schreibfaul1/ESP32-MiniWebRadio/docs/MiniWebRadio V3.4 Layout.pdf

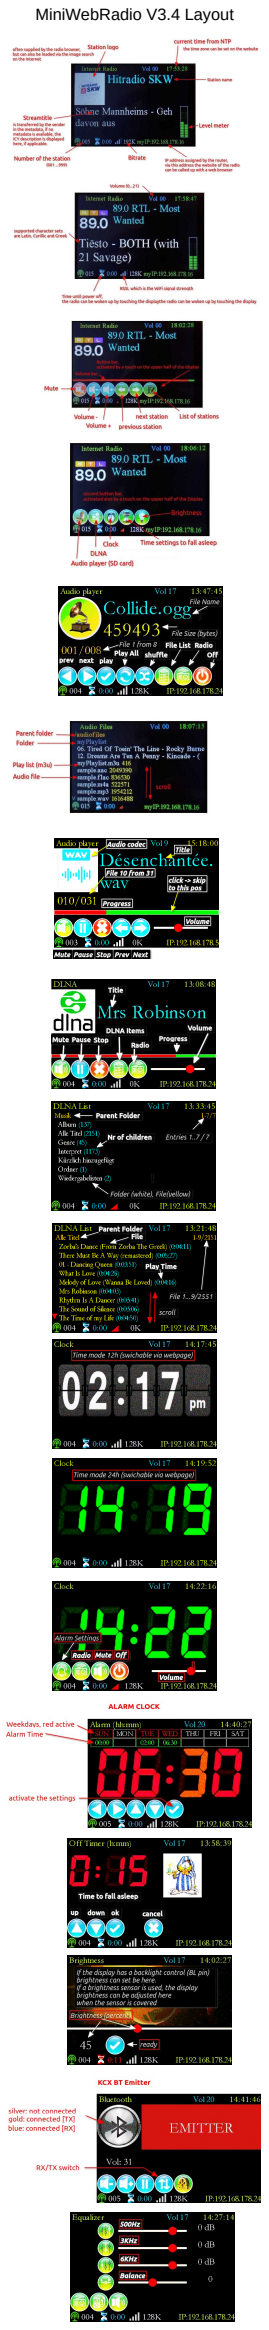
[picture p19: page 1]

MiniWebRadio V3.4 Layout
