schreibfaul1/ESP32-MiniWebRadio/docs/Using the RadioBrowser.pdf

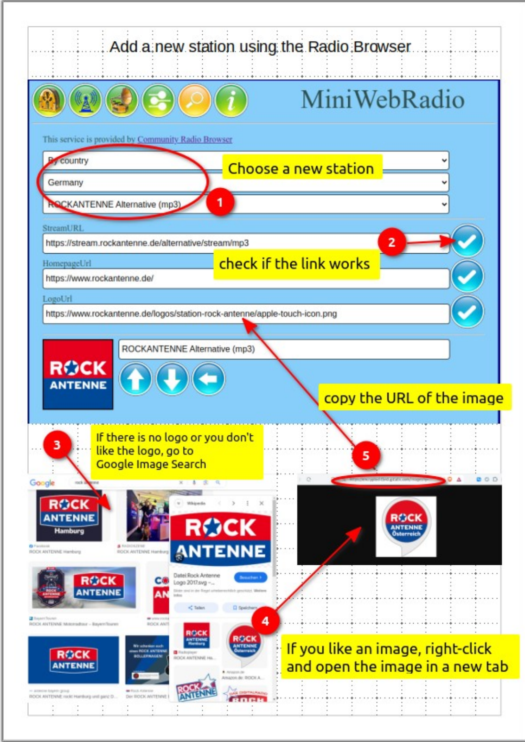
[picture p20: page 1]
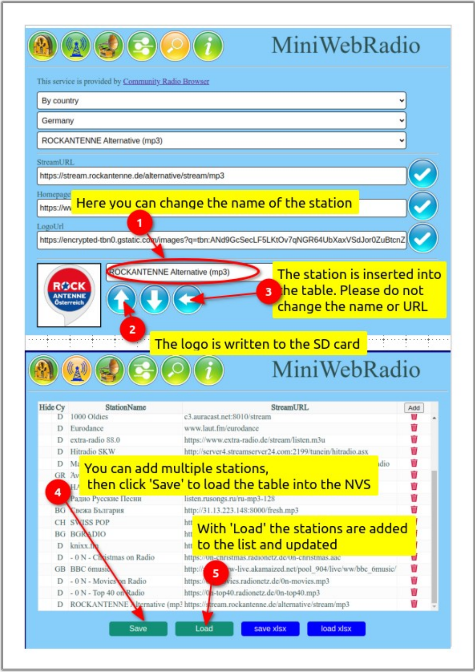
[picture p21: page 2]
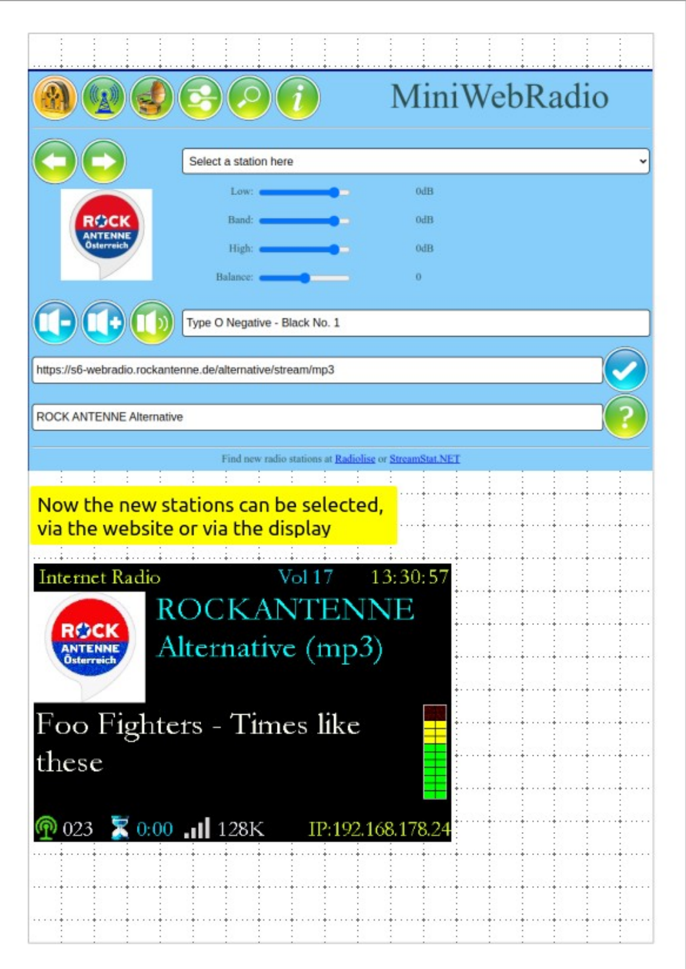
[picture p22: page 3]
