schreibfaul1/ESP32-MiniWebRadio/docs/Filezilla.pdf

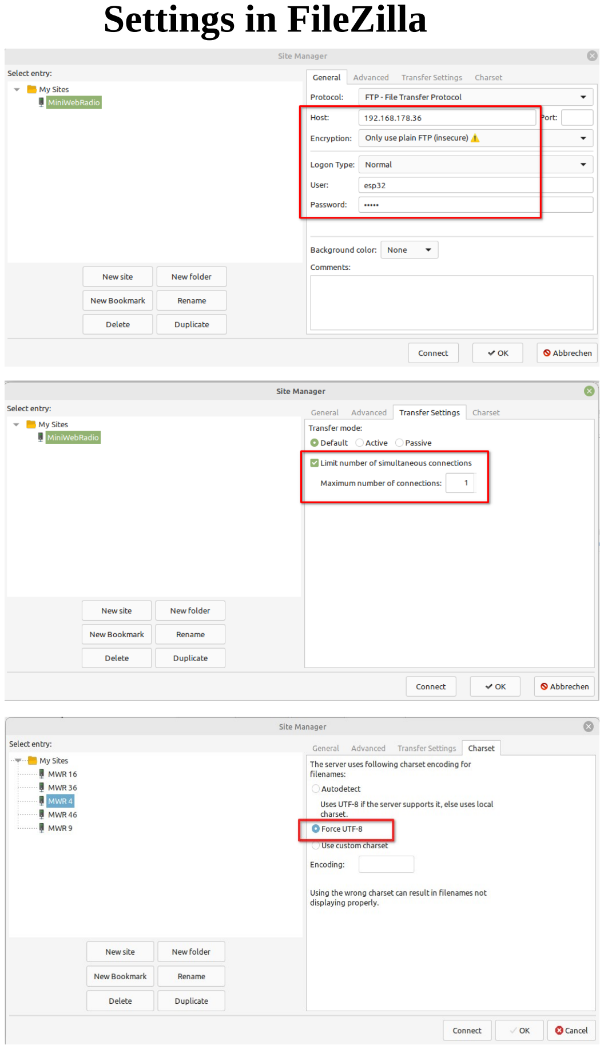
[picture p23: page 1]

Settings in FileZilla
