schreibfaul1/ESP32-MiniWebRadio/docs/rgb displays/Waveshare 7' Display/ESP32-S3-Touch-LCD-7.pdf

HMI 7'' Waveshare
ESP32-S3-Touch-LCD-7 | ESP32-S3 N16R8
GPI00 | G1 | | hsync_polarity | 0
GPI01 | R0 | | hsync_front_porch | 1
GPI02 | R1 | | hsync_pulse_width | 1
GPI03 | VSYNC | | hsync_back_porch | 1
GPI04
GPI05 | DE | | vsync_polarity | 0
GPI06 | | | vsync_front_porch | 4
GPI07 | PCLK | | vsync_pulse_width | 4
GPI08 | TP_SDA | | vsync_back_porch | 4
GPI09 | TP_SCL
GPI10 | B4 | | pixel_clock_hz | 12000000
GPI11 | SD_MOSI | SD_MMC_CMD | G911_I2C_ADDRESS | 0x14
GPI12 | SD_CLK | SD_MMC_CLK
GPI13 | SD_MISO | SD_MMC_D0
GPI14 | B0
GPI15
GPI16
GPI17 | B3
GPI18 | B2
GPI19
GPI20
GPI21 | G5
GPI22
GPI23
GPI24
GPI25
GPI26
GPI27
GPI28
GPI29
GPI30
GPI31
GPI32
GPI33
GPI34
GPI35
GPI36
GPI37
GPI38 | B1
GPI39 | G0
GPI40 | R4
GPI41 | R3
GPI42 | R2
GPI43 | | TX0
GPI44 | | RX0
GPI45 | G2
GPI46 | HSYNC
GPI47 | G4
GPI48 | G3

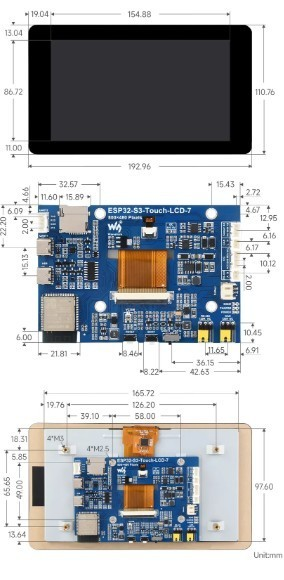
[picture p24: figure]
