schreibfaul1/ESP32-MiniWebRadio/docs/CS4344_schematic.png

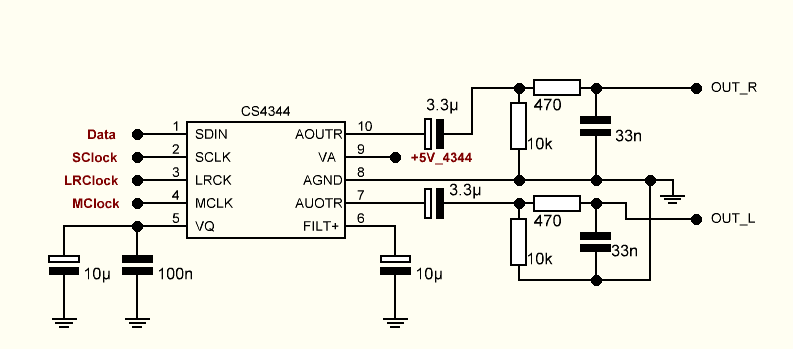
docs/CS4344_schematic.png
