schreibfaul1/ESP32-MiniWebRadio/docs/ir_buttons.json(Android X96).png

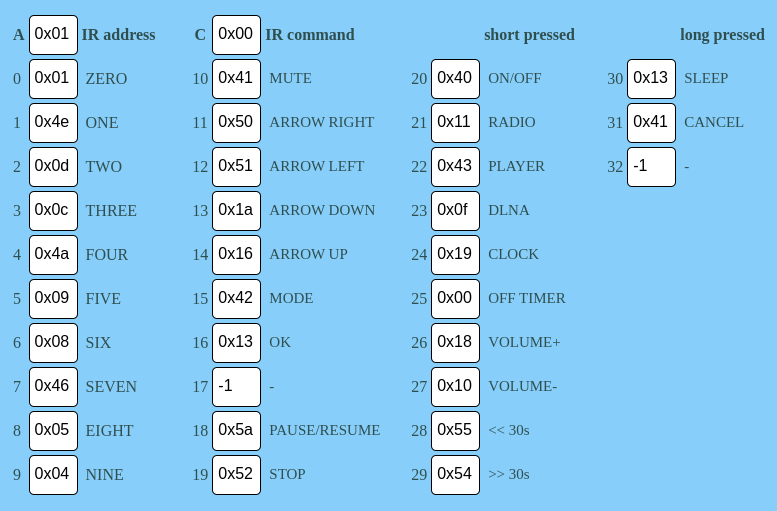
docs/ir_buttons.json(Android X96).png
