schreibfaul1/ESP32-MiniWebRadio/docs/MiniWebRadio.jpg

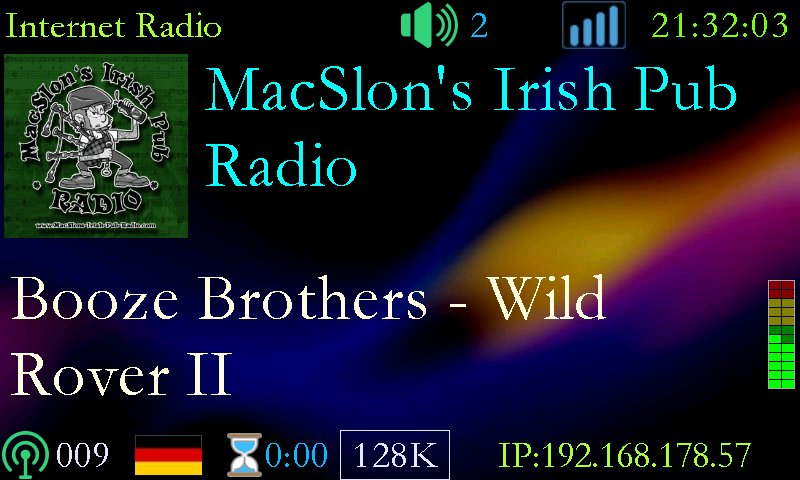
docs/MiniWebRadio.jpg
