schreibfaul1/ESP32-MiniWebRadio/docs/MWR_BT.jpg

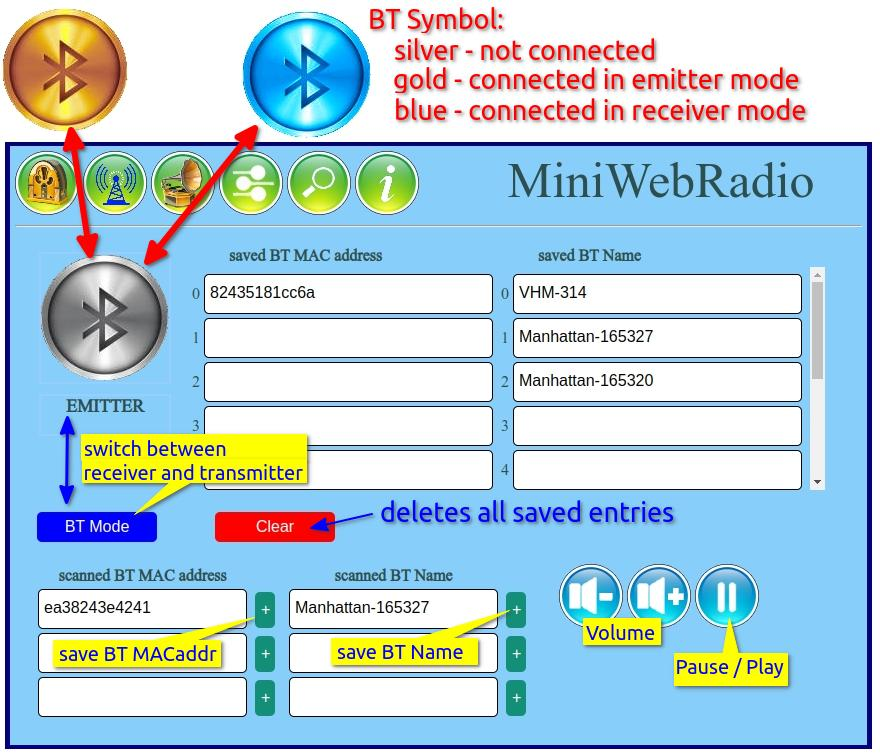
docs/MWR_BT.jpg
