schreibfaul1/ESP32-MiniWebRadio/docs/rgb displays/Sunton 7' Display/IMG_20250217_164130_144.jpg

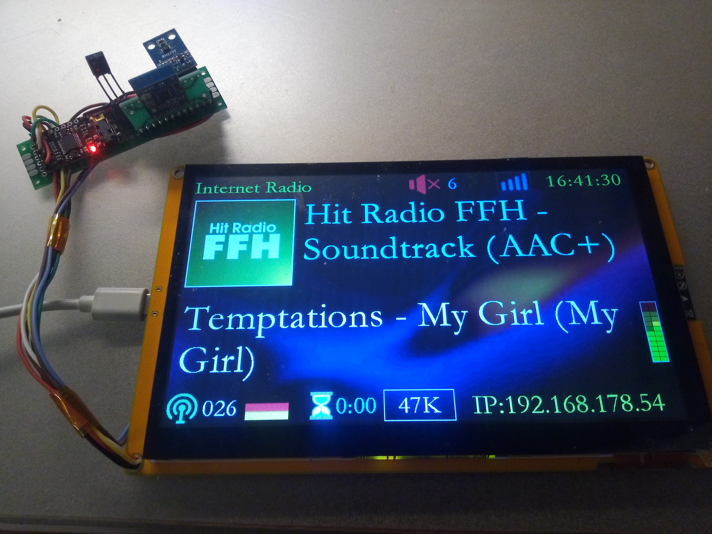
docs/rgb displays/Sunton 7' Display/IMG_20250217_164130_144.jpg
