schreibfaul1/ESP32-MiniWebRadio/docs/SD_Card_Adapter_for_SD_MMC_.jpg

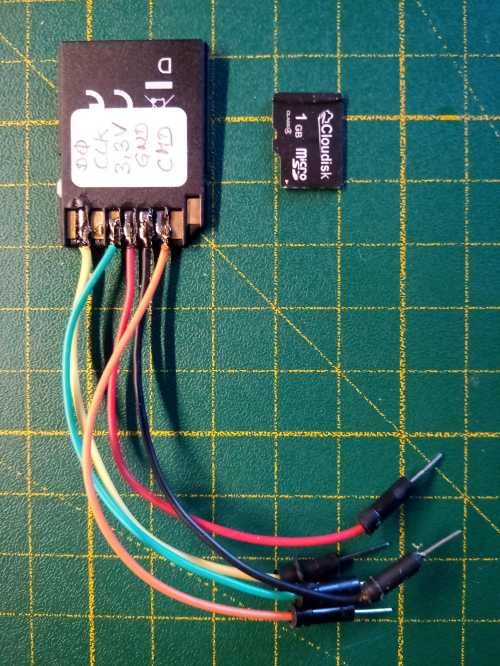
docs/SD_Card_Adapter_for_SD_MMC_.jpg
