schreibfaul1/ESP32-MiniWebRadio/docs/TFT_ILI9488_pins.jpg

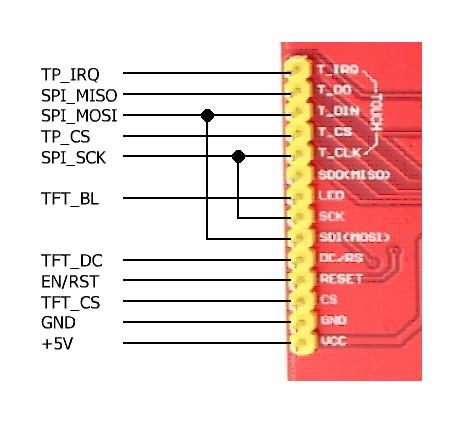
docs/TFT_ILI9488_pins.jpg
