schreibfaul1/ESP32-MiniWebRadio/docs/WiFi Manager.png

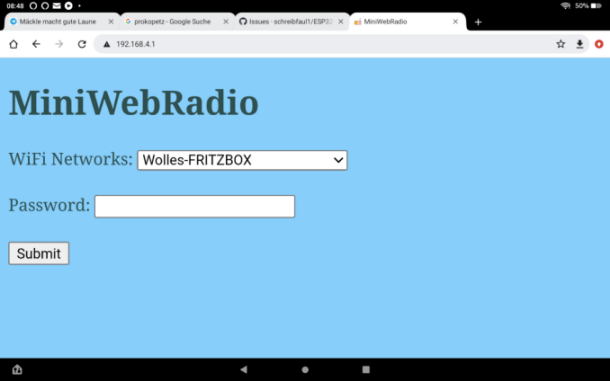
docs/WiFi Manager.png
