schreibfaul1/ESP32-MiniWebRadio/docs/How to install.pdf

# How to install ESP32-MiniWebRadio-V4

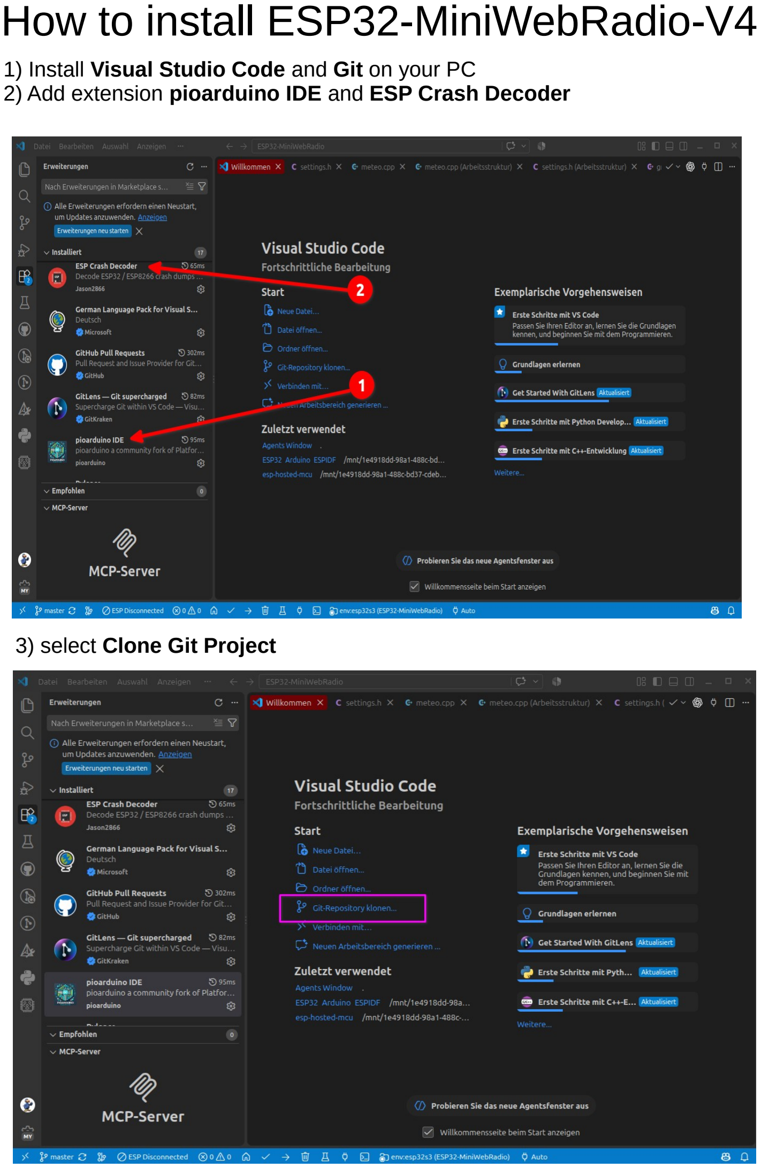
[picture p34: page 1]

1) Install Visual Studio Code and Git on your PC
2) Add extension pioarduino IDE and ESP Crash Decoder
3) select Clone Git Project

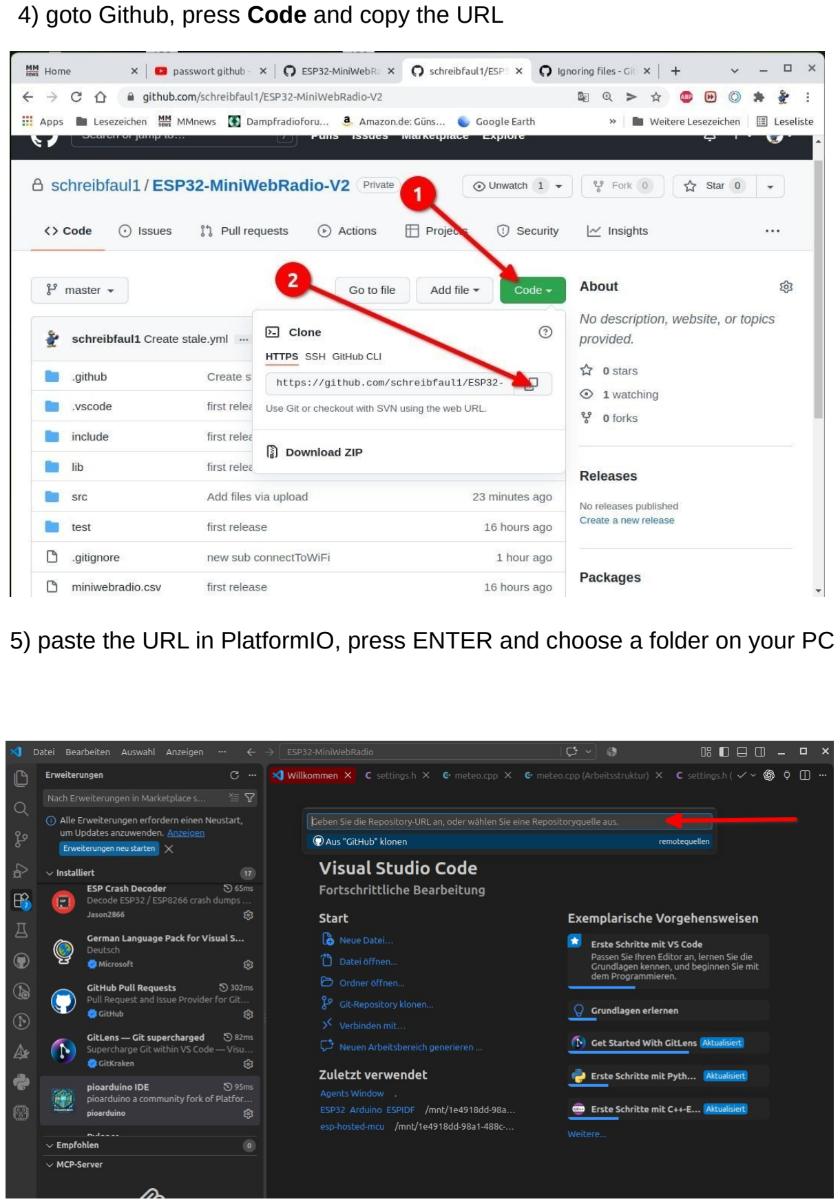
[picture p35: page 2]

4) goto Github, press Code and copy the URL
5) paste the URL in PlatformIO, press ENTER and choose a folder on your PC

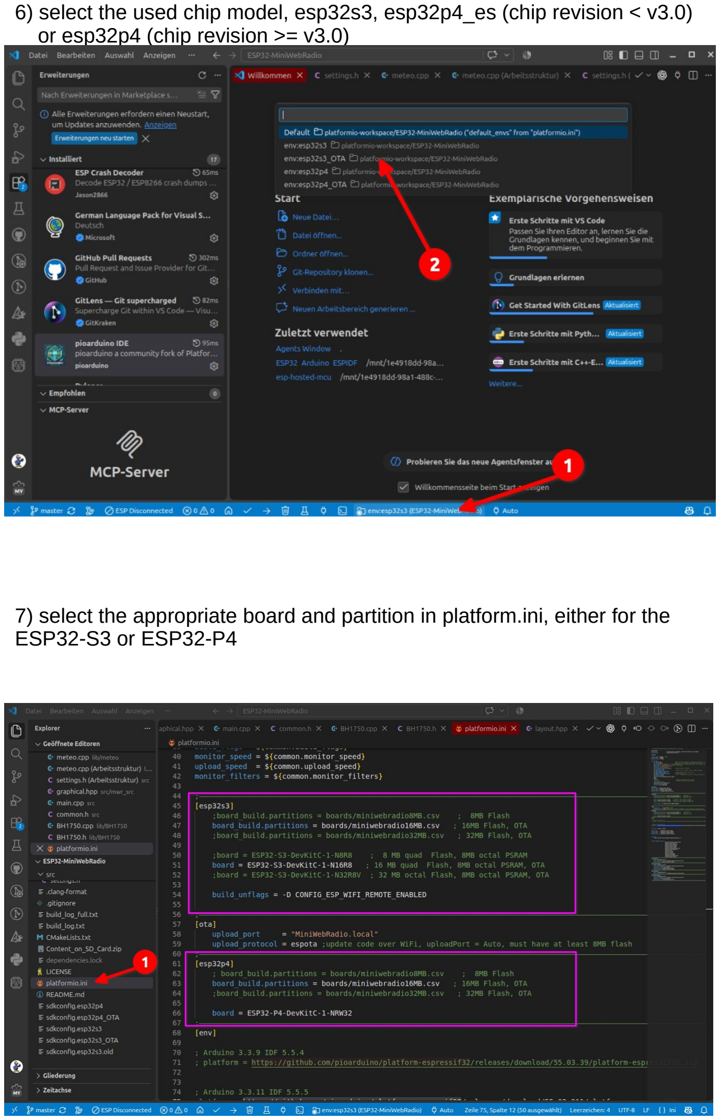
[picture p36: page 3]

6) select the used chip model, esp32s3, esp32p4_es (chip revision < v3.0) or esp32p4 (chip revision >= v3.0)
7) select the appropriate board and partition in platform.ini, either for the ESP32-S3 or ESP32-P4

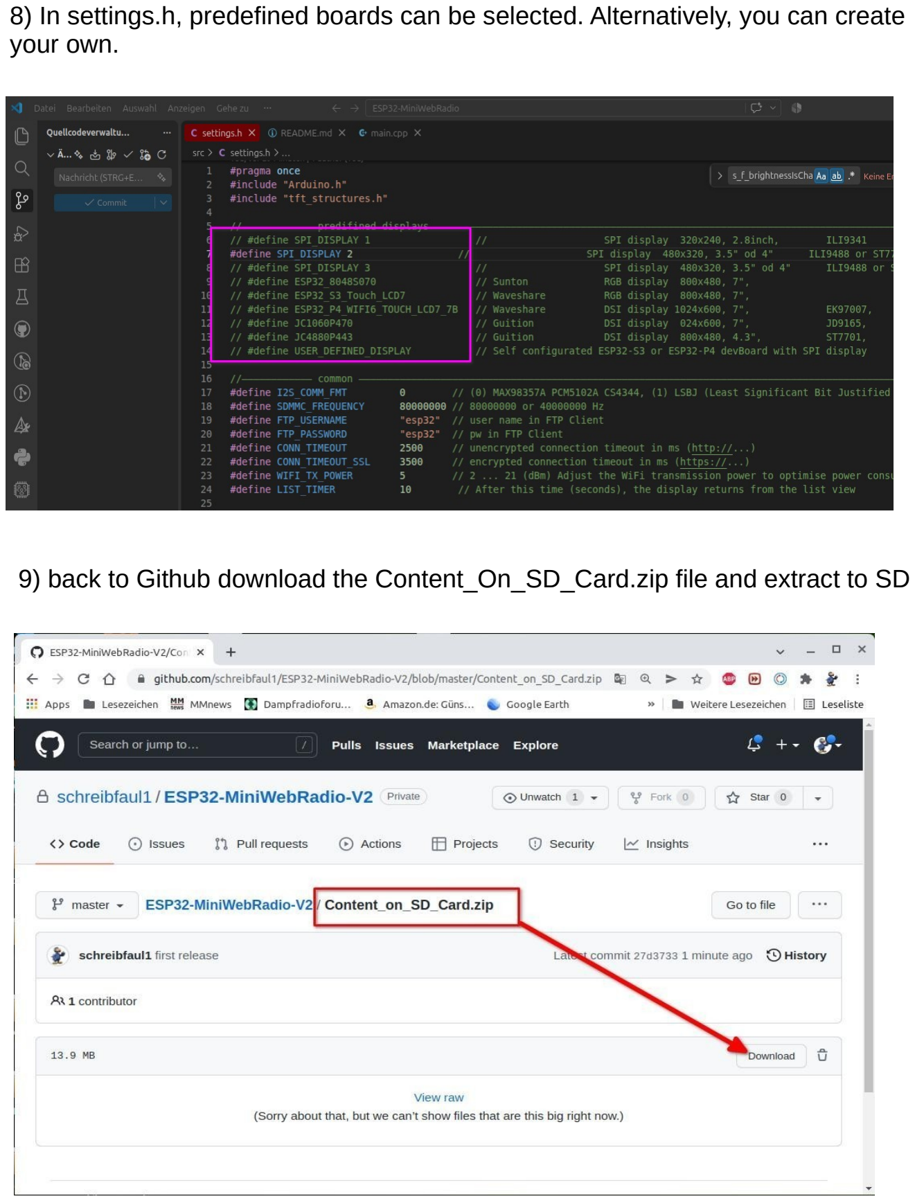
[picture p37: page 4]

8) In settings.h, predefined boards can be selected. Alternatively, you can create your own.
9) back to Github download the Content_On_SD_Card.zip file and extract to SD

10) Connect the ESP32 to USB, press build and then upload, Thats all.

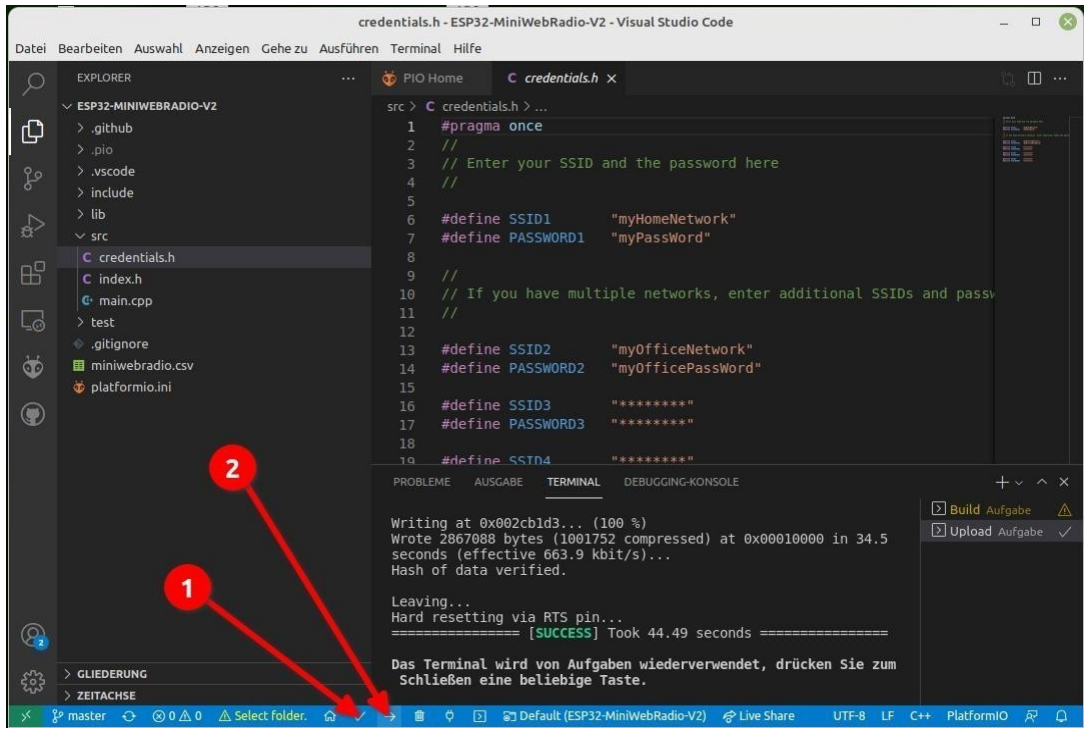
[picture p38: figure]
