schreibfaul1/ESP32-MiniWebRadio/(threads)

Thread 5 (2018-05-13):

Touch calibration

gonza88, 2018-05-13:
Hello
I made this radio and I have problem with cheap LCD based on ILI9341. When I touch the screen, point of touch doesn't match to icons of menu etc. It's possible to calibrate this?

PS. It's looks like ESP don't read presets.csv file from SD card. Radio plays only stations preprogrammed in ino file.

schreibfaul1, 2018-05-14:
Hello,
You use my tft library? If so scroll tft.cpp to the end and seek for
x = TP_Send(0xD0);
y=  TP_Send(0x90);
read x,y with (0,0) and (320,240) then You have th Voltage (in milliVolts) from TP controller.
Replace the constants Xmin, Xmax, Ymin, Ymax in tft.h with Your values.

In Your browser, tab config try the button "load default" to reread presets.csv.

schreibfaul1, 2018-05-19:
maybe You have this display: TJCTM24028-SPI, ILI9341, red board?
tochpad is y-inverted. If so replace the code at the end tft.cpp
  if(_rotation==0){y=TFT_HEIGHT-y;}
  if(_rotation==1){tmpxy=x; x=y; y=tmpxy; y=TFT_WIDTH-y; x=TFT_HEIGHT-x;}
  if(_rotation==2){x=TFT_WIDTH-x;}
  if(_rotation==3){;}  // do nothing

and set in tft.h:
      const uint16_t Xmax=1850;
      const uint16_t Xmin=170;
      const uint16_t Ymax=1880;
      const uint16_t Ymin=140;

koka7777745, 2018-07-15:
Dear author, tell me please how to add a red board for ILI9341, support for Russian-language fonts. And then I have at Russian stations some kryakozyabry.

koka7777745, 2018-07-15:
Thanks for the tips, 11 commented, and 8 commented. The rest does not come. Compilation does not go through the same mistakes. Drop the corrected files to the mail.
koka5675766@rambler.ru

koka7777745, 2018-07-15:
And how are the logos attached to the stations?

schreibfaul1, 2018-08-12:
To translate all the titles or words in russian You can try this:

  tft.setFont(Garamond_cyrillic_32x33);
  tft.print(UTF8toCp1251("Калинка, калинка, калинка моя! В саду ягода малинка, малинка моя!"));
  tft.print(UTF8toCp1251("Ах, под сосною, под зелёною, Спать положите вы меня!"));

for example:

in setup()
``
// showHeadlineItem("** Internet radio **");
showHeadlineItem("ИНТЕРНЕТ-РАДИО");
``

and in showHeadlineItem(const char* hl)
``
// tft.setTextSize(2);
tft.setFont(Garamond_cyrillic_18x18);
display_info(UTF8toCp1251(hl), _yHeader, _hHeader, TFT_WHITE, 0);
...
``

pilnikov, 2018-08-13:
' void showTitle(String str) {'
'  static String title = "";'
'  str.trim();  // remove all leading or trailing whitespaces'
'  if ((_state == RADIO) && (title == str)) return; // nothing to do'
'  if (str.length() > 4) f_has_ST = true; else f_has_ST = false;'
'  /* tft.setTextSize(4);'
'     if(str.length()> 45) tft.setTextSize(3);'
'     if(str.length()> 80) tft.setTextSize(2);'
'     if(str.length()>100) tft.setTextSize(1);'
'  */'
''
'  tft.setFont(Garamond41x42cyrillic);'
'  if (str.length() > 45) tft.setFont(Garamond32x33cyrillic);'
'  if (str.length() > 80) tft.setFont(Garamond23x24cyrillic);'
'  if (str.length() > 100) tft.setFont(Garamond21x21cyrillic);'
''
'  displayinfo(str.c_str(), _yTitle, _hTitle, TFT_CYAN, 0);'
'  title = str;'
'}'
' void showStation() {'
 ' tft.setFont(Garamond41x42cyrillic);'
 ' if (_stationname.length() > 45) tft.setFont(Garamond32x33cyrillic);'
 ' if (_stationname.length() > 80) tft.setFont(Garamond23x24cyrillic);'
 ' if (_stationname.length() > 100) tft.setFont(Garamond21x21cyrillic);'
''
 ' String str1 = "", str2 = "";'
 ' if (_stationname == "") {'
 '   //    tft.setTextSize(3);'
 '   //    if (_station.length() > 75) tft.setTextSize(1);'
 '   displayinfo(_station.c_str(), _yName, _hName, TFT_YELLOW, _wLogo + 14); // Show station name'
 '   showTitle("");   // and delete showstreamtitle'
 '   showFooter();'
 '   str1 = _station;'
 ' } else {'
 '   //   tft.setTextSize(4);'
 '   //   if (_stationname.length() > 30) tft.setTextSize(3);'
 '   displayinfo(_stationname.c_str(), _yName, _hName, TFT_YELLOW, _wLogo + 14);'
 '   showTitle("");'
 '   showFooter();'
 '   str1 = _stationname;'
 ' }'
 ' //log_i("%s", _stationname.c_str());'
 ' str1.toLowerCase();'
 ' str1.replace(",", ".");'
 ' str2 = "/logo/" + String(UTF8toASCII(str1.c_str())) + ".bmp";'
 ' //log_i("%s", _sbuf);'
 ' if (f_SD_okay) if (tft.drawBmpFile(SD, str2.c_str(), 0, _yLogo) == false) tft.drawBmpFile(SD, ' ' "/logo/unknown.bmp", 1, 22);'
'}`
Right name of cyrillic font is Garamond32x33cyrillic

schreibfaul1, 2018-08-20:
Yes, use fontname Garamond32x33cyrillic

Closed 2018-08-20.

Thread 31 (2020-05-08):

SD Karte arbeitet nicht

frbr13, 2020-05-08:
Hallo Wolle,

ich habe ein Problem mit der SC Karte da kommt immer ein Fehler beim Start und da bleibt es dann hängen.
Ich habe ein etwas anderes ESP32 als in deinen Bildern.
Espressif ESP32 WLAN Dev Kit Board Development Bluetooth Wifi v1 WROOM32 NodeMCU
ich habe hier die pinkonfiguration gewählt und meine verdrahtung 3 mal geprüft (und auch das Waveshare 2.8 Tft Shield auf einen Arduino uno getestet)

Hast du noch eine Idee ?
VG Frank

ets Jun  8 2016 00:22:57

rst:0x1 (POWERON_RESET),boot:0x13 (SPI_FAST_FLASH_BOOT)
configsip: 0, SPIWP:0xee
clk_drv:0x00,q_drv:0x00,d_drv:0x00,cs0_drv:0x00,hd_drv:0x00,wp_drv:0x00
mode:DIO, clock div:1
load:0x3fff0018,len:4
load:0x3fff001c,len:1216
ho 0 tail 12 room 4
load:0x40078000,len:9720
ho 0 tail 12 room 4
load:0x40080400,len:6352
entry 0x400806b8
setup      : Init SD card
tft_info   : TFT_CS:22 TFT_DC:21 TFT_BL:33 TFT_MOSI:23 TFT_MISO:19 TFT_SCK:18
tft_info   : init HX8347D
setup       : SD card not found

schreibfaul1, 2020-05-10:
Hallo Frank,
Display, Tochpad, VS1053 und SD Karte liegen auf dem gleichen Bus. CS->low bestimmt, welche Komponente aktiv ist. Ich gehe von einem Verdrahtungs/Kontaktproblem aus. Jede Komponente kann einzeln auf Funktion getestet werden, dazu gibt es in den Libraries Beispiele zum testen. Wenn einzeln alles funktioniert klappt auch das Zusammenspiel. Ich wünsch dazu viel Erfolg...
P.S. beim Waveshare-Display gibt es einen gelben Klotz, davor können 3 Brücken eingelegt werden damit die Leitungen zur Stiftleiste durchverbunden sind https://github.com/schreibfaul1/ESP32-TFT-Library-ILI9341-HX8347D/blob/master/additional%20info/Waveshare%202.8%20Display.jpg

frbr13, 2020-05-10:
Hallo Wolle,

super Danke für deine Hilfe, der Tip mit den 3 Lötbrücken hat geholfen 😊 . Es kam sofort ein Bild auf dem TFT und ich konnte den Sound testen mit den Test Files auf der SD Karte . Jetzt habe ich nur noch das Problem einen Sender zu finden der auch Streamt, ich hatte 5 deiner angelegten  getestet und vor ein paar Tagen Radio Wuppertal (mein Lokaler Sender 😊) hinzugefügt , aber hier kommt immer die Meldung das der Sender die Sender nicht streamen .

Danke noch mal für deine schnelle Hilfe

Schönes Rest Wochenende noch und bleib Gesund

Viele Grüße

Frank

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

schreibfaul1, 2020-05-10:
das hört sich gut an, die Verkabelung sollte nun in Ordnung sein. Wird die Zeit auf dem Display korrekt angezeigt? Vielleicht besteht keine Verbibdung ins Internet (nur lokal, nach außen wird von Router gesperrt)? Oder mit dem Browser auf die Radio-IP zugreifen und die Stream-URL manuell eingeben.
das Log sollte ähnlich sein zu:
```
WiFI_info  : WiFi connected
WiFI_info  : IP address 192.168.178.9
WiFI_info  : connected to Wolles-FRITZBOX
rtime_info : Initializing SNTP
rtime_info : Waiting for system time to be set... (1/10)
rtime_info : Sun May 10 20:36:57 2020
vs1053_info: Song stopped correctly after 0 msec
vs1053_info: Connect to new host: 0n-80s.radionetz.de:8000/0n-70s.mp3
[V][ssl_client.cpp:248] stop_ssl_socket(): Cleaning SSL connection.
vs1053_info: Connect to 0n-80s.radionetz.de on port 8000, extension /0n-70s.mp3
vs1053_info: Connected to server
vs1053_info: Server: Icecast acc-0.9.10.25 2.4.3-backportCVE-2018-18820
vs1053_info: audio/mpeg seen.
vs1053_info: Cache-Control: no-cache
vs1053_info: Expires: Mon, 26 Jul 1997 05:00:00 GMT
vs1053_info: Pragma: no-cache
vs1053_info: Access-Control-Allow-Origin: *
vs1053_info: ice-audio-info: ice-samplerate=44100;ice-bitrate=128;ice-channels=2
vs1053_info: icy-description:Von Disco ber Reggae und Schlager bis hin zum Rock. Das sind die Hits der 70er.
vs1053_info: icy-genre:70s, 70er, Oldies, Pop
vs1053_info: icy-name=- 0 N - 70s on Radio
vs1053_info: icy-private:0
vs1053_info: icy-pub:1
Homepage   : http://www.0nradio.com
vs1053_info: Switch to DATA, bitrate is 128, metaint is 16000
lastURL    : 0n-80s.radionetz.de:8000/0n-70s.mp3
vs1053_info: Metadata block 64 bytes
vs1053_info: StreamTitle=Wings - Listen To What The Man Said
````

frbr13, 2020-05-11:
Heute klappt alles es lag am Internett (wir hatten hier Gestern diverse Probleme)

Danke Gruß

Frank

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

schreibfaul1, 2020-05-12:
sehr gut!

Closed 2020-05-12.

Thread 83 (2022-04-09):

Suggestions for improvement

valera39, 2022-04-09:
Hello everyone, hello Wolle!
Let me repeat myself a little. Is it possible to implement such algorithms:
- when you press the "OK" button, the initial screen switches to the clock, pressing again switches back to the initial screen.
If you switch the station using the buttons on the remote control in the clock mode, display the initial screen for a while, then switch again
on the screen with hours.
- loop the switching of stations using the "next" and "next" buttons on the screen and on the remote control, that is, the last station in the list, then the first
- to prevent clicks in the speakers when the radio is turned on and to reduce the noise of the amplifier in the absence of a signal
add the "mute" mode to the free GPIO, the signal from which appeared at the time of the DAC operation.
I think the radio will become more functional from these functions.
And a couple more questions: what is the AUDIOTASK_CORE parameter in common.h responsible for, for sound processing on a separate core?
Is it worth changing it?
In platformio.ini when installing on ESP32 Wrower to enable PSRAM, do I need to uncomment the parameters
DBOARD_HAS_PSRAM and mfix-esp32-psram-cache-issue
If it were possible to use ESP-12K with 8Mb PSRAM, it would be great, because there is never too much memory :)

schreibfaul1, 2022-04-09:
Hello @valera39,
the first two points are done. Now the remote control can be used properly.
Point three: With 'mute', the volume is faded in or out in stages. In addition, if AMP_ENABLED is set in common.h, the assigned GPIO is controlled. AMP_ENABLED was already present to control the amplifiers on the audio boards (e.g. AI Thinker A1S board or OLIMEX ADF) and to save energy.
The ESP32 has two cores and one can be selected with AUDIOTASK_CORE. By default, Arduino setup() and loop() runs on core 1 and therefore the display also runs on core1. I think for the Aufiotask core 0 is better.
PSRAM is not strictly required. There is one exception: FLAC with an external DAC requires PSRAM, the SRAM does not have enough capacity. Older ESP32 (these have a design flaw) require the mfix-esp32-psram-cache-issue.
ESP-12K is certainly an ESP32-S2 and would then not work because of only one core.
regards
Wolle

valera39, 2022-04-09:
Hello Wolle!
Thank you very much for the implementation of my wishes and detailed answers to my questions!
I'm using an ESP32 worower with PSRAM enabled, but I'm experiencing a brief, literally split-second, audio stutter at the moment
change the name of the song on the screen. There are also slight stutters when using the buttons on the screen. Files like .flac do not play correctly.
Maybe you can separate the sound processing and display control into different processor cores to evenly distribute the load?
Or slightly increase the size of the signal's audio buffer.
Can I make sequential playback of the files located there in the audiofiles folder? Ideally, I'd like more
the functionality of the audio player, but I still think the main thing is the radio, since the processor will not pull much.
Thanks for your work!

Closed 2022-05-08.

Thread 97 (2022-05-23):

Sound varies

riks5, 2022-05-23:
Hi,

I intent to build your latest version on a PCB.
At the moment testing a breadboard setup.
Hardware: ESP32Wrover with psRam + SD-card + software DAC with amplifier MAX98357, no display attached.
IDE: Platformio on Eclipse.

So far so good: up and running.

A build with or without psram: soundlevel sometimes varies.
Switching between radio-player and files-player brings normal soundlevel back.
On the webpage nor serial, I ever saw a change of values during sounlevel alterations.
Volume indicates constant level 5, but you hear soundlevel go up or go down.

What am I doing wrong?
A known issue?
Have you any ideas or tips to approche this  problem?

Thanks for your time, advise and great project!

Best regards.
Rik.

schreibfaul1, 2022-05-24:
The MAX98357 is a DAC with an amplifier and you need 2 for stereo?
Perhaps the pin that distinguishes between the right and left channels is not connected?

riks5, 2022-05-25:
Hi,

Thanks for the quick reponse and your assistance.

The dac+amp is a adafruit module 3006.
I connected it out of the box and the default config is then what they call "mono-mode"( L1/2 + R1/2).
Today I changed one module to leftchannel-mode and another module to rightchannel-mode.
In all 3 modes the variations in soundlevel are present.

I will change my pcb-design and go for another module.
Any i2s-model you would advise?

Best regards.
Rik.

Van: Wolle ***@***.***>
Verzonden: dinsdag 24 mei 2022 18:00
Aan: schreibfaul1/ESP32-MiniWebRadio ***@***.***>
CC: riks5 ***@***.***>; Author ***@***.***>
Onderwerp: Re: [schreibfaul1/ESP32-MiniWebRadio] Sound varies (Issue #97)

The MAX98357 is a DAC with an amplifier and you need 2 for stereo?
Perhaps the pin that distinguishes between the right and left channels is not connected?

—
Reply to this email directly, view it on GitHub<https://github.com/schreibfaul1/ESP32-MiniWebRadio/issues/97#issuecomment-1136111535>, or unsubscribe<https://github.com/notifications/unsubscribe-auth/ADLLRMTQSOHOUVRKTQ35MTTVLT4IVANCNFSM5WXAJ6JA>.
You are receiving this because you authored the thread.Message ID: ***@***.******@***.***>>

EFWob, 2022-06-14:
I had similar problems with a breadboard setup. So may be its just a case of bad electric connection with dupont wires. In my case, the problem was gone after I soldered the connections between ESP and DAC...

Closed 2023-04-14.

Thread 104 (2022-07-03):

AI Thinker ES8388 Audiokit with TFT

gerthalberg, 2022-07-03:
I've managed to get the radio and the display to work with the following settings (ILI9488)
Also, the TFT frequency has to be set to 27000000 otherwise the display blanks after a few seconds. The board switches has to  be set to: OFF OFF ON ON OFF

#ifdef CONFIG_IDF_TARGET_ESP32
    // Digital I/O used
        #define TFT_CS        22
        #define TFT_DC        21
        #define TFT_BL        -1  // at -1 the brightness menu is not displayed
        #define TP_IRQ         3
        #define TP_CS          5
        #define SD_MMC_D0      2  // cannot be changed
        #define SD_MMC_CLK    14  // cannot be changed
        #define SD_MMC_CMD    15  // cannot be changed
        #define IR_PIN        35
        #define TFT_MOSI      13  // TFT and TP (VSPI)
        #define TFT_MISO      19  // TFT and TP (VSPI)
        #define TFT_SCK       12  // TFT and TP (VSPI)
    #if DECODER == 0
        #define VS1053_CS     33
        #define VS1053_DCS     4
        #define VS1053_DREQ   36
        #define VS1053_MOSI   13  // VS1053     (HSPI)
        #define VS1053_MISO   34  // VS1053     (HSPI)
        #define VS1053_SCK    12  // VS1053     (HSPI) (sometimes we need a 1k resistor against ground)
    #else
        #define I2S_DOUT      26
        #define I2S_DIN       -1  // pin not used
        #define I2S_BCLK       5
        #define I2S_LRC       25
        #define I2S_MCLK       0  // mostly not used
    #endif
        #define I2C_DATA      18  // some DACs are controlled via I2C
        #define I2C_CLK       23
        #define SD_DETECT     -1  // some pins on special boards: Lyra, Olimex, A1S ...
        #define HP_DETECT     -1
        #define AMP_ENABLED   -1
#endif

Unfortunately it seems, that my use of GPIO03 (RDX0) for the TP_IRQ does not work - at least, the display does not react to touch (could it be a calibration issue?). I'm wondering if it could be possible to attach a wire to GPIO36.

schreibfaul1, 2022-07-03:
Sure it's possible. An "input only pin" can be selected for TP_IRQ. With a touch event, IRQ is set, then the coordinates are queried via SPI.
I assume you have the same ILI9488 display as me. Then TFT-MISO must remain unconnected. TFT-MISO is also not required. It's a bug in the display itself.

Closed 2023-04-14.

Thread 115 (2022-09-02):

SDMMC Errors

gerthalberg, 2022-09-02:
Getting up and running on a bare A1S chip I get the following:

rst:0x1 (POWERON_RESET),boot:0x1b (SPI_FAST_FLASH_BOOT)
configsip: 0, SPIWP:0xee
clk_drv:0x00,q_drv:0x00,d_drv:0x00,cs0_drv:0x00,hd_drv:0x00,wp_drv:0x00
mode:DIO, clock div:2
load:0x3fff0030,len:1344
load:0x40078000,len:13836
load:0x40080400,len:3608
entry 0x400805f0
ESP32 Chip: ESP32-D0WDQ5
Arduino Version: 2.0.4
ESP-IDF Version: 4.4.1
ARDUINO_LOOP_STACK_SIZE 8192 words (32 bit)

00:00:00
00:00:00        ***************************
00:00:00        *     MiniWebRadio V2     *
00:00:00        ***************************
00:00:00
00:00:00 setup: ....  Arduino is pinned to core 1
00:00:00 tft_info: .  init ILI9488
00:00:00 setup: ....  Init SD card
00:00:00 setup: ....  SD card found
00:00:01 setup: ....  seek for stations.csv
00:00:01 setup: ....  stations.csv found
00:00:01 setup: ....  seek for WiFi networks
00:00:04 WiFI_info:   Connecting WiFi...
00:00:04 setup: ....  connected to WiFimodem-ABBE, IP address is 192.168.0.51
00:00:04 ftpServer:   Buffers allocated: 4622 bytes
00:00:04 rtime_info:  Initializing SNTP
00:00:04 rtime_info:  Waiting for system time to be set... (1/10)
22:12:53 rtime_info:  22:12:53
22:12:53 setup: ....  Number of saved stations: 13
22:12:53 setup: ....  current station number: 1
22:12:53 setup: ....  current volume: 12
22:12:53 setup: ....  volume is muted: (from 12)
22:12:53 action: ...  switch to station 1
22:12:54 lastURL: ..  http://jazzblues.ice.infomaniak.ch/jazzblues-high.mp3
22:12:54 StreamTitle: BOBBY RUSH  -  Nighttime gardener
E (7756) sdmmc_cmd: sdmmc_read_sectors_dma: sdmmc_send_cmd returned 0x109
E (7757) diskio_sdmmc: sdmmc_read_blocks failed (265)
E (7757) sdmmc_cmd: sdmmc_read_sectors_dma: sdmmc_send_cmd returned 0x109
E (7763) diskio_sdmmc: sdmmc_read_blocks failed (265)
E (7771) sdmmc_cmd: sdmmc_read_sectors_dma: sdmmc_send_cmd returned 0x109
E (7775) diskio_sdmmc: sdmmc_read_blocks failed (265)
E (7780) sdmmc_cmd: sdmmc_read_sectors_dma: sdmmc_send_cmd returned 0x109
E (7786) diskio_sdmmc: sdmmc_read_blocks failed (265)
E (7966) sdmmc_cmd: sdmmc_read_sectors_dma: sdmmc_send_cmd returned 0x109
E (7966) diskio_sdmmc: sdmmc_read_blocks failed (265)
E (7967) sdmmc_cmd: sdmmc_read_sectors_dma: sdmmc_send_cmd returned 0x109
E (7979) diskio_sdmmc: sdmmc_read_blocks failed (265)
22:12:55 ftpServer:   Ftp server waiting for connection on port 21
E (21386) sdmmc_cmd: sdmmc_read_sectors_dma: sdmmc_send_cmd returned 0x109
E (21386) diskio_sdmmc: sdmmc_read_blocks failed (265)
E (21387) sdmmc_cmd: sdmmc_read_sectors_dma: sdmmc_send_cmd returned 0x109

As I see it, The startup runs normally. The stations and the network csv file have been opened, read and closed - so what is causing those errors?

schreibfaul1, 2022-09-03:
0x109 is a (crc) read error. This is most likely a hardware issue.
It may help to reformat the SD card or use a different one. Are there any contact problems?
You can try lowering the frequency in Setup() ``SD_MMC.begin("/sdcard", true, false, 4000)``

clear-sky, 2023-02-19:
hi
as far as i see in file common.h sd_mmc pins cant be changed in esp32 section but dont see this  comment in esp32-s3 section-can it be changed?

schreibfaul1, 2023-02-19:
With the ESP32, the pins for the SD_MMC are fixed and cannot be changed.
d0 - pin2, clk - pin 14 and cmd - pin 15.
Unlike the ESP32-S3. The pins can be freely selected here, SD_MMC.setPins(clk, cmd, d0);

Closed 2024-02-29.

Thread 119 (2022-09-24):

Is it internal RTC issue?

eksanmark, 2022-09-24:
Hi..
Saw in the demo, its great project. Try to build last night with hardware as follow: micro sd card adapter, VS1053 (tried also with I2S/MAX chip) and ILI9341 with no success. Code is uploaded successfully, common.h had adjusted as required. Black screen, no sound. Check wiring (still in breadboard) for 3 times, all correct as schematic.
Debug on Serial monitor as "rst:0x10 (RTCWDT_RTC_RESET), boot:0x3b (SPI_FAST_FLASH_BOOT)
flash read err, 1000, ets_main.c 371 ".
Any clue what possible I'm doing wrong?
Thanks.

schreibfaul1, 2022-09-25:
This looks like a problem with the used ESP32 board,, https://www.esp32.com/viewtopic.php?t=25729

eksanmark, 2022-09-25:
Appreciate for your respond, also the link. Finally got it work. The problem is in the VS1053, had used a different type, the red one with straight pin. Not knowing yet what does the root cause, since this part is okay when used with basic code.
This is the best web radio software I've ever built, thanks for the amazing code.

schreibfaul1, 2022-09-25:
I think pin12 will be the problem, maybe a pull-up resistor on the VS1053 board. If you swap two GPIOs with each other, the error could be eliminated

eksanmark, 2022-09-26:
Yes you're right, I change GPIO 12 to GPIO 08, rearrange the code, upload, and it's working fine, maybe GPIO 12 is RTC pin.
I add some stations via FileZilla including its logo as per example format (writing format, .jpg pixel size and correct name), but the system doesn't yet to read the SD card update, or even when I remove (*) mark for 3 stations in original code, still the same, 13th is the last. Is there something improperly?

ichebyki, 2023-03-19:
You can fuse needed flash voltage and gpio12 will be ignored while boot.

eksanmark, 2023-03-20:
At that time, I follow suggested option that I didn't pay attention before, to add 1k Ohm resistor between SCK and GND, and its work. VS1053 has better sound quality.

Closed 2024-02-28.

Thread 122 (2022-11-20):

Connectors 3.5 TFT

Beppi4U, 2022-11-20:
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

Hi! Found a suitable TFT 3.5 for the project! Seems that the sd card connectors have different names!
On your schematic D0 , CMD,CLK in required. On my tft board only miso mosi and cs is shown. Are they comparable? On Display side instead  of TFT_DC  i have T_DO left! Is that right or is'nt the display working with the project? Thanks for helping! Andi

Beppi4U, 2022-11-20:
Thanks for super quick response!  Just to get clear 'shorten out' means soldered out and bridged!?

schreibfaul1, 2022-11-20:
The series resistors are ok for SD(SPI). But in my experience there are problems with SD_MMC. A simple possibility is to bridge the resistors with a wire. In this way, the original state can be restored later

Beppi4U, 2022-11-21:
Hmmm.... Build it yesterday!
Settings:
Decoder to VS1053
TFT and Touch Controller to iLi9488
Changed the Wifi Credentials to mine .... Compiled fine .....
But....

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

Seems theres something wrong with SDCard.
Tried out some other cards ...no success.
Fat or ExtFat on SD should do the job?
Now i have to check my cables again.

Beppi4U, 2022-11-21:
Why tft_nfo tells me that iLi9341 is initiated when i set it to iLi9488 ?  ;-)

schreibfaul1, 2022-11-21:
Looks like the connection to the SD card is bad, did you use a breadboard?

Beppi4U, 2022-11-22:
No breadboard builds...i prefer DuPont Stecker ! So....i checked the Miso Mosi Sck cable paths from esp pins through SD card adapter twice! Ok! Then measured 3.3 v for SD card...should be good. Maybe Esp32 pinout is not the same as google showed me. 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
I have used the node mcu ESP3S V1.1   On that Board tft_irq -> pin 39 should be pin svn (grey cable) . Dreq -> pin 36 should be pin svp(white cable) . Can you confirm so far?
Again thanx for help! Andi

Beppi4U, 2022-11-22:
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

Beppi4U, 2022-11-22:
Quick hook up the Card reader...but i guess thats not how it works because now you need chip select!?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

schreibfaul1, 2022-11-22:
The wiring looks good. Better to use the display's card adapter, the Catalex adapter has level converters and may not work with SD_MMC.
The CS pin remains free with 'one wire', this is D3 with 'four wire'

Try if the card works at all
````
// ESP32-S3
#include "Arduino.h"
#include "SD_MMC.h"
#include "FS.h"

#define SD_MMC_CMD 14
#define SD_MMC_CLK 13
#define SD_MMC_D0  11

void listDir(fs::FS &fs, const char * dirname, uint8_t levels){
    Serial.printf("Listing directory: %s\n", dirname);

    File root = fs.open(dirname);
    if(!root){
        Serial.println("Failed to open directory");
        return;
    }
    if(!root.isDirectory()){
        Serial.println("Not a directory");
        return;
    }

    File file = root.openNextFile();
    while(file){
        if(file.isDirectory()){
            Serial.print("  DIR : ");
            Serial.println(file.name());
            if(levels){
                listDir(fs, file.path(), levels -1);
            }
        } else {
            Serial.print("  FILE: ");
            Serial.print(file.name());
            Serial.print("  SIZE: ");
            Serial.println(file.size());
        }
        file = root.openNextFile();
    }
}

void setup() {
    Serial.begin(115200);

    pinMode(SD_MMC_D0, INPUT_PULLUP);
    SD_MMC.setPins(SD_MMC_CLK,SD_MMC_CMD, SD_MMC_D0);
    if(!SD_MMC.begin( "/sdmmc", true)){
        Serial.println("Card Mount Failed");
        return;
    }
    listDir(SD_MMC, "/", 0);
}

void loop(){
}
````
and if that's too fast:
    if(!SD_MMC.begin( "/sdmmc", true, false, 20000)){  //20KHz

Beppi4U, 2022-11-23:
OK! I changed in this little sketch the pin for  CMD CLK and D0 and output is as followed....  ;-)

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

Beppi4U, 2022-12-01:
HEUREKA !!! Es läuft!
Schuld am ganzen Dilemma war zu viele offene Projekte auf einmal in VS Code!
Schätze da wusste die IDE nicht ganz welche Dateien sie nehmen sollte.
Alle Projekte entfernt und das richtige geladen .... compilieren und fertig!
Jetzt werde ich mich mal drann machen ein schönes Gehäuse zu basteln!
Danke für jede Hilfe !
Gruß
Andi

schreibfaul1, 2022-12-01:
Sehr gut!
vG
Wolle

Beppi4U, 2022-12-03:
HEUREKA....es lebt!

[Uploading p4{5440991} (23c0b8ed-ff6c-4310-a7d2-5d7a9a3360d5 id=0x7f0a0400 tag=BaseCommentFragment) …]()

Beppi4U, 2022-12-03:
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

Closed 2022-12-01.

Thread 123 (2022-11-27):

SD Card Mount Failed

rodo2021, 2022-11-27:
Hi,
I get the following:

00:00:00        ***************************
00:00:00        *     MiniWebRadio V2     *
00:00:00        ***************************
00:00:00
00:00:00 setup: ....  Arduino is pinned to core 1
00:00:00 tft_info: .  init ILI9486
00:00:00 setup: ....  Init SD card
E (398) sdmmc_sd: sdmmc_init_sd_scr: send_scr (1) returned 0x109
E (398) vfs_fat_sdmmc: sdmmc_card_init failed (0x109).
[   403][E][SD_MMC.cpp:138] begin(): Failed to initialize the card (0x109). Make sure SD card lines have pull-up resistors in place.
00:00:00 SD Card Mount Failed

SD_MMC.begin("/sdcard", true, false, 4000) the change did not help.
The wiring looks good.

Any idea?

schreibfaul1, 2022-11-27:
Reliable contacts and short wires are important. Reducing the clock frequency from 40MHz to 20 or 10MHz often helps.

Philippe-33, 2023-01-26:
Hi rodo2021,
I had the same problem. After searching  about the pinout of sd cards, i have seen that there is 2 gnd pads. I have shorted the two gnd pads and this has solved my problem.
I hope this will help you.

ichebyki, 2023-03-19:
You need pullup all used sd card's pins with 10k resistors. This espressif requirement from datasheet.

clear-sky, 2023-04-02:
hi all
as far as i noticed most of users have problem on mounting sd card
some problems are related to long wires and some on sd card brand and some on sd capacity
if possible please add support native usb port in esp32-s3 modules
in my opinion this is a definite solution

berth59, 2023-05-29:
soldering pin 3 on the sd-card to ground solved my problem with cards.  not recognized

steve6375, 2023-06-08:
I tested with a Mini TF card in the card holder mounted behind my ILI9342 TFT - it just needed 3 wires (MISO, SCLK, MOSI).
No pullups or anything else required.

I also tested using an Mini-to-Micro SD card adapter + a MicroSD card. I directly soldered onto the minicard adapter contacts. Again no pullups needed. **VCC was 3.3V taken from esp board.** TF\SD cards are 3.3V devices.

However, I did connect both GND contacts and a 1K pullup between 3.3V and CS but I dont think this was needed as it worked fine without the pullup.
Not sure why someone else said to connect CS to GND because that wont work!

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

RobinMosedale, 2024-02-03:
Several standalone cards have been attempted, both at 3.3v, 5V, after discovering this failure on the ILI7934.
Changed speed from 40,000,000 HZ, to 20,000,000 Hz, the 10,000,000 Hz.
Finally strapped the CS to 3.3v with 1k.

Solid failure.

Do tell us the secret, or let's just modify it to use SPI on the non critical SPI bus. My passes the usual SPI tests.

Shame, as has much potential

schreibfaul1, 2024-02-03:
Then Espressif's example won't work either. https://github.com/espressif/arduino-esp32/tree/master/libraries/SD_MMC

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

RobinMosedale, 2024-02-04:
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
Thank you Schreibfaul for both responding so quickly and taking the time to advise.

Context: I'm investigating the BBC's introduction of HLS and MPEG Dash following the removal of the more popular Shout Out. Your suite seemed pretty clear to employ as a test harness.

However, I've done all you have advised, you can see that the ILI79431 SD card and the standalone MMC adapter have been abandoned with their unwanted resistors. Direct wiring, first without CS pulled up, and secondly with the CS pulled up via 1k ohms to 3.3volts.
The result is the same. I've tried the espressif SDMCC tests both time and basic test.
The espressif tests respond without any message other than logging on to the time site.

I'll move on, and try elsewhere.

Finally, thank you again for your efforts

Robin

Arne65, 2024-02-04:
Hello Robin

Keep D0 with 10k on 3.3 V actually always worked with the ESP 32

RobinMosedale, 2024-02-04:
Thank you Arne,

Just attempted. No success.
Shame as the card was successfully tested in SPI

Arne65, 2024-02-04:
Set the SD frequency to 1 MHz, the card should then be read and work your way up with the frequency

steve6375, 2024-02-13:
10k not 1k.

kerat71, 2024-02-13:
actually the example from the espressif SDMMC library says 1k, but I think it's not that important, the important thing is that it worked!

Arne65, 2024-02-13:
I think there are different statements regarding the PullUp.
The bottom line is that this is actually due to the level conditions. If in doubt, you have to experiment a bit with the PullUp as not all card adapters are really the same. Some work with 10 K others with 2.2 or 1 K.

Arne65, 2024-02-13:
Hello kerat71

If the card is running you should increase the frequency and see when it can no longer be read safely.

kerat71, 2024-02-13:
Yes, I manage to increase the frequency to 40 MHz and it boots. Then add all the rest hardware (VS1053, TFT) and then it went into bootloop because lack of PSRAM :-( On this ESP32 MiniWebRadio plays almost 5 years.

Arne65, 2024-02-13:
env:esp32]
        board_build.partitions = miniwebradio4MB.csv    ; 4MB Flash
        ;board_build.partitions = miniwebradio8MB.csv    ; 8MB Flash
        ;board_build.partitions = miniwebradio16MB.csv   ; 16MB Flash
        board = ESP32-Dev-4MB                   ; 4MB Flash  *2)
        ;board = ESP32-Dev-8MB                   ; 8MB Flash  *2)
        ;board = ESP32-Dev-16MB                  ;16MB Flash  *2)
build_flags =
        -DCORE_DEBUG_LEVEL=3                    ; 0 None, 1 Error, 2 Warn, 3 Info, 4 Debug, 5 Verbose
        -DCONFIG_ARDUHAL_LOG_COLORS
       // -DBOARD_HAS_PSRAM         Delete this in platformio.ini

There was a time when it had to be deleted if you didn't have PSRAM

Closed 2024-03-30.

Thread 124 (2022-12-07):

ILI9488 display with a capacitive touchpad....

oxygeniust, 2022-12-07:
Hello dear schreibfaul1!!I put together your project, tested it and was very satisfied.Today I received the ILI9488 display with a capacitive touchpad.I tried to connect it-there is an image, but the capacitive touch does not work....tell me how you can make it work?
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

oxygeniust, 2022-12-07:
the display is red,but the pin designations are different

oxygeniust, 2022-12-08:
hello......???????

schreibfaul1, 2022-12-08:
I have no idea how this display works. The display should have a touchpad controller HX8347D. Is it possible that in your case an analog voltage value is returned?

valera39, 2022-12-08:
Perhaps this display has another touchscreen controller

oxygeniust, 2022-12-08:
display ILI9488,touchpad GOODIX GT911...

valera39, 2022-12-08:
Perhaps I'm mistaken, but the radio does not support the display with capacitive touchscreen on GT911.
Common.h prescribes the support of resistive displays with other controllers. Try to set different values #define tp_version, I had a similar problem of incompatibility of the touchscreen and display controller.
Or contact a respected author of the project, for supporting your display.

AVRsteffen, 2023-01-22:
Hello schreibfaul1
Any news on support for the GT911 capacitive touch controller? I have now also ordered such a display and would like to use it with your web radio.

AVRsteffen, 2023-02-20:
I did add stripped down driver only for capacitive touch controller GT911 for 480x320px TFT to tft.h and tft.cpp files. I can't upload here but can show you that additional code segments.

**tft.h**
`#include "Wire.h"

// TFT code here

// Touch code here
//-----------------------------------------------------------------------------------------------------------------------

struct __attribute__((packed)) GTInfo {
  char productId[4]; // 0x8140 - 0x8143
  uint16_t fwId; // 0x8144 - 0x8145
  uint16_t xResolution; // 0x8146 - 0x8147
  uint16_t yResolution; // 0x8148 - 0x8149
  uint8_t vendorId; // 0x814A
};

struct __attribute__((packed)) GTPoint {
  // 0x814F-0x8156, ... 0x8176 (5 points)
  uint8_t trackId;
  uint16_t x;
  uint16_t y;
  uint16_t area;
  uint8_t reserved;
};

// 0xBA/0xBB (0x5D 7bit)
#define GT911_I2C_ADDR_BA     0x5D
#define GT911_REG_DATA        0x8140
//#define GT911_REG_ID 0x8140
#define GT911_REG_COORD_ADDR  0x814E

class GT911 {
  public:
    enum class Rotate {
      _0,     // normal
      _1,     // normal invers
      _2,     // 180 deg
      _3,     // 180 deg invers
    };
  private:
    TwoWire *_wire;
    uint8_t _addr;
    uint16_t x=0, y=0;

    //bool _configLoaded = false;
    boolean f_loop = true;
    GTInfo _info;
    GTPoint _points[0];
    uint8_t _rotation;

    //void reset();
    void i2cStart(uint16_t reg);
    bool write(uint16_t reg, uint8_t data);
    uint8_t read(uint16_t reg);
    bool writeBytes(uint16_t reg, uint8_t *data, uint16_t size);
    bool readBytes(uint16_t reg, uint8_t *data, uint16_t size);
    bool readTouches();
    bool readTouchPoints();
  public:
    GT911(TwoWire *twi = &Wire);
    bool begin(uint8_t addr = GT911_I2C_ADDR_BA, uint32_t clk = 400000);
    GTInfo* readInfo();
    GTPoint *getPoints();

    void setRotation(uint8_t rotation);
    void loop();
};
`

Changes in **tft.ccp**
`#include <Wire.h>

/***********************************************************************************************************************
                                            T O U C H P A D
***********************************************************************************************************************/

// Code für capacitive Touchpad mit GT911
GT911::GT911(TwoWire *twi) : _wire(twi ? twi : &Wire) {

}

void GT911::i2cStart(uint16_t reg) {
  _wire->beginTransmission(_addr);
  _wire->write(reg >> 8);
  _wire->write(reg & 0xFF);
}

bool GT911::write(uint16_t reg, uint8_t data) {
  i2cStart(reg);
  _wire->write(data);
  return _wire->endTransmission() == 0;
}

uint8_t GT911::read(uint16_t reg) {
  i2cStart(reg);
  _wire->endTransmission();
  _wire->requestFrom(_addr, (uint8_t)1);
  while (_wire->available()) {
    return _wire->read();
  }
  return 0;
}

bool GT911::writeBytes(uint16_t reg, uint8_t *data, uint16_t size) {
  i2cStart(reg);
  for (uint16_t i = 0; i < size; i++) {
    _wire->write(data[i]);
  }
  return _wire->endTransmission() == 0;
}

bool GT911::readBytes(uint16_t reg, uint8_t *data, uint16_t size) {
  i2cStart(reg);
  _wire->endTransmission();

  uint16_t index = 0;
  while (index < size) {
    uint8_t req = _min(size - index, I2C_BUFFER_LENGTH);
    _wire->requestFrom(_addr, req);
    while (_wire->available()) {
      data[index++] = _wire->read();
    }
    index++;
  }

  return size == index - 1;
}

bool GT911::readTouches() {
  uint32_t timeout = millis() + 20;
  do {
    uint8_t flag = read(GT911_REG_COORD_ADDR);
    if (flag & 0x80) {
      write(GT911_REG_COORD_ADDR, 0);
    return true;
    }
    delay(1);
  } while (millis() < timeout);

  return false;
}

bool GT911::readTouchPoints() {
  bool result = readBytes(GT911_REG_COORD_ADDR + 1, (uint8_t*)_points, sizeof(GTPoint));

  if (result) {
    //for (uint8_t i = 0; i < GT911_MAX_CONTACTS; i++) {
      if (_rotation == 0) { _points[0].y = _info.yResolution - _points[0].y; }
    //  if (_rotation == 1) { _points[0].y = _info.yResolution - _points[0].y; }
      if (_rotation == 2) { _points[0].x = _info.xResolution - _points[0].x; }
      if (_rotation == 3) { _points[0].x = _info.xResolution - _points[0].x;
                            _points[0].y = _info.yResolution - _points[0].y; }
    }
  //}
  return result;
}

bool GT911::begin(uint8_t addr, uint32_t clk) {
  _addr = addr;

  delay(500);

  _wire->begin();
  _wire->setClock(clk);
  _wire->beginTransmission(_addr);
  if (_wire->endTransmission() == 0) {
    readInfo(); // Need to get resolution to use rotation
    return true;
  }
  return false;
}

GTInfo* GT911::readInfo() {
  readBytes(GT911_REG_DATA, (uint8_t*)&_info, sizeof(_info));
  return &_info;
}

GTPoint *GT911::getPoints() {
  return _points;
}

void GT911::setRotation(uint8_t rotation) {
  _rotation = rotation;
}

void GT911::loop() {

    if (readTouches()) {
      if (f_loop==true) {
            f_loop = false;
            readTouchPoints();
            GTPoint* ts = getPoints();
            y = ts[0].x;
            x = ts[0].y;
            if (tp_pressed) tp_pressed(x, y);
                Serial.printf(" pressed: x=%d , y=%d s:%d\n", x, y, ts[0].area);
      }
    } else {
      if (f_loop == false) {
            if (tp_released) tp_released();
				Serial.printf("released: x=%d , y=%d \n", x, y);
      }
      f_loop = true;
    }
}
//----------------------------------------------------------------------------------------------------------------------
`
Only the two I2C lines are required. TP_INT must be connected in series to GND via a resistor so that TP_INT is pulled low. TP_RES is connected to /EN (RESET) of the ESP32.

AVRsteffen, 2023-02-20:
Changes in **main.cpp**

Line 113:  change to `GT911 tp = GT911();`

In `void setup();
.......
`
Line 1084:  remove `tp.setVersion(TP_VERSION);`  and replace with ` tp.begin() `

Closed 2024-02-26.

Thread 131 (2023-02-01):

Slower graphics build in version 2

AVRsteffen, 2023-02-01:
Since the new V2, the graphic structure of the buttons and other images from the SD card is very slow.  I compared it with V1.  Certainly there was no support from the 480x320 pixel displays.  But even the 320x240s have a very slow graphic structure in V2.  What could be the reason?

schreibfaul1, 2023-02-02:
The difference to version 1 is that the SD card no longer shares the SPI bus with the display. The speed should be at least equal to the V1. The SD_MMC doesn't like long wires or contact problems (or series resistors that are built into some displays). Not every SD card is equally suitable. Good SD cards tolerate 40 or 80MHz, you can change that in common.h.

AVRsteffen, 2023-02-04:
Hey Wolle, I also have the data running via MMC in V1. I was the one who converted this to 2 cards. One SD card for audio mp3 and one MMC for data. I can run both TFT and MMC with 80Mhz in V2 (see video).  Nevertheless, the V2 is much slower in graphics construction than the V1. It also looks like there are always pauses of a few milliseconds between the individual images. Do you have any idea where that could come from?

AVRsteffen, 2023-02-04:
Can't upload video or don't know how to do..

AVRsteffen, 2023-02-04:
Uploading YouCut_20230204_124248087.mp4…

AVRsteffen, 2023-02-04:
Both, V1 and V2 uses 320x240 pixel displays with ILI9341 controller.

https://user-images.githubusercontent.com/2552410/216766812-2636734a-792d-4db0-8116-8f6c8637faad.mp4

schreibfaul1, 2023-02-04:
One cannot expect miracles from displays with SPI. This is my radio with a display from the Raspberry Pi with 480x320px. You can try setting the audio task to core 0.

https://user-images.githubusercontent.com/26044260/216769412-097a9f76-9e54-4dd8-9f91-70dd09acc656.mp4

AVRsteffen, 2023-02-04:
I use external DAC PCM5102A instead of a VS1053 module. Maybe it's because. I had already tried the original 480x320 px RaspberryPi display. It was just as slow. As I said, there seem to be breaks between the individual pictures. I'll try the audio task with the Core 0.

AVRsteffen, 2023-07-29:
The problem is not solved for me yet. How fast is your display in V2 and with which hardware configuration? What I do wrong?

My configuratuon:
• ESP32 WROVER / 4MB Flash / 8MB PSRAM
• DAC PCM5102A
• DISPLAY ILI9488 480x320 pixel @ 40MHz
• SD Card 32GB at 80MHz

Uploading YouCut_20230729_151225011.mp4…

steve6375, 2023-07-29:
Button load speed can be affected by the SD card frequency
Try increasing speed in common.h
We cannot see your settings so we do not know what settings you are using.

AVRsteffen, 2023-07-29:
I can't increase anymore. I use already 80MHz for SD/MMC card. I did try with 40MHz, 20MHz and differend cards to. It's nothing speed up graphics. If speedup TFT frequency to 80MHz I get some wrong graphics. Mainly the buttons are wrong drawed.

What configuration you have?

valera39, 2023-07-29:
try changing AUDIOTASK_CORE to 0 and AUDIOTASK_PRIO to 2

steve6375, 2023-07-29:
See #262

AVRsteffen, 2023-07-29:
Here I will show you:

https://github.com/schreibfaul1/ESP32-MiniWebRadio/assets/2552410/4d44b6f3-932a-4a6e-9a5f-41a9c2d6c092

valera39, 2023-07-29:
What if you also try another card of a higher grade?

AVRsteffen, 2023-07-29:
My common.h

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

ESP32 Chip: ESP32-D0WD-V3
Arduino Version: 2.0.11
ESP-IDF Version: 4.4.4
MiniWebRadio Version 2.8.3b Jul 22/2023
CPU speed 240 MHz
ARDUINO_LOOP_STACK_SIZE 8192 words (32 bit)
FLASH size 8388608 bytes, speed 40 MHz
PSRAM total size: 8388608 bytes

00:00:00
00:00:00 ***************************
00:00:00 * MiniWebRadio V2 *
00:00:00 ***************************
00:00:00
00:00:00 setup: .... Arduino is pinned to core 1
00:00:00 tft_info: . init ILI9488
00:00:00 setup: .... Init SD card
00:00:00 setup: .... SD card found, 3762.6 MB by 3781.5 MB free
00:00:01 setup: .... seek for stations.csv
00:00:01 setup: .... stations.csv found
00:00:01 setup: .... seek for WiFi networks
[ 1638][I][WiFiMulti.cpp:84] addAP(): [WIFI][APlistAdd] add SSID: mySSID

I am just pinned core in common.h to core --> 0
And I guess TFT runs faster..

AVRsteffen, 2023-07-29:
I am just tested - TFT runs faster with core -> 0 in common.h

What I don't understand is terminals output "Arduino is pinned to core 1" in both configurations of core!

steve6375, 2023-07-29:
I pushed my ILI9341 to use
```
#define TFT_FREQUENCY       70000000                // 27000000, 40000000, 80000000
#define SDMMC_FREQUENCY     70000000          // 40000000, 2000000, 10000000, not every SD Card will run at 40MHz
```

valera39, 2023-07-29:
What if you also try another higher end card?

steve6375, 2023-07-29:
https://randomnerdtutorials.com/esp32-dual-core-arduino-ide/
Arduino uses 1
Audio uses 0
I tested changing to priority 12

```
00:00:00 setup: ....  Arduino is pinned to core 1
00:00:00 tft_info: .  init ILI9341
00:00:00 setup: ....  Init SD card
00:00:00 setup: ....  SD card found, 3381.6 MB by 3886.5 MB free
00:00:01 setup: ....  seek for stations.csv
00:00:01 setup: ....  stations.csv found
00:00:01 setup: ....  seek for WiFi networks
..
17:06:08 rtime_info:  17:06:08
17:06:08 audiotask:   is pinned to core 0
17:06:08 audiotask:   priority is 12

```

Jefke1, 2023-07-31:
> Here I will show you:
>
>  YouCut_20230729_151225011.mp4

What strikes me is not the speed. But your VU meter the color is white with me when in action it is colored and the top part is darker.

AVRsteffen, 2023-07-31:
This is only a effect of camera.

Closed 2023-05-15.

Thread 144 (2023-03-25):

DLNA buttons are not displayed

valera39, 2023-03-25:
Hello Wolle!
There are buttons on the SD card, but they are not displayed on the screen
And there are still no tags
And are there any restrictions on the number of files and folders on the DLNA server?
When reading the catalog, the radio is rebooted

���ESP-ROM:esp32s3-20210327
Build:Mar 27 2021
rst:0xc (RTC_SW_CPU_RST),boot:0x8 (SPI_FAST_FLASH_BOOT)
Saved PC:0x420c4dfe
SPIWP:0xee
mode:DIO, clock div:1
load:0x3fce3808,len:0x44c
load:0x403c9700,len:0xbec
load:0x403cc700,len:0x2920
entry 0x403c98d8
E (507) psram: PSRAM ID read error: 0x00ffffff
[0;33m[   508][W][esp32-hal-psram.c:71] psramInit(): PSRAM init failed![0m
E (508) esp_core_dump_flash: No core dump partition found!
E (512) esp_core_dump_flash: No core dump partition found!
ESP32 Chip: ESP32-S3
Arduino Version: 2.0.6
ESP-IDF Version: 4.4.3
ARDUINO_LOOP_STACK_SIZE 8192 words (32 bit)

18:28:55    [0m
18:28:55 [33m       ***************************    [0m
18:28:55 [33m       *     MiniWebRadio V2     *    [0m
18:28:55 [33m       ***************************    [0m
18:28:55    [0m
18:28:55 setup: ....  Arduino is pinned to core [36m1[0m
18:28:55 tft_info: .  init [36mILI9488[0m
18:28:55 setup: ....  Init SD card[0m
18:28:55 [37msetup: ....  SD card found[0m
E (333) ledc: ledc_get_duty(739): LEDC is not initialized
18:28:56 setup: ....  seek for stations.csv[0m
18:28:56 setup: ....  stations.csv found[0m
18:28:56 setup: ....  seek for WiFi networks[0m
[0;32m[  1751][I][WiFiMulti.cpp:84] addAP(): [WIFI][APlistAdd] add SSID: ASUS_AC66U[0m
[0;32m[  1766][I][WiFiMulti.cpp:84] addAP(): [WIFI][APlistAdd] add SSID: Honor[0m
[0;32m[  1768][I][WiFiMulti.cpp:84] addAP(): [WIFI][APlistAdd] add SSID: network_01[0m
[0;32m[  1771][I][WiFiMulti.cpp:84] addAP(): [WIFI][APlistAdd] add SSID: network_02[0m
[0;32m[  1779][I][WiFiMulti.cpp:84] addAP(): [WIFI][APlistAdd] add SSID: network_03[0m
[0;32m[  1787][I][WiFiMulti.cpp:84] addAP(): [WIFI][APlistAdd] add SSID: network_04[0m
[0;32m[  1795][I][WiFiMulti.cpp:84] addAP(): [WIFI][APlistAdd] add SSID: network_04[0m
[0;32m[  8475][I][WiFiMulti.cpp:114] run(): [WIFI] scan done[0m
[0;32m[  8475][I][WiFiMulti.cpp:119] run(): [WIFI] 8 networks found[0m
[0;32m[  8476][I][WiFiMulti.cpp:160] run(): [WIFI] Connecting BSSID: 2C:FD:A1:C2:44:F0 SSID: ASUS_A
C66U Channel: 1 (-58)[0m
[0;32m[  8565][I][WiFiMulti.cpp:174] run(): [WIFI] Connecting done.[0m
18:29:03 WiFI_info:   Connecting WiFi...[0m
18:29:03 setup: ....  connected to [36mASUS_AC66U[37m, IP address is [36m192.168.1.55[0m
18:29:03 ftpServer:   Buffers allocated: 4622 bytes[0m
18:29:03 rtime_info:  Initializing SNTP[0m
20:29:03 rtime_info:  20:29:03[0m
20:29:03 audiotask:   is pinned to core [36m1[0m
20:29:03 audiotask:   priority is [36m2[0m
20:29:03 setup: ....  Number of saved stations: [36m88[0m
20:29:03 setup: ....  current station number: [36m2[0m
20:29:03 setup: ....  current volume: [36m3[0m
20:29:03 VS1053 chipID = [36m-1350368918[37m, version = [36m3[0m
20:29:03 action: ...  current volume is [36m3[0m
20:29:04 action: ...  switch to station [36m2[0m
20:29:04 AUDIO_info:  [32mConnect to new host: "https://stream.cassiopeia-station.ru:4565/stream"[
0m
20:29:04 AUDIO_info:  [32mSong stopped correctly after 0 msec[0m
20:29:04 AUDIO_info:  [32mPSRAM not found, inputBufferSize: 11903 bytes[0m
20:29:05 AUDIO_info:  [32mSSL has been established in 1206 ms, free Heap: 143236 bytes[0m
20:29:05 icy-descr:   Радиопередачи СССР[0m
20:29:05 AUDIO_info:  [32micy-name: Всесоюзное радио онлайн[0m
20:29:05 StationName: [35mВсесоюзное радио онлайн[0m
20:29:05 icy-url: ..  https://cassiopeia-station.ru/ussr/[0m
20:29:05 lastURL: ..  https://stream.cassiopeia-station.ru:4565/stream[0m
20:29:05 AUDIO_info:  [32mstream ready[0m
20:29:05 AUDIO_info:  [32mStreamTitle='"Соловьиная роща"'[0m
20:29:05 StreamTitle: [33m"Соловьиная роща"[0m
20:29:06 WiFI_info:   RSSI is [36m-59[37m dB[0m
20:29:06 DLNA_info:   [37mSSDP search for media servers started[0m
20:29:10 DLNA_info:   [37mSSDP query discovered 2 media servers[0m
20:29:10 DLNA_server: [37mconnected successfully to [34m192.168.1.1:8200[0m
20:29:10 DLNA_server: [37mconnected successfully to [34m192.168.1.4:6000[0m
[0;31m[ 16205][E][SoapESP32.cpp:309] soapReadHttpHeader(): header line: HTTP/1.1 404 File Not Found
[0m
20:29:10 DLNA_info:   [37mthis Server does not deliver media content[0m
20:29:11 ftpServer:   Ftp server waiting for connection on port [36m21[0m
20:29:52 DLNA:        [32mServer[0]: IP address: 192.168.1.1 port: 8200 name: RT-AC66U_B1-44F0 -> c
ontrolURL: ctl/ContentDir[0m
20:29:54 DLNA_info:   [37mnew search on server: "RT-AC66U_B1-44F0", objectId: "0"[0m
20:29:54 DLNA_folder: [38;5;214m"Browse Folders" (id: "64", childCount: 2) added to list[0m
20:29:54 DLNA_folder: [38;5;214m"Music" (id: "1", childCount: 7) added to list[0m
20:29:55 DLNA_folder: [38;5;214m"Pictures" (id: "3", childCount: 5) added to list[0m
20:29:55 DLNA_folder: [38;5;214m"Video" (id: "2", childCount: 3) added to list[0m
20:29:55 DLNA_info:   [37mfound 4 folders and 0 files[0m
20:30:00 DLNA_info:   [37mnew search on server: "RT-AC66U_B1-44F0", objectId: "1"[0m
20:30:01 DLNA_folder: [38;5;214m"Album" (id: "1$7", childCount: 3650) added to list[0m
20:30:01 DLNA_folder: [38;5;214m"All Music" (id: "1$4", childCount: 31886) added to list[0m
20:30:01 DLNA_folder: [38;5;214m"Artist" (id: "1$6", childCount: 7658) added to list[0m
20:30:01 DLNA_folder: [38;5;214m"Folders" (id: "1$14", childCount: 2) added to list[0m
20:30:01 DLNA_folder: [38;5;214m"Genre" (id: "1$5", childCount: 214) added to list[0m
20:30:01 DLNA_folder: [38;5;214m"Playlists" (id: "1$F", childCount: 117) added to list[0m
20:30:01 DLNA_folder: [38;5;214m"Recently Added" (id: "1$FF0", childCount: 50) added to list[0m
20:30:01 DLNA_info:   [37mfound 7 folders and 0 files[0m
20:30:11 DLNA_info:   [37mnew search on server: "RT-AC66U_B1-44F0", objectId: "1$4"[0m
[0;31m[ 80253][E][SoapESP32.cpp:1285] soapPost(): POST: no reply from server within 3000 ms[0m
[0;32m[ 80254][I][main.cpp:1767] DLNA_browseServer(): no content![0m
20:30:20 DLNA_info:   [37mnew search on server: "RT-AC66U_B1-44F0", objectId: "1$14"[0m
20:30:21 DLNA_folder: [38;5;214m"Советское радио (Гостелерадиофонд)" (id: "1$14$0", childCount: 612
2) added to list[0m
20:30:21 DLNA_folder: [38;5;214m"музыка" (id: "1$14$1", childCount: 265) added to list[0m
20:30:21 DLNA_info:   [37mfound 2 folders and 0 files[0m
20:30:25 DLNA_info:   [37mnew search on server: "RT-AC66U_B1-44F0", objectId: "1$14$0"[0m
20:30:25 DLNA_file:   [38;5;214m"А люди уходят в море. Поет Эдуард Хиль (1968)" (id: "1$14$0$0", si
ze: 5798781, sizeMissing: false, type: audio) added to list[0m
20:30:25 DLNA_file:   [38;5;214m"А. Островский, К. Ваншенкин. Как провожают пароходы. Поют Лев Поло
син, Борис Кузнецов (1973)" (id: "1$14$0$1", size: 5162570, sizeMissing: false, type: audio) added to list[0m
20:30:25 DLNA_file:   [38;5;214m"А.Вейцлер, А.Мишарин. Песня о ветре. Радиокомпозиция спектакля Гос
ударственного Малого театра СССР" (id: "1$14$0$2", size: 132545565, sizeMissing: false, type: audio) added to list[0m
20:30:26 DLNA_file:   [38;5;214m"А.Петров. Песня о друге из кинофильма 'Путь к причалу'. Поёт Олег
Анофриев" (id: "1$14$0$3", size: 5749773, sizeMissing: false, type: audio) added to list[0m
20:30:26 DLNA_file:   [38;5;214m"А.Цфасман. 'В морозный вечер'. Поет Олег Анофриев" (id: "1$14$0$4"
, size: 4122093, sizeMissing: false, type: audio) added to list[0m
20:30:26 DLNA_file:   [38;5;214m"А.Черешнев. Музыкальная история. Рассказ-быль. Читает Георгий Абри
косов (1969)" (id: "1$14$0$5", size: 33208251, sizeMissing: false, type: audio) added to list[0m
20:30:26 DLNA_file:   [38;5;214m"Абдулла Каххар. Птичка-невеличка. Радиоспектакль по одноименной по
вести (1960)" (id: "1$14$0$6", size: 86263257, sizeMissing: false, type: audio) added to list[0m
20:30:26 DLNA_file:   [38;5;214m"Агата Кристи, Буало-Нарсежак, Дональд Эдвин Уэстлейк. Детектив с у
лыбкой. Радиоспектакль" (id: "1$14$0$7", size: 47315619, sizeMissing: false, type: audio) added to list[0m
20:30:26 DLNA_file:   [38;5;214m"Агата Кристи. 13 загадок. Радиоспектакль. Часть 1" (id: "1$14$0$8"
, size: 76825677, sizeMissing: false, type: audio) added to list[0m
20:30:26 DLNA_file:   [38;5;214m"Агата Кристи. 13 загадок. Радиоспектакль. Часть 2" (id: "1$14$0$9"
, size: 48860077, sizeMissing: false, type: audio) added to list[0m
20:30:26 DLNA_file:   [38;5;214m"Агата Кристи. Вилла 'Белый конь'. Радиоспектакль. Часть 1. 'Записк
а в башмаке'" (id: "1$14$0$A", size: 103831485, sizeMissing: false, type: audio) added to list[0m
20:30:26 DLNA_file:   [38;5;214m"Агата Кристи. Вилла 'Белый конь'. Радиоспектакль. Часть 2. 'Магия
белая и черная'" (id: "1$14$0$B", size: 90616653, sizeMissing: false, type: audio) added to list[0m

20:30:26 DLNA_file:   [38;5;214m"Агата Кристи. Восточный экспресс. Радиопостановка. Часть 1" (id: "
1$14$0$C", size: 275205165, sizeMissing: false, type: audio) added to list[0m
20:30:26 DLNA_file:   [38;5;214m"Агата Кристи. Восточный экспресс. Радиопостановка. Часть 2" (id: "
1$14$0$D", size: 249436701, sizeMissing: false, type: audio) added to list[0m
20:30:26 DLNA_file:   [38;5;214m"Агата Кристи. Дом в Ширазе. Радиоспектакль по одноименному рассказ
у" (id: "1$14$0$E", size: 36407822, sizeMissing: false, type: audio) added to list[0m
20:30:26 DLNA_file:   [38;5;214m"Агата Кристи. Если вы – молодая леди... Радиопостановка по рассказ
у 'Джейн ищет работу'" (id: "1$14$0$F", size: 57619149, sizeMissing: false, type: audio) added to list[0m
20:30:26 DLNA_file:   [38;5;214m"Агата Кристи. Медовый месяц Аликс Мартин. Радиоспектакль" (id: "1$
14$0$10", size: 47396645, sizeMissing: false, type: audio) added to list[0m
20:30:26 DLNA_file:   [38;5;214m"Агата Кристи. Мышеловка. Радиоспектакль. Часть 1" (id: "1$14$0$11"
, size: 88846509, sizeMissing: false, type: audio) added to list[0m
20:30:26 DLNA_file:   [38;5;214m"Агата Кристи. Мышеловка. Радиоспектакль. Часть 2" (id: "1$14$0$12"
, size: 74906847, sizeMissing: false, type: audio) added to list[0m
20:30:26 DLNA_file:   [38;5;214m"Агата Кристи. Свидетель обвинения. Радиоспектакль. Детективная ист
ория об убийстве и любви" (id: "1$14$0$13", size: 47461377, sizeMissing: false, type: audio) added to list[0m
20:30:26 DLNA_file:   [38;5;214m"Агата Кристи. Таинственный посетитель. Радиоспектакль по рассказу
'Когда боги смеются'" (id: "1$14$0$14", size: 48869358, sizeMissing: false, type: audio) added to list[0m
20:30:26 DLNA_file:   [38;5;214m"Агата Кристи. Тайна испанской шали. Инсценированный рассказ" (id:
"1$14$0$15", size: 39953664, sizeMissing: false, type: audio) added to list[0m
20:30:26 DLNA_file:   [38;5;214m"Агата Кристи. Тайна китайской вазы. Радиоспектакль" (id: "1$14$0$1
6", size: 78766605, sizeMissing: false, type: audio) added to list[0m
20:30:26 DLNA_file:   [38;5;214m"Агата Кристи. Убийство в каретном ряду. Радиоспектакль. Часть 1" (
id: "1$14$0$17", size: 53911341, sizeMissing: false, type: audio) added to list[0m
20:30:26 DLNA_file:   [38;5;214m"Агата Кристи. Убийство в каретном ряду. Радиоспектакль. Часть 2" (
id: "1$14$0$18", size: 54261933, sizeMissing: false, type: audio) added to list[0m
20:30:26 DLNA_file:   [38;5;214m"Агата Кристи. Убийство за чашкой кофе. Радиопостановка по мотивам
рассказа" (id: "1$14$0$19", size: 48093230, sizeMissing: false, type: audio) added to list[0m
20:30:26 DLNA_file:   [38;5;214m"Агата Кристи. Убийство миссис Спенлоу. Радиоспектакль" (id: "1$14$
0$1A", size: 88115757, sizeMissing: false, type: audio) added to list[0m
20:30:26 DLNA_file:   [38;5;214m"Агния Барто. Вечером в классе. Читает Рина Зеленая (1951)" (id: "1
$14$0$1B", size: 4176856, sizeMissing: false, type: audio) added to list[0m
20:30:26 DLNA_file:   [38;5;214m"Агния Кузнецова. Изба раздумий. Радиоспектакль по мотивам повести
'Земной поклон'. Часть 1" (id: "1$14$0$1C", size: 85997661, sizeMissing: false, type: audio) added to list[0m
20:30:26 DLNA_file:   [38;5;214m"Агния Кузнецова. Изба раздумий. Радиоспектакль по мотивам повести
'Земной поклон'. Часть 2" (id: "1$14$0$1D", size: 93864741, sizeMissing: false, type: audio) added to list[0m
20:30:26 DLNA_file:   [38;5;214m"Агния Кузнецова. Свет-трава. Страницы повести. Читает Александр Ми
хайлов (1981)" (id: "1$14$0$1E", size: 49121564, sizeMissing: false, type: audio) added to list[0m
20:30:26 DLNA_file:   [38;5;214m"Адель Кутуй. Неотосланные письма. Радиопостановка" (id: "1$14$0$1F
", size: 96007869, sizeMissing: false, type: audio) added to list[0m
20:30:26 DLNA_file:   [38;5;214m"Азиз Несин. Рассказы. Читают Александр Леньков, Борис Иванов" (id:
 "1$14$0$20", size: 52897577, sizeMissing: false, type: audio) added to list[0m
20:30:26 DLNA_file:   [38;5;214m"Азиз Несин. Юмористические рассказы. Читают Евгений Весник, Сергей
 Харченко" (id: "1$14$0$21", size: 46972413, sizeMissing: false, type: audio) added to list[0m
20:30:26 DLNA_file:   [38;5;214m"Айме Марипуу. Голоса чаек. Радиоспектакль" (id: "1$14$0$22", size:
 60213816, sizeMissing: false, type: audio) added to list[0m
20:30:27 DLNA_file:   [38;5;214m"Айрин Хант. Недобрый ветер. Радиоспектакль" (id: "1$14$0$23", size
: 65018777, sizeMissing: false, type: audio) added to list[0m
20:30:27 DLNA_file:   [38;5;214m"Акоп Паронян. Дядя Багдасар. Комедия в исполнении артистов Театра
им. Евг.Вахтангова" (id: "1$14$0$24", size: 80031643, sizeMissing: false, type: audio) added to list[0m
20:30:27 DLNA_file:   [38;5;214m"Актер Андрей Миронов - о себе, ролях в кино и творческих планах" (
id: "1$14$0$25", size: 78903450, sizeMissing: false, type: audio) added to list[0m
20:30:27 DLNA_file:   [38;5;214m"Алан Маршалл. Колченогая динго. Рассказ. Читает Виктор Хохряков (1
968)" (id: "1$14$0$26", size: 55548813, sizeMissing: false, type: audio) added to list[0m
20:30:27 DLNA_file:   [38;5;214m"Алан Уиннингтон. Остановка' Берлин. Радиопостановка по одноименном
у роману. Часть 1" (id: "1$14$0$27", size: 75481417, sizeMissing: false, type: audio) added to list
[0m
20:30:27 DLNA_file:   [38;5;214m"Алан Уиннингтон. Остановка' Берлин. Радиопостановка по одноименном
у роману. Часть 2" (id: "1$14$0$28", size: 70478911, sizeMissing: false, type: audio) added to list
[0m
20:30:27 DLNA_file:   [38;5;214m"Александр Абрамов. Когда скорый опаздывает. Радиопостановка" (id:
"1$14$0$29", size: 91351341, sizeMissing: false, type: audio) added to list[0m
20:30:27 DLNA_file:   [38;5;214m"Александр Абрамов. Уходит поезд. Поет Геннадий Белов" (id: "1$14$0
$2A", size: 6239877, sizeMissing: false, type: audio) added to list[0m
20:30:27 DLNA_file:   [38;5;214m"Александр Авдеенко. В поте лица своего. Страницы романа. Передача
1. Читает Леонид Марков" (id: "1$14$0$2B", size: 49343853, sizeMissing: false, type: audio) added to list[0m
20:30:27 DLNA_file:   [38;5;214m"Александр Авдеенко. В поте лица своего. Страницы романа. Передача
2. Читает Леонид Марков" (id: "1$14$0$2C", size: 39567172, sizeMissing: false, type: audio) added to list[0m
20:30:27 DLNA_file:   [38;5;214m"Александр Авдеенко. В поте лица своего. Страницы романа. Передача
3. Читает Леонид Марков" (id: "1$14$0$2D", size: 41802940, sizeMissing: false, type: audio) added to list[0m
20:30:27 DLNA_file:   [38;5;214m"Александр Авдеенко. В поте лица своего. Страницы романа. Передача
4. Читает Леонид Марков" (id: "1$14$0$2E", size: 44838477, sizeMissing: false, type: audio) added to list[0m
20:30:27 DLNA_file:   [38;5;214m"Александр Авдеенко. В поте лица своего. Страницы романа. Передача
5. Читает Леонид Марков" (id: "1$14$0$2F", size: 46990965, sizeMissing: false, type: audio) added to list[0m
20:30:27 DLNA_file:   [38;5;214m"Александр Авдеенко. Граница. Страницы повести. Передача 1. Читает
Вячеслав Расцветаев" (id: "1$14$0$30", size: 44965461, sizeMissing: false, type: audio) added to list[0m
20:30:27 DLNA_file:   [38;5;214m"Александр Авдеенко. Граница. Страницы повести. Передача 2. Читает
Вячеслав Расцветаев" (id: "1$14$0$31", size: 35345918, sizeMissing: false, type: audio) added to list[0m
20:30:27 DLNA_file:   [38;5;214m"Александр Авдеенко. Граница. Страницы повести. Передача 3. Читает
Вячеслав Расцветаев" (id: "1$14$0$32", size: 36226469, sizeMissing: false, type: audio) added to list[0m
20:30:27 DLNA_file:   [38;5;214m"Александр Авдеенко. Граница. Страницы повести. Передача 4. Читает
Вячеслав Расцветаев" (id: "1$14$0$33", size: 37944051, sizeMissing: false, type: audio) added to list[0m
20:30:27 DLNA_file:   [38;5;214m"Александр Авдеенко. Граница. Страницы повести. Передача 5. Читает
Вячеслав Расцветаев" (id: "1$14$0$34", size: 35046419, sizeMissing: false, type: audio) added to list[0m
20:30:27 DLNA_file:   [38;5;214m"Александр Авдеенко. Я люблю. Радиопостановка. По одноименному рома
ну (1959)" (id: "1$14$0$35", size: 92254199, sizeMissing: false, type: audio) added to list[0m
20:30:27 DLNA_file:   [38;5;214m"Александр Азарх. Бывает и так. Радиоспектакль" (id: "1$14$0$36", s
ize: 120395181, sizeMissing: false, type: audio) added to list[0m
20:30:27 DLNA_file:   [38;5;214m"Александр Андреев. Путь многих. Радиопостановка по одноименному ро
ману (1955)" (id: "1$14$0$37", size: 107086017, sizeMissing: false, type: audio) added to list[0m
20:30:27 DLNA_file:   [38;5;214m"Александр Антокольский. Ночная прогулка. Радиоспектакль. Часть 1.
'Поиск'" (id: "1$14$0$38", size: 63537100, sizeMissing: false, type: audio) added to list[0m
20:30:27 DLNA_file:   [38;5;214m"Александр Антокольский. Ночная прогулка. Радиоспектакль. Часть 2.
'Взрыв'" (id: "1$14$0$39", size: 75819299, sizeMissing: false, type: audio) added to list[0m
20:30:27 DLNA_file:   [38;5;214m"Александр Афанасьев. Срока давности не имеет. Радиоспектакль" (id:
 "1$14$0$3A", size: 139202973, sizeMissing: false, type: audio) added to list[0m
20:30:27 DLNA_file:   [38;5;214m"Александр Афиногенов. Далекое. Радиоспектакль по одноименной пьесе
 (1965)" (id: "1$14$0$3B", size: 86155437, sizeMissing: false, type: audio) added to list[0m
20:30:27 DLNA_file:   [38;5;214m"Александр Афиногенов. Мать своих детей. Радиокомпозиция спектакля
Центрального театра Транспорта" (id: "1$14$0$3C", size: 143487189, sizeMissing: false, type: audio)
added to list[0m
20:30:27 DLNA_file:   [38;5;214m"Александр Афиногенов. Машенька. Спектакль Московского Театра-студи
и Киноактера" (id: "1$14$0$3D", size: 178947499, sizeMissing: false, type: audio) added to list[0m
20:30:27 DLNA_file:   [38;5;214m"Александр Барков. Краса земли родной. Рассказ. Читает Виктор Коршу
нов" (id: "1$14$0$3E", size: 36964620, sizeMissing: false, type: audio) added to list[0m
20:30:27 DLNA_file:   [38;5;214m"Александр Барков. Рассказы о птицах. Читает Н.Литвинов" (id: "1$14
$0$3F", size: 36019917, sizeMissing: false, type: audio) added to list[0m
20:30:28 DLNA_file:   [38;5;214m"Александр Бармак. Тебе певцу, тебе герою... Денис Давыдов. Радиосп
ектакль" (id: "1$14$0$40", size: 76849845, sizeMissing: false, type: audio) added to list[0m
20:30:28 DLNA_file:   [38;5;214m"Александр Баужа. На заводе. Радиопостановка" (id: "1$14$0$41", siz
e: 55862205, sizeMissing: false, type: audio) added to list[0m
20:30:28 DLNA_file:   [38;5;214m"Александр Бек. Волоколамское шоссе. Радиокомпозиция спектакля" (id
: "1$14$0$42", size: 110915445, sizeMissing: false, type: audio) added to list[0m
20:30:28 DLNA_file:   [38;5;214m"Александр Блок. Всё та же озерная гладь... Стихотворение. Читает К
озаков Михаил (1980)" (id: "1$14$0$43", size: 1133527, sizeMissing: false, type: audio) added to list[0m
20:30:28 DLNA_file:   [38;5;214m"Александр Блок. Когда-то гордый и надменный... Стихотворение. Чита
ет В.Аксенов" (id: "1$14$0$44", size: 2016909, sizeMissing: false, type: audio) added to list[0m
20:30:28 DLNA_file:   [38;5;214m"Александр Бородин. Мальчик со скрипкой. Радиоспектакль" (id: "1$14
$0$45", size: 87272493, sizeMissing: false, type: audio) added to list[0m
20:30:28 DLNA_file:   [38;5;214m"Александр Бородин. Юность Гайдна. Радиопостановка" (id: "1$14$0$46
", size: 87639645, sizeMissing: false, type: audio) added to list[0m
20:30:28 DLNA_file:   [38;5;214m"Александр Борщаговский. Медвежья шкура. Радиокомпозиция спектакля
Московского драматического театра" (id: "1$14$0$47", size: 87780822, sizeMissing: false, type: audio) added to list[0m
20:30:28 DLNA_file:   [38;5;214m"Александр Борщаговский. Стеклянные бусы. Радиопостановка" (id: "1$
14$0$48", size: 93333789, sizeMissing: false, type: audio) added to list[0m
20:30:28 DLNA_file:   [38;5;214m"Александр Брежнев. Ветер Марии. Рассказ. Читает Маргарита Рассказо
ва" (id: "1$14$0$49", size: 30944459, sizeMissing: false, type: audio) added to list[0m
20:30:28 DLNA_file:   [38;5;214m"Александр Брежнев. Дальняя сторонка. Рассказ. Читает Александр Бор
дуков" (id: "1$14$0$4A", size: 58863038, sizeMissing: false, type: audio) added to list[0m
20:30:28 DLNA_file:   [38;5;214m"Александр Брежнев. Монах Никита. Рассказ. Читает Василий Бочкарев"
 (id: "1$14$0$4B", size: 58557275, sizeMissing: false, type: audio) added to list[0m
20:30:28 DLNA_file:   [38;5;214m"Александр Брежнев. Один. Рассказ. Читает Олег Форостенко" (id: "1$
14$0$4C", size: 67795394, sizeMissing: false, type: audio) added to list[0m
20:30:28 DLNA_file:   [38;5;214m"Александр Брежнев. Пирогов. Инсценированные страницы повести. Част
ь 1" (id: "1$14$0$4D", size: 69981357, sizeMissing: false, type: audio) added to list[0m
20:30:28 DLNA_file:   [38;5;214m"Александр Брежнев. Пирогов. Инсценированные страницы повести. Част
ь 2" (id: "1$14$0$4E", size: 62242197, sizeMissing: false, type: audio) added to list[0m
20:30:28 DLNA_file:   [38;5;214m"Александр Брежнев. Прощание. Рассказ. Читает Виктор Зозулин" (id:
"1$14$0$4F", size: 58955947, sizeMissing: false, type: audio) added to list[0m
20:30:28 DLNA_file:   [38;5;214m"Александр Брежнев. Псих Филипп и другие. Рассказ. Читает Олег Форо
стенко" (id: "1$14$0$50", size: 50168226, sizeMissing: false, type: audio) added to list[0m
20:30:28 DLNA_file:   [38;5;214m"Александр Брежнев. Русская лошадка. Рассказ. Читает Рогволд Сухове
рко" (id: "1$14$0$51", size: 53242723, sizeMissing: false, type: audio) added to list[0m
20:30:28 DLNA_file:   [38;5;214m"Александр Брежнев. Свет России. Рассказ. Читает Василий Бочкарев"
(id: "1$14$0$52", size: 61542829, sizeMissing: false, type: audio) added to list[0m
20:30:28 DLNA_file:   [38;5;214m"Александр Брежнев. Снег на Рождество. Страницы повести. Читает Ник
олай Пеньков" (id: "1$14$0$53", size: 57723826, sizeMissing: false, type: audio) added to list[0m
20:30:28 DLNA_file:   [38;5;214m"Александр Брежнев. Тихие радости. Рассказ. Читает Алексей Покровск
ий" (id: "1$14$0$54", size: 70859529, sizeMissing: false, type: audio) added to list[0m
20:30:28 DLNA_file:   [38;5;214m"Александр Брежнев. Я люблю Россию, люблю честь Родины. Радиокомпоз
иция по книге 'Пирогов'. Часть 1" (id: "1$14$0$55", size: 68991780, sizeMissing: false, type: audio) added to list[0m
20:30:28 DLNA_file:   [38;5;214m"Александр Брежнев. Я люблю Россию, люблю честь Родины. Радиокомпоз
иция по книге 'Пирогов'. Часть 2" (id: "1$14$0$56", size: 55983826, sizeMissing: false, type: audio) added to list[0m
20:30:28 DLNA_file:   [38;5;214m"Александр Брежнев. Ярославна. Рассказ. Читает Вячеслав Шалевич" (i
d: "1$14$0$57", size: 51822861, sizeMissing: false, type: audio) added to list[0m
20:30:28 DLNA_file:   [38;5;214m"Александр Вампилов. Двадцать минут с ангелом. Радиоспектакль" (id:
 "1$14$0$58", size: 78302338, sizeMissing: false, type: audio) added to list[0m
20:30:28 DLNA_file:   [38;5;214m"Александр Вампилов. Дом окнами в поле. Радиоспектакль" (id: "1$14$
0$59", size: 71824413, sizeMissing: false, type: audio) added to list[0m
20:30:28 DLNA_file:   [38;5;214m"Александр Вампилов. Прошлым летом в Чулимске. Радиокомпозиция спек
такля Театра им. М.Н.Ермоловой" (id: "1$14$0$5A", size: 214093773, sizeMissing: false, type: audio)
added to list[0m
20:30:28 DLNA_file:   [38;5;214m"Александр Вампилов. Успех. Радиоспектакль" (id: "1$14$0$5B", size:
 41914935, sizeMissing: false, type: audio) added to list[0m
20:30:28 DLNA_file:   [38;5;214m"Александр Вельтман. Не дом, а игрушечка! Страницы повести. Читает
Вера Васильева. Передача 1" (id: "1$14$0$5C", size: 71459718, sizeMissing: false, type: audio) added to list[0m
20:30:28 DLNA_file:   [38;5;214m"Александр Вельтман. Не дом, а игрушечка! Страницы повести. Читает
Вера Васильева. Передача 2" (id: "1$14$0$5D", size: 60618422, sizeMissing: false, type: audio) added to list[0m
20:30:28 DLNA_file:   [38;5;214m"Александр Вилькин. Пока стучит сердце. Документальный радиоспектак
ль" (id: "1$14$0$5E", size: 95675931, sizeMissing: false, type: audio) added to list[0m
20:30:29 DLNA_file:   [38;5;214m"Александр Волков. Волшебник Изумрудного города. Передача 1. Читает
 Н.Литвинов" (id: "1$14$0$5F", size: 14650557, sizeMissing: false, type: audio) added to list[0m
20:30:29 DLNA_file:   [38;5;214m"Александр Волков. Волшебник Изумрудного города. Передача 10. Читае
т Н.Литвинов" (id: "1$14$0$60", size: 13808013, sizeMissing: false, type: audio) added to list[0m
20:30:29 DLNA_file:   [38;5;214m"Александр Волков. Волшебник Изумрудного города. Передача 11. Читае
т Н.Литвинов" (id: "1$14$0$61", size: 14310381, sizeMissing: false, type: audio) added to list[0m
20:30:29 DLNA_file:   [38;5;214m"Александр Волков. Волшебник Изумрудного города. Передача 12. Читае
т Н.Литвинов" (id: "1$14$0$62", size: 14332365, sizeMissing: false, type: audio) added to list[0m
20:30:29 DLNA_file:   [38;5;214m"Александр Волков. Волшебник Изумрудного города. Передача 13. Читае
т Н.Литвинов" (id: "1$14$0$63", size: 13631565, sizeMissing: false, type: audio) added to list[0m
20:30:29 DLNA_info:   [37mfound 0 folders and 100 files[0m
Guru Meditation Error: Core  1 panic'ed (LoadProhibited). Exception was unhandled.

Core  1 register dump:
PC      : 0x400556d5  PS      : 0x00060830  A0      : 0x820239bc  A1      : 0x3fced7e0
A2      : 0x00000000  A3      : 0xfffffffc  A4      : 0x000000ff  A5      : 0x0000ff00
A6      : 0x00ff0000  A7      : 0xff000000  A8      : 0x00000000  A9      : 0x3fced7b0
A10     : 0x3fced898  A11     : 0x00000000  A12     : 0x00000000  A13     : 0x0000000b
A14     : 0x00000000  A15     : 0x76757473  SAR     : 0x00000013  EXCCAUSE: 0x0000001c
EXCVADDR: 0x00000000  LBEG    : 0x400556d5  LEND    : 0x400556e5  LCOUNT  : 0xffffffff

Backtrace: 0x400556d2:0x3fced7e0 |<-CORRUPTED

ELF file SHA256: d652e3749b102a6e

E (5008) esp_core_dump_flash: Core dump flash config is corrupted! CRC=0x7bd5c66f instead of 0x0
Rebooting...

schreibfaul1, 2023-03-25:
Hello @valera39,
you are ahead of the curve DLNA will soon have its own section, for which I need new buttons.

The error looks like lack of memory. The soap library should be able to process 200 entries per directory. I will test that.

valera39, 2023-03-25:
Thanks for the quick response! I just really like your project, so I'm in such a hurry :)
Is it better to use ESP32S3 C PSRAM?

schreibfaul1, 2023-03-27:
A DLNA directory is no longer transmitted to the web as a complete block, but sequentially each entry one after the other. This takes longer, but no PSRAM is necessary for this and the DLNA directory can be very long.

Closed 2023-03-27.

Thread 146 (2023-04-02):

SD Card Mount Failed

prairietech, 2023-04-02:
I'm getting this error message. Pull-up resistors are in place and I have tried without pull-ups. Using the SD adapter as shown in the additional info folder.  All I have are SanDisk 4gig cards to use. SDMMC freq is at default 20000000.

Noob question, I am assuming the contents of the content_on_SD_Card.zip is simply extracted and copied to the card without the folder name?

Any ideas or do I really need to find other manufactures cards to try?

00:00:00 tft_info: .  init ILI9341
00:00:00 setup: ....  Init SD card
E (198) sdmmc_common: sdmmc_init_ocr: send_op_cond (1) returned 0x107
E (199) vfs_fat_sdmmc: sdmmc_card_init failed (0x107).
[   213][E][SD_MMC.cpp:138] begin(): Failed to initialize the card (0x107). Make sure SD card lines have pull-up resistors
in place.
E (265) ledc: ledc_get_duty(739): LEDC is not initialized
00:00:00 SD Card Mount Failed

clear-sky, 2023-04-02:
hi
https://github.com/schreibfaul1/ESP32-MiniWebRadio/issues/123

prairietech, 2023-04-02:
Yes I read that post.  My connecting wires are quite short and I have jumpered both of the ground contacts on the adapter.

Now for something different. Power cycled the ESP32 and now this is continuously scrolling in the terminal window:

rst:0x10 (RTCWDT_RTC_RESET),boot:0x37 (SPI_FAST_FLASH_BOOT)
invalid header: 0xffffffff
invalid header: 0xffffffff
invalid header: 0xffffffff
invalid header: 0xffffffff
invalid header: 0xffffffff

But removing the pull-ups, I'm back to the SD Card Mount Failed issue and the scrolling error above goes away.

schreibfaul1, 2023-04-02:
If the SD card adapter is on a TFT display, series resistors (~100Ohm) could be the problem. These are okay with SPI operation, but cannot be used for SD_MMC.

prairietech, 2023-04-02:
OK, pull-ups removed since I'm running a ILI9341.
Dropped the SDMMC down to 10000000 and still have SD mount failure.
Do you actually recommend trying another brand of card other than Sandisk? I'm using 4gig. Has size been an issue?

clear-sky, 2023-04-05:
i think your problem is socket that you are using
i use a plastic sd sd card adapter and solderd wires directly to the pads
https://github.com/schreibfaul1/ESP32-MiniWebRadio/blob/master/additional_info/SD_Card_Adapter_for_SD_MMC_.jpg
but errors didnot appeared
pulled up all three data lines with 10k resistor and soldered two ground pads of adapter
that solved problem

prairietech, 2023-04-05:
I'm not sure what you mean regarding sd socket?  I did build the same adapter you referenced in the .jpg above and connected both ground pads together.  When I use pull-up resistors, the ESP32 will not boot properly.
I also tried reducing the SDMMC sample frequency to 10 MHz without success.

clear-sky, 2023-04-06:
sorry for my bad english - yes i mean that plastic adapter
i use esp32-s3 that let me change D0 clk and cmd pins on module
if you are using esp32 cant change that pins
another problem is length of wires mine is opprox 20cm
my sd card is a chip no name (chinese) 4G  and formatted fat32
copied zip file to sd card and extracted it there
i have heard that someone had success mounting sd card on esp32 with pullup only D0

prairietech, 2023-04-07:
Thanks for the advice!  Maybe I'll try a esp32-s3 instead.
Your information regarding unzipping the file on the SD card is interesting.
I'll try it this weekend when I have more time.

ve2cfb, 2023-04-11:
Hello,
Let me tell you my esperience with the SD card.
I have tried about every solutions available on this site but nothing worked.

I had a small card reader that has all the data pin with a 10K resistor connected to the +3vcc.
on top of that i change the PINMODE D0 from inputpullup to input only.
Everything works perfect.
Here are a couple picture from : https://oshwlab.com/adrirobot/micro-sd-card-module

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

Hope this help.

prairietech, 2023-04-11:
More great information, thanks!!  Now with warmer wx, it will take me longer to find time in the shack to build this solution.
73's wb0vhb

Closed 2024-02-26.

Thread 151 (2023-04-14):

editing miniwebradio.csv

clear-sky, 2023-04-14:
Hi all
i have made this radio and trying to explore it
first of all my wifi module is esp-s3-12k this module has 8M flash
i checked partition table and found that it is for 4M modules here is output after compiling the code:

Advanced Memory Usage is available via "PlatformIO Home > Project Inspect"
RAM:   [==        ]  19.4% (used 63524 bytes from 327680 bytes)
Flash: [========  ]  83.0% (used 3153277 bytes from 3801088 bytes)

as you see there is not enough space for additional develop, thus tried to edit it like below:

# Name,     Type,   SubType,   Offset,   Size,     Flags
  phy_init, data,   phy,       0x9000,   0x7000,
  factory,  app,    factory,   0x10000,  0x790000,
  nvs,      data,   nvs,       0x7A0000, 0x40000,

now lets see compiling output:

Advanced Memory Usage is available via "PlatformIO Home > Project Inspect"
RAM:   [==        ]  19.4% (used 63524 bytes from 327680 bytes)
Flash: [====      ]  39.8% (used 3153277 bytes from 7929856 bytes)
Building .pio/build/esp32dev/firmware.bin
esptool.py v4.5
Creating esp32s3 image...
Merged 2 ELF sections
Successfully created esp32s3 image.

but uploading the code fails!!!
please see terminal output:

Serial port /dev/ttyUSB0
Connecting..........

A serial exception error occurred: device reports readiness to read but returned no data (device disconnected or multiple access on port?)
Note: This error originates from pySerial. It is likely not a problem with esptool, but with the hardware connection or drivers.
For troubleshooting steps visit: https://docs.espressif.com/projects/esptool/en/latest/troubleshooting.html
*** [upload] Error 1
============================================================================================= [FAILED] Took 31.36 seconds =============================================================================================

 *  The terminal process "platformio 'run', '--target', 'upload'" terminated with exit code: 1.
 *  Terminal will be reused by tasks, press any key to close it.

this is my platformio.ini

; PlatformIO Project Configuration File
;
;   Build options: build flags, source filter
;   Upload options: custom upload port, speed and extra flags
;   Library options: dependencies, extra library storages
;   Advanced options: extra scripting
;
; Please visit documentation for the other options and examples
; https://docs.platformio.org/en/latest/platforms/espressif32.html

[env:esp32dev]
;platform = https://github.com/platformio/platform-espressif32.git#v5.1.0   ; Arduino V2.0.4
;platform = https://github.com/platformio/platform-espressif32.git#v5.2.0   ; Arduino V2.0.5
platform = https://github.com/platformio/platform-espressif32.git#v6.1.0   ; Arduino V2.0.6
;platform = https://github.com/platformio/platform-espressif32.git

;board = esp32dev ;chipmodel ESP32, 4M FLASH, USBtoTTL
;board = um_tinys3 ;chipmodel ESP32S3, 8M FLASH, HAS_PSRAM, SerialUSB
board = esp32-12k ;chipmodel ESP32S3, 8M FLASH, HAS_PSRAM, USBtoTTL

board_build.f_cpu = 240000000L
board_build.flash_size=8MB
board_build.flash_freq=80M
board_build.spiram_mode=2
framework = arduino
monitor_speed = 115200
monitor_filters = esp32_exception_decoder
board_build.partitions = miniwebradio.csv
upload_speed = 115200  ; 921600, 512000, 460800, 256000, 115200

lib_deps =
    https://github.com/schreibfaul1/ESP32-IR-Remote-Control.git
    https://github.com/schreibfaul1/ESP32-vs1053_ext.git
    https://github.com/schreibfaul1/ESP32-audioI2S.git
    https://github.com/arduino-libraries/Arduino_JSON.git

platform_packages =
;    framework-arduinoespressif32 @ https://github.com/espressif/arduino-esp32.git#2.0.4
    framework-arduinoespressif32 @ https://github.com/espressif/arduino-esp32.git#2.0.6
;    framework-arduinoespressif32 @ https://github.com/espressif/arduino-esp32.git#master ; newest release

board_upload.maximum_size = 8388608
board_upload.flash_size = 8MB
board_build.flash_mode = qio
board_build.bootloader = dio

;build_flags = -DCORE_DEBUG_LEVEL=0    ; None
;build_flags = -DCORE_DEBUG_LEVEL=1    ; Error
;build_flags = -DCORE_DEBUG_LEVEL=2    ; Warn
;build_flags = -DCORE_DEBUG_LEVEL=3    ; Info
;build_flags = -DCORE_DEBUG_LEVEL=4    ; Debug
;build_flags = -DCORE_DEBUG_LEVEL=5    ; Verbose

build_flags =
        -Wall
        -Wextra
        -std=c++17
        -std=gnu++17
        -Wdouble-promotion             ; double to float warnings
        -Wimplicit-fallthrough         ; switch case without break
        -DCORE_DEBUG_LEVEL=3
        -DCONFIG_ARDUHAL_LOG_COLORS
        -DBOARD_HAS_PSRAM
        -DARDUINO_RUNNING_CORE=1       ; Arduino Runs On Core (setup, loop)
        -DARDUINO_EVENT_RUNNING_CORE=1 ; Events Run On Core
;        -DAUDIO_LOG

build_unflags =
;       -DARDUINO_USB_CDC_ON_BOOT=0    ; traditional log
;       -DBOARD_HAS_PSRAM

after this Disgraceful failure tried this trick in arduino:
copied .scv file to this path:

/home/conrad/.arduino15/packages/esp32/hardware/esp32/2.0.7/tools/partitions/

and edited boards.txt in this path:

/home/conrad/.arduino15/packages/esp32/hardware/esp32/2.0.7/

add this lines to partitions names section:

esp32s3.menu.PartitionScheme.miniwebradio=MiniWebRadio (Ultra Huge App 7.5625MB + 250KB NVS)
esp32s3.menu.PartitionScheme.miniwebradio.build.partitions=miniwebradio
esp32s3.menu.PartitionScheme.miniwebradio.upload.maximum_size=7929856

wooow!!! it works in arduino 1.8.19
uploading without problem

but in platformio what is wrong?

schreibfaul1, 2023-04-14:
It's not a memory problem. There are different upload variants, I think you need native USB and not a UART simulation.
Look at https://github.com/platformio/platform-espressif32/tree/develop/boards
Try another board in platform.io, probably esp32-s3-devkitc-1

clear-sky, 2023-04-15:
Hi Dear Wolle
thanks for the answer
my problem solved
just installed platformio udev rules
https://docs.platformio.org/en/stable/core/installation/udev-rules.html

clear-sky, 2023-04-20:
for linux users only

for people that want what is the problem exactly
my os is linux and i did not have any axperience on platformio
in first step installed code ( free version of vscode)and tried to install platformio but did not worked
in second try installed code marketplace to enable finding platformio
platformio found and installed but it forced me to install microsoft standard c++ library
that was very odd and made me toooooo angry! because linux has the best c++ compiler
on the other hand i tried to continue testing vscode
on first step compiled and uploaded the mini web radio and worked perfectly
then tried to play with it
colsed the program and edited miniwebradio.csv file then reopend code (vscode)and tried to uploaded program
i get this error when uploading!!!
this is a bug in vscode - let me tell what happend exactly
at first upload test after uploading opened serial terminal monitor and closed code (vscode)
when you close vscode the program does not release /dev/ttyUSB0 without any message
when i try to reopen vscode when uploading program gave that error message
in fact installing udev-rules did not solve the problem because after installing i rebooted system and /dev/ttyUSB0 released
if anyone wants to solve this problem must to close serial monitor before closing vscode

Closed 2023-04-15.

Thread 162 (2023-05-10):

The touchscreen stopped working

valera39, 2023-05-10:
Hello Wolle!
I apologize for the Google translation.
I always look forward to your updates.
I moved to version 2.7.1, and my touch screen stopped working. If you carefully look at the backlight, then the moment of pressing the screen, the backlight barely blinks, but the buttons are not displayed on the screen.
I did not change the compounds. He returned to version 2.6.1 - works.
In version 2.6.2 and 2.6.3 When assembling Error:
Compiling .pio\build\esp32dev\src\main.cpp.o
src/main.cpp: In function 'void DLNA_showServer()':
src/main.cpp:1743:10: error: 'class SoapESP32' has no member named 'listServer'; did you mean 'addServer'?
     soap.listServer();
          ^~~~~~~~~~
          addServer
src/main.cpp: In function 'void DLNA_browseServer(String, uint8_t)':
src/main.cpp:1751:55: error: no matching function for call to 'SoapESP32::browseServer(int&, const char*)'
     soap.browseServer(_currentServer, objectId.c_str());
                                                       ^
In file included from src/common.h:43,
                 from src/main.cpp:24:
.pio/libdeps/esp32dev/SoapESP32/src/SoapESP32.h:182:17: note: candidate: 'bool SoapESP32::browseServer(uint8_t, const char*, soapObjectVect_t*, uint32_t, uint16_t)'
     bool        browseServer(const uint8_t srv, const char *objectId, soapObjectVect_t *browseResult,
                 ^~~~~~~~~~~~
.pio/libdeps/esp32dev/SoapESP32/src/SoapESP32.h:182:17: note:   candidate expects 5 arguments, 2 provided
src/main.cpp: In function 'void DLNA_getFileItems(String)':
src/main.cpp:1755:41: error: 'class SoapESP32' has no member named 'getMediaDownloadIP'
     String   _media_downloadIP   = soap.getMediaDownloadIP();
                                         ^~~~~~~~~~~~~~~~~~
src/main.cpp:1756:41: error: 'class SoapESP32' has no member named 'getMediaDownloadPort'
     uint16_t _media_downloadPort = soap.getMediaDownloadPort();
                                         ^~~~~~~~~~~~~~~~~~~~
src/main.cpp: In function 'void loop()':
src/main.cpp:1788:10: error: 'class SoapESP32' has no member named 'loop'
     soap.loop();
          ^~~~
*** [.pio\build\esp32dev\src\main.cpp.o] Error 1

Configuration: ESP32 S3, VS1053, ILI9488.
Thank you for updating the project, I hope my wishes [in](https://github.com/schreibfaul1/ESP32-MiniWebRadio/issues/150) will be implemented in the future.

schreibfaul1, 2023-05-10:
Hello Valera,
with the switch from the precompiled Arduino to the IDF, there are now different environments for ESP32 and ESP32-S3.
Did you choose the right environment?
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

valera39, 2023-05-10:
Yes, I did so

valera39, 2023-05-10:
At the beginning of the assembly there is a phrase: Warning! Arduino framework as an ESP-IDF component doesn't handle the `variant` field! The default `esp32` variant will be used.
Could it be a problem?

schreibfaul1, 2023-05-10:
I have tested the ESP32-S3, vs1053, ILI9488 configuration. I can not reproduce the error.

`Warning! Arduino framework as an ESP-IDF component doesn't handle the `variant` field! The default `esp32` variant will be used. You can ignore it.

I suspect a faulty build. Maybe a clean will help?
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

valera39, 2023-05-10:
I think that the connection is reliable because version 2.6.1 works excellently
I reinstalled VS Code and Platformio and sewed it again. And finally, the touchscreen earned, but strange.
I shot a small video with sound, maybe you will understand [more.](https://files.fm/f/fscjz9the)
When pressing the Mute button, a squeak appears in the dynamics and with a repeated pressing noise
Instead of sound. Also pay attention to displaying stations switching buttons. Power of the radio from the pauerbank.
And once again, in version 2.6.1 there are no such problems, everything is excellent switches and there is absolutely no noise.
Tomorrow I'll try to replace ESP32 S3 with ESP32-12K.
Thank you!

valera39, 2023-05-10:
I think that the connection is reliable because version 2.6.1 works excellently
I reinstalled VS Code and Platformio and sewed it again. And finally, the touchscreen earned, but strange.
I shot a small video with sound, maybe you will understand [more.](https://files.fm/f/fscjz9the)
When pressing the Mute button, a squeak appears in the dynamics and with a repeated pressing noise
Instead of sound. Also pay attention to displaying stations switching buttons. Power of the radio from the pauerbank.
And once again, in version 2.6.1 there are no such problems, everything is excellent switches and there is absolutely no noise.
Tomorrow I'll try to replace ESP32 S3 with ESP32S3-12K.
Thank you!

schreibfaul1, 2023-05-11:
I think I know what you mean now. That's how it should be.

https://github.com/schreibfaul1/ESP32-MiniWebRadio/assets/26044260/209c57af-6321-46ed-9225-499b9456b1ef

SD_MMC has a bug that reduces the speed, this should be fixed with the next big Arduino version (V3.0.0) change. Then the graphics are smoother.

I'm in the process of replacing the AAC decoder in the audioI2S so that aacp and aac+ can be played back in stereo. This is the case with almost all M3U8 streams. The VS1053 can already do this.

schreibfaul1, 2023-05-11:
It looks like your ESP32-S3 doesn't have PSRAM. I had increased the audio buffer, but this may cause memory problems. I reset the audio buffer to its original size.

valera39, 2023-05-11:
I replaced ESP32S3 from Espressif with ESP32S3-12K from AI-thinker. I think this is the right choice. In firmware 2.7, it is impossible to avoid extraneous noise at zero volume. Maybe this can be done by changing the code?
And can I make a "stop" button instead of "mute" to turn off the stream?
Thanks!

Closed 2023-05-18.

Thread 164 (2023-05-15):

no Audio in V2.7

Arne65, 2023-05-15:
Hallo Wolle
A great project, thank you very much

in V2.7 I have neither with VS1053 nor with PCM5102A audio.
In V2.6 both boards run without problems. Can you maybe give me a tip?
Best regards

schreibfaul1, 2023-05-15:
Hello Arne65,
another user has already reported a similar problem. It looks as if the switching of the environments (ESP32, ESP32-S3) no longer works as safely as before.
I have therefore adapted the platformio.ini, which now switches both targets separately. Hope that's the cause, I'm not sure, but I'd be happy if you test this again.

Arne65, 2023-05-16:
Hello Wolle

Thanks for your quick reaction. I tested it, but unfortunately it doesn't work. When compiling, I noticed that the following warnings appeared.

Compiling .pio\build\esp32\Preferences.o
C:/Users/jop/.platformio/packages/framework-arduinoespressif32-src-52b8cdec3e60619426e51a1d18d1c3fa/libraries/I2S/src/I2S.cpp: In member function 'int I2SClass::_installDriver()':
C:/Users/jop/.platformio/packages/framework-arduinoespressif32-src-52b8cdec3e60619426e51a1d18d1c3fa/libraries/I2S/src/I2S.cpp:148:3: warning: missing initializer for member 'esp_i2s::i2s_driver_config_t::tx_desc_auto_clear' [-Wmissing-field-initializers]
   };
   ^
C:/Users/jop/.platformio/packages/framework-arduinoespressif32-src-52b8cdec3e60619426e51a1d18d1c3fa/libraries/I2S/src/I2S.cpp:148:3: warning: missing initializer for member 'esp_i2s::i2s_driver_config_t::fixed_mclk' [-Wmissing-field-initializers]
C:/Users/jop/.platformio/packages/framework-arduinoespressif32-src-52b8cdec3e60619426e51a1d18d1c3fa/libraries/I2S/src/I2S.cpp:148:3: warning: missing initializer for member 'esp_i2s::i2s_driver_config_t::mclk_multiple' [-Wmissing-field-initializers]
C:/Users/jop/.platformio/packages/framework-arduinoespressif32-src-52b8cdec3e60619426e51a1d18d1c3fa/libraries/I2S/src/I2S.cpp:148:3: warning: missing initializer for member 'esp_i2s::i2s_driver_config_t::bits_per_chan' [-Wmissing-field-initializers]
C:/Users/jop/.platformio/packages/framework-arduinoespressif32-src-52b8cdec3e60619426e51a1d18d1c3fa/libraries/I2S/src/I2S.cpp: In member function 'int I2SClass::_applyPinSetting()':
C:/Users/jop/.platformio/packages/framework-arduinoespressif32-src-52b8cdec3e60619426e51a1d18d1c3fa/libraries/I2S/src/I2S.cpp:324:5: warning: missing initializer for member 'esp_i2s::i2s_pin_config_t::mck_io_num' [-Wmissing-field-initializers]
     };
     ^
In file included from C:/Users/jop/.platformio/packages/framework-arduinoespressif32-src-52b8cdec3e60619426e51a1d18d1c3fa/cores/esp32/esp32-hal.h:80,
                 from C:/Users/jop/.platformio/packages/framework-arduinoespressif32-src-52b8cdec3e60619426e51a1d18d1c3fa/cores/esp32/Arduino.h:36,
                 from C:/Users/jop/.platformio/packages/framework-arduinoespressif32-src-52b8cdec3e60619426e51a1d18d1c3fa/libraries/I2S/src/I2S.cpp:19:
C:/Users/jop/.platformio/packages/framework-arduinoespressif32-src-52b8cdec3e60619426e51a1d18d1c3fa/libraries/I2S/src/I2S.cpp: In member function 'int I2SClass::_gpioToAdcUnit(gpio_num_t, esp_i2s::adc_unit_t*)':
C:/Users/jop/.platformio/packages/framework-arduinoespressif32-src-52b8cdec3e60619426e51a1d18d1c3fa/cores/esp32/esp32-hal-log.h:143:38: warning: this statement may fall through [-Wimplicit-fallthrough=] #define log_w(format, ...) log_printf(ARDUHAL_LOG_FORMAT(W, format), ##__VA_ARGS__)
                            ~~~~~~~~~~^~~~~~~~~~~~~~~~~~~~~~~~~~~~~~~~~~~~~~~~~~~~~~
C:/Users/jop/.platformio/packages/framework-arduinoespressif32-src-52b8cdec3e60619426e51a1d18d1c3fa/libraries/I2S/src/I2S.cpp:1068:7: note: in expansion of macro 'log_w'
       log_w("GPIO 0 for ADC should not be used for dev boards due to external auto program circuits.");
       ^~~~~
C:/Users/jop/.platformio/packages/framework-arduinoespressif32-src-52b8cdec3e60619426e51a1d18d1c3fa/libraries/I2S/src/I2S.cpp:1069:5: note: here
     case GPIO_NUM_4:

Compiling .pio\build\esp32s3\Preferences.o
C:/Users/jop/.platformio/packages/framework-arduinoespressif32-src-52b8cdec3e60619426e51a1d18d1c3fa/libraries/I2S/src/I2S.cpp: In member function 'int I2SClass::_installDriver()':
C:/Users/jop/.platformio/packages/framework-arduinoespressif32-src-52b8cdec3e60619426e51a1d18d1c3fa/libraries/I2S/src/I2S.cpp:148:3: warning: missing initializer for member 'esp_i2s::i2s_driver_config_t::tx_desc_auto_clear' [-Wmissing-field-initializers]
   };
   ^
C:/Users/jop/.platformio/packages/framework-arduinoespressif32-src-52b8cdec3e60619426e51a1d18d1c3fa/libraries/I2S/src/I2S.cpp:148:3: warning: missing initializer for member 'esp_i2s::i2s_driver_config_t::fixed_mclk' [-Wmissing-field-initializers]
C:/Users/jop/.platformio/packages/framework-arduinoespressif32-src-52b8cdec3e60619426e51a1d18d1c3fa/libraries/I2S/src/I2S.cpp:148:3: warning: missing initializer for member 'esp_i2s::i2s_driver_config_t::mclk_multiple' [-Wmissing-field-initializers]
C:/Users/jop/.platformio/packages/framework-arduinoespressif32-src-52b8cdec3e60619426e51a1d18d1c3fa/libraries/I2S/src/I2S.cpp:148:3: warning: missing initializer for member 'esp_i2s::i2s_driver_config_t::bits_per_chan' [-Wmissing-field-initializers]
C:/Users/jop/.platformio/packages/framework-arduinoespressif32-src-52b8cdec3e60619426e51a1d18d1c3fa/libraries/I2S/src/I2S.cpp:148:3: warning: missing initializer for member 'esp_i2s::i2s_driver_config_t::chan_mask' [-Wmissing-field-initializers]
C:/Users/jop/.platformio/packages/framework-arduinoespressif32-src-52b8cdec3e60619426e51a1d18d1c3fa/libraries/I2S/src/I2S.cpp:148:3: warning: missing initializer for member 'esp_i2s::i2s_driver_config_t::total_chan' [-Wmissing-field-initializers]
C:/Users/jop/.platformio/packages/framework-arduinoespressif32-src-52b8cdec3e60619426e51a1d18d1c3fa/libraries/I2S/src/I2S.cpp:148:3: warning: missing initializer for member 'esp_i2s::i2s_driver_config_t::left_align' [-Wmissing-field-initializers]
C:/Users/jop/.platformio/packages/framework-arduinoespressif32-src-52b8cdec3e60619426e51a1d18d1c3fa/libraries/I2S/src/I2S.cpp:148:3: warning: missing initializer for member 'esp_i2s::i2s_driver_config_t::big_edin' [-Wmissing-field-initializers]
C:/Users/jop/.platformio/packages/framework-arduinoespressif32-src-52b8cdec3e60619426e51a1d18d1c3fa/libraries/I2S/src/I2S.cpp:148:3: warning: missing initializer for member 'esp_i2s::i2s_driver_config_t::bit_order_msb' [-Wmissing-field-initializers]
C:/Users/jop/.platformio/packages/framework-arduinoespressif32-src-52b8cdec3e60619426e51a1d18d1c3fa/libraries/I2S/src/I2S.cpp:148:3: warning: missing initializer for member 'esp_i2s::i2s_driver_config_t::skip_msk' [-Wmissing-field-initializers]
C:/Users/jop/.platformio/packages/framework-arduinoespressif32-src-52b8cdec3e60619426e51a1d18d1c3fa/libraries/I2S/src/I2S.cpp: In member function 'int I2SClass::_applyPinSetting()':
C:/Users/jop/.platformio/packages/framework-arduinoespressif32-src-52b8cdec3e60619426e51a1d18d1c3fa/libraries/I2S/src/I2S.cpp:324:5: warning: missing initializer for member 'esp_i2s::i2s_pin_config_t::mck_io_num' [-Wmissing-field-initializers]

schreibfaul1, 2023-05-17:
The warnings `[-Wmissing-field-initializers]` and `[-Wimplicit-fallthrough=]` are harmless. These come from the Arduino area, we can't do anything about them. Maybe your compiler considers warnings as errors. You can suppress the messages, set the compiler flags `-Wall` and `-Wextra` from `build flags` to `build unflags` in platformio.ini..
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

PS You don't need to compile both environments, esp32 or esp32-s3 is enough. To do this, set the field 'Default (ESP32-MiniWebRadio)' to your environment in the taskbar below.
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

Arne65, 2023-05-17:
Thanks for the feedback. I'll test it again with an ESP32-S3, maybe the sound will work. And then I give feedback

ivp1967, 2023-05-17:
Good afternoon. I also have no sound when I install version 2.7 ESP32 and VS1053.

schreibfaul1, 2023-05-17:
If there is no PSRAM, this must now be announced. This is no longer recognized automatically, no idea why? With the precompiled Arduino, this always worked reliably. If so, please delete `-DBOARD_HAS_PSRAM` in platformio.ini.

Arne65, 2023-05-17:
Hello Wolle

now works with ESP 32 thanks for the quick help
ESP32-S3-DevKitC-1-N8R2 is also running
THANKS

schreibfaul1, 2023-05-17:
Thank you for your feedback. I had the expectation that the switch from the precompiled Arduino would be easier. Unfortunately, I couldn't adopt the sdkconfig 1:1, and the current state won't be the best. If you still have ideas, you can click the ant in VSCode and then call Platform/Run Menuconfig to change settings yourself.

best regards from Berlin
Wolle

Closed 2023-06-26.

Thread 165 (2023-05-17):

Wiring Question

BruceKenley, 2023-05-17:
hello, I need some advice on the VS1053 wiring. Being connected to HSPI l thought, the wiring should be 13,mosi,12,miso,14,clk.15cs. The circuit shows 13,mosi,12,clk34,miso,33cs.
Is pin 34 really MISO and pin 12 really clk. I hope you can help.

valera39, 2023-05-17:
Hello [BruceKenley](https://github.com/BruceKenley)
I have a radio on an ESP32 wrower and VS1053.
MOSI 13 pin, MISO 34 pin and SCK 12 pin works fine, firmware 2.4c

schreibfaul1, 2023-05-17:
If you are using an ESP32 then GPIO 2, 14 and 15 are the pins for SD_MMC and cannot be changed. This fixed assignment does not exist with the ESP32-S3. The GPIOs for SPI can be freely selected with the exception of pins >=34, these are read only and cannot be used for MOSI or CLK. The pin assignment in 'common.h' is just an example, you can change it if necessary.

BruceKenley, 2023-05-22:
Thanks for your replies. I am using a ESP32-vroom-32u. I am still having a problem with VS1053. I am going to try 1k from ground to pin12. I also found if l connected 2nd GND pin of sd card it recognised all types of sd cards. Hope to get working tomorrow.

steve6375, 2023-06-02:
If you are using an SD card holder with no extra circuitry, then it should be connected to **VCC=3.3V** as all SD cards are 3.3V max. and NOT 5V.
If you have an SD arduino shield with a 5V->3.3V regulator then you should not use it because it may also contain 74LVS245 level shifters which means that 5V TTL logic levels will be output to the 3.3V esp32 which is not good!
It is best to use an SD card holder which has no extra circuitry and use 3.3V as VCC to the SD card. Also, I had problems using a Mini-to-Micro card adapter - it was not detected. I had to use a full size SD card (1GB and 4GB both worked as FAT32).
My screen KMRTM32032-SPI comes with a built in mini TF card holder and the connections come straight out to a set of 4 through holes which you can connect the SD signals to (these are not level shifted). So this is ideal - I have not tried this yet on the esp32  however...

Closed 2024-02-25.

Thread 167 (2023-05-17):

No sound

valera39, 2023-05-17:
Hello Wolle!
No sound, ESP32S3, VS1053, firmware 2.7.3a. Stations switch but there is no sound and logos are not loaded. Files from the SD card are playable. The touchscreen is very slow if
SDMMC_FREQUENCY 2000000.
Log: ESP-ROM:esp32s3-20210327
Build:Mar 27 2021
rst:0x1 (POWERON),boot:0x18 (SPI_FAST_FLASH_BOOT)
SPIWP:0xee
mode:DIO, clock div:1
load:0x3fce3808,len:0x44c
load:0x403c9700,len:0xbe4
load:0x403cc700,len:0x2a38
entry 0x403c98d4
E (503) psram: PSRAM ID read error: 0x00ffffff
[   503][W][esp32-hal-psram.c:71] psramInit(): PSRAM init failed!
E (504) esp_core_dump_flash: No core dump partition found!
E (508) esp_core_dump_flash: No core dump partition found!
ESP32 Chip: ESP32-S3
Arduino Version: 2.0.8
ESP-IDF Version: 4.4.4
ARDUINO_LOOP_STACK_SIZE 8192 words (32 bit)

00:00:00
00:00:00        ***************************
00:00:00        *     MiniWebRadio V2     *
00:00:00        ***************************
00:00:00
00:00:00 setup: ....  Arduino is pinned to core 1
00:00:00 tft_info: .  init ILI9488
00:00:00 setup: ....  Init SD card
00:00:00 setup: ....  SD card found
E (315) ledc: ledc_get_duty(739): LEDC is not initialized
00:00:01 setup: ....  seek for stations.csv
00:00:01 setup: ....  stations.csv found
00:00:01 setup: ....  seek for WiFi networks
[  1713][I][WiFiMulti.cpp:84] addAP(): [WIFI][APlistAdd] add SSID: ASUS_AC66U
[  1723][I][WiFiMulti.cpp:84] addAP(): [WIFI][APlistAdd] add SSID: Honor
[  1725][I][WiFiMulti.cpp:84] addAP(): [WIFI][APlistAdd] add SSID: network_01
[  1730][I][WiFiMulti.cpp:84] addAP(): [WIFI][APlistAdd] add SSID: network_02
[  1737][I][WiFiMulti.cpp:84] addAP(): [WIFI][APlistAdd] add SSID: network_03
[  1745][I][WiFiMulti.cpp:84] addAP(): [WIFI][APlistAdd] add SSID: network_04
[  1753][I][WiFiMulti.cpp:84] addAP(): [WIFI][APlistAdd] add SSID: network_04
[  8431][I][WiFiMulti.cpp:114] run(): [WIFI] scan done
[  8431][I][WiFiMulti.cpp:119] run(): [WIFI] 7 networks found
[  8432][I][WiFiMulti.cpp:160] run(): [WIFI] Connecting BSSID: 2C:FD:A1:C2:44:F0 SSID: ASUS_AC66U Channel: 12 (-60)
[  8582][I][WiFiMulti.cpp:174] run(): [WIFI] Connecting done.
00:00:08 WiFI_info:   Connecting WiFi...
00:00:08 setup: ....  connected to ASUS_AC66U, IP address is 192.168.1.55
00:00:08 ftpServer:   Buffers allocated: 4622 bytes
00:00:08 rtime_info:  Initializing SNTP
00:00:08 rtime_info:  Waiting for system time to be set... (1/10)
00:00:10 rtime_info:  Waiting for system time to be set... (2/10)
18:52:14 rtime_info:  18:52:14
18:52:14 audiotask:   is pinned to core 1
18:52:14 audiotask:   priority is 2
18:52:14 setup: ....  Number of saved stations: 92
18:52:14 setup: ....  current station number: 9
18:52:14 setup: ....  current volume: 5
18:52:14 setup: ....  last connected host: https://icecast-vgtrk.cdnvideo.ru/vestifm_mp3_192kbps
18:52:14 VS1053 chipID = -1350368918, version = 3
18:52:14 action: ...  current volume is 5
[ 13500][E][Preferences.cpp:483] getString(): nvs_get_str len fail: station_009 NOT_FOUND
18:52:15 action: ...  switch to station 9
18:52:15 AUDIO_info:  Connect to new host: "http://"
18:52:15 AUDIO_info:  Song stopped correctly after 0 msec
18:52:15 AUDIO_info:  PSRAM not found, inputBufferSize: 11903 bytes
[ 14026][E][WiFiGeneric.cpp:1578] hostByName(): DNS Failed for
18:52:15 AUDIO_info:  Request http:// failed!
18:52:15 StreamTitle:
18:52:16 WiFI_info:   RSSI is -66 dB
18:52:16 DLNA_info:   SSDP search for media servers started
18:52:20 DLNA_info:   SSDP query discovered 1 media servers
18:52:20 DLNA_info:   connected successfully to 192.168.1.1:8200
18:52:20 WiFI_info:   RSSI is -62 dB
18:52:20 ftpServer:   Ftp server waiting for connection on port 21
18:52:27 WiFI_info:   RSSI is -66 dB
[ 27764][E][Preferences.cpp:483] getString(): nvs_get_str len fail: station_010 NOT_FOUND
18:52:29 action: ...  switch to station 10
18:52:29 AUDIO_info:  Connect to new host: "http://"
18:52:29 AUDIO_info:  Song stopped correctly after 0 msec
[ 27804][E][WiFiGeneric.cpp:1578] hostByName(): DNS Failed for
18:52:29 AUDIO_info:  Request http:// failed!
18:52:29 StreamTitle:
[ 29561][E][Preferences.cpp:483] getString(): nvs_get_str len fail: station_011 NOT_FOUND
18:52:30 action: ...  switch to station 11
18:52:30 AUDIO_info:  Connect to new host: "http://"
18:52:31 AUDIO_info:  Song stopped correctly after 0 msec
[ 29600][E][WiFiGeneric.cpp:1578] hostByName(): DNS Failed for
18:52:31 AUDIO_info:  Request http:// failed!
18:52:31 StreamTitle:
[ 31296][E][Preferences.cpp:483] getString(): nvs_get_str len fail: station_010 NOT_FOUND
18:52:32 action: ...  switch to station 10
18:52:32 AUDIO_info:  Connect to new host: "http://"
18:52:32 AUDIO_info:  Song stopped correctly after 0 msec
[ 31335][E][WiFiGeneric.cpp:1578] hostByName(): DNS Failed for
18:52:32 AUDIO_info:  Request http:// failed!
18:52:32 StreamTitle:
18:52:38 Touchpoint not valid x=108, y=187
18:52:38 Touchpoint not valid x=119, y=183
18:52:41 AUDIO_info:  Song stopped correctly after 0 msec
18:53:06 AUDIO_info:  Song stopped correctly after 0 msec
18:53:06 AUDIO_info:  Reading file: "/audiofiles/sample.mp3"
18:53:06 AUDIO_info:  Content-Length: 1954212
18:53:06 AUDIO_info:  ID3 framesSize: 45
18:53:06 AUDIO_info:  ID3 version: 2.4
18:53:06 AUDIO_info:  ID3 normal frames
18:53:06 id3data: ..  SettingsForEncoding: Lavf57.83.100
18:53:06 AUDIO_info:  Audio-Length: 1954167
18:53:06 AUDIO_info:  stream ready
18:53:11 Touchpoint not valid x=286, y=49
[ 72389][E][Preferences.cpp:483] getString(): nvs_get_str len fail: station_010 NOT_FOUND
18:53:14 action: ...  switch to station 10
18:53:14 AUDIO_info:  Connect to new host: "http://"
18:53:14 AUDIO_info:  Song stopped correctly after 20 msec
[ 73064][E][WiFiGeneric.cpp:1578] hostByName(): DNS Failed for
18:53:14 AUDIO_info:  Request http:// failed!
18:53:14 StreamTitle:
[ 77405][E][Preferences.cpp:483] getString(): nvs_get_str len fail: station_011 NOT_FOUND
18:53:18 action: ...  switch to station 11
18:53:18 AUDIO_info:  Connect to new host: "http://"
18:53:18 AUDIO_info:  Song stopped correctly after 0 msec
[ 77445][E][WiFiGeneric.cpp:1578] hostByName(): DNS Failed for
18:53:18 AUDIO_info:  Request http:// failed!
18:53:18 StreamTitle:
[ 78947][E][Preferences.cpp:483] getString(): nvs_get_str len fail: station_010 NOT_FOUND
18:53:20 action: ...  switch to station 10
18:53:20 AUDIO_info:  Connect to new host: "http://"
18:53:20 AUDIO_info:  Song stopped correctly after 0 msec
[ 78987][E][WiFiGeneric.cpp:1578] hostByName(): DNS Failed for
18:53:20 AUDIO_info:  Request http:// failed!
18:53:20 StreamTitle:
Also tried flashing to a blank memory, but all the same
vs1053_ext.h or 17.05.2023, -DBOARD_HAS_PSRAM in platformio.ini delite
A short video about the problem https://files.fm/u/svrx3mh6f
I've settled on version 2.7.2 for now, I hope for a solution to the problems soon.
Best regards

schreibfaul1, 2023-05-17:
Sorry for the troubles you are having with your board, but ESP32-S3 without PSRAM is rare. Unfortunately, I only found out today that the WiFi client does not want to work with the announced PSRAM. Unfortunately, an entry in the boards/esp32-12k.json prevented the deletion of DBOARD_HAS_PSRAM' from taking effect.

valera39, 2023-05-17:
I am surprised myself, because on the board is clearly visible inscription WROOM-1 N16R8, but on the official Espressif website there is no such a designation, there is WROOM-2 N16R8. And the appearance of the board is different. Most likely it is some kind of copy or fake.
I will try to flash again with the latest changes.

valera39, 2023-05-17:
Genius, you beat it! It worked!
Thank you! I will continue testing

Closed 2023-05-19.

Thread 175 (2023-05-26):

Could you please add support 4 inch ST7796S display?

Hhaltt, 2023-05-26:
[Link to display](https://a.aliexpress.com/_Evt0o81)
Could you please add support for this display? Touch controller is XPT2046.

schreibfaul1, 2023-05-26:
It looks like ST7796S and ILI9486 use the same instruction set. It might work if you select ILI9486b as TFT_CONTROLLER.

Hhaltt, 2023-05-26:
Yes, it works but not correctly.  The best result is if ILI9341 is selected as the controller, but the part of the display is just white.  If I choose ILI9486 - the picture is strongly shifted to the side and about half of the display is also white.  My knowledge does not allow me to fix this

schreibfaul1, 2023-05-26:
If I come across such a display, I will add the ST7796 controller.
It looks like the displays will only ship from China, delivery time 3-4 weeks.
I can't help right now.
If ILI9341 works similarly, you can try changing its height and width, from 320x240 to 480x320. In tft.h line 41 and 42

Hhaltt, 2023-05-26:
OK, you were right.  The display is fully functional: TFT_CONTROLLER : 4 (ILI9488), TP_VERSION : 4 (ILI9488).  It's just that after turning on the power or resetting it does not always work correctly, sometimes it remains just white.  The touchscreen also works.  And if you want to use the SD card slot on the display, you need to solder a pull-up resistor to the sd-miso pin (3.3v), also on my version of the PCM5102A DAC you need to pull-up to 3.3v on the XMT pin

Hhaltt, 2023-05-26:
Thanks, this is a cool project.  And one more little wish - if the stream / track playback time were displayed - it would be very good

schreibfaul1, 2023-06-09:
I added the ST7796 TFT controller to the 'small buttons' branch. This branch will soon become the master. It looks like the display is running stable now.

Hhaltt, 2023-06-23:
I don't know what's wrong with my display. I think the main reason is that he is Chinese. I tried everything possible with ST7796 and it's just white. I went back to ILI9488, it works. Thank you for your work. By the way VU-meter looks great.

schreibfaul1, 2023-06-23:
I tested these two displays, both with ST7796. The darker one is the Raspberry PI version. Despite the same controller, the displays behave completely differently.
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

The initialization of the TFT controllers are mostly very similar to ILI9488 (or ILI9486) and differ only in details. And the gamma (color value) correction can be different. But the main thing is that it works!

Closed 2023-06-23.

Thread 179 (2023-06-06):

Exception caused by settings.json file

steve6375, 2023-06-06:
Somehow the settings.json file on the SD card got set to all 0's for each parameter (except number of stations)
The result was that my project suddenly started crashing and resetting during startup.
Here is the terminal output:

```
[  6676][I][WiFiMulti.cpp:119] run(): [WIFI] 1 networks found
[  6677][I][WiFiMulti.cpp:160] run(): [WIFI] Connecting BSSID: XX:XX:XX:XX:XX:XX SSID: XXXXXXXXXX Channel: 4 (-26)
[  7928][I][WiFiMulti.cpp:174] run(): [WIFI] Connecting done.
00:00:07 WiFI_info:   Connecting WiFi...
00:00:07 setup: ....  connected to xxxxxx, IP address is 192.168.1.113
00:00:07 ftpServer:   Buffers allocated: 4622 bytes
00:00:07 rtime_info:  Initializing SNTP
00:00:07 rtime_info:  Waiting for system time to be set... (1/10)
09:27:58 rtime_info:  09:27:58
09:27:58 audiotask:   is pinned to core 1
09:27:58 audiotask:   priority is 2
09:27:58 setup: ....  Number of saved stations: 17
09:27:58 setup: ....  current station number: 0
09:27:58 setup: ....  current volume: 0
09:27:58 Guru Meditation Error: Core  1 panic'ed (LoadProhibited). Exception was unhandled.

Core  1 register dump:
PC      : 0x4008c82d  PS      : 0x00060630  A0      : 0x80184198  A1      : 0x3ffc6900
A2      : 0x00000000  A3      : 0xfffffffc  A4      : 0x000000ff  A5      : 0x0000ff00
A6      : 0x00ff0000  A7      : 0xff000000  A8      : 0x00000000  A9      : 0x3ffc6c40
A10     : 0x00000003  A11     : 0x00060623  A12     : 0x00060620  A13     : 0x00000000
A14     : 0x007c16c0  A15     : 0x003fffff  SAR     : 0x00000004  EXCCAUSE: 0x0000001c
EXCVADDR: 0x00000000  LBEG    : 0x4008c82d  LEND    : 0x4008c83d  LCOUNT  : 0xffffffff

Backtrace: 0x4008c82a:0x3ffc6900 0x40184195:0x3ffc6910 0x4018ba55:0x3ffc6c20 0x4018ba9b:0x3ffc6cb0 0x400f5c52:0x3ffc6cf0 0x400da005:0x3ffc6d90 0x400f5b96:0x3ffc6e20

  #0  0x4008c82a:0x3ffc6900 in strlen at /builds/idf/crosstool-NG/.build/HOST-x86_64-w64-mingw32/xtensa-esp32-elf/src/newlib/newlib/libc/machine/xtensa/strlen.S:82
  #1  0x40184195:0x3ffc6910 in _svfprintf_r at /builds/idf/crosstool-NG/.build/HOST-x86_64-w64-mingw32/xtensa-esp32-elf/src/newlib/newlib/libc/stdio/vfprintf.c:1528
  #2  0x4018ba55:0x3ffc6c20 in _vsnprintf_r at /builds/idf/crosstool-NG/.build/HOST-x86_64-w64-mingw32/xtensa-esp32-elf/src/newlib/newlib/libc/stdio/vsnprintf.c:70 (discriminator 4)
  #3  0x4018ba9b:0x3ffc6cb0 in vsnprintf at /builds/idf/crosstool-NG/.build/HOST-x86_64-w64-mingw32/xtensa-esp32-elf/src/newlib/newlib/libc/stdio/vsnprintf.c:40
  #4  0x400f5c52:0x3ffc6cf0 in Print::printf(char const*, ...) at C:/Users/Steve/.platformio/packages/framework-arduinoespressif32-src-52b8cdec3e60619426e51a1d18d1c3fa/cores/esp32/Print.cpp:55
  #5  0x400da005:0x3ffc6d90 in setup() at src/main.cpp:1263
  #6  0x400f5b96:0x3ffc6e20 in loopTask(void*) at C:/Users/Steve/.platformio/packages/framework-arduinoespressif32-src-52b8cdec3e60619426e51a1d18d1c3fa/cores/esp32/main.cpp:42

ELF file SHA256: 2b4b6a1663ed86e6

E (10066) esp_core_dump_flash: Core dump flash config is corrupted! CRC=0x7bd5c66f instead of 0x0
Rebooting...
ets Jul 29 2019 12:21:46

rst:0xc (SW_CPU_RESET),boot:0x13 (SPI_FAST_FLASH_BOOT)
configsip: 0, SPIWP:0xee
clk_drv:0x00,q_drv:0x00,d_drv:0x00,cs0_drv:0x00,hd_drv:0x00,wp_drv:0x00
mode:DIO, clock div:2
load:0x3fff0030,len:1344
load:0x40078000,len:13924
ho 0 tail 12 room 4
load:0x40080400,len:3600
entry 0x400805f0
E (984) psram: PSRAM ID read error: 0xffffffff
E (984) spiram: SPI RAM enabled but initialization failed. Bailing out.
E (998) esp_core_dump_flash: No core dump partition found!
E (998) esp_core_dump_flash: No core dump partition found!
ESP32 Chip: ESP32-D0WD-V3
Arduino Version: 2.0.8
ESP-IDF Version: 4.4.4
ARDUINO_LOOP_STACK_SIZE 8192 words (32 bit)

```

The clue was in the lines
**09:27:58 setup: ....  current station number: 0
09:27:58 setup: ....  current volume: 0**
which led me to look at the settings.json file and I saw it was all 0's

I am not sure which of the parameters caused the exception but it looks like the lastconnectedhost line 1263 caused the issue???

main.cpp
    SerialPrintfln("setup: ....  Number of saved stations: " ANSI_ESC_CYAN "%d", _sum_stations);
    SerialPrintfln("setup: ....  current station number: " ANSI_ESC_CYAN "%d", _cur_station);
    SerialPrintfln("setup: ....  current volume: " ANSI_ESC_CYAN "%d", _cur_volume);
   SerialPrintfln("setup: ....  last connected host: " ANSI_ESC_CYAN "%s", _lastconnectedhost.c_str());

    // _alarmdays = pref.getUShort("alarm_weekday");
    // _alarmtime = pref.getUInt("alarm_time");
    // _f_timeAnnouncement = pref.getBool("timeAnnouncing");
    _state = RADIO;

My C coding is not good enough to fix the problem however!

schreibfaul1, 2023-06-06:
Thanks for the error description, I can't say why settings.json doesn't contain any non-zero values   yet, but `printf('%s', NULL);` causes a crash. I won't be able to take a closer look until next week.

steve6375, 2023-06-24:
[settings_BAD.zip](https://github.com/schreibfaul1/ESP32-MiniWebRadio/files/11856380/settings_BAD.zip)
Here is file which causes crash (havent tried latest version yet though).

steve6375, 2023-06-24:
```
    SerialPrintfln("setup: ....  Number of saved stations: " ANSI_ESC_CYAN "%d", _sum_stations);
    SerialPrintfln("setup: ....  current station number: " ANSI_ESC_CYAN "%d", _cur_station);
    SerialPrintfln("setup: ....  current volume: " ANSI_ESC_CYAN "%d", _cur_volume);
    if (_lastconnectedhost == "") _lastconnectedhost = "NONE";   // ZZZZZ added to prevent crash
```

schreibfaul1, 2023-06-24:
Exactly, well analyzed, _lastconnectedhost must never be NULL, but an empty string is allowed.
I couldn't find out why _lastconnectedhost became NULL, but I installed guards to avoid a crash.

Closed 2023-07-04.

Thread 184 (2023-06-09):

And again about PSRAM

valera39, 2023-06-09:
Dear Wolle, correct me if I am wrong.
The ESP32S3 from Al Thinker uses PSRAM Quad SPI memory and the ESP32S3 from Espressif (which I have) uses PSRAM Octal SPI memory.
Is it enough to change CONFIG_SPIRAM_MODE_QUAD=y to CONFIG_SPIRAM_MODE_OCT=y in sdkconfig.esp32s3 file, in the "SPI RAM config" section,
and also change CONFIG_SPIRAM_CLK_IO=30 and CONFIG_SPIRAM_CS_IO=26 to the appropriate gpio according to https://docs.espressif.com/projects/esp-idf/en/latest/esp32s3/hw-reference/esp32s3/user-guide-devkitc-1.html documentation.
Quote from the documentation:
"For boards with Octal SPI flash/PSRAM memory embedded ESP32-S3-WROOM-1/1U modules, and boards with ESP32-S3-WROOM-2 modules, the pins GPIO35, GPIO36 and GPIO37 are used for the internal communication between ESP32-S3 and SPI flash/PSRAM memory, thus not available for external use."
Looking forward to hearing from you!

schreibfaul1, 2023-06-10:
Congratulations if you own an OCTAL PSRAM and it works now. If I set OCT in menuconfig, the ESP32 crashes, probably because no OCTAL-PSRAM is found.
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
Build flags have no effect, the only way is to edit menuconfig or sdkconfig directly.

valera39, 2023-06-10:
Thanks for the quick response!
I got to point 4 in your image, but I could not understand how to navigate in this menu to get to the memory type configuration
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

Maybe I didn't translate your message correctly, but I understood the following: you can't change the sdkconfig.esp32s3 file in a text editor, and you have to edit it in menuconfig?
And maybe in the coming radio updates add configuration for ESP32S3 with PSRAM Octal SPI memory?
Thanks!

schreibfaul1, 2023-06-10:
The idea is to only use the menuconfig. Make sure that esp32s3 is selected as the environment.
In nenuconfig these are the points:

Component config --->
ESP32S3-Specific --->
[*]Support for external, SPI-connected RAM
        SPI RAM config --->
Mode (QUAD/OCT) of SPI RAM chip in use (Quad Mode RSRAM) --->

If you then go back with ESC and save with 'Y', a new sdkconfig.esp32s3 will be created and the previous one marked as '.old'

Dudinu, 2023-06-10:
Hi, valera39
Concerning "I could not understand how to navigate in this menu "  I find here
https://github.com/platformio/platform-espressif32/issues/423
an explanation :   https://community.platformio.org/t/menuconfig-navigation-does-not-work-under-windows-10/20881
and a solution :

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

valera39, 2023-06-10:
Dear Wolle  and [Dudinu](https://github.com/Dudinu)!
Thank you very much, thanks to your tips I was able to change the type of memory and enable PSRAM But another problem arose, no connection to the network.
Here is the log:
--- Terminal on COM5 | 115200 8-N-1
--- Available filters and text transformations: colorize, debug, default, direct, esp32_exception_decoder, hexlify, log2file, nocontrol, printable, send_on_enter, time
--- More details at https://bit.ly/pio-monitor-filters
--- Quit: Ctrl+C | Menu: Ctrl+T | Help: Ctrl+T followed by Ctrl+H
[   874][I][esp32-hal-psram.c:96] psramInit(): PSRAM enabled
E (875) esp_core_dump_flash: No core dump partition found!
E (875) esp_core_dump_flash: No coESP32 Chip: ESP32-S3
Arduino Version: 2.0.8
ESP-IDF Version: 4.4.4
ARDUINO_LOOP_STACK_SIZE 8192 words (32 bit)

00:00:00
00:00:00        ***************************
00:00:00        *     MiniWebRadio V2     *
00:00:00        ***************************
00:00:00
00:00:00 setup: ....  Arduino is pinned to core 1
[   920][E][Preferences.cpp:50] begin(): nvs_open failed: NOT_INITIALIZED
00:00:00 tft_info: .  init ILI9488
00:00:00 setup: ....  Init SD card
00:00:00 setup: ....  SD card found
E (254) ledc: ledc_get_duty(739): LEDC is not initialized
00:00:01 setup: ....  seek for stations.csv
00:00:01 setup: ....  stations.csv found
00:00:01 setup: ....  seek for WiFi networks
[  2000][I][WiFiMulti.cpp:84] addAP(): [WIFI][APlistAdd] add SSID: ASUS_AC66U
[  2012][I][WiFiMulti.cpp:84] addAP(): [WIFI][APlistAdd] add SSID: network_01
[  2013][I][WiFiMulti.cpp:84] addAP(): [WIFI][APlistAdd] add SSID: network_02
[  2021][I][WiFiMulti.cpp:84] addAP(): [WIFI][APlistAdd] add SSID: network_03
[  2029][I][WiFiMulti.cpp:84] addAP(): [WIFI][APlistAdd] add SSID: network_04
[  2037][I][WiFiMulti.cpp:84] addAP(): [WIFI][APlistAdd] add SSID: network_04
[  2051][E][WiFiGeneric.cpp:680] wifiLowLevelInit(): esp_wifi_init 4353
[  2052][E][WiFiGeneric.cpp:680] wifiLowLevelInit(): esp_wifi_init 4353
00:00:01 WiFi credentials are not correct
00:00:02 WiFi credentials are not correct

Is it possible that the changed sdkconfig.esp32s3 is the cause?

schreibfaul1, 2023-06-10:
I don't know where this comes from, but this is really bad:
`[ 920][E][Preferences.cpp:50] begin(): nvs_open failed: NOT_INITIALIZED`

nvs is used to store the SSID and WiFi password. In addition, nvs is required for the channel list.

Try to load the original sdkconfig.esp32s3 and then only set OCTAL-PSRAM in menuconfig.

valera39, 2023-06-10:
It worked!
20:37:09 AUDIO_info:  PSRAM found, inputBufferSize: 295903 bytes
If the Support for external, SPI-connected RAM and OCTAL Mode PSRAM parameters are enabled, PSRAM is detected.
Thank you so much for your friendly communication and tips!
Always looking forward to new additions and improvements to the best internet radio.
P.S. Maybe in the future add this to the manual for those who use ESP32S3 from Espressif with OCTAL PSRAM

schreibfaul1, 2023-06-10:
Very good! The settings in the menuconfig are then the 'workaround' for your 8MB PSRAM board. The selectable boards don't seem to work, maybe I can create a new *.json file myself, which is then selectable in platformio.ini.

Closed 2023-06-17.

Thread 186 (2023-06-13):

Brightness on ILI9341 increases greatly past 95%

steve6375, 2023-06-13:
The new code sets led max as 255 (I think ledc was 254 before due to floating point maths -  SetBrightness now adds 0.5)
Also on my TFT, the change between about 97% and 100% is very big.
Going from 95 to 100 is a big change in brightness.
The following code is my very clumsy attempt to have a fine adjustment between 95 and 100.
I am sure you could write better code but at least it seems to work!
ZZZ line are for my debug

```
/***********************************************************************************************************************
*                                        T F T   B R I G H T N E S S                                                   *
***********************************************************************************************************************/
void setTFTbrightness(uint8_t duty){ //duty 0...100 (min...max)
    if(TFT_BL == -1) return;
    uint32_t d;
    ledcAttachPin(TFT_BL, 1);        //Configure variable led, TFT_BL pin to channel 1
    ledcSetup(1, 12000, 8);          // 12 kHz PWM and 8 bit resolution
    d = duty * 2.55 + 0.5;
    ledcWrite(1, d);
    SerialPrintfln("ledcwrite=%i",d);   // ZZZZZZZZ
}
inline uint32_t getTFTbrightness(){
    return ledcRead(1);
}
inline uint8_t downBrightness(){
    if(_brightness > 5) {
       if (_brightness > 5 && _brightness < 96)
        {
         _brightness -= _brightness % 5;
         _brightness -= 5;
        }
        else
        {
        _brightness -= 1;
        if (_brightness >= 100) _brightness = 99;
        }
        setTFTbrightness(_brightness);
        showBrightnessBar();
    SerialPrintfln("Bright=%d",_brightness);    // ZZZZZZZZZZ
    } return _brightness;
}
inline uint8_t upBrightness(){
    if(_brightness < 100){
       if (_brightness >= 95) _brightness += 1;
        else if (_brightness < 95)
        {
         _brightness -= _brightness % 5;
         _brightness += 5;
        }
        setTFTbrightness(_brightness);
        showBrightnessBar();
    SerialPrintfln("Bright=%d",_brightness);   // ZZZZZZZZZZZZZ
    }
    return _brightness;
}
inline uint8_t getBrightness(){
    return _brightness;
}

```

Debug o/p
```
20:31:02 Bright=95
20:31:03 ledcwrite=245
20:31:03 Bright=96
20:31:04 ledcwrite=247
20:31:04 Bright=97
20:31:05 ledcwrite=250
20:31:05 Bright=98
20:31:06 ledcwrite=252
20:31:06 Bright=99
20:31:06 ledcwrite=255
20:31:06 Bright=100
20:31:10 ledcwrite=252
20:31:10 Bright=99
20:31:10 ledcwrite=250
20:31:10 Bright=98
20:31:11 ledcwrite=247
20:31:11 Bright=97
20:31:11 ledcwrite=245
20:31:11 Bright=96
20:31:12 ledcwrite=242
20:31:12 Bright=95
20:31:12 ledcwrite=229
20:31:12 Bright=90
20:31:13 ledcwrite=217
20:31:13 Bright=85
20:31:14 ledcwrite=229
20:31:14 Bright=90
20:31:15 ledcwrite=242
20:31:15 Bright=95
20:31:15 ledcwrite=245
20:31:15 Bright=96
20:31:15 ledcwrite=247
20:31:15 Bright=97
20:31:16 ledcwrite=250
20:31:16 Bright=98
20:31:16 ledcwrite=252
20:31:16 Bright=99
20:31:17 ledcwrite=255
20:31:17 Bright=100
20:31:19 ledcwrite=252
20:31:19 Bright=99
20:31:20 ledcwrite=250
20:31:20 Bright=98
20:31:20 ledcwrite=247
20:31:20 Bright=97

```

schreibfaul1, 2023-06-14:
Das werde ich demnächst anpassen. Dabei sit mir aufgefallen, dass 12KHz zu groß ist. Bei manchen Displays (nicht bei allen) gibt es Ungenauigkeiten mit dem TP Controller wenn die Helligkeit nicht 100% ist. Ich kenne die Ursache nicht, aber mit 1.2KHz gibt es die Probleme nicht.

schreibfaul1, 2023-06-15:
(uint)100 * 2.55 is not 255, I corrected that

steve6375, 2023-06-23:
I noticed that for Raspberry Pi a 56 Ohm resistor was wired in series with the LED pin. I am not sure why it was done.
https://youtu.be/3vuK5w8o8dg?t=19
I tried this with a 47 Ohm resistor as I did not have a 56R - it does seem to be better, what do you think?

schreibfaul1, 2023-06-23:
It certainly depends on the display. My displays (the red ones) use a transistor Q1 to switch the backlight. The circuit: http://www.lcdwiki.com/res/MSP4021/4.0inch_SPI_Schematic.pdf is always similar. If I increase the base resistance from 1000 ohms to 1056 it won't change much.

steve6375, 2023-06-23:
My TFT display also has 1k in series too so it shouldn't make much difference.

schreibfaul1, 2023-06-23:
The brightness will not be linear to the duty cycles of the PWM. Maybe a correction would make sense?

Closed 2023-07-05.

Thread 194 (2023-06-17):

v 2.8 doesn't work

valera39, 2023-06-17:
Hello Wolle!
Configuration ESP32S3 N16R8, VS1053. In platformio.ini I have recommended the line board = ESP32-S3-DevKitC-1-N16R8 ;chipmodel ESP32S3, USBtoTTL (S3-DevKitC-1)
But PSRAM is not initialized. Do I need to edit sdkconfig.esp32s3 again ?
When switching stations or starting playback, turning on or rebooting, there is a loud clicking sound in the speakers
P.S. After flashing with modified sdkconfig.esp32s3 I get this:
ESP-ROM:esp32s3-20210327
Build:Mar 27 2021
rst:0x1 (POWERON),boot:0x3b (SPI_FAST_FLASH_BOOT)
SPIWP:0xee
mode:DIO, clock div:1
load:0x3fce3808,len:0x44c
load:0x403c9700,len:0xbe4
load:0x403cc700,len:0x2a38
entry 0x403c98d4
[   877][I][esp32-hal-psram.c:96] psramInit(): PSRAM enabled
E (877) esp_core_dump_flash: No core dump partition found!
E (877) esp_core_dump_flash: No ��ESP32 Chip: ESP32-S3
Arduino Version: 2.0.8
ESP-IDF Version: 4.4.4
ARDUINO_LOOP_STACK_SIZE 8192 words (32 bit)

00:00:00
00:00:00        ***************************
00:00:00        *     MiniWebRadio V2     *
00:00:00        ***************************
00:00:00
00:00:00 setup: ....  Arduino is pinned to core 1
[   923][E][Preferences.cpp:50] begin(): nvs_open failed: NOT_INITIALIZED
[   923][E][Preferences.cpp:50] begin(): nvs_open failed: NOT_INITIALIZED
00:00:00 tft_info: .  init ILI9488
00:00:00 setup: ....  Init SD card
00:00:00 setup: ....  SD card found
E (259) ledc: ledc_get_duty(739): LEDC is not initialized
00:00:01 setup: ....  seek for stations.csv
00:00:01 setup: ....  stations.csv found
00:00:01 setup: ....  seek for WiFi networks
[  2008][I][WiFiMulti.cpp:84] addAP(): [WIFI][APlistAdd] add SSID: ASUS_AC66U
[  2019][I][WiFiMulti.cpp:84] addAP(): [WIFI][APlistAdd] add SSID: network_01
[  2021][I][WiFiMulti.cpp:84] addAP(): [WIFI][APlistAdd] add SSID: network_02
[  2029][I][WiFiMulti.cpp:84] addAP(): [WIFI][APlistAdd] add SSID: network_03
[  2037][I][WiFiMulti.cpp:84] addAP(): [WIFI][APlistAdd] add SSID: network_04
[  2044][I][WiFiMulti.cpp:84] addAP(): [WIFI][APlistAdd] add SSID: network_04
[  2058][E][WiFiGeneric.cpp:680] wifiLowLevelInit(): esp_wifi_init 4353
[  2059][E][WiFiGeneric.cpp:680] wifiLowLevelInit(): esp_wifi_init 4353
00:00:01 WiFI_info:   WiFi credentials are not correct
[  2663][E][WiFiGeneric.cpp:680] wifiLowLevelInit(): esp_wifi_init 4353
[  2664][E][WiFiGeneric.cpp:680] wifiLowLevelInit(): esp_wifi_init 4353
[  2667][E][WiFiAP.cpp:154] softAP(): enable AP first!
00:00:02 Accesspoint: IP: 0.0.0.0
[  2768][E][WiFiGeneric.cpp:680] wifiLowLevelInit(): esp_wifi_init 4353
00:00:02 setup: ....  -2 WiFi networks found
00:00:02 ftpServer:   Ftp server waiting for connection on port 21

schreibfaul1, 2023-06-18:
hello valera39,
i added the additional boards in the platform.ini without knowing if they work at all. On June 22nd I will probably get an N16R8 board and can then test the settings and adjust them if necessary.

schreibfaul1, 2023-06-18:
I will also have to adjust the miniwebradio.csv, with the one I'm using now the nvs area is in the wrong place.

valera39, 2023-06-18:
Okay, I'll look forward to receiving your boards.

Closed 2023-07-04.

Thread 200 (2023-06-22):

Questions about version 2.8

valera39, 2023-06-22:
Hello Wolle!
If I may, I have decided to post in a separate thread the questions that are relevant to me.
My configuration: ESP32S3 N16R8, VS1053, ILI9488.
1. When you switch the stations in the speakers for 1/2 second, first you hear a small squeak and then a click.
On an oscilloscope connected to the VS1053 output you can see a DC voltage spike at the moment of switching. It started around firmware 2.7.3f. Before that the switching was completely silent. I tried the changes suggested by steve6375, but they didn't help.
2. The touch does not work after loading the radio, it can be turned on by briefly disconnecting the TP_IRQ of the display from gpio 39, or by briefly shorting it to ground. Changing the gpio did not help.
Again, on firmware 2.7 these problems were not at all.
3. is it possible to adjust the speed of the VU meter segments and can it be placed horizontally? How can I make all the segments work, not just the yellow ones?
4. With PlatformIO Serial Monitor enabled the log became less informative, like this:
ESP-ROM:esp32s3-20210327
Build:Mar 27 2021
rst:0x1 (POWERON),boot:0x39 (SPI_FAST_FLASH_BOOT)
SPIWP:0xee
mode:DIO, clock div:1
load:0x3fce3808,len:0x44c
load:0x403c9700,len:0xbe4
load:0x403cc700,len:0x2a38
entry 0x403c98d4
[   934][I][esp32-hal-psram.c:96] psramInit(): PSRAM enabled
E (934) esp_core_dump_flash: No core dump partition found!
E (934) esp_core_dump_flash: No core dump partition found!
E (248) ledc: ledc_get_duty(739): LEDC is not initialized
[  2063][I][WiFiMulti.cpp:84] addAP(): [WIFI][APlistAdd] add SSID: ASUS_AC66U
[  2070][I][WiFiMulti.cpp:84] addAP(): [WIFI][APlistAdd] add SSID: ASUS_AC66U
[  2071][I][WiFiMulti.cpp:84] addAP(): [WIFI][APlistAdd] add SSID: network_01
[  2075][I][WiFiMulti.cpp:84] addAP(): [WIFI][APlistAdd] add SSID: network_02
[  2083][I][WiFiMulti.cpp:84] addAP(): [WIFI][APlistAdd] add SSID: network_03
[  2091][I][WiFiMulti.cpp:84] addAP(): [WIFI][APlistAdd] add SSID: network_04
[  2099][I][WiFiMulti.cpp:84] addAP(): [WIFI][APlistAdd] add SSID: network_04
[  8562][I][WiFiMulti.cpp:114] run(): [WIFI] scan done
[  8563][I][WiFiMulti.cpp:119] run(): [WIFI] 6 networks found
[  8564][I][WiFiMulti.cpp:160] run(): [WIFI] Connecting BSSID: 2C:FD:A1:C2:44:F0 SSID: ASUS_AC66U Channel: 1 (-59)
[  8638][I][WiFiMulti.cpp:174] run(): [WIFI] Connecting done
is there any bugs in it and how to enable a more detailed output like before?
5. In common.h the line #define TFT_FREQUENCY is repeated. Is this correct?
6.  I already wrote about the great convenience of having a drop-down list of stations on the display. If you think this is a necessary option, do you have a solution to this problem?
Unfortunately, I'm not a programmer, but I'm always willing to help you make your radio even better.
Thank you!

Arne65, 2023-06-23:
Hello vallera

To your 3rd point with the ESP 32 with VS 1053, I also only have the yellow bars. On the ESP 32-S3 1N8 with an external DAC, I set AUDIOTASK_CORE to 0 because the VU display works perfectly and all other displays are considerably faster. With the ESP 32, however, this did not work for me

valera39, 2023-06-24:
What about me with my questions, is there a solution?

schreibfaul1, 2023-06-24:
1) this is probably a bug in VS1053? presumably these are disturbances before the codec and the sample rate are known. I suppressed the first 200ms, it's now okay with my board.
2) I know, it's my turn
3) the values   are read from the VS1053 from a register and displayed. With the I2S Dac I calculate this myself.
4) these are entries from the stations.csv. This is just to show what SSID it might be able to connect to. If you only have one WiFi network, you can delete the entries 'network01'... or hide them with #
5) is done
6) that's something for the future

clear-sky, 2023-06-25:
Hi dear wolle! after upgrading to 2.8 some stations stopped working
please test this streams:
http://us3.internet-radio.com:8342/stream
http://199.189.111.28:8012/
http://radio.stereoanime.net:8000/128

Closed 2023-06-26.

Thread 202 (2023-06-24):

Insufficient Memory and SD card write errors when set DECODER to 1 (for PCM5102A DAC)

steve6375, 2023-06-24:
I have both a VS1053B and PCM5102A DAC connected to an esp32. The only problem the VS1053 has is that m4a files don't seem to play and sometimes flac files dont fully play. SD card works OK and esp32 doesn't crash.

I used 'Release' build (not debug) and -DCORE_DEBUG_LEVEL=5

So I tried the DAC and just changed DECODER to 1 and recompiled. With DAC it does play m4a (not FLAC files as no PSRAM) and some radio stations but on other stations it will give memory errors and also reads and writes to SD card often fail and leaves blank stations.csv or settings.csv.
Also crashes on occasion even from fresh boot. I tried several clean rebuilds but still a problem.
I am using the small buttons previous build still (not latest main) release.

Is it using too much memory and is there anything I can do to make DAC work reliably?

**This is DECODER = 0 which is basically stable and OK:**
```
 *  Executing task: C:\Users\Steve\.platformio\penv\Scripts\platformio.exe run --target upload --target monitor --environment esp32

Processing esp32 (board: esp32dev; platform: https://github.com/platformio/platform-espressif32.git#v6.2.0; framework: arduino, espidf)
----------------------------------------------------------------------------------------------------------------------------------------------------------------------------------------------------Verbose mode can be enabled via `-v, --verbose` option
CONFIGURATION: https://docs.platformio.org/page/boards/espressif32/esp32dev.html
PLATFORM: Espressif 32 (6.2.0+sha.1d6e199) > Espressif ESP32 Dev Module
HARDWARE: ESP32 240MHz, 320KB RAM, 3MB Flash
DEBUG: Current (cmsis-dap) External (cmsis-dap, esp-bridge, esp-prog, iot-bus-jtag, jlink, minimodule, olimex-arm-usb-ocd, olimex-arm-usb-ocd-h, olimex-arm-usb-tiny-h, olimex-jtag-tiny, tumpa)
PACKAGES:
 - framework-arduinoespressif32 @ 2.0.8+sha.d3254f7
 - framework-espidf @ 3.40404.0 (4.4.4)
 - tool-cmake @ 3.16.4
 - tool-esptoolpy @ 1.40501.0 (4.5.1)
 - tool-idf @ 1.0.1
 - tool-mconf @ 1.4060000.20190628 (406.0.0)
 - tool-mkfatfs @ 2.0.1
 - tool-mklittlefs @ 1.203.210628 (2.3)
 - tool-mkspiffs @ 2.230.0 (2.30)
 - tool-ninja @ 1.9.0
 - toolchain-esp32ulp @ 1.23500.220830 (2.35.0)
 - toolchain-xtensa-esp32 @ 8.4.0+2021r2-patch5
Warning! Arduino framework as an ESP-IDF component doesn't handle the `variant` field! The default `esp32` variant will be used.
Reading CMake configuration...
LDF: Library Dependency Finder -> https://bit.ly/configure-pio-ldf
LDF Modes: Finder ~ chain, Compatibility ~ soft
Found 12 compatible libraries
Scanning dependencies...
Dependency Graph
|-- ESP32-IR-Remote-Control @ 1.0.10+sha.869e149
|-- ESP32-vs1053_ext @ 1.0.10+sha.297b304
|-- ESP32-audioI2S-master @ 2.0.0+sha.669e61d
|-- Arduino_JSON @ 0.2.0+sha.89b92d9
|-- ac101
|-- es8388
|-- ftpsrv
|-- rtime
|-- SoapESP32 @ 1.1.5
|-- tftLib
|-- websrv
|-- wm8978
Building in release mode
Compiling .pio\build\esp32\src\audiotask.o
Compiling .pio\build\esp32\src\main.o
Linking .pio\build\esp32\firmware.elf
Retrieving maximum program size .pio\build\esp32\firmware.elf
Checking size .pio\build\esp32\firmware.elf
Advanced Memory Usage is available via "PlatformIO Home > Project Inspect"
RAM:   [==        ]  17.3% (used 56744 bytes from 327680 bytes)
Flash: [========  ]  79.1% (used 3006009 bytes from 3801088 bytes)
Building .pio\build\esp32\firmware.bin
esptool.py v4.5.1
Creating esp32 image...
Merged 25 ELF sections
Successfully created esp32 image.
Configuring upload protocol...
AVAILABLE: cmsis-dap, esp-bridge, esp-prog, espota, esptool, iot-bus-jtag, jlink, minimodule, olimex-arm-usb-ocd, olimex-arm-usb-ocd-h, olimex-arm-usb-tiny-h, olimex-jtag-tiny, tumpa
CURRENT: upload_protocol = esptool
Looking for upload port...

```

**This is DECODER = 1**

various runs...

```
 *  Executing task: C:\Users\Steve\.platformio\penv\Scripts\platformio.exe run --target upload --target monitor --environment esp32

Processing esp32 (board: esp32dev; platform: https://github.com/platformio/platform-espressif32.git#v6.2.0; framework: arduino, espidf)
----------------------------------------------------------------------------------------------------------------------------------------------------------------------------------------------------Verbose mode can be enabled via `-v, --verbose` option
CONFIGURATION: https://docs.platformio.org/page/boards/espressif32/esp32dev.html
PLATFORM: Espressif 32 (6.2.0+sha.1d6e199) > Espressif ESP32 Dev Module
HARDWARE: ESP32 240MHz, 320KB RAM, 3MB Flash
DEBUG: Current (cmsis-dap) External (cmsis-dap, esp-bridge, esp-prog, iot-bus-jtag, jlink, minimodule, olimex-arm-usb-ocd, olimex-arm-usb-ocd-h, olimex-arm-usb-tiny-h, olimex-jtag-tiny, tumpa)
PACKAGES:
 - framework-arduinoespressif32 @ 2.0.8+sha.d3254f7
 - framework-espidf @ 3.40404.0 (4.4.4)
 - tool-cmake @ 3.16.4
 - tool-esptoolpy @ 1.40501.0 (4.5.1)
 - tool-idf @ 1.0.1
 - tool-mconf @ 1.4060000.20190628 (406.0.0)
 - tool-mkfatfs @ 2.0.1
 - tool-mklittlefs @ 1.203.210628 (2.3)
 - tool-mkspiffs @ 2.230.0 (2.30)
 - tool-ninja @ 1.9.0
 - toolchain-esp32ulp @ 1.23500.220830 (2.35.0)
 - toolchain-xtensa-esp32 @ 8.4.0+2021r2-patch5
Warning! Arduino framework as an ESP-IDF component doesn't handle the `variant` field! The default `esp32` variant will be used.
Reading CMake configuration...
LDF: Library Dependency Finder -> https://bit.ly/configure-pio-ldf
LDF Modes: Finder ~ chain, Compatibility ~ soft
Found 12 compatible libraries
Scanning dependencies...
Dependency Graph
|-- ESP32-IR-Remote-Control @ 1.0.10+sha.869e149
|-- ESP32-vs1053_ext @ 1.0.10+sha.297b304
|-- ESP32-audioI2S-master @ 2.0.0+sha.669e61d
|-- Arduino_JSON @ 0.2.0+sha.89b92d9
|-- ac101
|-- es8388
|-- ftpsrv
|-- rtime
|-- SoapESP32 @ 1.1.5
|-- tftLib
|-- websrv
|-- wm8978
Building in release mode
Compiling .pio\build\esp32\src\audiotask.o
Compiling .pio\build\esp32\src\main.o
Linking .pio\build\esp32\firmware.elf
Retrieving maximum program size .pio\build\esp32\firmware.elf
Checking size .pio\build\esp32\firmware.elf
Advanced Memory Usage is available via "PlatformIO Home > Project Inspect"
RAM:   [==        ]  17.9% (used 58568 bytes from 327680 bytes)
Flash: [========= ]  85.4% (used 3244281 bytes from 3801088 bytes)
Building .pio\build\esp32\firmware.bin
esptool.py v4.5.1
Creating esp32 image...
Merged 25 ELF sections
Successfully created esp32 image.
Configuring upload protocol...
AVAILABLE: cmsis-dap, esp-bridge, esp-prog, espota, esptool, iot-bus-jtag, jlink, minimodule, olimex-arm-usb-ocd, olimex-arm-usb-ocd-h, olimex-arm-usb-tiny-h, olimex-jtag-tiny, tumpa
CURRENT: upload_protocol = esptool
Looking for upload port...
Auto-detected: COM4
Uploading .pio\build\esp32\firmware.bin
esptool.py v4.5.1
Serial port COM4
Connecting.........
Chip is ESP32-D0WD-V3 (revision v3.1)
Features: WiFi, BT, Dual Core, 240MHz, VRef calibration in efuse, Coding Scheme None
Crystal is 40MHz
MAC: 40:22:d8:3e:8e:3c
Uploading stub...
Running stub...
Stub running...
Changing baud rate to 921600
Changed.
Configuring flash size...
Flash will be erased from 0x00001000 to 0x00005fff...
Flash will be erased from 0x00008000 to 0x00008fff...
Flash will be erased from 0x00010000 to 0x00329fff...
Compressed 18960 bytes to 13072...
Writing at 0x00001000... (100 %)
Wrote 18960 bytes (13072 compressed) at 0x00001000 in 0.5 seconds (effective 290.6 kbit/s)...
Hash of data verified.
Compressed 3072 bytes to 105...
Writing at 0x00008000... (100 %)
Wrote 3072 bytes (105 compressed) at 0x00008000 in 0.1 seconds (effective 288.3 kbit/s)...
Hash of data verified.
Compressed 3250032 bytes to 1214357...
Writing at 0x00010000... (1 %)
Writing at 0x000208e5... (2 %)
...etc.
Writing at 0x003238db... (98 %)
Writing at 0x00328bc5... (100 %)
Wrote 3250032 bytes (1214357 compressed) at 0x00010000 in 30.4 seconds (effective 856.1 kbit/s)...
Hash of data verified.

Leaving...
Hard resetting via RTS pin...

Please build project in debug configuration to get more details about an exception.
See https://docs.platformio.org/page/projectconf/build_configurations.html

--- Terminal on COM4 | 115200 8-N-1
--- Available filters and text transformations: colorize, debug, default, direct, esp32_exception_decoder, hexlify, log2file, nocontrol, printable, send_on_enter, time
--- More details at https://bit.ly/pio-monitor-filters
--- Quit: Ctrl+C | Menu: Ctrl+T | Help: Ctrl+T followed by Ctrl+H
[     1][V][WiFiServer.h:42] WiFiServer(): WiFiServer::WiFiServer(port=21, ...)
[     2][V][WiFiServer.h:42] WiFiServer(): WiFiServer::WiFiServer(port=50009, ...)
[     7][V][WiFiServer.h:42] WiFiServer(): WiFiServer::WiFiServer(port=80, ...)
[    15][V][WiFiServer.h:42] WiFiServer(): WiFiServer::WiFiServer(port=80, ...)
E (1110) esp_core_dump_flash: No core dump partition found!
E (1112) esp_core_dump_flash: No core dump partition found!
ESP32 Chip: ESP32-D0WD-V3
Arduino Version: 2.0.8
ESP-IDF Version: 4.4.4
ARDUINO_LOOP_STACK_SIZE 8192 words (32 bit)

00:00:00
00:00:00        ***************************
00:00:00        *     MiniWebRadio V2     *
00:00:00        ***************************

```

[164433][V][ssl_client.cpp:321] stop_ssl_socket(): Cleaning SSL connection.
17:18:44 AUDIO_info:  buffers freed, free Heap: 67152 bytes
17:18:44 AUDIO_info:  Connection has been established in 14 ms, free Heap: 66244 bytes
[164494][E][Audio.cpp:2399] readPlayListData(): m3u8 playlists requires PSRAM enabled!
17:18:44 AUDIO_info:  new request: "http://as-hls-uk-live.akamaized.net/pool_904/live/uk/bbc_radio_fourfm/bbc_radio_fourfm.isml/bbc_radio_fourfm-audio=96000-263691176.ts"
17:18:44 AUDIO_info:  AACDecoder has been initialized, free Heap: 20272 bytes , free stack 2600 DWORDs
17:18:44 AUDIO_info:  syncword found at pos 0
17:18:44 AUDIO_info:  Channels: 2
17:18:44 AUDIO_info:  SampleRate: 24000
17:18:44 AUDIO_info:  BitsPerSample: 16
17:18:44 AUDIO_info:  BitRate: 90374
17:18:44 AUDIO_info:  AAC HeaderFormat: ADTS
17:18:44 AUDIO_info:  AAC Codec: MPEG-4 LowComplexity
17:18:44 AUDIO_info:  VBR recognized, audioFileDuration is estimated
17:18:45 file "/logo/s/BBC Radio 4 hls LOW rate.jpg" not found
17:18:45 HTML_info:   SD/logo/BBC Radio 4 hls LOW rate .jpg
17:18:45 WS_onCmd:    cmd="SD/logo/BBC Radio 4 hls LOW rate .jpg", params="t=1687623525741", arg=""
17:18:45 HTML_info:   Length of file /common/s/unknown.jpg is 3187
**[165367][E][WiFiClient.cpp:422] write(): fail on fd 54, errno: 11, "No more processes"**
17:18:45 Audiocodec:  AAC
17:18:46 HTML_info:   SD/common/M3U8.jpg
17:18:46 WS_onCmd:    cmd="SD/common/M3U8.jpg", params="t=1687623526281", arg=""
17:18:46 HTML_info:   Length of file /common/s/M3U8.jpg is 8861
**[165816][E][WiFiClient.cpp:422] write(): fail on fd 54, errno: 11, "No more processes"
[166106][E][WiFiClient.cpp:422] write(): fail on fd 54, errno: 11, "No more processes"**
17:18:50 AUDIO_info:  new request: "http://as-hls-uk-live.akamaized.net/pool_904/live/uk/bbc_radio_fourfm/bbc_radio_fourfm.isml/bbc_radio_fourfm-audio=96000-263691177.ts"

17:22:53 HTML_info:   next_station
17:22:53 WS_onCmd:    cmd="next_station", params="", arg=""
17:22:53 in setStation 2
17:22:53 action: ...  switch to station 2
17:22:54 IN connecttohost https://a.files.bbci.co.uk/media/live/manifesto/audio/simulcast/hls/uk/sbr_high/ak/bbc_radio_fourfm.m3u8
17:22:54 AUDIO_info:  Connect to new host: "https://a.files.bbci.co.uk/media/live/manifesto/audio/simulcast/hls/uk/sbr_high/ak/bbc_radio_fourfm.m3u8"
[413908][V][ssl_client.cpp:321] stop_ssl_socket(): Cleaning SSL connection.
17:22:54 AUDIO_info:  buffers freed, free Heap: 69348 bytes
[413936][V][ssl_client.cpp:62] start_ssl_client(): Free internal heap before TLS 69348
[413937][V][ssl_client.cpp:68] start_ssl_client(): Starting socket
[413952][V][ssl_client.cpp:146] start_ssl_client(): Seeding the random number generator
[413953][V][ssl_client.cpp:155] start_ssl_client(): Setting up the SSL/TLS structure...
[413959][D][ssl_client.cpp:176] start_ssl_client(): WARNING: Skipping SSL Verification. INSECURE!
[413968][V][ssl_client.cpp:254] start_ssl_client(): Setting hostname for TLS session...
**[413977][E][ssl_client.cpp:37] _handle_error(): [start_ssl_client():264]: (-32512) SSL - Memory allocation failed**
[413988][E][WiFiClientSecure.cpp:144] connect(): start_ssl_client: -32512
[413997][V][ssl_client.cpp:321] stop_ssl_socket(): Cleaning SSL connection.
**17:22:54 AUDIO_info:  Request https://a.files.bbci.co.uk/media/live/manifesto/audio/simulcast/hls/uk/sbr_high/ak/bbc_radio_fourfm.m3u8 failed!**
17:22:54 StreamTitle:
17:22:54 HTML_info:   SD/logo/BBC Radio 4.jpg
17:22:54 WS_onCmd:    cmd="SD/logo/BBC Radio 4.jpg", params="t=1687623774793", arg=""
17:22:54 HTML_info:   Length of file /logo/s/BBC Radio 4.jpg is 2980
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

------- RESET EXAMPLE ....

17:58:00 bitRate:     56Kbit/s
17:58:00 bitRate:     56Kbit/s
17:58:00 AUDIO_info:  icy-name: BBC Radio
17:58:00 StationName: BBC Radio
17:58:00 icy-descr:   BBC Radio
**[ 11618][E][mp3_decoder.cpp:1555] MP3Decoder_AllocateBuffers(): not enough memory to allocate mp3decoder buffers**
17:58:00 AUDIO_info:  The MP3Decoder could not be initialized
[ 11628][D][SoapESP32.cpp:253] soapSSDPquery(): received SSDP packet within 34 ms: packet size: 364
[ 11644][V][SoapESP32.cpp:259] soapSSDPquery(): SSDP packet content:
HTTP/1.1 200 OK
CACHE-CONTROL: max-age=1800
DATE: Sat, 24 Jun 2023 16:57:59 GMT
ST: urn:schemas-upnp-org:device:MediaServer:1
USN: uuid:4d696e69-444c-164e-9d41-caabf0f3bf33::urn:schemas-upnp-org:device:MediaServer:1
EXT:
SERVER: 2.6.35.6-45.fc14.i686 DLNADOC/1.50 UPnP/1.0 MiniDLNA/1.1.0
LOCATION: http://192.168.1.1:8200/rootDesc.xml
Content-Length: 0

[ 11683][D][SoapESP32.cpp:276] soapSSDPquery(): scanned ip=192.168.1.1, port=8200, location="rootDesc.xml"
[ 11718][D][SoapESP32.cpp:253] soapSSDPquery(): received SSDP packet within 124 ms: packet size: 364
[ 11718][V][SoapESP32.cpp:259] soapSSDPquery(): SSDP packet content:
HTTP/1.1 200 OK
CACHE-CONTROL: max-age=1800
DATE: Sat, 24 Jun 2023 16:57:59 GMT
ST: urn:schemas-upnp-org:device:MediaServer:1
USN: uuid:4d696e69-444c-164e-9d41-caabf0f3bf33::urn:schemas-upnp-org:device:MediaServer:1
EXT:
SERVER: 2.6.35.6-45.fc14.i686 DLNADOC/1.50 UPnP/1.0 MiniDLNA/1.1.0
LOCATION: http://192.168.1.1:8200/rootDesc.xml
Content-Length: 0

[ 11756][D][SoapESP32.cpp:276] soapSSDPquery(): scanned ip=192.168.1.1, port=8200, location="rootDesc.xml"
17:58:04 DLNA_info:   SSDP query discovered 1 media servers
[ 15624][D][SoapESP32.cpp:1182] soapGet(): 192.168.1.1:8200 GET /rootDesc.xml HTTP/1.1
17:58:04 DLNA_info:   connected successfully to 192.168.1.1:8200
**[ 15638][E][WiFiClient.cpp:67] fillBuffer(): Not enough memory to allocate buffer**
[ 15638][E][WiFiClient.cpp:467] read(): fail on fd 53, errno: 119, "Connection already in progress"
[ 16638][E][SoapESP32.cpp:317] soapReadHttpHeader(): header line:
17:58:05 DLNA_info:   this Server does not deliver media content
[ 16649][I][WiFiClient.cpp:549] connected(): Unexpected: RES: 0, ERR: 119
**[ 16649][E][WiFiClient.cpp:67] fillBuffer(): Not enough memory to allocate buffer**
[ 16655][E][WiFiClient.cpp:467] read(): fail on fd 53, errno: 119, "Connection already in progress"
[ 17649][E][websrv.cpp:361] handlehttp(): Command client schould be available but is not!
17:58:06 Audiocodec:  MP3
**17:58:06 ftpServer:   Ftp server waiting for connection on port 21
[ 17994][E][WiFiClient.cpp:67] fillBuffer(): Not enough memory to allocate buffer
[ 17994][E][WiFiClient.cpp:467] read(): fail on fd 53, errno: 11, "No more processes"
[ 18994][E][websrv.cpp:361] handlehttp(): Command client schould be available but is not!**

**abort() was called at PC 0x4019682b on core 1**

Backtrace: 0x400836f1:0x3ffd1c10 0x4008e5a9:0x3ffd1c30 0x4009861d:0x3ffd1c50 0x4019682b:0x3ffd1cd0 0x40196872:0x3ffd1cf0 0x40196b5d:0x3ffd1d10 0x40196c1c:0x3ffd1d30 0x40120752:0x3ffd1d50 0x401208f9:0x3ffd1d80 0x40117341:0x3ffd1e10 0x400d9535:0x3ffd1e40 0x400dc7af:0x3ffd1ea0 0x400dc8aa:0x3ffd1f00 0x40116075:0x3ffd1f20

  #0  0x400836f1:0x3ffd1c10 in panic_abort at C:\Users\Steve\.platformio\packages\framework-espidf\components\esp_system/panic.c:408
  #1  0x4008e5a9:0x3ffd1c30 in esp_system_abort at C:\Users\Steve\.platformio\packages\framework-espidf\components\esp_system/esp_system.c:137
  #2  0x4009861d:0x3ffd1c50 in abort at C:\Users\Steve\.platformio\packages\framework-espidf\components\newlib/abort.c:46
  #3  0x4019682b:0x3ffd1cd0 in __cxxabiv1::__terminate(void (*)()) at /builds/idf/crosstool-NG/.build/HOST-x86_64-w64-mingw32/xtensa-esp32-elf/src/gcc/libstdc++-v3/libsupc++/eh_terminate.cc:47
  #4  0x40196872:0x3ffd1cf0 in std::terminate() at /builds/idf/crosstool-NG/.build/HOST-x86_64-w64-mingw32/xtensa-esp32-elf/src/gcc/libstdc++-v3/libsupc++/eh_terminate.cc:57
  #5  0x40196b5d:0x3ffd1d10 in __cxa_allocate_exception at /builds/idf/crosstool-NG/.build/HOST-x86_64-w64-mingw32/xtensa-esp32-elf/src/gcc/libstdc++-v3/libsupc++/eh_alloc.cc:300
  #6  0x40196c1c:0x3ffd1d30 in operator new(unsigned int) at /builds/idf/crosstool-NG/.build/HOST-x86_64-w64-mingw32/xtensa-esp32-elf/src/gcc/libstdc++-v3/libsupc++/new_op.cc:54
  #7  0x40120752:0x3ffd1d50 in __gnu_cxx::new_allocator<std::_Sp_counted_ptr_inplace<VFSFileImpl, std::allocator<VFSFileImpl>, (__gnu_cxx::_Lock_policy)2> >::allocate(unsigned int, void const*) at c:\users\steve\.platformio\packages\toolchain-xtensa-esp32\xtensa-esp32-elf\include\c++\8.4.0\ext/new_allocator.h:111
      (inlined by) std::allocator_traits<std::allocator<std::_Sp_counted_ptr_inplace<VFSFileImpl, std::allocator<VFSFileImpl>, (__gnu_cxx::_Lock_policy)2> > >::allocate(std::allocator<std::_Sp_counted_ptr_inplace<VFSFileImpl, std::allocator<VFSFileImpl>, (__gnu_cxx::_Lock_policy)2> >&, unsigned int) at c:\users\steve\.platformio\packages\toolchain-xtensa-esp32\xtensa-esp32-elf\include\c++\8.4.0\bits/alloc_traits.h:436
      (inlined by) std::__allocated_ptr<std::allocator<std::_Sp_counted_ptr_inplace<VFSFileImpl, std::allocator<VFSFileImpl>, (__gnu_cxx::_Lock_policy)2> > > std::__allocate_guarded<std::allocator<std::_Sp_counted_ptr_inplace<VFSFileImpl, std::allocator<VFSFileImpl>, (__gnu_cxx::_Lock_policy)2> > >(std::allocator<std::_Sp_counted_ptr_inplace<VFSFileImpl, std::allocator<VFSFileImpl>, (__gnu_cxx::_Lock_policy)2> >&) at c:\users\steve\.platformio\packages\toolchain-xtensa-esp32\xtensa-esp32-elf\include\c++\8.4.0\bits/allocated_ptr.h:97
      (inlined by) std::__shared_count<(__gnu_cxx::_Lock_policy)2>::__shared_count<VFSFileImpl, std::allocator<VFSFileImpl>, VFSImpl*, char const*&, char const*&>(VFSFileImpl*&, std::_Sp_alloc_shared_tag<std::allocator<VFSFileImpl> >, VFSImpl*&&, char const*&, char const*&) at c:\users\steve\.platformio\packages\toolchain-xtensa-esp32\xtensa-esp32-elf\include\c++\8.4.0\bits/shared_ptr_base.h:675
      (inlined by) std::__shared_ptr<VFSFileImpl, (__gnu_cxx::_Lock_policy)2>::__shared_ptr<std::allocator<VFSFileImpl>, VFSImpl*, char const*&, char const*&>(std::_Sp_alloc_shared_tag<std::allocator<VFSFileImpl> >, VFSImpl*&&, char const*&, char const*&) at c:\users\steve\.platformio\packages\toolchain-xtensa-esp32\xtensa-esp32-elf\include\c++\8.4.0\bits/shared_ptr_base.h:1342
      (inlined by) std::shared_ptr<VFSFileImpl>::shared_ptr<std::allocator<VFSFileImpl>, VFSImpl*, char const*&, char const*&>(std::_Sp_alloc_shared_tag<std::allocator<VFSFileImpl> >, VFSImpl*&&,
char const*&, char const*&) at c:\users\steve\.platformio\packages\toolchain-xtensa-esp32\xtensa-esp32-elf\include\c++\8.4.0\bits/shared_ptr.h:359
      (inlined by) std::shared_ptr<VFSFileImpl> std::allocate_shared<VFSFileImpl, std::allocator<VFSFileImpl>, VFSImpl*, char const*&, char const*&>(std::allocator<VFSFileImpl> const&, VFSImpl*&&, char const*&, char const*&) at c:\users\steve\.platformio\packages\toolchain-xtensa-esp32\xtensa-esp32-elf\include\c++\8.4.0\bits/shared_ptr.h:706
      (inlined by) std::shared_ptr<VFSFileImpl> std::make_shared<VFSFileImpl, VFSImpl*, char const*&, char const*&>(VFSImpl*&&, char const*&, char const*&) at c:\users\steve\.platformio\packages\toolchain-xtensa-esp32\xtensa-esp32-elf\include\c++\8.4.0\bits/shared_ptr.h:722
  #8  0x401208f9:0x3ffd1d80 in VFSImpl::open(char const*, char const*, bool) at C:/Users/Steve/.platformio/packages/framework-arduinoespressif32-src-52b8cdec3e60619426e51a1d18d1c3fa/libraries/FS/src/vfs_api.cpp:47
  #9  0x40117341:0x3ffd1e10 in fs::FS::open(char const*, char const*, bool) at C:/Users/Steve/.platformio/packages/framework-arduinoespressif32-src-52b8cdec3e60619426e51a1d18d1c3fa/libraries/FS/src/FS.cpp:234
  #10 0x400d9535:0x3ffd1e40 in updateSettings() at src/main.cpp:417
  #11 0x400dc7af:0x3ffd1ea0 in check_1sec() at src/main.cpp:2243
  #12 0x400dc8aa:0x3ffd1f00 in loop() at src/main.cpp:2269 (discriminator 1)
  #13 0x40116075:0x3ffd1f20 in loopTask(void*) at C:/Users/Steve/.platformio/packages/framework-arduinoespressif32-src-52b8cdec3e60619426e51a1d18d1c3fa/cores/esp32/main.cpp:50

ELF file SHA256: b3d397abfc4fb8c7

E (12025) esp_core_dump_flash: Core dump flash config is corrupted! CRC=0x7bd5c66f instead of 0x0
Rebooting...
ets Jul 29 2019 12:21:46

rst:0xc (SW_CPU_RESET),boot:0x13 (SPI_FAST_FLASH_BOOT)

schreibfaul1, 2023-06-25:
Finding a trade-off between storage usage and features is difficult. Without PSRAM with I2S DAC only mp3 and aac will work properly.
1) The InBuffer, which temporarily stores the raw audio data, is about 16000 bytes large without PSRAM and about 640000 bytes with PSRAM. So FLAC with a block size of 8KB, only 2 frames fit into the buffer, which is very little.
2) Some WLAN functions are swapped out to the PSRAM, if available
3) mbetTLS (https://...) needs more than 20KB and should therefore be written to PSRAM.
4) VS1053 is a HW decoder, the SW decoders need additional memory, PSRAM is used where possible
5) I reduced the stack in the audio task by 2000 DWORDs (8000bytes), that might help. If you click on the question mark, the 'highest water level' is displayed in the log. There should still be some space at the top, if you reach zero there is a risk of a crash.
If you want to use all functions, PSRAM is advisable. Especially OPUS, VORBIS and FLAC are very memory hungry.

steve6375, 2023-06-26:
Thanks for reply. Changing CONFIG_MBEDTLS_INTERNAL_MEM_ALLOC didn't help.
The memory stats when using the test ? button in the web ui station screen dont show much difference (but playing some radio stations cause buffer errors as soon as they are played on the DAC still).
I guess an esp32 with PSRAM is needed.
Do you have a recommendation for a suitable esp32, audio board and TFT that will work the best?
Is any model of esp32+PSRAM OK?

schreibfaul1, 2023-06-26:
An ESP32 with 4MB PSRAM is sufficient. PSRAM is faster with ESP32-S3, even faster with octal PSRAM. AAC with SBR is then also activated for the S3 (only ext. DAC). An external DAC would also be good, like PCM5102 instead of the old VS1053B

steve6375, 2023-07-01:
FreeNove WROVER + PSRAM + camera board with PCM5102 solves the problem.

I get warnings

08:21:06 AUDIO_info:  slow stream, dropouts are possible
08:21:07 AUDIO_info:  slow stream, dropouts are possible
08:21:08 AUDIO_info:  slow stream, dropouts are possible

but seems OK.

Closed 2023-07-01.

Thread 208 (2023-06-29):

Radio Stations not playing and 'nvs_get_str len fail' error (esp32 + PSRAM)

steve6375, 2023-06-29:
I had MiniWebRadio working on an esp32 without PSRAM.
I programmed a brand new esp32 WROVER which has PSRAM (actually a FREENOVE esp32 WROVER-E with 4MB PSRAM - but with no camera attached).
The SD card loads OK.
The Web GUI can be displayed and accessed.
Media files play OK.
Stations are listed in the web GUI OK.
TFT display is OK.
BUT - no station name is displayed on the TFT and no radio station plays.
Also the web GUI URL fields do not update.

The code is the same (I only changed to NVRAM enabled in PlatformIO.ini build flags.)
I am using the previous small_buttons branch and same code works on WROOM esp32 with no PSRAM.

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

Here is the serial monitor log

```
0:26:30 rtime_info:  20:26:30
20:26:30 audiotask:   is pinned to core 1
20:26:30 audiotask:   priority is 2
20:26:31 VS1053 chipID = -1372388535, version = 3
20:26:31 setup: ....  Number of saved stations: 28
20:26:31 setup: ....  current station number: 1
20:26:31 setup: ....  current volume: 18
20:26:31 setup: ....  last connected host: https://stream.live.vc.bbcmedia.co.uk/bbc_world_service
20:26:31 setup: ....  connection timeout: 500 ms
20:26:31 setup: ....  connection timeout SSL: 2000 ms
[ 12410][E][Preferences.cpp:483] getString(): nvs_get_str len fail: station_001 NOT_FOUND
20:26:31 action: ...  switch to station 1
20:26:31 AUDIO_info:  Connect to new host: "http://"
20:26:31 AUDIO_info:  Song stopped correctly after 0 msec
20:26:31 AUDIO_info:  PSRAM found, inputBufferSize: 295903 bytes
[ 12468][E][WiFiGeneric.cpp:1578] hostByName(): DNS Failed for
20:26:31 AUDIO_info:  Request http:// failed!
20:26:31 StreamTitle:
20:26:31 file "/logo/s/.jpg" not found
20:26:31 DLNA_info:   SSDP search for media servers started
20:26:35 DLNA_info:   SSDP query discovered 1 media servers
20:26:35 DLNA_info:   connected successfully to 192.168.1.1:8200
20:26:35 ftpServer:   Ftp server waiting for connection on port 21
[ 23117][E][Preferences.cpp:483] getString(): nvs_get_str len fail: station_002 NOT_FOUND
20:26:41 action: ...  switch to station 2
20:26:41 AUDIO_info:  Connect to new host: "http://"
20:26:41 AUDIO_info:  Song stopped correctly after 0 msec
[ 23155][E][WiFiGeneric.cpp:1578] hostByName(): DNS Failed for
20:26:41 AUDIO_info:  Request http:// failed!
20:26:41 StreamTitle:
20:26:42 file "/logo/s/.jpg" not found
```

It seems the issue may be around
getString(): nvs_get_str len fail: station_001 NOT_FOUND

The URL does not seem to be obtained. It just has the http:// start but not the rest.

any clues where I might look for the error?
The board is set as esp32dev - should I set esp-wrover-kit?

steve6375, 2023-06-29:
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
Stations.csv is OK
If I load a URL into web GUI filed then it plays OK
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

It seems the storage to nvs is failing?

schreibfaul1, 2023-06-29:
I added partition tables for 8 and 16MB flash. In doing so, I put the nvs partition from the end of the table in an area that is in the same place for everyone. By doing so you probably overwrote the old nvs area. Please delete the settings.json so that nvs is rewritten.

steve6375, 2023-06-29:
That fixed it! Thanks :-)

steve6375, 2023-06-30:
P.S. I cloned the latest version and got the same issue. Could you add a way to auto-detect this problem and automatically delete and remake the settings.csv? It is not obvious that the settings.csv file needs to be deleted.

schreibfaul1, 2023-06-30:
That's strange. The nvs partition is not deleted during the update, which is also not intended because it will destroy your own channel lists.
I don't have a solution for this at the moment.
The only thing I can think of to destroy the nvs partition would be 'Erase Flash'

Closed 2023-06-29.

Thread 209 (2023-06-29):

Touchscreen initialization and other details

valera39, 2023-06-29:
Hello Wolle!
I replaced VS1053 with PCM5102 and the noise and clicking problem is completely solved. The VU meter also started working normally. So the problem was in the VS1053 settings?
But it still does not work with the touchscreen, only if you jerk the gpio, I wrote earlier about this.
Thanks, looking forward to the corrections!
P.S.
Time announcement on the hour cannot be disabled.
 And please see #203. Can you help?

valera39, 2023-06-30:
Turning the time announcement on and off works. But the touchscreen does not start after rebooting or powering on until T_IRQ is shorted to ground or disconnected from ESP.
ESP32S3 N8R8, ILI9488, PCM5102. No errors in the log

Arne65, 2023-06-30:
Hallo Valera

I had a similar problem and swapped the GPIO TP IRQ and TP_CS in the code that helped me

valera39, 2023-06-30:
Hello [Arne65](https://github.com/Arne65)
change in common.h?

Arne65, 2023-06-30:
Yes

valera39, 2023-06-30:
Ok

schreibfaul1, 2023-07-01:
Great that you were able to solve the problem by changing the GPIOs. I rarely had a TP blockade, but then no SW or HW reset helped. Only interrupting the operating voltage.
The TP controller has no reset pin nor any registers that could be reset.
I have now added a fake measurement for x and y to the setup, maybe that will help.

Closed 2023-07-06.

Thread 223 (2023-07-04):

help wanted

valera39, 2023-07-04:
Hello Wolle!
Knowing that you always answer thoroughly and in detail, I want to ask you a few questions that are of interest to me. I may have asked them before and some of them have not been answered, so
Please forgive me in advance, including the inaccurate translation in some places.
You can replace the "mute" button with a "stop" button on the main screen to stop the radio stream, and after about 30 seconds, display the clock on the screen. In this way, if there is no playback, the clock is displayed in full screen.
Is it possible to apply this image
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
 instead of the # in front of the station numb
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
er. I think that would be nice.
Do you have any successes and developments for the implementation of the list of stations on the display, or you have not dealt with this option?
I think it is extremely difficult or impossible to make DLNA or player mode control playback, rewind, random playback and so on from the display. Or am I wrong?
I would like to control the functions with the touch screen and remote control as much as possible.
Please explain how to prescribe another remote control. I tried to convert the remote control code in the IR.cpp file with a HEX calculator, but it did not work. What is the right way to do this,
to get the correct values, for example case 39015: ir_resp=0; break; //ZERO 0xFF0019. I would like to do a full on and off with a separate miniweb remote button, like I do with any household device.
Is it possible for the user himself, not having much programming skills, to move and change the VU metr on the display?
I very much hope that you will have no difficulty in answering my questions.
I tried to email you questions, but your box doesn't exist.
Please continue to support your wonderful project. You can always count on my help to make your radio even better!
Thank you!

Arne65, 2023-07-04:
Hello Valera

I think the following protocols are supported by arduino  ir

Currently included protocols: Denon / Sharp, JVC, LG / LG2, NEC / Onkyo / Apple, Panasonic / Kaseikyo, RC5, RC6, Samsung, Sony, (Pronto), BangOlufsen, BoseWave, Lego, Whynter, FAST, MagiQuest.<br/><br/><b>New: </b>Added FAST Protocol. Changed some function signatures. Improved handling of PULSE_DISTANCE + PULSE_WIDTH protocols.<br/><a href="https://github.com/Arduino-IRremote/Arduino-IRremote/blob/master/changelog.md">Release notes</a><br/>

look here

https://github.com/Arduino-IRremote/Arduino-IRremote

if your remote has one of these protocols it should work

Arne65, 2023-07-04:
is your calculation correct?

                   case 39015: ir_resp=0;  break; //ZERO   0x9867

valera39, 2023-07-04:
[Arne65](https://github.com/Arne6,5), Yes, this is an example of the original IR.cpp

valera39, 2023-07-04:
You can also add to the log output in PlatformIO the number of the current version?

schreibfaul1, 2023-07-04:
Hi @valera39 , I've made symbols for station number and sleep in time, but I'm not good at it. Your symbols seem better. The height can be max 30px and the width for both 68px. There is a constraint on bmp that the width must be a multiple of 4.

valera39, 2023-07-04:
Thank you so much! I would appreciate it if you could answer my questions and suggestions.

valera39, 2023-07-06:
It would be nice if you could shift the VU metr, like this
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

steve6375, 2023-07-06:
Why do you want the VU moved? Is it being partially hidden by the TFT screen bezel on your case?

I don't think an alarm clock symbol is correct. The timer is an 'off' timer not an alarm timer. It switches off the device after a preset time. Maybe something like:
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
and
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

valera39, 2023-07-06:
This picture is just the bottom of the screen.
When all the elements are on the same line at the bottom, it looks more organic.
You can put your own picture of the clock or an original one from the archive.

valera39, 2023-07-06:
Hello dear Wolle!
I still hope that you will answer my questions

Closed 2024-02-08.

Thread 269 (2023-08-01):

Bad sound when decode AAC SBR streams

kpbicka, 2023-08-01:
Good afternoon colleagues :)

I have assembled and tested 4 different Wi-Fi radios and this project has proved to be the most stable in my opinion.
However, there are several questions. Please answer me who can

1. Poor decoding of "hard" AAC SBR (Spectral Band Replication) streams. As an example, you can play the link https://stream01.pcradio.ru/Sandra-hi on your computer and through your radio (this project) and hear the difference - the upper frequencies are cut off. I using VS1053B decoder, but the same board decoded this stream well if connected to the original Ka-Radio32 firmware.
In general, other AAC streams also sound bad - not enough high frequencies, although as I said - on the original karadio32 project through the VS1053B or external I2C DAC they sound high quality

2. For some reason, my console output ends here:

[ 446][I][esp32-hal-psram.c:96] psramInit(): PSRAM enabled
ESP32 Chip: ESP32-D0WD-V3
               Arduino Version: 2.0.11
                                ESP-IDF Version: 4.4.4
                                            MiniWebRadio Version 2.8.3b Jul 22/2023
                                                         CPU speed 240 MHz
                                                                           ARDUINO_LOOP_STACK_SIZE 8192 words (32 bit)

FLASH size 4194304 bytes, speed 40 MHz
PSRAM total size: 8388608 bytes
                                                                           00:00:00
00:00:00 ***************************
00:00:00 * MiniWebRadio V2 *
00:00:00 ***************************
00:00:00
00:00:00 setup: .... Arduino is p

although when compiling i tried changing DCORE_DEBUG_LEVEL different values but the result is the same the last output is "Arduino is p"
I even tried AUDIOTASK_CORE 0 or 1 - but no luck

3. Request for a decorative character - the VU-meter substrate is too bright, almost the same brightness as the level indicators - I did not succeed in making it darker by editing the file /SD card/common/s/level_bar.bmp
4. The same problem when displaying the clock - empty segments are too bright on my ILI9341 display

schreibfaul1, 2023-08-01:
1) SBR is turned off by default for the ESP32. On the one hand, this is due to the memory consumption and, on the other hand, to the access speed of the memory. Due to the own Arduino compilation, the situation is a bit more relaxed here. Here you can switch on SBR in the aac_decoder.h.
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
I don't know karadio32.
2) I suspect a setting problem in the terminal. Try an external terminal, is the behavior different then?

3+4) These are prepared graphics on the SD that are used for many displays. You can use a graphics program to adjust the color, saturation and contrast to your liking.

kpbicka, 2023-08-01:
Thanks for fast and useful answer.

kpbicka, 2023-08-01:
Unfortually I can't find aac_decoder.h in this project  :(

schreibfaul1, 2023-08-01:
that's a bit hidden
.pio / libdeps / esp32 / ESP32-audioI2S-master / src / aac_decoder / aac_decoder.h
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

kpbicka, 2023-08-01:
Моя благодарность Вам!

steve6375, 2023-08-01:
The clock empty segments seem too bright on my 9341 too, but if viewed at 90 degrees the contrast is much better.
I would prefer it if the shadow unlit segments were a lot darker too.

schreibfaul1, 2023-08-01:
Yes, that's why SBR is disabled for ESP32. This is too big for SRAM in this project and PSRAM is too slow with 40MHz SPI

kpbicka, 2023-08-01:
> Yes, that's why SBR is disabled for ESP32. This is too big for SRAM in this project and PSRAM is too slow with 40MHz SPI

Do you think only ESP32-S3 with PSRAM is the best fit for your project?

schreibfaul1, 2023-08-01:
The ESP32-S3 has advantages and disadvantages. The biggest advantage is a faster PSRAM and thus more can be outsourced (SSL, mbedtls)
A serious disadvantage is currently the speed of the SD card. This should improve with Arduino V3 and IDF 5

Closed 2023-08-01.

Thread 270 (2023-08-04):

platformio esp32-a1s upload

newbee90, 2023-08-04:
leider bekomme ich die Software mit PlatfornIO nicht auf das Board, sagt beides mal es ist der falsche Chip

Arne65, 2023-08-04:
Hast du die Widerstände alle entfernt laut der Anleitung ? Das sollte zwar unerheblich sein für die Programmierung abermals weiß ja nie . Du bist auch auf dem UART ?

newbee90, 2023-08-04:
ich Depp, ich muß vor dem einstecken die boot Taste drücken, sonst läßt sich das Teil nicht programmieren

schreibfaul1, 2023-08-04:
Guck mal, ob unten in der Statuszeile `Default (ESP32-MiniWebRadio)` steht. Falls ja, ändere das bitte in `env:esp32(ESP32-MiniWebRadio)`

newbee90, 2023-08-05:
ich habe alle Variationen durch, default, esp32, esp32s2, kein upload, boot gedrückt beim Einstecken, boot gedrückt gehalten und reset gedrückt
Serial port COM4
Connecting....
Chip is ESP32-D0WD-V3 (revision v3.0)
Features: WiFi, BT, Dual Core, 240MHz, VRef calibration in efuse, Coding Scheme None
Crystal is 40MHz
MAC: b8:d6:1a:58:24:d0
Uploading stub...
Running stub...
Stub running...
Changing baud rate to 460800
Changed.
WARNING: Failed to communicate with the flash chip, read/write operations will fail. Try checking the chip connections or removing any other hardware connected to IOs.
Configuring flash size...
Flash will be erased from 0x00001000 to 0x00005fff...
Flash will be erased from 0x00008000 to 0x00008fff...
Flash will be erased from 0x00050000 to 0x00372fff...
Compressed 18960 bytes to 13072...

A fatal error occurred: Packet content transfer stopped (received 8 bytes)
*** [upload] Error 2
============ [FAILED] Took 50.69 seconds ====================
Environment    Status    Duration
-------------  --------  ------------
esp32          FAILED    00:00:50.693
================ 1 failed, 0 succeeded in 00:00:50.693

Arne65, 2023-08-05:
Da findest Suhler alles was brauchst

https://github.com/schreibfaul1/ESP32-MiniWebRadio/blob/master/additional_info/AI%20Thinker%20A1S%20Board.pdf

newbee90, 2023-08-05:
da finde ich wie das Display angeschlossen wird aber nicht welche Werte ich für dieses Raspberry XPT2046 brauche für die common.h

Arne65, 2023-08-05:
Common.h Definition steht doch auf Seite 2

unten auf der Seite.  Next

newbee90, 2023-08-05:
das meine ich, die Werte brauche ich

#define DECODER             4                     // (0)VS1053 , (1)MAX98357A PCM5102A... (2)AC101 (3)ES8388 (4)WM8978
#define TFT_CONTROLLER      4             // (0)ILI9341, (1)HX8347D, (2)ILI9486a, (3)ILI9486b, (4)ILI9488, (5)ST779 (6)ST7796RPI
#define DISPLAY_INVERSION   0             // (0) off (1) on
#define TFT_ROTATION        1                // 1 or 3 (landscape)
#define TFT_FREQUENCY       40000000                        // 27000000, 40000000, 80000000
#define TP_VERSION          4                // (0)ILI9341, (1)ILI9341RPI, (2)HX8347D, (3)ILI9486, (4)ILI9488, (5)ST7796, (3)ST7796RPI
#define TP_ROTATION         1                               // 1 or 3 (landscape)
#define AUDIOTASK_CORE      1                               // 0 or 1
#define AUDIOTASK_PRIO      2                               // 0 ... 24  Priority of the Task (0...configMAX_PRIORITIES -1)
#define SDMMC_FREQUENCY     20000000              // 40000000, 2000000, 10000000, not every SD Card will run at 40MHz

Arne65, 2023-08-05:
#define DECODER 4 hängt davon ab ab welcher Chip drauf  ist   bei mir ES8383

#define TFT_CONTROLLER                                                                           ILI9486a

#define  TP_VERSION                                                                                    ILI 9486

Alle anderen Werte kannst du erstmal so lassen

das Display hat mir nerven gekostet um es zum laufen zu bringen

newbee90, 2023-08-05:
Decoder habe ich alle Werte von 0 bis 4 durch, kein Ton auf der Kopfhörerbuches, Weboberfläche ist da und Musiktitel wird auch angezeigt auch im Terminal

Arne65, 2023-08-05:
Hast du in Common.h alles eingetragen alles auch -1 und pin 25,26 getauscht je nach verwendetem DAC ?

newbee90, 2023-08-05:
Danke schon mal für deine Hilfe
Ton ist jetzt da nachdem ich ALLE Zahlen, so wie sie auf der Liste stehen, geändert habe,
nur wenn ich das Display anstecke geht nichts mehr und im Terminal kommt, 11562][E][Wire.cpp:526] write(): NULL TX buffer pointer

newbee90, 2023-08-05:
Angeschlossen habe ich es so
ESP   Display
22      24
5        18
12      11
13      26
23      19
19      21
18      23

schreibfaul1, 2023-08-05:
Was hast du genau für ein Display, für Rasperrys gibt es verschiedene.
Eigenartig ist die Meldung `11562][E][Wire.cpp:526] write():` die auf I2C hindeutet. I2C wird nur intern zwischen dem ESP und den Audiochip benötigt und ist nicht nach außen geführt.
Verlinke bitte hier ein Bild des Displays.

newbee90, 2023-08-05:
hier ist das Bild
https://ibb.co/K2TbXMM

schreibfaul1, 2023-08-05:
Damit gibt es keine Probleme, hab selber dieses Diaplay won Waveshare.
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

newbee90, 2023-08-05:
oben habe ich ja geschrieben wie ich es angeschlossen habe, es sind ja nur 7 Kabel plus Betriebsspannung, das habe ich schon 5x überprüft und Kurzschlüsse habe ich auch keine drauf, das Bild hast du mir schon geschicht weil ich danach gefragt hatte.

newbee90, 2023-08-05:
jetzt habe ich im Terminal
         Connected!
invalid header: 0xffffffff
invalid header: 0xffffffff
invalid header: 0xffffffff
invalid header: 0xffffffff
invalid header: 0xffffffff
invalid header: 0xffffffff
invalid header: 0xffffffff
ets Jul 29 2019 12:21:46

rst:0x10 (RTCWDT_RTC_RESET),boot:0x37 (SPI_FAST_FLASH_BOOT)
invalid header: 0xffffffff
invalid header: 0xffffffff
invalid header: 0xffffffff
invalid header: 0xffffffff
invalid header: 0xffffffff
invalid header: 0xffffffff
invalid header: 0xffffffff
invalid header: 0xffffffff
ets Jul 29 2019 12:21:46

Arne65, 2023-08-05:
Ich habe denke ich das gleiche Display wie  Du

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

Das Einzige was ich geändert habe ist in

Ich hatte immer einen weißes Display

Common.h   TP_IRQ =13    und TP_CS =12 und dann am Display getauscht dann hat es funktioniert ich nutze es aber derzeit nicht da mir Befestigungspunkte für das Display fehlen

Arne65, 2023-08-05:
Ich benutze ein Display mit dem ILI 9488 diese haben immer auf Anhieb funktioniert

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

mit der obigen beschriebenen Änderung auch am a1s

newbee90, 2023-08-05:
bringt bei mir keinen Unterschied, das andere Display ist halt größer, das rote habe ich nur als 2,8"

Arne65, 2023-08-05:
ungültiger Header: 0xffffffff sieht für mich so aus, als ob der Flash gelöscht ist oder leer

newbee90, 2023-08-05:
die Meldung kommt aber nur wenn die Verbindung von 12 und 13 zum Display gesteckt ist

steve6375, 2023-08-05:
Did you see the comment in common.h about a 1k resistor for pin 12?

newbee90, 2023-08-05:
#define VS1053_SCK    -1  // VS1053     (HSPI) (sometimes we need a 1k resistor against ground)
I have no VS1053, its a ES8388

Arne65, 2023-08-05:
Ohne 12 und 13 funktioniert es dann soweit ?

Arne65, 2023-08-05:
S4 und S5 sind ON ?

newbee90, 2023-08-05:
1,2,3 off
4.5 on
macht keinen Unterschied,

Arne65, 2023-08-05:
Und die Widerstände sind raus aus dem a1s ?

newbee90, 2023-08-05:
die Widesstände sind raus
![Uploading IMG_7766.jpg…]()

schreibfaul1, 2023-08-05:
Es sieht aus, als wenn GPIO0 beschaltet ist, aber Reset nicht,
RST wird mit dem Display verbunden und GPIO0 ist intern MCLK und bleibt frei

newbee90, 2023-08-05:
RST ist jetzt angeschlossen und es geht auch das Display, GIO0 ist nicht belegt,
wenn 12 angeschlossen ist geht gar nichts,

Arne65, 2023-08-05:
kannst mal folgendes versuchen 12 trennen Rest  drücken dann 12 wieder anschließen

sollte es dann funktionieren 12 /13 tauschen und in Common.h

newbee90, 2023-08-05:
12 und 13 tauschen hat Arne65 schon geschrieben, hat nichts gebracht, sobald die 12 angeschlossen ist geht nichts mehr
egal ob 12 und 13 vertauscht sind oder nicht
wie müsser den S1 bis 3 stehen?

schreibfaul1, 2023-08-06:
GPIO2 und GPIO12 sind "strapping pins" die über einen internen Pulldown Widerstand des ESP beim Booten aul Low gezogen werden. Wenn beim Start GPIO12 (oder GPIO2) als High erkannt wird läuft der Bootvorgang nicht korrekt. Was ist, wenn du GPIO12 beim Start unbeschaltet lässt und danach erst verbindest (zeitlich kein Problem, ist nur der Eingang für TP_IRQ)? Falls es dann funktioniert, sind die vermutlich vorhandenen PullUps des Displays zu stark.

newbee90, 2023-08-06:
sobald das Startbild erscheint kann ich GPIO12 anschließem
ich habe 10k als Pullup am Display gemessen,
ich warte auf die neuen Displays

schreibfaul1, 2023-08-06:
Wahrscheinlich kannst du den Pullup mit einem gleichgroßen Widerstand gegen Masse kompensieren.

steve6375, 2023-08-06:
IO12 has R37 pullup and is connected to SD card.
So maybe R37  is causing issues?

newbee90, 2023-08-06:
The problem is only when a display is connected, so I wait for different displays

steve6375, 2023-08-06:
The SD card has a pull up and the display has a pull up, so maybe that is much.
R37 could be removed to see what affect it has?

newbee90, 2023-08-06:
I see R37 in the datasheed but can´t find it on the board, I find R23, between 3,3V pin and GPIO12 its over 2,3M, so maybee R37 is missing

steevemadison, 2023-08-11:
here what i did to make it work , without problem , i put a wire at gpio4 ,at gpio36 and gpio12 is use for ir , then my common.h config is.

        #define TFT_CS        22
        #define TFT_DC         5
        #define TFT_BL         4
        #define TP_IRQ        36
        #define TP_CS         13

        #define SD_MMC_D0      2
        #define SD_MMC_CLK    14
        #define SD_MMC_CMD    15

        #define IR_PIN        12

        #define TFT_MOSI      23
        #define TFT_MISO      19
        #define TFT_SCK       18
    #if DECODER == 0
        #define VS1053_CS     -1
        #define VS1053_DCS    -1
        #define VS1053_DREQ   -1
        #define VS1053_MOSI   -1
        #define VS1053_MISO   -1
        #define VS1053_SCK    -1
    #else
        #define I2S_DOUT      26
        #define I2S_DIN       35
        #define I2S_BCLK      27
        #define I2S_LRC       25
        #define I2S_MCLK       0
    #endif
        #define I2C_DATA      33
        #define I2C_CLK       32
        #define SD_DETECT     34
        #define HP_DETECT     39
        #define AMP_ENABLED   21

newbee90, 2023-08-11:
Perfect, thats all I need

Closed 2024-01-21.

Thread 274 (2023-08-10):

Esp32 S3 not available

GrazAnt, 2023-08-10:
I am unable to find a Esp32 S3 AI thinker.
Could an ESP32-S3-DevKitC-1-N16R8V be used as a replacement?
As a reference:
https://docs.espressif.com/projects/esp-idf/en/latest/esp32s3/hw-reference/esp32s3/user-guide-devkitc-1.html
And if it can be done, then, would it be possible to have the pin configuration or the schematic in order to build it correctly?

Thank you very much.

valera39, 2023-08-10:
Of course you can, I have one radio built on an ESP32 S3 N16R8. The connection is similar to Al Thinker. In the file common.h there is a pinout and in the archive with the project there is a picture with connection.

TubaFonse, 2023-08-11:
@GrazAnt
I'm also using ESP32-S3-DevKitC-1-N16R8 (Chip: ESP32-S3-WROOM-1-N16R8). I use the I2S-DAC PCM5102A, but I had to change some GPIO's against the actual common.h (CONFIG_IDF_TARGET_ESP32S3)!
You have to change some GPIO's when using WROOM-1-N16R8 Core:
1.) Due to the internal connected Octal SPI PSRAM and Octal SPI Flash there are some GPIO's not usable (33-37), see datasheet.
2.) Don't use GPIO 3 for DAC, since it is the "Strapping-Pin" to select USB/JTAG-Port (UART/USB); e.g. use GPIO 5 as I2S_BCLK.
3.) Don't forget to configure platformio.ini correctly [env:esp32s3]: choose
board_build.partitions = miniwebradio16MB.csv   ; 16MB Flash
board = ESP32-S3-DevKitC-1-N16R8       ; 16MB Flash, 8MB octo PSRAM  *1)
 *1)   in menuconfig the type of PSRAM must be changed from QUAD to OCTAL!
;       component config ---> ESP32S3-Specific ---> SPI RAM config ---> MODE (QUAD/OCT)... ---> (x) Octal Mode PSRAM
good luck!
@valera39
you wrote: ... in the archive with the project there is a picture with connection
1.) are there the connection shown special for ESP32 S3 N16R8 (SOC system on chip)?
2.) WHERE can I find that archive / picture? Pls show me the link ... sorry I did'nt find that project archive.
3.) do you also have a pinout for configuration VS1053 and ESP32 S3 N16R8, which is working?
You know, there are the restricted GPIO's 19, 20, (USB) 38 or 48 (RGB-LED) ...

GrazAnt, 2023-08-11:
@valera39 @TubaFonse
Thank you both very much, I will try out TubaFonse's advise in the next days and then let you know the results.
When I'm done I'll share my 3d design for the radio case with you all as thanks.

valera39, 2023-08-11:
@GrazAnt, here's my config for PCM 5102:
#ifdef CONFIG_IDF_TARGET_ESP32S3
    // Digital I/O used
        #define TFT_CS         8
        #define TFT_DC        12
        #define TFT_BL        10 // at -1 the brightness menu is not displayed
        #define TP_IRQ        39
        #define TP_CS         15
        #define SD_MMC_D0     11
        #define SD_MMC_CLK    13
        #define SD_MMC_CMD    14
        #define IR_PIN         4
        #define TFT_MOSI      18  // TFT and TP (FSPI)
        #define TFT_MISO       2  // TFT and TP (FSPI)
        #define TFT_SCK       17  // TFT and TP (FSPI)
    #if DECODER == 0
        #define VS1053_CS     48
        #define VS1053_DCS    16
        #define VS1053_DREQ   38
        #define VS1053_MOSI   20  // VS1053     (HSPI)
        #define VS1053_MISO   19  // VS1053     (HSPI)
        #define VS1053_SCK    21  // VS1053     (HSPI) (sometimes we need a 1k resistor against ground)
    #else
        #define I2S_DOUT       9
        #define I2S_DIN       -1
        #define I2S_BCLK       3
        #define I2S_LRC       46
        #define I2S_MCLK      -1
    #endif
        #define I2C_DATA      -1  // some DACs are controlled via I2C
        #define I2C_CLK       -1
        #define SD_DETECT     -1  // some pins on special boards: Lyra, Olimex, A1S ...
        #define HP_DETECT     -1
        #define AMP_ENABLED   -1
Everything works fine. The picture I used was for ESP32 Al Thinker, I didn't notice any difference https://github.com/schreibfaul1/ESP32-MiniWebRadio/blob/master/additional_info/ESP32-S3%20pins.jpg

GrazAnt, 2023-08-12:
@TubaFonse

I'm sorry but I just can't find :
*1) in menuconfig the type of PSRAM must be changed from QUAD to OCTAL!
(where do i find this option ?)

and I get this error:
surely due to the fact that I have not configured the spiram

Rebooting...
ESP-ROM:esp32s3-20210327
Build:Mar 27 2021
rst:0xc (RTC_SW_CPU_RST),boot:0x8 (SPI_FAST_FLASH_BOOT)
Saved PC:0x420e4ba6
SPIWP:0xee
mode:DIO, clock div:1
load:0x3fce3808,len:0x44c
load:0x403c9700,len:0xbe4
load:0x403cc700,len:0x2a38
entry 0x403c98d4
E (554) psram: PSRAM ID read error: 0x00ffffff    <<<<<<< error
E (554) spiram: SPI RAM enabled but initialization failed. Bailing out.  <<<<<<<<<<< error
[   570][I][esp32-hal-psram.c:96] psramInit(): PSRAM enabled    OK
E (64) spiram: SPI RAM not initialized  <<<<<<<<<<<< error!!

abort() was called at PC 0x420617a4 on core 1

thank you very much and sorry for the inconvenience

GrazAnt, 2023-08-12:
@valera39
many thanks to you too
now the problem is the configuration of the spiram
which I just don't know, I just started with platformio!!!

valera39, 2023-08-12:
[GrazAnt](https://github.com/GrazAnt)
Read it here #184, #180, Wolle explained in detail

GrazAnt, 2023-08-16:
Thank you all very much but I couldn't manage to compile the code, anyway I have published my project on the case on thingyverse at this address:
https://www.thingiverse.com/thing:6172929
I also wanted to ask to @schreibfaul1 if I can post the github as a construction reference.
thanks

GrazAnt, 2023-10-05:
I'm still struggling, thank you anyway: I want to solve it myself.

GrazAnt, 2023-10-12:
I'm back just to say this:
what is written above about psram, the wires and all the advices are correct and they helped me resolve my problems and learn something new.
Now I have an "almost" perfect internet radio!!!
THANK YOU EVERYONE

Closed 2023-10-12.

Thread 287 (2023-08-24):

Issue only with ESP32-S3-DevKitC-1-N8R2: no Radio Stations found

TubaFonse, 2023-08-24:
Dear Wolle,
maybe you have an idea, why I only get this "Radio"-problem with ESP32-S3-DevKitC-1-N8R2 (WROOM-1)
Flash 8 MB (Quad SPI) and PSRAM 2 MB (Quad SPI).:

23:31:31 WiFI_info:   RSSI is -52 dB
ESP-ROM:esp32s3-20210327
Build:Mar 27 2021
rst:0x1 (POWERON),boot:0x2a (SPI_FAST_FLASH_BOOT)
SPIWP:0xee
mode:DIO, clock div:1
load:0x3fce3808,len:0x44c
load:0x403c9700,len:0xbe4
load:0x403cc700,len:0x2a38
entry 0x403c98d4
[   788][I][esp32-hal-psram.c:96] psramInit(): PSRAM enabled

ESP32 Chip: ESP32-S3
Arduino Version: 2.0.11
ESP-IDF Version: 4.4.4
MiniWebRadio     Version 2.10b Aug 23/2023
ARDUINO_LOOP_STACK_SIZE 8192 words (32 bit)
FLASH size 8388608 bytes, speed 80 MHz
CPU speed 240 MHz
SDMMC speed 20 MHz
TFT speed 40 MHz
PSRAM total size: 2097152 bytes

00:00:00
00:00:00        ***************************
00:00:00        *     MiniWebRadio V2     *
00:00:00        ***************************
00:00:00
00:00:00 setup: ....  Arduino is pinned to core 1
00:00:00 tft_info: .  init ILI9341
00:00:00 setup: ....  Init SD card
00:00:00 setup: ....  SD card found, 15173.0 MB by 15193.5 MB free
00:00:00 setup: ....  seek for stations.csv
00:00:00 setup: ....  stations.csv found
00:00:00 setup: ....  seek for WiFi networks
[  1445][I][WiFiMulti.cpp:84] addAP(): [WIFI][APlistAdd] add SSID: FRITZ!Box7490LF
[  7514][I][WiFiMulti.cpp:114] run(): [WIFI] scan done
[  7515][I][WiFiMulti.cpp:119] run(): [WIFI] 8 networks found
[  7516][I][WiFiMulti.cpp:160] run(): [WIFI] Connecting BSSID: C8:0E:14:0C:93:11 SSID: FRITZ!Box7490LF Channel: 11 (-48)
[  7557][W][WiFiGeneric.cpp:1057] _eventCallback(): Reason: 202 - AUTH_FAIL
[  7635][I][WiFiMulti.cpp:174] run(): [WIFI] Connecting done.
00:00:06 WiFI_info:   Connecting WiFi...
00:00:06 setup: ....  connected to FRITZ!Box7490LF, IP address is 192.168.178.37
00:00:06 ftpServer:   Buffers allocated: 4622 bytes
00:00:06 rtime_info:  Initializing SNTP
00:00:06 rtime_info:  Waiting for system time to be set... (1/10)
23:31:46 rtime_info:  23:31:46
23:31:46 audiotask:   is pinned to core 1
23:31:46 audiotask:   priority is 2
23:31:46 setup: ....  Number of saved stations: 14
23:31:46 setup: ....  current station number: 7
23:31:46 setup: ....  current volume: 21
23:31:46 setup: ....  last connected host: http://192.168.178.24:50002/m/NDLNA/6221.mp3
23:31:46 setup: ....  connection timeout: 500 ms
23:31:46 setup: ....  connection timeout SSL: 2000 ms
23:31:46 action: ...  current volume is 21
[  9770][E][Preferences.cpp:483] getString(): nvs_get_str len fail: station_007 NOT_FOUND
23:31:46 action: ...  switch to station 7
23:31:46 AUDIO_info:  Connect to new host: "http://not_found"
23:31:46 AUDIO_info:  PSRAM found, inputBufferSize: 638965 bytes
23:31:46 AUDIO_info:  buffers freed, free Heap: 171067 bytes
[  9845][E][WiFiGeneric.cpp:1578] hostByName(): DNS Failed for not_found
23:31:46 AUDIO_info:  Request http://not_found failed!
23:31:46 StreamTitle:
23:31:47 WiFI_info:   RSSI is -46 dB
23:31:47 DLNA_info:   SSDP search for media servers started
23:31:51 DLNA_info:   SSDP query discovered 2 media servers
23:31:51 DLNA_info:   connected successfully to 192.168.178.24:50001
23:31:51 DLNA_info:   connected successfully to 192.168.178.29:2869
23:31:51 ftpServer:   Ftp server waiting for connection on port 21
23:32:36 WiFI_info:   RSSI is -51 dB
23:32:37 WiFI_info:   RSSI is -47 dB
23:44:23 WiFI_info:   RSSI is -51 dB
[963208][E][Preferences.cpp:483] getString(): nvs_get_str len fail: station_008 NOT_FOUND
23:47:40 action: ...  switch to station 8
23:47:40 AUDIO_info:  Connect to new host: "http://not_found"
23:47:40 AUDIO_info:  buffers freed, free Heap: 168107 bytes
[963237][E][WiFiGeneric.cpp:1578] hostByName(): DNS Failed for not_found
23:47:40 AUDIO_info:  Request http://not_found failed!
23:47:40 StreamTitle:
[971774][E][Preferences.cpp:483] getString(): nvs_get_str len fail: station_009 NOT_FOUND
23:47:48 action: ...  switch to station 9
23:47:48 AUDIO_info:  Connect to new host: "http://not_found"
23:47:48 AUDIO_info:  buffers freed, free Heap: 168107 bytes
[971799][E][WiFiGeneric.cpp:1578] hostByName(): DNS Failed for not_found
23:47:48 AUDIO_info:  Request http://not_found failed!
23:47:48 StreamTitle:
[978883][E][Preferences.cpp:483] getString(): nvs_get_str len fail: station_010 NOT_FOUND
23:47:55 action: ...  switch to station 10
23:47:55 AUDIO_info:  Connect to new host: "http://not_found"
23:47:55 AUDIO_info:  buffers freed, free Heap: 168107 bytes
[978908][E][WiFiGeneric.cpp:1578] hostByName(): DNS Failed for not_found
23:47:55 AUDIO_info:  Request http://not_found failed!
23:47:55 StreamTitle:

schreibfaul1, 2023-08-25:
Hello TubaFonse,
the problem will be in the NVS. The stations are saved in the NVS. Even if the programm is reloaded, the content of the NVS remains untouched. In Platfornio, please go to the ant on the left and then to Platform/Erase Flash. This will only work if the serial monitor is closed, if necessary, put the monitor in the dustbin first. This will delete all partitions. If you then upload the programme and start it, the empty NVS will be recognised and refilled with the content of stations.csv. I found another error, because this did not work in every case. Please use the current software version.

TubaFonse, 2023-08-26:
Hello Wolle,
many thanks for your quick response and your great work - I used the current software version - and the problem is solved!

Closed 2023-08-26.

Thread 292 (2023-09-01):

Psram error with V2.11

ve2cfb, 2023-09-01:
Hello Wolle,
i was running V2.10C and everything was fine untill i installed the latest V2.11 .
did a comparision with v2.10C but i must have missed something.
Thank very much for your time and by the way, i love the station list, its super easy to use.

Here is the message error:

=================================================================================
---- Opened the serial port COM3 ----
E (1039) psram: PSRAM ID read error: 0xffffffff
[     3][W][esp32-hal-psram.c:71] psramInit(): PSRAM init failed!

ESP32 Chip: ESP32-D0WD-V3
Arduino Version: 2.0.11
ESP-IDF Version: 4.4.4
MiniWebRadio     Version 2.11 Aug 31/2023
ARDUINO_LOOP_STACK_SIZE 8192 words (32 bit)
FLASH size 4194304 bytes, speed 40 MHz
CPU speed 240 MHz
SDMMC speed 80 MHz
TFT speed 80 MHz
PSRAM not found! MiniWebRadio will not work properly!
assert failed: xQueueSemaphoreTake IDF\components\freertos\queue.c:1545 (( pxQueue ))

Backtrace: 0x40084e29:0x3ffc7ad0 0x4008f735:0x3ffc7af0 0x40099afd:0x3ffc7b10 0x40090871:0x3ffc7c40 0x400d7837:0x3ffc7c80 0x400f1336:0x3ffc7ca0 0x400dc424:0x3ffc7cf0 0x4010b575:0x3ffc7d50

ELF file SHA256: e701809e218b501b

---- Opened the serial port COM3 ----
E (1039) psram: PSRAM ID read error: 0xffffffff
[     3][W][esp32-hal-psram.c:71] psramInit(): PSRAM init failed!

ESP32 Chip: ESP32-D0WD-V3
Arduino Version: 2.0.11
ESP-IDF Version: 4.4.4
MiniWebRadio     Version 2.11 Aug 31/2023
ARDUINO_LOOP_STACK_SIZE 8192 words (32 bit)
FLASH size 4194304 bytes, speed 40 MHz
CPU speed 240 MHz
SDMMC speed 80 MHz
TFT speed 80 MHz
PSRAM not found! MiniWebRadio will not work properly!
assert failed: xQueueSemaphoreTake IDF\components\freertos\queue.c:1545 (( pxQueue ))

Backtrace: 0x40084e29:0x3ffc7ad0 0x4008f735:0x3ffc7af0 0x40099afd:0x3ffc7b10 0x40090871:0x3ffc7c40 0x400d7837:0x3ffc7c80 0x400f1336:0x3ffc7ca0 0x400dc424:0x3ffc7cf0 0x4010b575:0x3ffc7d50

Rebooting
==============================================================================
[Compiling V2.11.txt](https://github.com/schreibfaul1/ESP32-MiniWebRadio/files/12498055/Compiling.V2.11.txt)

schreibfaul1, 2023-09-02:
This is a strange error. The PSRAM is recognised before the Setup() is called. So a connection with the new version is unlikely. Is the board really running with an older version? On some boards, the connections between PSRAM and ESP chip are led out and cannot really be used as GPIOs. Maybe one of these pins is contacted after all?

What must not be is the resulting continuous loop and restart. I have now prevented this.

ve2cfb, 2023-09-02:
Hello Wolle,
Just to clarify things...
My three esp32 modules that i have tried are:  ESP-WROOM-32  (ESP32 DEVKIT V1)  4M ram and they are 30 pins modules.
I never had problem before. From your comment, it looks like i have external PSram but its not the case.

Many thanks for your time.... Pierre

ve2cfb, 2023-09-03:
it seem that my ESP32 EROOM does not  have a PSRAM. I tried a WROVER-E (8M PSRAM) and it worked ok.
I still dont know why my previous version did worked.  go figure...

schreibfaul1, 2023-09-04:
Hi @ve2cfb,
in earlier versions many things worked without PSRAM, but now the project is so big that a PSRAM is required. The GPIO2 of the ESP32 is a "strapping pin" I think it has to be grounded at boot time, but the SD card expects a pullup. The pullup is turned on by SW in Setup(). Sometimes the HW pullup is sufficient and the SD_MMC is no longer recognised. ILI9488 is indeed a problem case and does not manage 80MHz in my case. ILI9431, ILI9486 and ST7796 have no problems with 80mHz.

Rich1975, 2023-09-05:
Hi Wolle,
So, as per your last comment does it mean "upgrade your "hard ware" or find a different program",
Would be nice to have the earlier versions for those of us who didnt want those extra bells and whistles and if so how do we get the earlier versions?
Even so, thanks for your efforts, I do appriciate it, it has given me something to think about and looking forward to continuing to be involved in electronics says this old man

valera39, 2023-09-05:
[Rich1975](https://github.com/Rich1975)
Here's version 1.30a
[ESP32-MiniWebRadio-master.zip](https://github.com/schreibfaul1/ESP32-MiniWebRadio/files/12526875/ESP32-MiniWebRadio-master.zip)

Rich1975, 2023-09-05:
Thank you valera39, I will give it a try, about 2 months ago everything seemed to be OK and was getting ready to build an enclosure for it and then it crashed, Thank you again.

valera39, 2023-09-05:
[Rich1975](https://github.com/Rich1975) Please, I still have saved older versions and libraries for the radio

Rich1975, 2023-09-06:
valera39,
Thank you for the link to earlier code, could I trouble you to explain how to use it with PlatfomIO, Here's what I did....1) down load the zip file, 2) extract all, 3) start PlatformIO, 4) Close Folder (because it may be something else,) 6) Click "Open Folder and choose the folder where I had extracted the zipped file. NEXT if I try to Build I get an error [.pio\build\esp32dev\src\main.cpp.o] Error 1.  This is at the top of the screen  MiniWebRadio -- Webradio receiver for ESP32, 2.8 color display (320x240px) and VS1053 MP3 module.  *
//*********************************************************************************************************
//
// first release on 03/2017
// Version 30a, Aug 18/2021
Have I provided enough info and could you help me?

valera39, 2023-09-06:
[Rich1975](https://github.com/Rich1975)
I compiled this version following Wolle's instructions in the additional_info folder.  I compiled it in Arduino IDE and it worked right away. And since the second version I used PlatformIO. Try to use Arduino IDE for the first version, you should definitely succeed, there is nothing complicated, just carefully read the instructions. The version I sent you is the last one that compiles also in Arduino IDE.  The next versions are only in PlatformIO.

MikeF59, 2023-09-23:
hi ,
I tried to compile v. 1.30a from above for esp32 with platformio and I get this error:

src/main.cpp:169:49: error: no matching function for call to 'VS1053::VS1053(int, int, int)'
 VS1053 vs1053(VS1053_CS, VS1053_DCS, VS1053_DREQ);
                                                 ^
In file included from src/main.cpp:77:
.pio/libdeps/esp32dev/ESP32-vs1053_ext/src/vs1053_ext.h:279:5: note: candidate: 'VS1053::VS1053(uint8_t, uint8_t, uint8_t, uint8_t, uint8_t, uint8_t, uint8_t)'
     VS1053(uint8_t _cs_pin, uint8_t _dcs_pin, uint8_t _dreq_pin, uint8_t spi, uint8_t mosi, uint8_t miso, uint8_t sclk);
     ^~~~~~
.pio/libdeps/esp32dev/ESP32-vs1053_ext/src/vs1053_ext.h:279:5: note:   candidate expects 7 arguments, 3 provided
.pio/libdeps/esp32dev/ESP32-vs1053_ext/src/vs1053_ext.h:105:7: note: candidate: 'VS1053::VS1053(const VS1053&)'
 class VS1053 : private AudioBuffer{
       ^~~~~~
.pio/libdeps/esp32dev/ESP32-vs1053_ext/src/vs1053_ext.h:105:7: note:   candidate expects 1 argument, 3 provided

What is a problem, please ? Can You help me ?

Closed 2024-12-08.

Thread 294 (2023-09-03):

Error: Detected a whitespace character in project paths.

peppdiy, 2023-09-03:
When I open the project I got this error:

Processing esp32 (board: ESP32-Dev-4MB; platform: https://github.com/platformio/platform-espressif32.git#v6.3.2; framework: arduino, espidf)
-----------------------------------------------------------------------------------------------------------------------------------------------------------Verbose mode can be enabled via `-v, --verbose` option
CONFIGURATION: https://docs.platformio.org/page/boards/espressif32/ESP32-Dev-4MB.html
PLATFORM: Espressif 32 (6.3.2+sha.eb7eba4) > Espressif ESP32 Dev Module
HARDWARE: ESP32 240MHz, 320KB RAM, 4MB Flash
DEBUG: Current (cmsis-dap) External (cmsis-dap, esp-bridge, esp-prog, iot-bus-jtag, jlink, minimodule, olimex-arm-usb-ocd, olimex-arm-usb-ocd-h, olimex-arm-usb-tiny-h, olimex-jtag-tiny, tumpa)
PACKAGES:
 - framework-arduinoespressif32 @ 2.0.11+sha.ae9dae4
 - framework-espidf @ 3.40404.0 (4.4.4)
 - tool-cmake @ 3.16.4
 - tool-esptoolpy @ 1.40501.0 (4.5.1)
 - tool-idf @ 1.0.1
 - tool-mconf @ 1.4060000.20190628 (406.0.0)
 - tool-ninja @ 1.9.0
 - toolchain-esp32ulp @ 1.23500.220830 (2.35.0)
 - toolchain-xtensa-esp32 @ 8.4.0+2021r2-patch5
Error: Detected a whitespace character in project paths.

peppdiy, 2023-09-03:
Sorry resolved

Closed 2023-09-03.

Thread 300 (2023-09-25):

PSRAM size not printed in Serial Monitor.

ve2cfb, 2023-09-25:
Hello Wolle,

While doing some test, i wanted to check the PSRAM size and to my surprise, nothing is printing for psraminit().
i have a esap32-s3  N16R8
https://www.aliexpress.com/item/1005004617322170.html?spm=a2g0o.order_list.order_list_main.35.2c631802Im0tmz

Here is the output of the Serial Monitor:

---- Opened the serial port COM13 ----
[   993][I][esp32-hal-psram.c:96] psramInit(): PSRAM enab

ESP32 Chip: ESP32-S3
Arduino Version: 2.0.13
ESP-IDF Version: 4.4.5
MiniWebRadio     Version 2.13a Sep 23/2023
ARDUINO_LOOP_STACK_SIZE 8192 words (32 bit)
FLASH size 16777216 bytes, speed 80 MHz
CPU speed 240 MHz
SDMMC speed 40 MHz
TFT speed 40 MHz
**** nothing printed for the psraminit()

in main.cpp at line 1748
   if(psramInit()) { Serial.printf("PSRAM total size: %d bytes\n", esp_spiram_get_size()); }

This might be of interest...

https://docs.espressif.com/projects/esp-idf/en/latest/esp32/migration-guides/release-5.x/5.0/system.html

PSRAM[]
(https://docs.espressif.com/projects/esp-idf/en/latest/esp32/migration-guides/release-5.x/5.0/system.html#psram)

The target-specific header file spiram.h and the header file esp_spiram.h have been removed. A new component esp_psram is created instead. For PSRAM/SPIRAM-related functions, users now include esp_psram.h and set the esp_psram component as a component requirement in their CMakeLists.txt project files.

esp_spiram_get_chip_size and esp_spiram_get_size have been deleted. You should use esp_psram_get_size instead.

Pierre

ve2cfb, 2023-09-25:
Hi Wolle,

Yes the Octal-SPi is already set. No problem with that. By the way, my ESP32-S3 N16R8 work perfectly except for not printing line 1748.
if(psramInit()) { Serial.printf("PSRAM total size: %d bytes\n", esp_spiram_get_size()); }
    else { Serial.printf(ANSI_ESC_RED "PSRAM not found! MiniWebRadio does not work without PSRAM!" ANSI_ESC_WHITE); return;}

I did try my other  "ESP32-DevKitC-VE ESP32-WROVER-E 8MB FLASH" and it print the PSRAM info. Go figure...

Pierre

schreibfaul1, 2023-09-26:
How did you do that? The compiler grumbles with me. Are you already using IDF V5...?
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

ve2cfb, 2023-09-27:
Hello Wolle,

to recap... i am still at idf V4xxx (check my compile output below)
In Config Menu,  Octal-SPi is set.
my code for the paraminit() at line 1748, is the same as  this code:
if(psramInit()) { Serial.printf("PSRAM total size: %d bytes\n", esp_spiram_get_size()); }
i never used ESP_PSRAM_GET_SIZE() because it gives me an error like you.

Right now i am questioning  my project configuration in PIO HOME like "Platform", "Board" etc, etc.
As i3have mentioned before, my other esp32-Wrover 8M psram does print the psram size.

Here is the compile ouput.

------------------------------------------------------------------------------------------------------------------------------------------------Verbose mode can be enabled via `-v, --verbose` option
CONFIGURATION: https://docs.platformio.org/page/boards/espressif32/ESP32-S3-DevKitC-1-N16R8.html
PLATFORM: Espressif 32 (6.4.0+sha.516520f) > Espressif ESP32-S3-DevKitC-1-N16R8V (16 MB QD, 8MB PSRAM)
HARDWARE: ESP32S3 240MHz, 320KB RAM, 16MB Flash
DEBUG: Current (esp-builtin) On-board (esp-builtin) External (cmsis-dap, esp-bridge, esp-prog, iot-bus-jtag, jlink, minimodule, olimex-arm-usb-ocd, olimex-arm-usb-ocd-h, olimex-arm-usb-tiny-h, olimex-jtag-tiny, tumpa)
PACKAGES:
 - framework-arduinoespressif32 @ 2.0.13+sha.16668c7
 - framework-espidf @ 3.40405.230623 (4.4.5) <<<<<<<<<<<<<<<<<<<<<<<<<<<<<<<<<<<<<<<<<<
 - tool-cmake @ 3.16.4
 - tool-esptoolpy @ 1.40501.0 (4.5.1)
 - tool-idf @ 1.0.1
 - tool-mconf @ 1.4060000.20190628 (406.0.0)
 - tool-ninja @ 1.9.0
 - toolchain-esp32ulp @ 1.23500.220830 (2.35.0)
 - toolchain-riscv32-esp @ 8.4.0+2021r2-patch5
 - toolchain-xtensa-esp32s3 @ 8.4.0+2021r2-patch5

??????????????????????????????????????????????????????????????????
Warning! Arduino framework as an ESP-IDF component doesn't handle the `variant` field! The default `esp32` variant will be used.
?????????????????????????????????????????????????????????????????

Reading CMake configuration...
LDF: Library Dependency Finder -> https://bit.ly/configure-pio-ldf
LDF Modes: Finder ~ chain, Compatibility ~ soft
Found 45 compatible libraries
Scanning dependencies...
Dependency Graph
|-- ESP32-vs1053_ext @ 1.0.10+sha.b61dab0
|-- ESP32-audioI2S-master @ 2.0.0+sha.3f64031
|-- Arduino_JSON @ 0.2.0+sha.c282cb6
|-- FFat @ 2.0.0
|-- SPIFFS @ 2.0.0
|-- WiFiClientSecure @ 2.0.0
|-- ac101
|-- es8388
|-- ftpsrv
|-- IR-Remote-Control
|-- rtime
|-- SoapESP32 @ 1.1.5
|-- tftLib
|-- websrv
|-- wm8978
|-- ESPmDNS @ 2.0.0
|-- FS @ 2.0.0
|-- Preferences @ 2.0.0
|-- SD_MMC @ 2.0.0
|-- SPI @ 2.0.0
|-- Ticker @ 2.0.0
|-- WiFi @ 2.0.0
|-- Wire @ 2.0.0
Building in release mode
Running menuconfig...
[0/1] cmd.exe /C "cd /D C:\Users\Pierre\Documents\PlatformIO\ESP32-Min...erre/Documents/PlatformIO/ESP32-MiniWebRadio-V2.13A/sdkconfig.esp32s3"
C:/Users/Pierre/.platformio/packages/framework-espidf/Kconfig:14: warning: IDF_ENV_FPGA has 'option env="IDF_ENV_FPGA"', but the environment variable IDF_ENV_FPGA is not set
Loaded configuration 'C:/Users/Pierre/Documents/PlatformIO/ESP32-MiniWebRadio-V2.13A/sdkconfig.esp32s3'
No changes to save (for 'C:/Users/Pierre/Documents/PlatformIO/ESP32-MiniWebRadio-V2.13A/sdkconfig.esp32s3')
======================================================== [SUCCESS] Took 168.89 seconds

Environment    Status    Duration
-------------  --------  ------------
esp32s3        SUCCESS   00:02:48.887
========================================================= 1 succeeded in 00:02:48.887

Many thanks for your time.
Pierre

ve2cfb, 2023-09-28:
Hello Wolle,

i found a work around and now it does print the psram info on the Serial monitor.
i did a serial.printf just before the psramint() .
I dont know why it is working.

I got the infor from Espressif:
https://espressif-docs.readthedocs-hosted.com/projects/esp-faq/en/latest/software-framework/storage/psram.html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,for%20memory%20allocation%20and%20management.

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

This is my esp32-s3 Wroom-1  N16R8

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

Pierre

schreibfaul1, 2023-09-29:
Hello Pierre,
changed the order now, it doesn't matter for my boards, hope it works for you.
Soon will  Arduino V3... with IDF V5...  appear, then your suggestion from the first post takes effect.

many greetings Wolle

ve2cfb, 2023-09-30:
Hello Wolle,
everything is ok now with 2.13B
here is a Serial Monitor ouput...

ESP32 Chip: ESP32-S3
Arduino Version: 2.0.13
ESP-IDF Version: 4.4.5
MiniWebRadio     Version 2.13b Sep 29/2023
ARDUINO_LOOP_STACK_SIZE 8192 words (32 bit)
FLASH size 16777216 bytes, speed 80 MHz   <<<<<<<<<<<<<<<<<<<<<<<<<<<<<<<<<<<<<<<<
CPU speed 240 MHz
SDMMC speed 40 MHz
TFT speed 40 MHz
PSRAM total size: 8388608 bytes   <<<<<<<<<<<<<<<<<<<<<<<<<<<<<<<<<<<<<<<<<<<<<<<

00:00:00
00:00:00        ***************************
00:00:00        *     MiniWebRadio V2     *
00:00:00        ***************************
00:00:00
00:00:00 setup: ....  Arduino is pinned to core 1
00:00:00 tft_info: .  init ILI9488
00:00:00 setup: ....  Init SD card
00:00:00 setup: ....  SD card found, 9522.6 MB by 15240.0 MB free
00:00:01 setup: ....  seek for stations.csv
00:00:01 setup: ....  stations.csv found
00:00:01 setup: ....  seek for WiFi networks

========================================================================

Again, many many thanks.
Pierre

ve2cfb, 2023-10-03:
Closing

Closed 2023-10-03.

Thread 308 (2023-10-20):

feature request > BLUETOOTH SPEAKER

clear-sky, 2023-10-20:
Hi dear wolle!
all esp32 cores have bluetooth i am wondering why anyone does not have any plan to use it!
in this project adding bluetooth speaker does not need additional hardware only needed software
what is your opinion?

trench29, 2023-10-22:
Hi! I would also be happy about the bluetooth extension. Currently I use two different music devices for playback. An internetradio and a bluetooth speaker. If both functions can be combined into the ESP32-MiniWebRadio, then I would only need one device. That would be great! :)

kerat71, 2023-10-25:
+1

steve6375, 2023-10-25:
I think esp32 has a limitation in that you can have WiFi or Bluetooth but not both.
If this is the case then only playing of media files from flash drive via Bluetooth would be possible?

clear-sky, 2023-10-26:
Hi dear steve6375!
no problem if that limitation exist!
in bluetooth speaker mode no need to wifi and in wifi radio mode no need to bluetooth
but this is not possible to play wifi radio (or mp3 file) and send it to another bluetooth speaker
if you know edzelf he has solved this problem with an external bluetooth sender!
https://github.com/Edzelf/ESP32Radio-V2

schreibfaul1, 2023-10-28:
It's not that easy, and there are some limitations
- the ESP32-S3 can't do BT classic
- it doesn't work with a VS1053 board
- I would have to lock the IRAM functionality for WiFi and LWIP, because much IRAM has to be reserved for BT
- the project already needs so much flash memory that BT doesn't fit in 4MB anymore

clear-sky, 2023-10-29:
Hi dear wolle !
 the facts that you said means that is impossible!
**thanks with respect**

schreibfaul1, 2023-10-29:
This is not impossible. The flash is now filled to 80%, with BT classic 105% is needed. That functions then only with 8MB. Wait and see what is needed with IDF5.1.

clear-sky, 2023-10-29:
Hi dear wolle!
this is only a suggest
you can add additional patch for some users that can use it - for example BT classic for esp32 with 8 or 16 Mb flash

valera39, 2023-10-29:
Dear Wolle!
I think bluetooth is a completely unnecessary feature. It would be better to further develop and improve the media player and full DLNA support
Thank you for your hard work.

schreibfaul1, 2023-11-03:
For the ESP32 I have implemented BT as A2DP Sink (BT Speaker). To get the necessary flash memory I deactivated the Ethernet function (in menuconfig). I don't think anyone will use an Ethernet adapter. The ESP32-S3 does not offer BT Classic, only BLE. BLE from V5.2 can support audio but is currently not supported by Espressif. The extension is in the Arduino V3.0 branch. Several symbols must be copied to the SD card, it is best to replace the entire contents of the btn and common folders.

The BT connection must always be established from the audio source. The first BT connection requires a PIN, the default PIN is 1234.

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
If the connection is successful, the logo changes from silver to gold. 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
If metadata is transmitted, ARTIST and TITLE are extracted from it and shown on the display.
The functions of the buttons on the left and right depend on the application of the audio source and can therefore vary. The orange bars in the footer indicate the BT signal strength. BT is currently not supported via the website.

clear-sky, 2023-11-04:
Hi dear wolle!
thanks for your great work-this project is going to be famous for all over the world!
unfortunately i am on esp32-s3 and can not test and most wait for 5.2!
on the other hand is any good news form usb host for esp32-s3?
_thanks with respect_

Arne65, 2023-11-10:
Hallo Wolle

ich habe das auf einem  ESP32-DevKitC-VIE  (Arduino 3.0) probiert den BT SD Container auf die SD Karte soweit so gut.

Ich bekomme aber keine BT Verbindung zu Stande an meinem Endgerät (IPhone) müsste doch eigentlich der esp zu sehen sein .Oder ? Da die Kopplung ja vom Endgerät aus geht.

Was mache ich falsch ? Oder habe ich das was grundlegend falsch verstanden .

schreibfaul1, 2023-11-10:
Eigentlich nichts. Wenn du den BT Modus geöffnet hast und das Logo silbern ist wird ein "Advertising" gestartet. Dein Smartphone wird dann das neue Gerät als "MiniWebRadio" erkennen. Bei der Kopplung wird eine Pin (1234) verlangt. Wenn das Gerät gekoppelt ist, wechselt das Logo auf Gold.
Ich habe das mit verschiedenen Smartphones, einem Tablet und einem Linux-PC getestet. Das hat immer funktioniert.

Arne65, 2023-11-10:
Ich glaube mein Problem liegt an dem BT Modus .Ich habe auf dem Display nirgendwo einen Button um um den zu starten .Wie komme ich denn da hin .

Danke für deine schnelle Antwort und Mega Respekt für deine  großartigen arbeitet die du hier leistest.

schreibfaul1, 2023-11-10:
Ich denke, der wird da sein, du siehst ihn nur noch nicht. Ich habe für BT einen neuen Button gebraucht. Lade bitte von der Conten_on_SD_Card.zip die Symbole auf die SD Karte. Da das mehrere sind, ist es besser den ganzen btn und common Ordner zu kopieren.
Dann kannst du auch vom Touchscreen die Quelle steuern. Z.B.mit dem VLC Player funktioniert das, Einzel oder Doppelklick (ausprobieren)

Arne65, 2023-11-10:
Die beiden Ordner inclusive der BT Button sind alle auf der SD Karte hatte die zip unter dem Arduino Zweig geladen und auf die Karte gepackt

Arne65, 2023-11-10:
Allerdings sind in dem ZIP Ortner nur grüne Blau und rot
Silber und Gold Abt Button sind da nicht

Arne65, 2023-11-10:
Sorry unter Common sind die da

schreibfaul1, 2023-11-10:
Hab eben nochmal geguckt. Die sind da. z.B. BTnc.jpg und BT.jpg sind die Logos.
Das ist nicht die zip aus dem Master, du benötigst die aus dem Branch ArduinoB3.0

Arne65, 2023-11-10:
Ja die aus dem Branch Arduino-V3.0 habe ich da sind ja auch alle Button und auch BT RSSI

komisch ist eigentlich sollte ja auch unten der BT RSSI Indikator sein der auch nicht da ist .

Den Code habe ich aus dem Arduino 3.0 Branch das ist doch sicher richtig

schreibfaul1, 2023-11-10:
Absolut, das ist merkwürdig. Der entscheidende Button ist BT_Green.jpg
Der sollte kommen wenn du das Display 2x berührst, rechts neben der Lampe für die Helligkeit

Arne65, 2023-11-10:
Hmm also rechts neben Helligkeit passiert nichts

rechts neben Station List bekomme ich invalid Button 6 /7/8 aber ich denke das wird normal sein eventuell als Platzhalter für weitere Button

Arne65, 2023-11-10:
Wenn ich ganz rechts neben Helligkeit 2 X tippe

stürzt der ESP ab

Guru Meditation Error: Core  1 panic'ed (LoadProhibited). Exception was unhandled.

Core  1 register dump:
PC      : 0x4008cf59  PS      : 0x00060f30  A0      : 0x800d5161  A1      : 0x3ffd0150
A2      : 0x0ef65020  A3      : 0x0ef6501c  A4      : 0x000000ff  A5      : 0x0000ff00
A6      : 0x00ff0000  A7      : 0xff000000  A8      : 0x00000000  A9      : 0x3ffd0110
A10     : 0x3ffba414  A11     : 0x3ffba414  A12     : 0x00000004  A13     : 0x00060d23
A14     : 0x00060d23  A15     : 0x00000001  SAR     : 0x00000007  EXCCAUSE: 0x0000001c
EXCVADDR: 0x0ef65020  LBEG    : 0x4008cf59  LEND    : 0x4008cf69  LCOUNT  : 0xffffffff

Backtrace: 0x4008cf56:0x3ffd0150 0x400d515e:0x3ffd0160 0x400d59a0:0x3ffd0180 0x400d5a01:0x3ffd01a0 0x400d6fde:0x3ffd01e0 0x400dc13a:0x3ffd0200 0x4011b4fe:0x3ffd0220 0x400dce7f:0x3ffd0240 0x4012ec69:0x3ffd02a0

  #0  0x4008cf56:0x3ffd0150 in ?? ??:0
  #1  0x400d515e:0x3ffd0160 in ?? ??:0
  #2  0x400d59a0:0x3ffd0180 in ?? ??:0
  #3  0x400d5a01:0x3ffd01a0 in ?? ??:0
  #4  0x400d6fde:0x3ffd01e0 in ?? ??:0
  #5  0x400dc13a:0x3ffd0200 in ?? ??:0
  #6  0x4011b4fe:0x3ffd0220 in ?? ??:0
  #7  0x400dce7f:0x3ffd0240 in ?? ??:0
  #8  0x4012ec69:0x3ffd02a0 in ?? ??:0

ELF file SHA256: 6b5c93e3fbf846fd

Rebooting...
ets Jul 29 2019 12:21:46

schreibfaul1, 2023-11-10:
Okay, dann setzt das Board nicht CONFIG_IDF_TARGET_ESP32
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
wird bei dir die untere Zeile aktiv sein. Du hast bestimmt das 8MB board in platformio ausgewählt. Wenn das so ist, nimm mal bitte das 4MB Board

Arne65, 2023-11-10:
Hab das dann mal mit 4MB Board probiert abstützen tut er jetzt nicht aber wie schon schrieb passiert da rechts neben Helligkeit  leider nichts

schreibfaul1, 2023-11-10:
Ich habe keine weitere Idee. Es wird nur zwischen ESP32 und ESP32-S3 unterschieden. Ist es ein ESP32 wird der BT Button angezeigt. Bevor du weiter suchst, würde ich den Ordner löschen, das Repository mit VS Code neu klonen , den Arduino Branch links unten auswählen und die Einstellungen in common.h neu setzen.

Arne65, 2023-11-11:
Habe dann nochmal neu  gemacht und siehe da es läuft perfekt.

Vielen Dank
 Eine  kleine Frage die betrifft aber nicht BT.

Könntest Du die vorstellen MQTT zu integrieren ?

Closed 2023-10-29.

Thread 310 (2023-10-23):

Feature request for Play all files and Random.

ve2cfb, 2023-10-23:
Hello Walle,

Your files listing is  working  very good and the play all files is also great.
I did a basic test to see if i was able to have the RANDOM feature when playing all files but  i am still looking in the Button section and
 i'm not an expert yet..

Here is the code... starting at line 2287 in main.cpp
==================================================================
    if(!_f_playAllFiles) {
        if(audioFile) audioFile.close(); // maybe audioFile contains old data

        _cur_AudioFileNr = random(0 , _SD_content.size()); //====================  Added
        _curAudioFolder = folderPath;
        _cur_AudioFileNr = random(0 , _SD_content.size()); //====================  Added

        _f_playAllFiles = true;
        changeState(PLAYERico);
        showVolumeBar();
===================================================================

In the "Audio player" menu, it would be nice to add an extra "random button" and possibly make the "random button " and the "play all file button" like a latch button  (Red or Green).

Thanks for your time and have a nice day.... Pierre

steve6375, 2023-10-23:
Actually we do not want a random feature - we want a random shuffle (sort) feature.

If random is used then it could play the same song twice consecutively (A H **J J** G D) or more frequently - e.g.  **A** H J **A** S K **A**

I believe the same thing happened with early MP3 players. The users asked for a random feature but then they complained because it would often play the same tune twice or too often - what they really wanted was a random shuffle feature.

ve2cfb, 2023-10-23:
Very interesting. I did notice that especially on small number of files, the song came more often.
Is it possible to integrate this feature in MiniWebRadio... ?

Many thanks for the info.

hengist60, 2023-10-24:
I think the issue here is that generating a sequence of random numbers where there is no restriction on the likelihood of the same number reappearing more than once (“sampling with replacement”) is relatively easy (technique first developed by Bletchley Park codebreakers post WWII).  But for “sampling without replacement”, the algorithm needs to somehow keep a record of what has already been sampled and prevent it appearing in the ‘random sequence’ again.

Such “shuffling” is  commonly required  in statistical packages and  - as I understand it - this is usually done by having a second vector of “weights”: initially a vector of 1s. Once sampled an “observation” (in this case a musictrack) is given a weight of 0 which is then used to prevent it appearing in the ‘shuffled vector” again (eg. https://www.rdocumentation.org/packages/base/versions/3.6.2/topics/sample). With an Arduino Mega I already use https://github.com/pmjdebruijn/Arduino-Entropy-Library/blob/master/Entropy.h  which works much better than the Arduino random()  as a MP3 player “random track generator” but I don’t care about the same track appearing more than once.

ve2cfb, 2023-10-24:
Hello Jon,
Thanks for the info. i will do some research and basic test with entropy.
I like what you said  **_"but I don’t care about the same track appearing more than once"_**
In my case, all my MP3 directory on the SD Card contain at least 50 mp3 files each, so it is not a big deal if one song is played again. To be followed...

Random was only a initial test but my other concern was the following... i beleive it can reduce the number of operations.
One drawback, is when you either power on the unit or switch from Radio Mode to Audio Mode, you are pointing to the same music directory. That is OK but if i want to chage my directory, i have to flip back and forth .

Hope my text will explain a bit better....

- 1- from the **_Internet Radio_** Menu, go to **_Audio Player_** menu.
- 2- Add an extra **_random/shuffle button_**
- 3- make **_play_all button_** and **_random button_**  only latchable with blue/red color. Simple switch.
- 4- Then, when going to **_file list button_** , we can change to a new mp3 directory, pick a mp3 song, and automaticlly it goes  back to playing the song in **_random/shuffle mode_** or **_all files mode_**.

**Many thanks to Wolle and all the others who help in building and participating in this wonderful project.**

Pierre

steve6375, 2023-10-25:
https://cpp.hotexamples.com/examples/-/-/playlist_shuffle/cpp-playlist_shuffle-function-examples.html

schreibfaul1, 2023-10-26:
Hi,
I have implemented the function, but currently not in the master, but in the branch Arduino-V3. For testing, it is not enough to select the branch in VS Code, new symbols must also be copied to the SD card, player.gif and Button_Shuffle_Blue[Yellow]. jpg

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

ve2cfb, 2023-10-26:
Hello Wolle,
Super...
 Thank you very much.

Closed 2023-10-26.

Thread 313 (2023-11-11):

Issue with ESP32-S3-WROOM-1 N16R8

JozefKc, 2023-11-11:
Hi,
I am a newbee in Platformio a I would like to ask you about this problem:
I tried to programm actual version of the radio on **ESP32-S3-WROOM-1 with N16R8** and received this:

**Display:**
WiFi credentials are not correct
Accesspoint IP:
192.168.4.1

**Terminal:**
ESP-ROM:esp32s3-20210327
Build:Mar 27 2021
rst:0x1 (POWERON),boot:0x8 (SPI_FAST_FLASH_BOOT)
SPIWP:0xee
mode:DIO, clock div:1
load:0x3fce3808,len:0x44c
load:0x403c9700,len:0xbe4
load:0x403cc700,len:0x2a68
entry 0x403c98d4
E (518) psram: PSRAM ID read error: 0x00ffffff, PSRAM chip not found or not supported, or wrong PSRAM line mode
E (518) spiram: SPI RAM enabled but initialization failed. Bailing out.
 [0;32m[   539][I][esp32-hal-psram.c:96] psramInit(): PSRAM enabled [0m
 [0;32m[  1190][I][WiFiMulti.cpp:84] addAP(): [WIFI][APlistAdd] add SSID: -3- [0m
 [0;32m[  1203][I][WiFiMulti.cpp:84] addAP(): [WIFI][APlistAdd] add SSID: -1- [0m
 [0;32m[  1204][I][WiFiMulti.cpp:84] addAP(): [WIFI][APlistAdd] add SSID: -3- [0m
 [0;32m[  8291][I][WiFiMulti.cpp:114] run(): [WIFI] scan done [0m
 [0;32m[  8292][I][WiFiMulti.cpp:119] run(): [WIFI] 14 networks found [0m
 [0;32m[  8293][I][WiFiMulti.cpp:160] run(): [WIFI] Connecting BSSID: F0:79:59:D1:25:4C SSID: -3- Channel: 13 (-45) [0m
 [0;33m[ 11438][W][WiFiGeneric.cpp:1061] _eventCallback(): Reason: 15 - 4WAY_HANDSHAKE_TIMEOUT [0m
 [0;31m[ 13336][E][WiFiMulti.cpp:187] run(): [WIFI] Connecting Failed (6). [0m
 [0;33m[ 13387][W][WiFiGeneric.cpp:1061] _eventCallback(): Reason: 8 - ASSOC_LEAVE [0m
Guru Meditation Error: Core  1 panic'ed (StoreProhibited). Exception was unhandled.

I tried to connect to the -3- or -1- network with the correct password - result is: not connected.
I use ILI9341 display with SPI v1.2 and touch HSD028309 E4. Display works fine, but the touch does not - reacts on some touches,
but only in some places and the system after some touches makes a reset...

Now I do not know how to solve this. I will be grateful for any advice.

Jozef

P.S.: I tried to make a simple programm to get time from NTP trough my Wifi - everything worked fine....

Arne65, 2023-11-11:
Hallo

Did you change the PSRAM to octo under menuconfig?

JozefKc, 2023-11-11:
Sorry. Which file file it is? I did not change it.

Arne65, 2023-11-11:
The esp32s3 16R8 has a different PSRAM, which you have to adjust under menuecofig. Check here

issues PSRAM size not printed in Serial Monitor. #300

In platformio.ini it says at the bottom under *1 how you get to the relevant point.

Since your PSRAM is not recognized, this could possibly be your problem. You have to switch it to octal.

JozefKc, 2023-11-11:
In ESP32-S3-DevKitC-1-N16R8.json is **opi**:

 "build": {
    "arduino":{
      "ldscript": "esp32s3_out.ld",
      "partitions": "default_16MB.csv",
      "memory_type": "qio_opi"
    },
    "core": "esp32",
    "extra_flags": [
      "-DARDUINO_ESP32S3_DEV",
      "-DBOARD_HAS_PSRAM",
      "-DARDUINO_USB_MODE=1",
      "-DARDUINO_USB_CDC_ON_BOOT=1"
    ],
    "f_cpu": "240000000L",
    "f_flash": "80000000L",
    "flash_mode": "qio",
    "psram_type": "**opi**",
    "hwids": [
      [
        "0x303A",
        "0x1001"
      ]
    ],
    "mcu": "esp32s3",
    "variant": "esp32s3"
  },
  "connectivity": [
    "wifi",
    "bluetooth"
  ],
  "debug": {
    "default_tool": "esp-builtin",
    "onboard_tools": [
      "esp-builtin"
    ],
    "openocd_target": "esp32s3.cfg"
  },
  "frameworks": [
    "arduino",
    "espidf"
  ],
  "name": "Espressif ESP32-S3-DevKitC-1-N16R8V (16 MB QD, 8MB PSRAM)",
  "upload": {
    "flash_size": "16MB",
    "maximum_ram_size": 327680,
    "maximum_size": 16777216,
    "require_upload_port": true,
    "speed": 921600
  },
  "url": "https://docs.espressif.com/projects/esp-idf/en/latest/esp32s3/hw-reference/esp32s3/user-guide-devkitc-1.html",
  "vendor": "Espressif"
}

**and in platformio.ini:**

        env:esp32]
        board_build.partitions = miniwebradio4MB.csv    ; 4MB Flash
        ;board_build.partitions = miniwebradio8MB.csv    ; 8MB Flash
        ;board_build.partitions = miniwebradio16MB.csv   ; 16MB Flash
        board = ESP32-Dev-4MB                   ; 4MB Flash  *2)
        ;board = ESP32-Dev-8MB                   ; 8MB Flash  *2)
        ;board = ESP32-Dev-16MB                  ;16MB Flash  *2)
build_flags =
        -DCORE_DEBUG_LEVEL=3                    ; 0 None, 1 Error, 2 Warn, 3 Info, 4 Debug, 5 Verbose
        -DCONFIG_ARDUHAL_LOG_COLORS
        -DBOARD_HAS_PSRAM
        -DCONFIG_IDF_TARGET_ESP32
        -DARDUINO_RUNNING_CORE=1                ; Arduino Runs On Core (setup, loop)
        -DARDUINO_EVENT_RUNNING_CORE=1          ; Events Run On Core
build_unflags =
        -DCONFIG_IDF_TARGET_ESP32S3
        -Wall
        -Wextra
        -DARDUINO_RUNNING_CORE                  ; Arduino Runs On Core (setup, loop)
        -DARDUINO_EVENT_RUNNING_CORE

[env:esp32s3]
        ;board_build.partitions = miniwebradio4MB.csv    ;  4MB Flash
        ;board_build.partitions = miniwebradio8MB.csv    ;  8MB Flash
        board_build.partitions = miniwebradio16MB.csv   ; 16MB Flash

        ;board = esp32-12k                      ;  4MB Flash, 8MB quad PSRAM
        ;board = ESP32-S3-DevKitC-1-N8R2        ;  8MB Flash, 2MB quad PSRAM
        ;board = ESP32-S3-DevKitC-1-N8R8        ;  8MB Flash, 8MB octo PSRAM  *1)
        **board = ESP32-S3-DevKitC-1-N16R8       ; 16MB Flash, 8MB octo PSRAM  *1)**

Arne65, 2023-11-11:
you have to change the PSRAM to octal under run menueconfig

JozefKc, 2023-11-12:
Many thanks for your help. I finally found what it was. I had a bit of a problem with how to switch between quad and oct, but in the end I don't even know how to switch. After saving, translating and uploading, the radio is running, but I have to solve the problems with the touch surface and the distortion of the icons in the lower part of the screen. But all problems will be solved gradually.
If anyone needs it, I am sending the json configuration for ESP32-S3-WROOM1-N16R8 in the following comment.
Many thanks again.

JozefKc, 2023-11-12:
File for **ESP32-S3-WROOM1-N16R8** named as ESP32-S3-DevKitC-1-N16R8.json:

{
  "build": {
    "arduino":{
      "ldscript": "esp32s3_out.ld",
      "partitions": "default_16MB.csv",
      "memory_type": "qio_opi"
    },
    "core": "esp32",
    "extra_flags": [
      "-DARDUINO_ESP32S3_DEV",
      "-DBOARD_HAS_PSRAM",
      "-DARDUINO_USB_MODE=1",
      "-DARDUINO_USB_CDC_ON_BOOT=1"
    ],
    "f_cpu": "240000000L",
    "f_flash": "80000000L",
    "flash_mode": "qio",
    "psram_type": "opi",
    "hwids": [
      [
        "0x303A",
        "0x1001"
      ]
    ],
    "mcu": "esp32s3",
    "variant": "esp32s3"
  },
  "connectivity": [
    "wifi",
    "bluetooth"
  ],
  "debug": {
    "default_tool": "esp-builtin",
    "onboard_tools": [
      "esp-builtin"
    ],
    "openocd_target": "esp32s3.cfg"
  },
  "frameworks": [
    "arduino",
    "espidf"
  ],
  "name": "Espressif ESP32-S3-DevKitC-1-N16R8V (16 MB QD, 8MB PSRAM)",
  "upload": {
    "flash_size": "16MB",
    "maximum_ram_size": 327680,
    "maximum_size": 16777216,
    "require_upload_port": true,
    "speed": 921600
  },
  "url": "https://docs.espressif.com/projects/esp-idf/en/latest/esp32s3/hw-reference/esp32s3/user-guide-devkitc-1.html",
  "vendor": "Espressif"
}

Arne65, 2023-11-12:
This is my configuration in common.h for the ILI9341 display.

#define DECODER                      1                          
#define TFT_CONTROLLER         0                    
#define DISPLAY_INVERSION    0                       
#define TFT_ROTATION              3                       
#define TFT_FREQUENCY          40000000               
#define TP_VERSION                1                      
#define TP_ROTATION              1                       
#define AUDIOTASK_CORE       0                       
#define AUDIOTASK_PRIO        2   

You can also use TFT FREQUENCY 27000000

For me, the ILI9341 with the above configuration works very quickly and without any problems

JozefKc, 2023-11-14:
Radio works. The main problem now is that the touch is inverted - it means that buttons showed at the bottom do react by touching the on the upper side of the screen. And rotation does not help, because I need mirroring of touch by x - axe or y-axe. Any one of this would help. I can not find where to change it /looking for the lib for TP-sensing or somewhere else/. Any sugestion?
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

steve6375, 2023-11-14:
https://github.com/schreibfaul1/ESP32-MiniWebRadio/issues/313#issuecomment-1807207290

So these TP settings don't work with same TFT_ROTATION setting?

valera39, 2023-11-14:
[JozefKc](https://github.com/JozefKc) Try various combinations of tft_rotation and tp_rotation, I had the same problem

JozefKc, 2023-12-02:
Rotation does not help. Problem solved:
in tft.cpp you have to modify row nr.4920 in that way:

//-------------------------------------------------------------
    if (TP_vers == 2) {  // 320px x 240px
        if (_rotation == 0) {
            ;  // do nothing
        }
        if (_rotation == 1) {
            **tmpxy = x;
            x = y;
            y = tmpxy;**
            if (x > HX8347D_HEIGHT - 1) x = 0;
            if (y > HX8347D_WIDTH - 1) y = 0;
        }
        if (_rotation == 2) {
            x = HX8347D_WIDTH - x;
            y = HX8347D_HEIGHT - y;
            if (x > HX8347D_WIDTH - 1) x = 0;
            if (y > HX8347D_HEIGHT - 1) y = 0;
        }
        if (_rotation == 3) {
            tmpxy = y;
            y = x;
            x = HX8347D_HEIGHT - tmpxy;
            if (x > HX8347D_HEIGHT - 1) x = 0;
            if (y > HX8347D_WIDTH - 1) y = 0;
        }
    }

JozefKc, 2024-01-03:
If you use **ILI9341 with touch** /https://www.aliexpress.com/item/1005005378490219.html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 , this display is compatible with **HX8347D** touch driver. It's orientation is a bit strange. For the correct use I had to define it in **common.h** :
#define TFT_CONTROLLER      0                               // (0)ILI9341, (1)HX8347D, (2)ILI9486a, (3)ILI9486b, (4)ILI9488, (5)ST7796, (6)ST7796RPI
#define DISPLAY_INVERSION   0                               // (0) off (1) on
#define TFT_ROTATION        3                               // 1 or 3 (landscape)
#define TFT_FREQUENCY       40000000                        // 80000000, 40000000, 27000000, 20000000, 10000000
#define TP_VERSION          2                               // (0)ILI9341, (1)ILI9341RPI, (2)HX8347D, (3)ILI9486, (4)ILI9488, (5)ST7796, (3)ST7796RPI
#define TP_ROTATION         3                               // 1 or 3 (landscape)

and in **tft.cpp** starting row 4920:

    //-------------------------------------------------------------
    if (TP_vers == 2) {  // 320px x 240px
        if (_rotation == 0) {
            ;  // do nothing
        }
        if (_rotation == 1) {
            tmpxy = x;
            x = y;
            y = tmpxy;
            if (x > HX8347D_HEIGHT - 1) x = 0;
            if (y > HX8347D_WIDTH - 1) y = 0;
        }
        if (_rotation == 2) {
            x = HX8347D_WIDTH - x;
            y = HX8347D_HEIGHT - y;
            if (x > HX8347D_WIDTH - 1) x = 0;
            if (y > HX8347D_HEIGHT - 1) y = 0;
        }
        if (_rotation == 3) {
          tmpxy = x;
          x = HX8347D_HEIGHT - y;
          y = HX8347D_WIDTH - tmpxy;
          if(x > HX8347D_HEIGHT - 1) x = 0;
          if(y > HX8347D_WIDTH - 1) y = 0;
        }
    }

Closed 2025-03-01.

Thread 315 (2023-11-21):

Problems with ESP32 DevKit Board

ovidiu169, 2023-11-21:
Hello Wolle !

I am trying hardly to reproduce your magnificent MiniWebRadio. It is a masterpiece of programming !
I used for the first time Platformio IDE. I've been documented a lot about this complex platform, but I am still a newbee...
So... I tried to use one of already bought ESP boards - PLUSIVO E 32 - made in China, of course. This is a ESP32 DEVKIT 1 mainly, with a flash of 4 M.
After many attempts I succeed to initiate the program(with no "SD Card Mount failed" message). As I saw already this not possible without pulling resistor on D0(10K). Why ? I don't know !... You said "no pull-up resistors on SD Card". This doesn't work for me.
I reduced the frequency on the card to 40000000, but still not working without pull-up resistor.
In the next stage of my "experiments" I tried to control the radio using touch screen(ILI9341). No way , because the virtual buttons doesn't appear on the screen !
Taking into consideration that it would be possible to not have enough PSRAM (or isn't detected) I mounted a push button in series with the pull-up resistor on the SD card. The operation became like that:
- First I press the button and connect power supply;
- after the program initialize and the image on the screen is dowloaded, I release the button
- Touch the superior part of the screen, the base line appear;
- touch with a pen "invisible" buttons and select the stations, volume, etc...
It's like "hide and seek" , but it's all I got. I tried different boards - ESP32 DevKit C, ESP32 WROOM 32 D... The result is the same.
I ordered a ESP32-DEVKIT C-1-N8R8 which has to come today. It is my final try.
Also, I did not succeed to find and open the MiniWebRadio app in internet. I searched everywhere in the Community Radio Browser, and also I searched through/using the IP Address displayed on the bottom of the screen(in Chrome) but no result.
I would be very grateful If You will be more explicit in using these metods of controlling the Radio...
Thank You in advance !!!

schreibfaul1, 2023-11-21:
Hello @ovidiu169, it looks like there are two basic problems:
1) SD card
The SD card is operated as SD_MMC, connected as in the circuit diagram, i.e. all pins of the SD are connected directly to the ESP32. If you use a card adapter, e.g. of the display, there are certainly series or parallel resistors. These must be removed. I assume you have the "red" display, in which case the resistors R1, R2 and R3 are short-circuited or replaced by bridges.
2)PSRAM
A value greater than or equal to 2MB should be displayed in the log after booting.
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
If you are using the ESP32-S3 N8R8, the connection must be set to "octal" in menuconfig. Otherwise you will have a "reboot loop"

ovidiu169, 2023-11-21:
Thank you for your quick response!
Yes, I have the “red” display, indeed. But I did not used the socket on it, I conected the SD card adapter separately to GPIO 2, 15,14,3v3 and ground.
Maybe I should try to use the socket on the red display?!?
Second. Oh, yes I am fully aware that I have to change the settings of the ESP32-S3 from Quad to Octal. But I have no ideea how to do it…🫣

schreibfaul1, 2023-11-21:
Using the SD card adapter of the display is a good idea, as long as you bridge the series resistors. Especially with the ESP32, D0 (GPIO2) is a "strapping pin" which set a pull-up resistor via SW in Setup() after the boot process.

ovidiu169, 2023-11-21:
Yes, I got it ! I will try this, of course.
I just received the DAC which is a WCMCU -5102 module, based on PCM 5102a. Watching your diagram of connections I noticed that only DIN, BCK, LRC(LCK on my module) SCK(to Gnd) are connected. What about FLT, DMP, FMT, XMT ?… Are they going to ground, as I saw în a tutorial on the net ?!?…
Second. I have an IR RX but not TSOP 4838. It’s a VS 1838. With it’s own remote controller. Can I use it, or it’s mandatory to be an 4838 ?!?…
Thank you for your patience !😇😀

ovidiu169, 2023-11-21:
Hello Arne !
Thank you for your kind advice. I never could imagine that I could burn the DAC on 5 volts…
I will do as you mentioned and I will keep you posted !😀

Arne65, 2023-11-21:
Set SDMMC to 20000000 if you need a pullup then use it. I also had a similar problem. Not every card adapter always seems to work correctly, even if you use the card adapter on the display on a display it only works without a pullup on an identically constructed one with pullup. The card must be read correctly without additional buttons or anything similar.

ovidiu169, 2023-11-21:
Hello there !
The DAC PCM5102 is not working in any configuration…🫣
I am trying a VS1053 BoB v4 from Sparkfun. But what is “XS” on the diagram ? It is maybe CS on my board ?Also I don’t have GPIO 36 on Esp32 DevKit 1.,, Which the equivalent pin ?

schreibfaul1, 2023-11-21:
What kind of DAC do you have, this board? 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 Then check whether the bridges are inserted on the back.

GPIO36 is VN and GPIO39 is VP.
Are you sure that your ESP32 has a PSRAM?

ovidiu169, 2023-11-21:
Hi, Wolle !
No, I am not shure about this. In the beggining the serial monitor said “no PSRAM detected”. But now I’m not receiving this message again. Weird, huh ?!?…
Unfortunately I have another version of DAC. Is the same chip, but another configuration of PCB and pins. But is not working anyway. Maybe is defective from the very beggining. I ordered another one.
 Meanwhile I am trying to acomodate a VS 1053 BoB version from Sparkfun🫣
I never had a problem with periferals în my life. I am 63…😇

valera39, 2023-11-21:
Taking advantage of the fact that the author is present in the topic, I would like to ask: Mr. Wolle? Do you plan to please us with something new?

schreibfaul1, 2023-11-21:
Hi @valera39,
it's not quite clear yet what will come. I'm still waiting for the stable ArduinoV3.0/IDF5.1. from Espressif, which is expected to be released this year. New fonts (generated with LVGL Font Converter) are planned and already tested, which require far less flash and are written to the display faster. This means that larger characters are also possible, which are a prerequisite for 480x800px displays. The VS1053 HW decoder is no longer included. Only SW decoders that offer more options, such as progress bar, jumping forwards and backwards in files.... Possibly support for the KCX BT emitter. This is controlled via UART, can send and receive Bluetooth and is available at a reasonable price.

clear-sky, 2023-11-22:
hi dear wolle!
please let me better understand- your new plan is switch to such  displays?
https://www.buydisplay.com/7-inch-lcd-screen-tft-display-module-wvga-800x480-at070tn90-at070tn92

schreibfaul1, 2023-11-22:
Hi @clear-sky,
das ist zu viel Bastelei, das ist nur was für Experten, ich dachte an das:
https://www.elecrow.com/esp32-display-5-inch-hmi-display-rgb-tft-lcd-touch-screen-support-lvgl.html

ovidiu169, 2023-11-22:
Good morning everyone !!!
After two days of attempts to make working both modules(VS1053b and PCM 5102a) I have to surrender myself.
I tried everything possible but the result is zero, niente, nada !!!
It seems that I need to have the same modules as you used. Anything else is not working!!!
This is a paradox. Against of all the odds i succeeded to control the radio with a remote, but now I can’t hear anything…
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

ovidiu169, 2023-11-22:
Hello, Wolle !
Sorry for bothering you with my foolish questions… but do you think it is possible to have a Broken ESP board, meanwhile I had no result with any DACs i used ?!?
At least one I am sure is working(VS1053b).
The other one is a weird version of PCM5102a(no, is not the version You showed before in your project). This one has a single row of pins. After I googled a lot it seems that all the pins(FLT, DMP, SCL, FMT,) are going to GND and XMT is going to 3.3V. But is not working anyway. I noticed a lot of people on the net had problems with this chip… Can I use an UDA ?!?

ovidiu169, 2023-11-22:
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

ovidiu169, 2023-11-22:
Finally, I made it !!!
I would like to thank you, everyone who helped me.
All the best !!!😀

ovidiu169, 2023-11-23:
Hello there !
Is anyone who succeeded to add stations on csv. Stations file(Excell). I tried but nothing is happened. The radio plays the same stations!
I added two more(no.21 and 22) and i replaced the file on the sd card. No succes!
I do not know which is the cause. Also I do not imagine how else i could ediția this csv. File…
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

Dudinu, 2023-11-23:
Salut Ovidiu !
Am vazut ca se mai obisnuieste aici sa se raspunda si altfel decit in engleza :)
Am avut si eu o experienta asemenatoare cu editarea fisierelor .csv din acest proiect; initial am folosit Excel, se pare ca rezultatul nu este tolerat de proiect, asa ca acum folosesc SublimeText, cu care nu am avut probleme si care a venit instalat cu Visual Studio Code.
Sper sa fie de folos, toate bune !

ovidiu169, 2023-11-23:
Salut, Dinu !!!
Ce bine ca întâlnesc in sfârșit unul de-ai noștri pe aici !!!👍
Eu am probleme mari cu proiectul ăsta. Mulțumesc pentru pista, dar te rog frumos să fii mai explicit, nu sunt un as în programare🫣..,
Poți să-mi explici cum să fac, așa ca pentru un elev de clasa a cincea ?…
Please !!!

Jefke1, 2023-11-23:
Enter your IP address in the web browser. Then click on the search icon. Make your selection using the dropdown menus, use the arrows at the bottom to add the station and possibly station label. Fill in the edit popup and press OK. Press the second icon station list, click save.

schreibfaul1, 2023-11-23:
Exactly, you search for your station with the "Community Radio Browser".
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

With (1) you can check whether the URL works. If no logo is supplied, you can enter the URL of the image in (2) via Google Image Search. The scaling is done automatically. If everything is OK, save the logo to the SD card with (3) and transfer the station data with (4) 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
You will then find the new entry in the list (1). With (2) the list is transferred to the nvs of the ESP32

clear-sky, 2023-11-23:
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
hi! this is my dac-works fine

Dudinu, 2023-11-23:
Buna, Ovidiu !
Presupun ( din poza cu lista de canale ) ca lucrezi sub Windows; verifica in lista de programe ( Start -> Al Programs .....) daca ai instalat editorul "Sublime Text"; daca da, atunci conectezi cardul ( microSD, am vazut ca folosesti un adaptor) la PC, te duci pe fisierul Stations.csv , click dreapta pe mouse si in meniul care se deschide alegi Open With...   click normal. In lista care ar trebui sa se deschida cauti si alegi Sublime Text.
Solutia sugerata de Wolle mai sus ar trebui sa mearga DACA postul pe care vrei sa-l memorezi se gaseste in lista "Community Radio Browser".

clear-sky, 2023-11-23:
Hi dear wolle!
If you want your radio to be tested and used by many people around the world, it is better to make it so that it is modular so that parts can be obtained in different ways. It is definitely not everywhere like in Germany and many deprived countries do not have access to international stores.
Maybe it's better to use adapters like ft811 and fr810 to access a higher resolution, which also gives you a good hmi and only requires one spi port.
As you have seen, the parts can be found separately in the market. This module that you are considering cannot be found anywhere, in addition to other problems, for example, its sound is mono, also all the ESP32 pins are occupied, which makes possible development impossible.

ovidiu169, 2023-11-23:
Bună , Dinu !
Mulțumesc pentru răspuns, tu ești foarte amabil, vrei să mă ajuți, dar eu sunt prost grămadă . Am instalat SublimeText cu care am deschis fișierul Stations am adăugat posturi , am salvat, am înlocuit fișierul pe card, dar tot nu s-a întâmplat nimic.
Mai mult nu știu să fac.
Nici nu știu de unde scot băieții ăștia aplicația aia cu care poți să adaugi , să editezi, etc.., Tu știi cum ajungi la ea ?…
Din câte am văzut pe net, nu sunt singurul care nu înțelege . Și alții au tastat IP-ul în chrome și nu s-a întâmplat nimic… Nu apare nimic, nu ajungi nicăieri. Ori nu înțeleg eu, ori nu știu ei sa explice….

ovidiu169, 2023-11-23:
Hello, Clear-Sky !!!
PCM5102 wasn’t working even at 3.3v.
The only DAC which was working for me was VS1053b , both versions(including Adafruit BoB)…

ovidiu169, 2023-11-23:
Dear friends !
First of all I want to say a Big Thank you for your patience with me.
Second, I am really puzzled.
I introduced my IP Adddress (that on the bottom side of the ILI display) on the Google Chrome but nothing is happening.
How do you reach the app named MiniWebRadio ?!?… I searched in the Community Radio Browser but I didn’t find it…
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

clear-sky, 2023-11-23:
clear all you see in address bar and type 192.168.0.213 and hit enter

ovidiu169, 2023-11-23:
Good evening You All,
Following the instructions You gave me I finally reach the MiniWebRadio App.
What I solved until now:
- acces the streams and settings;
- Select the stations;
- Checked if they are working properly;
- Checked the logos.
What I did NOT solved:
- saving the stations data on the card;
- Saving the logos also;
- The radio is not finding nothing on the list
- The app is losing connection every time I am trying to save data.
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

schreibfaul1, 2023-11-23:
I can't see the graphic for the buttons. The files are on the SD card in the png folder, is this missing?

ovidiu169, 2023-11-23:
The png files are on the content of the SD card... As a preview of this issue , I told you before I have no "buttons" also, on the display. So, the files are there, but...
[Content_on_SD_Card.zip](https://github.com/schreibfaul1/ESP32-MiniWebRadio/files/13453121/Content_on_SD_Card.zip)

ovidiu169, 2023-11-24:
Hello Wolle !
I just comment here to say the project is 90% ready.
I can control and play any station from my laptop, meanwhile I did not decoded the misteries regarding the addition of new stations on the SD card.
But taking into the consideration the precarious ESP32 board I had, for me is good enough.
I attached two pictures with my last web radios I’ve done. One is your concept and the other one is inspired by Mr. Volos(TTGO board).

Wish you all the best !!!
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

Arne65, 2023-11-26:
Connect to WiFi “MiniWebradio” under the specified IP. Then enter your SSID and password again. If that doesn't work, move closer to your router, your WiFi signal may be too weak.

ovidiu169, 2023-11-26:
Hallo Arne !
Simply, I can’t get it. I have the same router, with the same credentials(SSID and Password).
Nothing was changed from previous version. My initial AP IP was another one which is working with my first version of radio. I introduced again(ssid/password) in common file and I saved it. I uploaded again on the board. Nothing !🙁
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
working on previous radio. How this
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
was changed to 192.168.4.1(which is not opening) ?!?
The router is going, I can see the networks, but is not connecting to my MiniWebadio…
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

Arne65, 2023-11-26:
Is your PC connected to MiniWebradio accsespoint? Take a mobile device.
Otherwise I can't think of anything else. Can you ping 192.168.4.1 on your PC if you are connected to the Accsesspoint?

ovidiu169, 2023-11-26:
I tried. Nothing is happened. It's almost paranormal. That AP is not
responding at all.
I don't know what to believe. ... I don't know what to do...

În dum., 26 nov. 2023 la 20:43, Arne65 ***@***.***> a scris:

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

ovidiu169, 2023-11-26:
I tried. Nothing is happened. It's almost paranormal. That AP is not
responding at all.
I don't know what to believe. ... I don't know what to do...

În dum., 26 nov. 2023 la 21:08, Ovi Bratu ***@***.***> a scris:

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

schreibfaul1, 2023-11-26:
Two things to narrow down the error:
1) Does a simple WiFi example from Espressif work on the board?
2) The access data is written to the nvs. You can delete them with "erase flash", but first close the terminal, otherwise it won't work.

Arne65, 2023-11-26:
That's very surprising. You have to find the access point miniweb radio under the WiFi of your mobile device. If that's not the case, your ESP wouldn't send anything but receive nothing, which would then only indicate a defect in the WiFi area. Program a very simple one to test Wifi program on the esp and see if it works.

ovidiu169, 2023-11-26:
I tested the board, it seems to be defective !!!... It seems that it has
"unsupported crystal in use"(26Mhz)...
Chip is ESP32-DOWDQ6(revision 0).
Could you tell me which board You use to build this radio ?
I will try to find a similar one in order to check if and what I was doing
wrong....

În dum., 26 nov. 2023 la 21:21, Arne65 ***@***.***> a scris:

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

ovidiu169, 2023-11-30:
Hello Wolle !I reached no result with my boards. Three of them(ESP32 DevKit 1). I closed the terminal and I erased flash of the devices. The result is the same. It is not connecting. Eventually the IP address is changed, but nothing more. It is clear for me it’s a connectivity problem. But how to solve it?!?…I documented myself on the net and I saw a lot of people having the same problem and nothing helped to solve it…Trimis de pe iPhone‑ul meuPe 26 nov. 2023, la 21:47, Ovi Bratu ***@***.***> a scris: I tested the board, it seems to be defective !!!... It seems that it has "unsupported crystal in use"(26Mhz)...Chip is ESP32-DOWDQ6(revision 0).Could you tell me which board You use to build this radio ?I will try to find a similar one in order to check if and what I was doing wrong....În dum., 26 nov. 2023 la 21:21, Arne65 ***@***.***> a scris:
That's very surprising. You have to find the access point miniweb radio under the WiFi of your mobile device. If that's not the case, your ESP wouldn't send anything but receive nothing, which would then only indicate a defect in the WiFi area. Program a very simple one to test Wifi program on the esp and see if it works.

—Reply to this email directly, view it on GitHub, or unsubscribe.You are receiving this because you modified the open/close state.Message ID: ***@***.***>

zoli-iot, 2024-02-07:
> Hi @clear-sky, that's too much tinkering, it's only for experts, that's what I had in mind: https://www.elecrow.com/esp32-display-5-inch-hmi-display-rgb-tft-lcd-touch-screen-support-lvgl.html

Hi dear wolle!

Do you plan to support more convenient capacitive touch displays in the future alongside the traditional ILI9488?
For example:

https://www.aliexpress.com/item/1005006444056879.html

thanks for answer!

Closed 2025-03-31.

Thread 317 (2023-11-28):

lcd supply voltage is not valid

clear-sky, 2023-11-28:
Hi dear wolle!
please correct lcd supply voltage here
https://github.com/schreibfaul1/ESP32-MiniWebRadio/blob/Arduino-V3.0/docs/ILI9488_pins.jpg
vcc must be 3.3v

schreibfaul1, 2023-11-28:
The displays have integrated voltage converters, I think operation with 5V is fine. My display with ILI9488 is one that refuses 80MHz, 40MHz is ok. Is that only the case with mine?

valera39, 2023-11-28:
I have two ILI9488 displays. One works at both 80 and 40Mhz, the other only at 40Mhz

Jefke1, 2023-11-28:
> The displays have integrated voltage converters, I think operation with 5V is fine. My display with ILI9488 is one that refuses 80MHz, 40MHz is ok. Is that only the case with mine?

In my case ili9488 at 40Mhz.

clear-sky, 2023-11-29:
Hi all
in some displays  vcc pin  directly is connected to lcd like this
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
https://de.aliexpress.com/item/4001247154539.html
5v will damage this lcd
but mine is red board that produced by lcdwiki
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

in this module you will see a regulator between vcc and lcd
http://www.lcdwiki.com/res/MSP3520/3.5%E5%AF%B8SPI%E6%A8%A1%E5%9D%97%E5%8E%9F%E7%90%86%E5%9B%BE.pdf
i have connected vcc pin to 3.3v and works well in 40mhz

clear-sky, 2023-11-29:
Hi dear steve6375
you are right but touch config of such displays is available
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
https://www.tinytronics.nl/shop/en/displays/tft/3.5-inch-tft-display-320*480-pixels-with-touchscreen-spi-ili9486

Closed 2023-11-28.

Thread 319 (2023-12-02):

Nothing happens after Logo appears on the LCD

JozefKc, 2023-12-02:
After reset of CPU logo appears on the LCD /ILI9341/, on the monitor there is:

ESP-ROM:esp32s3-20210327
Build:Mar 27 2021
rst:0x1 (POWERON),boot:0x8 (SPI_FAST_FLASH_BOOT)
SPIWP:0xee
mode:DIO, clock div:1
load:0x3fce3808,len:0x44c
load:0x403c9700,len:0xbe4
load:0x403cc700,len:0x2a68
entry 0x403c98d4
[   956][I][esp32-hal-psram.c:96] psramInit(): PSRAM enabled
[  1599][I][WiFiMulti.cpp:84] addAP(): [WIFI][APlistAdd] add SSID: -3-
[  1611][I][WiFiMulti.cpp:84] addAP(): [WIFI][APlistAdd] add SSID: -1-
[  1611][I][WiFiMulti.cpp:84] addAP(): [WIFI][APlistAdd] add SSID: -3-
[  8302][I][WiFiMulti.cpp:114] run(): [WIFI] scan done
[  8302][I][WiFiMulti.cpp:119] run(): [WIFI] 15 networks found
[  8304][I][WiFiMulti.cpp:160] run(): [WIFI] Connecting BSSID: F0:79:59:D1:25:4C SSID: -3- Channel: 1 (-34)
[ 11609][I][WiFiMulti.cpp:174] run(): [WIFI] Connecting done.

White WLED on the CPU PCB goes on and ..... nothing - see the video.

Only in 1 of 100 attempts radio starts.  Then Touch works, connection per FileZilla and everything is OK. I can not find the reason..... CPU is ESP32S3-WROOM1-N16R8, PSRAM changed to octal......
Have you any advice plaease?

https://github.com/schreibfaul1/ESP32-MiniWebRadio/assets/120331511/17bf97c8-dcc8-4ac6-9536-05603c4f3762

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

TubaFonse, 2023-12-02:
I use the same configuration (ESP32-S3-DevKitC-1-N16R8 CPU with ILI9341 Display, PCM5102A Decoder).
You know, there are many pin-restrictions with that CPU (16MB Flash, 8MB octo PSRAM)?
I'm using
I/O 6 (instead of I/O 39) for TP_IRQ
I/O 5 (instead of I/O 3) for I2S_BCLK
I set I2S_MCLK to -1 (instead of I/O 0, because PCM5102A don't use I2S_MCLK)

in that configuration my radio plays, but now only with actual firmware version my touchpanel didn't work.

minicico, 2023-12-10:
I have the same problem. Only the introductory logo starts and according to the output after serial communication it stops at the initialization of the VS1053 module. Once in x times it starts up fine.

JozefKc, 2023-12-11:
Finaly, after the investigation of the reason of freezing the system I found that there was a shorcut between MISO and nearby pin on the processor. This is the frequently error..... Try to meassure the resist between nearby pins. Of course, processor must be out of the PCB.
For improving of the start I do not use 3,3V from the processor board for supply of the display. I installed a separate AMS1117 for 3,3V for display Vcc.

RobinMosedale, 2024-02-17:
Having now followed the advice, I'm past the boot stage of reading the SD, 1k pullup.

However, I'm now encountering exactly similar symptoms, stuck on the welcome page. I suspect that it's the VS1053 initialisation, checked the wiring, and may substitute a spare VS1053. However, I'm guessing.
I'm not getting any serial terminal output, and somewhat puzzled how I switch that on. I've tried setting in platformio.ini
-DCORE_DEBUG_LEVEL=3     to either 4 or 5, but nothing.
Could anyone please advise how I switch on serial monitoring of any programme messages, indeed if there are?
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

RobinMosedale, 2024-02-17:
My apologies, just done a clean load and getting serial output and that's confirming Vs1053 failure
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

Closed 2025-03-01.

Thread 330 (2024-01-09):

RGB LED on ESP32-S3 N16R8  and Bluetooth KCX-BT

ve2cfb, 2024-01-09:
Hello Wolle,
On my ESP32-S3 N16R8 WROOM (red pcb board) , my RGB Led pin 48 is alway on and looking at your BT pin config, the #define BT_EMITTER_RX is  pin 48. I tried a different gpio45 and i got rid of the RGB light (it is very bright).
Since you are the big BOSS, can you suggest different GPIO for  BT_EMITTER_RX and BT_EMITTER_TX.

On a side note, it looks like you will be using more AT command with the RX/TX pins and  on my previous version of the KCX_BT i had the CON pin of that BT module going to a push button. Maybe i dont need that switch anymore with your V3.

This project is getting better and better.
Thanks very much for your help.
Pierre

JozefKc, 2024-01-13:
I have the same problem. The LED is very annoying.

schreibfaul1, 2024-01-13:
I have changed this, the new RX pin is 45. Pin 48 seems to be the RGB LED on many boards. So the RGB LED can still be used for other purposes.

AVRsteffen, 2024-01-13:
The esp32 is slowly running out of pins... couldn't you make an extension like spi and 74lvc595?  Didn't even the SPI of the VS1053 become free again?  Slow outputs such as CS, C/D or AMP on/off, mute etc.  could then be taken over by the 595. The two pins for CS TFT and touch could be operated via a single pin + inverter.

schreibfaul1, 2024-01-14:
You will no longer find the VS1053 in future versions. Only external DACs will be supported. If you replace the VS1053 with a PC5102, you will get free pins. This is certainly better than a port expander or shift register. An ESP32-S3 provides further free pins.

JozefKc, 2024-01-18:
By exchanging VS1053 to PCM5102 RGB problem disapeared. Also disapeared freezing of the radio at the start. I do propose to leave VS1053. With PCM5102 also the VU meter started to work! With VS1053 there was also the problem to play .ogg format. Now it works.

Closed 2024-03-04.

Thread 334 (2024-01-14):

No Issue, just need help migrating from ESP32 + VS1053B to ESP-S3 N16R8

chess-levin, 2024-01-14:
Hi,
I'm trying to migrate your simple example [ESP32-vs1053_ext project](https://github.com/schreibfaul1/ESP32-vs1053_ext) from a ESP32 WROOM DecvKitC4 to a ESP32-S3 DevKitC1 N16R8. I want to use a board with PSRAM, hoping for a bigger buffer and less `DEBUG:  slow stream, dropouts are possible` messages. Unfortunately you closed the old project and so I hope I can place my questions here.

I got the old project running on an ESP32 DecvKitC4, but got stuck when trying to port it to a ESP32-S3. There is this line in your example code `VS1053 mp3(VS1053_XCS, VS1053_XDCS, VS1053_DREQ, VSPI, VS1053_MOSI, VS1053_MISO, VS1053_SCK);` that doesn't compile. It seems that the `const VSPI` isn't defined when I'm using the dev environment for the ESP32-S3. How should I initialize the VS1053 object? I' also have troubles to identify VSPI and HSPI on the [ESP32-S3](https://docs.espressif.com/projects/esp-idf/en/latest/esp32s3/hw-reference/esp32s3/user-guide-devkitc-1.html). There are labels like FSPIHD, SUBSPIHD, SPICLK_N etc. Which could I take for VS1053B, [ILI9488 OLED Display and SD_Card](https://www.amazon.de/dp/B08GBYQQV5)?

I want to build a similar project as your MiniWebRadio, but trying to build and understand it step by step:
1. setting up output of sound
2. integrating display
3. integration touch function
4. preferences
5. ota

I've some more questions regarding the VS1053B module I' using:

On my VS1053 breakout board is a chip that is label "VS1003B" and not "VS1053B". Afaik is the VS1003 the predesseor of the VS1053B. But your `vs1053_ext.h` library works well. I'm getting sound connecting to e.g. `mp3.connecttohost("http://icecast.radiobremen.de/rb/bremenzwei/live/mp3/128/stream.mp3");`

I'm trying to check the chip's version by calling `mp3.printChipID()` after `mp3.begin()`, but I can't understand the return values. Could you help?

```
  Serial.printf("VS1053 ChipId %lu;%d;%u\n", mp3.printChipID(), mp3.printChipID(),  mp3.printChipID());
  VS1053 ChipId 2422247520;-1872719776;2422247520
```

However I ordered a second breakout board with a chip labeled VS1053B, but unfortunately this board isn't working at all. I connected it the same way as the "VS1003B" board and no sound is played. Any ideas for testing the board?

Thank you for all your work published on github. I appreciate any help.

schreibfaul1, 2024-01-14:
With the ESP32-S3 you can use HSPI as a second SPI bus
 ````VS1053 vs1053(VS1053_CS, VS1053_DCS, VS1053_DREQ, HSPI, VS1053_MOSI, VS1053_MISO, VS1053_SCK);````
The "slow stream" problem with some stations cannot be solved with a memory extension. The real bottleneck is the Arduino WiFi.
https://github.com/schreibfaul1/ESP32-audioI2S/tree/master/examples/Better_WiFi_throughput shows how to fix this.

schreibfaul1, 2024-01-14:
Addendum: VSPI cannot be used with the ESP32-S3 (is used internally) but there is FSPI instead

chess-levin, 2024-01-15:
Thank you for your quick feedback. I've already seen your code for [Better_WiFi_throughput](https://github.com/schreibfaul1/ESP32-audioI2S/tree/master/examples/Better_WiFi_throughput). But I don't understand how to execute it.
I'm using Arduino IDE and mainly PlatformIO, but having no experience with the [Espressif IoT Development Framework](https://docs.espressif.com/projects/esp-idf/en/latest/esp32/get-started/). Do I have to install idf parallel to PlatformIO in order to get this Configuration Tool? Is there a idf-plugin for PlatformIO I can use? Or do I just have to checkout your project code and build it with PlatformIO?
I'd really appreciate some more details on how to do this tcp-reconfiguration. Thanks again.

schreibfaul1, 2024-01-15:
You cannot use a precompiled Arduino version in this case.
If you use PlatformIO, you can include Arduino as a component. Here is an example: https://github.com/schreibfaul1/ESP32_Arduino_ESPIDF

chess-levin, 2024-01-15:
Thanks again.

I've cloned your ESP32_Arduino_ESPIDF project.
Opened the menuconfig and made the new TCP configuration (BTW: As windows user  you have to use the keys 'j','k' to navigate between the menuitems ;-) Finally saved the changes to sdkconfig.esp32dev. Successfully built your project code.

Everything looked fine until here.

Then I  copied my code into main.cpp

```
#include <sdkconfig.h>
#include "Arduino.h"
#include <SPI.h>
#include <WiFi.h>
#include "vs1053_ext.h"

// https://github.com/schreibfaul1/ESP32-vs1053_ext

// Digital I/O used
#define VS1053_XRST   1
#define VS1053_XDCS   4
#define VS1053_XCS    5
#define VS1053_DREQ   36

#define VS1053_MOSI   23
#define VS1053_MISO   19
#define VS1053_SCK    18

String ssid     = "***";
String password = "***";
String hostname = "WEBRADIO_ESP32_WROOM";

int volume=15;

VS1053 mp3(VS1053_XCS, VS1053_XDCS, VS1053_DREQ, VSPI, VS1053_MOSI, VS1053_MISO, VS1053_SCK);

void printEspChipInfo() {
  Serial.println("================ ESP ChipInfo =====================");
  Serial.printf("Chip model %s (rev %d), #cores %d, CPU Freq %d MHz", ESP.getChipModel(), ESP.getChipRevision(), ESP.getChipCores(), ESP.getCpuFreqMHz());
  Serial.printf(", FlashChipSize %d KB, FlashChipSpeed %d\n ", ESP.getFlashChipSize()/1024, ESP.getFlashChipSpeed());
  Serial.println("================ ESP ChipInfo =====================");

  Serial.println("================ SPI GPIO =====================");
  Serial.print("SPI MOSI: ");  Serial.println(MOSI);
  Serial.print("SPI MISO: ");  Serial.println(MISO);
  Serial.print("SPI SCK : ");  Serial.println(SCK);
  Serial.print("SPI SS  : ");  Serial.println(SS);
  Serial.println("================ SPI GPIO =====================");

}

void setup() {

  Serial.begin(115200);

  printEspChipInfo();

  SPI.begin();
  //SPI.begin(VS1053_SCK, VS1053_MISO, VS1053_MOSI);

  Serial.print("Connecting to wifi ");
  WiFi.disconnect();
  WiFi.mode(WIFI_STA);

  WiFi.setHostname(hostname.c_str()); //define hostname

  WiFi.begin(ssid.c_str(), password.c_str());
  while (WiFi.status() != WL_CONNECTED) {
    Serial.print('.');
    delay(1000);
  }
  Serial.print(" success: ");  Serial.println(WiFi.localIP());
  Serial.print("RRSI: ");  Serial.println(WiFi.RSSI());

  Serial.println("mp3.begin");

  mp3.begin();

  Serial.print("VS1053 ChipId "); Serial.println(mp3.printChipID());

  //  mp3.loadUserCode(); // FLAC plugin
  mp3.setVolume(volume);
  mp3.connecttohost("http://icecast.radiobremen.de/rb/bremenzwei/live/mp3/128/stream.mp3");
}

// The loop function is called in an endless loop
void loop()
{
    mp3.loop();
}
```

and got a lot of linker errors regarding undefined functions in WiFiClientSecure

```
Dependency Graph
|-- ESP32-vs1053_ext @ 1.0.10+sha.d8a7551
Building in debug mode
Compiling .pio\build\esp32dev\src\main.o
Linking .pio\build\esp32dev\firmware.elf
c:/users/xxx/.platformio/packages/toolchain-xtensa-esp32/bin/../lib/gcc/xtensa-esp32-elf/8.4.0/../../../../xtensa-esp32-elf/bin/ld.exe: .pio\build\esp32dev\esp-idf\framework-arduinoespressif32-src-52b8cdec3e60619426e51a1d18d1c3fa\libframework-arduinoespressif32-src-52b8cdec3e60619426e51a1d18d1c3fa.a(WiFiClientSecure.o):(.literal._ZN16WiFiClientSecure4stopEv+0x4): undefined reference to `stop_ssl_socket(sslclient_context*, char const*, char const*, char const*)'
c:/users/xxx/.platformio/packages/toolchain-xtensa-esp32/bin/../lib/gcc/xtensa-esp32-elf/8.4.0/../../../../xtensa-esp32-elf/bin/ld.exe: .pio\build\esp32dev\esp-idf\framework-arduinoespressif32-src-52b8cdec3e60619426e51a1d18d1c3fa\libframework-arduinoespressif32-src-52b8cdec3e60619426e51a1d18d1c3fa.a(WiFiClientSecure.o):(.literal._ZN16WiFiClientSecure5writeEPKhj+0x0): undefined reference to `send_ssl_data(sslclient_context*, unsigned char const*, unsigned int)'
```

What did I miss out?

chess-levin, 2024-01-20:
Hello,

now I've cloned your project https://github.com/schreibfaul1/ESP32-audioI2S/tree/master/examples/Better_WiFi_throughput and changed platformio.ini to match my [ESP32 devkitc v4](https://docs.espressif.com/projects/esp-idf/en/latest/esp32/hw-reference/esp32/get-started-devkitc.html).

* Compiling is ok
* Linker gives some warnings

But your partition scheme does not match my ESP32 devkitc v4 with 4MB flash memory. I tried to change the values of your `partitions.csv` with some kind of default, but that doesn't work either.

```
# ESP-IDF Partition Table
# Name,   Type, SubType, Offset,  Size, Flags
nvs,      data, nvs,     0x9000,  0x6000,
phy_init, data, phy,     0xf000,  0x1000,
factory,  app,  factory, 0x10000, 1M
```

So, the final mem check stops the code from being uploaded :-(

```
esptool.py v4.5.1
Creating esp32 image...
Merged 1 ELF section
Successfully created esp32 image.
Archiving .pio\build\esp32dev\lib9d7\libESP32-audioI2S.a
Linking .pio\build\esp32dev\firmware.elf
Retrieving maximum program size .pio\build\esp32dev\firmware.elf
Checking size .pio\build\esp32dev\firmware.elf
Advanced Memory Usage is available via "PlatformIO Home > Project Inspect"
Error: The program size (1225713 bytes) is greater than maximum allowed (1048576 bytes)
RAM:   [=         ]  10.7% (used 35128 bytes from 327680 bytes)
*** [checkprogsize] Explicit exit, status 1
Flash: [==========]  116.9% (used 1225713 bytes from 1048576 bytes)
================================================================= [FAILED] Took 111.22 seconds =
```

* Do you have a default `partitions.csv` for my ESP32 DevkitC v4 4MB?
* Do I have to change anything else than the `partitions.csv`?

Thanks again.

schreibfaul1, 2024-01-20:
1M for the factory app is too small. Have a look here to see what PlatfornIO has for predefined boards. https://github.com/platformio/platform-espressif32
Some compiler warnings are normal, depending on the Arduino version

schreibfaul1, 2024-01-20:
Your board will not have PSRAM, please remove -DBOARD_HAS_PSRAM

chess-levin, 2024-01-20:
The param `-DBOARD_HAS_PSRAM` was prefixed with a comment `;`, but nevertheless, I removed it.  The ESP32 still crashes.

```
[env:esp32dev]
platform = https://github.com/platformio/platform-espressif32.git#v6.2.0  ; ESP-IDF v4.4.4
platform_packages = framework-arduinoespressif32 @ https://github.com/espressif/arduino-esp32.git#2.0.8

framework = arduino, espidf

board = esp32dev ;chipmodel ESP32, 4M FLASH, USBtoTTL

;board_build.f_cpu = 240000000L
;board_build.flash_size=4MB
;board_build.flash_freq=80M
;board_build.spiram_mode=2
board_build.partitions = partitions.csv

monitor_speed = 115200
monitor_filters = esp32_exception_decoder

upload_speed = 460800  ; 921600, 512000, 460800, 256000, 115200

build_flags =
        -Wall
        -Wextra
        -DCORE_DEBUG_LEVEL=3
        -DCONFIG_ARDUHAL_LOG_COLORS
;        -DAUDIO_LOG
        -DARDUINO_RUNNING_CORE=1       ; Arduino Runs On Core (setup, loop)
        -DARDUINO_EVENT_RUNNING_CORE=1 ; Events Run On Core

lib_deps =
    https://github.com/schreibfaul1/ESP32-audioI2S.git
```

I think it's a wrong setting in the `sdkconfig.esp32dev`

Any hint how to change it?

chess-levin, 2024-01-20:
I tried `[ESP32-MiniWebRadio](https://github.com/schreibfaul1/ESP32-MiniWebRadio/tree/master)
/sdkconfig.esp32] instead and now it's working!!!!

chess-levin, 2024-01-21:
Hello Wolle,
is there a way to avoid the recompilation of the complete arduino files each time I'm building my project? That takes a lot of time. cmake should know that the sources aren't touched. Any hint on this topic?
Thanks again

Closed 2024-03-07.

Thread 335 (2024-01-15):

No issue,just a question about KCX_BT_Emitter using

clear-sky, 2024-01-15:
Hi dear wolle!
just want to know what is the main reason of using KCX_BT_Emitter module instead of using a nice audio amplifire?
each cell phone has very very better hardware for using it as a web radio with bluetooth sender
i think new design in its best condition is a loser in competition with a mobile cell phone (edzelf tried this design and did not take a good feedback)
https://github.com/Edzelf/ESP32Radio-V2

schreibfaul1, 2024-01-15:
Hello clear-sky,
a BT functionality is desirable. Audio BT is not possible with the ESP32-S3, with the ESP32 only to a limited extent (either WiFi or BT with high resource consumption) and future chips from Espressif will probably not have audio BT either. The KCX_BT emitter is not that bad, but difficult to wire for beginners with little soldering experience (1.25mm contact spacing). I am in the process of writing the routines required for integration, but this will take some time. In addition, the BT_Emitter should be purely optional, so it is not absolutely necessary.

Here are my thoughts on audio amplifiers:
If you buy an amplifier and simply plug it in, it will often be a disappointment. Rattling and cracking noises are unavoidable.
1) Interference from the power supply: Audio and digital parts should be supplied separately, not both via the USB 5V. If there is no other way put RC 27Ohm/100µF everywhere. Always use AGND for audio lines, not GND of the power supply.
2) HF interference is caused by the WiFi or (and) BT antenna. Therefore, place the audio amplifier as far away as possible from the antennas. However, every piece of wire also acts as a receiving antenna. Shielding measures with sheet metal are not always applicable. Good results can be achieved with antistatic packaging. These are slightly conductive films in which the industry packs electronic components. The film is usually transparent grey.
If  so there are no problems with audio amplifiers and great sound.

schreibfaul1, 2024-01-15:
Then you've done everything right :-)) But there are also some people reading here who don't know the basics of analogue electronics.

clear-sky, 2024-01-15:
and you are professional in radio!
i have seen your great works making an analog fm radio with tubes in youtube !!!!!!
Very few people understand the level of your work!!!
I envy your level of knowledge
_thanks with respect_

clear-sky, 2024-01-17:
hi all
this is a nice video for those users that suffer from white noise
https://www.youtube.com/watch?v=n_b_0BWP0mI

Closed 2024-01-15.

Thread 336 (2024-01-15):

pin belegung cjmcu 5102

maba64, 2024-01-15:
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

Hallo
ich habe eine Frage betr dem 5102 dac modul
welche pins benötige ich da ?
verwende den esp32 s3  n16r8
besten Dank für deine Antwort
Markus

JozefKc, 2024-01-18:
Hi Markus!
wegen diesen Sachen habe ich in Issue 71 /  https://github.com/schreibfaul1/ESP32-MiniWebRadio/issues/338  / Scheme zugelegt. Danach musst man nur die AnalogausgängeL, R und G /ground/ yum Vestärker anschliessen.
Viel Glueck!

maba64, 2024-01-18:
besten Dank

maba64, 2024-02-02:
hallo
leider bekomme ich keinen Sound 😥
hast du betr Din und dout bei den pin def etwas angepasst ?
Gruss Markus

JozefKc, 2024-02-02:
Hallo Markus,
ich habe das wieder gecheck:
PCM5102 <---> Processor
-------------------------------------------------
Vin            auf    +3,3V
GND         auf    GND /heisst 0V/
SCK         auf     GND anschliessen
Din           auf     GPIO9
BCK         auf     GPIO3
L_RCK     auf     GPIO1

Check noch die richtige Definition der PCM5102 durch die Bruecken H1L bis
H4L - sehe Foto 20240202_192318 in der Beilage.
Meine Karte habe ich beim Aliexpress gekauft und funktioniert
problemloss.....
Wird Du irgendwelche Probleme damit haben - schreib mir.
Viele Erfolge!
Jozef

pi 2. 2. 2024 o 7:40 maba64 ***@***.***> napísal(a):

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

maba64, 2024-02-02:
hallo
Besten Dank
kannst Du bitte noch das Foto senden?
Dankeschön
Markus

maba64, 2024-02-03:
besten Dank
es lag an den fehlenden Lötbrücken
nun funktionierts
Gruss Markus

JozefKc, 2024-02-03:
Hallo Markus,
ich bin jetzt ganz froh dass alles funktioniert. Viel Spass.
Jozef

so 3. 2. 2024 o 10:22 maba64 ***@***.***> napísal(a):

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

Closed 2024-02-10.

Thread 340 (2024-01-22):

KCX-BT-EMITTER V1.4  MiniWebRadio V3.0 Intial Test

ve2cfb, 2024-01-22:
Hello Wolle,

Did an initial test and here are my Hardware info. Had a couple BT that where DOA.
1- Since V2 of MiniWebRadio i was using a KCX-BT V1.2(PCB). The Led pin was used for a front button with a led.
2- With V3 of MiniWebRadio  KCX-BT is V1.4 and V1.7(PCB). The Led pin has become a LINK  control pin.
3- I intend to use the LED on the KCX-Bt . A small change will do the trick.
3- Had to change my main PCB board to reflect those changes.

Once i got every working, i ran a utility to get the MAC/Name and added 2 BT Speaker to the Web Page.
One Earphone (Avantree AS50) worked perfectly, it paired within less 10 sec.
My other Speaker is a Sony KD-75X85K. This one is problematic. Sometime it paired and some other time, nothing.
For now, i have to get the MAC / NAME from a utility.  I guess Wolle with make an update to the web Page.

So Wolle, it look promising. Many Thanks.
Pierre

ve2cfb, 2024-01-25:
Hi Wolle,
The biggest problem i am having, is  using some  utilities to read the KCX-BT.
I want to make sure that i have good module before using MiniWebRadio.
So far, i have 4 modules and they all have the same result (not consistant).
I must be doing something really wrong for sure.
I am using a breadboard and i was afraid that the wires where too long.

I am using Arduino V2 for testing with a UNO NANO.
Today, i will test with a ESP32.

**Simple utility:**
[KCX_BT_Simple_Utility_V1.0.zip](https://github.com/schreibfaul1/ESP32-MiniWebRadio/files/14051627/KCX_BT_Simple_Utility_V1.0.zip)

**Advance utility:**
[KCX_BT_EMITTER_Advance_TEST_V1_02.zip](https://github.com/schreibfaul1/ESP32-MiniWebRadio/files/14051628/KCX_BT_EMITTER_Advance_TEST_V1_02.zip)

The advance utility, can do all AT command but the result is inconsistant. Doing a SCAN command will sometime show my headphone and some other time will not.

The Simple utility, start scanning every sedond or so by itself.
And i cannot do a AT+ command.

Maybe i need a reset type command before starting.
Maybe you do have some utility that make sense.

Thanks for your time.

schreibfaul1, 2024-01-25:
Hello Pierre,
the version I have published today is the first one that works with the BT emitter at all. If no names or addresses of the BT devices are stored, the BT emitter always connects to the first device scanned. If names or addresses are saved, it will only connect to these.  If the BT emitter is not connected, it is in SCAN mode. All BT devices that have been found are displayed on the website in the lower area.
 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
You can save the value with the "+" buttons. The "BT Mode" button switches between TX<->RX. Volume, pause does not yet work. This is what the log looks like when a device is connected.
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

ve2cfb, 2024-01-25:
Hi Wolle,
Thank you for the update.
I will try it this afternoon and give you some feedback.
Pierre

schreibfaul1, 2024-01-25:
The website with all its functions is now ready.
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

ve2cfb, 2024-01-25:
wow... quite a surprise...
This is great.

2 BT device detected, did connect to my AVANTREE AS50 without any problem.
The Sony one did not but its a bit fussy. i would not spend too much time on this one.
Will do more test later.
Pierre

ve2cfb, 2024-01-31:
Hello Wolle,
I got 3 Speakers working perfectly with your program and i tried the receive part of KCX-BT module and with my Android phone, was able to connect and play some music.  Good work.

Here is my new Breakout board. Presently i am not using the Blue Led.

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

I have a problem when shutting power off the BT module.
Still working ont it.

Many thanks for the good work.

ve2cfb, 2024-02-02:
Hello Wolle,
Here is a small Video of my setup.
The KCX-BT module has 2 power Switch.
The top SW is the radio power SW.
 and the Bottom Switch, is for the BT and it has a bi-polar led(Red/Blue).
On the video, the BlueTooth is in Emitter Mode.
https://github.com/schreibfaul1/ESP32-MiniWebRadio/assets/13633451/6cf0195a-faef-4f44-9335-4f2420d7aa27

Everything works ok but with a BT Switch, it is different in some situation.

1- After power on (Radio), with BT switch off,  its impossible to activate
    the BT by pressing the BT SW to ON. No RED light and no pairing.
2- Next Scenario, before Starting the Radio (Green Button) , initialy the BT SW has to be in ON mode.
     In this mode everything works but if i open the BT SW, the light still blinking but i loose the pairing
     even pressing the BT SW back to ON, it does not work. Must be a control line .
3-  Redo a Power reset and eveything is back to normal.

Side Note:

By the way, i found a good function from your radio...
You probably know this function.

Here is the sequence... (i will try to make it simple).
1- start radio with a BT speaker
2- In the MiniWebRadio, Go to your Bluetooth menu.
    In that menu, BT goes in receive mode
    but the light is still RED and should be BLUE.
    (side note... In the web page, going from emitter to receive
    the led does flip from RED to BLUE).
3- In BT Receive mode, start your Android Telephone,
    In Android bluetooth menu,  select MiniWebRadio.
    In youtube.com, play some music.
4- Now you have your Android sending music to ESP32,
    and ESP32 sending android music to your Bluetooth speaker.

Pretty good.

ve2cfb, 2024-02-12:
Hello Wolle,
For now, i will disable the BT switch and only show the Bipolar LEd.
If i need to reset the BT, i will power off the Radio and that will do the trick.
Thanks again...  Pierre

Closed 2024-02-17.

Thread 351 (2024-02-18):

Wroom and or vs1053 No longer suitable for latest builds. What is a suitable HW Baseline. Issues 319, 222

RobinMosedale, 2024-02-18:
Dear Wolle!,

I'm delighted to have discovered your work. Like many, I'd become frustrated with the BBC moving away from ICY to HLS playlists.
I'd experimented with other ESP32 web radios, all worked well, but unable to handle the dynamic playlists used by the BBC. My commercial Web Radios also required subscription or indeed hadn't caught up with te BBC switchover.

So I was delighted that you'd integrated this in your suite.

However, I seem to have chosen the most problematic HW baseline: ESP32 WROOM/VS1053.
The ILI9341 seems solid with its SD (no resistors)

Like many I'd struggled with the SD Reader, but eventually I found that a 10k resistor on D0 pulled up to 3.3 solved it on my un-resistored variant of the ILI9341.

Having overcome that, a further issue 319 was encountered where the VS1053 fails to initialise, and the display sits at the welcome screen. Various resistors on SCK to pull down were experimented, and found that a 10k SCK to ground allowed the VS1053 to initialise. Once, thereafter repeated failures. However, if it succeeded, then I encountered Issue 222, Miniwebradio doesn't work properly without PSRAM. The suggested removal of the quoted patch (from both ESp32 and ESP32S3 configurations have no effect.

So it seems that only older VS1053 V1.2 are available , and not suitable for build. Moreover, WROOM variants without SPRAm are similarly unsuitable.

Perhaps the config files should be amended, by either removing those options, or warning that only upto Build xxx will work with them
I wonder if you could please recommend the simplest, cleanest configuration.
I'm happy with my ILI9341(no-resistor SD).

I think that I can get my hands on a Dollatech T8 v1.7 esp32 WROVER which is an S3 with 4mb psram.
Ditto PCM5102 I2s fairly easily.
Would these with the ILI9341 form a simple clean build?

Eventually I'll need to decouple whatever output for Line Input to my HIFI Amp, or build a suitable Class D on the back end.

I'd be most welcome for your advice, but moreover, thank you for your efforts

Robin

schreibfaul1, 2024-02-19:
Hello Robin,
thank you for your report. You have overcome quite a few difficulties. I'm amazed that you and other users need pull-up resistors to operate the SD_MMC. I have often connected the SD card directly, just a wire connection without any other components. The VS1053 often causes problems, depending on which revision of the chip is installed on the board. I therefore recommend using an external DAC. This is easier to use and offers more possibilities. ESP32 with PSRAM, ILI9341 and PCM5102 will work properly.

steve6375, 2024-02-19:
#define DECODER             0

Why is this set to 0 when VS1053 is not supported !

Closed 2024-04-04.

Thread 353 (2024-02-19):

Problem with ESP32 WROOM 32D and IR remote

tzvetan65, 2024-02-19:
Hello everyone,
I have a problem with IR remote control, works uncertain or even randomly. I changed a few transmitters and receivers, but the problem remains. Perhaps the reason is that I use ESP32 Wroom 32D and VS1053 and as the author writes memory is insufficient. Is it possible to sacrifice beauty because of a functionalist by removing VU Meter and how it can be done. Would this help with more free memory? And maybe there is another option. I will be grateful for ideas for having a full remote.

tzvetan65, 2024-02-19:
Hello again,
  Maybe I'm wrong for insufficient memory. I have now found that as I divert the transmitter away from the receiver, the quality of the connection is significantly improved - it works almost 100%. Before that, I tried to direct the transmitter as much as possible to the receiver, which misled me. Obviously, when directly targeted, the signal is very powerful and must be restricted or filtered. I soldered a pull-up resistor 10k between +5 and GPIO35, but there is no improvement.
   Has anyone had a similar problem? Any ideas???

schreibfaul1, 2024-02-19:
Yes, that depends very much on the design. The IR receivers usually have a metal encapsulation, but not all of them. It is important that the distance to the WiFi antenna is as large as possible. If this is not possible, you can try to shield the IR receiver from the WiFi antenna. Antistatic foil (the grey semi-transparent bag), as used for packaging electronic components, is best suited.

tzvetan65, 2024-02-19:
Hello, thanks for the quick answer and especially for the perfect development. Everything is easy and comfortable to work with and most importantly, you are constantly improving it.
   My receiver is SHARP GP1U721Q metally encapsulated, I also tried with VS1838B and TSOP1333, but SHARP it works best. I will look for connection schemes for different receivers and experiment.
   Greetings from Bulgaria.

Closed 2024-04-04.

Thread 357 (2024-03-03):

What I burned - please for advice

tzvetan65, 2024-03-03:
Hello,
Due to the noise at the amplifier output, I tried to separate the power supply into the ESP32 Wroom 32D and VS1053B. Apparently the two power supplies were not galvanically untied because the sound was lost and the ESP32 was restarted. The screen loads the graph, connects to the Internet, but not VU meter has no movement. After the restart, the consumption of ESP32 was about 600ms, the display charges, but when it is used to manage it sometimes restarts again. I turned off the VS1053B, the consumption is about 400mm, it is restarted again, but rarely.
Can I check somehow what burned? If you need new modules what you would recommend, I see that it is recommended for ESP32 to be with PSRAM and the VS1053B is not recommended for use.

schreibfaul1, 2024-03-03:
That doesn't sound good, 400mA for the VS1053B is too much. Although, if your second voltage source does not exceed 5V and you rule out polarity reversal, little can actually go wrong. In principle, everything digital can be supplied from one voltage source without any problems, i.e. VS1053B + display + ESP32. The situation is different with a connected amplifier. AGND and GND are not the same thing. Then, in the simplest case, an additional power supply for the amplifier is advisable.
If the VS1053B is defective, it is better to use an external DAC such as the PCM5102A. Or 2x MAX98357A for loudspeaker operation.
Have a look at the V3.0 branch below the master in this repository. You can connect a KCX BT emitter there and connect to a BT headphones, BT speakers or assistants such as ALEXA.

tzvetan65, 2024-03-04:
Hello,
   Thanks for the answer, but I didn't write well the question I might have misled. In fact, one power supply is on ESP32, VS1053 and the display and the other is for the PAM8403 amplifier. Consumption 600m is common to ESP32, VS1053 and display, and 400mm is common to ESP32 and display. The output of the VS1053B and the input of the amplifier are separated by a capacitor of 47 microfarads, but still something has drilled. I asked for another version of ESP32 because sometimes it "forgets" to send to the display the graphics of the sound control buttons and the choice of a station. You have to click in the empty place where the button should be and then it appears, but only the one you click on, and so each next. I think this is because of the little memory of ESP32 and if so I would even change it to be healthy.
   I will be grateful for your recommendations.

clear-sky, 2024-03-06:
Hi -in vs1053 modules if audio ground connect to system ground it will resume hi current and main chip goes very very hot
after several minutes high temperature will damage the module!

Closed 2024-04-20.

Thread 363 (2024-03-09):

how to connect ILI 9488 with SD CARD

Tymonek87, 2024-03-09:
Hi,

How should I connect ILI 9488 with SD CARD?
I have an error with my SD card all the time.
Which  pin should I use

Arne65, 2024-03-11:
Hello,

I think you've already figured it out yourself, but here are the pins again.

Display                                PIN ESP32-S2    ESP32-S3

SD_CLK   = SD_MMC_CLK        14                  13
SD_MISO  = SD_MMC_D0         2                   11
SD_MOSI  = SD_MMC_CMD    15                  14

The three resistors on the display should actually be removed. For me it only works with the resistors on one display and on another they have to be removed.
You have to find that out yourself. You may need a 10K pullup on D0.

You should first minimize SDMMC_FREQUENCY to 20 MHz or possibly even smaller since not all SD cards work with 40 or 80 MHz.

Have fun testing :)

Tymonek87, 2024-03-11:
Hello,

Yes, i have figured out ;)
But there are some other changes... For example, I have VS1053 and you have
not supported it anymore :(
I have to buy DAC.
I am trying to run V2.15 but I have an issue with the connection to Wifi. I
have problems with the credentials ( even if they are good) and the
stability of AP 192.168.4.1 connection.

Regards,
Tom

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

Arne65, 2024-03-11:
I think you will use a dev kit with a PCB antenna. Since I've had similar problems before, I only use ESP with ext. Antenna. But that could also be due to my location.
Maybe your WiFi signal from your router is too weak. Try moving your setup closer to your router.
I can't say with certainty to what extent version 2.15 still works with the VS1053 because I only use DAC.

Tymonek87, 2024-03-11:
Hi,

Which DAC will the Best for this project ?

Regards
Tom

pon., 11 mar 2024, 09:21 użytkownik Arne65 ***@***.***>
napisał:

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

schreibfaul1, 2024-03-11:
Hi Tom, it depends on the availability in your country. A good choice is PCM5102. If you want to connect an amplifier (for speakers) behind it, it is important to use a sufficiently powerful power supply that provides separate voltages for analogue and digital.

Tymonek87, 2024-03-13:
Do I need BT emiter in case od using PCM5102
??

schreibfaul1, 2024-03-14:
The BT transmitter is optional, it also works without it.

Closed 2024-04-29.

Thread 375 (2024-03-22):

Audio distortion with PCM5102A

FranZatGIT, 2024-03-22:
Dear Schreibfaul1,
First of all - thank you very much for the great project. You've definitely invested a lot of time here. After a few teething problems (especially with a bad SD card), I got the web radio to work. I use the PCM5102A as a DA. What really bothers me is slight distortion - a kind of crackling sound. No matter whether radio, MP3 or FLAC. You can also hear it quite well in the example audio files. Is this due to the DA converter? Can YOU recommend another? Or is that jitter coming from the ESP?

many Thanks in advance

Franz

FranZatGIT, 2024-03-23:
To clarify my statement. The crackling noise is not a separate noise that is brought in by a digital bus. It is part of the music/language and modulates with it - only in the high tones. With a small speaker it's not noticeable, but with good headphones it is. It's not a big problem that you couldn't live with. Like a bad MP3, it just doesn't sound clear. Maybe my HIFI demands are just too high ;)

Arne65, 2024-03-23:
There shouldn't really be any background noise. Check your power supply. You shouldn't use USB power adapters for mobile devices or a step down converter because sometimes you don't really get a clean DC voltage. This can be easily checked with an oscil

FranZatGIT, 2024-03-29:
solved the issue - Audio has no distortion / Jitter when PCM is using 3.3V instead of 5V.

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

Closed 2024-03-29.

Thread 377 (2024-03-22):

Display dunkel

ha0248, 2024-03-22:
Hallo Schreibfaul1(Wolle),
ich versuche seit einer Woche verzeifelt das Mini Web Radio nach zu bauen, bin zwar in VScode und Platformio ein Anfänger, habe auch schon das ESP32-vs1053_ext mit Nextion Touch Senderverstellung gebaut, aber dies hier will einfach nicht laufen. Ich benutze ESP32S3 1N16MB/8Psram, TFT IL9488, microSD-Cardreader mit hama 16 MB SD und PCM 5102.
Ich kann uploaden, das läuft einwandfrei durch, das Display wir hell, zeigt aber nichts an.
Könnte es daran liegen, das ich das PSRAM nicht in "oktal" umgenannt habe? Das konnte ich nicht, weil der Run menuconfig in meiner Platformio nicht vorhanden ist. Wenn es draran liegen sollte, wie kriege ich dann diesen run menuconfig in Platformio rein? Ich konnte im Internet nichts darüber finden.
Gruß Dieter

schreibfaul1, 2024-03-22:
Hallo Dieter,
der Punkt menuconfig ist nicht aktiv. Es gibt noch zu viele Fehler weil einige Links zu notwendigen Bibliotheken fehlen. Daher benutzen wir zur Zeit die vorkompilierten Arduino Versionen. Das PSRAM wird in jedem Fall richtig erkannt.
Ich denke eher, das ist ein Standardfehler in Zusammenhang mit dem Display. Hier gibt es eine Erklärung dazu https://github.com/Bodmer/TFT_eSPI/discussions/898
Du kannst einfach MISO unbeschaltet lassen
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

Ich habe selber das Display im Einsatz und finde es ganz brauchbar.

ha0248, 2024-03-25:
Hallo Schreibfaul1(Wolle),
am NODEMCU Esp32s geht das TFT IL9488, ich hatte es auch schon so verdrahtet wie im Foto. Allerdings krieg ich auch mit dem NodeMCU das Radio nicht hin, es kommt immer der Hinweis: "SD CARD MOUNT FAILING", was wohl auch die Ursache mit dem TFT am ESP32S3 war.  Das Löten einer MMC gestaltet sich als schwierig. Gibt es denn kein SD Card Leser der am Mini Web Radio fuktioniert?
Gruß Dieter

HWH53, 2024-04-05:
Hallo ha248,
ich verwende das "Adafruit Micro SD SPI or SDIO Card Breakout Board - 3V ONLY!" von der Fa. Eckstein.
[https://eckstein-shop.de/AdafruitMicroSDSPIorSDIOCardBreakoutBoard-3VONLY](url)
Funktioniert einwandfrei!
Gruß
Helmut

ha0248, 2024-04-08:
Hallo Schreibfaul1(Wolle),
so, das Mini Web Radio läuft jetzt!!!!!! Prima!!!! Ich habe mir einen Espressif Esp32s1N8 gekauft, den SD Card-Leser habe ich fertig gelötet bei Ama..... gefunden. Die Wroom ESP32s3 sind China Clone, funktionieren nicht mit dem Mini Web Radio, muss man erstmal wissen. Nach drei Tagen Betrieb kann ich sagen, läuft toll, keine Wlan Aussetzer wie mit ESP32 Dev kit gebaute Radios. Ich habe noch eine Frage: wo finde ich den Programm-Teil des VU Meters? Ich möchte mir auch so was in andere Radios bauen, vielleicht finde ich dort ein paar Hinweise und Denkanstöße.
Vielen Dank im voraus und allerbeste Grüße
Dieter

schreibfaul1, 2024-04-10:
Super! das freut mich, manchmal ist schon die richtige HW entscheidend.
Die Werte für die Aussteuerungsanzeige kommen aus der audioI2S Bibliothek.
Dir Abfrage könnte so aussehen:
````c++
uint16_t vu = audio.getVUlevel();
uint8_t left = (vu & 0xF0) >> 8;
uint8_t right = vu & 0x0F;
````
Die Werte für einen Kanal liegen zwischen 0 ...127

vG
Wolle

schreibfaul1, 2024-04-25:
I don't know exactly what happens on the other side of the serial interface. But a loop with Serial.write() should take a lot of time. Wouldn't it be enough to just pass the values, `Serial2.printf("barR.val=%\nbarL.val=%i\n", left, right);` ?

Closed 2024-06-09.

Thread 379 (2024-03-23):

Access Point not initiating on failure to connect

RobinMosedale, 2024-03-23:
The Webradio is consistently failing to connect, see elsewhere.

However, if that occurs it is supposed to initiate an access point to enable editing of the configuration.

It fails to raise that access point.
It is  inaccessible via 192.168.4.1

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

Arne65, 2024-03-23:
If you have problems with the WiFi, I would recommend that you load a simple WiFi program onto the esp. If you have problems with that too, get a new ESP.
I hope you have also connected to the EsP's WiFi via your PC. If not, you will never get a connection from your PC to 192.168.4.1

RobinMosedale, 2024-03-23:
Thank you Arne65,

However, the failure to connect has already been raised. This is report confines itself to failing to raise an Access point on failure.

The Esp32 has been checked with a simple wifi connect programme. It connect straight away. However when running WifiMulti as in main.cpp it fails repeated with Auth expire. Tests run in conjunction with schreibfaul1.

See
https://github.com/schreibfaul1/ESP32-MiniWebRadio/issues/374
Page down to the bottom
That is of little consequence here. This is reporting a further error.
This is a completely different problem.

FranZatGIT, 2024-03-24:
Hello Schreibfaul, I was opening another thread before but I will continue to respond in this one. I spent quite a lot of time to find the issue but was not abel to get that working. I have general issue with the WIFI of the Webradio like i mentioned in #376  and the same as RobinMosedale.
some different flavors:
1. The board connects fine and everything works as it should for long time ( but that happens just occasional)
2. The board connects but get slow stream notifications and finally stops
3. The board is not connecting at all with this "Reason: 2 - AUTH_Expire"

The Webradio Radio AP starts according Monitor output but the WIFI somtimes could not be found or very late and the List of available Networks takes also a while to be shown.

I tried:

- 2 different esp32-s3-devkitc-1 N18R8 boards (but bought at the same time)
- 3 different SD cards
- 2 different TFT
- 4 different WIFI networks

1. Network - my Asus WIFI with Mesh of 3 devices => here somtimes it works as mentioned above
2. Huawei 4G Hotspot => Never connect
3. Samsung 20FE Hotspot => Never connects
4. Samsung S5 (very old) = >never connects

Below you find the 4 screenshots of the monitor output  with errors for the 4 different networks:

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

FranZatGIT, 2024-03-24:
Just want to add - 4 Networks were just  20cm to 3m far from the Webradio. Just one network was online at a time. With the uncountable attemts I found no pattern when it works and when not. Just the chance that it works was a bit higher right after rooter reboot...

Thanks so much for this project - I really want to use that Radio but in this status this is not possible. I belive the nature of the issue is not related to your code itself. It looks like a general WIFI / library bug

regards Franz

kerat71, 2024-03-25:
I have exactly the same problems.
I have been following the project for a long time, by the way MiniWebRadio Version 24 , Apr.10 2019
still working at this very moment :-)
Thank you, Schreibfaul1!

RobinMosedale, 2024-03-25:
Indeed my original fault report conducted some simple tests on the chip to show that it connected as you say.

Unfortunately I deleted my git clone and now the build references an external board git repository which has replaced the ES32Devkit n8r16 with another, and I've no idea how to correct the reference. See

https://github.com/schreibfaul1/ESP32-MiniWebRadio/issues/381

schreibfaul1, 2024-03-26:
Now I need to find out what the cause is. I have not changed the routines for WiFiMulti, but the Arduino version is now V3.0.0-alpha3 and was previously V2.0.14. I use a Fritzbox as an internet router and do not have the problems.   The encryption is set to `WPA2(CCMP)`, `WPA2 + WPA3` does not work at all. Going back to the old Arduino V2 is time-consuming.

RobinMosedale, 2024-03-26:
We're all more than grateful, Wolle.
It's a shame that you're good work is being hit by external changes.
I'm embarrassed that I seem to be encountering and raising them

RobinMosedale, 2024-03-28:
Replaced the ESP32 with a genuine Espressif Devkit. The issue is due to poor clone with poor antenna
See
https://github.com/schreibfaul1/ESP32-MiniWebRadio/issues/373

FranZatGIT, 2024-03-28:
Dear all,

i can confirm - I ordered another ESP32 s3  and it works fine!

Closed 2024-03-28.

Thread 381 (2024-03-25):

esp32s3 (board: ESP32-S3-DevKitC-1-N16R8: Could not find one of 'package.json' manifest files in the package: Jason2866/platform-board file has changed

RobinMosedale, 2024-03-25:
This is a clean load today:

Executing task: C:\Users\robin\.platformio\penv\Scripts\platformio.exe run --environment esp32s3

Processing esp32s3 (board: ESP32-S3-DevKitC-1-N16R8; platform: https://github.com/Jason2866/platform-espressif32.git#Arduino/IDF5; framework: arduino)
----------------------------------------------------------------------------------------------------------------------------------------------------------------------------------------------------------------MissingPackageManifestError: Could not find one of 'package.json' manifest files in the package

 *  The terminal process "C:\Users\robin\.platformio\penv\Scripts\platformio.exe 'run', '--environment', 'esp32s3'" terminated with exit code: 1.
 *  Terminal will be reused by tasks, press any key to close it.

RobinMosedale, 2024-03-25:
The referenced board repository was changed 2 days ago, and no longer references ESP32-S3-DevKitC-1-N16R8 but replaced with
[4d_systems_esp32s3_gen4_r8n16.json] in the referenced board git file.
(https://github.com/Jason2866/platform-espressif32/blob/Arduino/IDF5/boards/4d_systems_esp32s3_gen4_r8n16.json)
Perhaps freeze certain dependencies otherwise build are at the mercy of changes outside the author's control

schreibfaul1, 2024-03-26:
I have pinned it, possible changes now have no effect. Unfortunately the repository https://github.com/platformio/platform-espressif32 does not work with IDF 5.1 or higher.

RobinMosedale, 2024-03-26:
Fabulous. Very many thanks

schreibfaul1, 2024-03-27:
What is missing is the file **..../.../platformio/packages/framework-arduinoespressif32/package.json**. Strange. Try deleting the .platformio/packages folder. The folder is automatically recreated. Is the json file then available?

dave6024t, 2025-02-18:
I am using PlatformIO under VSC and the Arduino framework for ESP32-S3 development.

I have adapted [esp32-s3-devkitc-1-n16r8v.json](https://github.com/handledexception/platform-espressif32/blob/esp32-s3-devkitc-1-n16r8v/boards/esp32-s3-devkitc-1-n16r8v.json) for my genuine Espressif ESP32-S3-DEVKITC-1-N32R8V dev kit (which I understand can currently use only 16MB of its 32MB of flash).  After building my test app, I constantly got boot messages caused by the Watchdog timer RTC resetting every 10 seconds.  This was resolved after correcting the specification in the JSON file of the flash interface from Quad SPI to Octal SPI, as listed in [this Espressif DevKit User Guide](https://docs.espressif.com/projects/esp-dev-kits/en/latest/esp32s3/esp32-s3-devkitc-1/user_guide_v1.0.html), changing "memory_type" from "qio_opi" to "opi_opi".  I also changed  "flash_mode": "qio" to "flash_mode": "opi".  I left "partitions": "default_16MB.csv" unchanged.  According to the user guide, most of this series of DevKits DO use Quad SPI for the Flash, but those with larger 16MB or 32MB flash use Octal SPI.

I also found that Serial.print messages where not seen on the terminal, until I changed "-DARDUINO_USB_CDC_ON_BOOT=1" to "-DARDUINO_USB_CDC_ON_BOOT=0" in the the extra_flags section.

Closed 2024-03-27.

Thread 386 (2024-03-29):

Wifi connection

Jefke1, 2024-03-29:
Hello Wolle,

My own WiFi signal is hard to find, when it does connect I get the error connection to NTP failed, trying again and then keeps rebooting..... V2 plays here in the same place and has no connection problems.
ESP32 Chip: ESP32-S3
Arduino Version: 3.0.0
ESP-IDF Version: 5.1.3
MiniWebRadio     Version 3.00o Mar 02/2024
ARDUINO_LOOP_STACK_SIZE 8192 words (32 bit)
FLASH size 16777216 bytes, speed 80 MHz
CPU speed 240 MHz
SDMMC speed 40 MHz
TFT speed 40 MHz
PSRAM total size: 8388608 bytes
RESET_REASON: Software reset via esp_restart

00:01:29
00:01:29        ***************************
00:01:29        *     MiniWebRadio V3     *
00:01:29        ***************************
00:01:29
00:01:29 setup: ....  Arduino is pinned to core 1
00:01:29 tft_info: .  init ILI9341
00:01:29 setup: ....  Init SD card
00:01:29 setup: ....  SD card found, 14811.3 MB by 14832.0 MB free
[   787][I][esp32-hal-ledc.c:131] ledcAttachChannel(): LEDC attached to pin 10 (channel 0, resolution 8)
00:01:29 setup: ....  seek for stations.csv
00:01:29 setup: ....  stations.csv found
00:01:29 setup: ....  seek for WiFi networks
[  1173][I][WiFiMulti.cpp:90] addAP(): [WIFI][APlistAdd] add SSID: Orange-486AE
[  6856][I][WiFiMulti.cpp:134] run(): [WIFI] scan done
[  6862][I][WiFiMulti.cpp:139] run(): [WIFI] 12 networks found
[  6869][I][WiFiMulti.cpp:263] run(): [WIFI] Connecting BSSID: 54:67:51:A4:86:B3 SSID: Orange-486AE Channel: 6 (-82)
[  6880][W][STA.cpp:544] disconnect(): STA already disconnected.
[  6999][I][WiFiMulti.cpp:283] run(): [WIFI] Connecting done.
00:01:35 WiFI_info:   Connecting WiFi...
00:01:35 WiFI_info:   mDNS name: MiniWebRadio
00:01:35 setup: ....  connected to , IP address is 192.168.0.131
00:01:35 ftpServer:   Buffers allocated: 4622 bytes
00:01:35 connection to NTP failed, trying again
[  7053][W][STA.cpp:157] _onStaArduinoEvent(): Reason: 8 - ASSOC_LEAVE
ESP-ROM:esp32s3-20210327
Build:Mar 27 2021
rst:0xc (RTC_SW_CPU_RST),boot:0x8 (SPI_FAST_FLASH_BOOT)
Saved PC:0x4037b7de
=> 0x4037b7de: esp_cpu_wait_for_intr at /home/runner/work/esp32-arduino-lib-builder/esp32-arduino-lib-builder/esp-idf/components/esp_hw_support/cpu.c:121
SPIWP:0xee
mode:DIO, clock div:1
load:0x3fce3818,len:0x508
load:0x403c9700,len:0x4
=> 0x403c9700: ?? ??:0
load:0x403c9704,len:0xad0
=> 0x403c9704: ?? ??:0
load:0x403cc700,len:0x29d8
=> 0x403cc700: ?? ??:0
entry 0x403c9880
=> 0x403c9880: ?? ??:0
[   419][I][esp32-hal-psram.c:92] psramInit(): PSRAM enabled

schreibfaul1, 2024-03-30:
-82dB is far too weak, good values are higher than -50dB
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

Jefke1, 2024-03-30:
Okay, I understand that.
Now I have upload it to an esp32 wrover ie with an external antenna.... the result is very strange.

rst:0x1 (POWERON_RESET),boot:0x1b (SPI_FAST_FLASH_BOOT)
configsip: 0, SPIWP:0xee
clk_drv:0x00,q_drv:0x00,d_drv:0x00,cs0_drv:0x00,hd_drv:0x00,wp_drv:0x00
mode:DIO, clock div:2
load:0x3fff0030,len:1448
load:0x40078000,len:14820
=> 0x40078000: ?? ??:0
load:0x40080400,len:4
=> 0x40080400: _init at ??:?
load:0x40080404,len:3356
=> 0x40080404: ?? ??:0
entry 0x4008059c
=> 0x4008059c: ?? ??:0
[   454][I][esp32-hal-psram.c:92] psramInit(): PSRAM enabled

ESP32 Chip: ESP32-D0WD
Arduino Version: 3.0.0
ESP-IDF Version: 5.1.3
MiniWebRadio     Version 3.00o Mar 02/2024
ARDUINO_LOOP_STACK_SIZE 8192 words (32 bit)
FLASH size 8388608 bytes, speed 40 MHz
CPU speed 240 MHz
SDMMC speed 40 MHz
TFT speed 40 MHz
PSRAM total size: 4194304 bytes
RESET_REASON: Reset due to power-on event

00:00:00
00:00:00        ***************************
00:00:00        *     MiniWebRadio V3     *
00:00:00        ***************************
00:00:00
00:00:00 setup: ....  Arduino is pinned to core 1
00:00:00 tft_info: .  init ILI9341
00:00:00 setup: ....  Init SD card
00:00:00 setup: ....  SD card found, 14811.3 MB by 14832.0 MB free
[   874][I][esp32-hal-ledc.c:131] ledcAttachChannel(): LEDC attached to pin 32 (channel 0, resolution 8)
00:00:01 setup: ....  seek for stations.csv
00:00:01 setup: ....  stations.csv found
00:00:01 setup: ....  seek for WiFi networks
[  1291][I][WiFiMulti.cpp:90] addAP(): [WIFI][APlistAdd] add SSID: Orange-486AE
[  8241][I][WiFiMulti.cpp:134] run(): [WIFI] scan done
[  8247][E][WiFiMulti.cpp:137] run(): [WIFI] no networks found
[  8253][E][WiFiMulti.cpp:317] run(): [WIFI] no matching wifi found!
[ 13270][E][main.cpp:1608] connectToWiFi(): WiFi timeout
[ 16286][E][main.cpp:1614] connectToWiFi(): WiFi timeout
00:00:16 WiFI_info:   WiFi credentials are not correct
[ 16345][W][STA.cpp:544] disconnect(): STA already disconnected.
00:00:16 Accesspoint: IP: 192.168.4.1
00:00:22 setup: ....  no WiFi networks found

schreibfaul1, 2024-03-30:
It looks as if no signal is being received. ESP32s with the option of connecting an external antenna usually have a solder bridge. Perhaps this is missing.
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

Jefke1, 2024-04-01:
Hello Wolle,
I tested several boards, Esp32 Devkit, Esp32_IE, ESP32_S3
I used the simple code "Wifi" from Espressif. All boards connected immediately, I have a different location and the RSSID is better but still no connection, I adjusted the time(Wifi) in the code but unfortunately it didn't work.
Is there a way to disable WifiMulti??
I have had the opportunity to test Bluetooth, it works well, but the volume is a bit too low for me. The Bluetooth button does not appear on the display even though it is on the SD card.

rst:0x1 (POWERON_RESET),boot:0x1b (SPI_FAST_FLASH_BOOT)
configsip: 0, SPIWP:0xee
clk_drv:0x00,q_drv:0x00,d_drv:0x00,cs0_drv:0x00,hd_drv:0x00,wp_drv:0x00
mode:DIO, clock div:2
load:0x3fff0030,len:1448
load:0x40078000,len:14820
=> 0x40078000: ?? ??:0
load:0x40080400,len:4
=> 0x40080400: _init at ??:?
load:0x40080404,len:3356
=> 0x40080404: ?? ??:0
entry 0x4008059c
=> 0x4008059c: ?? ??:0
[   454][I][esp32-hal-psram.c:92] psramInit(): PSRAM enabled

ESP32 Chip: ESP32-D0WD
Arduino Version: 3.0.0
ESP-IDF Version: 5.1.3
MiniWebRadio     Version 3.00o Mar 02/2024
ARDUINO_LOOP_STACK_SIZE 8192 words (32 bit)
FLASH size 8388608 bytes, speed 40 MHz
CPU speed 240 MHz
SDMMC speed 40 MHz
TFT speed 40 MHz
PSRAM total size: 4194304 bytes
RESET_REASON: Reset due to power-on event

00:00:00
00:00:00        ***************************
00:00:00        *     MiniWebRadio V3     *
00:00:00        ***************************
00:00:00
00:00:00 setup: ....  Arduino is pinned to core 1
00:00:00 tft_info: .  init ILI9341
00:00:00 setup: ....  Init SD card
00:00:00 setup: ....  SD card found, 14811.3 MB by 14832.0 MB free
[   873][I][esp32-hal-ledc.c:131] ledcAttachChannel(): LEDC attached to pin 32 (channel 0, resolution 8)
00:00:01 setup: ....  seek for stations.csv
00:00:01 setup: ....  stations.csv found
00:00:01 setup: ....  seek for WiFi networks
[  1271][I][WiFiMulti.cpp:90] addAP(): [WIFI][APlistAdd] add SSID: Orange-486AE
[  1290][I][WiFiMulti.cpp:90] addAP(): [WIFI][APlistAdd] add SSID: Orange-486AE
[  8821][I][WiFiMulti.cpp:134] run(): [WIFI] scan done
[  8827][I][WiFiMulti.cpp:139] run(): [WIFI] 3 networks found
[  8834][E][WiFiMulti.cpp:317] run(): [WIFI] no matching wifi found!
[ 13851][E][main.cpp:1608] connectToWiFi(): WiFi timeout
[ 16867][E][main.cpp:1614] connectToWiFi(): WiFi timeout
00:00:16 WiFI_info:   WiFi credentials are not correct
[ 16926][W][STA.cpp:544] disconnect(): STA already disconnected.
00:00:16 Accesspoint: IP: 192.168.4.1
00:00:23 setup: ....  1 WiFi networks found
00:00:23 setup: ....  Orange-486AE (-44)
00:00:23 ftpServer:   Ftp server waiting for connection on port 21

schreibfaul1, 2024-04-02:
Sure you can replace "WifFimulti" with WiFi.begin(SSID, PW). What surprises me is that Orange-486AE is not connected. Are there special characters in the password? Maybe there are also data leftovers in the nvs, try "Erase Flash and Upload" instead of upload

Jefke1, 2024-04-03:
I tried everything, nothing helped, No special characters  password, erase flash and upload, too bad.
I also tested V2, no connection problems on the same esp.
It seems that the signal drops out when connecting to WiFi. weird.
ESP32 Chip: ESP32-D0WD
Arduino Version: 3.0.0
ESP-IDF Version: 5.1.3
MiniWebRadio     Version 3.00p Mar 31/2024
ARDUINO_LOOP_STACK_SIZE 8192 words (32 bit)
FLASH size 8388608 bytes, speed 40 MHz
CPU speed 240 MHz
SDMMC speed 80 MHz
TFT speed 40 MHz
PSRAM total size: 4194304 bytes
RESET_REASON: Reset due to power-on event

00:00:00
00:00:00        ***************************
00:00:00        *     MiniWebRadio V3     *
00:00:00        ***************************
00:00:00
00:00:00 setup: ....  Arduino is pinned to core 1
00:00:00 tft_info: .  init ILI9341
00:00:00 setup: ....  Init SD card
00:00:00 setup: ....  SD card found, 14811.3 MB by 14832.0 MB free
[   873][I][esp32-hal-ledc.c:131] ledcAttachChannel(): LEDC attached to pin 32 (channel 0, resolution 8)
00:00:01 setup: ....  seek for stations.csv
00:00:01 setup: ....  stations.csv found
00:00:01 setup: ....  seek for WiFi networks
[  1270][I][WiFiMulti.cpp:90] addAP(): [WIFI][APlistAdd] add SSID: Orange-486AE
[  9404][I][WiFiMulti.cpp:134] run(): [WIFI] scan done
[  9410][E][WiFiMulti.cpp:137] run(): [WIFI] no networks found
[  9417][E][WiFiMulti.cpp:317] run(): [WIFI] no matching wifi found!
[ 14434][E][main.cpp:1608] connectToWiFi(): WiFi timeout
[ 17450][E][main.cpp:1614] connectToWiFi(): WiFi timeout
00:00:17 WiFI_info:   WiFi credentials are not correct
[ 17509][W][STA.cpp:544] disconnect(): STA already disconnected.
00:00:17 Accesspoint: IP: 192.168.4.1
00:00:24 setup: ....  16 WiFi networks found
00:00:24 setup: ....  Orange-486AE (-44)
00:00:24 setup: ....  Orange-1d6e6 (-56)
00:00:24 setup: ....  Orange-5cd0a (-66)
00:00:24 setup: ....  Guest-Orange-5cd0a (-66)
00:00:24 setup: ....  Proximus-Home-212702 (-68)
00:00:24 setup: ....  Proximus-Home-212702 (-73)
00:00:24 setup: ....  Guest-Orange-7a6c7 (-74)
00:00:24 setup: ....  Orange-7a6c7 (-75)
00:00:24 setup: ....  Proximus-Home-212702 (-79)
00:00:24 setup: ....  telenet-05670 (-80)
00:00:24 setup: ....  WiFi-2.4-BB4B (-86)
00:00:24 setup: ....  telenet-4E281C7 (-88)
00:00:24 setup: ....  WiFi-2.4-4F80 (-91)
00:00:24 setup: ....  Proximus Public Wi-Fi (-91)
00:00:24 setup: ....  Proximus Public Wi-Fi (-92)
00:00:24 setup: ....  Proximus-Home-6B61 (-93)
00:00:24 ftpServer:   Ftp server waiting for connection on port 21
ets Jul 29 2019 12:21:46

rst:0x1 (POWERON_RESET),boot:0x1b (SPI_FAST_FLASH_BOOT)
configsip: 0, SPIWP:0xee
clk_drv:0x00,q_drv:0x00,d_drv:0x00,cs0_drv:0x00,hd_drv:0x00,wp_drv:0x00
mode:DIO, clock div:2
load:0x3fff0030,len:1448
load:0x40078000,len:14820
=> 0x40078000: ?? ??:0
load:0x40080400,len:4
=> 0x40080400: _init at ??:?
load:0x40080404,len:3356
=> 0x40080404: ?? ??:0
entry 0x4008059c
=> 0x4008059c: ?? ??:0
[   454][I][esp32-hal-psram.c:92] psramInit(): PSRAM enabled

ESP32 Chip: ESP32-D0WD
Arduino Version: 3.0.0
ESP-IDF Version: 5.1.3
MiniWebRadio     Version 3.00p Mar 31/2024
ARDUINO_LOOP_STACK_SIZE 8192 words (32 bit)
FLASH size 8388608 bytes, speed 40 MHz
CPU speed 240 MHz
SDMMC speed 80 MHz
TFT speed 40 MHz
PSRAM total size: 4194304 bytes
RESET_REASON: Reset due to power-on event

00:00:00
00:00:00        ***************************
00:00:00        *     MiniWebRadio V3     *
00:00:00        ***************************
00:00:00
00:00:00 setup: ....  Arduino is pinned to core 1
00:00:00 tft_info: .  init ILI9341
00:00:00 setup: ....  Init SD card
00:00:00 setup: ....  SD card found, 14811.3 MB by 14832.0 MB free
[   873][I][esp32-hal-ledc.c:131] ledcAttachChannel(): LEDC attached to pin 32 (channel 0, resolution 8)
00:00:01 setup: ....  seek for stations.csv
00:00:01 setup: ....  stations.csv found
00:00:01 setup: ....  seek for WiFi networks
[  1270][I][WiFiMulti.cpp:90] addAP(): [WIFI][APlistAdd] add SSID: Orange-486AE
[  8204][I][WiFiMulti.cpp:134] run(): [WIFI] scan done
[  8210][E][WiFiMulti.cpp:137] run(): [WIFI] no networks found
[  8217][E][WiFiMulti.cpp:317] run(): [WIFI] no matching wifi found!
[ 13234][E][main.cpp:1608] connectToWiFi(): WiFi timeout
[ 16250][E][main.cpp:1614] connectToWiFi(): WiFi timeout
00:00:16 WiFI_info:   WiFi credentials are not correct
[ 16309][W][STA.cpp:544] disconnect(): STA already disconnected.
00:00:16 Accesspoint: IP: 192.168.4.1
00:00:22 setup: ....  17 WiFi networks found
00:00:22 setup: ....  Orange-486AE (-45)
00:00:22 setup: ....  Orange-1d6e6 (-52)
00:00:22 setup: ....  Guest-Orange-5cd0a (-66)
00:00:22 setup: ....  Proximus-Home-212702 (-69)
00:00:22 setup: ....  Orange-5cd0a (-74)
00:00:22 setup: ....  Orange-7a6c7 (-75)
00:00:22 setup: ....  Guest-Orange-7a6c7 (-75)
00:00:23 setup: ....  Proximus-Home-212702 (-75)
00:00:23 setup: ....  Proximus-Home-212702 (-78)
00:00:23 setup: ....  telenet-05670 (-79)
00:00:23 setup: ....  WiFi-2.4-BB4B (-85)
00:00:23 setup: ....  Proximus-Home-6B61 (-87)
00:00:23 setup: ....  telenet-4E281C7 (-90)
00:00:23 setup: ....  Proximus Public Wi-Fi (-92)
00:00:23 setup: ....  WiFi-2.4-4F80 (-93)
00:00:23 setup: ....  Proximus Public Wi-Fi (-94)
00:00:23 setup: ....  telenet-8493442 (-95)
00:00:23 ftpServer:   Ftp server waiting for connection on port 21

schreibfaul1, 2024-04-03:
That is strange. There are no changes in the WiFi code between V2 and V3. The Orange-486AE network is perfectly fine with -45dB. However, the connection problem could be due to the fact that the new IDF V5.1 is now being used. I think your router is rejecting the connection. Can you change the settings in the router (WPA2/WPS3. CCMP...)?

Jefke1, 2024-04-03:
I was thinking in the same direction, I think the modem I have is an outdated type. time for replacement.
I can adjust some settings if necessary.

Jefke1, 2024-04-10:
Hi Wolle,
Installed a new modem today, everything works perfectly.
Sorry for the inconvenience.

Closed 2024-04-10.

Thread 388 (2024-04-01):

Hilfe zu "OTA" (Host MiniWebRadio.local Not Found) bzw. "connection to NTP" failed

TubaFonse, 2024-04-01:
Hallo Wolle,
ich wollte heute (ich weiß, es ist der 1. April) meinem MiniWebRadio die aktuelle Firmware verpassen,
aber jetzt klappt leider gar nichts mehr:

1.) die aktuelle Version vom 31.03. lässt sich nicht flashen (OTA-Version, aber die bringe ich nicht zum laufen):

18:42:52 [DEBUG]: Options: Namespace(esp_ip='MiniWebRadio.local', host_ip='0.0.0.0', esp_port=3232, host_port=20273, auth='', image='.pio\\build\\esp32s3\\firmware.bin', spiffs=False, debug=True, progress=True, timeout=10)
18:42:52 [INFO]: Starting on 0.0.0.0:20273
18:42:52 [INFO]: Upload size: 2304208
Sending invitation to MiniWebRadio.local failed
18:42:55 [ERROR]: Host MiniWebRadio.local Not Found
*** [upload] Error 1

Hier bitte ich um "Nachhilfeunterricht" - was muss ich einrichten, damit der Upload-Port funktioniert?

2.) die Version vom 26.03. hat bisher bei mir funktioniert env:esp32s3 (jedoch nur die Option "ohne OTA").
Diese habe ich heute versuchsweise nochmal compiliert und geflasht - leider mit einer Bootloop bei "connecting to ntp":
00:00:10 WiFI_info:   Connecting WiFi...
00:00:10 WiFI_info:   mDNS name: MiniWebRadio
00:00:10 setup: ....  connected to FRITZ!Box7490LF, IP address is 192.168.178.31
00:00:10 ftpServer:   Buffers allocated: 4622 bytes
00:00:10 connection to NTP failed, trying again
[ 10673][D][WiFiGeneric.cpp:1055] _eventCallback(): Arduino Event: 5 - STA_DISCONNECTED
[ 10690][W][WiFiGeneric.cpp:1081] _eventCallback(): Reason: 8 - ASSOC_LEAVE

Details zu 1.)
Processing esp32s3 (board: ESP32-S3-DevKitC-1-N16R8; platform: https://github.com/Jason2866/platform-espressif32.git#348a508; framework: arduino)
-------------------------------------------------------------------------------------------------------------------------------------------------------
Verbose mode can be enabled via `-v, --verbose` option
CONFIGURATION: https://docs.platformio.org/page/boards/espressif32/ESP32-S3-DevKitC-1-N16R8.html
PLATFORM: Espressif 32 (2024.3.10+sha.348a508) > Espressif ESP32-S3-DevKitC-1-N16R8V (16 MB QD, 8MB PSRAM)
HARDWARE: ESP32S3 240MHz, 320KB RAM, 16MB Flash
DEBUG: Current (esp-builtin) On-board (esp-builtin) External (cmsis-dap, esp-bridge, esp-prog, iot-bus-jtag, jlink, minimodule, olimex-arm-usb-ocd, olimex-arm-usb-ocd-h, olimex-arm-usb-tiny-h, olimex-jtag-tiny, tumpa)
PACKAGES:
 - framework-arduinoespressif32 @ 3.0.0+sha.4123e20
 - framework-arduinoespressif32-libs @ 5.1.3+sha.e7771c75bd.sha.270b5dc
 - tool-esptoolpy @ 4.7.2
 - tool-mkfatfs @ 2.0.1
 - tool-mklittlefs @ 3.2.0
 - tool-openocd-esp32 @ 2.1100.20220706 (11.0)
 - tool-riscv32-esp-elf-gdb @ 11.2.0+20220823
 - tool-xtensa-esp-elf-gdb @ 11.2.0+20230208
 - toolchain-riscv32-esp @ 12.2.0+20230208
 - toolchain-xtensa-esp32s3 @ 12.2.0+20230208
LDF: Library Dependency Finder -> https://bit.ly/configure-pio-ldf
LDF Modes: Finder ~ chain, Compatibility ~ soft
Found 47 compatible libraries
Scanning dependencies...
Dependency Graph
|-- ESP32-audioI2S @ 2.0.0+sha.e9a294e
|-- ESP32-KCX-BT-EMITTER @ 0.0.0+20240128094011.sha.338bc78
|-- ESP32-DLNA-Client @ 0.0.0+20231205185914.sha.cdde817
|-- ESP32-IR-Remote-Control @ 1.0.10+sha.6cb54a9
|-- FFat @ 2.0.0
|-- SPIFFS @ 2.0.0
|-- WiFiClientSecure @ 2.0.0
|-- ac101
|-- es8388
|-- ftpsrv
|-- rtime
|-- tftLib
|-- websrv
|-- wm8978
|-- ArduinoOTA @ 2.0.0
|-- ESPmDNS @ 2.0.0
|-- FS @ 2.0.0
|-- Preferences @ 2.0.0
|-- SD_MMC @ 2.0.0
|-- SPI @ 2.0.0
|-- Ticker @ 2.0.0
|-- WiFi @ 2.0.0
|-- Wire @ 2.0.0
Building in release mode
Retrieving maximum program size .pio\build\esp32s3\firmware.elf
Checking size .pio\build\esp32s3\firmware.elf
Advanced Memory Usage is available via "PlatformIO Home > Project Inspect"
RAM:   [==        ]  20.8% (used 68052 bytes from 327680 bytes)
Flash: [======    ]  59.6% (used 2303849 bytes from 3866624 bytes)
Configuring upload protocol...
AVAILABLE: cmsis-dap, esp-bridge, esp-builtin, esp-prog, espota, esptool, iot-bus-jtag, jlink, minimodule, olimex-arm-usb-ocd, olimex-arm-usb-ocd-h, olimex-arm-usb-tiny-h, olimex-jtag-tiny, tumpa
CURRENT: upload_protocol = espota
Uploading .pio\build\esp32s3\firmware.bin
18:42:52 [DEBUG]: Options: Namespace(esp_ip='MiniWebRadio.local', host_ip='0.0.0.0', esp_port=3232, host_port=20273, auth='', image='.pio\\build\\esp32s3\\firmware.bin', spiffs=False, debug=True, progress=True, timeout=10)
18:42:52 [INFO]: Starting on 0.0.0.0:20273
18:42:52 [INFO]: Upload size: 2304208
Sending invitation to MiniWebRadio.local failed
18:42:55 [ERROR]: Host MiniWebRadio.local Not Found
*** [upload] Error 1
============================================================= [FAILED] Took 14.12 seconds =============================================================

Environment    Status    Duration
-------------  --------  ------------
esp32s3        FAILED    00:00:14.120
======================================================== 1 failed, 0 succeeded in 00:00:14.120 ========================================================

Details zu 2.)
ESP-ROM:esp32s3-20210327
Build:Mar 27 2021
rst:0x1 (POWERON),boot:0x8 (SPI_FAST_FLASH_BOOT)
SPIWP:0xee
mode:DIO, clock div:1
load:0x3fce3818,len:0x508
load:0x403c9700,len:0x4
=> 0x403c9700: ?? ??:0
load:0x403c9704,len:0xad0
=> 0x403c9704: ?? ??:0
load:0x403cc700,len:0x29d8
=> 0x403cc700: ?? ??:0
entry 0x403c9880
=> 0x403c9880: ?? ??:0
[   412][I][esp32-hal-psram.c:92] psramInit(): PSRAM enabled
=========== Before Setup Start ===========
Chip Info:
------------------------------------------
  Model             : ESP32-S3
  Package           : 0
  Revision          : 1
  Cores             : 2
  Frequency         : 240 MHz
  Embedded Flash    : No
  Embedded PSRAM    : No
  2.4GHz WiFi       : Yes
  Classic BT        : No
  BT Low Energy     : Yes
  IEEE 802.15.4     : No
------------------------------------------
INTERNAL Memory Info:
------------------------------------------
  Total Size        :   336924 B ( 329.0 KB)
  Free Bytes        :   264068 B ( 257.9 KB)
  Allocated Bytes   :    67040 B (  65.5 KB)
  Minimum Free Bytes:   258900 B ( 252.8 KB)
  Largest Free Block:   237556 B ( 232.0 KB)
------------------------------------------
SPIRAM Memory Info:
------------------------------------------
  Total Size        :  8388608 B (8192.0 KB)
  Free Bytes        :  8358688 B (8162.8 KB)
  Allocated Bytes   :    27352 B (  26.7 KB)
  Minimum Free Bytes:  8358688 B (8162.8 KB)
  Largest Free Block:  8257524 B (8064.0 KB)
  Bus Mode          : OPI
------------------------------------------
Flash Info:
------------------------------------------
  Chip Size         : 16777216 B (16 MB)
  Block Size        :    65536 B (  64.0 KB)
  Sector Size       :     4096 B (   4.0 KB)
  Page Size         :      256 B (   0.2 KB)
  Bus Speed         : 80 MHz
  Bus Mode          : QIO
------------------------------------------
Partitions Info:
------------------------------------------
           coredump : addr: 0x00009000, size:    20.0 KB, type: DATA, subtype: COREDUMP
            otadata : addr: 0x0000E000, size:     8.0 KB, type: DATA, subtype: OTA
                nvs : addr: 0x00010000, size:   256.0 KB, type: DATA, subtype: NVS
               app0 : addr: 0x00050000, size:  3776.0 KB, type:  APP, subtype: OTA_0
               app1 : addr: 0x00400000, size:  3776.0 KB, type:  APP, subtype: OTA_1
               ffat : addr: 0x007B0000, size:  8512.0 KB, type: DATA, subtype: FAT
------------------------------------------
Software Info:
------------------------------------------
  Compile Date/Time : Apr  1 2024 15:16:29
  ESP-IDF Version   : v5.1.3-dirty
  Arduino Version   : 3.0.0
------------------------------------------
Board Info:
------------------------------------------
  Arduino Board     : Espressif ESP32-S3-DevKitC-1-N16R8V (16 MB QD, 8MB PSRAM)
  Arduino Variant   : esp32s3
  Core Debug Level  : 4
  Arduino Runs Core : 1
  Arduino Events on : 0
  CDC On Boot       : 0
============ Before Setup End ============
ESP32 Chip: ESP32-S3
Arduino Version: 3.0.0
ESP-IDF Version: 5.1.3
MiniWebRadio     Version 3.00o Mar 02/2024
ARDUINO_LOOP_STACK_SIZE 8192 words (32 bit)
FLASH size 16777216 bytes, speed 80 MHz
CPU speed 240 MHz
SDMMC speed 80 MHz
TFT speed 40 MHz
PSRAM total size: 8388608 bytes
RESET_REASON: Reset due to power-on event
00:00:00
00:00:00        ***************************
00:00:00        *     MiniWebRadio V3     *
00:00:00        ***************************
00:00:00
00:00:00 setup: ....  Arduino is pinned to core 1
00:00:00 tft_info: .  init ILI9341
00:00:00 setup: ....  Init SD card
00:00:00 setup: ....  SD card found, 1897.5 MB by 1938.5 MB free
[  1272][I][esp32-hal-ledc.c:131] ledcAttachChannel(): LEDC attached to pin 10 (channel 0, resolution 8)
00:00:01 setup: ....  seek for stations.csv
00:00:01 setup: ....  stations.csv found
00:00:01 setup: ....  seek for WiFi networks
[  1646][I][WiFiMulti.cpp:89] addAP(): [WIFI][APlistAdd] add SSID: FRITZ!Box7490LF
[  1688][D][WiFiGeneric.cpp:1055] _eventCallback(): Arduino Event: 0 - WIFI_READY
[  1732][D][WiFiGeneric.cpp:1055] _eventCallback(): Arduino Event: 2 - STA_START
[  4135][D][WiFiGeneric.cpp:1055] _eventCallback(): Arduino Event: 1 - SCAN_DONE
[ 10352][D][WiFiGeneric.cpp:1055] _eventCallback(): Arduino Event: 1 - SCAN_DONE
[ 10361][I][WiFiMulti.cpp:133] run(): [WIFI] scan done
[ 10367][I][WiFiMulti.cpp:138] run(): [WIFI] 6 networks found
[ 10373][D][WiFiMulti.cpp:242] run():         0: [11][CA:0E:14:0C:93:11] Nw5Box7490GastLF (-39) (*) (visible)
[ 10384][D][WiFiMulti.cpp:233] run():  --->   1: [11][C8:0E:14:0C:93:11] FRITZ!Box7490LF (-40) (*) (visible)
[ 10395][D][WiFiMulti.cpp:242] run():         2: [6][1C:ED:6F:E5:7B:F5] FRITZ!Box 7530 XK (-74) (*) (visible)
[ 10405][D][WiFiMulti.cpp:242] run():         3: [1][F0:B0:14:3F:FE:17] Fritz-Box7430Mar3 (-82) (*) (visible)
[ 10416][D][WiFiMulti.cpp:233] run():  --->   4: [11][CC:CE:1E:10:B3:1A] FRITZ!Box7490LF (-83) (*) (visible)
[ 10427][D][WiFiMulti.cpp:242] run():         5: [11][CE:CE:1E:10:B3:1A] Nw5Box7490GastLF (-83) (*) (visible)
[ 10437][I][WiFiMulti.cpp:262] run(): [WIFI] Connecting BSSID: C8:0E:14:0C:93:11 SSID: FRITZ!Box7490LF Channel: 11 (-40)
[ 10534][D][WiFiGeneric.cpp:1055] _eventCallback(): Arduino Event: 4 - STA_CONNECTED
[ 10558][D][WiFiGeneric.cpp:1055] _eventCallback(): Arduino Event: 7 - STA_GOT_IP
[ 10567][D][WiFiGeneric.cpp:1119] _eventCallback(): STA IP: 192.168.178.31, MASK: 255.255.255.0, GW: 192.168.178.1
[ 10585][I][WiFiMulti.cpp:282] run(): [WIFI] Connecting done.
[ 10592][D][WiFiMulti.cpp:283] run(): [WIFI] SSID: FRITZ!Box7490LF
[ 10599][D][WiFiMulti.cpp:284] run(): [WIFI] IP: 192.168.178.31
[ 10606][D][WiFiMulti.cpp:285] run(): [WIFI] MAC: C8:0E:14:0C:93:11
[ 10613][D][WiFiMulti.cpp:286] run(): [WIFI] Channel: 11
[ 10619][D][WiFiMulti.cpp:344] resetFails(): [WIFI] Resetting failure flags
00:00:10 WiFI_info:   Connecting WiFi...
00:00:10 WiFI_info:   mDNS name: MiniWebRadio
00:00:10 setup: ....  connected to FRITZ!Box7490LF, IP address is 192.168.178.31
00:00:10 ftpServer:   Buffers allocated: 4622 bytes
00:00:10 connection to NTP failed, trying again
[ 10673][D][WiFiGeneric.cpp:1055] _eventCallback(): Arduino Event: 5 - STA_DISCONNECTED
[ 10690][W][WiFiGeneric.cpp:1081] _eventCallback(): Reason: 8 - ASSOC_LEAVE
[ 10699][D][WiFiGeneric.cpp:1055] _eventCallback(): Ard�x��x�x�x�xx�xxx�x�x�������xx���xxxxx��xxx�xx����x�x�x��xESP-ROM:esp32s3-20210327
Build:Mar 27 2021
rst:0xc (RTC_SW_CPU_RST),boot:0x8 (SPI_FAST_FLASH_BOOT)
Saved PC:0x420639b8
=> 0x420639b8: panic_handler at /home/runner/work/esp32-arduino-lib-builder/esp32-arduino-lib-builder/esp-idf/components/esp_system/port/panic_handler.c:121
SPIWP:0xee
mode:DIO, clock div:1
load:0x3fce3818,len:0x508
load:0x403c9700,len:0x4
=> 0x403c9700: ?? ??:0
load:0x403c9704,len:0xad0
=> 0x403c9704: ?? ??:0
load:0x403cc700,len:0x29d8
=> 0x403cc700: ?? ??:0
entry 0x403c9880
=> 0x403c9880: ?? ??:0
[   418][I][esp32-hal-psram.c:92] psramInit(): PSRAM enabled

TubaFonse, 2024-04-01:
weitere Details zu 1.)
Processing esp32s3 (board: ESP32-S3-DevKitC-1-N16R8; platform: https://github.com/Jason2866/platform-espressif32.git#348a508; framework: arduino)
-------------------------------------------------------------------------------------------------------------------------------------------------------
Verbose mode can be enabled via `-v, --verbose` option
CONFIGURATION: https://docs.platformio.org/page/boards/espressif32/ESP32-S3-DevKitC-1-N16R8.html
PLATFORM: Espressif 32 (2024.3.10+sha.348a508) > Espressif ESP32-S3-DevKitC-1-N16R8V (16 MB QD, 8MB PSRAM)
HARDWARE: ESP32S3 240MHz, 320KB RAM, 16MB Flash
DEBUG: Current (esp-builtin) On-board (esp-builtin) External (cmsis-dap, esp-bridge, esp-prog, iot-bus-jtag, jlink, minimodule, olimex-arm-usb-ocd, olimex-arm-usb-ocd-h, olimex-arm-usb-tiny-h, olimex-jtag-tiny, tumpa)
PACKAGES:
 - framework-arduinoespressif32 @ 3.0.0+sha.4123e20
 - framework-arduinoespressif32-libs @ 5.1.3+sha.e7771c75bd.sha.270b5dc
 - tool-esptoolpy @ 4.7.2
 - tool-mkfatfs @ 2.0.1
 - tool-mklittlefs @ 3.2.0
 - tool-openocd-esp32 @ 2.1100.20220706 (11.0)
 - tool-riscv32-esp-elf-gdb @ 11.2.0+20220823
 - tool-xtensa-esp-elf-gdb @ 11.2.0+20230208
 - toolchain-riscv32-esp @ 12.2.0+20230208
 - toolchain-xtensa-esp32s3 @ 12.2.0+20230208
LDF: Library Dependency Finder -> https://bit.ly/configure-pio-ldf
LDF Modes: Finder ~ chain, Compatibility ~ soft
Found 47 compatible libraries
Scanning dependencies...
Dependency Graph
|-- ESP32-audioI2S @ 2.0.0+sha.e9a294e
|-- ESP32-KCX-BT-EMITTER @ 0.0.0+20240128094011.sha.338bc78
|-- ESP32-DLNA-Client @ 0.0.0+20231205185914.sha.cdde817
|-- ESP32-IR-Remote-Control @ 1.0.10+sha.6cb54a9
|-- FFat @ 2.0.0
|-- SPIFFS @ 2.0.0
|-- WiFiClientSecure @ 2.0.0
|-- ac101
|-- es8388
|-- ftpsrv
|-- rtime
|-- tftLib
|-- websrv
|-- wm8978
|-- ArduinoOTA @ 2.0.0
|-- ESPmDNS @ 2.0.0
|-- FS @ 2.0.0
|-- Preferences @ 2.0.0
|-- SD_MMC @ 2.0.0
|-- SPI @ 2.0.0
|-- Ticker @ 2.0.0
|-- WiFi @ 2.0.0
|-- Wire @ 2.0.0
Building in release mode
Retrieving maximum program size .pio\build\esp32s3\firmware.elf
Checking size .pio\build\esp32s3\firmware.elf
Advanced Memory Usage is available via "PlatformIO Home > Project Inspect"
RAM:   [==        ]  20.8% (used 68060 bytes from 327680 bytes)
Flash: [======    ]  59.8% (used 2310377 bytes from 3866624 bytes)
Configuring upload protocol...
AVAILABLE: cmsis-dap, esp-bridge, esp-builtin, esp-prog, espota, esptool, iot-bus-jtag, jlink, minimodule, olimex-arm-usb-ocd, olimex-arm-usb-ocd-h, olimex-arm-usb-tiny-h, olimex-jtag-tiny, tumpa
CURRENT: upload_protocol = espota
Uploading .pio\build\esp32s3\firmware.bin
23:25:04 [DEBUG]: Options: Namespace(esp_ip='MiniWebRadio.local', host_ip='0.0.0.0', esp_port=3232, host_port=50254, auth='', image='.pio\\build\\esp32s3\\firmware.bin', spiffs=False, debug=True, progress=True, timeout=10)
23:25:04 [INFO]: Starting on 0.0.0.0:50254
23:25:04 [INFO]: Upload size: 2310736
Sending invitation to MiniWebRadio.local ..........
23:26:45 [ERROR]: No response from the ESP
*** [upload] Error 1

Arne65, 2024-04-02:
Moin Moin ,

PIO Set upload/monitor/test port von Auto auf Deinen Kommunikationsanschluss (COM) umstellen dann sollte das funktionieren

TubaFonse, 2024-04-02:
@schreibfaul1
über USB kann ich ja flashen, das ist nicht das Problem, MWR verbindet sich auch mit dem WLAN, aber gleich danach läuft er in die Boot-Schleife, weil offensichtlich der Zugriff auf NTP nicht mehr funktioniert:
00:00:10 setup: .... connected to FRITZ!Box7490LF, IP address is 192.168.178.31
00:00:10 ftpServer: Buffers allocated: 4622 bytes
00:00:10 connection to NTP failed, trying again

schreibfaul1, 2024-04-02:
das gab es eine Änderung
https://github.com/schreibfaul1/ESP32-MiniWebRadio/issues/354
das war vor zwei Monaten.

schreibfaul1, 2024-04-04:
prima, dann ist das Problem erledigt :-)

Closed 2024-04-03.

Thread 392 (2024-04-07):

Feature request: Multiple alarms

MyAir, 2024-04-07:
Hi Wolle
Do you ever plan to implement more than one alarm in your ESP32-MiniWebRadio?

I had a Sangean radio alarm clock that died on me after 15 years of service. This alarm clock had two alarms where I could set each alarm per weekday. I need one alarm for Monday and Friday at a later time and another one for Tuesday, Wedensday and Thursday at an earlier time, but no commercial vendor offers that feature anymore. So I had to resort to building my own. This is where I came across your ESP32-MiniWebRadio and decided to order the parts (ESP32-S3, ILI9341 and MAX98357A) to build my own. While the parts were in transit I found another project called "Internet Radiowecker mit Touchscreen" from az-delivery. This sketch looked a bit more managable to me as a novice and already has two alarms that can be set. Pretty much what I need. So I managed to build myself a protoype based on that code which almost does what I need. But that project has other shortcomings like audio interruptions when updating the screen, alarms can only be set in the web interface and a quite outdated layout of both the TFT and the web interface. Plus it's not maintained anymore like your project is. So I would very much like to come back to your ESP32-MiniWebRadio eventually as it looks quite a bit better designed than the one I'm currently using. But only having one alarm is quite the show-stopper for me at the moment.

My ideal WebRadio alarm clock would have the following additional features besides what you already built:
- 2 (or more) Alarms that can be set/repeated per individual weekday. Pretty much what you already implemented but more than one alarm.
- Tickbox to completely enable/disable each alarm.
- Maybe an additional single alarm that is active once and is not repeated.
- A snooze hard-button to stop the sound for 10min or so.
- Each alarm automatically stops after 1 hour with no user input.
- A on/off hard-button. If music is playing from an alarm, it stops the alarm and turns off. Otherwise it plays/stops the station/music-source last played.
- Hard-buttons for alarm 1 and 2. Pressing each brings me to the respective alarm settings panel. Long-Pressing enables/disables each alarm.

Before I invest hundreds of hours, trying to fully understand your code and figuring out how to add one or two more alarms, I was wondering if you might already have similar plans for your project. I might be able to implement some of the hard-buttons myself eventually, but figuring out how to add additional alarms in your design might be a bit too much for me to implement myself. But first I'd have to add SD card support to my hardware design anyway to even try out your code. So I'll stick to my prototype code for the moment and keep an eye on your wonderful project to see what else is coming.

I would apreciate some feedback if there is anything I would like to see is already planned for a future release.

Kind regards

Thomas

schreibfaul1, 2024-04-10:
Hi Thomas,
thanks for your suggestions. At the moment there are no plans to change anything about the alarm function, that is something for the future. In the loop() _alarmdays and _alarmtime are queried and compared with the current time. Perhaps this is a starting point for your own developments.
The use of buttons for different functions would be unproblematic with the ESP32-S3, but fails due to the lack of GPIOs with the ESP32.
Initially planned are a progress indicator for files being played from the SD card, as well as skipping forwards and backwards. And the reactivation of menuconfig for better settings in the WiFi area and for memory allocation. And the integration of the BT emitter into the display.

MyAir, 2024-04-12:
Thanks for the update
In that case I'll update my hardware and see if I can get your software up and running as well.
I'll have a look at _alarmday and _alarmtime to see if I can manage upgrading to a second alarm myself.

Closed 2024-04-12.

Thread 394 (2024-04-14):

A1S Audiokit with V3.01b

steevemadison75, 2024-04-14:
Hi , the last working version that work on my A1S Audiokit is v2.17 , i tried yesterday to compile your new version with visual code
and i get " no space left on device " , if i remember the audiokit has 4MB flash and 4MB psram , i did setup my platform.ini as usual ,
(same config on v2.17)
board_build.partitions = boards/miniwebradio4MB.csv    ; 4MB Flash
board = ESP32-Dev-4MB            ; 4MB Flash

i tried to comment AC101.h and WM8978.h in common.h to not use those library ,
i also put -1 on all bluetooth BT_EMITTER_ as i dont have this module , i even tried to comment
the KCX_BT_Emitter.h , by doing this i get compilation error so i uncomment it

did find one version of the V3 that i could compile , it look like it worked , but i get garbage sound , (similar to a FM radio not on station)

got any clue ??

PS im not new at your webradio , i was one of the first to use a rasberry tft , and you help me to calibrate the screen and i request
some function in the web search by tag search

thank for your work

schreibfaul1, 2024-04-15:
Hi @steevemadison75,
probably in Arduino V3 there is no default for the I2C frequency. I have now manually entered the 400KHz that used to be set automatically. My AI Thinker board with AC101 is now working. These are the values in common.h:

````c++
#ifdef CONFIG_IDF_TARGET_ESP32
    // Digital I/O used
        #define TFT_CS 22
        #define TFT_DC 5
        #define TFT_BL -1
        #define TP_IRQ 12
        #define TP_CS 13
        #define SD_MMC_D0 2 // cannot be changed
        #define SD_MMC_CLK 14 // cannot be changed
        #define SD_MMC_CMD 15 // cannot be changed
        #define IR_PIN -1
        #define TFT_MOSI 23 // TFT and TP (VSPI)
        #define TFT_MISO 19 // TFT and TP (VSPI)
        #define TFT_SCK 18 // TFT and TP (VSPI)

        #define I2S_DOUT 25 // pin 25 AC101, pin 26 ES8388
        #define I2S_DIN 35 // pin not used
        #define I2S_BCLK 27
        #define I2S_LRC 26  // pin 26 AC101, pin 25 ES8388
        #define I2S_MCLK 0

        #define I2C_DATA 33
        #define I2C_CLK 32
        #define SD_DETECT 34 // some pins on special boards: Lyra, Olimex, A1S ...
        #define HP_DETECT 39
        #define AMP_ENABLED 21

        #define BT_EMITTER_RX    -1  // TX pin - KCX Bluetooth Transmitter (-1 if not available)
        #define BT_EMITTER_TX    -1  // RX pin - KCX Bluetooth Transmitter (-1 if not available)
        #define BT_EMITTER_LINK  -1  // high if connected                  (-1 if not available)
        #define BT_EMITTER_MODE  -1  // high transmit - low receive        (-1 if not available)
#endif
````
If you have the new board with ES8388 you have to change it a bit. And yes, the board has 4MB FLASH and PSRAM, please perform a "Full Clean" beforehand so that the libraries are fetched again. The BT_Emitter triggered a click every second, this has now also been eliminated.

schreibfaul1, 2024-04-17:
Yes, unfortunately that is the case at the moment. We are still using a pre-compiled Arduino version. Once the bugs have been fixed and settings can be made via menuconfig again, the WiFi data throughput will be the same as with version 2.

steevemadison75, 2024-04-18:
oh , ok , thank's for your time , i'll wait for a fix at later time , keep up the good work.

P.S i'm using your radio everyday and i really enjoy it

Closed 2024-06-01.

Thread 396 (2024-04-15):

Radio reset due to discharge of static electricity

clear-sky, 2024-04-15:
If at a distance of less than one meter, the static  electricity of the body is discharged due to contact with metal objects, the radio will be reset. Have you had such an experience?
my radio does not have any case

schreibfaul1, 2024-04-15:
An electrostatic discharge must not lead to a reset. Please take a look at the log at the very beginning:
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

 There you can see the field strength with the connected network. It should never be lower than -50dB. Some users complain about poor reception with Chinese S3 boards.

clear-sky, 2024-04-15:
Hi Dear wolle!
thanks for the answer
you are right -- my mcu is ESP-S3-12K 8m --my radio is on my desk and distance between radio and wifi router is 1m but rssi is something between -49 to -54
sometimes when i sit on the chair or touch metal objects radio resets!
what is your opinion using an antenna? something like this one:
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

schreibfaul1, 2024-04-15:
Have a look at the issue
"Display und SD Probleme #395"
The user has the same problems and has scratched the aerial free and soldered on a short piece of wire. No idea if it helps, but it might work.

clear-sky, 2024-04-16:
Hi dear Wolle!
thanks for the answer-I plan to use a metal box for the radio, so the WiFi reception will be worse, I will also use a WiFi antenna, if the result is good, I will announce here.

clear-sky, 2024-04-22:
Hi dear Wolle!
finally my radio is finished!
i made MWR in a metal case and used wifi antenna
reception is good (there is no reset)-i can not say excellent because i have problem in in serial monitor and can not see real resault
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

schreibfaul1, 2024-04-22:
This has turned out very nicely.

The monitor speed is 512000. I have increased it so that not too much time is used for the output. The serial terminal in VSCode gets the `monitor_speed` from platfornio.ini

clear-sky, 2024-04-22:
Hi dear valera39!
that box below of radio is for switch off and on my pc1 pc2  project radio and etc via 5 SSR and high and low voltage sensor with lm324
as you see FM radio is pre installed!!!
RTC is DS3234 with spi bus

valera39, 2024-04-22:
Is FM information displayed on the display?

clear-sky, 2024-04-22:
FM info is several parts: freq and vol info can be obtained from data bus(I2C)
other is called RDS that contains some info like station name-program info-program start and ending time etc
i live in iran and rds only gives me station name
bad news is fm audio path is directly from rda5807fp to pcm5102 though there is no possibility to have level meter
fm radio and rtc work but not combined to wolles code!
This design is not final and may have changes. I made this to make my desk a little quieter!!!
Mr. Wolle may consider a place as a gallery for users to post their final designs so that others can better get ideas.

schreibfaul1, 2024-04-22:
If you would like to publish the photos, I would be happy to do so with a link on the homepage

clear-sky, 2024-04-22:
I will definitely send you more complete pictures

clear-sky, 2024-04-22:
hi dear Wolle!
I tried to make the radio with simplest tools that every electronic user have it
sent some pictures! please check your mail!

clear-sky, 2024-04-22:
now i can say that wifi antenna is working well!!!
this is my rssi
`[  9423][I][WiFiMulti.cpp:263] run(): [WIFI] Connecting BSSID: 02:10:18:01:00:02 SSID: darmstadt Channel: 1 (-31)`

Closed 2024-04-16.

Thread 398 (2024-04-20):

IR Remote Control issue, only with ESP32 TTGO-T8 V1.7

TubaFonse, 2024-04-20:
Hallo Wolle @schreibfaul1 - "Großer Meister" bitte um Hilfe , diesmal in Deutsch; ist für mich leichter, mein Problem etwas klarer zu schildern - es wäre super, wenn dies jemand mit dem ESP32 TTGO-T8 ausprobieren könnte, da ich alleine nicht mehr weiter komme ...

Hardware: ESP32 TTGO-T8 V1.7 Modul (D0WDQ6-V3 ext 4M-Flash ext 4M-PSRAM) + ILI9341 + PCM5102A + IR VS1838B.

Mit der IR-Fernbedienung funktioniert das MiniWebRadio-V3 (das Umschalten der Sender und sonstiger Funktionen) nur sporadisch, d.h. mehrmaliges Drücken der gleichen Taste auf der FB ist nötig, bis der ESP32 irgendwann einmal den Code/das Signal vom VS1838B erkennt. Schon bei den IR-Settings über das WEB-Interface (Programmieren der Tastenfunktionen) habe ich das gleiche sporadische Fehlverhalten. Auf dem Serial Monitior sehe ich den Code entsprechend auch nur sporadisch (habe mit CORE_DEBUG_LEVEL=4 d.h. DEBUG compiliert). Bei diesen Aussetzern wird kein Fehler angezeigt - d.h. von 10x Drücken der Taste auf der FB wir das Signal wenn ich Glück habe nur 3x vom ESP32 erkannt und am Serial Monitor korrekt ausgegeben.
Für den IR-Pin habe ich statt GPIO 35 am ESP32 versuchsweise mal einen anderen freien GPIO (z.B. IO 4) probiert - jedoch ohne Erfolg - um Konflikte mit etwaigen Restriktionen auf dem Board auszuschließen, da dort der IO 35 beim ESP32 TTGO-T8 mit jeweils 100kOhm zwischen VBAT und GND beschaltet ist. Die Versorgungsspannungen, auch am IR-Empfänger sind stabil und sauber, die Batterien der FB sind in Ordnung, identisches Fehlverhalten habe ich auch mit anderen Fernbedienungen (NEC-Code). Was nun?

Mittlerweile befürchte ich, dass evtl. das ESP32 TTGO-T8 V1.7 Modul trotz 4M-Flash und 4M-PSRAM im aktuellen MWR-V3 Funktionsumfang an der Leistungsgrenze ist, wenn diese Aussetzer mit der IR-Fernbedienung auftreten - was meinst Du?
Anregung/Vorschlag:
Es wäre gut, wenn man Funktionen wie das VU-Meter, die ggf. viel Prozessorleistung schlucken, bei der Konfiguration z.B. common.h vor dem Compilieren deaktivieren zu können, um die Fehlersuche bei etwaigen Performance-Problemen zu erleichtern. Auch könnten mit dieser Option aktuelle Funktionen des MWR-V3 auf älterer ESP32-Hardware evtl. wieder zum Laufen gebracht werden.
Das "VU-Meter" finde ich ja ganz "nett", würde aber lieber darauf verzichten, bevor Grundfunktionen des tollen MWR-V3 nicht mehr stabil funktionieren.
Frage: Wäre aus Deiner Sicht des "Fachmanns" eine solche individuelle "Konfigurierbarkeit" mit vertretbarem Aufwand realisierbar?
Ich bin mir sicher, dass dies auch bei anderen Nutzern in diesem Forum großes Interesse wecken könnte.

Vergleich: Mit einem ESP32-_S3_ WROOM-1-_N16R8_ funktioniert mit gleicher Fernbedienung und gleichem IR-Empfänger alles sofort beim ersten Tastendruck - Performance-Engpass oder Konflikte mit Restricted GPIO's wären beim schwächeren _ESP32_ mit 4M-Flash und 4M-PSRAM demnach denkbar - aber wie ist dies mit den Möglichkeiten in PlatformIO messbar und darstellbar? Als Anfänger kenne ich mich da zu wenig aus und hoffe auf Deine geduldige Hilfe ...

Danke & Grüße - Alfons.

TubaFonse, 2024-04-20:
Jetzt habe ich mal eine kurze, ungewöhnliche Ausgabe auf dem Serial Monitor, während das Radio ein paar Stunden lief
 - OHNE dass ich die Fernbedienung betätigt habe!!! -
vielleicht hilft das zur Fehlersuche weiter (compiliert mit CORE_DEBUG_LEVEL=4):

21:15:20 StreamTitle: Chairmen Of The Board - Give Me Just A Little More Time
[10722646][D][IR.cpp:152] loop(): something went wrong, intval_l 1552459160, intval_h 0, pulsecounter 24
[10725741][D][IR.cpp:152] loop(): something went wrong, intval_l 3, intval_h 0, pulsecounter 24

Gruß, Alfons.

TubaFonse, 2024-04-20:
beim Sender-Umschalten (über Touch-Display) hängt sich das aktuelle MWR-V3 auch manchmal auf:

00:09:03 StreamTitle: Peter, Paul & Mary - Lemmon Tree
00:09:05 action: ...  switch to station 8
00:09:05 AUDIO_info:  Connect to new host: "http://frontend.streams.arabella.at/arabella-goldenoldies/stream/mp3"
[1582149][V][ssl_client.cpp:342] stop_ssl_socket(): Cleaning SSL connection.
00:09:05 AUDIO_info:  buffers freed, free Heap: 94292 bytes
[1582164][D][NetworkManager.cpp:131] hostByName(): DNS found IPv4 88.209.21.46
00:09:05 AUDIO_info:  Connection has been established in 44 ms, free Heap: 94080 bytes
00:09:05 AUDIO_info:  redirect to new host "http://edge13.streams.arabella.at/arabella-goldenoldies/stream/mp3"
00:09:05 AUDIO_info:  Connect to new host: "http://edge13.streams.arabella.at/arabella-goldenoldies/stream/mp3"
[1582233][V][ssl_client.cpp:342] stop_ssl_socket(): Cleaning SSL connection.
00:09:05 AUDIO_info:  buffers freed, free Heap: 91052 bytes
[1582326][D][NetworkManager.cpp:131] hostByName(): DNS found IPv4 57.128.47.6
00:09:05 AUDIO_info:  Connection has been established in 114 ms, free Heap: 94020 bytes
[1584859][E][Audio.cpp:3659] parseHttpResponseHeader(): timeout
00:09:10 HTML_info:   "change_state=0"
00:09:10 HTML_info:   "getmute"

TubaFonse, 2024-04-20:
Die häufigen "txt overflow" (Abschneiden des StreamTitle) auf dem Display,
kann das noch bereinigt werden? Abhängig vom Decoder (AAC) oder von der Größe des Displays?
Oder sind das Fehler, die vom jeweiligen Sender verursacht, d.h. nicht ordnungsgemäß generiert / übertragen werden?

00:17:14 action: ...  switch to station 7
00:17:14 AUDIO_info:  Connect to new host: "http://edge05.streams.arabella.at/arabella-austropop"
[2070992][V][ssl_client.cpp:342] stop_ssl_socket(): Cleaning SSL connection.
00:17:14 AUDIO_info:  buffers freed, free Heap: 94728 bytes
[2071067][D][NetworkManager.cpp:131] hostByName(): DNS found IPv4 51.210.216.57
00:17:14 AUDIO_info:  Connection has been established in 95 ms, free Heap: 94136 bytes
00:17:14 icy-descr:   Arabella Austropop
00:17:14 StationName: Arabella Austropop
00:17:14 icy-url: ..  https://www.arabella.at
00:17:14 AUDIO_info:  AACDecoder has been initialized, free Heap: 65984 bytes , free stack 4588 DWORDs
00:17:14 lastURL: ..  http://edge05.streams.arabella.at/arabella-austropop
00:17:14 AUDIO_info:  stream ready
00:17:14 AUDIO_info:  syncword found at pos 0
00:17:14 AUDIO_info:  Channels: 2
00:17:14 AUDIO_info:  SampleRate: 22050
00:17:14 AUDIO_info:  BitsPerSample: 16
00:17:14 AUDIO_info:  BitRate: 71662
00:17:14 AUDIO_info:  AAC HeaderFormat: ADTS
00:17:14 AUDIO_info:  AAC Codec: MPEG-4 LowComplexity
00:17:14 StreamTitle: DEPECHE AMBROS - I BIN A WEH
00:17:14 Audiocodec:  AAC
00:17:18 txt overflow, winHeight=100, strlen=28, written=23, str=DEPECHE AMBROS - I BIN A WEH
00:17:18 HTML_info:   "change_state=0"
00:17:18 HTML_info:   "getmute"
00:17:29 StreamTitle: ANDREAS GAUDMANN - PANIK
00:17:29 txt overflow, winHeight=100, strlen=24, written=19, str=ANDREAS GAUDMANN - PANIK

TubaFonse, 2024-04-20:
Bei MP3-Sendern erscheinen auch viele Fehlermeldungen (siehe MP3 decode error) im Serial Monitor, bevor gespielt wird - ist das "normal" oder sollte da auch noch was optimiert werden, um die Stabilität / Performance zu verbessern? z.B.:

23:49:16 set_IR_cmd:  IR command 0x52, IR Button Number 0x08
23:49:25 ir_code: ..  IR address 0x00, IR command 0x4a
23:49:27 ir_result:   Stationnumber 9
23:49:27 action: ...  switch to station 9
23:49:27 AUDIO_info:  Connect to new host: "http://c3.auracast.net:8010/stream"
[404319][V][ssl_client.cpp:342] stop_ssl_socket(): Cleaning SSL connection.
23:49:27 AUDIO_info:  buffers freed, free Heap: 94656 bytes
[404350][D][NetworkManager.cpp:131] hostByName(): DNS found IPv4 213.32.121.34
23:49:27 AUDIO_info:  Connection has been established in 56 ms, free Heap: 94048 bytes
23:49:27 StationName: Best Oldies
23:49:27 bitRate:     128Kbit/s
23:49:27 icy-url: ..  http://www.shoutcast.com
23:49:27 AUDIO_info:  MP3Decoder has been initialized, free Heap: 57328 bytes , free stack 4588 DWORDs
23:49:27 lastURL: ..  http://c3.auracast.net:8010/stream
23:49:27 AUDIO_info:  stream ready
23:49:27 AUDIO_info:  syncword found at pos 0
23:49:27 AUDIO_info:  MP3 decode error -2 : MAINDATA_UNDERFLOW
23:49:27 AUDIO_info:  syncword found at pos 35
23:49:27 AUDIO_info:  syncword found at pos 0
23:49:27 AUDIO_info:  MP3 decode error -6 : INVALID_FRAMEHEADER
23:49:27 AUDIO_info:  syncword found at pos 59
23:49:27 AUDIO_info:  syncword found at pos 0
23:49:27 AUDIO_info:  MP3 decode error -8 : INVALID_SCALEFACT
23:49:27 AUDIO_info:  syncword found at pos 169
23:49:27 AUDIO_info:  syncword found at pos 0
23:49:27 AUDIO_info:  MP3 decode error -6 : INVALID_FRAMEHEADER
23:49:27 AUDIO_info:  syncword found at pos 131
23:49:27 AUDIO_info:  syncword found at pos 0
23:49:27 AUDIO_info:  MP3 decode error -6 : INVALID_FRAMEHEADER
23:49:27 AUDIO_info:  syncword found at pos 19
23:49:27 AUDIO_info:  syncword found at pos 0
23:49:27 AUDIO_info:  MP3 decode error -2 : MAINDATA_UNDERFLOW
23:49:27 AUDIO_info:  syncword found at pos 72
23:49:27 AUDIO_info:  syncword found at pos 0
23:49:27 AUDIO_info:  MP3 decode error -6 : INVALID_FRAMEHEADER
23:49:27 AUDIO_info:  syncword found at pos 173
23:49:27 AUDIO_info:  syncword found at pos 0
23:49:27 AUDIO_info:  MP3 decode error -9 : INVALID_HUFFCODES
23:49:27 AUDIO_info:  syncword found at pos 170
23:49:27 AUDIO_info:  syncword found at pos 0
23:49:27 AUDIO_info:  MP3 decode error -9 : INVALID_HUFFCODES
23:49:27 AUDIO_info:  syncword found at pos 417
23:49:27 AUDIO_info:  syncword found at pos 0
23:49:27 AUDIO_info:  MP3 decode error -9 : INVALID_HUFFCODES
23:49:27 AUDIO_info:  syncword found at pos 128
23:49:27 AUDIO_info:  syncword found at pos 0
23:49:27 AUDIO_info:  MP3 decode error -6 : INVALID_FRAMEHEADER
23:49:27 AUDIO_info:  syncword found at pos 6
23:49:27 AUDIO_info:  syncword found at pos 0
23:49:27 AUDIO_info:  Channels: 2
23:49:27 AUDIO_info:  SampleRate: 44100
23:49:27 AUDIO_info:  BitsPerSample: 16
23:49:27 AUDIO_info:  BitRate: N/A
23:49:27 Audiocodec:  MP3
23:49:28 AUDIO_info:  MP3 decode error -6 : INVALID_FRAMEHEADER
23:49:28 AUDIO_info:  syncword found at pos 95
23:49:28 AUDIO_info:  syncword found at pos 0
23:49:28 AUDIO_info:  MP3 decode error -9 : INVALID_HUFFCODES
23:49:28 AUDIO_info:  syncword found at pos 73
23:49:28 AUDIO_info:  syncword found at pos 0
23:49:28 AUDIO_info:  MP3 decode error -6 : INVALID_FRAMEHEADER
23:49:28 AUDIO_info:  syncword found at pos 28
23:49:28 AUDIO_info:  syncword found at pos 0
23:49:28 AUDIO_info:  MP3 decode error -8 : INVALID_SCALEFACT
23:49:28 AUDIO_info:  syncword found at pos 142
23:49:28 AUDIO_info:  syncword found at pos 0
23:49:28 StreamTitle: John Fred & His Playboy Band - Judy In Disguise
23:49:28 AUDIO_info:  MP3 decode error -9 : INVALID_HUFFCODES
23:49:28 AUDIO_info:  syncword found at pos 2
23:49:28 AUDIO_info:  syncword found at pos 0
[404662][I][mp3_decoder.cpp:1642] DecodeHuffmanPairs(): (tabType != invalidTab)
23:49:28 AUDIO_info:  MP3 decode error -9 : INVALID_HUFFCODES
23:49:28 AUDIO_info:  syncword found at pos 53
23:49:28 AUDIO_info:  syncword found at pos 0
23:49:28 AUDIO_info:  MP3 decode error -6 : INVALID_FRAMEHEADER
23:49:28 AUDIO_info:  syncword found at pos 114
23:49:28 AUDIO_info:  syncword found at pos 0
23:49:28 AUDIO_info:  Channels: 2
23:49:28 AUDIO_info:  SampleRate: 44100
23:49:28 AUDIO_info:  BitsPerSample: 16
23:49:28 AUDIO_info:  BitRate: 128000

TubaFonse, 2024-04-21:
@schreibfaul1 Achtung: Mein ESP32 TTGO-T8 V1.7 Modul, Chip: D0WDQ6-V3 hat ein 4M-Flash (ext)
und ein ext **_8M_**-PSRAM (nicht 4M-PSRAM wie oben erwähnt).

In der platformio.ini unter [ESP32] sind nur die unterschiedlichen Flash-Größen definiert, nicht jedoch die Größe und Art des PSRAM. Braucht man beim ESP32 keine zusätzlichen Optionen für die TTGO-Module mit unterschiedlichen Quad PSRAM Größen (4M, 8M) unter [ESP32]?
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
Kann das evtl. die Ursache für mein o.g. IR-Problem sein, oder ist die Größe des PSRAM beim ESP32 für das MiniWebRadio V3 nicht relevant, sondern nur beim ESP32-S3?

Gruß, Alfons.

schreibfaul1, 2024-04-21:
Hallo Alfons,
ziemlich viel text, ich fange mal bei Punkt 1  (IR Empfänger) an:
Wenn die Fernbedienung nur sporadisch funktioniert kann das mehrere Ursachen haben.
Es könnte z.B. ein konstruktives Problem sein. Die IR Empfänger sind für HF Störungen sehr empfindlich. Daher sind sie häufig in ein Metallgehäuse verkapselt. Vielleicht ist der Empfänger zu nahe an der WiFi Antenne? Oder der Signalanschluss führt an dieser vorbei? Ein Abstand von ~3cm wäre ausreichend.
Es gibt die unterschiedlichsten IR Empfänger. Manche haben einen "open collector" Ausgang um mehrere parallel schalten zu können. Dann wird gegenüber einem TTL Ausgang ein PullUp Widerstand (1...10KOhm) benötigt. Gerade wichtig bei ESP32 "input only" Pin da dieser intern kein PullUp bereitstellt. Wie auch immer, es gibt manche, die funktionieren nicht richtig oder deren Frequenz ist nicht 38KHz.
Ich nehme gerne die:
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

gibts bei Am..on. Hatte noch nie Probleme damit. Du kannst die Fernbedienung auch gegen die Decke richten oder gegen die Wand, funktioniert immer.

Punkt2: ESP32 TTGO-T8 V1.7 habe ich auch im Einsatz in meiner Testumgebung. Nach meiner Erfahrung gibt es nur "hat PSRAM" oder "hat kein PSRAM". Es gibt eine Unterscheidung nach quad/octal wie beim S3. Die Größe wird automatisch erkannt, wenn dein Board 8MB hat, dann wird das auch iḿ Log stehen:
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
meins ist älter, hat nur 4MB

Punkt3: muss noch offen bleiben. Bisher wird anhand der Textlänge abgeschätzt welche Schriftgröße benutzt wird damit der Test in das Feld passt. Manchmal reicht es halt nicht, dann wird der Rest abgeschnitten und "txt overflow" erscheint.

Punkt4: die Fehlermeldungen der Dekoder. Im Prinzip wird ein Stream mit dem Beginn eines Rahmens eröffnet. Am Anfang eines Rahmens stehen Informationen für den Dekoder wir Samplerate oder Anzahl der Kanäle...
Wenn das nicht so ist, wird ein Synchronwort gesucht, der den Anfang eines Rahmens kennzeichnet. Manchmal ist das Synchronwort zufällig in der Audiosequenz enthalten. dann komme es zu diesen Fehlermeldungen. Das werde ich künftig reduzieren. Dafür gibt es Routinen wie `MP3FindFreeSync()` die hab ich bisher nicht in Benutzung.

beste Grüße
Wolle

TubaFonse, 2024-04-21:
Hallo Wolle, danke für Deine Infos zu Punkt 2 bis 4,
Ergänzung zu meinem Punkt-1 (IR-Problem) und Deinen Tipps dazu:
a) Meine IR-Fernbedienung und die beiden identischen IR-Empfänger funktionieren problemlos: Die FB sendet einwandfrei und beide IR-Empfänger geben die empfangenen Signale gleichzeitig an den jeweils konfigurierten IR-Eingang des ESP32 bzw. ESP32-S3 weiter! Es sieht so aus, wie wenn die decodierten IR-Signale immer am ESP32 GPIO 35 anliegen, jedoch vom ESP32 meist ignoriert werden, weil er zu "beschäftigt" mit anderen Tasks ist und dieser IR-"Interrupt" nur sporadisch "durchkommt", wenn gerade mal eine Lücke zwischen den Tasks ist.
b) Um die Vermutung zu bestätigen, habe ich 2 Versuchsaufbauten im Abstand von 15cm hintereinander, die ich nur mit einer IR-Fernbedienung gleichzeitig steuere. Der eine Aufbau ist mit ESP32 TTGO-T8 V1.7, der andere mit ESP32-S3 WROOM-1-N16R8.
Deshalb schließe ich mal Probleme auf der IR-Sender und IR-Empfänger-Seite aus, da ich untereinander die Bauteile beliebig tauschen kann - am ESP32-S3 funktionierts immer, am ESP32 nur ca. 1 mal von 10 Versuchen hintereinander. Ein Pull-Up von 10k am IR-Eingang des ESP32 ändert daran nichts.
c) welche GPIOs verwendest Du in Deiner ESP32 TTGO-T8 V1.7 Testumgebung? Wenn bei Dir mit der aktuellen Konfiguration und FW die IR-Steuerung problemlos funktioniert, würde ich das mal auf dem Breadboard genauso nachbauen, um meinen Fehler einzugrenzen. Kann ja sein, dass genau mein Controller spinnt ... mein Board hat auch 4MB PSRAM laut Serial Monitor:
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

Hier mein Versuchsaufbau:
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
Grüße - Alfons.

TubaFonse, 2024-04-21:
Hallo Wolle, IR-Remote läuft jetzt mit meinem ESP32 TTGO-T8 V1.7 sauber !!!
Dank Deines Tipps "HF-Einstrahlung" habe ich nochmal meinen Aufbau kontrolliert. Ich hätte es wirklich nicht für möglich gehalten - mein IR-Empfänger am ESP32 war tatsächlich zu nah an der WiFi-Antenne. IR-Empfänger ein paar Zentimeter weiter weg platziert und schon funktioniert alles. Auch hat womöglich noch zusätzlich das Licht meiner LED-Deckenbeleuchtung Störungen im 38kHz-Bereich verursacht. Endlich wieder ein Erfolgserlebnis und ein Stück schlauer geworden!!!

zu Punkt3 Problem "txt overflow" könnte man ja als durchlaufenden Text auf den Displays realisieren, wenn der Platz bei kleinster Schriftgröße nicht mehr ausreicht - wie bei anderen Internetradios auf dem Markt (wäre doch wieder eine Fleißaufgabe für Wolle ;-)
zu Punkt4 "Fehlermeldungen der Decoder" hast Du ja auch schon Ideen zur Optimierung, freut mich ...

Dann werde ich dieses "IR Remote Issue" schließen, da ja Punkt3 und Punkt4 mit meinem ursprünglichen Problem nichts zu tun hat.

Danke nochmals und Gruß - Alfons

schreibfaul1, 2024-04-21:
super, falls du die Möglichkeit hast, kannst du den IR Empfänger gegen den oben erwähnten TSOP4838 tauschen. Der ist um Größenordnungen empfindlicher und mach weniger HF Probleme.

TubaFonse, 2024-04-21:
danke, werde gleich welche bestellen - Gute Nacht!

schreibfaul1, 2024-04-22:
Ergänzung zu Punkt 4:
-ERR_MP3_MAINDATA_UNDERFLOW im MP3 Dekoder und Folgefehler

das habe ich jetzt abgefangen. Jetzt werden mehrere MP3 Frames "aufgefangen" bis eine Dekodierung sinnvoll ist. Die ganze Palette von Fehlermeldungen werden jetzt nicht mehr kommen.
Damit das wirksam wird ist  wie immer "Full Clean" erforderlich.

Closed 2024-04-21.

Thread 400 (2024-04-22):

IR remote range is very low!!!

clear-sky, 2024-04-22:
The range of the remote control is very low, it doesn't even work from a distance of 2 meters. I use the same remote control for another project, which works easily from a distance of 10 meters!

steve6375, 2024-04-22:
If nothing is blocking the infra-red light transmission (e.g. glass), maybe the signal is bad. Noisy power supply? Long wires? add pullup resistor?

clear-sky, 2024-04-22:
none of them--- i think the problem is the protocol of my remote that is NEC-extented and wait for Wolle's opinion

schreibfaul1, 2024-04-22:
There are a wide variety of IR receivers on the market.
Some do not have a TTL output but are "open collector". A pull-up resistor is then required.
Although some receivers are encapsulated in a metal housing, there is still an influence from the WiFi field. The greatest possible distance from the WiFi antenna is required.  If it has to be very sensitive (because greater distances have to be bridged), a TSOP4838 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
is the first choice. This is absolutely insensitive to interference radiation.

clear-sky, 2024-04-22:
Hi Dear Wolle!
thanks for the answer- my receiver is vs838
i have made your dotmatris esp8266 clock and have added ir remote to it with the same receiver
in both project environment wifi exist and i use an ir remote for both
ir remote range in clock in 10m is nice but  in MWR is not more than 1 m
have you tested your remote range?

clear-sky, 2024-04-22:
this is my interface and pullup resistor value is 22K
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

clear-sky, 2024-04-26:
Hi dear Wolle!
I could not find tsop4838 in iran market but have a question
according to this datasheet tsop4838 is 3.3v compatible
https://www.vishay.com/docs/82459/tsop48.pdf
---what is the reason you have used 5v for  powering it?
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

schreibfaul1, 2024-04-26:
I operate the TSOP4838 with 5V. According to the data sheet, the maximum voltage is 5.5V. The advantage is the suppression of interference pulses. Your IR receiver will be more sensitive if you move it as far away as possible from sources of interference.

clear-sky, 2024-04-26:
in my opinion using ir recievers with pullup resistor will damage the mcu
technically this way is not correct

clear-sky, 2024-05-07:
This method reminds me  of high voltage heart shock

clear-sky, 2024-12-21:
for users that can not find tsop4838 in market:
i could not find tsop4838 in market and vs838 or vs1838 did not work properly in this project
i found another IR sensor that work great with this project : HS0038
this sensor does NOT need pullup resistor on data line
note that this sensor has various versions in market : HS0038 - HS0038A2 - HS0038A2D
HS0038 and HS0038A2 works only with 5V but HS0038A2D works with 2.5V up to 5.5V
i used HS0038A2 with 3.3V supply and now the working range increased up to 10 meters!
_many many thanks dear wolle!_

schreibfaul1, 2024-12-21:
Thanks for the tip, the HS0038 seems to be readily available on the major online platforms.

clear-sky, 2024-12-22:
for users that want to see this sensor
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

Closed 2024-06-22.

Thread 402 (2024-04-22):

reset radio when using device monitor

clear-sky, 2024-04-22:
Hi Dear Wolle!
when i want to use device monitor radio drops in a loop of resets
this is my config in platformio.ini
```
[common]

monitor_speed = 115200  ; 921600, 512000, 460800, 256000, 115200
```
please look at my terminal output:
>> pio device monitor
```

Please build project in debug configuration to get more details about an exception.
See https://docs.platformio.org/page/projectconf/build_configurations.html

--- Terminal on /dev/ttyUSB0 | 115200 8-N-1
--- Available filters and text transformations: colorize, debug, default, direct, esp32_exception_decoder, hexlify, log2file, nocontrol, printable, send_on_enter, time
--- More details at https://bit.ly/pio-monitor-filters
--- Quit: Ctrl+C | Menu: Ctrl+T | Help: Ctrl+T followed by Ctrl+H
RON),boot:0x8 (SPI_FAST_FLASH_BOOT)
SPIWP:0xee
mode:DIO, clock div:1
load:0x3fce3818,len:0x508
load:0x403c9700,len:0x4
=> 0x403c9700: ?? ??:0
load:0x403c9704,len:0xad0
=> 0x403c9704: ?? ??:0
load:0x403cc700,len:0x29d8
=> 0x403cc700: ?? ??:0
entry 0x403c9880
=> 0x403c9880: ?? ??:0
[  1288][I][esp32-hal-psram.c:92] psramInit(): PSRAM enabled

ESP32 Chip: ESP32-S3
Arduino Version: 3.0.0
ESP-IDF Version: 5.1.3
MiniWebRadio     Version 3.01f  Apr 18/2024
ARDUINO_LOOP_STACK_SIZE 8192 words (32 bit)
FLASH size 8388608 bytes, speed 80 MHz
CPU speed 240 MHz
SDMMC speed 20 MHz
TFT speed 40 MHz
PSRAM total size: 8388608 bytes
RESET_REASON: Reset due to power-on event

00:00:00
00:00:00        ***************************
00:00:00        *     MiniWebRadio V3     *
00:00:00        ***************************
00:00:00
00:00:00 setup: ....  Arduino is pinned to core 1
00:00:00 tft_info: .  init ST7796
00:00:01 setup: ....  Init SD card
00:00:01 setup: ....  SD card found, 3827.0 MB by 3861.0 MB free
[  1889][I][esp32-hal-ledc.c:131] ledcAttachChannel(): LEDC attached to pin 10 (channel 0, resolution 8)
00:00:02 setup: ....  seek for stations.csv
00:00:02 setup: ....  stations.csv found
00:00:02 setup: ....  seek for WiFi networks
[  2926][I][WiFiMulti.cpp:90] addAP(): [WIFI][APlistAdd] add SSID: darmstadt
[  9410][I][WiFiMulti.cpp:134] run(): [WIFI] scan done
[  9416][I][WiFiMulti.cpp:139] run(): [WIFI] 5 networks found
[  9423][I][WiFiMulti.cpp:263] run(): [WIFI] Connecting BSSID: 02:10:18:01:00:02 SSID: darmstadt Channel: 1 (-31)
[  9434][W][STA.cpp:548] disconnect(): STA already disconnected.
[  9538][I][WiFiMulti.cpp:283] run(): [WIFI] Connecting done.
00:00:09 WiFI_info:   Connecting WiFi...
00:00:09 WiFI_info:   mDNS name: MiniWebRadio
00:00:09 setup: ....  connected to darmstadt, IP address is 192.168.1.3
00:00:09 ftpServer:   Buffers allocated: 4622 bytes
00:00:09 rtime_info:  Initializing SNTP
03:30:09 rtime_info:  Waiting for system time to be set... (1/10)
03:30:11 rtime_info:  Waiting for system time to be set... (2/10)
00:37:02 rtime_info:  00:37:02
00:37:02 audiotask:   is pinned to core 0
00:37:02 audiotask:   priority is 2
00:37:02 setup: ....  Number of saved stations: 69
00:37:02 setup: ....  current station number: 4
00:37:02 setup: ....  current volume: 1
00:37:02 setup: ....  last connected host: http://uk3.internet-radio.com:8405/live
00:37:02 setup: ....  connection timeout: 500 ms
00:37:02 setup: ....  connection timeout SS�ESP-ROM:esp32s3-20210327
Build:Mar 27 2021
rst:0x1 (POWERON),boot:0x8 (SPI_FAST_FLASH_BOOT)
SPIWP:0xee
mode:DIO, clock div:1
load:0x3fce3818,len:0x508
load:0x403c9700,len:0x4
=> 0x403c9700: ?? ??:0
load:0x403c9704,len:0xad0
=> 0x403c9704: ?? ??:0
load:0x403cc700,len:0x29d8
=> 0x403cc700: ?? ??:0
entry 0x403c9880
=> 0x403c9880: ?? ??:0
[  1288][I][esp32-hal-psram.c:92] psramInit(): PSRAM enabled

ESP32 Chip: ESP32-S3
Arduino Version: 3.0.0
ESP-IDF Version: 5.1.3
MiniWebRadio     Version 3.01f  Apr 18/2024
ARDUINO_LOOP_STACK_SIZE 8192 words (32 bit)
FLASH size 8388608 bytes, speed 80 MHz
CPU speed 240 MHz
SDMMC speed 20 MHz
TFT speed 40 MHz
PSRAM total size: 8388608 bytes
RESET_REASON: Reset due to power-on event

00:00:00
00:00:00        ***************************
00:00:00        *     MiniWebRadio V3     *
00:00:00        ***************************
00:00:00
00:00:00 setup: ....  Arduino is pinned to core 1
00:00:00 tft_info: .  init ST7796
00:00:01 setup: ....  Init SD card
00:00:01 setup: ....  SD card found, 3827.0 MB by 3861.0 MB free
[  1889][I][esp32-hal-ledc.c:131] ledcAttachChannel(): LEDC attached to pin 10 (channel 0, resolution 8)
00:00:02 setup: ....  seek for stations.csv
00:00:02 setup: ....  stations.csv found
00:00:02 setup: ....  seek for WiFi networks
[  2926][I][WiFiMulti.cpp:90] addAP(): [WIFI][APlistAdd] add SSID: darmstadt
```

clear-sky, 2024-04-25:
Hi dear wolle!
as you know I use a bare esp-s3-12k module
i solved the problem but part of it!
soldered a 2.2uf + 100nf between EN pin and ground
now reset has been solved but i give unclear characters in serial monitor please see:
>> pio device monitor

```
Please build project in debug configuration to get more details about an exception.
See https://docs.platformio.org/page/projectconf/build_configurations.html

--- Terminal on /dev/ttyUSB0 | 115200 8-N-1
--- Available filters and text transformations: colorize, debug, default, direct, esp32_exception_decoder, hexlify, log2file, nocontrol, printable, send_on_enter, time
--- More details at https://bit.ly/pio-monitor-filters
--- Quit: Ctrl+C | Menu: Ctrl+T | Help: Ctrl+T followed by Ctrl+H
ESP-ROM:esp32s3-20210327
Build:Mar 27 2021
rst:0x1 (POWERON),boot:0x8 (SPI_FAST_FLASH_BOOT)
SPIWP:0xee
mode:DIO, clock div:1
load:0x3fce3818,len:0x508
load:0x403c9700,len:0x4
=> 0x403c9700: ?? ??:0
load:0x403c9704,len:0xad0
=> 0x403c9704: ?? ??:0
load:0x403cc700,len:0x29d8
=> 0x403cc700: ?? ??:0
entry 0x403c9880
=> 0x403c9880: ?? ??:0
[  1281][I][esp32-hal-psram.c:92] psramInit(): PSRAM enabled

ESP32 Chip: ESP32-S3
Arduino Version: 3.0.0
ESP-IDF Version: 5.1.3
MiniWebRadio     Version 3.01f  Apr 18/2024
ARDUINO_LOOP_STACK_SIZE 8192 words (32 bit)
FLASH size 8388608 bytes, speed 80 MHz
CPU speed 240 MHz
SDMMC speed 20 MHz
TFT speed 40 MHz
PSRAM total size: 8388608 bytes
RESET_REASON: Reset due to power-on event

00:00:00
00:00:00        ***************************
00:00:00        *     MiniWebRadio V3     *
00:00:00        ***************************
00:00:00
00:00:00 setup: ....  Arduino is pinned to core 1
00:00:00 tft_info: .  init ST7796
00:00:01 setup: ....  Init SD card
00:00:01 setup: ....  SD card found, 3827.0 MB by 3861.0 MB free
[  1882][I][esp32-hal-ledc.c:131] ledcAttachChannel(): LEDC attached to pin 10 (channel 0, resolution 8)
00:00:02 setup: ....  seek for stations.csv
00:00:02 setup: ....  stations.csv found
00:00:02 setup: ....  seek for WiFi networks
[  2919][I][WiFiMulti.cpp:90] addAP(): [WIFI][APlistAdd] add SSID: darmstadt
[ 10002][I][WiFiMulti.cpp:134] run(): [WIFI] scan done
[ 10008][I][WiFiMulti.cpp:139] run(): [WIFI] 8 networks found
[ 10015][I][WiFiMulti.cpp:263] run(): [WIFI] Connecting BSSID: 02:10:18:01:00:02 SSID: darmstadt Channel: 1 (-31)
[ 10026][W][STA.cpp:548] disconnect(): STA already disconnected.
[ 10120][I][WiFiMulti.cpp:283] run(): [WIFI] Connecting done.
00:00:09 WiFI_info:   Connecting WiFi...
00:00:09 WiFI_info:   mDNS name: MiniWebRadio
00:00:09 setup: ....  connected to darmstadt, IP address is 192.168.1.3
00:00:09 ftpServer:   Buffers allocated: 4622 bytes
00:00:09 rtime_info:  Initializing SNTP
03:30:09 rtime_info:  Waiting for system time to be set... (1/10)
03:30:11 rtime_info:  Waiting for system time to be set... (2/10)
03:30:13 rtime_info:  Waiting for system time to be set... (3/10)
23:17:47��W�}�nf� 0�3��7�MM���5)���17��_�^v�хϭ�����)��ngf toجrg �[��+���$��׿��)�����Ͻ铁�������is6�
��&��Ң݁͵�]\f��������ɕ�Ձstcv}on �ber� ��6�4��5-2��Γ�ׁ�]�?�vr�������W�t"vol����u������
  ��������^��ѥ���ݗ"��76�700�[�S�ms�[�mc!������Ձ����遹�������˿ctkn"timuowt Ӻ��[36m�^L�����
         �kmۘ�C��n���א�,���:�.>.  cu���t�v��][{�z?ڴ������5)��f���4]ȧ%�n��ɑ�R�����.Ҵ7���30���7���+Ӛ�j;�6Qӂ�[���l����.>�����Hֿ���������͖�W��
�:ڗ�i�e��atio.lשּׁk������5�2�����فX�w��["rvs��ݥ�c�"vo*sv,�o~ �[��[���[JJ����فժR굹��>�����jC�nngst"��nuw h��� �h�����빥��ɹ]]I�����com:840ӵ��o"
J��ʻҢ݉�U�S���f�������K*�[�ە됻�&&Ӵj_▒23:1���Size�ț��Ձ�y�]jKH�����ћ���%=����遁�ff�_��ꕹvo������S�}��Xv���K��t:"UDvw&�����
2�:3�:v7(AWTIO_y�녁m[���PR(�Ջ���=��-4"nowõp~gzit��+����r.����݃M��YX[�ձY��m�͉����ɥsnskr�s$�����(W�k+��*6vKj���ݭI]��m}��������ҫ͔����5�rvgr?�&�gdi�!�K�er�f�u~���}Y��ջ��^�׫����.���74��+��Hțښ���> S�X�o���ٯ����[*K�kӧ߃JuoY��I�e�#JkGH��݊*���=W9�j��L際ZZ��url>�r������hvvrs�//�ן�+je>�kj����
                                     �a�ڻ�����ӵ5)���1w:>6 A��Y__info�" �o�P(�k��롡�n�֫�
      )�+�����镓,0fzee �^p:*1���]&���Y�$        �K�����X֛���́��Z�om�m]
:3:5�����ast�ŵKs��m��w����\�멭ݹ��ѕۻ�ѽɅ����coo:8��Ӊ+����[C�.����م����Kٕ�鐙��������ח�w�_��fﹰ���mc�Z�+�˓ѽ�сm}ٽ��m��m/
���\ҫ��U5-=_鷳K����ɽ����X�$�V6V-*6&������
�T���nf[��[ۓ�{罍�ۓ���ջ���щ��́132;[1��%��ʺڢ��A�D٧�i��o�}m��[W����ɑ��չ���t��͑�=
2�:����
_��ꕹ��끑m�S�����׋����ɽr0/3 :$��VSLID_AVTS�H�A�ݵ�k5��/�ӻ�ݡ�]��ݹ��邁�[32osy��K�*�o��YXz]خk����ѻJj������݁]YZk�۫�:r";[33�SS������Ң݁A]LR�չ��鐑���j����ݽɑ��չсa���k��C��������!P�S�ꥹ���*�Czcnn��./$��+S��������݁�U�R����ˉ�mm�ɵU�
                                                      ��K�_�����0��+��l$�����7�Q�SRꥹ��遑��ɽ    ���C��]��������
```

clear-sky, 2024-04-25:
As soon as the system succeeds to get the time, the terminal crashes!!!

schreibfaul1, 2024-04-25:
I can't say exactly what this could be. It probably has nothing to do with the speed of the terminal. It could be a corrupted "settings.json". You can delete this file from the SD card and it will be recreated.

clear-sky, 2024-04-25:
thanks for the answer- your hint did not work ! problem is another thing

clear-sky, 2024-04-26:
Hi dear wolle!
thanks for the answer
yes it always happens in the same place!!! even i open device monitor after boot will give a crashed terminal
i changed time zone to berlin and newyork and toronto via web interface but problem remains

Closed 2024-06-10.

Thread 405 (2024-04-26):

Sleep Mode

valera39, 2024-04-26:
Hi Dear Wolle!
When you put the radio into sleep mode using the button on the remote control and then exiting it by pressing the same button, the radio reboots with this image
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
port monitor:

`Esp32ExceptionDecoder:` disabling, firmware at C:\Arduino\ESP32-MiniWebRadio\.pio\build\esp32s3\firmware.elf does not exist, rebuild the project?
--- Terminal on COM5 | 512000 8-N-1
--- Available filters and text transformations: colorize, debug, default, direct, esp32_exception_decoder, hexlify, log2file, nocontrol, printable, send_on_enter, time
--- More details at https://bit.ly/pio-monitor-filters
--- Quit: Ctrl+C | Menu: Ctrl+T | Help: Ctrl+T followed by Ctrl+H
����x���x�x�x�xx��xxx�x��xxxxxx�x�x�xxxxx��xx�x�xxxxxxx��xx�x��xxx�x�xxx�xx�xx�xxx���xx�x�

ESP32 Chip: ESP32-S3
Arduino Version: 3.0.0
ESP-IDF Version: 5.1.3
MiniWebRadio     Version 3.01f  Apr 18/2024
ARDUINO_LOOP_STACK_SIZE 8192 words (32 bit)
FLASH size 8388608 bytes, speed 80 MHz
CPU speed 240 MHz
SDMMC speed 80 MHz
TFT speed 40 MHz
PSRAM total size: 8388608 bytes
RESET_REASON: Reset due to power-on event

00:00:00
00:00:00        ***************************
00:00:00        *     MiniWebRadio V3     *
00:00:00        ***************************
00:00:00
00:00:00 setup: ....  Arduino is pinned to core 1
00:00:00 tft_info: .  init ILI9488
00:00:00 setup: ....  Init SD card
00:00:00 setup: ....  SD card found, 3761.6 MB by 3781.5 MB free
[   856][I][esp32-hal-ledc.c:131] ledcAttachChannel(): LEDC attached to pin 10 (channel 0, resolution 8)
00:00:01 setup: ....  seek for stations.csv
00:00:01 setup: ....  stations.csv found
00:00:01 setup: ....  seek for WiFi networks
[  2002][I][WiFiMulti.cpp:90] addAP(): [WIFI][APlistAdd] add SSID: ASUS_AC66U
[  7878][I][WiFiMulti.cpp:134] run(): [WIFI] scan done
[  7880][I][WiFiMulti.cpp:139] run(): [WIFI] 6 networks found
[  7881][I][WiFiMulti.cpp:263] run(): [WIFI] Connecting BSSID: 2C:FD:A1:C2:44:F0 SSID: ASUS_AC66U Channel: 1 (-54)
[  7884][W][STA.cpp:548] disconnect(): STA already disconnected.
[  7975][I][WiFiMulti.cpp:283] run(): [WIFI] Connecting done.
00:00:07 WiFI_info:   Connecting WiFi...
00:00:07 WiFI_info:   mDNS name: MiniWebRadio
00:00:07 setup: ....  connected to ASUS_AC66U, IP address is 192.168.1.130
00:00:07 ftpServer:   Buffers allocated: 4622 bytes
00:00:07 rtime_info:  Initializing SNTP
02:00:07 rtime_info:  Waiting for system time to be set... (1/10)
23:51:51 rtime_info:  23:51:51
23:51:51 audiotask:   is pinned to core 0
23:51:51 audiotask:   priority is 2
23:51:51 setup: ....  Number of saved stations: 92
23:51:51 setup: ....  current station number: 41
23:51:51 setup: ....  current volume: 3
23:51:51 setup: ....  last connected host: https://radio.sweetmelodies.tk:8000/stream1
23:51:51 setup: ....  connection timeout: 500 ms
23:51:51 setup: ....  connection timeout SSL: 2000 ms
23:51:51 action: ...  current volume is 3
23:51:51 WiFI_info:   RSSI is -55 dB
[ 10919][I][ArduinoOTA.cpp:141] begin(): OTA server at: MiniWebRadio.local:3232
23:51:52 action: ...  switch to station 41
23:51:52 AUDIO_info:  Connect to new host: "https://radio.sweetmelodies.tk:8000/stream1"
23:51:52 AUDIO_info:  PSRAM found, inputBufferSize: 638965 bytes
23:51:52 AUDIO_info:  buffers freed, free Heap: 178160 bytes
23:51:52 AUDIO_info:  SSL has been established in 384 ms, free Heap: 140040 bytes
23:51:52 StationName: Sweet Melodies
23:51:52 bitRate:     128Kbit/s
23:51:52 icy-url: ..  https://sweetmelodies.tk/
23:51:52 AUDIO_info:  AACDecoder has been initialized, free Heap: 140100 bytes , free stack 3228 DWORDs
23:51:52 lastURL: ..  https://radio.sweetmelodies.tk:8000/stream1
23:51:52 AUDIO_info:  stream ready
23:51:52 AUDIO_info:  syncword found at pos 0
23:51:52 AUDIO_info:  Channels: 2
23:51:52 AUDIO_info:  SampleRate: 44100
23:51:52 AUDIO_info:  BitsPerSample: 16
23:51:52 AUDIO_info:  BitRate: 160207
23:51:52 AUDIO_info:  AAC HeaderFormat: ADTS
23:51:52 AUDIO_info:  AAC Codec: MPEG-4 LowComplexity
23:51:53 StreamTitle: Mantovani - I Write The Songs
23:51:53 Audiocodec:  AAC
23:51:53 ftpServer:   Ftp server waiting for connection on port 21
23:51:54 BT-Emitter:  KCX_BT_Emitter not found
23:51:59 DLNA_server: [0] 192.168.1.1:8200  RT-AC66U_B1-44F0
23:52:00 DLNA_server: 1 media server found
23:52:02 ir_code: ..  IR address 0x00, IR command 0x16
[ 23274][I][main.cpp:3224] ir_long_key(): long pressed key nr: 10
[ 23421][W][STA.cpp:157] _onStaArduinoEvent(): Reason: 8 - ASSOC_LEAVE
23:52:05 falling asleep
23:52:37 ir_code: ..  IR address 0x00, IR command 0x16
23:52:37 awake
[ 56172][W][STA.cpp:548] disconnect(): STA already disconnected.
[ 57921][I][WiFiMulti.cpp:134] run(): [WIFI] scan done
[ 57922][I][WiFiMulti.cpp:139] run(): [WIFI] 4 networks found
[ 57924][I][WiFiMulti.cpp:263] run(): [WIFI] Connecting BSSID: 2C:FD:A1:C2:44:F0 SSID: ASUS_AC66U Channel: 1 (-56)
[ 57927][W][STA.cpp:548] disconnect(): STA already disconnected.
[ 58008][I][WiFiMulti.cpp:283] run(): [WIFI] Connecting done.
START WIFI
23:52:39 WiFi connected
23:52:39 AUDIO_info:  Connect to new host: "https://radio.sweetmelodies.tk:8000/stream1"
Guru Meditation Error: Core  0 panic'ed (InstructionFetchError). Exception was unhandled.

Core  0 register dump:
PC      : 0x3c247d74  PS      : 0x00060830  A0      : 0x820a711c  A1      : 0x3fcbe320
A2      : 0x3fcba6a8  A3      : 0x3c2fcaa0  A4      : 0x00000000  A5      : 0x00060a23
A6      : 0xb33fffff  A7      : 0xb33fffff  A8      : 0x8210c62c  A9      : 0x3fcbe2e0
A10     : 0x00000010  A11     : 0x3c2fcaa0  A12     : 0x3fceecc0  A13     : 0x00000000
A14     : 0x00000000  A15     : 0x00000000  SAR     : 0x0000001a  EXCCAUSE: 0x00000002
EXCVADDR: 0x3c247d74  LBEG    : 0x40056f5c  LEND    : 0x40056f72  LCOUNT  : 0xffffffff

Backtrace: 0x3c247d71:0x3fcbe320 |<-CORRUPTED

ELF file SHA256: 11d0c1f7068867e1

Rebooting...
xxxxxxx�x�x�xxx�xxx���xxxx��x�xxx��xx�x�xxxxxxx�x�xxx�xxxxxx�xxxxxx�x��x�xx�xxxxxxxxxxxxxxxxxxxxxx�xx�xxx�x�������x�xxxxxx�xxxxx�x�x�xxx�xxx��x�xxxx�x�x�x�x�xx�xxxxxx�xxx�x�xxx�x�xx����x��x�xxx�x��x�x�xx����x���x�xxx�x�xx�x�xx����xx�x�xxx�x�xxxxx��xx���xx����x���x�x�x�x�xx��xxx�x��xxxxxx�x�x�xxxxx��xx�x�xxxxxxx��xx�x��xxx�x�xxx�xx�xx�xxx���xx�x�

ESP32 Chip: ESP32-S3
Arduino Version: 3.0.0
ESP-IDF Version: 5.1.3
MiniWebRadio     Version 3.01f  Apr 18/2024
ARDUINO_LOOP_STACK_SIZE 8192 words (32 bit)
FLASH size 8388608 bytes, speed 80 MHz
CPU speed 240 MHz
SDMMC speed 80 MHz
TFT speed 40 MHz
PSRAM total size: 8388608 bytes
RESET_REASON: Software reset due to exception/panic

21:52:39
21:52:39        ***************************
21:52:39        *     MiniWebRadio V3     *
21:52:39        ***************************
21:52:39
21:52:39 setup: ....  Arduino is pinned to core 1
21:52:39 tft_info: .  init ILI9488
21:52:40 setup: ....  Init SD card
21:52:40 setup: ....  SD card found, 3761.6 MB by 3781.5 MB free
[   863][I][esp32-hal-ledc.c:131] ledcAttachChannel(): LEDC attached to pin 10 (channel 0, resolution 8)
21:52:41 setup: ....  seek for stations.csv
21:52:41 setup: ....  stations.csv found
21:52:41 setup: ....  seek for WiFi networks
[  2009][I][WiFiMulti.cpp:90] addAP(): [WIFI][APlistAdd] add SSID: ASUS_AC66U
[  7486][I][WiFiMulti.cpp:134] run(): [WIFI] scan done
[  7488][I][WiFiMulti.cpp:139] run(): [WIFI] 6 networks found
[  7490][I][WiFiMulti.cpp:263] run(): [WIFI] Connecting BSSID: 2C:FD:A1:C2:44:F0 SSID: ASUS_AC66U Channel: 1 (-52)
[  7492][W][STA.cpp:548] disconnect(): STA already disconnected.
[  7573][I][WiFiMulti.cpp:283] run(): [WIFI] Connecting done.
21:52:46 WiFI_info:   Connecting WiFi...
21:52:46 WiFI_info:   mDNS name: MiniWebRadio
21:52:46 setup: ....  connected to ASUS_AC66U, IP address is 192.168.1.130
21:52:46 ftpServer:   Buffers allocated: 4622 bytes
21:52:46 rtime_info:  Initializing SNTP
23:52:46 rtime_info:  23:52:46
23:52:46 audiotask:   is pinned to core 0
23:52:46 audiotask:   priority is 2
23:52:46 setup: ....  Number of saved stations: 92
23:52:46 setup: ....  current station number: 41
23:52:46 setup: ....  current volume: 3
23:52:46 setup: ....  last connected host: https://radio.sweetmelodies.tk:8000/stream1
23:52:46 setup: ....  connection timeout: 500 ms
23:52:46 setup: ....  connection timeout SSL: 2000 ms
23:52:47 setup: ....  volume is muted: (from 3)
23:52:47 WiFI_info:   RSSI is -54 dB
[  8519][I][ArduinoOTA.cpp:141] begin(): OTA server at: MiniWebRadio.local:3232
23:52:47 RESET_REASON:Software reset due to exception/panic
23:52:48 ftpServer:   Ftp server waiting for connection on port 21
23:52:49 BT-Emitter:  KCX_BT_Emitter not found
23:52:55 DLNA_server: [0] 192.168.1.1:8200  RT-AC66U_B1-44F0
23:52:55 DLNA_server: 1 media server found
23:53:05 WiFI_info:   RSSI is -50 `dB`

Re-flashed with a full cleanup and re-downloaded the project again.
Thanks for your hard work and hope you will add FM radio soon. I think [clear-sky](https://github.com/clear-sky) will be happy too :)

clear-sky, 2024-04-27:
Hi Dear valera39!
long press is for hardware buttons and using it with remote is rediculus !
due to ir remote #402 problem when you long press buttons in most cases it drops in mute mode before !
i had asked from wolle to add ir buttons to avoid this problems #245 #309 #359
hope he pay attention to your ask!

valera39, 2024-04-27:
Hi Dear [clear-sky](https://github.com/clear-sky)!
I still have the radio on the second version and there with a button on the remote it goes to sleep and wakes up with no problem. But in the third version it doesn't do that

valera39, 2024-04-27:
[clear-sky](https://github.com/clear-sky), I think a remote like this would be perfect for the radio.
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
[https://aliexpress.ru/item/4000876148513.html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](url)
Let's ask the esteemed Wolle to do so

clear-sky, 2024-04-28:
Hi Dear [valera39](https://github.com/valera39) !
Choosing the type of remote completely depends on everyone's taste!
These types of remotes have several problems that are unbearable for me. First, they have hard buttons
  Second, due to the use of a coin battery that has little power and therefore its range is very low. Third, if it is used a lot, the battery will be empty very quickly.
Larger remotes that work with AA or AAA batteries do not have the problems of the previous remotes. I use a special type of them that is raw and does not have a special code in them. You can save the codes of several remotes in this remote and use one remote instead of all. these remotes is called  "universal" or "learning"
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

clear-sky, 2024-04-28:
The next news is that the initial esp32-p4 boards were introduced and are being tested by early developers. The processor is dual-core and works at a speed of 400 MHz and can easily display full HD videos at a speed of 30 frames per second. Maybe Mr. Wolle, seeing this board, will leave the development of radio and start a new project called MWTV---who knows!!!
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

valera39, 2024-05-06:
Hi Dear Wolle!
I never heard your answer to my question. Can this problem be solved with a reboot?

schreibfaul1, 2024-05-06:
There will be a new version in which this and other errors are eliminated. If I change something in the master now, I have problems transferring the dev branch via PR. Please be patient.
The lowering of the CPU frequency and the disconnection of the WiFi has not proved successful and will no longer exist in "SLEEP mode".

valera39, 2024-05-06:
Thanks, I just thought you hadn't noticed the error.

valera39, 2024-05-24:
Hi Dear Wolle!
Is it possible to disable KCX_BT_Emitter activity in sleep mode?

ESP32 Chip: ESP32-S3
Arduino Version: 2.0.16
ESP-IDF Version: 4.4.7
MiniWebRadio     Version 3.1   May 21/2024
ARDUINO_LOOP_STACK_SIZE 8192 words (32 bit)
FLASH size 8388608 bytes, speed 80 MHz
CPU speed 240 MHz
SDMMC speed 80 MHz
TFT speed 40 MHz
PSRAM total size: 8381431 bytes
RESET_REASON: Reset due to power-on event

00:00:00
00:00:00        ***************************
00:00:00        *     MiniWebRadio V3     *
00:00:00        ***************************
00:00:00
00:00:00 setup: ....  Arduino is pinned to core 1
00:00:00 tft_info: .  init ILI9488
00:00:00 setup: ....  Init SD card
00:00:00 setup: ....  SD card found, 3761.4 MB by 3781.5 MB free
00:00:01 setup: ....  seek for stations.csv
00:00:01 setup: ....  stations.csv found
00:00:01 setup: ....  seek for WiFi networks
[  2345][I][WiFiMulti.cpp:84] addAP(): [WIFI][APlistAdd] add SSID: ASUS_AC66U
[  2367][I][WiFiMulti.cpp:84] addAP(): [WIFI][APlistAdd] add SSID: Honor
00:00:03 setup: ....  5 WiFi networks found
00:00:03 setup: ....  ASUS_AC66U (-57)
00:00:03 setup: ....  TP-LINK_E345E0_RPT (-74)
00:00:03 setup: ....  TP-LINK_E345E0 (-75)
00:00:03 setup: ....  ASUS_AC66U_RPT (-76)
00:00:03 setup: ....  GG (-82)
[ 10080][I][WiFiMulti.cpp:114] run(): [WIFI] scan done
[ 10086][E][WiFiMulti.cpp:117] run(): [WIFI] no networks found
[ 10093][E][WiFiMulti.cpp:191] run(): [WIFI] no matching wifi found!
00:00:09 WiFI_info:   WiFi credentials are not correct
00:00:09 RECONNECTION try 1
[ 10100][I][WiFiMulti.cpp:84] addAP(): [WIFI][APlistAdd] add SSID: ASUS_AC66U
[ 10123][I][WiFiMulti.cpp:84] addAP(): [WIFI][APlistAdd] add SSID: Honor
00:00:11 setup: ....  5 WiFi networks found
00:00:11 setup: ....  ASUS_AC66U (-59)
00:00:11 setup: ....  TP-LINK_E345E0_RPT (-71)
00:00:11 setup: ....  TP-LINK_E345E0 (-75)
00:00:11 setup: ....  ASUS_AC66U_RPT (-76)
00:00:11 setup: ....  GG (-81)
[ 18380][I][WiFiMulti.cpp:114] run(): [WIFI] scan done
[ 18386][I][WiFiMulti.cpp:119] run(): [WIFI] 4 networks found
[ 18392][I][WiFiMulti.cpp:160] run(): [WIFI] Connecting BSSID: 2C:FD:A1:C2:44:F0 SSID: ASUS_AC66U Channel: 9 (-59)
[ 18473][I][WiFiMulti.cpp:174] run(): [WIFI] Connecting done.
00:00:17 WiFI_info:   Connecting WiFi...
00:00:17 WiFI_info:   mDNS name: MiniWebRadio
00:00:17 setup: ....  connected to ASUS_AC66U, IP address is 192.168.1.130
[ 18514][I][ArduinoOTA.cpp:141] begin(): OTA server at: MiniWebRadio.local:3232
00:00:17 ftpServer:   Buffers allocated: 4622 bytes
00:00:17 rtime_info:  Initializing SNTP
02:00:17 rtime_info:  Waiting for system time to be set... (1/10)
13:46:51 rtime_info:  13:46:51
13:46:51 audiotask:   is pinned to core 0
13:46:51 audiotask:   priority is 2
13:46:51 AUDIO_info:  commFMT = 1
13:46:51 setup: ....  Number of saved stations: 92
13:46:51 setup: ....  current station number: 42
13:46:51 setup: ....  current volume: 2
13:46:51 setup: ....  last connected host: http://163.172.77.142:8006/;stream/1
13:46:51 setup: ....  connection timeout: 500 ms
13:46:51 setup: ....  connection timeout SSL: 2000 ms
13:46:52 action: ...  switch to station 42
13:46:52 AUDIO_info:  Connect to new host: "http://163.172.77.142:8006/;stream/1"
13:46:52 AUDIO_info:  PSRAM found, inputBufferSize: 638965 bytes
13:46:52 AUDIO_info:  buffers freed, free Heap: 166804 bytes
13:46:52 AUDIO_info:  Connection has been established in 42 ms, free Heap: 165824 bytes
13:46:53 StationName: Ā«majorasĀ»
13:46:53 bitRate:     96Kbit/s
13:46:53 icy-url: ..  https://xocotakamu.jimdo.com/
13:46:53 AUDIO_info:  MP3Decoder has been initialized, free Heap: 165128 bytes , free stack 4996 DWORDs
13:46:53 lastURL: ..  http://163.172.77.142:8006/;stream/1
13:46:53 WiFI_info:   RSSI is -59 dB
13:46:53 Audiocodec:  MP3
13:46:53 ftpServer:   Ftp server waiting for connection on port 21
13:46:53 BT-Emitter:  KCX_BT_Emitter found
13:46:53 AUDIO_info:  stream ready
13:46:53 AUDIO_info:  syncword found at pos 0
13:46:53 StreamTitle: Cicci Guitar Condor - Theme-from-shane
13:46:53 AUDIO_info:  Channels: 2
13:46:53 AUDIO_info:  SampleRate: 44100
13:46:53 AUDIO_info:  BitsPerSample: 16
13:46:53 AUDIO_info:  BitRate: 96000
13:46:53 BT-Emitter:  Version KCX_BT_RTX_V1.4
13:46:53 BT-Emitter:  scanned: MacAdd:5f673c5cfaec,Name:MIBOX4
13:46:53 BT-Emitter:  CON MATCH ADD
13:46:53 BT-Emitter:  CONNECT=>MacAdd:5f673c5cfaec,Name:MIBOX4
13:46:53 BT-Emitter:  Volume -> 31
13:46:54 AUDIO_info:  slow stream, dropouts are possible
13:46:55 AUDIO_info:  slow stream, dropouts are possible
13:46:59 DLNA_server: [0] 192.168.1.1:8200  RT-AC66U_B1-44F0
[ 28547][E][DLNAClient.cpp:226] readHttpHeader(): content type not found
13:46:59 DLNA_server: [1] 192.168.1.4:6000  dlink-E247EB
13:46:59 DLNA_server: 2 media server found
13:47:07 BT-Emitter:  Status -> Scan...
13:47:08 ir_code: ..  IR address 0x00, IR command 0x16
13:47:08 BT-Emitter:  CON MATCH ADD
13:47:08 BT-Emitter:  CONNECT=>MacAdd:5f673c5cfaec,Name:MIBOX4
[ 39472][I][main.cpp:2847] ir_long_key(): long pressed key nr: 10
13:47:10 falling asleep
13:47:23 BT-Emitter:  CON MATCH ADD
13:47:23 BT-Emitter:  CONNECT=>MacAdd:5f673c5cfaec,Name:MIBOX4
13:47:39 BT-Emitter:  CON MATCH ADD
13:47:39 BT-Emitter:  CONNECT=>MacAdd:5f673c5cfaec,Name:MIBOX4
13:47:54 BT-Emitter:  CON MATCH ADD
13:47:54 BT-Emitter:  CONNECT=>MacAdd:5f673c5cfaec,Name:MIBOX4
13:48:10 BT-Emitter:  CON MATCH ADD
13:48:10 BT-Emitter:  CONNECT=>MacAdd:5f673c5cfaec,Name:MIBOX4

schreibfaul1, 2024-05-25:
This is a good idea. There is an AT command which switches off the BT emitter "AT-POWER_OFF". But there is none to switch it on. This can be done with the button on the board or with a short "H" pulse at the Connect input.
You need another GPIO for this. I have realised this for the ESP32-S3 and adapted the schematic. The ESP32 lacks free pins.

ve2cfb, 2024-05-26:
Hello Wolle,
I did some test using the AT-POWER_OFF and CONNECT with the basic  KCX_BT_Emitter code that is on your site and ir was promissing... Keep reading.
i Really need this option because been in a condo, the rooms are quite close and every device wants to connect to everybody. So i need to POWER OFF the BT only.  Like you said, the esp32 is missing an extra pin. I had to remove the IR option for the test.
On my Web Radio there is only 2 buttons, the Power On/Off and the BT On/Off. Both are latched buttons with Led. At one point, i had to let go since i had problems with the code. (who ever invented hold age, should be sent to Jupiter...)

Anyway.¸..
Is the AT-POWER_OFF and CONNECT code usable with the ESP32-S3 ...?

Thanks again.

schreibfaul1, 2024-05-26:
With the ESP32, GPIO12 would be free, this is a "strapping pin" and must be pulled to GND at startup. GPIO12 is therefore hardly applicable (possibly for the display backlight?) The pin for IR is "input only".
A short low pulse at CONNECT is required to wake up the BT emitter (~100ms)

ve2cfb, 2024-05-26:
Yes , now i remember why during my test, i stopped working with pin 35.
Did a quick look in the code and found the CONNECT section. Will see if it can do what i want.
Thanks again.

schreibfaul1, 2024-05-26:
Perhaps GPIO12 can be used for TFT_BL. I haven't tried it, but then GPIO32 would be free for BT-CONNECT.

ve2cfb, 2024-05-26:
Hello Wolle,
Since almost all the BT fnctions are already done, i would do the test with a ESP32S3 and later try to implement it on a ESP32.
You can tell me if it is possible.

Use a SPST Latched Switch.

**Here is my idea of sequence of operation using 2 GPIO.**
1. (Switch is in OFF position)  do a AT-POWER_OFF . At startup time or during normal operation.
2. (Switch is in ON position)  do a BT connect. At startup time or during normal operation.
3. (Switch is in OFF position)  do AT-POWER_OFF again. During normal operation.

Many thanks...

valera39, 2024-05-26:
Hi Dear Wolle!
I would like to propose you an idea, to show the clock in sleep mode, with the ability to disable this option in the settings. What do you think about it?

schreibfaul1, 2024-05-26:
The idea is good

valera39, 2024-06-12:
Hi Dear Wolle!
In order not to open a new topic, I'll ask here.
How to make the clock brightness in sleep mode less?

schreibfaul1, 2024-06-13:
This requires another setting option. Another idea would be to use a photodiode to control the brightness depending on the ambient light. But unfortunately there is no free pin on the ESP32.

valera39, 2024-06-13:
Great idea with the photodiode, it can be used for esp32s3 which has free pins. Shall we try it?

schreibfaul1, 2024-06-15:
A photodiode is probably not the right solution after all. There are too many with different properties or characteristics. I think a brightness sensor would be better, preferably with I2C. I will first see what is available on the big online platforms, the sensor must be available everywhere at an affordable price.

valera39, 2024-06-15:
For example, you can use the available GY-302 BH1750 Light Sensor

clear-sky, 2024-06-15:
Hi Dear valera39!
simple LDR works fine for me in wolle's matrix clock!

valera39, 2024-06-15:
[clear-sky](https://github.com/clear-sky)Hey!
Exactly, I would like the brightness to be dimmed in sleep mode.

Closed 2024-08-01.

Thread 408 (2024-05-06):

How to connect ESP32-S3-Wroom-1 with N16R8

tzvetan65, 2024-05-06:
Hello everyone,
   I decided to replace the ESP32 D32 with the ESP32-S3-Wroom-1 with N16R8, but the resulting devboard has a different pineout.
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
 How should it be connected?

clear-sky, 2024-05-06:
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

tzvetan65, 2024-05-10:
Hello, can no one help? I cannot understand how to connect this ESP with DAC and the display. Which conclusion to who is in line with. Please help, I want this radio!

tzvetan65, 2024-05-10:
Hello, can no one help? I cannot understand how to connect this ESP with DAC and the display. Which conclusion to who is in line with. Please help, I want this radio!

Arne65, 2024-05-10:
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

tzvetan65, 2024-05-10:
Hello,
Something weird, I don't see the answers under my question. When I write a new comment, I see an answer from before, I delete the comment as an out of date and the answer disappears. I apologize to the answers, I just don't see your answers, I don't know if the problem is on the site, it happens to me for the first time.

Jimbobnz, 2024-05-15:
I'm I needing to update the code to reflect the image above?
//ESP32-S3
#define I2S_DOUT      9     /*  DIN connection */
#define I2S_BCLK      3     /*  BCLK Bit clock */
#define I2S_LRC       1     /*  WSEL Left Right Clock */

tzvetan65, 2024-05-15:
I'm sorry, but I can't help. I'm not doing well with the software when I have a problem and I ask here. I hope someone will answer, greetings and success.

schreibfaul1, 2024-05-15:
The pins in the **CONFIG_IDF_TARGET_ESP32S3** section in "config.h" are only suggestions. You have much more freedom in the choice of pins than with the ESP32. What exactly is causing you difficulties?

tzvetan65, 2024-05-15:
Have I correctly understood the ARNE65 scheme, should the T_CS connection be removed with SCK and connect T_DO to SDO (MISO)? Do I have to connect the ESP32S3 display?
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

Arne65, 2024-05-15:
Hello
make the bridges as in the original schema.Bridge
SPI_SCK with SCK and of course SPI_MOSI with SOI(MOSI) as shown in the original schematic.

You can assign the pins like in common.h

This definitely works.

With the ESP 32-S3 you are more independent when it comes to pin assignment than with the ESP 32 S2 .

tzvetan65, 2024-05-15:
Thanks for the quick answers. Have I correctly realized that there should be three bridges
SDO(MISO) to T_DO
SDI(MOSI) to T_DIN
SCK to T_CLK

Arne65, 2024-05-15:
You  only need

DI(MOSI) to T_DIN
SCK to T_CLK

What kind of display do you use?

tzvetan65, 2024-05-16:
My display is 3.2 TFT SPI 240x320 V1.0. Maybe I'm misleading this scheme. Thanks.
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

Arne65, 2024-05-16:
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

tzvetan65, 2024-05-16:
Thank you, it's so much more understandable.

tzvetan65, 2024-05-17:
What can be the reason for this restart?

Arne65, 2024-05-17:
Send the output to the serial monitor, maybe you can see more.
All pins connected properly and voltage is correct?

tzvetan65, 2024-05-17:
I'm sorry, I don't know how to do it. For the first time I work with Arduino and everything is new and unknown to me.

tzvetan65, 2024-05-19:
Work !!! The Arne65 was right, the problem is in the supply voltage. Strange, the power source and the multimeter show me 4.95 volts, and I have 4.45 volts on the board.
   I have a question about ESP32, the RGB led shines very bright, the PWR red led shines normally, and the TX green led
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
barely visible. Is it normal. Or there is a problem with the module.
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

Arne65, 2024-05-19:
The RGB LED is very bright on the boards, so that's normal, but in my opinion it's nonsense - no one needs a "headlight" on the boards.

Normally you should measure around 3.3 V after regulation.

Input voltage 5V after the voltage regulator 3.3V.

tzvetan65, 2024-05-19:
Yes, at a voltage of 4.45 volts after the regulator I had 3.2 volts. I raised the supply voltage to 5.2 volts and now after the regulator I have 3.3 volts. There is now another problem - with an increase over 8 radio restarts, although the supply voltage does not fall and consumption is about 250 miliampers.

Arne65, 2024-05-19:
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

Start the serial monitor, maybe you can find out where your problem is

tzvetan65, 2024-05-19:
I turned on the serial monitor, in the command of the amplification or reduction of the sound, everything turns red. I do not understand what it means, but with a serial monitor, I strengthen it to 21 and do not restart. After the serial monitor is switched off, it restarts again with a reinforcement exceeding 8.
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

schreibfaul1, 2024-05-19:
I wonder if you are using an external DAC with I2C control, like ES8388. If you have a DAC without I2C, e.g. PCM5102, the pins I2C_DATA and I2C_CLK in common.h must be set to -1. If you do have an I2C DAC, then the wiring (SDA/SDC) is wrong.

Arne65, 2024-05-19:
Are you using an SD card adapter?
I think you have write protection turned on

tzvetan65, 2024-05-19:
My DAC is PCM5102, do I have to change values here? I tried a locked and unlocked card, the effect is the same. But I have a problem with the card, I upload new stations, but they can't play.

schreibfaul1, 2024-05-19:
If you do not have an audio board (AI Thinker , Lyra, Olimex), set 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 to 1 to deactivate I2C.

tzvetan65, 2024-05-19:
I changed the Decoder setting = 1 but my restart remained. Did I correctly set the type of ESP in Platformio.ini. Why is this getting this?
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

schreibfaul1, 2024-05-19:
You probably have an ESP32-S3, so please set this in the taskbar
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

 and then send a log of the restart

tzvetan65, 2024-05-19:
I changed the appearance of the board, but the restart remains. How to upload Log of the Restart? When the serial monitor is turned on, there is no restart, can it really be a power problem?
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

Arne65, 2024-05-21:
You have to press the reset button :)

tzvetan65, 2024-05-21:
I'm sorry for the panic, the reason for the restart was the power source. It clearly causes any interference to the ESP32. With another power supply works well. The next problem is communication with SD card, I add new stations, they are recorded on the card, but some of them radio does not choose them. It just doesn't change the station. I tried an unlocked and locked card, with and without a pullup resistor but no result. Any idea for this problem?

tzvetan65, 2024-05-24:
Give at least some joker. What is the difference in recording and reading from the SD card? Why does he record and not read the records? Or are the records incorrect and does not recognize them?
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

tzvetan65, 2024-06-04:
Come on, has no one had such a problem? Why are the stations recorded on the card and not read? Help please!

steve6375, 2024-06-04:
So if you press Save and then Load and then Save xlsx, are the stations are all in the saved xlsx filee?
if you load the xlsx file is the list is correct?
If you reset esp32, are the stations selectable now?
Can stations be selected and played on web GUI?
Can stations be selected and played on TFT screen GUI?
Give more details of the problem
If others have the problem it would have been reported

tzvetan65, 2024-06-05:
Hello,
The new stations are recorded in the xlsx files and in the SD card, but they are not selected and reproduced. In my opinion, the recordings are correct, but I do not understand enough. I also restarted the restart button and the power, but nothing changes. The stations cannot be selected and played through the TFT or GUI interface. Only some new stations can be selected and reproduced, but I don't understand what the reason is. I have surrounded the newcomers to the attached screenshots.
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

steve6375, 2024-06-05:
Maybe you can upload here your xlsx file and someone can try it?

tzvetan65, 2024-06-05:
Thanks Steve6375, your last comment has helped me understand what is happening. I tried to upload Stations.xlsx and did not find a file with this extension. It turns out OpenOffice saves the file with an extension (.ods) because, you see, it was a newer format. I recorded the file in the correct format and everything worked. Thanks!

Closed 2024-07-20.

Thread 418 (2024-05-15):

ESP32-S3 WROOM-1 | corrupted text on the serial monitor

Jimbobnz, 2024-05-15:
Trying this code for the first time and I'm getting this issue on ESP32-S3 WROOM-1 (SP32-S3-DevKitC-1-N16R8) with corrupted text.

Serial Monitor:
```
ESP-ROM:esp32s3-20210327
Build:Mar 27 2021
rst:0x1 (POWERON),boot:0x8 (SPI_FAST_FLASH_BOOT)
SPIWP:0xee
mode:DIO, clock div:1
load:0x3fce3818,len:0x508
load:0x403c9700,len:0x4
load:0x403c9704,len:0xad0
load:0x403cc700,len:0x29d8
entry 0x403c9880
[   414][I][esp32-hal-psram.c:92] psramInit(): PSRAM enabled
�&R2�"6�!y0y6��4
                �9%�4�%�gd'd�QC�'d
                                  $&$� c�4'�4�t$!$a1$A�46�$dP0$!U4$da1d 6$74fE$$6Ș4�$�It��4��t�8�� h{�rf�tg�f$�rfV%1�$8
                                                                                                                       nF�y61�g�84v�"$t�&cUd�� 7�
```

clear-sky, 2024-05-23:
Hi!
please see #402

schreibfaul1, 2024-05-23:
The TTL2USB chip (the CP2102 is often used) does not actually cause any problems. You can change the monitor speed in platfornio.ini at the top. The USB cable may be too long or of poor quality. You can reduce the speed for tests, e.g. 57600 Baud

clear-sky, 2024-05-23:
Hi dear Wolle!
I have this problem also!
my problem exactly happens when radio gets time from web due to #402
you suspected to `Timezone_String` but i suspected to another thing : `espota`
because espota is added to project from version 3
With great difficulty, I managed to go back to version 2, where this problem does not exist at all!!!

clear-sky, 2024-05-23:
Hi dear wolle!
i dont use vscode !
if possible please install platformio cli and test `pio device monitor`
you will see the problem

schreibfaul1, 2024-05-25:
That may be the case. OTA means that I do not have a direct connection via USB. You can achieve this by setting the port of e.g. Com or USB to "Auto". OTA is deactivated if you delete the upload port in platfornio.ini
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

clear-sky, 2024-05-25:
Hi Dear Wolle!
thanks for the answer-it is impossible to flash the mcu unless I disable upload port
did you test platformio cli?

Closed 2024-07-09.

Thread 424 (2024-05-22):

Change log 3.1

FranZatGIT, 2024-05-22:
Hi Wolle, what are the differences of 3.1 compared to 3.0. Is there something like a changelog?

Thank you

schreibfaul1, 2024-05-22:
The equaliser functions can now be set from the display. If you are using a BT transmitter, you can now also control it from the display. You can now set a separate alarm time for each day of the week. Internally, many elements are programmed in an object-oriented way, which increases reliability. Arduino is run as a component again, allowing for advanced settings. This increases the WiFi throughput, so that stations with up to 320KBit/s work smoothly again. Sometimes WiFi problems occur, such as unavailable DNS, which is now neutralised. The credentials are sent to the router up to 3 times, which is useful as some routers will deny access if the connection is briefly interrupted.

valera39, 2024-05-22:
And the mode of switching off when long pressing the * button has been fixed

schreibfaul1, 2024-05-23:
and I have added an "OFF" button, the red one,  to switch to sleep mode (sound off and display dark)
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

valera39, 2024-05-23:
Thanks, can I use the remote to put it in sleep mode?

FranZatGIT, 2024-05-23:
Hi Wolle, many thanks - all of that new things- really great. I uploaded the new version. A few things I noticed but I need to verify:

- I can add stations in the web tool , see it in the drop down list but i cannot select the new sender and its not in the list on the display
- The VU Meter are sometimese missing bars ( looks like an update issue)
- from time to time 192k sender (especially when changing to the sender ) have short interruptions/distortion
- I cannot see the new Off button ( 240*320 ILI9341) (equalizer and BT are there)

Just to mention it - I added some code lines for my implementation (Speaker relais, RGB LED, Power Control of Amplifier/Radio, Batterie Voltage check,...)  BUT for the above mentioned points that lines /Lib has been commented out

has anyone else recognized that point?

Thanks Franz

schreibfaul1, 2024-05-23:
Hi Valera,
that will work, the button you have assigned to "Mute" can switch sleep mode on and off.
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

schreibfaul1, 2024-05-23:
Hello Franz,

- if you have added a new station, the "new" station list is transferred to the NVS with the save button. You will find the station in the log. The NVS content is updated with the load button. This is the same routine as at startup. This is from the time when there was still a stations.cvs file. I will improve this
- The VU meter is not always drawn correctly, will be corrected soon
- I only recently added the Off button. The icon, 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, is probably missing and needs to be copied from the zip file.

FranZatGIT, 2024-05-25:
Hi Wolle,

- regarding Off Button:

well I again copied the whole content of the ZIP to the SD card   and the icon is there:
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
However  still no Icon on the display:
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

But please don't focus on that - that Button is'n really important to me ( I have the radio anyway running on battery and switch off the Power.

- Regarding new stations

What is really a pain is that I 'm not able to add new stations. No matter if I press load or save.

- Feature request / help request

I have some kind of feature request - I would like to display the Battery Voltage or the percentage of Battery in the headline (somewhere between the Fuction Name e.g. "Internet" and "Vol"). The Volatage is already read and calculated in the code - just need to add another object in the headline. I will try to do it myself but your code is quite complex  here - would you give me a help if needed?

FranZatGIT, 2024-05-25:
Hi again, regarding the Icon - you said you recently added the icon - does that just mean the JPG or also in the code?
The last time I pulled the code was a couple of days ago...

Thanks Franz

schreibfaul1, 2024-05-25:
All graphics are duplicated. Scaling an image with the ESP32 simply takes too long.
Therefore, there is always a (s)mall and (m)edium folder. If an image is not found, it can be seen in the log.

I have just added a station and created hardcopies.
[CommunityWebBrowser](https://github.com/schreibfaul1/ESP32-MiniWebRadio/blob/master/docs/Using%20the%20RadioBrowser.pdf) This is better than an explanation in text form.

How big is your battery? The project is an energy guzzler. Of course I can display the operating voltage.

FranZatGIT, 2024-05-26:
Hi Wolle,
Yes I saw the 2 folders for different screen resolutions when I tested different displays at the  beginning. The off button icons were there in both folders. So I pulled a complete fresh clone of the code files ( not SD)  from github an reapplied my changes. The icon is there and also adding a new station is possible again. No Idea what exactly happened but I assume i used a main.ccp version  before you added the new button...
So all good so far :) maybe adding a build number counter to the " Version 3.1   May 21/2024  " in the file comment would be great to recognize that some changes were done.

regarding the battery (see picture) - I use a 6s 18650 Battery for my project total of 66Wh. The ESP including Amp at moderate volume consumes about 2.5-4W  - so 15-20h play time - enough for me ;)  The device is not 100% ready but you can see also on the picture  (with Alu Heat sink) the charging board 140W PD3.1 - all USB C devices can be used to charge - from old Handy charger to a powerful Notebook power supply . And its bidirectional you can also use it as supply for the Handy or a notebook.
The Amp contains it's own BT receiver - The Radio can also be used a BT Box - in this case the ESP goes in sleep mode.

But back to the voltage - I would like to show the Battery Voltage / percentage in the headline. In my code amendment I already implemented a power down function when the battery voltage is to low. Meaning I already have the voltage in the code and calculation the percentage is also no rocket science - just adding a new object to the headline is a bit a challenge to me. (i'm just a DIY C++ "modifier" and don't have much knowledge/experience) I only partially understand your code. Any help much appreciated :)

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

FranZatGIT, 2024-05-27:
Hi Wolle,

i was able to find the relevant code lines :) The Battery percentage is now there.
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

schreibfaul1, 2024-05-27:
Very good!

schreibfaul1, 2024-05-27:
and very clean construction, may I use your photos for the gallery of user devices?

FranZatGIT, 2024-05-27:
Hi Wolle, sure - here are some more recent pics with LWL from charger board.  However the box itself is not finished yet - but you can imagine how i will look like...
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
![WhatsApp Bild 2024-05-27 um 23 38 18_fbd8ece2](https://github.com/schreibfaul1/ESP32
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
-MiniWebRadio/assets/162827986/ed84d3ea-7769-48bc-bfab-bb0aabcacd96)
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

schreibfaul1, 2024-05-28:
thank you, I have taken the photos
https://github.com/schreibfaul1/ESP32-MiniWebRadio/wiki/User-devices

FranZatGIT, 2024-05-28:
Thank you - I will send you updated pics when building of box is progressing

I studied the way you change the RSSI Symbol and did the same for the battery :)
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

Closed 2024-07-12.

Thread 438 (2024-05-28):

00:03:06 connection to NTP failed, trying again

RobinMosedale, 2024-05-28:
Dear Wolle,

I've checked
#390

It's cycling reset on NTP fail.

Perhaps I should default to the original German NTP and try again?

my platformio.ini looks ok:
```
[common]
build_flags =
    -D TFT_FONT=1 ; (0) GARAMOND, (1) TFT_TIMES_NEW_ROMAN, (2) TFT_FREE_SERIF_ITALIC, (3) TFT_ARIAL, (4) Z300
    -D NTP_Pool_1='"europe.pool.ntp.org"' ;note the double quotes
    -D NTP_Pool_2='"pool.ntp.org"'
    -D NTP_Pool_3='"time-a-g.nist.gov"'
    -D CORE_DEBUG_LEVEL=3                    ; 0 None, 1 Error, 2 Warn, 3 Info, 4 Debug, 5 Verbose
    -D CONFIG_ARDUHAL_LOG_COLORS=1
    -D ARDUINO_RUNNING_CORE=1                ; Arduino Runs On Core (setup, loop)
    -D ARDUINO_EVENT_RUNNING_CORE=0          ; Events Run On Core
    -D BOARD_HAS_PSRAM=1
    -Wall
    -Wextra
```
This is my settings.json which has been working until about 1900 hours GMT
`{"volume":6,"ringvolume":21,"alarmtime":1380,"alarm_weekdays":0,"timeAnnouncing":"false","mute":"false","brightness":100,"sleeptime":0,"lastconnectedhost":"http://as-hls-ww-live.akamaized.net/pool_904/live/ww/bbc_radio_fourfm/bbc_radio_fourfm.isml/bbc_radio_fourfm-audio%3d96000.norewind.m3u8","station":8,"sumstations":14,"Timezone_Name":"Europe/London","Timezone_String":"GMT0BST,M3.5.0/1,M10.5.0","toneLP":3,"toneBP":-4,"toneHP":0,"timeFormat":24}`

This is the platformio output, and the ESP32-S3-DevKitC-1-N32R8V Development which has been fine for weeks.
This now occors on both identical systems, prototype and hardwired

00:03:00
00:03:00        ***************************
00:03:00        *     MiniWebRadio V3     *
00:03:00        ***************************
00:03:00
00:03:00 setup: ....  Arduino is pinned to core 1
00:03:00 tft_info: .  init ILI9341
00:03:00 setup: ....  Init SD card
00:03:00 setup: ....  SD card found, 3818.3 MB by 3839.0 MB free
[   993][I][esp32-hal-ledc.c:131] ledcAttachChannel(): LEDC attached to pin 10 (channel 0, resolution 8)
00:03:00 setup: ....  seek for stations.csv
00:03:00 setup: ....  stations.csv found
00:03:00 setup: ....  seek for WiFi networks
[  1382][I][WiFiMulti.cpp:90] addAP(): [WIFI][APlistAdd] add SSID: TP-LINK_EB850C
[  1413][I][WiFiMulti.cpp:90] addAP(): [WIFI][APlistAdd] add SSID: TP-LINK_EB850C
[  1421][I][WiFiMulti.cpp:90] addAP(): [WIFI][APlistAdd] add SSID: Roise_4
[  1429][I][WiFiMulti.cpp:90] addAP(): [WIFI][APlistAdd] add SSID: Rose
[  1437][I][WiFiMulti.cpp:90] addAP(): [WIFI][APlistAdd] add SSID: Rosie_3
[  1445][I][WiFiMulti.cpp:90] addAP(): [WIFI][APlistAdd] add SSID: Rosiem
[  6705][I][WiFiMulti.cpp:134] run(): [WIFI] scan done
[  6711][I][WiFiMulti.cpp:139] run(): [WIFI] 5 networks found
[  6718][I][WiFiMulti.cpp:263] run(): [WIFI] Connecting BSSID: 60:E3:27:EB:85:0C SSID: TP-LINK_EB850C Channel: 1 (-36)
[  6729][W][STA.cpp:544] disconnect(): STA already disconnected.
[  6817][I][WiFiMulti.cpp:283] run(): [WIFI] Connecting done.
00:03:06 WiFI_info:   Connecting WiFi...
00:03:06 WiFI_info:   mDNS name: MiniWebRadio
00:03:06 setup: ....  connected to , IP address is 192.168.1.130
00:03:06 ftpServer:   Buffers allocated: 4622 bytes
00:03:06 connection to NTP failed, trying again
[  6869][W][STA.cpp:157] _onStaArduinoEvent(): Reason: 8 - ASSOC_LEAVE
ESP-ROM:esp32s3-20210327
Build:Mar 27 2021
rst:0xc (RTC_SW_CPU_RST),boot:0x2b (SPI_FAST_FLASH_BOOT)
Saved PC:0x4037b7de
=> 0x4037b7de: esp_cpu_wait_for_intr at /home/runner/work/esp32-arduino-lib-builder/esp32-arduino-lib-builder/esp-idf/components/esp_hw_support/cpu.c:121
SPIWP:0xee
Octal Flash Mode Enabled
For OPI Flash, Use Default Flash Boot Mode
mode:SLOW_RD, clock div:1
load:0x3fce3818,len:0x508
load:0x403c9700,len:0x4
=> 0x403c9700: ?? ??:0
load:0x403c9704,len:0xad0
=> 0x403c9704: ?? ??:0
load:0x403cc700,len:0x29d8
=> 0x403cc700: ?? ??:0
entry 0x403c9880
=> 0x403c9880: ?? ??:0
[   624][I][esp32-hal-psram.c:92] psramInit(): PSRAM enabled

ESP32 Chip: ESP32-S3
Arduino Version: 3.0.0
ESP-IDF Version: 5.1.3
MiniWebRadio     Version 3.00o Mar 02/2024
ARDUINO_LOOP_STACK_SIZE 8192 words (32 bit)
FLASH size 33554432 bytes, speed 80 MHz
CPU speed 240 MHz
SDMMC speed 20 MHz
TFT speed 40 MHz
PSRAM total size: 8388608 bytes
RESET_REASON: Software reset via esp_restart

RobinMosedale, 2024-05-28:
settings.json became corrupt

Closed 2024-05-28.

Thread 441 (2024-05-30):

ESP32 configuration only, Error: 'BT_EMITTER_CONNECT' was not declared in this scope (common.h)

TubaFonse, 2024-05-30:
Hallo Wolle,
nur in der ESP32 Konfiguration common.h erhalte ich Compiler-Error, weil hier die Zeile
#define BT_EMITTER_CONNECT … fehlt.
Ich habe diese versuchsweise aus der ESP32-S3 Konfiguration kopiert und auf -1 gesetzt.
Frage: Kann CONNECT mit ESP32 nicht benutzt werden - oder musst Du das nur noch ergänzen, da laut Deiner Beschreibung / Schematic "CONNECT" nur beim ESP32-S3 angeschlossen ist?
Schematic ESP32:
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

Schematic ESP32-S3:
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

Grüße, Alfons.

Fehlermeldung:
Building in release mode
Compiling .pio\build\esp32\src\audiotask.cpp.o
Compiling .pio\build\esp32\src\main.cpp.o
src/main.cpp: In function 'void setup()':
src/main.cpp:1579:8: error: 'BT_EMITTER_CONNECT' was not declared in this scope
     if(BT_EMITTER_CONNECT != -1){
        ^~~~~~~~~~~~~~~~~~
src/main.cpp:1579:8: note: suggested alternative: 'BT_EMITTER_MODE'
     if(BT_EMITTER_CONNECT != -1){
        ^~~~~~~~~~~~~~~~~~
        BT_EMITTER_MODE
src/main.cpp: In function 'void fall_asleep()':
src/main.cpp:1882:8: error: 'BT_EMITTER_CONNECT' was not declared in this scope
     if(BT_EMITTER_CONNECT != -1){digitalWrite(BT_EMITTER_CONNECT, HIGH); bt_emitter.cmd_PowerOff();}
        ^~~~~~~~~~~~~~~~~~
src/main.cpp:1882:8: note: suggested alternative: 'BT_EMITTER_MODE'
     if(BT_EMITTER_CONNECT != -1){digitalWrite(BT_EMITTER_CONNECT, HIGH); bt_emitter.cmd_PowerOff();}
        ^~~~~~~~~~~~~~~~~~
        BT_EMITTER_MODE
src/main.cpp: In function 'void wake_up()':
src/main.cpp:1905:12: error: 'BT_EMITTER_CONNECT' was not declared in this scope
         if(BT_EMITTER_CONNECT != -1){digitalWrite(BT_EMITTER_CONNECT, LOW); vTaskDelay(100); digitalWrite(BT_EMITTER_CONNECT, HIGH);} // POWER_ON
            ^~~~~~~~~~~~~~~~~~
src/main.cpp:1905:12: note: suggested alternative: 'BT_EMITTER_MODE'
         if(BT_EMITTER_CONNECT != -1){digitalWrite(BT_EMITTER_CONNECT, LOW); vTaskDelay(100); digitalWrite(BT_EMITTER_CONNECT, HIGH);} // POWER_ON
            ^~~~~~~~~~~~~~~~~~
            BT_EMITTER_MODE
*** [.pio\build\esp32\src\main.cpp.o] Error 1
Environment    Status    Duration
-------------  --------  ------------
esp32          FAILED    00:00:19.289

schreibfaul1, 2024-05-31:
Das ist total schwierig. Dem ESP32 gehen die Pins aus. Was noch frei wäre ist GPIO12. Das ist ein "strapping pin" der beim Start auf Masse gezogen werden muss, bzw. auf dem Board befindet sich dafür ein geeignete Komponente die das erledigt, das kann eine LED oder ein Widerstand sein. Versuchsweise kannst du GPIO12 für die Display Hintergrundbeleuchtung verwenden.  Dann wäre Pin32 frei für "Connect". Ich hab es nicht getestet, aber es könnte funktionieren.
Hintergrund: Es gibt ein AT+POWER_OFF Kommando, welches den BT-Emitter deaktiviert. Die Reaktivierung ist nur mit der Taste oder über "Connect" möglich.

Closed 2024-07-16.

Thread 446 (2024-06-04):

MP3Decoder could not be initialized

Namzor1955, 2024-06-04:
Hello,
On Version 3.01f Apr 18/2024, all selected stations work, but when I replace the update with Version 3.1 May 29/2024, the stations do not work.
An error occurs

[ 17247][E][mp3_decoder.cpp:1600] MP3Decoder_AllocateBuffers(): not enough memory to allocate mp3decoder buffers
11:42:25 AUDIO_info: The MP3Decoder could not be initialized

What to do?

ESP32 Chip: ESP32-D0WD
Arduino Version: 3.0.0
ESP-IDF Version: 5.1.3
MiniWebRadio     Version 3.01f  Apr 18/2024
ARDUINO_LOOP_STACK_SIZE 8192 words (32 bit)
FLASH size 4194304 bytes, speed 40 MHz
CPU speed 240 MHz
SDMMC speed 80 MHz
TFT speed 27 MHz
PSRAM not found! MiniWebRadio doesn't work properly without PSRAM!RESET_REASON: Reset due to power-on event

00:00:00
00:00:00        ***************************
00:00:00        *     MiniWebRadio V3     *
00:00:00        ***************************
00:00:00
00:00:00 setup: ....  Arduino is pinned to core 1
00:00:00 tft_info: .  init ILI9341
00:00:00 setup: ....  Init SD card
00:00:00 setup: ....  SD card found, 3751.2 MB by 3789.0 MB free
[   328][I][esp32-hal-ledc.c:131] ledcAttachChannel(): LEDC attached to pin 32 (channel 0, resolution 8)
00:00:00 setup: ....  seek for stations.csv
00:00:00 setup: ....  stations.csv found
00:00:00 setup: ....  seek for WiFi networks
[   708][I][WiFiMulti.cpp:90] addAP(): [WIFI][APlistAdd] add SSID: wirerozman
[   714][I][WiFiMulti.cpp:90] addAP(): [WIFI][APlistAdd] add SSID: wirerozman
[   716][I][WiFiMulti.cpp:90] addAP(): [WIFI][APlistAdd] add SSID: wifirozman
[ 10038][I][WiFiMulti.cpp:134] run(): [WIFI] scan done
[ 10040][I][WiFiMulti.cpp:139] run(): [WIFI] 5 networks found
[ 10041][I][WiFiMulti.cpp:263] run(): [WIFI] Connecting BSSID: 64:6E:EA:2D:3B:0B SSID: wirerozman Channel: 11 (-66)
[ 10044][W][STA.cpp:548] disconnect(): STA already disconnected.
[ 10130][I][WiFiMulti.cpp:283] run(): [WIFI] Connecting done.
00:00:10 WiFI_info:   Connecting WiFi...
00:00:10 WiFI_info:   mDNS name: MiniWebRadio
00:00:10 setup: ....  connected to wirerozman, IP address is 192.168.1.10
00:00:10 ftpServer:   Buffers allocated: 4622 bytes
00:00:10 rtime_info:  Initializing SNTP
01:00:10 rtime_info:  Waiting for system time to be set... (1/10)
11:56:07 rtime_info:  11:56:07
11:56:07 audiotask:   is pinned to core 0
11:56:07 audiotask:   priority is 2
11:56:07 AUDIO_info:  commFMT = Philips
11:56:07 setup: ....  Number of saved stations: 14
11:56:07 setup: ....  current station number: 6
11:56:07 setup: ....  current volume: 7
11:56:07 setup: ....  last connected host: http://macslons-irish-pub-radio.stream.laut.fm/macslons-irish-pub-radio
11:56:07 setup: ....  connection timeout: 500 ms
11:56:07 setup: ....  connection timeout SSL: 2000 ms
11:56:07 setup: ....  volume is muted: (from 7)
11:56:08 WiFI_info:   RSSI is -68 dB
11:56:08 AUDIO_info:  file "/common/s/level_bar.jpg" not found
[ 12380][I][ArduinoOTA.cpp:141] begin(): OTA server at: MiniWebRadio.local:3232
11:56:08 action: ...  switch to station 6
11:56:08 AUDIO_info:  Connect to new host: "http://macslons-irish-pub-radio.stream.laut.fm/macslons-irish-pub-radio"
11:56:08 AUDIO_info:  PSRAM not found, inputBufferSize: 13951 bytes
11:56:08 AUDIO_info:  buffers freed, free Heap: 84120 bytes
11:56:08 AUDIO_info:  Connection has been established in 49 ms, free Heap: 83128 bytes
11:56:08 bitRate:     128Kbit/s
11:56:08 StationName: Macslons Irish Pub-Radio
11:56:08 icy-url: ..  http://laut.fm/macslons-irish-pub-radio
11:56:08 icy-descr:   Celtic Rock, Celtic Punk bis hin zum traditionellen Irish Folk.
11:56:08 AUDIO_info:  MP3Decoder has been initialized, free Heap: 58632 bytes , free stack 5120 DWORDs
11:56:08 lastURL: ..  http://macslons-irish-pub-radio.stream.laut.fm/macslons-irish-pub-radio
11:56:08 ftpServer:   Ftp server waiting for connection on port 21
11:56:09 Audiocodec:  MP3
11:56:09 AUDIO_info:  stream ready
11:56:09 AUDIO_info:  syncword found at pos 0
11:56:09 AUDIO_info:  Channels: 2
11:56:09 AUDIO_info:  SampleRate: 44100
11:56:09 AUDIO_info:  BitsPerSample: 16
11:56:09 AUDIO_info:  BitRate: 128000
11:56:09 StreamTitle: 100 Raisons - Sang Mélé
11:56:14 WiFI_info:   RSSI is -63 dB

ESP32 Chip: ESP32-D0WD-V3
Arduino Version: 2.0.14
ESP-IDF Version: 4.4.5
MiniWebRadio     Version 3.1   May 29/2024
ARDUINO_LOOP_STACK_SIZE 8192 words (32 bit)
FLASH size 4194304 bytes, speed 40 MHz
CPU speed 240 MHz
SDMMC speed 80 MHz
TFT speed 27 MHz
PSRAM not found! MiniWebRadio doesn't work properly without PSRAM!RESET_REASON: Reset due to power-on event

00:00:00
00:00:00        ***************************
00:00:00        *     MiniWebRadio V3     *
00:00:00        ***************************
00:00:00
00:00:00 setup: ....  Arduino is pinned to core 1
00:00:00 tft_info: .  init ILI9341
00:00:00 setup: ....  Init SD card
00:00:00 setup: ....  SD card found, 3751.2 MB by 3789.0 MB free
00:00:00 setup: ....  seek for stations.csv
00:00:00 setup: ....  stations.csv found
00:00:00 setup: ....  seek for WiFi networks
[   757][I][WiFiMulti.cpp:84] addAP(): [WIFI][APlistAdd] add SSID: wirerozman
[   765][I][WiFiMulti.cpp:84] addAP(): [WIFI][APlistAdd] add SSID: wirerozman
[   770][I][WiFiMulti.cpp:84] addAP(): [WIFI][APlistAdd] add SSID: wifirozman
00:00:07 setup: ....  5 WiFi networks found
00:00:07 setup: ....  wirerozman (-62)
00:00:07 setup: ....  mrhappy (-73)
00:00:07 setup: ....  AndroidAP8724 (-76)
00:00:07 setup: ....  VUKASIN (-85)
00:00:07 setup: ....  A1-B0936E (-86)
[  9254][I][WiFiMulti.cpp:114] run(): [WIFI] scan done
[  9255][I][WiFiMulti.cpp:119] run(): [WIFI] 5 networks found
[  9256][I][WiFiMulti.cpp:160] run(): [WIFI] Connecting BSSID: 64:6E:EA:2D:3B:0B SSID: wirerozman Channel: 11 (-65)
[  9979][I][WiFiMulti.cpp:174] run(): [WIFI] Connecting done.
00:00:09 WiFI_info:   Connecting WiFi...
00:00:09 WiFI_info:   mDNS name: MiniWebRadio
00:00:09 setup: ....  connected to wirerozman, IP address is 192.168.1.10
[ 10013][I][ArduinoOTA.cpp:141] begin(): OTA server at: MiniWebRadio.local:3232
00:00:10 ftpServer:   Buffers allocated: 4622 bytes
00:00:10 rtime_info:  Initializing SNTP
01:00:10 rtime_info:  Waiting for system time to be set... (1/10)
01:00:12 rtime_info:  Waiting for system time to be set... (2/10)
01:00:14 rtime_info:  Waiting for system time to be set... (3/10)
11:42:23 rtime_info:  11:42:23
11:42:23 audiotask:   is pinned to core 0
11:42:23 audiotask:   priority is 2
11:42:23 AUDIO_info:  commFMT = Philips
11:42:23 setup: ....  Number of saved stations: 14
11:42:23 setup: ....  current station number: 6
11:42:23 setup: ....  current volume: 7
11:42:23 setup: ....  last connected host: http://macslons-irish-pub-radio.stream.laut.fm/macslons-irish-pub-radio
11:42:23 setup: ....  connection timeout: 1000 ms
11:42:23 setup: ....  connection timeout SSL: 2500 ms
11:42:24 action: ...  switch to station 6
11:42:24 AUDIO_info:  Connect to new host: "http://macslons-irish-pub-radio.stream.laut.fm/macslons-irish-pub-radio"
11:42:24 AUDIO_info:  PSRAM not found, inputBufferSize: 13951 bytes
11:42:24 AUDIO_info:  buffers freed, free Heap: 18276 bytes
11:42:24 AUDIO_info:  Connection has been established in 60 ms, free Heap: 17004 bytes
11:42:24 setup: ....  volume is muted: (from 7)
11:42:25 bitRate:     128Kbit/s
11:42:25 StationName: Macslons Irish Pub-Radio
11:42:25 icy-url: ..  http://laut.fm/macslons-irish-pub-radio
11:42:25 icy-descr:   Celtic Rock, Celtic Punk bis hin zum traditionellen Irish Folk.
[ 17247][E][mp3_decoder.cpp:1600] MP3Decoder_AllocateBuffers(): not enough memory to allocate mp3decoder buffers
11:42:25 AUDIO_info:  The MP3Decoder could not be initialized
11:42:25 WiFI_info:   RSSI is -63 dB
11:42:25 ftpServer:   Ftp server waiting for connection on port 21
11:42:26 WiFI_info:   RSSI is -69 dB
11:42:26 BT-Emitter:  KCX_BT_Emitter not found
11:42:29 WiFI_info:   RSSI is -63 dB
11:42:31 DLNA_server: 0 media server found
11:42:39 WiFI_info:   RSSI is -62 dB

schreibfaul1, 2024-06-04:
The project is getting bigger and bigger. The limit of what is feasible for the ESP32 has already been exceeded. If you have an ESP32 or ESP32-S3 with PSRAM, a lot of dynamic memory is shifted to the PSRAM.

Namzor1955, 2024-06-04:
Od: "Wolle" ***@***.***>
Za: "schreibfaul1/ESP32-MiniWebRadio" ***@***.***>
Cc: "mitja rozman" ***@***.***>, "Author" ***@***.***>
Poslano: Torek, 4. Junij 2024 20:57:19
Zadeva: Re: [schreibfaul1/ESP32-MiniWebRadio] MP3Decoder could not be initialized (Issue #446)

The project is getting bigger and bigger. The limit of what is feasible for the ESP32 has already been exceeded. If you have an ESP32 or ESP32-S3 with PSRAM, a lot of dynamic memory is shifted to the PSRAM.

—
Reply to this email directly, view it on GitHub , or unsubscribe .
You are receiving this because you authored the thread. Message ID: <schreibfaul1/ESP32-MiniWebRadio/issues/446/ 2148201179 @ github . com> Hello,
Thanks for the quick reply. I was expecting something like that.
I also built a version with esp32s3 (N16R8) with the same components, but there is a wifi connection problem. Esp32 was purchased via Aliexspres (https://www.aliexpress.com/item/1005006446406795.html?spm=a2g0o.order_list.order_list_main.16.ddf118027GXO2x).
I also checked the settings in menuconfiguration and they are the same as your settings in the documentation.
I am attaching the process and I am asking you if you can help me.
Thanks for the reply

CONFIGURATION: https://docs.platformio.org/page/boards/espressif32/ESP32-S3-DevKitC-1-N16R8.html
PLATFORM: Espressif 32 (2024.3.10+sha.348a508) > Espressif ESP32-S3-DevKitC-1-N16R8V (16 MB QD, 8MB PSRAM)
HARDWARE: ESP32S3 240MHz, 320KB RAM, 16MB Flash

Connected!
[ 414][I][esp32-hal-psram.c:92] psramInit(): PSRAM enab[ 1980][I][WiFiMulti.cpp:90] addAP(): [WIFI][APlistAdd] add SSID: wirerozman
[ 7241][I][WiFiMulti.cpp:134] run(): [WIFI] scan done
[ 7243][I][WiFiMulti.cpp:139] run(): [WIFI] 5 networks found
[ 7244][I][WiFiMulti.cpp:263] run(): [WIFI] Connecting BSSID: 64:6E:EA:2D:3B:0B SSID: wirerozman Channel: 11 (-49)
[ 7247][W][STA.cpp:548] disconnect(): STA already disconnected.
[ 8305][W][STA.cpp:157] _onStaArduinoEvent(): Reason: 2 - AUTH_EXPIRE
[ 8307][W][STA.cpp:548] disconnect(): STA already disconnected.
[ 9329][W][STA.cpp:157] _onStaArduinoEvent(): Reason: 2 - AUTH_EXPIRE
[ 9330][W][STA.cpp:548] disconnect(): STA already disconnected.

Closed 2024-07-19.

Thread 457 (2024-06-16):

Pin of sleep mode

valera39, 2024-06-16:
Hi Dear Wolle!
Is it possible to allocate a separate pin for ESP32 S3 on which a high level would appear in sleep mode. I would like to use it to cut off the power supply to the audio power amplifier when the radio is asleep. And also it can be used to turn on or off any devices.
Thank you!

valera39, 2024-06-21:
I have the amplifier speakers continue to make a little noise when the radio goes into sleep mode. In this case a separate pin with a high level in sleep mode would really help me a lot.

schreibfaul1, 2024-06-22:
You can assign a pin to AMP_ENABLED for this purpose.

valera39, 2024-06-23:
Hi Dear Wolle!
Thank you very much for realizing the possibility to control the amplifier. But I noticed a small bug, which I hope you will not have difficulties with and can quickly fix.
If only the radio is enabled in the wakeup settings, the high level signal from the AMP_ENABLED pin works fine and turns on the station. But if both the alarm clock and the radio are on, when I wake up, the tune is playing, but I can't hear it because the AMP_ENABLED pin hasn't turned on yet, and it only turns on when the station is turned on.  That is, I would like the high level on the AMP_ENABLED pin to appear, along with the alarm tune
Thanks for your attention and participation!

schreibfaul1, 2024-06-23:
You are right, AMP_ENABLED is set too late. I'll change that soon.

valera39, 2024-06-23:
Thanks, it's working properly now. But I can't set the volume of the alarm melody. I have set different values of "ringvolume" in settings.json file, also deleted this file, but the volume of the alarm clock melody is invariably very quiet, by ear about the second volume level. What am I doing wrong?
And what not to open another topic I want to ask: in the documentation folder of the project there is a file menuconfig.pdf. In the file sdkconfig.esp32s3 according to it parameters are not changed
CONFIG_LWIP_WND_SCALE, CONFIG_LWIP_TCP_RCV_SCALE and another value CONFIG_LWIP_TCPIP_TASK_STACK_SIZE. What is the correct way?

valera39, 2024-06-25:
I also tried changing the alarm volume in the sound editor, but the sound is still quiet.
Maybe there are some other settings?

schreibfaul1, 2024-06-25:
The **_ringvolume** variable has no meaning at the moment (still to come) The ringtone is always played at the maximum volume.

valera39, 2024-06-25:
So if I understand correctly, you are planning to make the ringer louder?
And what do you say about the menuconfig file?

Closed 2024-08-09.

Thread 466 (2024-07-16):

Important issues

valera39, 2024-07-16:
Dear Wolle!
I have some very important questions piling up for me, some of which I have asked before:
1. Please fix the ability to select the volume of the alarm tone when waking up the radio.
2. When idle for a long time in the sleep mode, the radio does not always wake up, it happens that the screen backlight slightly lights up, but there is no image and sound.
Also sometimes when power is applied there is a similar situation, you have to turn the receiver on and off several times I will try to catch this moment in the monitoring log.
3. Can I make it so that when the receiver wakes up the pre-selected station with a predetermined volume?
4. Is the state of the bluetooth module is preserved at power off. I mean the state of the module, transmitter or receiver.
5. The web page used to display the station name here, now it is missing.
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

6. The volume step is 21, is there no possibility to increase it to fine tune the sound?
Thank you for your consideration and responsiveness!

valera39, 2024-07-16:
I forgot to add one more very important thing: on the latest version of ESP32-audioI2S library I don't play some streams, for example http://pub0302.101.ru:8000/stream/pro/aac/64/46.
The log shows that there are no errors, but instead of sound there is noise, the volumeter stands still. I had to use version 3.0.11e? Everything is fine with it.

valera39, 2024-07-17:
I also noticed that if the radio is in sleep mode for a long time, the time displayed on the display runs forward for about 10 hours for 7 minutes. maybe there is a sense to apply a real-time clock module RTC?

steve6375, 2024-07-17:
Or it woke up every 10 minutes, got the time, and then went back to sleep?

valera39, 2024-07-17:
The radio was in sleep mode almost all day, I happened to look at the time and saw that it didn't match the real time. Maybe it's an isolated case, I don't know, but I read somewhere that ESP32 has a built-in mediocre clock module. I don't usually keep the radio on all the time.

valera39, 2024-07-17:
And now the clock in sleep mode has become very laggy. I also caught an interesting moment: if you wake up the receiver with the remote control button, the time in the upper right corner of the display is real. Then if you turn the receiver off again with the remote control, the screen goes out, there is only a weak backlight and instead of hours and minutes on the screen only their separator of two dots, then the last digit appears. I have to reset the receiver's power supply.
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
I was planning to use the radio as an alarm clock, but this is no longer possible. I really hope Wolle will fix this problem

valera39, 2024-07-19:
I don't want to guess, but it looks like the sleep time problem has been solved. I replaced the SD card with a new class 10 16GB card. I also soldered all connections between the card reader and ESP32. I also soldered three pull-up resistors from the card reader board and now during the day the time in sleep mode is displayed correctly, the menu on the display switches quickly.
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
Perhaps my actions will be useful to someone in the future.
I delete my previous comments and leave only questions to the respected Wolle and look forward to their answer.

Translated with DeepL.com (free version)

schreibfaul1, 2024-07-19:
Many points, I'll start with the last one:
- The resistors on the SD card adapter (~10KOhm) do not interfere, there is only one exception: The resistor on D0 must be removed only on the ESP32 (not necessary on ESP32-S3) otherwise there will be problems at startup.
- http://pub0302.101.ru:8000/stream/pro/aac/64/46 (Radio 101) seems to work, but the metadata is weird, maybe json coded, I'll take a closer look soon
- the audioI2S library allows up to 100 volume steps. 21 is still from the old days
- What do you mean by "5. The web page used to display the station name here, now it is missing?"
- The ringtone is currently always at maximum volume, but could be made adjustable.
-The BT status is currently not saved, but I could include it in the "settings.json".

valera39, 2024-07-19:
Here is a screenshot of version 2 of the radio.
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
Here you can see that the line has the name of the station playing at the moment.
On the alarm clock, which is more important to me: how to set the volume of the alarm clock? I have it when waking up plays constantly quiet, I changed the volume value in "settings.json" but the volume does not change.
Could it be because I have both alarm clock and radio on when waking up?
It would be nice if the volume step was 100 logarithmically for smooth adjustment. And also save BT values in "settings.json".
And you didn't say anything about suggestion number 3. It would be very nice if it was possible.

valera39, 2024-07-19:
For the alarm clock, the following solution is logical: when you wake up, the alarm sound is played at a high enough volume to wake you up  :) and then starts playing the previously selected station at the previously set volume.

schreibfaul1, 2024-07-27:
The station name and URL are now displayed correctly again

valera39, 2024-07-27:
What do you say to my other questions?
I look forward to hearing what you have to say

valera39, 2024-07-28:
Dear Wolle!
Perhaps you don't have time or don't see my posts, but I'll allow myself to reiterate my concerns and wishes:
Please fix the ability to select the alarm volume when the radio wakes up.

When staying in sleep mode for a long time, the radio does not always wake up, it happens that the screen backlight lights up slightly, but there is no picture or sound.
Also sometimes when power is applied there is a similar situation, you have to turn the receiver on and off several times I will try to catch this moment in the monitoring log.

Is it possible to make it so that when the receiver wakes up the pre-selected station with a preset volume is turned on?

Make it possible to save the bluetooth module state in a json foil

Volume step 100, what should be changed to increase it?

schreibfaul1, 2024-07-28:
Hello valera39,
an adjustable ringtone is coming.
The issue that the radistation does not run when waking up has something to do with an error `hostbyname() DNS fail for....`, I wrote something about it in the Espressif Arduino forum. I have set a workaround that neutralizes the DNS problem, the wake-up should now work reliably.
Now the last set volume is used when waking up.
Volume levels up to 255 can be preset in the audioI2S lib. But I still have no idea how to implement this.
What is still to come is a control of the display brightness by the ambient light, but only for the ESP32-S3. For this purpose, an I2C bus is used to query the BH170 sensor. The library for this is already available.

valera39, 2024-07-28:
Thanks for the reply, I'll wait for the update and test it out

Closed 2024-09-11.

Thread 470 (2024-07-29):

No sound on some stations

valera39, 2024-07-29:
Dear Wolle!
After updating the audio library 3.0.12c, the sound on some stations disappeared. At the same time, the level indicator shows only on the left side. There are no errors in the port monitor. Please check for yourself
https://stream05.pcradio.ru/SSSR-med
https://live.radiospinner.com/clsscrdsc-96
https://stream05.pcradio.ru/rad_rdussrmscw-med
https://radio.voltagefm.ru:9009/VoltageUSSR_64_aac
http://pub0302.101.ru:8000/stream/pro/aac/64/161
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
There are no problems on version 3.0.11e
P.S. There have been any changes to the alarm volume selection?

schreibfaul1, 2024-07-29:
You have selected stations that transmit aacp or aac+.
My AAC decoder is too old for that, it can't do 'Parametric Stereo'. Thus aacp stations are decoded as mono.
But I was able to find an error that was hidden in the latest audio library. The left and right channels must always be controlled the same way.

P.S. If MISO is connected to your TFT display, you can create a hard copy simply click on the graphic.
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

valera39, 2024-07-29:
Dear Wolle!
I found another station that doesn't want to play with the updated audio library https://icecast-zvezda.mediacdn.ru/radio/zvezda/zvezda_128.
Here's the monitor log:
ESP32 Chip: ESP32-S3
Arduino Version: 3.0.2
ESP-IDF Version: 5.1.4
MiniWebRadio     Version 3.3c Jul 28/2024
ARDUINO_LOOP_STACK_SIZE 8192 words (32 bit)
FLASH size 16777216 bytes, speed 80 MHz
CPU speed 240 MHz
SDMMC speed 80 MHz
TFT speed 40 MHz
PSRAM total size: 8388608 bytes
RESET_REASON: Reset due to power-on event

00:00:00
00:00:00        ***************************
00:00:00        *     MiniWebRadio V3     *
00:00:00        ***************************
00:00:00
00:00:00 setup: ....  Arduino is pinned to core 1
00:00:00 tft_info: .  init ILI9488
00:00:00 setup: ....  Init SD card
00:00:00 setup: ....  SD card found, 15257.1 MB by 15279.0 MB free
[   760][I][esp32-hal-ledc.c:117] ledcAttachChannel(): LEDC attached to pin 10 (channel 0, resolution 8)
00:00:01 setup: ....  seek for stations.csv
00:00:01 setup: ....  stations.csv found
00:00:01 setup: ....  seek for WiFi networks
[  1806][I][WiFiMulti.cpp:86] addAP(): [WIFI][APlistAdd] add SSID: ASUS_AC66U
00:00:07 setup: ....  6 WiFi networks found
00:00:07 setup: ....  TP-LINK_E345E0_RPT (-57)
00:00:07 setup: ....  ASUS_AC66U (-60)
00:00:07 setup: ....  ASUS_AC66U_RPT (-65)
00:00:07 setup: ....  TP-LINK_E345E0 (-81)
00:00:07 setup: ....  GG (-84)
00:00:07 setup: ....  Family (-91)
[ 14330][I][WiFiMulti.cpp:129] run(): [WIFI] scan done
[ 14336][I][WiFiMulti.cpp:134] run(): [WIFI] 7 networks found
[ 14342][I][WiFiMulti.cpp:249] run(): [WIFI] Connecting BSSID: 2C:FD:A1:C2:44:F0 SSID: ASUS_AC66U Channel: 2 (-61)
[ 14353][W][STA.cpp:537] disconnect(): STA already disconnected.
[ 14413][I][WiFiMulti.cpp:272] run(): [WIFI] Connecting done.
00:00:14 WiFI_info:   Connecting WiFi...
00:00:14 WiFI_info:   mDNS name: MiniWebRadio
00:00:14 setup: ....  connected to ASUS_AC66U, IP address is 192.168.1.206
[ 14454][I][ArduinoOTA.cpp:129] begin(): OTA server at: MiniWebRadio.local:3232
00:00:14 ftpServer:   Buffers allocated: 4622 bytes
00:00:14 rtime_info:  Initializing SNTP
02:00:14 rtime_info:  Waiting for system time to be set... (1/10)
02:00:16 rtime_info:  Waiting for system time to be set... (2/10)
20:20:17 rtime_info:  20:20:17
20:20:17 audiotask:   is pinned to core 0
20:20:17 audiotask:   priority is 2
20:20:17 AUDIO_info:  commFMT = Philips
20:20:17 setup: ....  Number of saved stations: 93
20:20:17 setup: ....  current station number: 20
20:20:17 setup: ....  current volume: 3
20:20:17 setup: ....  last connected host: http://bookradio.hostingradio.ru:8069/fm
20:20:17 setup: ....  connection timeout: 2500 ms
20:20:17 setup: ....  connection timeout SSL: 3500 ms
20:20:18 action: ...  switch to station 20
20:20:18 AUDIO_info:  PSRAM found, inputBufferSize: 638965 bytes
20:20:18 AUDIO_info:  buffers freed, free Heap: 189756 bytes
20:20:18 AUDIO_info:  connect to: "icecast-zvezda.mediacdn.ru" on port 443 path "/radio/zvezda/zvezda_128"
[ 19817][E][ssl_client.cpp:36] _handle_error(): [ssl_starttls_handshake():313]: (-30592) SSL - A fatal alert message was received from our peer
[ 19831][E][NetworkClientSecure.cpp:159] connect(): start_ssl_client: connect failed: -30592
20:20:19 AUDIO_info:  Request https://icecast-zvezda.mediacdn.ru/radio/zvezda/zvezda_128 failed!
[ 19844][W][STA.cpp:135] _onStaArduinoEvent(): Reason: 8 - ASSOC_LEAVE
20:20:19 AUDIO_info:  Request https://icecast-zvezda.mediacdn.ru/radio/zvezda/zvezda_128 failed!

valera39, 2024-07-29:
Is it no longer necessary to edit the configuration file in menuconfig?

valera39, 2024-07-29:
And I didn't find a "Run menuconfig" tab.

schreibfaul1, 2024-07-30:
https://icecast-zvezda.mediacdn.ru/radio/zvezda/zvezda_128 shows:
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
I can't do anything about that, maybe a problem with the certificate, I'm not very familiar with SSL.

At the moment PIO is not able to provide the menuconfig for Arduino V3, I hope it will be possible again later. With the new version of the audioI2S lib the LWIP settings are not so important anymore.
I see you are using ESP32-S3, then you can extend the line in platformio.ini (for testing):
`https://github.com/schreibfaul1/ESP32-audioI2S.git#faad2-aac-decoder`
This replaces the aac decoder, then the stations listed above are in stereo.

valera39, 2024-07-30:
Dear Wolle!
I tested the audio library option you suggested. The above stations really started to work in stereo. But at the same time problems appeared on some other stations. I attach a part of the log:
ESP32 Chip: ESP32-S3
Arduino Version: 3.0.2
ESP-IDF Version: 5.1.4
MiniWebRadio     Version 3.3c Jul 28/2024
ARDUINO_LOOP_STACK_SIZE 8192 words (32 bit)
FLASH size 16777216 bytes, speed 80 MHz
CPU speed 240 MHz
SDMMC speed 80 MHz
TFT speed 40 MHz
PSRAM total size: 8388608 bytes
RESET_REASON: Reset due to power-on event

00:00:00
00:00:00        ***************************
00:00:00        *     MiniWebRadio V3     *
00:00:00        ***************************
00:00:00
00:00:00 setup: ....  Arduino is pinned to core 1
00:00:00 tft_info: .  init ILI9488
00:00:00 setup: ....  Init SD card
00:00:00 setup: ....  SD card found, 15257.1 MB by 15279.0 MB free
[   777][I][esp32-hal-ledc.c:117] ledcAttachChannel(): LEDC attached to pin 10 (channel 0, resolution 8)
00:00:01 setup: ....  seek for stations.csv
00:00:01 setup: ....  stations.csv found
00:00:01 setup: ....  seek for WiFi networks
[  1822][I][WiFiMulti.cpp:86] addAP(): [WIFI][APlistAdd] add SSID: ASUS_AC66U
00:00:07 setup: ....  5 WiFi networks found
00:00:07 setup: ....  ASUS_AC66U (-60)
00:00:07 setup: ....  TP-LINK_E345E0_RPT (-63)
00:00:07 setup: ....  ASUS_AC66U_RPT (-67)
00:00:07 setup: ....  TP-LINK_E345E0 (-85)
00:00:07 setup: ....  ASUS_60 (-90)
[ 14347][I][WiFiMulti.cpp:129] run(): [WIFI] scan done
[ 14353][I][WiFiMulti.cpp:134] run(): [WIFI] 8 networks found
[ 14360][I][WiFiMulti.cpp:249] run(): [WIFI] Connecting BSSID: 2C:FD:A1:C2:44:F0 SSID: ASUS_AC66U Channel: 2 (-59)
[ 14371][W][STA.cpp:537] disconnect(): STA already disconnected.
[ 14440][I][WiFiMulti.cpp:272] run(): [WIFI] Connecting done.
00:00:14 WiFI_info:   Connecting WiFi...
00:00:14 WiFI_info:   mDNS name: MiniWebRadio
00:00:14 setup: ....  connected to ASUS_AC66U, IP address is 192.168.1.206
[ 14480][I][ArduinoOTA.cpp:129] begin(): OTA server at: MiniWebRadio.local:3232
00:00:14 ftpServer:   Buffers allocated: 4622 bytes
00:00:14 rtime_info:  Initializing SNTP
02:00:14 rtime_info:  Waiting for system time to be set... (1/10)
02:00:16 rtime_info:  Waiting for system time to be set... (2/10)
23:56:55 rtime_info:  23:56:55
23:56:55 audiotask:   is pinned to core 0
23:56:55 audiotask:   priority is 2
23:56:55 AUDIO_info:  commFMT = Philips
23:56:55 setup: ....  Number of saved stations: 93
23:56:55 setup: ....  current station number: 62
23:56:55 setup: ....  current volume: 1
23:56:55 setup: ....  last connected host: https://cast1.torontocast.com:1335/stream
23:56:55 setup: ....  connection timeout: 2500 ms
23:56:55 setup: ....  connection timeout SSL: 3500 ms
23:56:55 action: ...  switch to station 62
23:56:55 AUDIO_info:  PSRAM found, inputBufferSize: 638965 bytes
ms 18754
23:56:55 AUDIO_info:  buffers freed, free Heap: 189740 bytes
23:56:55 AUDIO_info:  connect to: "cast1.torontocast.com" on port 1335 path "/stream"
23:56:59 AUDIO_info:  SSL has been established in 3085 ms, free Heap: 148940 bytes
23:56:59 bitRate:     256Kbit/s
23:56:59 StationName: RMI Disco
23:56:59 icy-url: ..  http://cast1.torontocast.com:1335/stream
23:56:59 AUDIO_info:  MP3Decoder has been initialized, free Heap: 144424 bytes , free stack 2808 DWORDs
23:56:59 lastURL: ..  https://cast1.torontocast.com:1335/stream
23:56:59 AUDIO_info:  stream ready
23:56:59 AUDIO_info:  syncword found at pos 0
23:56:59 AUDIO_info:  Channels: 2
23:56:59 AUDIO_info:  SampleRate: 44100
23:56:59 AUDIO_info:  BitsPerSample: 16
23:56:59 AUDIO_info:  BitRate: 256000
[ 22697][I][NetworkClient.cpp:565] connected(): Unexpected: RES: 0, ERR: 0
[ 22705][I][NetworkClient.cpp:565] connected(): Unexpected: RES: 0, ERR: 0
23:56:59 Webpage:     index.html
23:56:59 StreamTitle: AlimkhanOV A - Hot Nights In The City
23:57:00 BT-Emitter:  KCX_BT_Emitter not found
23:57:00 WiFI_info:   RSSI is -61 dB
23:57:00 Audiocodec:  MP3
23:57:00 ftpServer:   Ftp server waiting for connection on port 21
23:57:01 webSrv: ...  GetFolder "/"
23:57:06 DLNA_server: [0] 192.168.1.1:8200  RT-AC66U_B1-44F0
23:57:06 DLNA_server: [1] 192.168.1.4:6000  dlink-E247EB
23:57:06 DLNA_server: 2 media server found
23:57:12 action: ...  switch to station 58
ms 34986
23:57:12 AUDIO_info:  buffers freed, free Heap: 184572 bytes
23:57:12 AUDIO_info:  connect to: "harddanceradio.ddns.is74.ru" on port 8000 path "/eurodisco.m3u"
23:57:12 AUDIO_info:  Connection has been established in 379 ms, free Heap: 184320
bytes
ms 35886
23:57:13 AUDIO_info:  buffers freed, free Heap: 184696 bytes
23:57:13 AUDIO_info:  connect to: "harddanceradio.ddns.is74.ru" on port 8000 path "/eurodisco"
23:57:13 AUDIO_info:  Connection has been established in 113 ms, free Heap: 184020
bytes
23:57:13 bitRate:     192Kbit/s
23:57:13 icy-descr:   Eurodisco Syntpop Italodisco SynthWave 80s 90s
23:57:13 StationName: EURODISCO '80 [HDR]
23:57:13 icy-url: ..  https://t.me/harddanceradio
23:57:13 AUDIO_info:  AACDecoder has been initialized, free Heap: 183124 bytes , free stack 2808 DWORDs
23:57:13 lastURL: ..  http://harddanceradio.ddns.is74.ru:8000/eurodisco
23:57:13 Audiocodec:  AAC
23:57:13 AUDIO_info:  stream ready
23:57:13 AUDIO_info:  syncword found at pos 0
23:57:13 AUDIO_info:  AAC decode error -32 : Bitstream value not allowed by specification
23:57:13 AUDIO_info:  syncword found at pos 0
23:57:13 AUDIO_info:  AAC decode error -12 : Invalid number of channels
23:57:13 AUDIO_info:  syncword found at pos 0
23:57:13 AUDIO_info:  AAC decode error -21 : Unexpected channel configuration change
23:57:13 AUDIO_info:  syncword found at pos 0
23:57:13 AUDIO_info:  AAC decode error -12 : Invalid number of channels
23:57:13 AUDIO_info:  syncword found at pos 0
23:57:13 AUDIO_info:  AAC decode error -32 : Bitstream value not allowed by specification
23:57:13 AUDIO_info:  syncword found at pos 0
23:57:13 AUDIO_info:  AAC decode error -21 : Unexpected channel configuration change
23:57:13 AUDIO_info:  syncword found at pos 0
23:57:13 AUDIO_info:  AAC decode error -21 : Unexpected channel configuration change
23:57:13 AUDIO_info:  syncword found at pos 0
23:57:13 AUDIO_info:  AAC decode error -6 : Channel coupling not yet implemented
23:57:13 AUDIO_info:  syncword found at pos 0
23:57:13 AUDIO_info:  AAC decode error -12 : Invalid number of channels
23:57:13 AUDIO_info:  syncword found at pos 0
23:57:13 AUDIO_info:  AAC decode error -21 : Unexpected channel configuration change
23:57:13 AUDIO_info:  syncword found at pos 0
23:57:13 AUDIO_info:  AAC decode error -21 : Unexpected channel configuration change
23:57:13 AUDIO_info:  syncword found at pos 0
23:57:13 AUDIO_info:  AAC decode error -21 : Unexpected channel configuration change
23:57:13 AUDIO_info:  syncword found at pos 0
23:57:13 AUDIO_info:  AAC decode error -21 : Unexpected channel configuration change
23:57:13 AUDIO_info:  syncword found at pos 0
23:57:13 AUDIO_info:  AAC decode error -12 : Invalid number of channels
23:57:13 AUDIO_info:  syncword found at pos 0
23:57:13 AUDIO_info:  AAC decode error -21 : Unexpected channel configuration change
23:57:13 AUDIO_info:  syncword found at pos 0
23:57:13 AUDIO_info:  AAC decode error -32 : Bitstream value not allowed by specification
23:57:13 AUDIO_info:  syncword found at pos 0
23:57:13 AUDIO_info:  AAC decode error -21 : Unexpected channel configuration change
23:57:13 AUDIO_info:  syncword found at pos 0
23:57:13 AUDIO_info:  AAC decode error -21 : Unexpected channel configuration change
23:57:13 AUDIO_info:  syncword found at pos 0
23:57:13 AUDIO_info:  AAC decode error -24 : Unexpected fill element with SBR data
23:57:13 AUDIO_info:  syncword found at pos 0
23:57:13 AUDIO_info:  AAC decode error -21 : Unexpected channel configuration change
23:57:13 AUDIO_info:  syncword found at pos 0
23:57:13 AUDIO_info:  AAC decode error -31 : PCE shall be the first element in a frame
23:57:13 AUDIO_info:  syncword found at pos 0
23:57:13 AUDIO_info:  AAC decode error -32 : Bitstream value not allowed by specification
23:57:13 AUDIO_info:  syncword found at pos 0
23:57:13 AUDIO_info:  AAC decode error -21 : Unexpected channel configuration change
23:57:13 AUDIO_info:  syncword found at pos 0
23:57:13 AUDIO_info:  AAC decode error -6 : Channel coupling not yet implemented
23:57:13 AUDIO_info:  syncword found at pos 0
23:57:13 AUDIO_info:  AAC decode error -21 : Unexpected channel configuration change
23:57:13 AUDIO_info:  syncword found at pos 0
23:57:13 AUDIO_info:  AAC decode error -21 : Unexpected channel configuration change
23:57:13 AUDIO_info:  syncword found at pos 0
23:57:13 AUDIO_info:  AAC decode error -21 : Unexpected channel configuration change
23:57:13 StreamTitle: On-Line: 2 | Sandra - No Taboo
23:57:13 AUDIO_info:  syncword found at pos 0
23:57:13 AUDIO_info:  AAC decode error -32 : Bitstream value not allowed by specification
23:57:13 AUDIO_info:  syncword found at pos 0
23:57:13 AUDIO_info:  AAC decode error -21 : Unexpected channel configuration change
23:57:13 AUDIO_info:  syncword found at pos 0
23:57:13 AUDIO_info:  AAC decode error -21 : Unexpected channel configuration change
23:57:13 AUDIO_info:  syncword found at pos 0
23:57:13 AUDIO_info:  AAC decode error -21 : Unexpected channel configuration change
23:57:13 AUDIO_info:  syncword found at pos 0
23:57:13 AUDIO_info:  AAC decode error -12 : Invalid number of channels
23:57:13 AUDIO_info:  syncword found at pos 0
23:57:13 AUDIO_info:  AAC decode error -24 : Unexpected fill element with SBR data
23:57:13 AUDIO_info:  syncword found at pos 0
23:57:13 AUDIO_info:  AAC decode error -32 : Bitstream value not allowed by specification
23:57:14 AUDIO_info:  syncword found at pos 0
23:57:14 AUDIO_info:  AAC decode error -32 : Bitstream value not allowed by specification
23:57:14 AUDIO_info:  syncword found at pos 0
23:57:14 AUDIO_info:  AAC decode error -12 : Invalid number of channels
23:57:14 AUDIO_info:  syncword found at pos 0
23:57:14 action: ...  switch to station 59
23:57:14 AUDIO_info:  AAC decode error -21 : Unexpected channel configuration change
ms 645
23:57:14 AUDIO_info:  buffers freed, free Heap: 184576 bytes
23:57:14 AUDIO_info:  connect to: "quincy.torontocast.com" on port 2380 path "/stream"
23:57:14 AUDIO_info:  Connection has been established in 485 ms, free Heap: 184320
bytes
23:57:14 StationName: Radio Eurodance Classic
23:57:14 bitRate:     128Kbit/s
23:57:14 icy-url: ..  http://www.radio-eurodance-classic.eu
23:57:14 AUDIO_info:  MP3Decoder has been initialized, free Heap: 183156 bytes , free stack 2808 DWORDs
23:57:14 lastURL: ..  http://quincy.torontocast.com:2380/stream
23:57:14 AUDIO_info:  stream ready
23:57:14 AUDIO_info:  syncword found at pos 0
23:57:14 AUDIO_info:  Channels: 2
23:57:14 AUDIO_info:  SampleRate: 44100
23:57:14 AUDIO_info:  BitsPerSample: 16
23:57:15 AUDIO_info:  BitRate: 128000
23:57:15 Audiocodec:  MP3
23:57:15 AUDIO_info:  slow stream, dropouts are possible
23:57:16 AUDIO_info:  slow stream, dropouts are possible
23:57:17 StreamTitle: Benedikt - Crissman
23:57:18 AUDIO_info:  slow stream, dropouts are possible
23:57:19 AUDIO_info:  slow stream, dropouts are possible
23:57:23 AUDIO_info:  slow stream, dropouts are possible

Also, please watch the stream http://91.189.162.134:8008/;
The playback keeps crashing. With the same signal strength and ESP32-audioI2S v.3.0 and below, playback was perfect.

00:40:17 action: ...  switch to station 29
00:40:17 AUDIO_info:  buffers freed, free Heap: 185524 bytes
00:40:17 AUDIO_info:  connect to: "91.189.162.134" on port 8008 path "/;"
00:40:17 AUDIO_info:  Connection has been established in 173 ms, free Heap: 185048
bytes
00:40:17 StationName: Staroe Dobroe Radio
00:40:17 bitRate:     256Kbit/s
00:40:17 icy-url: ..  http://www.staroedobroe.ru/onair.php?ht=128
00:40:17 AUDIO_info:  MP3Decoder has been initialized, free Heap: 179440 bytes , free stack 3236 DWORDs
00:40:17 lastURL: ..  http://91.189.162.134:8008/;
00:40:17 AUDIO_info:  stream ready
00:40:17 AUDIO_info:  syncword found at pos 0
00:40:17 AUDIO_info:  Channels: 2
00:40:17 AUDIO_info:  SampleRate: 44100
00:40:17 AUDIO_info:  BitsPerSample: 16
00:40:17 AUDIO_info:  BitRate: 256000
00:40:18 Audiocodec:  MP3
00:40:19 AUDIO_info:  slow stream, dropouts are possible
00:40:20 AUDIO_info:  slow stream, dropouts are possible
00:40:21 AUDIO_info:  slow stream, dropouts are possible
00:40:22 AUDIO_info:  slow stream, dropouts are possible
00:40:23 AUDIO_info:  slow stream, dropouts are possible
00:40:25 AUDIO_info:  slow stream, dropouts are possible
What do you have to say about that?
I really hope you are able to resolve all the difficulties. For my part, I am ready to help to the best of my ability.
Thank you!

Closed 2024-09-13.

Thread 482 (2024-08-08):

Problem with playback of some stations on newer versions

valera39, 2024-08-08:
Hi Dear Wolle!
I upgraded to the new version and am having some problems playing stations that played flawlessly on previous versions of the audioI2S library
Please check these stations for yourself:
http://91.189.162.134:8008/;
http://harddanceradio.ddns.is74.ru:8000/eurodisco
https://radiolegenda.ru:8001/64.aac
The entire log at http://harddanceradio.ddns.is74.ru:8000/eurodisco is full of these entries:
13:37:57 AUDIO_info:  syncword found at pos 0
13:37:57 AUDIO_info:  AAC decode error -6 : Channel coupling not yet implemented
13:37:57 AUDIO_info:  syncword found at pos 0
13:37:57 AUDIO_info:  AAC decode error -6 : Channel coupling not yet implemented
13:37:57 AUDIO_info:  syncword found at pos 0
13:37:57 AUDIO_info:  AAC decode error -6 : Channel coupling not yet implemented
13:37:57 AUDIO_info:  syncword found at pos 0
13:37:57 AUDIO_info:  AAC decode error -32 : Bitstream value not allowed by specification
Part of the monitor log from another thread:
13:44:01 lastURL: ..  http://91.189.162.134:8008/;
13:44:01 AUDIO_info:  stream ready
13:44:01 AUDIO_info:  syncword found at pos 0
13:44:01 AUDIO_info:  Channels: 2
13:44:01 AUDIO_info:  SampleRate: 44100
13:44:01 AUDIO_info:  BitsPerSample: 16
13:44:01 AUDIO_info:  BitRate: 256000
13:44:01 Audiocodec:  MP3
13:44:01 webSrv: ...  File not found "/logo/.jpg"
13:44:03 AUDIO_info:  slow stream, dropouts are possible
13:44:20 AUDIO_info:  slow stream, dropouts are possible
13:44:21 AUDIO_info:  slow stream, dropouts are possible
13:44:22 AUDIO_info:  slow stream, dropouts are possible
13:44:26 AUDIO_info:  slow stream, dropouts are possible
13:44:27 AUDIO_info:  slow stream, dropouts are possible
13:44:28 AUDIO_info:  MP3 decode error -9 : INVALID_HUFFCODES
13:44:28 AUDIO_info:  syncword found at pos 551
13:44:28 AUDIO_info:  syncword found at pos 0
13:44:28 AUDIO_info:  MP3 decode error -9 : INVALID_HUFFCODES
13:44:28 AUDIO_info:  syncword found at pos 184
13:44:28 AUDIO_info:  syncword found at pos 0
13:44:28 AUDIO_info:  MP3 decode error -8 : INVALID_SCALEFACT
13:44:28 AUDIO_info:  syncword found at pos 98
13:44:28 AUDIO_info:  syncword found at pos 0
In general, the line "slow stream, dropouts are possible" became present much more often and on some other streams, although the wifi signal level did not change.
I would also like to wish you to deal with threads that use SSL, such as https://icecast-zvezda.mediacdn.ru/radio/zvezda/zvezda_128.
And please explain what the line in the monitor log means during boot time when pressing reset on esp32:
rst:0x1 (POWERON),boot:0x23 (DOWNLOAD(USB/UART0))
waiting for download
I have to click several times to load the radio normally.
Thank you!

schreibfaul1, 2024-08-08:
Hello valera39,
the stream http://91.189.162.134:8008/; comes in badly, I don't think I can do much about it.

The other two stations show an error in the AAC decoder. This should not be the case. The new AAC decoder is the faad2, which has replaced the helix decoder. Faad2 is still used today in some Linux systems. I think I made a mistake when porting it to the ESP32. Troubleshooting will not be easy and will certainly take a lot of time.

We are now using the IDF Framework V5.1. I don't want to go back to V4... Unfortunately, PlatformIO does not currently allow "Arduino as a component" in this version. I hope this will soon be possible again so that the WiFi settings can be made in menuconfig. That would bring more speed.

rst:0x1 (POWERON),boot:0x23 (DOWNLOAD(USB/UART0))
I don't know what the cause is. There is now a monitor filter that saves the log to a file. Maybe this is the reason? Please remove the entry `log2file` from platfornio.ini

valera39, 2024-08-08:
Thank you, I look forward to your corrections

schreibfaul1, 2024-08-08:
http://harddanceradio.ddns.is74.ru:8000/eurodisco
https://radiolegenda.ru:8001/64.aac
After "full clean" these streams work now

schreibfaul1, 2024-08-08:
https://icecast-zvezda.mediacdn.ru/radio/zvezda/zvezda_128
I can't fix the SSL problem, maybe it will be solved with the next Espressif update. Please use the URL without encryption until then
http://icecast-zvezda.mediacdn.ru/radio/zvezda/zvezda_128

Closed 2024-09-22.

Thread 484 (2024-08-10):

Radio is not working without Internet - Not an  issue - just a question.

FranZatGIT, 2024-08-10:
Hi Wolle,

after finishing the HW stuff now concentrate again more to the SW part.

**What is the reason for the ESP reboot command when NTP is not found?  And why not starting with the Player screen without internet  (with AP running to setup internet)?**

just experimental - I comment out the ESP reboot when NTP is not found and I changed the return with a break after the AP function is called :
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

The radio now displays the AP screen for a few seconds and then switches to normal radio mode - playing MP3s from SD without Internet is possible as desired...

of course time is not correct and IP is shown as 0.0.0.0 but the AP works and setting up the correct WIFI  over WEB UI is still possible .

**Is there a reason why the Radio is limited to work with internet access only?**

Background in my case are also some additional functions I implemented ( Power MGMT, Speaker relay, Bluetoothmode,... ) They are not working when the programm is stuck in the setup phase and only AP WEB UI is working.

Thank you Franz

kerat71, 2024-08-14:
It's sounds very reasonable to me

schreibfaul1, 2024-08-14:
I have seen your suggestion, but it has been forgotten again. In many cases, the code is still from the early days. The attempt to connect to the WiFi network three times also seems outdated today. I will change this in the next update.

FranZatGIT, 2024-08-15:
Hi Wolle, I would have some other suggestion and ideas for the Radio. Would you like me to communicate that over the "issues"  here on Github or 1:1 e.g. via email....?

By the way - have you seen my question in Post https://github.com/schreibfaul1/ESP32-MiniWebRadio/issues/476

many Thanks Franz

schreibfaul1, 2024-08-16:
Sorry, I haven't seen #476 yet. Neat work, even with the solar cell! May I add some pictures to the gallery https://github.com/schreibfaul1/ESP32-MiniWebRadio/wiki/User-devices? I'm always interested in more ideas, feel free to post here in Github.

FranZatGIT, 2024-08-16:
sure, It would be honored if you would add the pictures to your gallery.

Closed 2024-09-30.

Thread 493 (2024-08-22):

WiFi errors attempting to use a BT Emitter

rjshiffer, 2024-08-22:
Hi Wolle and others,

I'm unable to get the radio to operate correctly when the BT Emitter is attached. I've tried with both an ESP32 and ESP32-S3.  I get numerous WiFi error messages and continuous re-boots. There seems to be a conflict between WiFi and the BT Emitter. I soldered the KCX_BT_Emitter to a PCB same as the one shown in a previous issue (see my picture). Only very, very, occasionally do I get the BT Emitter to connect to a remote speaker and then only for a few seconds.

Suspecting the Emitter/PCB soldering, etc., I checked with a multimeter to ensure proper connectivity with no solder bridges, etc. No problems are detected.

All my connections are as shown in the ESP32 and ESP32-S3 schematic drawings in the docs folder.

I'm at a loss as to my problem.   Could you please give me a pointer as to where I could look next.

Thanks.
Richard

(I hope I did not overwhelm you with the volume of serial monitor output.)

**** ESP32 Monitor Output with BT Emitter Connected -- Failure *******

```
ets Jul 29 2019 12:21:46

rst:0x1 (POWERON_RESET),boot:0x13 (SPI_FAST_FLASH_BOOT)
configsip: 0, SPIWP:0xee
clk_drv:0x00,q_drv:0x00,d_drv:0x00,cs0_drv:0x00,hd_drv:0x00,wp_drv:0x00
mode:DIO, clock div:2
load:0x3fff0030,len:4832
load:0x40078000,len:16440
load:0x40080400,len:4
ho 8 tail 4 room 4
load:0x40080404,len:3504
entry 0x400805cc

ESP32 Chip: ESP32-D0WDQ6
Arduino Version: 3.0.4
ESP-IDF Version: 5.1.4
MiniWebRadio     Version 3.3h Aug 07/2024
ARDUINO_LOOP_STACK_SIZE 8192 words (32 bit)
FLASH size 4194304 bytes, speed 40 MHz
CPU speed 240 MHz
SDMMC speed 80 MHz
TFT speed 80 MHz
PSRAM total size: 4194304 bytes
RESET_REASON: Reset due to power-on event

00:00:00
00:00:00        ***************************
00:00:00        *     MiniWebRadio V3     *
00:00:00        ***************************
00:00:00
00:00:00 setup: ....  Arduino is pinned to core
0 tft_info: .  init ILI9341
00:00:00 setup: ....  Init SD card
00:00:00 setup: ....  SD card found, 14052.4 MB by 15193.5 MB free
00:00:00 setup: ....  seek for stations.csv
00:00:00 setup: ....  stations.csv found
00:00:00 setup: ....  seek for WiFi networks
[  3706][E][WiFiMulti.cpp:306] run(): [WIFI] no matching wifi found!
00:00:00 WiFI_info:   WiFi credentials are not correct
00:00:00 RECONNECTION try 1
[  6113][W][STA.cpp:537] disconnect(): STA already disconnected.
[  7152][W][STA.cpp:135] _onStaArduinoEvent(): Reason: 39 - TIMEOUT
[  7159][W][STA.cpp:537] disconnect(): STA already disconnected.
[  8240][W][STA.cpp:135] _onStaArduinoEvent(): Reason: 2 - AUTH_EXPIRE
[  8247][W][STA.cpp:537] disconnect(): STA already disconnected.
[ 10445][W][STA.cpp:135] _onStaArduinoEvent(): Reason: 201 - NO_AP_FOUND
[ 10453][W][STA.cpp:537] disconnect(): STA already disconnected.
[ 11139][E][WiFiMulti.cpp:293] run(): [WIFI] Connecting Failed AP not found.
00:00:00 WiFI_info:   WiFi credentials are not correct
00:00:00 RECONNECTION try 2
[ 11156][W][STA.cpp:537] disconnect(): STA already disconnected.
00:00:00 WiFI_info:   WiFi credentials are not correct
00:00:00 RECONNECTION try 3
00:00:00 WiFi credentials are not correct
[ 12651][W][STA.cpp:135] _onStaArduinoEvent(): Reason: 201 - NO_AP_FOUND
[ 12659][W][STA.cpp:537] disconnect(): STA already disconnected.
E (26312) wifi:NAN WiFi stop
ets Jul 29 2019 12:21:46

rst:0xc (SW_CPU_RESET),boot:0x13 (SPI_FAST_FLASH_BOOT)
configsip: 0, SPIWP:0xee
clk_drv:0x00,q_drv:0x00,d_drv:0x00,cs0_drv:0x00,hd_drv:0x00,wp_drv:0x00
mode:DIO, clock div:2
load:0x3fff0030,len:4832
load:0x40078000,len:16440
load:0x40080400,len:4
ho 8 tail 4 room 4
load:0x40080404,len:3504
entry 0x400805cc

ESP32 Chip: ESP32-D0WDQ6
Arduino Version: 3.0.4
ESP-IDF Version: 5.1.4
MiniWebRadio     Version 3.3h Aug 07/2024
ARDUINO_LOOP_STACK_SIZE 8192 words (32 bit)
FLASH size 4194304 bytes, speed 40 MHz
CPU speed 240 MHz
SDMMC speed 80 MHz
TFT speed 80 MHz
PSRAM total size: 4194304 bytes
RESET_REASON: Software reset via esp_restart

00:00:00
00:00:00        ***************************
00:00:00        *     MiniWebRadio V3     *
00:00:00        ***************************
00:00:00
00:00:00 setup: ....  Arduino is pinned to core
00:00:00 tft_info: .  init ILI9341
00:00:00 setup: ....  Init SD card
00:00:00 setup: ....  SD card found, 14052.4 MB by 15193.5 MB free
00:00:00 setup: ....  seek for stations.csv
00:00:00 setup: ....  stations.csv found
00:00:00 setup: ....  seek for WiFi networks
[  3706][E][WiFiMulti.cpp:306] run(): [WIFI] no matching wifi found!
00:00:00 WiFI_info:   WiFi credentials are not correct
00:00:00 RECONNECTION try 1
[  6113][E][WiFiMulti.cpp:306] run(): [WIFI] no matching wifi found!
00:00:00 WiFI_info:   WiFi credentials are not correct
00:00:00 RECONNECTION try 2
[  7442][E][WiFiMulti.cpp:306] run(): [WIFI] no matching wifi found!
00:00:00 WiFI_info:   WiFi credentials are not correct
00:00:00 RECONNECTION try 3
00:00:00 WiFi credentials are not correct
E (18883) wifi:NAN WiFi stop
ets Jul 29 2019 12:21:46

rst:0xc (SW_CPU_RESET),boot:0x13 (SPI_FAST_FLASH_BOOT)
configsip: 0, SPIWP:0xee
clk_drv:0x00,q_drv:0x00,d_drv:0x00,cs0_drv:0x00,hd_drv:0x00,wp_drv:0x00
mode:DIO, clock div:2
load:0x3fff0030,len:4832
load:0x40078000,len:16440
load:0x40080400,len:4
ho 8 tail 4 room 4
load:0x40080404,len:3504
entry 0x400805cc

----- Repeats -------

```

**** ESP32 Monitor Output with NO BT Emitter Connected  --  Success *******

Here is the log of a successful boot.  The only difference is the BT Emitter
is not connected.

```
rst:0x1 (POWERON_RESET),boot:0x13 (SPI_FAST_FLASH_BOOT)
configsip: 0, SPIWP:0xee
clk_drv:0x00,q_drv:0x00,d_drv:0x00,cs0_drv:0x00,hd_drv:0x00,wp_drv:0x00
mode:DIO, clock div:2
load:0x3fff0030,len:4832
load:0x40078000,len:16440
load:0x40080400,len:4
ho 8 tail 4 room 4
load:0x40080404,len:3504
entry 0x400805cc

ESP32 Chip: ESP32-D0WDQ6
Arduino Version: 3.0.4
ESP-IDF Version: 5.1.4
MiniWebRadio     Version 3.3h Aug 07/2024
ARDUINO_LOOP_STACK_SIZE 8192 words (32 bit)
FLASH size 4194304 bytes, speed 40 MHz
CPU speed 240 MHz
SDMMC speed 80 MHz
TFT speed 80 MHz
PSRAM total size: 4194304 bytes
RESET_REASON: Reset due to power-on event

00:00:00
00:00:00        ***************************
00:00:00        *     MiniWebRadio V3     *
00:00:00        ***************************
00:00:00
00:00:00 setup: ....  Arduino is pinned to core 1
00:00:00 tft_info: .  init ILI9341
00:00:00 setup: ....  Init SD card
00:00:00 setup: ....  SD card found, 14052.4 MB by 15193.5 MB free
00:00:00 setup: ....  seek for stations.csv
00:00:00 setup: ....  stations.csv found
00:00:00 setup: ....  seek for WiFi networks
[  3903][W][STA.cpp:537] disconnect(): STA already disconnected.
00:00:00 WiFI_info:   Connecting WiFi...
00:00:00 WiFI_info:   mDNS name: MiniWebRadio
00:00:00 setup: ....  connected to rigel, IP address is 10.0.0.243, Received Signal Strength -64 dB
00:00:00 ftpServer:   Buffers allocated: 4622 bytes
00:00:00 rtime_info:  Initializing SNTP
00:00:00 audiotask:   is pinned to core 0
00:00:00 audiotask:   priority is 2
00:00:00 AUDIO_info:  commFMT = Philips
00:00:00 setup: ....  Number of saved stations: 16
00:00:00 setup: ....  current station number: 1
00:00:00 setup: ....  current volume: 11
00:00:00 setup: ....  volume steps: 21
00:00:00 setup: ....  last connected host: http://edge-bauerall-01-gos2.sharp-stream.com:80/net2lincoln.mp3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
00:00:00 setup: ....  connection timeout: 2500 ms
00:00:00 setup: ....  connection timeout SSL: 3500 ms
00:00:00 action: ...  switch to station 1
00:00:00 AUDIO_info:  PSRAM found, inputBufferSize: 638965 bytes
00:00:00 AUDIO_info:  buffers freed, free Heap: 118732 bytes
00:00:00 AUDIO_info:  connect to: "edge-bauerall-01-gos2.sharp-stream.com" on port 80 path "/net2lincoln.mp3?aw_0_1st.skey=1653967769&aw_0_1st.playerid=BMUK_RPi"
00:00:00 AUDIO_info:  Connection has been established in 163 ms, free Heap: 117568 bytes
00:00:00 bitRate:     112Kbit/s
00:00:00 StationName: Greatest Hits Radio (Lincolnshire)
00:00:00 AUDIO_info:  MP3Decoder has been initialized, free Heap: 86476 bytes , free stack 5364 DWORDs
00:00:00 lastURL: ..  http://edge-bauerall-01-gos2.sharp-stream.com:80/net2lincoln.mp3?aw_0_1st.s ... st.playerid=BMUK_RPi
00:00:00 AUDIO_info:  stream ready
00:00:00 AUDIO_info:  syncword found at pos 0
00:00:00 AUDIO_info:  Channels: 2
00:00:00 AUDIO_info:  SampleRate: 32000
00:00:00 AUDIO_info:  BitsPerSample: 16
00:00:00 AUDIO_info:  BitRate: 112000
00:00:00 StreamTitle: I Want You Back - The Jackson 5
00:00:00 AUDIO_info:  StreamUrl='https://listenapi.planetradio.co.uk/api9.2/eventdata/265851913'
00:00:00 Audiocodec:  MP3
00:00:00 ftpServer:   Ftp server waiting for connection on port 21
14:17:14 BT-Emitter:  KCX_BT_Emitter not found
14:17:19 DLNA_server: [0] 10.0.0.245:2869  ENVYPC: rjshiffer@comcast.net:
14:17:20 DLNA_server: [1] 10.0.0.18:2869  DELL-LAPTOP: Shiffer Music Library:
14:17:20 DLNA_server: 2 media server found
14:17:25 StreamTitle: START ADBREAK 1
14:17:25 AUDIO_info:  StreamUrl='https://listenapi.planetradio.co.uk/api9.2/eventdata/265851913'
14:17:34 StreamTitle: AD 2
14:17:34 AUDIO_info:  StreamUrl='https://listenapi.planetradio.co.uk/api9.2/eventdata/265851913'
14:18:05 StreamTitle: AD 3
14:18:05 AUDIO_info:  StreamUrl='https://listenapi.planetradio.co.uk/api9.2/eventdata/265851913'
14:18:15 StreamTitle: AD 4
14:18:15 AUDIO_info:  StreamUrl='https://listenapi.planetradio.co.uk/api9.2/eventdata/265851913'
14:18:54 StreamTitle: AD 5
14:18:54 AUDIO_info:  StreamUrl='https://listenapi.planetradio.co.uk/api9.2/eventdata/265851913'
14:19:25 StreamTitle: AD 6
14:19:25 AUDIO_info:  StreamUrl='https://listenapi.planetradio.co.uk/api9.2/eventdata/265851913'
14:19:49 action: ...  current volume is 11
14:19:55 StreamTitle: AD 7
14:19:55 AUDIO_info:  StreamUrl='https://listenapi.planetradio.co.uk/api9.2/eventdata/265851913'
14:19:55 action: ...  switch to station 2
14:19:55 AUDIO_info:  buffers freed, free Heap: 116056 bytes
14:19:55 AUDIO_info:  connect to: "144.217.158.59" on port 5140 path "/stream?type=http"
14:19:55 AUDIO_info:  Connection has been established in 238 ms, free Heap: 116036 bytes
14:19:55 StationName: Easy Hits Miami South Florida
14:19:55 bitRate:     128Kbit/s
14:19:55 icy-url: ..  http://www.easyhitsflorida.com
14:19:55 AUDIO_info:  MP3Decoder has been initialized, free Heap: 77068 bytes , free stack 5236 DWORDs
14:19:55 lastURL: ..  http://144.217.158.59:5140/stream?type=http
14:19:55 AUDIO_info:  stream ready
14:19:55 AUDIO_info:  syncword found at pos 0
14:19:55 AUDIO_info:  Channels: 2
14:19:55 AUDIO_info:  SampleRate: 44100
14:19:55 AUDIO_info:  BitsPerSample: 16
14:19:55 AUDIO_info:  BitRate: 128000
14:19:56 Audiocodec:  MP3

```
**** ESP32-S3 Monitor Output with BT Emitter Connected  --  Failure *******

```
ESP32 Chip: ESP32-S3
Arduino Version: 3.0.4
ESP-IDF Version: 5.1.4
MiniWebRadio     Version 3.3h Aug 07/2024
ARDUINO_LOOP_STACK_SIZE 8192 words (32 bit)
FLASH size 8388608 bytes, speed 80 MHz
CPU speed 240 MHz
SDMMC speed 80 MHz
TFT speed 80 MHz
PSRAM total size: 8388608 bytes
RESET_REASON: Reset due to power-on event

00:00:00
00:00:00        ***************************
00:00:00        *     MiniWebRadio V3     *
00:00:00        ***************************
00:00:00
00:00:00 setup: ....  Arduino is pinned to core 1
00:00:00 tft_info: .  init ILI9341
00:00:00 setup: ....  Init SD card
00:00:00 setup: ....  SD card found, 6436.6 MB by 7568.0 MB free
00:00:00 setup: ....  seek for stations.csv
00:00:00 setup: ....  stations.csv found
00:00:00 setup: ....  seek for WiFi networks
[  6996][E][WiFiMulti.cpp:306] run(): [WIFI] no matching wifi found!
00:00:00 WiFI_info:   WiFi credentials are not correct
00:00:00 RECONNECTION try 1
[  8322][E][WiFiMulti.cpp:306] run(): [WIFI] no matching wifi found!
00:00:00 WiFI_info:   WiFi credentials are not correct
00:00:00 RECONNECTION try 2
[  9648][E][WiFiMulti.cpp:306] run(): [WIFI] no matching wifi found!
00:00:00 WiFI_info:   WiFi credentials are not correct
00:00:00 RECONNECTION try 3
00:00:00 WiFi credentials are not correct

```

**** ESP32 Monitor Output with BT Emitter Connected  --  Partial Success *******

```
ESP32 Chip: ESP32-D0WDQ6
Arduino Version: 3.0.4
ESP-IDF Version: 5.1.4
MiniWebRadio     Version 3.3h Aug 07/2024
ARDUINO_LOOP_STACK_SIZE 8192 words (32 bit)
FLASH size 4194304 bytes, speed 40 MHz
CPU speed 240 MHz
SDMMC speed 80 MHz
TFT speed 80 MHz
PSRAM total size: 4194304 bytes
RESET_REASON: Reset due to power-on event

00:00:00
00:00:00        ***************************
00:00:00        *     MiniWebRadio V3     *
00:00:00        ***************************
00:00:00
00:00:00 setup: ....  Arduino is pinned to core 1
00:00:00 tft_info: .  init ILI9341
00:00:00 setup: ....  Init SD card
00:00:00 setup: ....  SD card found, 14052.4 MB by 15193.5 MB free
00:00:00 setup: ....  seek for stations.csv
00:00:00 setup: ....  stations.csv found
00:00:00 setup: ....  seek for WiFi networks
[  4306][W][STA.cpp:537] disconnect(): STA already disconnected.
00:00:00 WiFI_info:   Connecting WiFi...
00:00:00 WiFI_info:   mDNS name: MiniWebRadio
00:00:00 setup: ....  connected to rigel, IP address is 10.0.0.243, Received Signal Strength -56 dB
00:00:00 ftpServer:   Buffers allocated: 4622 bytes
00:00:00 rtime_info:  Initializing SNTP
00:00:00 audiotask:   is pinned to core 0
00:00:00 audiotask:   priority is 2
00:00:00 AUDIO_info:  commFMT = Philips
00:00:00 setup: ....  Number of saved stations: 16
00:00:00 setup: ....  current station number: 2
00:00:00 setup: ....  current volume: 11
00:00:00 setup: ....  volume steps: 21
00:00:00 setup: ....  last connected host: http://144.217.158.59:5140/stream?type=http
00:00:00 setup: ....  connection timeout: 2500 ms
00:00:00 setup: ....  connection timeout SSL: 3500 ms
00:00:00 action: ...  switch to station 2
00:00:00 AUDIO_info:  PSRAM found, inputBufferSize: 638965 bytes
00:00:00 AUDIO_info:  buffers freed, free Heap: 119112 bytes
00:00:00 AUDIO_info:  connect to: "144.217.158.59" on port 5140 path "/stream?type=http"
00:00:00 AUDIO_info:  Connection has been established in 60 ms, free Heap: 118204 bytes
00:00:00 StationName: Easy Hits Miami South Florida
00:00:00 bitRate:     128Kbit/s
00:00:00 icy-url: ..  http://www.easyhitsflorida.com
00:00:00 AUDIO_info: MP3Decoder has been initialized, free Heap: 84184 bytes , free stack 5140 DWORDs
00:00:00 lastURL: ..  http://144.217.158.59:5140/stream?type=http
00:00:00 AUDIO_info:  stream ready
00:00:00 AUDIO_info:  syncword found at pos 0
00:00:00 AUDIO_info:  Channels: 2
00:00:00 AUDIO_info:  SampleRate: 44100
00:00:00 AUDIO_info:  BitsPerSample: 16
00:00:00 AUDIO_info:  BitRate: 128000
00:00:00 ftpServer:   Ftp server waiting for connection on port 21
00:00:00 Audiocodec:  MP3
00:00:00 BT-Emitter:  KCX_BT_Emitter found
00:00:00 BT-Emitter:  Version KCX_BT_RTX_V1.4
00:00:00 BT-Emitter:  Volume -> 0
00:00:00 BT-Emitter:  OK+POWEROFF_MODE
15:53:20 BT-Emitter:  no response: last command was: AT+POWER_OFF
15:53:21 DLNA_server: [0] 10.0.0.18:2869  DELL-LAPTOP: Shiffer Music Library:
15:53:21 DLNA_server: [1] 10.0.0.245:2869  ENVYPC: rjshiffer@comcast.net:
15:53:21 DLNA_server: 2 media server found
[ 14829][W][KCX_BT_Emitter.cpp:184] parseATcmds(): unknown message ...z.
15:53:55 webSrv: ...  GetFolder "/"
15:54:03 webSrv: ...  File not found "/png/Button_BT_Yellow.png"
[ 54754][E][websrv.cpp:513] handleWS(): webSocketClient should be connected but is not!
15:54:15 BT-Emitter:  no response: last command was: AT+VOL=0
[ 68345][W][KCX_BT_Emitter.cpp:184] parseATcmds(): unknown message .~...
15:54:18 BT-Emitter:  Status -> Disconnected
15:54:26 BT-Emitter:  POWER OFF
15:54:39 Webpage:     index.html
15:54:41 webSrv: ...  GetFolder "/"
[101966][E][NetworkClient.cpp:423] write(): fail on fd 56, errno: 104, "Connection reset by peer"
15:54:50 webSrv: ...  File not found "/png/Button_BT_Yellow.png"
[101977][E][websrv.cpp:513] handleWS(): webSocketClient should be connected but is not!
15:55:15 BT-Emitter:  POWER ON
15:55:15 BT-Emitter:  OK+RESET
15:55:15 BT-Emitter:  POWER ON
15:55:15 BT-Emitter:  Mode -> RECEIVER
15:55:38 BT-Emitter:  OK+RESET
15:55:38 BT-Emitter:  POWER ON
15:55:38 BT-Emitter:  Mode -> EMITTER
15:55:39 BT-Emitter:  Status -> Scan...
15:55:40 BT-Emitter:  scanned: MacAdd:4a89a8fd4ef4,Name:SoundCore mini
15:55:40 BT-Emitter:  CON ONE
15:55:40 BT-Emitter:  CONNECT=>MacAdd:4a89a8fd4ef4,Name:SoundCore mini
15:55:42 BT-Emitter:  Status -> Connected
15:55:56 AUDIO_info:  slow stream, dropouts are possible
15:55:59 AUDIO_info:  slow stream, dropouts are possible
15:56:00 AUDIO_info:  slow stream, dropouts are possible
15:56:01 AUDIO_info:  slow stream, dropouts are possible
15:56:02 AUDIO_info:  slow stream, dropouts are possible
15:56:02 AUDIO_info:  Stream lost -> try new connection
15:56:02 AUDIO_info:  buffers freed, free Heap: 110356 bytes
15:56:02 AUDIO_info:  connect to: "144.217.158.59" on port 5140 path "/stream?type=http"
15:56:05 AUDIO_info:  Request http://144.217.158.59:5140/stream?type=http failed!
[176543][W][STA.cpp:135] _onStaArduinoEvent(): Reason: 8 - ASSOC_LEAVE
15:56:05 AUDIO_info:  Request http://144.217.158.59:5140/stream?type=http failed!
15:56:05 StationName:
15:56:05 StreamTitle:
[176610][E][NetworkClient.cpp:423] write(): fail on fd 55, errno: 113, "Software caused connection abort"
[177833][W][STA.cpp:135] _onStaArduinoEvent(): Reason: 39 - TIMEOUT
[177840][W][STA.cpp:537] disconnect(): STA already disconnected.
[180240][W][STA.cpp:135] _onStaArduinoEvent(): Reason: 201 - NO_AP_FOUND
[180247][W][STA.cpp:537] disconnect(): STA already disconnected.
[182446][W][STA.cpp:135] _onStaArduinoEvent(): Reason: 201 - NO_AP_FOUND
[182453][W][STA.cpp:537] disconnect(): STA already disconnected.
[184653][W][STA.cpp:135] _onStaArduinoEvent(): Reason: 201 - NO_AP_FOUND
[184660][W][STA.cpp:537] disconnect(): STA already disconnected.
[186859][W][STA.cpp:135] _onStaArduinoEvent(): Reason: 201 - NO_AP_FOUND
[186867][W][STA.cpp:537] disconnect(): STA already disconnected.
[189265][W][STA.cpp:135] _onStaArduinoEvent(): Reason: 201 - NO_AP_FOUND
[189273][W][STA.cpp:537] disconnect(): STA already disconnected.
15:56:18 WiFi         :  Reconnecting to WiFi...
[190174][W][STA.cpp:537] disconnect(): STA already disconnected.
E (201308) wifi:sta is connecting, return error
[191472][W][STA.cpp:135] _onStaArduinoEvent(): Reason: 201 - NO_AP_FOUND
[191479][W][STA.cpp:537] disconnect(): STA already disconnected.
[193678][W][STA.cpp:135] _onStaArduinoEvent(): Reason: 201 - NO_AP_FOUND
.[0;33m[193686][W][STA.cpp:537] disconnect(): STA already disconnected.
[194832][W][STA.cpp:135] _onStaArduinoEvent(): Reason: 39 - TIMEOUT
15:56:32 WiFi         :  Reconnecting to WiFi...
[204173][W][STA.cpp:537] disconnect(): STA already
```
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

schreibfaul1, 2024-08-24:
BT and WiFi use the same frequency range. Where BT looks for a free channel before it transmits (frequency hopping). Nevertheless, influences can occur. Try to rotate the BT antenna 90° compared to the WiFi antenna, horizontally and vertically. And the distance between the two should be as large as possible. If it is not possible to shield the antennas from each other, try to wrap the BT module in an antistatic foil,
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

You can simply put such a bag over the BT module for testing. The BT range will still be sufficient after that.

rjshiffer, 2024-08-24:
Yes, that is what is happening.  I placed the BT Emitter in a antistatic bag, and re-orientated it as you suggested and was able to get more consistent connections and the streams play but with "slow stream, dropouts are possible."

Realizing that the work room I was in had other BT/WiFi interference possibilities (fluorescent lights, wireless controllers, another MiniWebRadio running in background, etc.) I moved the radio to my normal living space and it works fine with only minimal, barely noticeable dropouts over a period of an hour.

That's for your help.

Closed 2024-08-24.

Thread 500 (2024-08-30):

No error, just a question to modify the setup

pisascha, 2024-08-30:
hello wolle,

thank you for this nice project.

i'm new to this so sorry for the question but may you know it:

i want to built the webradio with built-in speakers. is it possible to do it with a PAM8406 amplifier? i found a sketch in the internet (but for the raspberry pi) where there is a PAM8406 wired to the PCM5102 and speakers to the PAM8406. is it possible do the same with your webradio?

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

if this is possible is it neccesary to modify your code?

sorry for the trouble and for help in advance

schreibfaul1, 2024-08-30:
I have PAM8403 in use and it works.
For the power supply you need at least 3A (2x 5W + 1A for the ESP32), I would dimension it a little larger, perhaps this:
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
Then you should make sure that the analogue part is positioned as far away as possible from the WiFi antenna of the ESP. Every cm of wire acts as an antenna and this can cause interference noise.

pisascha, 2024-08-31:
Thank you for your quick reply and the suggestion.

pisascha, 2024-09-06:
Hey Wolle, my parts arrived yesterday and now i want to start. Do I have to disactivate the hardware I don't use (e.g. ir) in common.h or is it done automatically?

schreibfaul1, 2024-09-07:
If you do not want to connect an IR receiver, it is better to set the pin to -1.
If you set a pin, it should not remain unconnected for an input.

pisascha, 2024-09-07:
Ok, thank you for your reply. That is what I thought.

Thank you for your trouble, i appreciate your work

pisascha, 2024-09-08:
I checked my boxes of raspi -stuff and found a 1838-based ir receiver modul. Hope this will work, have a test in the next few days

pisascha, 2024-09-09:
Good morning wolle,

I want use my ESP32-s3 n16r8 with this microsd-modul

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

Due to your manual i didn't touch the resistor(s) on the modul cause i use the s3 model.

Now i get this error message

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

What mistake am I making? Thank you for help!

pisascha, 2024-09-09:
Thank you very much for your help

schreibfaul1, 2024-09-09:
I can only advise against the Catalex adapter. The modification is difficult and there is no guarantee that it will work well. This board is intended for the old Arduino chips with 5V output. If you have an adapter for your SD card, simply solder 5 wires to it without any other components.
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

Closed 2024-10-25.

Thread 508 (2024-09-13):

OPUS decode error

valera39, 2024-09-13:
Hello Dear Wolle!
After a short playback time, the stream stops
ESP32 Chip: ESP32-S3
Arduino Version: 3.0.4
ESP-IDF Version: 5.1.4
MiniWebRadio     Version 3.4bc - Sep 03/202
ARDUINO_LOOP_STACK_SIZE 8192 words (32 bit)
FLASH size 16777216 bytes, speed 80 MHz
CPU speed 240 MHz
SDMMC speed 40 MHz
TFT speed 40 MHz
PSRAM total size: 8388608 bytes
RESET_REASON: Reset due to power-on event

00:00:00
00:00:00        ***************************
00:00:00        *     MiniWebRadio V3     *
00:00:00        ***************************
00:00:00
00:00:00 setup: ....  Arduino is pinned to core 1
00:00:00 tft_info: .  init ILI9488
00:00:00 setup: ....  Init SD card
00:00:00 setup: ....  SD card found, 29790.5 MB by 29818.0 MB free
00:00:00 setup: ....  seek for WiFi networks
[  4977][W][STA.cpp:537] disconnect(): STA already disconnected.
00:00:00 WiFI_info:   Connecting WiFi...
00:00:00 WiFI_info:   mDNS name: MiniWebRadio
00:00:00 setup: ....  connected to Honor, IP address is 192.168.43.214, Received Signal Strength -28 dB
00:00:00 ftpServer:   Buffers allocated: 4622 bytes
00:00:00 rtime_info:  Initializing SNTP
00:00:00 audiotask:   is pinned to core 0
00:00:00 audiotask:   priority is 2
00:00:00 AUDIO_info:  commFMT = Philips
00:00:00 setup: ....  number of saved stations: 93
00:00:00 setup: ....  number of saved favourites: 93
00:00:00 setup: ....  current station number: 64
00:00:00 setup: ....  current volume: 5
00:00:00 setup: ....  volume steps: 21
00:00:00 setup: ....  volume after alarm: 0
00:00:00 setup: ....  last connected host: http://stream.polskastacja.pl/ps27_mp3
00:00:00 setup: ....  connection timeout: 2500 ms
00:00:00 setup: ....  connection timeout SSL: 3500 ms
00:00:00 action: ...  switch to station 64
00:00:00 AUDIO_info:  PSRAM found, inputBufferSize: 638965 bytes
00:00:00 AUDIO_info:  buffers freed, free Heap: 186348 bytes
00:00:00 AUDIO_info:  connect to: "stream.polskastacja.pl" on port 80 path "/ps27_mp3"
00:00:00 AUDIO_info:  Connection has been established in 157 ms, free Heap: 185932
bytes
11:21:48 bitRate:     128Kbit/s
11:21:48 bitRate:     128Kbit/s
11:21:48 icy-descr:   Grupa Wirtualna Polska
11:21:48 StationName: 27_mp3
11:21:48 icy-url: ..  http://grupawp.pl
11:21:48 AUDIO_info:  MP3Decoder has been initialized, free Heap: 183564 bytes , free stack 4952 DWORDs
11:21:48 lastURL: ..  http://stream.polskastacja.pl/ps27_mp3
11:21:48 AUDIO_info:  stream ready
11:21:48 AUDIO_info:  syncword found at pos 0
11:21:48 AUDIO_info:  Channels: 2
11:21:48 AUDIO_info:  SampleRate: 44100
11:21:48 AUDIO_info:  BitsPerSample: 16
11:21:48 AUDIO_info:  BitRate: 128000
11:21:48 setup: ....  Ambient Light Sensor BH1750 found
11:21:49 Audiocodec:  MP3
11:21:49 ftpServer:   Ftp server waiting for connection on port 21
11:21:49 StreamTitle: Albert One - Secrets w Italo Disco
11:21:49 webSrv: ...  Download  "/stations.json"
11:21:55 DLNA_server: 0 media server found
11:22:01 Webpage:     index.html
11:22:02 webSrv: ...  GetFolder "/"
11:22:03 webSrv: ...  Download  "/stations.json"
11:22:07 Webpage:     index.html
11:22:08 webSrv: ...  GetFolder "/"
11:22:09 webSrv: ...  Download  "/stations.json"
11:22:16 AUDIO_info:  buffers freed, free Heap: 183376 bytes
11:22:16 AUDIO_info:  connect to: "radio.glafir.ru" on port 80 path "/easy-listen/paul-mauriat"
11:22:17 AUDIO_info:  Connection has been established in 380 ms, free Heap: 183116
bytes
11:22:17 StationName: http://radio.glafir.ru/easy-listen/paul-mauriat
11:22:17 AUDIO_info:  chunked data transfer
11:22:17 bitRate:     64Kbit/s
11:22:17 icy-descr:   PAUL MAURIAT music.
11:22:17 StationName: PAUL MAURIAT on radio Glafir
11:22:17 icy-url: ..  http://radio.glafir.ru/easy-listen/paul-mauriat
11:22:17 lastURL: ..  http://radio.glafir.ru/easy-listen/paul-mauriat
11:22:17 webSrv: ...  File not found "/logo/.jpg"
11:22:17 AUDIO_info:  stream ready
11:22:17 AUDIO_info:  OPUSDecoder has been initialized, free Heap: 179916 bytes , free stack 4952 DWORDs
11:22:17 AUDIO_info:  syncword found at pos 0
11:22:17 AUDIO_info:  Paul Mauriat - Mull Of Kintyre
11:22:17 StreamTitle: Paul Mauriat - Mull Of Kintyre
11:22:17 AUDIO_info:  Channels: 2
11:22:17 AUDIO_info:  SampleRate: 48000
11:22:17 AUDIO_info:  BitsPerSample: 16
11:22:17 AUDIO_info:  BitRate: 160456
11:22:18 Audiocodec:  OPUS
11:23:33 AUDIO_info:  OPUS decode error -5 : SILK MODE UNSUPPORTED

schreibfaul1, 2024-09-13:
The OPUS decoder consists of two components, CELT and SILK. CELT is mainly used for music, SILK mainly for speech and low bandwidths. Many radio stations only use the CELT mode, these are played back properly. However, there are also stations that switch to Hybrid or Silk mode during pauses in music or speech. I don't have a good SILK decoder at the moment, in which case a message appears and the stream is cancelled.
It will still take a long time to get the SILK decoder up and running, which will certainly not be until next year.

valera39, 2024-09-14:
Thank you, what I like about your answers is that you always answer any questions, even the simplest and most obvious ones, in detail and without arrogance. It's true that you are not always quick, but I suppose that's because of the lack of time. I would like to remind you about my question  #506 , What do you think?
Thanks again!

schreibfaul1, 2024-09-14:
Yes, OPUS has a wide range.
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
Celt is green and that has been realised.
Orange would be the SILK decoder, which is expected to arrive in a few months.
Yellow would be the hybrid mode, i.e. a mixture of CELT and SILK.

I will look at the problem with the time zones soon. The csv will probably be replaced with the json format. This has already been done for the "settings" and "stations". The json is easier to edit with JavaScript.

valera39, 2024-09-14:
Thank you! Is the station that doesn't work https://stream.zeno.fm/zuh2nqp5qzzuv already working from the audio library updated yesterday or not?

schreibfaul1, 2024-09-14:
The rejection (HTTP401) is triggered by a missing UserAgent. I have never had this before. Now a UserAgent is transmitted with the http request.

valera39, 2024-09-14:
Now the stream is playing normally
Thank you very much!

Closed 2024-10-30.

Thread 530 (2024-10-22):

Bluetooth problems

valera39, 2024-10-22:
Hello Dear Wolle!
I still continue to have problems identifying the bluetooth module. BT-Emitter: KCX_BT_Emitter not found. Accordingly, the buttons on the display and on the page do not work. I replaced the module with another one from radio version 3.4 where everything works fine, but in this version it is also not detected.
And what is interesting, if I turn on the bluetooth headphones, they connect to the radio and there is a broadcast of sound from the radio. But all the buttons are still not active.
What do you think?

schreibfaul1, 2024-10-22:
Hi valera,
this is probably the same problem as #524. I have no idea what is causing this. The KCX_BT_Emitter has its own library. I have now added an internal pull-up
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
_KCX_BT_Emitter.cpp_
It is conceivable that UART will behave differently in the new IDF V5.
Alternatively, could a 10KOhm resistor or greater on the TX and RX pin help?

valera39, 2024-10-22:
According to the schematic, I have 4.7k resistors. But I also tried without them, but still the module is not visible

schreibfaul1, 2024-10-23:
Yes, that was rubbish with the resistors.
But I still have no idea what the cause is. It's like searching in the fog.
I now clear the buffer of the serial interface after the start to remove any existing characters.
Hope it helps.
If not, please enter _btp<enter>_ in the terminal. This will generate a protocol of the serial interface. It should look like this. Maybe it's different for you?
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

It is important that the first command is "AT+" and the response is "OK+".
Thank you for your help.

valera39, 2024-10-23:
I applied your latest updates and the bluetooth module is detected. I don't quite understand how to enter commands in the terminal, please explain the sequence of my actions in detail.

I open a terminal window, write "btp" and the response is that the command does not exist. Or is it necessary to write the command in the serial monitor window?

I'll continue testing

ve2cfb, 2024-10-23:
Hello Wolle and Valera,

For a while, i thought i was going crazy.

Just a quick update...
By the way, My Shematic shows two 47K instead of a 4.7k
Presently my board has those two resistors installed.
i downloaded Version 3.5k - Oct 23/2024
did a FULL CLEAN, ERASE FLASH and UPLOAD
in KCX_BT_Emitter.cpp around line 52 i dont see a INPUT_PULLUP.  (Probably my eyesight)
Once compiled, the BT button is active (so far so good)
Power off / Power on the unit, BT button disabled.
(Similar problem)

Thanks Wolle,  i wish i could help a lot more.

valera39, 2024-10-23:
[ve2cfb](https://github.com/ve2cfb),I made a mistake, just put the comma wrong :), of course 47 kOhm.

schreibfaul1, 2024-10-23:
@valera39
There is no input field in the terminal. You simply click with the mouse on the serial terminal and then type the letters btp for "blue tooth protocol" You cannot see the input, but the terminal responds when you press enter.

ve2cfb, 2024-10-31:
Hello Wolle,
Just wandering...
Is the BT problem fixed...? did i missed something ?

Thanks again.

schreibfaul1, 2024-10-31:
There have been some changes in the KCX_BT_Emitter library to make the UART interface more stable. In addition, the receive buffer is cleared before the first commands are sent.
This entry should appear in the log a few seconds after the start:
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
If this does not happen, you could reset the BT emitter by pressing and holding the button. Perhaps the baud rate has changed and is preventing communication.

valera39, 2024-10-31:
I have version 1.7 written on the module, but in the terminal the module is defined as V 1.4. Is this normal?

schreibfaul1, 2024-10-31:
You must mean this:
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
I have two boards. V1.7 is printed on them and 1.4 is read from the chip.
Is the BT_Emitter running reliably or are you having similar problems to ve2cfb?

valera39, 2024-10-31:
I too have two boards version 1.7 and both are detected as 1.4. Another module should be arriving soon, I'll see how it is detected.
I have one module in radio version 3.4 and one in radio version 3.5. The one in the receiver 3.4 subjectively evaluating works more stable.

ve2cfb, 2024-11-01:
Hello Wolle,
Just installed Version 3.5q - Nov 01/2024 and the BT Button problem seems to be working so far.
i did try a couple of combinations and everything works ok.
Have you change something...?
Will do more test.

But... . i cannot figure out the following...
Using the web application, when trying to add stations from Germany, the stations list is still empty.
I did check other Country and no problem there... Go figure.

Have a nice day.

schreibfaul1, 2024-11-02:
That is strange. The function only runs in the browser using JS. I simply query the database.
You can also do this by typing https://de1.api.radio-browser.info/json/countries#name into your browser.
I have now changed the sorting criterion. First comes the country code, then the country name.

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

Maybe that will solve your problem with "DE"

ve2cfb, 2024-11-02:
Hello Wolle,
It is a lot better. Now i am able to get Germany.  it worked 20 times and failed 2 times.
Many thanks...

Concerning the BT button problem, here is the message from the BTP command when problem exist..

---- Opened the serial port COM15 ----
---- Sent utf8 encoded message: "btp" ----
15:29:56 Terminal  :  btp
[604490][E][main.cpp:2771] loop(): TX: AT+
[604498][E][main.cpp:2771] loop(): TX: AT+ADDLINKADD=263510091300
[604505][E][main.cpp:2771] loop(): TX: AT+VMLINK?
[604510][E][main.cpp:2771] loop(): TX: AT+VMLINK?
[604516][E][main.cpp:2771] loop(): TX: AT+RESET
[604521][E][main.cpp:2771] loop(): TX: AT+RESET
15:30:10 click on ..  backpane
15:30:11 click on ..  backpane

NOTE:  One way to get the BT functional again, is delete de settings.json (using the PC) Power on the unit again and you are in business.

schreibfaul1, 2024-11-02:
Thank you for the protocol. It can be seen that the BT emitter is not responding.
The UART interface has been changed with the new IDF version V5. I will stay on the subject.

valera39, 2024-11-03:
Confirmed, the bluetooth module is not detected

schreibfaul1, 2024-11-03:
I have noticed that the UART interface (Serial2) is not operated as long as a connection to a radio station is being established. It takes even longer for encrypted connections. If the BT emitter responds during this time, the information is lost. I have no idea why this is the case. Now the BT emitter is requested afterwards and that works better.

valera39, 2024-11-07:
It looks like you've defeated the bluetooth module detection issue, but the module's current state settings are not saved after a reboot

schreibfaul1, 2024-11-11:
Right, I don't have the BT mode (RX/TX) in the settings.json yet. I'll catch up on that soon.

Closed 2024-12-27.

Thread 538 (2024-10-30):

No image / no sound

Valentin211, 2024-10-30:
Hello Wolle,

I tested ESP32-MiniWebRadio with the following components: ESP32-S3 N8R8, ILI9341-2.8", Max98357.
The compilation and loading in VS Code was done without errors, but the radio does not work properly:
- Vcc display and Vcc I2S audio powered at +5V ESP32 module - there is sound, the radio station is running but there is no image on the display (Backlight turns on for a few seconds and then remains off);
- Vcc display and Vcc I2S audio powered at +3.3V ESP32 module - there is an image on the display, VU Meter is active, Touchscreen seems OK (I did not insist in details) but there is no sound.

Thank you in advance.

schreibfaul1, 2024-10-30:
It is possible that the 5V pin of the board has no voltage. I think a jumper needs to be soldered in first.

skassel2024, 2024-10-30:
A jumper has to be soldered. Also check the diodes next to the jumper. I had the same problem at first. However, one of the three diodes was defective in my case

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

Valentin211, 2024-10-30:
> A jumper has to be soldered.  Thank you skassel2024 , now it's working.

[url=https://postimages.org/][img]https://i.postimg.cc/3NDvyRXX/IMG-20241030-192957697.jpg[/img][/url]

Thank you Wolle, it's great project!

Closed 2024-10-30.

Thread 543 (2024-11-01):

Error: Code doesn't compile, KCX Error

HWH53, 2024-11-01:
Hallo Wolle,
ich wollte soeben nach dem Urlaub von der Version v3.05a auf den aktuellen Softwarestand updaten und laufe beim Compilieren in einen Fehler!
Dem Protokoll entnehme ich dass das Problem irgendwo im Bereich des 'class KCX_BT_Emitter' zu liegen scheint. Ich verwende aber keinen Bluetooth Emitter.
Das Installationsprotokoll habe ich beigefügt. Habe ich irgendetwas übersehen?

mfg
Helmut

`*  Task wird ausgeführt: C:\Users\HWH\.platformio\penv\Scripts\platformio.exe run --environment esp32s3_OTA

Processing esp32s3_OTA (board: ESP32-S3-DevKitC-1-N16R8; platform: https://github.com/pioarduino/platform-espressif32/releases/download/51.03.05/platform-espressif32.zip; framework: arduino, espidf)
-----------------------------------------------------------------------------------------------------------------------------------------------------------Verbose mode can be enabled via `-v, --verbose` option
CONFIGURATION: https://docs.platformio.org/page/boards/espressif32/ESP32-S3-DevKitC-1-N16R8.html
PLATFORM: Espressif 32 (51.3.5) > Espressif ESP32-S3-DevKitC-1-N16R8V (16 MB QD, 8MB PSRAM)
HARDWARE: ESP32S3 240MHz, 320KB RAM, 16MB Flash
DEBUG: Current (esp-builtin) On-board (esp-builtin) External (cmsis-dap, esp-bridge, esp-prog, iot-bus-jtag, jlink, minimodule, olimex-arm-usb-ocd, olimex-arm-usb-ocd-h, olimex-arm-usb-tiny-h, olimex-jtag-tiny, tumpa)
PACKAGES:
 - framework-arduinoespressif32 @ 3.0.5
 - framework-arduinoespressif32-libs @ 5.1.0+sha.33fbade6b8
 - framework-espidf @ 3.50104.0 (5.1.4)
 - tool-cmake @ 3.21.3
 - tool-esptoolpy @ 4.7.5
 - tool-mklittlefs @ 3.2.0
 - tool-ninja @ 1.9.0
 - tool-openocd-esp32 @ 2.1100.20220706 (11.0)
 - tool-riscv32-esp-elf-gdb @ 11.2.0+20220823
 - tool-xtensa-esp-elf-gdb @ 11.2.0+20230208
 - toolchain-esp32ulp @ 1.23500.220830 (2.35.0)
 - toolchain-riscv32-esp @ 12.2.0+20230208
 - toolchain-xtensa-esp32s3 @ 12.2.0+20230208
Warning! Arduino framework as an ESP-IDF component doesn't handle the `variant` field! The default `esp32` variant will be used.
Reading CMake configuration...
Generating assembly for certificate bundle...
LDF: Library Dependency Finder -> https://bit.ly/configure-pio-ldf
LDF Modes: Finder ~ chain, Compatibility ~ soft
Found 50 compatible libraries
Scanning dependencies...
Dependency Graph
|-- ESP32-audioI2S @ 2.0.0+sha.9cfea80
|-- ESP32-KCX-BT-EMITTER @ 0.0.0+20240128094011.sha.b766d32
|-- ESP32-DLNA-Client @ 0.0.0+20231205185914.sha.c320f5e
|-- ESP32-IR-Remote-Control @ 1.0.10+sha.51aa0ce
|-- ac101
|-- BH1750
|-- es8388
|-- ftpsrv
|-- rtime
|-- SPIFFS @ 3.0.5
|-- tftLib
|-- websrv
|-- ArduinoOTA @ 3.0.5
|-- ESPmDNS @ 3.0.5
|-- FFat @ 3.0.5
|-- FS @ 3.0.5
|-- Preferences @ 3.0.5
|-- SD_MMC @ 3.0.5
|-- SPI @ 3.0.5
|-- Ticker @ 3.0.5
|-- WiFi @ 3.0.5
|-- NetworkClientSecure @ 3.0.5
|-- Wire @ 3.0.5
Building in release mode
Generating assembly for .pio\build\esp32s3_OTA\https_server.crt.S
Generating assembly for .pio\build\esp32s3_OTA\rmaker_mqtt_server.crt.S
Generating assembly for .pio\build\esp32s3_OTA\rmaker_claim_service_server.crt.S
Generating assembly for .pio\build\esp32s3_OTA\rmaker_ota_server.crt.S
Compiling .pio\build\esp32s3_OTA\src\main.cpp.o
Generating LD script .pio\build\esp32s3_OTA\memory.ld
Compiling .pio\build\esp32s3_OTA\app_trace\app_trace.c.o
Compiling .pio\build\esp32s3_OTA\app_trace\app_trace_util.c.o
Compiling .pio\build\esp32s3_OTA\app_trace\host_file_io.c.o
Compiling .pio\build\esp32s3_OTA\app_trace\port\port_uart.c.o
Compiling .pio\build\esp32s3_OTA\app_update\esp_ota_ops.c.o
Archiving .pio\build\esp32s3_OTA\esp-idf\app_trace\libapp_trace.a
Compiling .pio\build\esp32s3_OTA\app_update\esp_ota_app_desc.c.o
Indexing .pio\build\esp32s3_OTA\esp-idf\app_trace\libapp_trace.a
Compiling .pio\build\esp32s3_OTA\bootloader_support\src\bootloader_common.c.o
Archiving .pio\build\esp32s3_OTA\esp-idf\app_update\libapp_update.a
Compiling .pio\build\esp32s3_OTA\bootloader_support\src\bootloader_common_loader.c.o
Indexing .pio\build\esp32s3_OTA\esp-idf\app_update\libapp_update.a
Compiling .pio\build\esp32s3_OTA\bootloader_support\src\bootloader_clock_init.c.o
Compiling .pio\build\esp32s3_OTA\bootloader_support\src\bootloader_mem.c.o
Compiling .pio\build\esp32s3_OTA\bootloader_support\src\bootloader_random.c.o
Compiling .pio\build\esp32s3_OTA\bootloader_support\src\bootloader_random_esp32s3.c.o
Compiling .pio\build\esp32s3_OTA\bootloader_support\src\bootloader_efuse.c.o
Compiling .pio\build\esp32s3_OTA\bootloader_support\src\flash_encrypt.c.o
Compiling .pio\build\esp32s3_OTA\bootloader_support\src\secure_boot.c.o
Compiling .pio\build\esp32s3_OTA\bootloader_support\bootloader_flash\src\bootloader_flash.c.o
Compiling .pio\build\esp32s3_OTA\bootloader_support\bootloader_flash\src\flash_qio_mode.c.o
Compiling .pio\build\esp32s3_OTA\bootloader_support\bootloader_flash\src\bootloader_flash_config_esp32s3.c.o
Compiling .pio\build\esp32s3_OTA\bootloader_support\src\bootloader_utility.c.o
Compiling .pio\build\esp32s3_OTA\bootloader_support\src\flash_partitions.c.o
Compiling .pio\build\esp32s3_OTA\bootloader_support\src\esp_image_format.c.o
Compiling .pio\build\esp32s3_OTA\bootloader_support\src\idf\bootloader_sha.c.o
Compiling .pio\build\esp32s3_OTA\managed_components\chmorgan__esp-libhelix-mp3\libhelix-mp3\mp3dec.c.o
Compiling .pio\build\esp32s3_OTA\managed_components\chmorgan__esp-libhelix-mp3\libhelix-mp3\mp3tabs.c.o
Compiling .pio\build\esp32s3_OTA\managed_components\chmorgan__esp-libhelix-mp3\libhelix-mp3\real\bitstream.c.o
Compiling .pio\build\esp32s3_OTA\managed_components\chmorgan__esp-libhelix-mp3\libhelix-mp3\real\buffers.c.o
Compiling .pio\build\esp32s3_OTA\managed_components\chmorgan__esp-libhelix-mp3\libhelix-mp3\real\dct32.c.o
Compiling .pio\build\esp32s3_OTA\managed_components\chmorgan__esp-libhelix-mp3\libhelix-mp3\real\dequant.c.o
Compiling .pio\build\esp32s3_OTA\managed_components\chmorgan__esp-libhelix-mp3\libhelix-mp3\real\dqchan.c.o
Compiling .pio\build\esp32s3_OTA\managed_components\chmorgan__esp-libhelix-mp3\libhelix-mp3\real\huffman.c.o
Compiling .pio\build\esp32s3_OTA\managed_components\chmorgan__esp-libhelix-mp3\libhelix-mp3\real\hufftabs.c.o
Compiling .pio\build\esp32s3_OTA\managed_components\chmorgan__esp-libhelix-mp3\libhelix-mp3\real\imdct.c.o
Compiling .pio\build\esp32s3_OTA\managed_components\chmorgan__esp-libhelix-mp3\libhelix-mp3\real\polyphase.c.o
Archiving .pio\build\esp32s3_OTA\esp-idf\bootloader_support\libbootloader_support.a
Compiling .pio\build\esp32s3_OTA\managed_components\chmorgan__esp-libhelix-mp3\libhelix-mp3\real\scalfact.c.o
Compiling .pio\build\esp32s3_OTA\managed_components\chmorgan__esp-libhelix-mp3\libhelix-mp3\real\stproc.c.o
Compiling .pio\build\esp32s3_OTA\managed_components\chmorgan__esp-libhelix-mp3\libhelix-mp3\real\subband.c.o
Compiling .pio\build\esp32s3_OTA\managed_components\chmorgan__esp-libhelix-mp3\libhelix-mp3\real\trigtabs.c.o
Indexing .pio\build\esp32s3_OTA\esp-idf\bootloader_support\libbootloader_support.a
Compiling .pio\build\esp32s3_OTA\cmock\CMock\src\cmock.c.o
Compiling .pio\build\esp32s3_OTA\console\commands.c.o
Compiling .pio\build\esp32s3_OTA\console\esp_console_repl.c.o
Archiving .pio\build\esp32s3_OTA\esp-idf\cmock\libcmock.a
Compiling .pio\build\esp32s3_OTA\console\split_argv.c.o
Compiling .pio\build\esp32s3_OTA\console\linenoise\linenoise.c.o
Compiling .pio\build\esp32s3_OTA\console\argtable3\arg_cmd.c.o
Compiling .pio\build\esp32s3_OTA\console\argtable3\arg_date.c.o
Compiling .pio\build\esp32s3_OTA\console\argtable3\arg_dbl.c.o
Compiling .pio\build\esp32s3_OTA\console\argtable3\arg_dstr.c.o
Indexing .pio\build\esp32s3_OTA\esp-idf\cmock\libcmock.a
Compiling .pio\build\esp32s3_OTA\console\argtable3\arg_end.c.o
Compiling .pio\build\esp32s3_OTA\console\argtable3\arg_file.c.o
Compiling .pio\build\esp32s3_OTA\console\argtable3\arg_hashtable.c.o
Compiling .pio\build\esp32s3_OTA\console\argtable3\arg_int.c.o
Compiling .pio\build\esp32s3_OTA\console\argtable3\arg_lit.c.o
Compiling .pio\build\esp32s3_OTA\console\argtable3\arg_rem.c.o
Archiving .pio\build\esp32s3_OTA\esp-idf\chmorgan__esp-libhelix-mp3\libchmorgan__esp-libhelix-mp3.a
Compiling .pio\build\esp32s3_OTA\console\argtable3\arg_rex.c.o
Compiling .pio\build\esp32s3_OTA\console\argtable3\arg_str.c.o
Compiling .pio\build\esp32s3_OTA\console\argtable3\arg_utils.c.o
Compiling .pio\build\esp32s3_OTA\console\argtable3\argtable3.c.o
Indexing .pio\build\esp32s3_OTA\esp-idf\chmorgan__esp-libhelix-mp3\libchmorgan__esp-libhelix-mp3.a
Compiling .pio\build\esp32s3_OTA\cxx\cxx_exception_stubs.cpp.o
Compiling .pio\build\esp32s3_OTA\cxx\cxx_guards.cpp.o
Compiling .pio\build\esp32s3_OTA\driver\gpio\gpio.c.o
Compiling .pio\build\esp32s3_OTA\driver\gpio\gpio_glitch_filter_ops.c.o
Compiling .pio\build\esp32s3_OTA\driver\gpio\rtc_io.c.o
Compiling .pio\build\esp32s3_OTA\driver\spi\spi_bus_lock.c.o
Archiving .pio\build\esp32s3_OTA\esp-idf\console\libconsole.a
Indexing .pio\build\esp32s3_OTA\esp-idf\console\libconsole.a
Compiling .pio\build\esp32s3_OTA\driver\deprecated\adc_legacy.c.o
Archiving .pio\build\esp32s3_OTA\esp-idf\cxx\libcxx.a
Compiling .pio\build\esp32s3_OTA\driver\deprecated\adc_dma_legacy.c.o
Indexing .pio\build\esp32s3_OTA\esp-idf\cxx\libcxx.a
Compiling .pio\build\esp32s3_OTA\driver\gpio\dedic_gpio.c.o
Compiling .pio\build\esp32s3_OTA\driver\gpio\gpio_pin_glitch_filter.c.o
Compiling .pio\build\esp32s3_OTA\driver\gptimer\gptimer.c.o
Compiling .pio\build\esp32s3_OTA\driver\gptimer\gptimer_priv.c.o
Compiling .pio\build\esp32s3_OTA\driver\deprecated\timer_legacy.c.o
Compiling .pio\build\esp32s3_OTA\driver\i2c\i2c.c.o
Compiling .pio\build\esp32s3_OTA\driver\i2s\i2s_common.c.o
Compiling .pio\build\esp32s3_OTA\driver\i2s\i2s_std.c.o
Compiling .pio\build\esp32s3_OTA\driver\deprecated\i2s_legacy.c.o
Compiling .pio\build\esp32s3_OTA\driver\i2s\i2s_pdm.c.o
Compiling .pio\build\esp32s3_OTA\driver\i2s\i2s_tdm.c.o
Compiling .pio\build\esp32s3_OTA\driver\ledc\ledc.c.o
Compiling .pio\build\esp32s3_OTA\driver\mcpwm\mcpwm_cap.c.o
Compiling .pio\build\esp32s3_OTA\driver\mcpwm\mcpwm_cmpr.c.o
Compiling .pio\build\esp32s3_OTA\driver\mcpwm\mcpwm_com.c.o
Compiling .pio\build\esp32s3_OTA\driver\mcpwm\mcpwm_fault.c.o
Compiling .pio\build\esp32s3_OTA\driver\mcpwm\mcpwm_gen.c.o
Compiling .pio\build\esp32s3_OTA\driver\mcpwm\mcpwm_oper.c.o
Compiling .pio\build\esp32s3_OTA\driver\mcpwm\mcpwm_sync.c.o
Compiling .pio\build\esp32s3_OTA\driver\mcpwm\mcpwm_timer.c.o
Compiling .pio\build\esp32s3_OTA\driver\deprecated\mcpwm_legacy.c.o
Compiling .pio\build\esp32s3_OTA\driver\pcnt\pulse_cnt.c.o
Compiling .pio\build\esp32s3_OTA\driver\deprecated\pcnt_legacy.c.o
Compiling .pio\build\esp32s3_OTA\driver\rmt\rmt_common.c.o
Compiling .pio\build\esp32s3_OTA\driver\rmt\rmt_encoder.c.o
Compiling .pio\build\esp32s3_OTA\driver\rmt\rmt_rx.c.o
Compiling .pio\build\esp32s3_OTA\driver\rmt\rmt_tx.c.o
Compiling .pio\build\esp32s3_OTA\driver\deprecated\rmt_legacy.c.o
Compiling .pio\build\esp32s3_OTA\driver\sdmmc\sdmmc_transaction.c.o
Compiling .pio\build\esp32s3_OTA\driver\sdmmc\sdmmc_host.c.o
Compiling .pio\build\esp32s3_OTA\driver\sigma_delta\sdm.c.o
Compiling .pio\build\esp32s3_OTA\driver\deprecated\sigma_delta_legacy.c.o
Compiling .pio\build\esp32s3_OTA\driver\spi\gpspi\spi_common.c.o
Compiling .pio\build\esp32s3_OTA\driver\spi\gpspi\spi_master.c.o
Compiling .pio\build\esp32s3_OTA\driver\spi\gpspi\spi_slave.c.o
Compiling .pio\build\esp32s3_OTA\driver\spi\sdspi\sdspi_crc.c.o
Compiling .pio\build\esp32s3_OTA\driver\spi\sdspi\sdspi_host.c.o
Compiling .pio\build\esp32s3_OTA\driver\spi\sdspi\sdspi_transaction.c.o
Compiling .pio\build\esp32s3_OTA\driver\spi\gpspi\spi_slave_hd.c.o
Compiling .pio\build\esp32s3_OTA\driver\temperature_sensor\temperature_sensor.c.o
Compiling .pio\build\esp32s3_OTA\driver\deprecated\rtc_temperature_legacy.c.o
Compiling .pio\build\esp32s3_OTA\driver\touch_sensor\touch_sensor_common.c.o
Compiling .pio\build\esp32s3_OTA\driver\touch_sensor\esp32s3\touch_sensor.c.o
Compiling .pio\build\esp32s3_OTA\driver\twai\twai.c.o
Compiling .pio\build\esp32s3_OTA\driver\uart\uart.c.o
Compiling .pio\build\esp32s3_OTA\driver\usb_serial_jtag\usb_serial_jtag.c.o
Compiling .pio\build\esp32s3_OTA\driver\usb_serial_jtag\usb_serial_jtag_connection_monitor.c.o
Compiling .pio\build\esp32s3_OTA\efuse\esp32s3\esp_efuse_table.c.o
Compiling .pio\build\esp32s3_OTA\efuse\esp32s3\esp_efuse_fields.c.o
Compiling .pio\build\esp32s3_OTA\efuse\esp32s3\esp_efuse_rtc_calib.c.o
Compiling .pio\build\esp32s3_OTA\efuse\esp32s3\esp_efuse_utility.c.o
Compiling .pio\build\esp32s3_OTA\efuse\src\esp_efuse_api.c.o
Compiling .pio\build\esp32s3_OTA\efuse\src\esp_efuse_fields.c.o
Compiling .pio\build\esp32s3_OTA\efuse\src\esp_efuse_utility.c.o
Compiling .pio\build\esp32s3_OTA\efuse\src\efuse_controller\keys\with_key_purposes\esp_efuse_api_key.c.o
Compiling .pio\build\esp32s3_OTA\esp-tls\esp_tls.c.o
Archiving .pio\build\esp32s3_OTA\esp-idf\efuse\libefuse.a
Compiling .pio\build\esp32s3_OTA\esp-tls\esp-tls-crypto\esp_tls_crypto.c.o
Compiling .pio\build\esp32s3_OTA\esp-tls\esp_tls_error_capture.c.o
Compiling .pio\build\esp32s3_OTA\esp-tls\esp_tls_platform_port.c.o
Indexing .pio\build\esp32s3_OTA\esp-idf\efuse\libefuse.a
Compiling .pio\build\esp32s3_OTA\esp-tls\esp_tls_mbedtls.c.o
Compiling .pio\build\esp32s3_OTA\esp_adc\adc_cali.c.o
Compiling .pio\build\esp32s3_OTA\esp_adc\adc_cali_curve_fitting.c.o
Compiling .pio\build\esp32s3_OTA\esp_adc\adc_oneshot.c.o
Archiving .pio\build\esp32s3_OTA\esp-idf\driver\libdriver.a
Compiling .pio\build\esp32s3_OTA\esp_adc\adc_common.c.o
Compiling .pio\build\esp32s3_OTA\esp_adc\deprecated\esp_adc_cal_common_legacy.c.o
Compiling .pio\build\esp32s3_OTA\esp_adc\adc_continuous.c.o
Indexing .pio\build\esp32s3_OTA\esp-idf\driver\libdriver.a
Compiling .pio\build\esp32s3_OTA\esp_adc\adc_filter.c.o
Compiling .pio\build\esp32s3_OTA\esp_adc\esp32s3\curve_fitting_coefficients.c.o
Compiling .pio\build\esp32s3_OTA\esp_adc\deprecated\esp32s3\esp_adc_cal_legacy.c.o
Compiling .pio\build\esp32s3_OTA\esp_app_format\esp_app_desc.c.o
src/main.cpp: In function 'void loop()':
src/main.cpp:2769:30: error: 'class KCX_BT_Emitter' has no member named 'list_protokol'
 2769 |             while(bt_emitter.list_protokol(i)){
      |                              ^~~~~~~~~~~~~
In file included from C:/Users/HWH/.platformio/packages/framework-arduinoespressif32/cores/esp32/esp32-hal.h:72,
                 from C:/Users/HWH/.platformio/packages/framework-arduinoespressif32/cores/esp32/Arduino.h:36,
                 from src/common.h:27,
                 from src/main.cpp:1:
src/main.cpp:2770:40: error: 'class KCX_BT_Emitter' has no member named 'list_protokol'
 2770 |                 log_e("%s", bt_emitter.list_protokol(i));
      |                                        ^~~~~~~~~~~~~
C:/Users/HWH/.platformio/packages/framework-arduinoespressif32/cores/esp32/esp32-hal-log.h:246:76: note: in definition of macro 'log_e'
  246 | #define log_e(format, ...)     log_printf(ARDUHAL_LOG_FORMAT(E, format), ##__VA_ARGS__)
      |                                                                            ^~~~~~~~~~~
Compiling .pio\build\esp32s3_OTA\esp_coex\esp32s3\esp_coex_adapter.c.o
Archiving .pio\build\esp32s3_OTA\esp-idf\esp_app_format\libesp_app_format.a
Archiving .pio\build\esp32s3_OTA\esp-idf\esp-tls\libesp-tls.a
Indexing .pio\build\esp32s3_OTA\esp-idf\esp_app_format\libesp_app_format.a
Indexing .pio\build\esp32s3_OTA\esp-idf\esp-tls\libesp-tls.a
Compiling .pio\build\esp32s3_OTA\esp_common\src\esp_err_to_name.c.o
*** [.pio\build\esp32s3_OTA\src\main.cpp.o] Error 1
=============================================================== [FAILED] Took 44.00 seconds ===============================================================
Environment    Status    Duration
-------------  --------  ------------
esp32s3_OTA    FAILED    00:00:44.003
========================================================== 1 failed, 0 succeeded in 00:00:44.003 ==========================================================
 *  Der Terminalprozess "C:\Users\HWH\.platformio\penv\Scripts\platformio.exe 'run', '--environment', 'esp32s3_OTA'" wurde mit folgendem Exitcode beendet: 1.
 *  Das Terminal wird von Aufgaben wiederverwendet, drücken Sie zum Schließen eine beliebige Taste.
`

schreibfaul1, 2024-11-01:
Das Protokoll gibts noch nicht lange. Das habe ich eingebaut, um zu sehen was auf der UART Schnittstelle vom KCX BT Emitter passiert.
Gehe auf die Ameise und dann auf "Full Clean" damit die Bibliothek neu geladen wird.

Du kannst im Terminal btp<ENTER> eintippen, einfach blind ins Terminalfenster, dann kommt das Protokoll und sieht etwa so aus:
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

HWH53, 2024-11-02:
Hallo Wolle,
danke für die schnelle Antwort!
Alles arbeitet nun wieder einwandfrei.😅
mfg
Helmut

Closed 2024-11-02.

Thread 552 (2024-11-06):

sd card issue

Vital1984, 2024-11-06:
hi guys

ich have this problem . and can not figure out whats the problem. try different sd cards different sd card adapter everytime same result.

maybe some one can help ?

ESP32 Chip: ESP32-S3
Arduino Version: 3.0.5
ESP-IDF Version: 5.1.4
MiniWebRadio     Version 3.5t - Nov 04/2024
ARDUINO_LOOP_STACK_SIZE 8192 words (32 bit)
FLASH size 16777216 bytes, speed 80 MHz
CPU speed 240 MHz
SDMMC speed 80 MHz
TFT speed 40 MHz
PSRAM total size: 8374816 bytes
RESET_REASON: Reset due to power-on event

00:00:00
00:00:00        ***************************
00:00:00        *     MiniWebRadio V3     *
00:00:00        ***************************
00:00:00
00:00:00 setup: ....  Arduino is pinned to core 1
00:00:00 tft_info: .  init ILI9341
00:00:00 setup: ....  Init SD card
E (211) sdmmc_common: sdmmc_init_ocr: send_op_cond (1) returned 0x107
E (211) vfs_fat_sdmmc: sdmmc_card_init failed (0x107).
[  1158][E][SD_MMC.cpp:190] begin(): Failed to initialize the card (0x107). Make sure SD card lines have pull-up resistors in place.
00:00:00 SD Card Mount Failed

kpbicka, 2024-11-06:
Если есть разные шилды картридеров, попробуй их - на всех стоят разные резисторы подтяжки
Для разных говённых микроСД карт может помочь снижение скорости SPI
Возможно длинные провода до ридера
Посмотри картинки от wolle - там нарисованы SMD-резисторы которые или надо удалить или наоборот установить

schreibfaul1, 2024-11-06:
SD_MMC does not require any external resistors. You can connect the SD card directly to the pins of the ESP32.
Some displays with a built-in SD card adapter have resistors that are connected in series. These should be bridged.

Vital1984, 2024-11-06:
hi danke ja das habe ich auch schon versucht die sd karte direkt an den esp32 ohne adapter und ähnliches leider ohne erfolg. jetzt habe ich irgend einen den ich noch liegen hatte ausprobiert damit geht es nun. habe aber nun andere probleme. weis nicht ob ich einen neuen post dazu aufmachen soll oder lieber hier schreiben .

und zwar bekomme ich kein wifi verbindung ob ich meine zugangsdaten in die common.h schreibe oder auf die sdkarte es verbindet sich nicht zu meinem wlan.

und um mich mit dem Accespoint zu verbinden geht auch nicht .es wird einfach nicht gefunden

schreibfaul1, 2024-11-06:
Dann gehe ich davon aus, dass die SD Karte nicht mehr das Problem ist.

Der ESP32 kommt manchmal mit den Einstellungen des Routers nich klar.
Ich habe hier eine Fritzbox und wenn WPA2+WPA3 eingestellt ist funktioniert es nicht. WPA2(CCMP) hingegen funktioniert. Vielleicht ist es bei deinem Router ähnlich?

Closed 2024-12-23.

Thread 563 (2024-11-21):

IR Signal der FB wird nicht immer erkannt

skassel2024, 2024-11-21:
Hallo Wolle,
das IR Signal der FB wird nicht immer erkannt. Im Abstand von wenigen cm funktioniert es besser, obwohl die LED am Empfänger ein Signal, auch bei 4m Abstand anzeigt (Bild). Habe es im Versuchsaufbau mit IR_PIN, INPUT in main.cpp und mit und ohne externem Pullup-Widerstand (47k) probiert. Aber keine Besserung. Aus unerklärlichen Gründen funktioniert es manchmal. Aber meist dann nur einmal, ein weiterer Tastendruck wird dann nicht erkannt. (Timing?, Impulslänge in Library?)
Gruß Sören
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

clear-sky, 2024-11-21:
Hi Dear [skassel2024](https://github.com/skassel2024)
#400

clear-sky, 2024-11-21:
Hi Dear [valera39](https://github.com/valera39)
i have used arduino ir reciever (vs838) in other projects based on esp32 with wifi enabled which works easily from a distance of 10 meters!
but in MWR does not work well- wolle has solved this problem with shocking mcu with signals that have 5v edges- technically this way is not correct and problem is in software

skassel2024, 2024-11-22:
Thanks clear-sky, valera39, Wolle for the detailed explanation. I must have overlooked it. Now it works really well with the TSOP4838. No problem up to 6m, even in the immediate vicinity of the WIFI antenna also with 3,3V or 5V VSS

Closed 2025-01-06.

Thread 574 (2024-12-13):

A1S Audiokit - I2C connection with ES8388 and another device, e.g. 20x4 LCD

devwmbr, 2024-12-13:
Hello,

I started successfuly ESP32 A1S example ( https://github.com/schreibfaul1/ESP32-audioI2S/tree/master/examples/ESP32_A1S ) on my A1S Audio kit (v2.2, A436), but I have problem with 20x4 alphanumeric LCD via I2C connection on pins IO21, IO22 (pcb top right connector ). The display itself working ok on Audiokit, but with together example, Serial.print() returns DAC connection failed.
My version Audiokit properly works with 32 and 33 I2C pins like in oryginal .ino example (lines 36-37 in .ino file).
I saw that object creating order in Setup() matters.
If I create like this:

```
LCD.begin();
while (not dac.begin(IIC_DATA, IIC_CLK))
    {
        Serial.printf("Failed!\n");
        delay(1000);
    }

```
display working ok, but DAC connection failed.
If I create like this:

```
while (not dac.begin(IIC_DATA, IIC_CLK))
    {
        Serial.printf("Failed!\n");
        delay(1000);
    }
LCD.begin();
```
display is only backlighted, DAC connection is OK

Is there any conflict with 21,22 I2C and internal 32,33 I2C?

Regards
Devwmbr

schreibfaul1, 2024-12-15:
maybe like this:

TwoWire             i2cBusOne = TwoWire(0);
TwoWire             i2cBusTwo = TwoWire(1);
ES8388 dac(&i2cBusOne);
if(!dac.begin(I2C_DAC_SDA, I2C_DAC_SCL, 400000)) { log_e("The DAC was not be initialized"); }
....

devwmbr, 2024-12-16:
Hello,
Yesterday evening I tried another library: LiquidCrystal_PCF8574 where author in comment section gave example similar like yours
and now working great.
Currently my code looks like below:

```
#include "LiquidCrystal_PCF8574.h"
TwoWire Wire_1 = TwoWire(0x27);
LiquidCrystal_PCF8574 lcd(0x27);
```
```
void setup()
{
 // oryginal source without any changes

    /* LCD  */
    Wire_1.begin(21, 22);      // custom i2c port on ESP
    Wire_1.setClock(100000);   // standard 100kHz speed
    lcd.begin(16, 2, Wire_1);
    lcd.setBacklight(255);

 // oryginal source without any changes

}
```

I will try today evening your approach.
Thank you very much.

Regards

Closed 2025-01-31.

Thread 585 (2024-12-28):

sleep timer buttons

valera39, 2024-12-28:
Hello Dear Wolle!
I'm using three different remotes for the radio that I made, and none of them can change the sleep timer off time in the new firmware. The assigned up and down buttons on the remotes do not change the sleep timer off time. In the last version, I used the left-right buttons to change the sleep timer off time.
My remotes. These are the only remotes I have that work without mutual interference with the TV and set-top boxes next to each other
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
Your answer is very important to me.
Success and health in the new year!

schreibfaul1, 2024-12-30:
Hi valera39,
you must mean this layout:
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
Arrow right/left changes the buttons and OK is the click.
Here is my ir_buttons.json for the middle remote control in your photo. It works for me.
[ir_buttons.json](https://github.com/user-attachments/files/18276228/ir_buttons.json)
Simply load via the website and perform a reset.

Best wishes for the new year!
Wolle

valera39, 2024-12-30:
Thank you very much, your settings probably make more sense for the control. I will now try to adapt the other two remotes.
I would also like to ask you to make a "reset" button in the web interface of the radio to make it easier to control it.
All the best!

schreibfaul1, 2024-12-30:
Unlike the Toch display, I need to know where I am with the remote control.
I achieve this with "ok" and a button is coloured magenta in the menu.
I can use the right and left arrow keys to jump to the next button. "ok" then activates this button. The same applies to the lists with the up or down arrow.
This already works everywhere except for setting the time for the alarm clock. I haven't managed that yet.
What is the "Reset button" supposed to do?

valera39, 2024-12-30:
The reset button should reboot the radio. similar to the reset button (pin EN) on the ESP32

valera39, 2025-01-02:
Hello Dear Wolle!
is my offer worthy of your consideration?

schreibfaul1, 2025-01-04:
I don't know exactly how useful this is. If the radio runs in an endless loop, a SW reset will not work. Then only a HW reset or briefly switching off the power will help.

Closed 2025-01-07.

Thread 588 (2025-01-04):

SD, microSD cards and microSD board wiring

Kicadder, 2025-01-04:
Hope this can be of any use...
[SD_microSD_wiring.odt](https://github.com/user-attachments/files/18305060/SD_microSD_wiring.odt)

schreibfaul1, 2025-01-04:
The pins for the SD_MMC are fixed for the ESP32 and freely selectable for the ESP32-S3. With the ESP32, D0 must not have an external PullUP resistor. In the simplest case, the SD card can be connected directly to the pins of the ESP32.

mickeypop, 2025-01-11:
how is it that you leave off the CS on the SD card

CataCluj, 2025-01-26:
> how is it that you leave off the CS on the SD card

It seems it's used in SD_MMC mode that doesn't require CS.
I still couldn't get the SD card to work!

CataCluj, 2025-01-26:
All docs specify 10K Pull-Ups on some pins. These are not the series resistors proposed to be replaced with jumpers.
I'm still confused which pins (apparently even some that are not connected to MCU) need Pull-Ups.
In fact I'm confused because whatever I tried, I couldn't get the SD card to work. The project goes no further than that.
It would be nice to have a mode that uses the built in web browser and IR for all controls and save some stations in flash, without SD card and display (just because it needs SD).

CataCluj, 2025-01-26:
I got mine (MicroSD card) to work. My problem was that I used a MicroSD adapter wired like the SD card.
Problem is, Pin 3 of the Adapter is NOT connected to the MicroSD ground; one has to use Pin 6.
Before I found this I added 10K pullups on all pins, so unsure if all are needed, but it now works for me.

Thread 600 (2025-01-19):

Remote control in version 3.6

samand587, 2025-01-19:
Dear author!  I tried to connect the remote control. Commands are not accepted or configured in the browser. The remote looks like this. The sensor of the remote control is connected correctly. What can I see?

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

Kicadder, 2025-01-20:
Hello samand,
You could check your RC (remote control) with a camera (that of your phone for example). The RC, when emitting (pushing a key) sends a IR ray that is visible by the camera.
If this is OK, you could check the IR receiver IC : +5V, ground and output. If you have a multimeter, the voltage at output must vary of several tenth of volts when you press a key on the RC.
I have already used the same RC you use : no problem with that model

samand587, 2025-01-20:
Thanks for the tips! I've checked it all, and everything is fine. And what address do you specify for the remote control?

schreibfaul1, 2025-01-20:
The address code is fixed for each remote control. The "IR command" field is updated each time a button is pressed. If everything is OK, this will also happen. You can then assign the button to a function. This is necessary so that as many different remote controls as possible can be used

samand587, 2025-01-20:
How can I find out the fixed code for my remote?

samand587, 2025-01-21:
Hello, author!  I changed two remote control sensors- the commands do not go through the browser.  When you press a button on the remote, the sensor reacts, but there are no changes in the browser. I've tried different browsers. The sensor is standard from Arduino, connected to pin 35.

skassel2024, 2025-01-21:
Hello,[samand587](https://github.com/samand587)
Standard sensor from Arduino are very poor. Please read closed Issue #563.

samand587, 2025-01-25:
TSOP34838 It works great!

Closed 2025-01-25.

Thread 634 (2025-02-16):

ESP32 S3 N16R8 CAM -  A better module for the project ?

slot00753, 2025-02-16:
Dear Wolle!
First, Thanks very much for delivering this amazing project to us diy audiophiles.

Playing around it for a while, I have had much pain with micro-SD storage (even at speed of 10MHz).
I thought it would be nice to have it on the module - no wires, no bad contacts, no failed mounts.
Ealier I spent some time with ESP32 CAM which had a micro SD holder onboard.
So why not use its successor - ESP32-S3 N16R8 CAM module?
Say, this one from aliexpress. Search for "esp32 n16r8 cam"

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

I obtained one - and read/write/mount errors have gone! Raised speed to 80 MHz - ok.
Migration from ordinary S3 went seemless, no software updates needed except redefining

#define SD_MMC_D0  40 //Please do not modify it.
#define SD_MMC_CLK 39 //Please do not modify it.
#define SD_MMC_CMD 38 //Please do not modify it.

Sorry for my noise if many of you have already found this device and use it.

schreibfaul1, 2025-02-16:
I don't know this board. I think it will work.
You can also connect the SD card directly (3.3V, GND, CMD, D0, SCK) you don't need any other components.

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

The current SD cards all manage 80MHz.

slot00753, 2025-02-16:
The bottom side of the above module with onboard microSD holder:

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

schreibfaul1, 2025-02-17:
You can unpack the data onto the SD card and compile and run. You can then see what happens in the terminal. If everything is OK, the programme will run without the DAC and display and you will have access via the web browser.

slot00753, 2025-02-17:
Dear Wolle, I am afraid you did not get me right.
Due to your efforts I've  built a fully functional MiniWebRadio project (except OTA :() on esp32s3 but with unreliable and faulty micoSD storage unit. I tried all possible options but was not satisfied until I found esp32s3 n16r8 cam module with onboard microSD holder which I mentioned in the beginning of my post.

I've just wondered if my diy-colleagues know about it  (or I am the only one who don't).  No doubt I recommend it for this project

Closed 2025-04-03.

Thread 638 (2025-02-27):

Display touch doesn't work properly

linoreale, 2025-02-27:
Hi everyone,
I built the miniweb radio based on your project and it works, but there's a problem with display's touch system.
I'm using a ESP32-S3 N16R8 board and an ILI9488 display. On system boot it shows esp web radio logo and then last radio starts playng, but touch screen doesn't respond correctly, if I touch an icon, the led on esp board blinks but no action happens or wrong action or function starts.
Could it be a display problem, a wrong wiring or a known software problem?
Thanks and regards

Michele

skassel2024, 2025-02-27:
richtige TP_VERSION, TP_ROTATION, TP_H_MIRROR, TP_V_MIRROR in common.h ?
Bei ILI9488 TP_VERSION auf 4 setzen. Standard ist 5 (ST7796)

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

linoreale, 2025-02-27:
Hi skassel2024,
yes, I set 4 for ILI9488 and left other as default.
What can I try  in addition?
Thanks and regards

schreibfaul1, 2025-02-27:
Some displays have a design flaw, maybe it's the same with your display?
https://github.com/schreibfaul1/ESP32-MiniWebRadio/tree/V4-pre-release?tab=readme-ov-file#display

valera39, 2025-02-27:
[linoreale](https://github.com/linoreale), Try installing the touchpad version from a different display, such as ILI9486

linoreale, 2025-02-27:
Okay,
so, have I try to disconnect TFT_DC or TFT_CS pin?
Thanks a lot to you all!
Regards

valera39, 2025-02-27:
[linoreale](https://github.com/linoreale), TFT_DC and TFT_CS do not need to be disabled

linoreale, 2025-03-01:
Hi,
on common.h I modified all the availlable variables but it's still not working. Screen shows images correctly but it seems touch pad is rotated on 90 degrees and no option modfies this.
Tried setting different display, rotation mirror and so on but it doesn't woek
what can I try again?
above my commn.h
```
// clang-format off
#define _SSID                   "050153"                        // Your WiFi credentials here
#define _PW                     "amorredimicionne"                // Or in textfile on SD-card
#define DECODER                 1                               // (1)MAX98357A PCM5102A CS4344... (2)AC101, (3)ES8388
#define TFT_CONTROLLER          4                               // (0)ILI9341, (1)HX8347D, (2)ILI9486a, (3)ILI9486b, (4)ILI9488, (5)ST7796, (6)ST7796RPI
#define DISPLAY_INVERSION       0                               // (0) off (1) on
#define TFT_ROTATION            1                               // 1 or 3 (landscape)
#define TFT_FREQUENCY           40000000                        // 80000000, 40000000, 27000000, 20000000, 10000000
#define TP_VERSION              6                               // (0)ILI9341, (1)ILI9341RPI, (2)HX8347D, (3)ILI9486, (4)ILI9488, (5)ST7796, (6)ST7796RPI, (7)GT911
#define TP_ROTATION             1                               // 1 or 3 (landscape)
#define TP_H_MIRROR             0                               // (0) default, (1) mirror up <-> down
#define TP_V_MIRROR             0                               // (0) default, (1) mittor left <-> right
#define I2S_COMM_FMT            0                               // (0) MAX98357A PCM5102A CS4344, (1) LSBJ (Least Significant Bit Justified format) PT8211
#define SDMMC_FREQUENCY         80000000                        // 80000000 or 40000000 Hz
#define FTP_USERNAME            "esp32"                         // user and pw in FTP Client
#define FTP_PASSWORD            "esp32"
#define CONN_TIMEOUT            2500                            // unencrypted connection timeout in ms (http://...)
#define CONN_TIMEOUT_SSL        3500                            // encrypted connection timeout in ms (https://...)
#define WIFI_TX_POWER           5                               // 2 ... 21 (dBm) Adjust the WiFi transmission power to optimise power consumption or increase range, default: 5

```

valera39, 2025-03-01:
[linoreale](https://github.com/linoreale), and have you tried this combination TFT_ROTATION 1 and define TP_ROTATION 3
or TFT_ROTATION 3 and define TP_ROTATION 1 ?

valera39, 2025-03-01:
Do you have the same display?
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

linoreale, 2025-03-01:
Hi valera39,
It seems the same.
Anyway, have I change values in common.h , build , compile and upload each time?
Thanks a lot, I'll try you suggestion.
Regards

valera39, 2025-03-01:
[linoreale](https://github.com/linoreale), Yes, exactly like that, change one parameter, compile, test. If it doesn't fit, change it again and so on until we get what we need.
I also fiddled with such a display for a long time until I set it up correctly :)
I don't buy such displays anymore

valera39, 2025-03-01:
[linoreale](https://github.com/linoreale).  Here I found in my archive common.h from the second version of the radio with such display. Try it, maybe it will help
#define _SSID               "***"                        // Your WiFi credentials here
#define _PW                 "***"
#define DECODER             0                               // (0)VS1053 , (1)MAX98357A PCM5102A... (2)AC101 (3)ES8388 (4)WM8978
#define TFT_CONTROLLER      4                               // (0)ILI9341, (1)HX8347D, (2)ILI9486a, (3)ILI9486b, (4)ILI9488, (5)ST7796, (6)ST7796RPI
#define DISPLAY_INVERSION   0                               // (0) off (1) on
#define TFT_ROTATION        1                               // 1 or 3 (landscape)
#define TFT_FREQUENCY       40000000                        // 27000000, 40000000, 80000000
#define TP_VERSION          3                               // (0)ILI9341, (1)ILI9341RPI, (2)HX8347D, (3)ILI9486, (4)ILI9488, (5)ST7796, (3)ST7796RPI
#define TP_ROTATION         3                               // 1 or 3 (landscape)
#define AUDIOTASK_CORE      0                               // 0 or 1
#define AUDIOTASK_PRIO      2                               // 0 ... 24  Priority of the Task (0...configMAX_PRIORITIES -1)
#define SDMMC_FREQUENCY     20000000                        // 40000000, 2000000, 10000000, not every SD Card will run at 40MHz
#define FTP_USERNAME        "esp32"                         // user and pw in FTP Client
#define FTP_PASSWORD        "esp32"
#define CONN_TIMEOUT        500                             // unencrypted connection timeout in ms (http://...)
#define CONN_TIMEOUT_SSL    2000                            // encrypted connection timeout in ms (https://...)

linoreale, 2025-03-06:
Hi,
I tried all availlable displays in the code list but touch panel doesn't still work properly, it remains 90° rotated, even though I set rotation 1 or 3 on each display version.
What else can I try? Is there something else to change in the code?
What display version works for sure, so I buy it?
Thanks and regards

linoreale, 2025-03-10:
Hi,
I'm wondering if there are any other tp_rotation option to use in addition to provided options or if it's possible to use other display drivers in the code
thamks

linoreale, 2025-03-16:
Hi,
are there any other options for tp_rotation in addition to 1 and 3?

valera39, 2025-03-16:
Hi,
I set it to 2, but I got portrait mode. So there are no other options

valera39, 2025-03-16:
This kind of display has kind of a mirrored touchpad. You could of course ask Wolle to add changes to the code for such displays, but I think he is very busy with the new version or other things

linoreale, 2025-03-16:
Valera39, please suggest me a display that works for sure on this project, so I can buy a new one.
Thanks

valera39, 2025-03-16:
[linoreale](https://github.com/linoreale), I can't show a photo as the displays are already built into the radio, but bought it here, works great https://github.com/schreibfaul1/ESP32-MiniWebRadio/issues/649#issuecomment-2716946401

Closed 2025-05-01.

Thread 647 (2025-03-04):

h_sync Bild instabil

skassel2024, 2025-03-04:
Hi Wolle,
mir ist aufgefallen, dass bei Streams 64K aac teilweise das Bild horizontal "zittert" Bei anderen Streams mit 128K mp3 oder höher taucht das Problem nicht auf.
vG Sören

skassel2024, 2025-03-05:
Hi Wolle,
hab noch weiter getestet. Das Problem tritt anscheinend nur bei AAC Streams (64K) auf.
vG Sören

schreibfaul1, 2025-03-05:
Hi Sören,
das ist mir bisher nicht aufgefallen. Ich benutzte nur das Sunton Display, das ist das, was ich "umgebaut" habe.
Es scheint einen Zusammenhang mit dem PCLK Takt zu geben. Großer 11 MHz scheint die Lastgrenze zu sein. Getestet habe ich mit https://stream.studio21.ru/studio2196.aacp (96KBit). Das Elecrow Display kann ich auf 11MHz stellen und das Flackern ist verschwunden.
Beim Waveshare Display ist < 12MHz das Bild weg. Hab noch keine keine Ahnung warum.

schreibfaul1, 2025-03-06:
Ich habe es etwas optimiert.  Mit https://stream.studio21.ru/studio2196.aacp habe ich auf dem Waveshare Display seit Minuten ein stabiles Bild ohne Flackern.
1) Im AAC Dekoder sind alle Makros jetzt Inline-Funktionen.
2) menuconfig: PSRAM ohne ECC

Und getestet habe ich mit diesen Einstellungen: [docs/rgb displays/Waveshare 7' Display/Waveshare_7inch.txt](https://github.com/schreibfaul1/ESP32-MiniWebRadio/blob/V4-pre-release/docs/rgb%20displays/Waveshare%207'%20Display/Waveshare_7inch.txt)

skassel2024, 2025-03-07:
Hi Wolle,
mit den Änderungen ist zwar das Flackern weg, aber ein Umschalten der Sender dauert teilweise über eine Minute. mit
folgenden Fehlermeldungen:

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

Nach folgender Änderung in der common.h funktioniert die Senderumschaltung wieder, Fehlermeldungen sind weg, aber das Flackern ist auch wieder da:

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

Das Datenblatt des ST7262 System-On-Chip Driver for 800RGBx480
TFT LCD gibt folgende sync Werte an:

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

Das Flackern ist weiterhin nur bei AAC. Bei mp3 ist alles in Ordnung.

In diesem Zusammenhang ist mir aber noch folgendes aufgefallen (erst durch die Fehlermeldungen):
Bei DLNA werden keine Musikfiles gefunden. Da bin ich noch dran. Möglicherweise liegt das aber an den Freigaben. Oder hast Du da einen Tip?
vG Sören
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

schreibfaul1, 2025-03-07:
Hallo @Jason2866,
danke für deinen Beitrag. DMA für I2S und fürs Display bringen den S3 an die Grenze. Scheinbar lässt sich der Takt fürs Waveshare Display nicht unter 12MHz verringen. Bei meinem Sunton und Elecrow Display ist das kein Problem. Die Bildwiederholrate ist bei diesem Projekt nicht so entscheidend zumal in den Framebuffer geschrieben wird.

Das ist mein Waveshare mit 12MHz, leider kein Ton, ich habe kein DAC angeschlossen.
https://github.com/user-attachments/assets/09f2e9cf-0166-4be5-9b98-32949d83d93c

Jason2866, 2025-03-07:
Sieht so aus als dass du den Balance Akt hinbekommen hast! Meiner Erfahrung nach funktioniert 12Mhz mit allen RGB Boards. Ist ja auch noch in der Spezifikation.

skassel2024, 2025-03-07:
Hallo zusammen,
das Flackern hält sich nun in Grenzen. Benutze eben nur Streams mit mp3.
Mir gefällt das Waveshare wegen des Rahmens und der einfachen Einbauweise.
Wolle, wie könnte man die CPU-Auslastung über den Testmodus abfragen zusätzlich zu der Speicherauslastung?
vG Sören

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

https://github.com/user-attachments/assets/d9c9d108-4b5c-462b-ab32-8fc504c220d6

schreibfaul1, 2025-03-07:
Du kannst im Terminal rts<ENTER> eintippen und erhälst die "Run Time Statistics", also die Auslastung der Tasks, das sieht dann so aus:

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

Ich habe fas Display jetzt etwa eine Stunde am laufen mit dem aac "Studio21" Stream ohne Flackern. Bei AAC wird die CPU besondes gefordert. Während andere Codecs in einer Tabelle nachschauen oder nach "Kochbuch" verfahren ist es bei AAC anders. Der AAC Dekoder rechnet mit komplexen Zahlen.

Unser Waveshare Display hat zusätzliche ICs mit für CAN-Bus, RX484 und Portexpander. Ich kann mir vorstellen, dass es Beeinflussungen gibt, z.B kann der Protexpander das Display oder das TP zurücksetzen wenn es schlecht läuft.

skassel2024, 2025-03-07:
Welche Werte hast Du für hsync und vsync?
Bei 12Mhz ist zwar das Flackern weg, aber der Senderwechsel ist wieder extrem langsam. Daher bin ich wieder auf 13Mhz zurück.

skassel2024, 2025-03-11:
Hallo Wolle,
unter folgendem Link habe ich etwas interressantes gefunden: https://github.com/arendst/Tasmota/discussions/22553
Mit folgenden Werten habe ich ein flackerfreies Bild bei "Studio 21" und eine schnelle Senderumschaltung ohne Abstürze:

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
vG Sören

schreibfaul1, 2025-03-11:
Hallo Sören,
das hört sich gut an!
Ich habe ein flackerfreies Bild mit deinen Einstellungen, außer PCLK. Mein Display streikt bei 11,8MHz,
die unterste Grenze ist 12MHz und die Version ist  V1.1.

beste Grüße
Wolle

skassel2024, 2025-03-11:
Hi Wolle,
mein Display ist auch V1.1 mit ESP32-S3 N8R8. Bei Dir ist in platformio aber N4R8 voreingestellt.

meine Einstellung:

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

Habe versucht den .pixel_clock_hz noch weiter zu verringern. Bei 11,4Mhz ist auch bei mir schluss. 11,5Mhz geht noch.

skassel2024, 2025-03-14:
Hallo Wolle,
seit 3 Tagen ohne flackern bei 11,5Mhz :-)))

Aber bei DLNA habe ich noch Probleme. Entweder timeout, oder es werden nicht alle Dateien im Ordner des Medienservers angezeigt. Bei mehrmaligem Aufruf (btn_DL_filelist) weden dann mal alle oder nur teilweise angezeigt.

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
Beim zurückblättern kommt dann meist:
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
vG Sören

schreibfaul1, 2025-03-14:
Ja, habs auch,
das ist mei DLNA Server der Fritzbox:

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

ich habe noch keine Ahnung warum es nicht geht.

Closed 2025-04-28.

Thread 653 (2025-03-17):

Problems with VSCode

valera39, 2025-03-17:
Hello everyone!  Help please. Building a radio ends with an error. It happened suddenly, previously worked fine. I reinstalled extensions and deleted the cache, but to no avail.
Part of the error log:
Verbose mode can be enabled via `-v, --verbose` option
CONFIGURATION: https://docs.platformio.org/page/boards/espressif32/ESP32-S3-DevKitC-1-N8R8.html
PLATFORM: Espressif 32 (53.3.13) > Espressif ESP32-S3-DevKitC-1-N8R8 (8 MB QD, 8 MB OT PSRAM)
HARDWARE: ESP32S3 240MHz, 320KB RAM, 8MB Flash
DEBUG: Current (esp-builtin) On-board (esp-builtin) External (cmsis-dap, esp-bridge, esp-prog, iot-bus-jtag, jlink, minimodule, olimex-arm-usb-ocd, olimex-arm-usb-ocd-h, olimex-arm-usb-tiny-h, olimex-jtag-tiny, tumpa)
PACKAGES:
 - framework-arduinoespressif32 @ 3.1.3
 - framework-arduinoespressif32-libs @ 5.3.0+sha.489d7a2b3a
 - framework-espidf @ 3.50302.0 (5.3.2)
 - tool-cmake @ 3.30.2
 - tool-esptoolpy @ 4.8.6
 - tool-mklittlefs @ 3.2.0
 - tool-ninja @ 1.9.0
 - tool-riscv32-esp-elf-gdb @ 14.2.0+20240403
 - tool-xtensa-esp-elf-gdb @ 14.2.0+20240403
 - toolchain-esp32ulp @ 1.23800.240113 (2.38.0)
 - toolchain-riscv32-esp @ 13.2.0+20240530
 - toolchain-xtensa-esp-elf @ 13.2.0+20240530
*** "custom_component" is used to select managed idf components ***
Warning! Arduino framework as an ESP-IDF component doesn't handle the `variant` field! The default `esp32` variant will be used.
Reading CMake configuration...
-- Found Git: C:/Program Files/Git/cmd/git.exe (found version "2.40.1.windows.1")
-- git rev-parse returned 'fatal: not a git repository (or any of the parent directories): .git'
-- The C compiler identification is GNU 13.2.0
-- The CXX compiler identification is GNU 13.2.0
-- The ASM compiler identification is GNU
-- Found assembler: C:/Users/admin/.platformio/packages/toolchain-xtensa-esp-elf@13.2.0+20240530/bin/xtensa-esp32s3-elf-gcc.exe
-- Detecting C compiler ABI info
-- Detecting C compiler ABI info - done
-- Check for working C compiler: C:/Users/admin/.platformio/packages/toolchain-xtensa-esp-elf@13.2.0+20240530/bin/xtensa-esp32s3-elf-gcc.exe - skipped
-- Detecting C compile features
-- Detecting C compile features - done
-- Detecting CXX compiler ABI info
-- Detecting CXX compiler ABI info - done
-- Check for working CXX compiler: C:/Users/admin/.platformio/packages/toolchain-xtensa-esp-elf@13.2.0+20240530/bin/xtensa-esp32s3-elf-g++.exe - skipped
-- Detecting CXX compile features
-- Detecting CXX compile features - done
-- git rev-parse returned 'fatal: not a git repository (or any of the parent directories): .git'
-- Could not use 'git describe' to determine PROJECT_VER.
-- Building ESP-IDF components for target esp32s3
-- Configuring incomplete, errors occurred!

fatal: not a git repository (or any of the parent directories): .git
CMake Error at C:/Users/admin/.platformio/packages/framework-espidf/tools/cmake/build.cmake:572 (message):
  C:\Users\admin\.platformio\penv\.espidf-5.3.2\Scripts\python.exe: Error
  while finding module specification for
  'idf_component_manager.prepare_components' (ModuleNotFoundError: No module
  named 'idf_component_manager')

Call Stack (most recent call first):
  C:/Users/admin/.platformio/packages/framework-espidf/tools/cmake/project.cmake:717 (idf_build_process)
  CMakeLists.txt:3 (project)

========================= [FAILED] Took 10.58 seconds =========================

Environment    Status    Duration
-------------  --------  ------------
esp32s3        FAILED    00:00:10.582
==================== 1 failed, 0 succeeded in 00:00:10.582 ====================

valera39, 2025-03-18:
Tried again today to clone and build the master version. Failed again.
Dear Wolle, can you help?
Here is the full VSCode log:
Resolving esp32 dependencies...
Tool Manager: Installing https://github.com/espressif/arduino-esp32/releases/download/3.1.3/esp32-3.1.3.zip
Unpacking 0% 10% 20% 30% 40% 50% 60% 70% 80% 90% 100%
Tool Manager: framework-arduinoespressif32@3.1.3 has been installed!
Tool Manager: Installing https://github.com/espressif/esp32-arduino-lib-builder/releases/download/idf-release_v5.3/esp32-arduino-libs-idf-release_v5.3-489d7a2b-v1.zip
Downloading 0% 10% 20% 30% 40% 50% 60% 70% 80% 90% 100%
Unpacking 0% 10% 20% 30% 40% 50% 60% 70% 80% 90% 100%
Tool Manager: framework-arduinoespressif32-libs@5.3.0+sha.489d7a2b3a has been installed!
Tool Manager: Installing https://github.com/pioarduino/esp-idf/releases/download/v5.3.2.250210/esp-idf-v5.3.2.zip
Downloading 0% 10% 20% 30% 40% 50% 60% 70% 80% 90% 100%
Unpacking 0% 10% 20% 30% 40% 50% 60% 70% 80% 90% 100%
Tool Manager: framework-espidf@3.50302.0 has been installed!
Library Manager: Installing git+https://github.com/schreibfaul1/ESP32-audioI2S.git#213e0e6
git version 2.49.0.windows.1
Cloning into 'C:\Users\admin\.platformio\.cache\tmp\pkg-installing-6o4o0gom'...

HEAD is now at 213e0e6 BBC HLS Radio deleted #604
Library Manager: ESP32-audioI2S@3.0.13+sha.213e0e6 has been installed!
Library Manager: Installing git+https://github.com/schreibfaul1/ESP32-KCX-BT-EMITTER.git#6181da6
git version 2.49.0.windows.1
Cloning into 'C:\Users\admin\.platformio\.cache\tmp\pkg-installing-amnn7bom'...

HEAD is now at 6181da6 small changes
Library Manager: ESP32-KCX-BT-EMITTER@0.0.0+20240128094011.sha.6181da6 has been installed!
Library Manager: Installing git+https://github.com/schreibfaul1/ESP32-DLNA-Client.git#48b53f4
git version 2.49.0.windows.1
Cloning into 'C:\Users\admin\.platformio\.cache\tmp\pkg-installing-cswojflv'...

HEAD is now at 48b53f4 break if 3x no response
Library Manager: ESP32-DLNA-Client@0.0.0+20231205185914.sha.48b53f4 has been installed!
Library Manager: Installing git+https://github.com/schreibfaul1/ESP32-IR-Remote-Control.git#c371281
git version 2.49.0.windows.1
Cloning into 'C:\Users\admin\.platformio\.cache\tmp\pkg-installing-8yx2gn8x'...

HEAD is now at c371281 new long pressed key impl.
Library Manager: ESP32-IR-Remote-Control@1.0.10+sha.c371281 has been installed!
Updating metadata for the vscode IDE...
UserSideException: Processing esp32 (board: ESP32-Dev-4MB; platform: https://github.com/pioarduino/platform-espressif32/archive/refs/tags/53.03.13.zip; framework: arduino, espidf)
--------------------------------------------------------------------------------
Verbose mode can be enabled via `-v, --verbose` option
CONFIGURATION: https://docs.platformio.org/page/boards/espressif32/ESP32-Dev-4MB.html
PLATFORM: Espressif 32 (53.3.13) > Espressif ESP32 Dev Module
HARDWARE: ESP32 240MHz, 320KB RAM, 4MB Flash
DEBUG: Current (cmsis-dap) External (cmsis-dap, esp-bridge, esp-prog, iot-bus-jtag, jlink, minimodule, olimex-arm-usb-ocd, olimex-arm-usb-ocd-h, olimex-arm-usb-tiny-h, olimex-jtag-tiny, tumpa)
PACKAGES:
 - framework-arduinoespressif32 @ 3.1.3
 - framework-arduinoespressif32-libs @ 5.3.0+sha.489d7a2b3a
 - framework-espidf @ 3.50302.0 (5.3.2)
 - tool-cmake @ 3.30.2
 - tool-esptoolpy @ 4.8.6
 - tool-mklittlefs @ 3.2.0
 - tool-ninja @ 1.9.0
 - tool-riscv32-esp-elf-gdb @ 14.2.0+20240403
 - tool-xtensa-esp-elf-gdb @ 14.2.0+20240403
 - toolchain-esp32ulp @ 1.23800.240113 (2.38.0)
 - toolchain-xtensa-esp-elf @ 13.2.0+20240530
*** "custom_component" is used to select managed idf components ***
*** Removing component: espressif/esp_hosted
*** Removing component: espressif/esp_wifi_remote
*** Removing component: espressif/esp-dsp
*** Removing component: espressif/libsodium
*** Removing component: espressif/esp-modbus
*** Removing component: espressif/qrcode
*** Removing component: espressif/esp_insights
*** Removing component: espressif/esp_diag_data_store
*** Removing component: espressif/esp_diagnostics
*** Removing component: espressif/esp_rainmaker
*** Removing component: espressif/rmaker_common
Warning! Arduino framework as an ESP-IDF component doesn't handle the `variant` field! The default `esp32` variant will be used.
Reading CMake configuration...
-- Found Git: C:/Program Files/Git/cmd/git.exe (found version "2.49.0.windows.1")
-- git rev-parse returned 'fatal: not a git repository (or any of the parent directories): .git'
-- The C compiler identification is GNU 13.2.0
-- The CXX compiler identification is GNU 13.2.0
-- The ASM compiler identification is GNU
-- Found assembler: C:/Users/admin/.platformio/packages/toolchain-xtensa-esp-elf@13.2.0+20240530/bin/xtensa-esp32-elf-gcc.exe
-- Detecting C compiler ABI info
-- Detecting C compiler ABI info - done
-- Check for working C compiler: C:/Users/admin/.platformio/packages/toolchain-xtensa-esp-elf@13.2.0+20240530/bin/xtensa-esp32-elf-gcc.exe - skipped
-- Detecting C compile features
-- Detecting C compile features - done
-- Detecting CXX compiler ABI info
-- Detecting CXX compiler ABI info - done
-- Check for working CXX compiler: C:/Users/admin/.platformio/packages/toolchain-xtensa-esp-elf@13.2.0+20240530/bin/xtensa-esp32-elf-g++.exe - skipped
-- Detecting CXX compile features
-- Detecting CXX compile features - done
-- Building ESP-IDF components for target esp32
-- Configuring incomplete, errors occurred!

fatal: not a git repository (or any of the parent directories): .git
CMake Error at C:/Users/admin/.platformio/packages/framework-espidf/tools/cmake/build.cmake:572 (message):
  C:\Users\admin\.platformio\penv\.espidf-5.3.2\Scripts\python.exe: Error
  while finding module specification for
  'idf_component_manager.prepare_components' (ModuleNotFoundError: No module
  named 'idf_component_manager')

Call Stack (most recent call first):
  C:/Users/admin/.platformio/packages/framework-espidf/tools/cmake/project.cmake:717 (idf_build_process)
  CMakeLists.txt:3 (project)

========================= [FAILED] Took 12.04 seconds =========================

Environment    Status    Duration
-------------  --------  ------------
esp32          FAILED    00:00:12.045
==================== 1 failed, 0 succeeded in 00:00:12.045 ====================

valera39, 2025-03-18:
Dear Wolle, I did as you advised and everything was fine.
I've never had this problem before.
Thank you very much for your support, if it wasn't for you I wouldn't have succeeded.
Best wishes!

Closed 2025-03-18.

Thread 654 (2025-03-18):

Version 3.7-rc1.l   - Mar 17/2025

skassel2024, 2025-03-18:
Hi Wolle,
mit der aktuellen Version geht unter 13Mhz pixel_clock nix mehr: kein Senderwechsel, keine Reaktion auf Webinterface, kein DLNA.
Bei 13Mhz geht es wieder, aber das Flackern ist bei "Studio21" wieder da.

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

Beim Hochladen bleibt im Terminal connecting.... fast eine Minute, dann beginnt der Schreibprozess und ist nach wenigen Sekunden beendet. Radio funktioniert. DLNA ebenso. Allerdings komme ich ohne Reset nicht mehr in Radiomodus, wenn ich über das Webinterface DLNA aufgerufen habe.

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

vG Sören

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

schreibfaul1, 2025-03-18:
Ich habe mein Waveshare Display angeschlossen und alles sieht gut aus.
Den letzten "Commit" habe ich mit diesem Display angelegt, du kannst das 1:1 übernehmen. mich würde interessieren was bei dir passiert.

Alternative Idee:
Wenn du "Git Lens" als Erweiterung in VSCode installierst kann du zwischen den Versionen wechseln.

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
Das hellblaue ist der Branch, das blaue der Master.
Du kannst dann zurückgehen mit "Rebase current Branch onto Commit..." bis zu den Zeitpunkt wo es noch funktioniert hat. Das macht etwas Arbeit, weil du die common.h anpassen musst und du musst die "Änderungen verwerfen" wenn du zum nächsten Commit springen möchtest.

Das Terminal-Problem habe ich auch, mal sehen ob das beim nächsten Update von VSCode oder PlatformIO? wieder weg ist.

skassel2024, 2025-03-18:
Hi Wolle,
mit12Mhz geht nix
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

bei 13Mhz ok, ausser DLNA
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

in platformio hast Du 4MB Flash und 4MB PSRAM ausgewählt. Das Waveshare hat aber einen ESP32-S3 N8R8
eine Änderung
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

werde noch Erase Flash und Full Clean probieren un gebe Dir Rückmeldung.
vG Sören

skassel2024, 2025-03-18:
nach Erase Flash und Full Clean keine Änderung, bei 12Mhz geht nix, bei 13Mhz ok, aber DLNA geht nicht. Audioplayer ok.
GitLens habe ich zwar installiert, kenne mich damit aber überhaupt nicht aus

schreibfaul1, 2025-03-18:
Das habe ich mir gedacht, FullClean und EraseFlash wird nichts ändern, und ob die Partitionstabelle 4 oder 8MB groß ist spielt nur für OTA eine Rolle.
Mein Display funktioniert immer noch tadellos mit 12MHz, hab somit keine Möglichkeit der Reproduktion.
Eine Vermutung ist, dass die zusätzliche HW des Displays irgend einen Einfluss hat. Schließlich ist jeder GPIO des Displays verwendet worden (vielleicht ein Reset des LCD oder TP oder ein IRQ?) Ich meine dass die zusätzlichen ICs auf dem Board wirklich "tot" sind.
Mit Gitlens kannst du in den Versionen zurückspringen. Du kannst so genau das Commit ermitteln an dem der Fehler auftrat.

skassel2024, 2025-03-19:
Hi Wolle,
habe jetzt das ganze an einem "jungfräulichen" Display mit 12Mhz am laufen. Allerdings noch ohne DAC. Geht soweit ich das überblicke alles bis auf DLNA. Ich glaube Du hast recht mit der HW. IO15 habe ich zwar an U6 Pin 1 abgelötet, aber da stört vermutlich noch was anderes was zu I2C gehört. Werde das in den nächsten Tagen testen und Dir berichten.
Aber was hast Du an Deinem Display alles verändert?
vG Sören

skassel2024, 2025-03-20:
Hi Wolle,
so ähnlich habe ich das auch gemacht, allerdings habe ich nur RX485 TX (IO15) unterbrochen. Da scheint das Problem zu liegen. Ich werde das noch für die anderen Pins nachholen. Vor Allem direkt am ESP32 und nicht irgend wo auf der Platine. Mir ist nur noch nicht klar, warum es mit einem "jungfräulichen" Display ohne Änderungen aber ohne den Anschluss des DAC funktioniert.
Bei DLNA vermute ich ein Timeout Problem. Verbindung zum media server wird unterbrochen?
Wenn ich über die Weboberfläche DLNA aufrufe wird die Verbindung zum MiniWebRadio abgebrochen. Auch nach Neuladen der Seite kann ich nicht zum Radiomodus umschalten. Erst nach einem Reset.
Mit GitLens komme ich nicht klar. Ich kann zwar zwischen den Versionen umschalten, beim Hochladen kommen aber zu viele Fehlermeldungen über falsche Dateiversionen von Elementen. Mich da einzudenken ist mir noch zu kompliziert. Meine altbewährte Methode zip downloaden, entpacken und im Arbeitsbereich von VS Code einfügen hat bisher gut funktioniert.
Aber Danke für die Hinweise.
vG Sören

skassel2024, 2025-03-20:
Hi Wolle,
bin ein ganzes Stück weitergekommen. Bei Stromversorgung über UART1 Anschluss an PC funktioniert es bei 13Mhz, Bei Stromversorgung über USB an PC geht tonmässig nix. Bei Stromversorgung über Powebank (an UART1) kann ich bis 11,8Mhz runter. Dabei ist mir aufgefallen, dass das abhängig davon ist, ob ich das Gehäuse des ESP zusätzlich mit Masse verbinde. Meine Vermutung fehlende oder schlechte Verbindung zum Massepad unter dem ESP zur Platine. Mit der Masseverbindung bekomme ich auch Verbindung über DLNA.
Werde den Bereich Stromversorgung mir mal näher anschauen und weiter berichten.
vG Sören

Jason2866, 2025-03-20:
Es könnte auch sein dass die geringe Änderung der Versorgung Spannung einen nicht unerheblichen Einfluß darauf hat wie weit der Clock "runter gedreht" werden kann.
Wäre einen Versuch wert das mit einem gutem Labornetzteil mal zu prüfen.

Closed 2025-05-04.

Thread 664 (2025-03-31):

Clicks from DAC output in version 4

valera39, 2025-03-31:
Hi Wolle!
You and I have the same set of components, but I have from the output of PCM 5102 along with the useful signal periodically on any station there are clicks, emissions of DC voltage, which is clearly visible on the oscilloscope connected to the DAC output. If you press the "mute" icon on the display, the clicks stop, from which I conclude that the problem is in the DAC output.
What can it be and do you have such a problem?
Translated with DeepL.com (free version)

valera39, 2025-03-31:
I didn't manage to insert the video here, so I will leave a link to the file hosting
https://ru.files.fm/u/3r9v9zy7rw

valera39, 2025-04-05:
Dear Wolle, I am waiting for your answer or advice, my problem is not solved

schreibfaul1, 2025-04-06:
Hi valera,
I have absolutely no explanation for this. The sound is interrupted periodically. Perhaps a wire (BCLK, DOUT, LRCK) is touching a neighbouring pin or there is a problem with the power supply. I think the wiring looked good in your photo.  And we have the same display.

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

 The DAC on the display will continue to work. What about the "speak" connector?

valera39, 2025-04-07:
Hi Dear Wolle!
I apologize for not replying right away, had a lot of urgent things piling up, just checked out your tips today.
When powered by battery (power bank), both with external and internal DAC playback is perfect But when powered from an external source, there is a clicking noise. This is especially pronounced with my configuration: PCM5102 and the display is powered from 5 volts and the power amplifier from 12 volts. I think you are right, it's the power supply. What do you recommend?

schreibfaul1, 2025-04-07:
You have found the cause of the crackling, which is good news. I am sure that you can now solve the problem and I wish you every success.

Closed 2025-05-23.

Thread 670 (2025-04-14):

Wifi problem

Gyula1984, 2025-04-14:
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
Hi i installed the V4 version when it loaded it shows the available WiFis but i cannot connect to them, What am I doing wrong? Thank you

skassel2024, 2025-04-15:
Entering the password via the display doesn't work for me at the moment either. So I enter my SSID and password in common.h. Network.csv is no longer used.
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

Gyula1984, 2025-04-15:
thanks i have tired but pop up this menu when i started the radio, maybe the board is broken, this is my second board

schreibfaul1, 2025-04-15:
I have changed something else and hope that it works better now.

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

The number of green circles is the number of characters in the password. Is there a difference?
There may be remnants of old installations in the NVS. Please delete everything with `Erase Flash`. The terminal must be closed beforehand, otherwise it will not work.

Gyula1984, 2025-04-15:
i will check it later thanks the answer

skassel2024, 2025-04-15:
Hi Wolle, nach Erase Flash und Eingabe des PW über das Display sieht das bei mir so aus. OK?
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

schreibfaul1, 2025-04-15:
Nö, so soll es nicht aussehen. Das ist verwirrend. Die KI meint `char pass[64 * 4] = {0}; ` wäre nicht sicher.
In deinem Bildschirmfoto gibt es noch irgendwas anderes.  🟢 ist wahrscheinlich nicht NULL-terminiert wenn strcat() verwendet wird?
Habs noch mal verändert.
vG Wolle

Gyula1984, 2025-04-15:
Ok my board has gone but only the wifi connection and this is my second board which died, maybe china quality i dont know, thanks all, little bit strange it can found wifi networks but can not connect

schreibfaul1, 2025-04-15:
I don't think your board is faulty. It could be a problem with the antenna.

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

It doesn't have to look like the picture, but a solder bridge may still be necessary.
You can increase the transmission power in common.h.

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

Good luck!

Gyula1984, 2025-04-15:
thanks a lot it works!

steve6375, 2025-04-15:
What worked, changing the antenna link or increasing the power setting? If power, what setting did you use?

Gyula1984, 2025-04-16:
i have changed to 21 the power setting

skassel2024, 2025-04-16:
Hi Wolle,
nach Deinen Änderungen und erneutem Erase Flash sieht es immer noch so aus. Radio verbindet sich mit Router und funktioniert.
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

 das PW in Klartext wird richtig angezeigt  (Zeile 1285 in main.cpp eingefügt)
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

vG Sören

valera39, 2025-04-16:
Hi Wolle,!
How do I properly connect to the right network? The “OK” button is inactive and pressing it after entering the password does not result in anything. After entering the password, I pressed the “RET” button, the radio rebooted and only after the reboot did the connection happen. Then why the “OK” button?

valera39, 2025-04-16:
I haven't connected an external DAC and I2C bus yet

skassel2024, 2025-04-16:
Hi Wolle,
hier mein hexdump:
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

schreibfaul1, 2025-04-16:
Hi Sören,
sehr gut, bester Hexeditor den es kostenlos gibt! Damit kann man gut viele Dateiformate analysieren.

Also ist zwischen den grünen Kreisen befindet sich 0x20, das ist das Leerzeichen.

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

Jetzt ist die Frage, was das da zu suchen hat. Muss noch überlegen....
Aber erst mal vielen Dank!

skassel2024, 2025-04-17:
Hi Wolle,
ich denke das hängt mit der Unicode Version zusammen. Dein greenDot f09f9fa2 ist Version12.
Mit  dem Code 🔵 LARGE BLUE CIRCLE (Version6) funktioniert es. Aber ich habe keinen grünen Punkt in der Vers. 6 gefunden, daher der blaue Punkt.
vG Sören

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

schreibfaul1, 2025-04-18:
Grün macht Probleme und blau funktioniert?
Ich habe in Windows11 VSCode installiert um zu testen, ob es eine Abhängigkeit zum Betriebssystem gibt. Das konnte ich nicht feststellen.

Jetzt gibt es blaue Kreise für das Passwort. Das was ich machen möchte ist die Emojis (nur Kreise und Quadrate) in den Text zu integrieren um sie auf das Display zu zeichnen. An Stelle eines Buchstabens wird dann z.B. ein gelbes Quadat gezeichnet. Aber soweit bin ich noch nicht.

viele Grüße
Wolle

skassel2024, 2025-04-18:
Hi Wolle,
ich benutze noch Win10. Ich vermute doch, dass das damit zusammen hängt. Ich konnte auch nicht herausfinden, ob das mit den Terminaleinstellungen in platformio (V3.3.4)  etwas zu tun hat.
Jedenfalls nicht mit Deinem Code. Der grüne Punkt hat unicode Version 12 und der blaue unicode Version 6. Da auch das PW aus dem Flash richtig angezeigt wird, kann das doch nur mit der Terminaldarstellung von platformio zusammenhängen?
vG Sören

skassel2024, 2025-04-18:
Hi Wolle,
nur die beiden rot und blau (unicode V6) funktionieren. Bei allen anderen (unicode V12) sind wieder die Leerzeichen dazwischen.

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

schreibfaul1, 2025-04-18:
Das wird die Erklärung sein. Es ist nicht ganz so wichtig wie das Log aussieht. Und wenn es mit blauen Kreisen funktioniert ist es gut so.
Ich möchte dass die "Emojis" auf den Display gezeigt werden.
Ein erster Test:

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

skassel2024, 2025-04-18:
Ja, das ist gut so und nicht wichtig, nur ein "Schönheitsfehler". Aber mich würde interressieren, warum es bei meiner Konfiguration (Betriebssystem, Terminal in Platformio) nicht funktioniert, Wenn ich da was gefunden habe, gebe ich Rückmeldung.
vG Sören

skassel2024, 2025-04-21:
Hi Wolle
mit einem externen Terminalprogramm (PuTTY) ist die Darstellung ohne die Leerzeichen. Folglich liegt es am integrierten Terminal oder dessen Einstellungen von Platformio.
Leider habe ich noch keine Einstellmöglichkeit gefunden um Unicode12 korrekt darzustellen. Zu Auswahl stehen nur Unicode 6 oder 11. VS Code und Platformio sind auf dem aktuellen Stand. Ich versuche das noch auf einem Rechner mit win11.
vG Sören
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

schreibfaul1, 2025-04-21:
Kann sein, dass es am integriertem Terminal liegt. Die Leerfelder zwischen den Kreisen sehen eher zufällig aus, ich kann keine Regelmäßigkeit erkennen. Somit könnte es ein zeitliches Problem sein. Was passiert wenn die Geschwindigkeit erhöht oder reduziert wird?

skassel2024, 2025-04-21:
Ein reduzieren der Baudrate des Terminals hat nix gebracht. Aber warum funktioniert es bei Dir? Doch Win10 die Ursache?
Steh momentan total auf dem Schlauch:-((
Ausgabe auch bei 9600baud:

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

Closed 2025-06-05.

Thread 677 (2025-04-24):

Not doing anything after programming

jedi11csa, 2025-04-24:
Hi
I am using VS Code - Platform IO, all up to date.
I have an [ESP32-S3-DevKitC-1 16MB Flash + 8MB PSRAM.](https://lonelybinary.com/collections/esp32/products/s3?variant=43784065712285)
TFT Touch screen is [ILI9488.](https://www.ebay.com.au/itm/315674301885?var=614092694939)
And I2S Stereo DAC Decoder is the [PCM5102.](https://lonelybinary.com/collections/i2s/products/i2s-stereo-dac-decoder-pcm5102-module)

Cloned the project, following the instructions:
- Change the environment to "env:esp32s3 (ESP322-MiniWebRadio)"
- In "platformio.ini" under `[esp32s3]` I have `board_build.partitions = boards/miniwebradio16MB.csv   ;16MB Flash` uncommented. And, `board = ESP32-S3-DevKitC-1-N16R8   ;16 MB quad Flash, 8MB octal PSRAM` uncommented.
- In 'common.h' changed values of "_SSID" and "_PW" to match my WiFi credentials.
- Also in 'common.h' changed values of the fields; TFT Controller, TFT_Rotation, TP_ROTATION, and TP_Version, to match my set-up. `#define TFT_CONTROLLER   4  //(4)ILI9488`, `#define TFT_ROTATION   3 // only SPI displays, 1 or 3 (landscape)`, `#define TP_ROTATION   3 //  only SPI displays, 1 or 3 (landscape)` `#define TP_VERSION  4 // only SPI displays (4)ILI9488`.
- I have extracted the "Content_on_SD_Card.zip" to an SD Card, and put it into the reader on the back of the TFT Screen board.
- Also have removed the series resistors replacing them with solder bridges.
- Lastly, have followed the wiring schematics, wiring the DAC, Screen+SD-Card, and ESP32-S3 together.

I build the project. Upload/program it to the ESP32-S3 on it's 'UART' USB-C port. And nothing... I see power LEDs on the ESP32-S3, and the PCM5102. And I measure +3V3 on the SD Card too. But the ESP32-S3 doesn't show up on my Routers WiFi list, and there's no life on the TFT screen.

In "platformio.ini" under `[esp32s3]`, I've tried changing the options `board = ESP32-S3-DevKitC-1-N16R8   ;16 MB quad Flash, 8MB octal PSRAM` to `board = ESP32-S3-DevKitC-1-N16R8V  ;16 MB octal Flash, 8MB octal PSRAM`, just to see if that would work, but it didn't work either.

Can you help me please?
I'd love to get this project working, as it's very intriguing and cool :)

JakesESP32, 2025-04-24:
Open a serial monitor and check if the SD card is being read the moment you do a reset, that's most probably your problem.

jedi11csa, 2025-04-24:
Hi JakesESP32, thanks for helping.

Here's a copy/paste of the results:

```ESP-ROM:esp32s3-20210327
Build:Mar 27 2021
rst:0x1 (POWERON),boot:0x2b (SPI_FAST_FLASH_BOOT)
SPIWP:0xee
mode:DIO, clock div:1
load:0x3fce2810,len:0x104c
load:0x403c8700,len:0x4
load:0x403c8704,len:0xaec
load:0x403cb700,len:0x2cfc
entry 0x403c889c

ESP32 Chip: ESP32-S3
Arduino Version: 3.2.0
ESP-IDF Version: 5.4.1
MiniWebRadio Version 4.0-rc2   - Apr 18/2025
ARDUINO_LOOP_STACK_SIZE 8192 words (32 bit)
FLASH size 16777216 bytes, speed 80 MHz
CPU speed 240 MHz
SDMMC speed 80 MHz
TFT speed 40 MHz
PSRAM total size: 5555620 bytes
RESET_REASON: Reset due to power-on event

00:00:00
00:00:00        ***************************
00:00:00        *     MiniWebRadio V4     *
00:00:00        ***************************
00:00:00
00:00:00 setup: ....  Arduino is pinned to core 1
00:00:00 tft_info: .  init ILI9488
00:00:00 setup: ....  Init SD card
E (231) sdmmc_common: sdmmc_init_ocr: send_op_cond (1) returned 0x107
E (232) vfs_fat_sdmmc: sdmmc_card_init failed (0x107).
[   238][E][SD_MMC.cpp:295] begin(): Failed to initialize the card (0x107). Make sure SD card lines have pull-up resistors in place.
00:00:00 SD Card Mount Failed
```

So, looks like I need to solder in some pull-up resistors. The back of my ILI9488 TFT-Screen+SD-Card-Reader looks like the picture on the [main page](https://github.com/schreibfaul1/ESP32-MiniWebRadio) "Known Problems" section, the picture of the red coloured pcb with the resistors to remove.

My questions would be:
- Will 10K resistors do for pull-ups?
- Do I put one on the SD_MOSI trace, one on the SD_MISO trace, and one on the SD_SCK trace? Or just one on the SD_MOSI trace, and one on the SD_MISO trace?
- Appart from this issue, was there anything else you think I might need to try? Or was it just the missing pull-ups the Serial Monitor message states?

Again, thanks for chiming in!! :D

JakesESP32, 2025-04-24:
As expected ....

Frankly, I did not bother to get the display onboard SD reader working. All I did is I used an external SD card reader, I did not have to change any resistors on that.

Not very efficient, but it least it got to work. Nothing else was needed, the project works exactly as published apart from this speed bump.

Kind regards

jedi11csa, 2025-04-24:
I see.

Have just tried with the SD Card reader on the back of the TFT Screen. Three 10K resistors. One to each line, as stated in my questions.

No dice, unfortunately. Same error code.

Might have to try with an external SD Card reader like you did.

Thanks again for the help! Much appreciated :D

jedi11csa, 2025-04-27:
I bought an [SD-Card Reader](https://www.jaycar.com.au/arduino-compatible-sd-card-interface-module/p/XC4386) and hooked it up.

After much frustration, with the same origianl error:
```E (231) sdmmc_common: sdmmc_init_ocr: send_op_cond (1) returned 0x107
E (232) vfs_fat_sdmmc: sdmmc_card_init failed (0x107).
[   238][E][SD_MMC.cpp:295] begin(): Failed to initialize the card (0x107). Make sure SD card lines have pull-up resistors in place.
00:00:00 SD Card Mount Failed
```
I tried desoldering the 10K pull-up resistor on this external board, connected to the MISO (D0) trace. But that would sometimes produce some kind of hit-n-miss result, or not. Resoldering it, I got a similar weird "hit and miss" results.

The 'hit and miss' result would see the project load in the serial monitor. It found my WiFi, and I could sort of load the webserver. But images and a lot of functionality wouldn't work. So, more a miss than hit. But this was a start.

Tried various SD cards.
-  SanDisk Extreme 32GB
- SanDisk Ultra 32GB
- Lexar 300x 64GB

All produced the above 'hit or miss' result, or the original error, "Make sure SD card lines have pull-up resistors in place.", which was unfortunate. Especially as I'd now resoldered the 10K pull-up on this external SD-Card reader board.

When the 'hit or miss' happened, within the serial monitor readouts, most times, the `settings.json` file couldn't be found or loaded. As well as a lot of image files too.

So I tried changing the `#define SDMMC_FREQUENCY  80000000` value. First from 80MHz to 40MHz; Without success. In fact this just provoked the original error to happen, and no 'hit or miss' results at all.

But, what has seemed to work, somewhat, is changing the value to 20MHz:
`#define SDMMC_FREQUENCY         20000000                        // 80000000 or 40000000 Hz`

I could see the webserver page in Firefox. Change the country location. See my pre-loaded radio stations, and the music in the `audiofiles` folder on the SD card too.

I could actually hear the radio stations stream music!! And play a track from the SD card as well!! Woo-hoo!

**Further Issues:**

1. The webserver doesn't always display the radio station icons I've pre-loaded into the "l", "m" and "s" folders. They appear when using the arrows to change the selection, but when the music starts, they disappear, replaced by 'the smurf' icon.
2. Clicks heard on the audio. There's an issue topic before my issue topic addressing this. And my replication of that issue is probably because this whole thing is held together by "string, chewing-gum and sticky-tape" on a breadboard at the moment. Which brings me nicely to the next point...
3. Waiting on a fab house to manufacture and deliver a PCB I designed for this, so I can rid myself of the blasted breadboard. Hoping a pcb will do the trick for issue 2.
4. The TFT-Display doesn't work. It flickers a white screen. That's it. Hopefully getting my pcb from the fab house and proper electrical connections will address this issue.

Been fun, thus far. Thanks to all involved for the frustration and the excitement, haha!! :D

JakesESP32, 2025-04-27:
Glad to see you made such good progress. 👍

Regarding the TFT white screen, try tying the display RST pin to 3V3, I was able get it to work on the breadboard by doing that.

At the frequencies present here, a breadboard and prototyping wires does produce sometimes strange results.

Keep on having fun !!! 👍

jedi11csa, 2025-05-02:
SUCCESS!!!! 🎆🎉

Got my PCB's and soldered in some female header strips. Placed the ESP32-S3. The PCM5102. The external SD Card reader (with all original resistors in place). And of course, the Touch screen ILI9488 TFT display.

Programmed the ESP32-S3, and used the SanDisk Extreme 32GB SD-card, with the SSMMC_Frequency value set at 20MHz.

Thing loaded up, and from my previous attempts via the webserver, it knew I was in sunny Australia, showed the flag, the right time (I changed the ntp servers with the platformio.ini file), **then started playing music from Double J!!!!**

Used the touchscreen to change channels. All radio stations I preloaded played through the speakers clearly, crisp, awesome!

Tried out the SanDisk Ultra 32GB SD-card. That had issues. So tried changing the SDMMC_Frequency to 40MHz. That fixed it.

**_Issues:_**

- I changed the Wallpaper.jpg image. Neither SD-card/SSDMMC_Frequency-setting would display it on the TFT Display. Don't know why. Found the code in the main.cpp, and it calls for `drawImage("/common/Wallpaper.jpg", 0, 0); // Wallpaper` So tried moving the file into the common folder, as it's in the common/l, common/m, and common/s folders (all images sized appropriately for their respective folder). Even though the "MiniWebRadioV4.jpg" is similarly found in all "common/l", "common/m", and "common/s" folders. Dunno? My wallpaper don't wallpaper on this?? Love to fix it though ;)
- My radio station logos I copied into the "l"/"m"/"s" folders within the "logo" folder (again, all appropriately sized images) wouldn't show on the display. Bummer... again, would like to fix that up so they show on the display.
- One good point to counter the last, on the webserver, the logos show up, and stay put. So, "win!" :D
- The only red coloured serial-monitor warnings that show up are "AUDIO_info: file "/common/m/unknown.png" not found. But that's because the file is a jpg. Dunno, it did show up on the webserver page one time, briefly, before being replaced by the radio station logo.
- Tunes and tune-playlists I have in the "audiofiles" folder, don't seem to play at all.

Still, wanted to primarily hear radio on this. And I can; So, a win for the good guys!! Love it!! ❤🙏👍😁

JakesESP32, 2025-05-02:
👍😁

Closed 2025-05-26.

Thread 679 (2025-04-26):

task_wdt: Task watchdog got triggered - Endlos-Schleife

TubaFonse, 2025-04-26:
Hallo Wolle,

nach ca. 30 Minuten Spielzeit erhalte ich folgenden Fehler (Endlosschleife - nur durch Hardware-Reset / Power-Off/-On zu beenden).
Ich versuche mal, ob der Fehler auch mit einem anderen Sender auftritt:

00:00:00 Country: ... AT
00:00:00 icy-descr:   Arabella Austropop
00:00:00 StationName: Arabella Austropop
00:00:00 icy-url: ..  https://www.arabella.at
00:00:00 AUDIO_info:  AACDecoder has been initialized, free Heap: 154835 bytes , free stack 5880 DWORDs
00:00:00 lastURL: ..  https://edge05.streams.arabella.at/arabella-austropop
17:04:12 Country: ... AT
17:04:12 Audiocodec:  AAC
17:04:12 ftpServer:   Ftp server waiting for connection on port 21
17:04:13 BT-Emitter:  KCX_BT_Emitter found
17:04:13 AUDIO_info:  stream ready
17:04:13 AUDIO_info:  syncword found at pos 0
17:04:13 AUDIO_info:  Channels: 2
17:04:13 AUDIO_info:  SampleRate: 44100
17:04:13 AUDIO_info:  BitsPerSample: 16
17:04:13 AUDIO_info:  BitRate: 85788
17:04:13 AUDIO_info:  AAC HeaderFormat: ADTS
17:04:13 AUDIO_info:  Spectral band replication: upsampled SBR
17:04:14 BT-Emitter:  Status -> Scan...
17:04:14 BT-Emitter:  Status -> Disconnected
17:04:14 BT-Emitter:  POWER ON
17:04:14 BT-Emitter:  POWER ON
17:04:15 BT-Emitter:  Version KCX_BT_RTX_V1.4
17:04:15 AUDIO_info:  slow stream, dropouts are possible
17:04:15 StreamTitle: GEORG DANZER & WILFRIED - SCHAU SCHATZI
17:04:15 BT-Emitter:  Volume -> 0
17:04:16 BT-Emitter:  wrong command: AT+VOL=0
17:04:17 BT-Emitter:  scanned: MacAdd:449f4910164a,Name:WZ-BT5.0
17:04:17 BT-Emitter:  CON LAST
17:04:20 BT-Emitter:  Status -> Connected
17:04:21 DLNA_server: [0] 192.168.178.1:49000  FRITZ7490
17:04:21 DLNA_server: [1] 192.168.178.24:50001  DS213J_AL
17:04:21 DLNA_server: [2] 192.168.178.29:2869  WIN10ALF: AH:
17:04:21 DLNA_server: 3 media server found
17:05:21 StreamTitle: CARL PEYER & GISI HAFNER - HERZKLOPFEN
17:08:22 StreamTitle: PIZZERA & JAUS - DIALEKT'S MI
17:11:11 StreamTitle: WIENER WAHNSINN - NOCH SOVü JOA
17:16:41 StreamTitle: WIR4 - TRäNEN TROCKNEN SCHNELL LIVE
17:21:30 StreamTitle: JOSH. - RING IN DER HAND
17:23:57 StreamTitle: ERNST MOLDEN & WILLI RESETARITS - RUDSCHDUAM
17:27:09 StreamTitle: WIR4 FEAT. WOLFGANG AMBROS - LAÃx MI AMOI NO D'SUNN AUFGEH'N SEGN LIVE
E (1408154) task_wdt: Task watchdog got triggered. The following tasks/users did not reset the watchdog in time:
E (1408154) task_wdt:  - IDLE1 (CPU 1)
E (1408154) task_wdt: Tasks currently running:
E (1408154) task_wdt: CPU 0: IDLE0
E (1408154) task_wdt: CPU 1: loopTask
E (1408154) task_wdt: Print CPU 1 backtrace

Backtrace: 0x403775F2:0x3FCA21F0 0x4037BEF9:0x3FCA2210 0x4207AD9A:0x3FCD2840 0x42084BC2:0x3FCD2890 0x42006F55:0x3FCD2A40 0x420070C5:0x3FCD2A90 0x4202D105:0x3FCD2AB0 0x420999BC:0x3FCD2B70
  #0  0x403775F2 in esp_crosscore_isr at C:\Users\Hoeckmayr\.platformio\packages\framework-espidf\components\esp_system/crosscore_int.c:73
  #1  0x3FCA21F0 in _xt_exception_table at ??:?
  #2  0x4037BEF9 in _xt_lowint1 at C:\Users\Hoeckmayr\.platformio\packages\framework-espidf\components\xtensa/xtensa_vectors.S:1240
  #3  0x3FCA2210 in _xt_exception_table at C:\Users\Hoeckmayr\.platformio\packages\framework-espidf\components\freertos\FreeRTOS-Kernel\portable\xtensa/port.c:67
  #4  0x4207AD9A in TFT_SPI::analyzeText(char const*, unsigned short*, unsigned short*, unsigned short) at lib/tftLib/tft_spi.cpp:1476
  #5  0x42084BC2 in TFT_SPI::writeText(char const*, unsigned short, unsigned short, short, short, unsigned char, unsigned char, bool, bool, bool) at lib/tftLib/tft_spi.cpp:1795
  #6  0x42006F55 in textbox::writeText(char const*) at src/common.h:1851
  #7  0x420070C5 in showStreamTitle(char const*) at src/main.cpp:844
  #8  0x4202D105 in showStreamTitle(char const*) at src/main.cpp:835
      (inlined by) loop() at src/main.cpp:3072
  #9  0x420999BC in loopTask(void*) at C:/Users/Hoeckmayr/.platformio/packages/framework-arduinoespressif32/cores/esp32/main.cpp:74

E (1413154) task_wdt: Task watchdog got triggered. The following tasks/users did not reset the watchdog in time:
E (1413154) task_wdt:  - IDLE1 (CPU 1)
E (1413154) task_wdt: Tasks currently running:
E (1413154) task_wdt: CPU 0: PeriodicTask
E (1413154) task_wdt: CPU 1: loopTask
E (1413154) task_wdt: Print CPU 1 backtrace

Backtrace: 0x403775F2:0x3FCA21F0 0x4037BEF9:0x3FCA2210 0x4207ADA3:0x3FCD2840 0x42084BC2:0x3FCD2890 0x42006F55:0x3FCD2A40 0x420070C5:0x3FCD2A90 0x4202D105:0x3FCD2AB0 0x420999BC:0x3FCD2B70
  #0  0x403775F2 in esp_crosscore_isr at C:\Users\Hoeckmayr\.platformio\packages\framework-espidf\components\esp_system/crosscore_int.c:73
  #1  0x3FCA21F0 in _xt_exception_table at ??:?
  #2  0x4037BEF9 in _xt_lowint1 at C:\Users\Hoeckmayr\.platformio\packages\framework-espidf\components\xtensa/xtensa_vectors.S:1240
  #3  0x3FCA2210 in _xt_exception_table at C:\Users\Hoeckmayr\.platformio\packages\framework-espidf\components\freertos\FreeRTOS-Kernel\portable\xtensa/port.c:67
  #4  0x4207ADA3 in TFT_SPI::analyzeText(char const*, unsigned short*, unsigned short*, unsigned short) at lib/tftLib/tft_spi.cpp:1476
  #5  0x42084BC2 in TFT_SPI::writeText(char const*, unsigned short, unsigned short, short, short, unsigned char, unsigned char, bool, bool, bool) at lib/tftLib/tft_spi.cpp:1795
  #6  0x42006F55 in textbox::writeText(char const*) at src/common.h:1851
  #7  0x420070C5 in showStreamTitle(char const*) at src/main.cpp:844
  #8  0x4202D105 in showStreamTitle(char const*) at src/main.cpp:835
      (inlined by) loop() at src/main.cpp:3072
  #9  0x420999BC in loopTask(void*) at C:/Users/Hoeckmayr/.platformio/packages/framework-arduinoespressif32/cores/esp32/main.cpp:74

Es hilft nur ein Hardware-Reset oder Power-Off / On, die Schleife zu beenden.
Ich versuche mal, ob der Fehler auch mit einem anderen Sender auftritt.

Viele Grüße,
Alfons

schreibfaul1, 2025-04-26:
Hi Alfons,
hab Arabella-Austropop laufen lassen und hatte nach kurzer Zeit denselben Fehler. Manchmal werden im "Streamtitle" Zeichen übertragen, die es (in der UTF-8 Tabelle) nicht gibt. Das führte in zu einer Endlosschleife und löste den Watchdog aus. Ich hoffe, das passiert jetzt nicht mehr.

beste Grüße
Wolle

TubaFonse, 2025-04-26:
Danke Wolle für die schnelle Hilfe!!!
LG Alfons.

Closed 2025-04-26.

Thread 697 (2025-06-09):

Kompilation Probleme

Robert-c-v, 2025-06-09:
Resolving esp32s3 dependencies...
Library Manager: Installing git+https://github.com/schreibfaul1/ESP32-audioI2S.git
git version 2.49.0.windows.1
Cloning into 'C:\Users\xxx\.platformio\.cache\tmp\pkg-installing-y8jbg8zr'...

Library Manager: ESP32-audioI2S@3.3.0+sha.49ccce0 has been installed!
Library Manager: Installing git+https://github.com/schreibfaul1/ESP32-KCX-BT-EMITTER.git
git version 2.49.0.windows.1
Cloning into 'C:\Users\xxx\.platformio\.cache\tmp\pkg-installing-83d6ykx9'...

Library Manager: ESP32-KCX-BT-EMITTER@0.0.0+20240128094011.sha.4c07f9b has been installed!
Library Manager: Installing git+https://github.com/schreibfaul1/ESP32-DLNA-Client.git#1e296d9
git version 2.49.0.windows.1
Cloning into 'C:\Users\xxx\.platformio\.cache\tmp\pkg-installing-90suzdgb'...

HEAD is now at 1e296d9 make udp more robust
Library Manager: ESP32-DLNA-Client@0.0.0+20231205185914.sha.1e296d9 has been installed!
Library Manager: Installing git+https://github.com/schreibfaul1/ESP32-IR-Remote-Control.git#c371281
git version 2.49.0.windows.1
Cloning into 'C:\Users\xxx\.platformio\.cache\tmp\pkg-installing-9je4dzvi'...

HEAD is now at c371281 new long pressed key impl.
Library Manager: ESP32-IR-Remote-Control@1.0.10+sha.c371281 has been installed!
Updating metadata for the vscode IDE...
UserSideException: Processing esp32s3 (board: ESP32-S3-DevKitC-1-N4R8; platform: https://github.com/pioarduino/platform-espressif32/releases/download/54.03.20/platform-espressif32.zip; framework: arduino, espidf)
--------------------------------------------------------------------------------
Verbose mode can be enabled via `-v, --verbose` option
CONFIGURATION: https://docs.platformio.org/page/boards/espressif32/ESP32-S3-DevKitC-1-N4R8.html
PLATFORM: Espressif 32 (54.3.20) > Espressif ESP32-S3-DevKitC-1-N8R2 (8 MB QD FLASH, 2MB QD PSRAM)
HARDWARE: ESP32S3 240MHz, 320KB RAM, 4MB Flash
DEBUG: Current (esp-builtin) On-board (esp-builtin) External (cmsis-dap, esp-bridge, esp-prog, iot-bus-jtag, jlink, minimodule, olimex-arm-usb-ocd, olimex-arm-usb-ocd-h, olimex-arm-usb-tiny-h, olimex-jtag-tiny, tumpa)
PACKAGES:
 - framework-arduinoespressif32 @ 3.2.0
 - framework-arduinoespressif32-libs @ 5.4.0+sha.2f7dcd862a
 - framework-espidf @ 3.50401.0 (5.4.1)
 - tool-cmake @ 3.30.2
 - tool-esptoolpy @ 4.8.9
 - tool-mklittlefs @ 3.2.0
 - tool-ninja @ 1.9.0
 - tool-riscv32-esp-elf-gdb @ 14.2.0+20240403
 - tool-xtensa-esp-elf-gdb @ 14.2.0+20240403
 - toolchain-esp32ulp @ 1.23800.240113 (2.38.0)
 - toolchain-riscv32-esp @ 14.2.0+20241119
 - toolchain-xtensa-esp-elf @ 14.2.0+20241119
*** "custom_component" is used to select managed idf components ***
Warning! Arduino framework as an ESP-IDF component doesn't handle the `variant` field! The default `esp32` variant will be used.
Reading CMake configuration...
-- Found Git: C:/Program Files/Git/cmd/git.exe (found version "2.49.0.windows.1")
-- git rev-parse returned 'fatal: not a git repository (or any of the parent directories): .git'
-- The C compiler identification is GNU 14.2.0
-- The CXX compiler identification is GNU 14.2.0
-- The ASM compiler identification is GNU
-- Found assembler: C:/Users/xxx/.platformio/packages/toolchain-xtensa-esp-elf/bin/xtensa-esp32s3-elf-gcc.exe
-- Detecting C compiler ABI info
-- Detecting C compiler ABI info - done
-- Check for working C compiler: C:/Users/xxx/.platformio/packages/toolchain-xtensa-esp-elf/bin/xtensa-esp32s3-elf-gcc.exe - skipped
-- Detecting C compile features
-- Detecting C compile features - done
-- Detecting CXX compiler ABI info
-- Detecting CXX compiler ABI info - done
-- Check for working CXX compiler: C:/Users/xxx/.platformio/packages/toolchain-xtensa-esp-elf/bin/xtensa-esp32s3-elf-g++.exe - skipped
-- Detecting CXX compile features
-- Detecting CXX compile features - done
-- git rev-parse returned 'fatal: not a git repository (or any of the parent directories): .git'
-- Could not use 'git describe' to determine PROJECT_VER.
-- Building ESP-IDF components for target esp32s3
Dependencies lock doesn't exist, solving dependencies.

.......................NOTICE: Updating lock file at C:\Users\xxx\Documents\ESP32-MiniWebRadio-ESP32-P4\dependencies.lock

Processing 11 dependencies:

[1/11] chmorgan/esp-libhelix-mp3 (1.0.3)

[2/11] espressif/cbor (0.6.0~1)

[3/11] espressif/esp-dsp (1.4.12)

[4/11] espressif/esp-sr (1.9.5)

[5/11] espressif/esp-zboss-lib (1.6.3)

[6/11] espressif/esp-zigbee-lib (1.6.3)

[7/11] espressif/esp_modem (1.4.0)

[8/11] espressif/mdns (1.8.2)

[9/11] espressif/network_provisioning (1.0.2)

[10/11] joltwallet/littlefs (1.20.0)

[11/11] idf (5.4.1)

-- Project sdkconfig file C:/Users/xxx/Documents/ESP32-MiniWebRadio-ESP32-P4/sdkconfig.esp32s3
-- Configuring incomplete, errors occurred!

fatal: not a git repository (or any of the parent directories): .git
Traceback (most recent call last):

  File "<frozen runpy>", line 198, in _run_module_as_main

  File "<frozen runpy>", line 88, in _run_code

  File "C:\Users\xxx\.platformio\penv\.espidf-5.4.1\Lib\site-packages\kconfgen\__main__.py", line 5, in <module>

    from .core import main

  File "C:\Users\xxx\.platformio\penv\.espidf-5.4.1\Lib\site-packages\kconfgen\core.py", line 29, in <module>

    import esp_idf_kconfig.gen_kconfig_doc as gen_kconfig_doc

  File "C:\Users\xxx\.platformio\penv\.espidf-5.4.1\Lib\site-packages\esp_idf_kconfig\gen_kconfig_doc.py", line 14, in <module>

    import kconfiglib.core as kconfiglib

  File "C:\Users\xxx\.platformio\penv\.espidf-5.4.1\Lib\site-packages\kconfiglib\__init__.py", line 3, in <module>

    from .core import Kconfig  # noqa F401

    ^^^^^^^^^^^^^^^^^^^^^^^^^

  File "C:\Users\xxx\.platformio\penv\.espidf-5.4.1\Lib\site-packages\kconfiglib\core.py", line 27, in <module>

    from kconfiglib.report import PRAGMA_PREFIX

  File "C:\Users\xxx\.platformio\penv\.espidf-5.4.1\Lib\site-packages\kconfiglib\report.py", line 29, in <module>

    from rich import print as rprint

ModuleNotFoundError: No module named 'rich'

CMake Error at C:/Users/Alina/.platformio/packages/framework-espidf/tools/cmake/kconfig.cmake:209 (message):
  Failed to run kconfgen
  (C:/Users/xxx/.platformio/penv/.espidf-5.4.1/Scripts/python.exe;-m;kconfgen;--list-separator=semicolon;--kconfig;C:/Users/xxx/.platformio/packages/framework-espidf/Kconfig;--sdkconfig-rename;C:/Users/Alina/.platformio/packages/framework-espidf/sdkconfig.rename;--config;C:/Users/Alina/Documents/ESP32-MiniWebRadio-ESP32-P4/sdkconfig.esp32s3;--env-file;C:/Users/xxx/Documents/ESP32-MiniWebRadio-ESP32-P4/.pio/build/esp32s3/config.env).
  Error 1
Call Stack (most recent call first):
  C:/Users/xxx/.platformio/packages/framework-espidf/tools/cmake/build.cmake:681 (__kconfig_generate_config)
  C:/Users/xxx/.platformio/packages/framework-espidf/tools/cmake/project.cmake:717 (idf_build_process)
  CMakeLists.txt:3 (project)

========================= [FAILED] Took 35.79 seconds =========================

Environment    Status    Duration
-------------  --------  ------------
esp32s3        FAILED    00:00:35.787

schreibfaul1, 2025-06-10:
Kann sein, dass es existiert, aber in einer falschen virtuellen Umgebung

HWH53, 2025-06-13:
Hallo  Robert,
please check your **Python Default Compiler Path**. In my new installation it was missing and the .venv was not found automatically by vscode. Rich was not found but it was installed in .venv.

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

After adding this Path the compiler errors are gone and rich was found.

Use this Platform 53.03.13, the others throw errors at me.

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

mfg
Helmut

schreibfaul1, 2025-06-13:
Probably "rich" is installed here:
`~/.platformio/penv/lib/python3.12/site-packages
`
and is missing here:
`~/.platformio/penv/.espidf-5.4.1/lib/python3.12/site-packages`

try this
`~/.platformio/penv/.espidf-5.4.1/bin/pip install rich`
or this
`~/.platformio/penv/.espidf-5.4.1/bin/python -m pip install rich`

this is for Linux, in other operating systems the .platformio folder may be somewhere else.

Robert-c-v, 2025-06-14:
Ich habe alles probiert , mögliche weise ich bin zu dumm.. bei   mir funktioniert nicht ...

ve2cfb, 2025-06-14:
Same here.
No luck with the last Wolle suggestio.
I even tried a fresh install windows 11 on my LapTop and i get the same problem.
Couple days ago, i tried to install ESP-IDF on my desktop pc, and i had similer problems.
Is there some old versions that we can try beside Mini WebRadio.?

schreibfaul1, 2025-06-15:
I think the previous pioarduino version does without "rich".

    Arduino 3.1.3 IDF 5.3.2
    platform = https://github.com/pioarduino/platform-espressif32/releases/download/53.03.13-1/platform-espressif32.zip

I had the same problem, but was able to install Python-rich.

noanylag, 2025-06-15:
> Same here. No luck with the last Wolle suggestio. I even tried a fresh install windows 11 on my LapTop and i get the same problem. Couple days ago, i tried to install ESP-IDF on my desktop pc, and i had similer problems. Is there some old versions that we can try beside Mini WebRadio.?

Hello. I have the same problem and I don't know how to solve it. It's a big disappointment. Maybe you can and share the solution.

schreibfaul1, 2025-06-16:
This will probably be the error message:
`
  File "/home/wolle/.platformio/penv/.espidf-5.4.1/lib/python3.12/site-packages/kconfiglib/report.py", line 29, in <module>
    from rich import print as rprint
ModuleNotFoundError: No module named 'rich'
CMake Error at /home/wolle/.platformio/packages/framework-espidf/tools/cmake/kconfig.cmake:209 (message)
`
This means that Python-rich is not found. The path may be different depending on your operating system.

It looks like this for me:

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

In my case, rich was installed here: ` ~/.platformio/penv/lib/python3.12/site-packages`
and was missing here: `~/.platformio/penv/.espidf-5.4.1/lib/python3.12/site-packages`

then install rich in your path:

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

I already have it

If you want to switch to this environment interactively:

`source ~/.platformio/penv/.espidf-5.4.1/bin/activate pip install rich`

Then go out again with `deactivate`.

Why this happens?
PlatformIO uses separate environments for certain frameworks (e.g. ESP-IDF) so that their Python dependencies remain separate. You may therefore have to install packages several times, depending on the context in which the script is running.

noanylag, 2025-06-17:
Wow! It worked! Thanks for the tip. Now everything compiles and I can continue and finish this wonderful project. Thank you!

ve2cfb, 2025-06-19:
Does not work on Windows.

noanylag, 2025-06-21:
> Не работает в Windows.

No, it works for me Win11.

ve2cfb, 2025-06-27:
Hello Wolle
deleted **.platformio**  according to your previous post but same problems.
So far, i re-installed everything, still cannot compile.
I got rid of "rich error" but having xtenza , git and cmake error.
By the way, last week i tried to install esp-idf with Platformio and ad similar problems.

Should i wait for a fix ?

[Log 2025-06-27.txt](https://github.com/user-attachments/files/20951107/Log.2025-06-27.txt)

Thanks for your time.

schreibfaul1, 2025-06-27:
1) Open the bash terminal in VSCode.
2.  ```cd ~``` <Enter>
3.
````
source ~/.platformio/penv/.espidf-5.4.1/bin/activate
pip install rich
````
<Enter>

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

ve2cfb, 2025-06-28:
Hello Wolle,

From in your previous post,  The RED 3 you have a bin directory but i dont have that.
You are probably on Linux and i am on Windows.

The only place where i have "activate" is in he following directory.
Directory : C:\Users\Pierre\.platformio\penv\Scripts

=========================================================
Mode                 LastWriteTime         Length Name
----                 -------------         ------ ----
d-----        2025-06-28     05:47                __pycache__
-a----        2025-06-28     05:46           1768 activate
-a----        2025-06-28     05:46           1001 activate.bat
-a----        2025-06-28     05:46          26199 Activate.ps1
-a----        2025-06-28     05:46         108409 async-json-rpc-server.exe
-a----        2025-06-28     05:47           3856 bin2hex.py
-a----        2025-06-28     05:46         108392 bottle.exe
-a----        2025-06-28     05:46         180099 bottle.py
-a----        2025-06-28     05:46            393 deactivate.bat
-a----        2025-06-28     05:47           4715 hex2bin.py
-a----        2025-06-28     05:47           4580 hex2dump.py
-a----        2025-06-28     05:47           2888 hexdiff.py
-a----        2025-06-28     05:47           3700 hexinfo.py
-a----        2025-06-28     05:47           6245 hexmerge.py
-a----        2025-06-28     05:58         108407 markdown-it.exe
-a----        2025-06-28     05:46         108413 normalizer.exe
-a----        2025-06-28     05:46         108405 pio.exe
-a----        2025-06-28     05:46         108425 piodebuggdb.exe
-a----        2025-06-28     05:46         108410 pip.exe
-a----        2025-06-28     05:46         108410 pip3.11.exe
-a----        2025-06-28     05:46         108410 pip3.exe
-a----        2025-06-28     05:46         108405 platformio.exe
-a----        2025-06-28     05:58         108402 pygmentize.exe
-a----        2025-06-28     05:46         108407 pyserial-miniterm.exe
-a----        2025-06-28     05:46         108409 pyserial-ports.exe
-a----        2025-06-28     05:45         270616 python.exe
-a----        2025-06-28     05:45         259352 pythonw.exe
-a----        2025-06-28     05:46          92486 readelf.py
-a----        2025-06-28     05:58         108400 rich-click.exe
-a----        2025-06-28     05:46         108396 tabulate.exe
-a----        2025-06-28     05:46         108398 uvicorn.exe
-a----        2025-06-28     05:47         108395 wheel.exe
============================================================

My next step is going to Windows 11 and see what happen.

HWH53, 2025-06-28:
Hi VE2CFB,
i.ve looked at my working Win10 Installation and found the following in user/myhome/.platformio/penv/Scripts/.espidf-5.3.2/activate.bat

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

and then

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

i hope this helps a little bit.

mfg
Helmut

ve2cfb, 2025-07-04:
Hello Wolle,

I installed Linux Mint, VS CODE, Platformio on a laptop and everything works fine.
Last time i used  Linux was about 50 + years ago and i only used it for a very short time.
So now, i am in a learning curve.

I just add the rich stuff according to your post.
https://github.com/schreibfaul1/ESP32-MiniWebRadio/issues/697#issuecomment-2975172392

As far as Windows problem, is concerned, i will put it aside for a while.

Many thanks for your support.
Pierre

schreibfaul1, 2025-07-05:
If you don't need to use special software that only runs on Windows, Linux is a good choice.

Closed 2025-08-20.

Thread 705 (2025-07-21):

AAC-64 Station: Software Reset due to exception/panic

TubaFonse, 2025-07-21:
Hallo Wolle,
wenn ich folgenden Sender wähle (Radio Tirol):

https://stream.radiotirol.it/live/aac-64/app/

folgt ein Software reset due to exception/panic,
Ser.-Monitor:

21:49:36 ir_code: ..  IR address 0x04, IR command 0x13
21:49:38 ir_result:   Stationnumber 3
00:00:00        *     MiniWebRadio V4     *
00:00:00        ***************************
00:00:00
00:00:00 setup: ....  Arduino is pinned to core 1
00:00:00 tft_info: .  init ST7796
00:00:00 setup: ....  Init SD card
00:00:00 setup: ....  SD card found, 14746.9 MB by 15193.5 MB free
00:00:00 ARDUINO:     LEDC attached to pin 10 (channel 0, resolution 8)
00:00:00 ARDUINO:     [WIFI][APlistAdd] add SSID: FRITZ!Box7490LF
00:00:00 WiFI_info:   add credentials: FRITZ!Box7490LF - xxxxxxxxxxxxxxxxxxxxxxxxxxxxxxxxx main.cpp:1294]
00:00:00 ARDUINO:     [WIFI][APlistAdd] add SSID: Nw5Box7490GastLF
00:00:00 WiFI_info:   add credentials: Nw5Box7490GastLF -  [main.cpp:1294]
00:00:00 ARDUINO:     [WIFI] scan done
00:00:00 ARDUINO:     [WIFI] 4 networks found
00:00:00 ARDUINO:     [WIFI] Connecting BSSID: C8:0E:14:0C:93:11 SSID: FRITZ!Box7490LF Channel: 11 (-50)
00:00:00 ARDUINO:     STA already disconnected.
00:00:00 ARDUINO:     [WIFI] Connecting done.
00:00:00 WiFI_info:   Connecting WiFi...
00:00:00 WiFI_info:   mDNS name: MiniWebRadio
00:00:00 setup: ....  connected to FRITZ!Box7490LF, IP address is 192.168.178.25, Received Signal Strength -48 dB
00:00:00 ARDUINO:     OTA server at: MiniWebRadio.local:3232
00:00:00 ftpServer:   Buffers allocated: 4622 bytes
00:00:00 rtime_info:  Initializing SNTP
00:00:00 AUDIO_info:  audioI2S Version 3.4.0a
00:00:00 AUDIO_info:  commFMT = Philips
00:00:00 setup: ....  number of saved stations: 195
00:00:00 setup: ....  number of saved favourites: 194
00:00:00 setup: ....  current station number: 3
00:00:00 setup: ....  current volume: 4
00:00:00 setup: ....  volume steps: 21
00:00:00 setup: ....  volume after alarm: 12
00:00:00 setup: ....  last connected host: https://stream.radiotirol.it/live/aac-64/app/
00:00:00 setup: ....  connection timeout: 2500 ms
00:00:00 setup: ....  connection timeout SSL: 3500 ms
00:00:00 RESET_REASON:Software reset due to exception/panic
00:00:00 Country: ... IT
21:49:52 WiFI_info:   RSSI is -47 dB
21:49:53 ftpServer:   Ftp server waiting for connection on port 21
21:49:53 BT-Emitter:  KCX_BT_Emitter found
21:49:54 webSrv: ...  Load from SD  "/ir_buttons.json"
21:49:54 BT-Emitter:  Status -> Scan...
21:49:54 webSrv: ...  Load from SD  "/stations.json"
21:49:55 BT-Emitter:  Status -> Disconnected
21:49:55 BT-Emitter:  POWER ON
21:49:55 BT-Emitter:  POWER ON
21:49:55 BT-Emitter:  scanned: MacAdd:449f4910164a,Name:WZ-BT5.0
21:49:55 BT-Emitter:  CON LAST
21:49:55 BT-Emitter:  Version KCX_BT_RTX_V1.4
21:49:55 BT-Emitter:  Volume -> 31
21:49:56 BT-Emitter:  Status -> Connected
21:50:01 DLNA_server: [0] 192.168.178.1:49000  FRITZ7490
21:50:01 DLNA_server: [1] 192.168.178.24:50001  DS213J_AL
21:50:01 DLNA_server: 2 media server found

Bitte um Hilfe,

Danke&Grüße,
Alfons

schreibfaul1, 2025-07-22:
Die selbst eingebauten Fehler sind am schwierigsten zu finden.
https://stream.radiotirol.it/live/aac-64/app/ leitet weiter zu einer URL die Prozentzeichen beinhaltet.

Was immer geht: printf("Hallo");
was zum Absturz führt: printf("Hallo%");

richtig wäre printf("Hallo%%"); oder printf("%s", "Hallo%");

habs korrigiert.

TubaFonse, 2025-07-22:
Danke Wolle für die anstrengende "Nachtschicht",
Grüße, Alfons

Closed 2025-07-22.
