schreibfaul1/ESP32-MiniWebRadio/docs/rgb displays/Elecrow 5inch Display/CrowPanel ESP32 Display-5.0-inch-V2.0-20231201.pdf

# USB type-c USB->UART

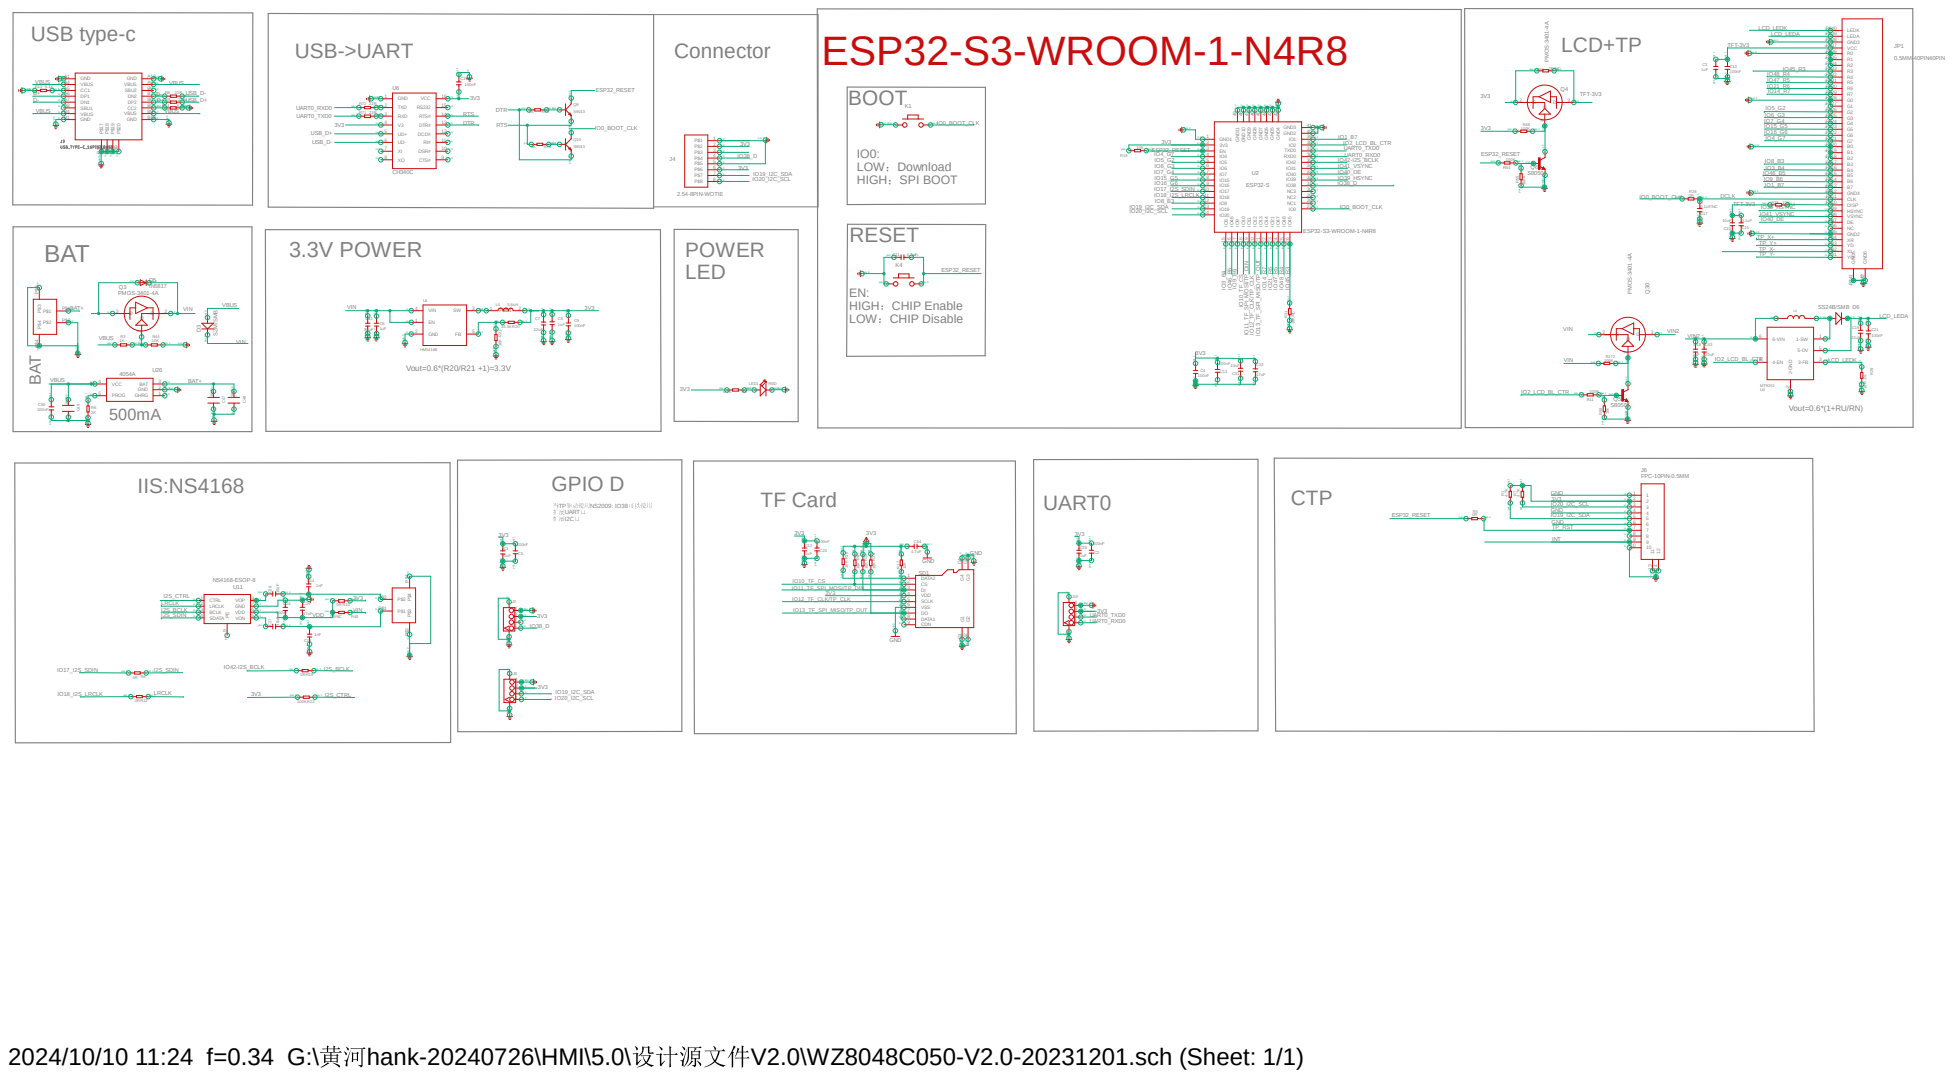
[picture p39: page 1]

sup 0 pas 1 pas 1 sup 0

pas 1 pas 1 pas 1 pas 1 sup 0 sup 0
