schreibfaul1/ESP32-MiniWebRadio/docs/rgb displays/Elecrow 7inch Display/CrowPanel ESP32 Display-7.0-inch-V3.0-20240420.pdf

# USB type-c USB->UART

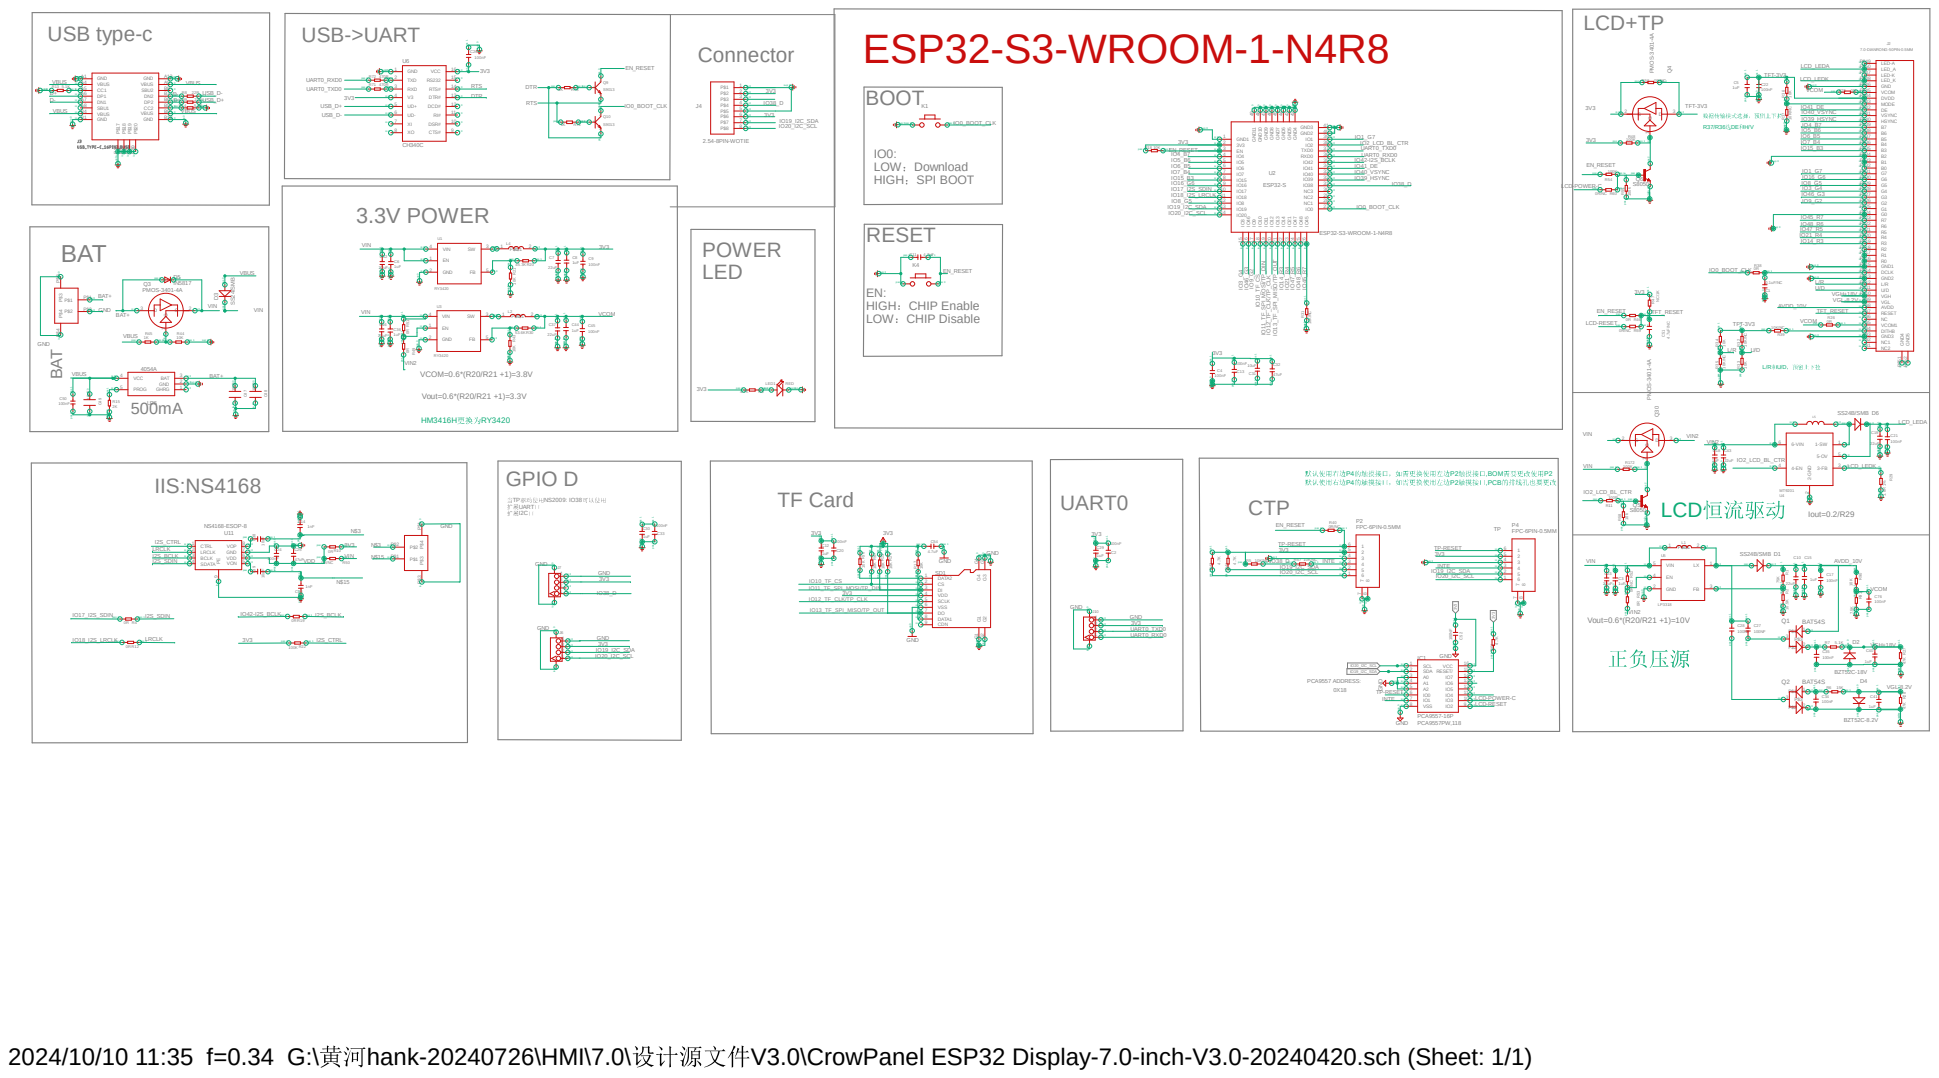
[picture p40: page 1]

pas 1 pas 1

pas 1 pas 1 pas 1 pas 1 sup 0

sup 0 pas 1 pas 1 sup 0

sup 0 pas 1 pas 1pas 1 pas 1
