schreibfaul1/ESP32-MiniWebRadio/src/main.cpp

#include "main.h"
#include "mwr_src/common.h"
#include "mwr_src/index.h"
#include "mwr_src/index.js.h"
#include "mwr_src/layout.hpp"
// clang-format off
/*****************************************************************************************************************************************************
    MiniWebRadio -- Webradio receiver for ESP32-S3

    first release on 03/2017                                                                                                      */char Version[] ="\
    Version 4.2.1e - Nov 12, 2026                                                                                                               ";

/*  display (320x240px) with controller ILI9341 or
    display (480x320px) with controller ILI9486, ILI9488 or ST7796 (SPI) or
    display (800x480px) (RGB-HMI) with TP controller GT911 (I2C)
    display (1024x600px) (DSI) with TP controller GT911 (I2C)

    SD_MMC is mandatory
    IR remote is optional
    BT Transmitter is optional
    BH1750 (lightsensor) is optional

*****************************************************************************************************************************************************/

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
// clang-format on

// —————————————————————————————————————————————————————————————————————————————————————————————————————————————————————————————————————————————————————————————————————————————————————————————————————
// 📌📌📌  S E T U P  📌📌📌
// —————————————————————————————————————————————————————————————————————————————————————————————————————————————————————————————————————————————————————————————————————————————————————————————————————

ETH_IDF ethernet;

void setup() {
    s_version = Version;
    s_version.trim();
    //---- BEGIN ---------
    Serial.begin(MONITOR_SPEED);
    vTaskDelay(1500); // wait for Serial to be ready
    printf("\n\n");
    printfln(s_tag.none, "");
    printfln(s_tag.none, "             " ANSI_ESC_YELLOW " ***************************************************** ");
    printfln(s_tag.none, "             " ANSI_ESC_YELLOW " *     MiniWebRadio {:29}    * " ANSI_ESC_RESET "      ", s_version);
    printfln(s_tag.none, "             " ANSI_ESC_YELLOW " ***************************************************** ");
    printfln(s_tag.none, "");

    mutex_rtc = xSemaphoreCreateMutex();
    mutex_display = xSemaphoreCreateMutex();

    // Callbacks
    Audio::audio_info_callback = my_audio_info; // audio callback
    dlna.dlna_client_callbak(on_dlna_client);   // dlna callback
    bt_emitter.kcx_bt_emitter_callback(on_kcx_bt_emitter);
    webSrv.websrv_callbak(on_websrv);
    meteo.meteo_callback(on_meteo);
    ethernet.ethernet_callback(on_ethernet);

    // if(!ethernet.begin()) Serial.printf("Ethernet error");

    esp_log_level_set("*", ESP_LOG_DEBUG);
    esp_log_set_vprintf(log_redirect_handler);
    if (!get_esp_items(&s_resetReason, &s_f_FFatFound)) return;

    s_f_brightnessIsChangeable = setupBacklight(TFT_BL);
    if (!s_f_brightnessIsChangeable) btn_SE_bright.set_active(false);
    setTFTbrightness(s_brightness);

    if (IR_PIN >= 0) {
        pinMode(IR_PIN, INPUT_PULLUP); // if ir_pin is read only, have a external resistor (~10...40KOhm)
    }

    pref.begin("Pref", false); // instance of preferences from AccessPoint (SSID, PW ...)

    if (!detect_i2_c_devices(&i2cBusOne, I2C_SDA, I2C_SCL, &s_i2c_items)) { printfln(s_tag.setup, "No i2c device found"); }

    if (s_i2c_items.bh1750_found) {
        BH1750.begin(&i2cBusOne, s_i2c_items.bh1750_addr); // init the sensor
        BH1750.setResolutionMode(BH1750.ONE_TIME_H_RESOLUTION_MODE);
        BH1750.setSensitivity(BH1750.SENSITIVITY_ADJ_MAX);
    }

    if (s_i2c_items.es8311_found) {
        bool res = es8311.begin(&i2cBusOne, s_i2c_items.es8311_addr); // init the dac
        if (res) es8311.setVolume(90);
    }

    if (s_i2c_items.tca9554_found) {
        bool res = tca9554.begin(&i2cBusOne, s_i2c_items.tca9554_addr); // init the port expander
        (void)res;
    }

    set_tft_items(); // TFT, Resolotion
    set_tp_items();  // TP, Resolotion
    if (!init_SD_card()) return;

    defaultsettings();

    if (ESP.getFlashChipSize() > 80000000) { FFat.begin(); }

    drawImage("/common/MiniWebRadioV4.jpg", 0, 0); // Welcomescreen
    updateSettings();

    if (!s_f_isEthernetConnected) s_f_isWiFiConnected = connectToWiFi();

    placingGraphicObjects();
    sdr_BR_value.setValue(s_brightness);
    sdr_EQ_lowPass.setValue(s_tone.LP);
    sdr_EQ_bandPass.setValue(s_tone.BP);
    sdr_EQ_highPass.setValue(s_tone.HP);
    sdr_EQ_balance.setValue(s_tone.BAL);
    sdr_DL_volume.setMinMaxVal(0, s_volume.volumeSteps);
    sdr_DL_volume.setValue(s_volume.cur_volume);
    sdr_PL_volume.setMinMaxVal(0, s_volume.volumeSteps);
    sdr_PL_volume.setValue(s_volume.cur_volume);
    sdr_RA_volume.setMinMaxVal(0, s_volume.volumeSteps);
    sdr_RA_volume.setValue(s_volume.cur_volume);
    sdr_CL_volume.setMinMaxVal(0, s_volume.volumeSteps);
    sdr_CL_volume.setValue(s_volume.cur_volume);
    sdr_WR_volume.setMinMaxVal(0, s_volume.volumeSteps);
    sdr_WR_volume.setValue(s_volume.cur_volume);
    btn_RA_mute.setValue(s_f_mute);
    btn_CL_mute.setValue(s_f_mute);
    btn_EQ_mute.setValue(s_f_mute);
    btn_PL_mute.setValue(s_f_mute);
    btn_DL_mute.setValue(s_f_mute);
    btn_WR_mute.setValue(s_f_mute);
    btn_BT_power.setValue(s_bt_emitter.enabled);
    btn_SE_spectrum.setValue(s_f_spectrum_enabled);
    btn_SE_vu_meter.setValue(s_f_vu_meter_enabled);
    lst_DLNA.client_and_history(&dlna, &s_dlnaHistory[0], 10);
    lst_RADIO.currentStationNr(&s_cur_station);
    clk_AC_red.alarm_time_and_days(&s_alarmdays, s_alarmtime);

    audio.settings.VU_LEVEL = true;
    audio.settings.SPECTRUM = true;
    audio.settings.BT_DEV_NANE = s_BTName;
    audio.settings.BT_SOURCE = s_f_bt_power;
    audio.setAudioTaskCore(AUDIOTASK_CORE);
    audio.setConnectionTimeout(CONN_TIMEOUT, CONN_TIMEOUT_SSL);
    audio.setVolumeSteps(s_volume.volumeSteps);
    audio.setVolume(0);
    audio.setPinout(I2S_BCLK, I2S_LRC, I2S_DOUT, I2S_MCLK);
    audio.setI2SCommFMT_LSB(I2S_COMM_FMT);

    printfln(s_tag.setup, "time zone: " ANSI_ESC_YELLOW "{}, {}", s_TZName, s_TZString);
    printfln(s_tag.setup, "number of saved stations: " ANSI_ESC_CYAN "{}", staMgnt.getSumStations());
    printfln(s_tag.setup, "number of saved favourites: " ANSI_ESC_CYAN "{}", staMgnt.getSumFavStations());
    printfln(s_tag.setup, "current station number: " ANSI_ESC_CYAN "{}", s_cur_station);
    printfln(s_tag.setup, "current volume: " ANSI_ESC_CYAN "{}", s_volume.cur_volume);
    printfln(s_tag.setup, "volume steps: " ANSI_ESC_CYAN "{}", s_volume.volumeSteps);
    printfln(s_tag.setup, "volume after alarm: " ANSI_ESC_CYAN "{}", s_volume.volumeAfterAlarm);
    printfln(s_tag.setup, "last connected host: " ANSI_ESC_YELLOW "{}", s_settings.lastconnectedhost);
    printfln(s_tag.setup, "connection timeout: " ANSI_ESC_CYAN "{}" ANSI_ESC_RESET " ms", CONN_TIMEOUT);
    printfln(s_tag.setup, "connection timeout SSL: " ANSI_ESC_CYAN "{}" ANSI_ESC_RESET " ms", CONN_TIMEOUT_SSL);

    if (s_volume.volumeSteps < 21) s_volume.volumeSteps = 21;

    ir.begin();    // Init InfraredDecoder
    meteo.begin(); // Init Open-Meteo
    meteo.set_coordinates(s_latiitude, s_longitude);
    meteo.set_timeZone(s_TZName);
    cls_weather.locale(&s_temperature_unit, &s_pressure_unit, &s_wind_speed_unit);

    if (AMP_ENABLED >= 0) { // enable onboard amplifier
        pinMode(AMP_ENABLED, OUTPUT);
        if (AMP_EN_INVERSION == 0) {
            digitalWrite(AMP_ENABLED, HIGH);
        } else {
            digitalWrite(AMP_ENABLED, LOW);
        }
        printfln(s_tag.setup, "On Board Amplifier pin is: " ANSI_ESC_CYAN "{}", AMP_ENABLED);
    }

    if (s_f_mute) { printfln(s_tag.setup, "volume is muted: (from " ANSI_ESC_CYAN "{}" ANSI_ESC_RESET ")", s_volume.cur_volume); }
    setI2STone();

    ticker100ms.attach(0.1, timer100ms);

    muteChanged(s_f_mute);
    if (s_f_isWiFiConnected) {
        if (s_resetReason == ESP_RST_POWERON ||   // Simply switch on the operating voltage
            s_resetReason == ESP_RST_SW ||        // ESP.restart()
            s_resetReason == ESP_RST_SDIO ||      // The boot button was pressed
            s_resetReason == ESP_RST_DEEPSLEEP) { // Wake up
            s_state = NONE;
        }
        setupOTA();
    }
    if(!s_f_isEthernetConnected && !s_f_isWiFiConnected) {
        s_state = NONE;
        changeState(WIFI_SETTINGS, 0);
        return;
    }

    if (BT_EMITTER_RX >= 0) bt_emitter.begin();

    rec_buffer.alloc_array(REC_BUFFER_SIZE, "rec_buffer");                             // allocate in PSRAM
    writeBuffer.alloc_array(WRITE_CHUNK_SIZE, "writeBuffer");                          // allocate in PSRAM
    xTaskCreatePinnedToCore(wavWriterTask, "wavWriter", 4096, nullptr, 1, nullptr, 0); // start recorder task
    printfln(s_tag.setup, "Recorder task started, free heap: " ANSI_ESC_CYAN "{}", ESP.getFreeHeap());

    drawImage("/common/Wallpaper.jpg", 0, 0);                                                                     // Wallpaper
    getTFT().copyFramebuffer(FB_VISIBLE, FB_BACKGROUND, 0, 0, displayConfig.dispWidth, displayConfig.dispHeight); // copy wallpaper to background

    dispHeader.updateVolume(s_volume.cur_volume);
    dispHeader.speakerOnOff(!s_f_mute);
    dispHeader.updateTime(s_time, true);

    dispFooter.setIpAddr(s_myIP);
    dispFooter.updateStation(s_cur_station);
    dispFooter.updateOffTime(s_sleeptime);

    s_stationURL = s_settings.lastconnectedhost;
    s_start_counter = 1;

    setTFTbrightness(s_brightness);

    if (s_i2c_items.es8311_found) {
        es.begin(&i2cBusOne, 0x18);
        es.setBitsPerSample(32);
        es.setVolume(100);
        audio.forceMono(true);
    }
}

// —————————————————————————————————————————————————————————————————————————————————————————————————————————————————————————————————————————————————————————————————————————————————————————————————————
// 📌📌📌  L O O P  📌📌📌
// —————————————————————————————————————————————————————————————————————————————————————————————————————————————————————————————————————————————————————————————————————————————————————————————————————

void loop() {
    vTaskDelay(1);
    ArduinoOTA.handle();
    if (s_f_otaRunning) return; // give the WiFi/TCP stack exclusive access to the core for the rest of the transfer
    dlna.loop();
    audio.loop();
    webSrv.loop();
    ftpSrv.handleFTP();
    ir.loop();
    meteo.loop();
    getTP().loop();
    bt_emitter.loop();
    getTFT().loop();
    BH1750.loop();

    if (s_start_counter) s_start_counter++;
    if (s_start_counter == 10) { MDNS.begin("MiniWebRadio"); }
    if (s_start_counter == 20) { MDNS.addService("esp32", "tcp", 80); }
    if (s_start_counter == 30) { ArduinoOTA.begin(); }
    if (s_start_counter == 40) { ftpSrv.begin(SD_MMC, FTP_USERNAME, FTP_PASSWORD); }
    if (s_start_counter == 50) { setRTC(s_TZString); }
    if (s_start_counter == 60) { setStation(s_cur_station); }
    if (s_start_counter == 70) { changeState(RADIO, 0); } // s_lastState
    if (s_start_counter == 80) { dlna.seekServer(); }
    if (s_start_counter == 90) { webSrv.begin(80, 81, "MiniWebRadio", s_version); }
    if (s_start_counter == 100) { s_f_update_meteo_data = true; } // meteo send_request
    if (s_start_counter == 110) { s_start_counter = 0; }

    // Cap lines drained per loop() call: sending every buffered line in one go blocks this core (shared with UI/touch/WiFi events)
    // for the whole burst, e.g. during reconnects or verbose logging, causing UI/web sluggishness. Spreading it over several
    // loop() iterations keeps each iteration short while still catching up quickly (loop runs many times per second).
    uint8_t       logLinesThisLoop = 0;
    const uint8_t maxLogLinesPerLoop = 10;
    while (s_logBuffer.size() > 0 && logLinesThisLoop < maxLogLinesPerLoop) {
        size_t i = s_logBuffer.size();
        if (s_logBuffer[i - 1].strlen() > 0 && s_logBuffer[i - 1].strlen() < 2048) {
            webSrv.send("serTerminal=", s_logBuffer[i - 1]);
        } else
            log_w("[%s:%i] log buffer full, strlen %i", __FILE__, __LINE__, s_logBuffer[i - 1].strlen());
        s_logBuffer.pop_back();
        logLinesThisLoop++;
    }

    if (s_f_dlnaBrowseServer) {
        s_f_dlnaBrowseServer = false;
        dlna.browseServer(s_currDLNAsrvNr, s_dlnaHistory[s_dlnaLevel].objId, s_totalNumberReturned);
    }
    if (s_f_clearLogo) {
        s_f_clearLogo = false;
        clearLogo();
    }
    if (s_f_clearStationName) {
        s_f_clearStationName = false;
        clearStationName();
    }

    if (s_f_playlistEnabled) {
        if (!audio.isRunning() && !s_f_pauseResume) { processPlaylist(); }
    }
    //-----------------------------------------------------0.1 SEC------------------------------------------------------------------------------------
    if (s_f_100ms) { // calls every 0.1 second
        s_f_100ms = false;

        while (s_timeCounter.timer) {
            s_timeCounter.timer -= s_timeCounter.factor;
            s_timeCounter.timer = std::round(s_timeCounter.timer * 1000.0f) / 1000.0f;
            if (s_timeCounter.timer < 0.0f) s_timeCounter.timer = 0.0f;
            dispFooter.updateTC(s_timeCounter.timer);
            if (s_timeCounter.timer != 0.0f) break;

            if (volBox.is_enabled()) volBox.hide();
            if (s_f_sleeping) return; // tc is active by pressing a button, but do nothing if "off"
            if (s_state == RADIO) {
                if (!txt_RA_staName.is_enabled()) { txt_RA_staName.show(); } // assume volBox is shown
                if (s_subState_radio == 1) { changeState(RADIO, 0); }        // Mute, Vol+, Vol-, Sta+, Sta-, StaList
                if (s_subState_radio == 2) { changeState(RADIO, 0); }        // Player, DLNA, Clock, SleepTime, Brightness, EQ, BT, Off
            } else if (s_state == STATIONSLIST) {
                changeState(RADIO, 0);
            } else if (s_state == PLAYER) {
                if (!txt_PL_fName.is_enabled()) { txt_PL_fName.show(); } // assume volBox is shown
            } else if (s_state == AUDIOFILESLIST) {
                changeState(PLAYER, 0);
            } else if (s_state == DLNA) {
                if (!txt_DL_fName.is_enabled()) { txt_DL_fName.show(); } // assume volBox is shown
            } else if (s_state == DLNAITEMSLIST) {
                changeState(DLNA, 0);
            } else if (s_state == CLOCK) {
                changeState(CLOCK, 0);
            } else if (s_state == WEATHER) {
                changeState(WEATHER, 0);
            } else {
                ;
            } // all other, do nothing
        }

        if (!s_f_rtc) { s_f_rtc = rtc.hasValidTime(); }
        // ------------------------------------------- volume / mute --------------------------------------------------------------------------------
        if (!s_f_mute) {
            if (audio.getVolume() != s_volume.cur_volume) { audio.setVolume(s_volume.cur_volume); }
        } else {
            if (audio.getVolume() != 0) { audio.setVolume(0); }
        }

        // ------------------------------------------- message box ----------------------------------------------------------------------------------
        if (s_f_msg_box) {                // messagebox is visible?
            if (s_timestamp < millis()) { // time to hide
                s_f_msg_box = false;
                msg_box.hide();
                if (s_f_esp_restart) { // restart after time
                    s_f_esp_restart = false;
                    ESP.restart();
                }
            }
        }
    }
    //----------------------------------------------------- 1 SEC ------------------------------------------------------------------------------------

    if (s_f_1sec) { // calls every second
        s_f_1sec = false;

        s_time = rtc.get_rtime();
        s_totalRuntime++;
        uint16_t minuteOfTheDay = rtc.getMinuteOfTheDay();
        uint8_t  weekDay = rtc.getweekday();
        clk_CL_24.updateTime(minuteOfTheDay, weekDay);
        cls_weather.update_time(s_time);
        clk_RI_24small.updateTime(minuteOfTheDay, weekDay);
        static uint8_t semaphore = 0;
        if (!semaphore) { s_f_alarm = isAlarm(weekDay, s_alarmdays, minuteOfTheDay, s_alarmtime) && s_f_rtc; } // alarm if rtc and CL green
        if (s_f_alarm) { semaphore++; }
        if (semaphore) { semaphore++; }
        if (semaphore >= 65) { semaphore = 0; }

        //------------------------------------------ALARM MANAGEMENT----------------------------------------------------------------------------------
        if (s_f_alarm) {
            s_f_alarm = false;
            if (s_f_sleeping)
                wake_up(RINGING, 0);
            else
                changeState(RINGING, 0);
        }
        if (s_f_eof_alarm) { // AFTER RINGING
            s_f_eof_alarm = false;
            s_volume.cur_volume = s_volume.volumeAfterAlarm;
            changeState(RADIO, 0);
        }

        if (s_f_stationsChanged) {
            s_f_stationsChanged = false;
            staMgnt.updateStationsList();
        }
        //------------------------------------------UPDATE DISPLAY------------------------------------------------------------------------------------
        if (!s_f_sleeping || s_state == RINGING) {
            if (s_time.minute == 59 && s_time.second == 53) s_f_timeSpeech = true;

            dispHeader.updateTime(s_time, false);
            if (s_f_newBitRate) {
                s_f_newBitRate = false;
                dispFooter.updateBitRate(s_icyBitRate);
            }
            if (s_f_newStationName) {
                s_f_newStationName = false;
                showStationName();
            }
        }
        //------------------------------------------ UPDATE METEO ------------------------------------------------------------------------------------
        if (s_f_update_meteo_data && (!s_repeat.next_attempt || (int32_t)(millis() - s_repeat.next_attempt) >= 0)) {
            if (!s_repeat.repeats_yet) printfln(s_tag.meteo_info, ANSI_ESC_GREEN "Start update Open-Meteo data");
            bool res = meteo.send_request();
            if (!res) { // only one repeat after 60 seconds
                printfln(s_tag.meteo_info, ANSI_ESC_YELLOW "Open-Meteo request failed, try again in 60s");
                if (!s_repeat.repeats_yet) {
                    s_repeat.repeats_yet = true;
                    s_repeat.next_attempt = millis() + 60000;
                } else {
                    s_f_update_meteo_data = false;
                    s_repeat.reset();
                    printfln(s_tag.meteo_info, ANSI_ESC_RED "Open-Meteo request failed");
                }
            } else {
                s_f_update_meteo_data = false;
                s_repeat.reset();
            }
        }

        if (s_f_update_meteo_display) {
            cls_weather.update_display();
            printfln(s_tag.meteo_info, ANSI_ESC_GREEN "Update Open-Meteo display");
            s_f_update_meteo_display = false;
        }

        if (s_time.minute == 55 && s_time.second == 0) s_f_update_meteo_data = true;
        if (s_time.minute == 00 && s_time.second == 30) s_f_update_meteo_display = true;
        //---------------------------------------------TIME SPEECH -----------------------------------------------------------------------------------
        static bool f_resume = false;
        if (s_f_timeSpeech) { // speech the time 7 sec before a new hour is arrived
            s_f_timeSpeech = false;
            uint8_t hour = s_time.hour + 1;
            if (hour == 24) hour = 0; //  extract the hour
            if (s_f_timeAnnouncement && !s_f_mute && !s_f_sleeping && s_state == RADIO) {
                f_resume = true;
                s_f_eof = false;
                ps_ptr<char> p;
                p.assignf("/voice_time/{}/{}_00.mp3", s_timeSpeechLang, hour);
                connecttoFS("SD_MMC", p);
            } else {
                printfln(s_tag.action, "Time announcement at " ANSI_ESC_CYAN "{}" ANSI_ESC_RESET " o'clock is silent", hour);
            }
        }
        if (f_resume && s_f_eof) {
            f_resume = false;
            s_f_eof = false;
            setStation(s_cur_station);
            return;
        }
        //------------------------------------------AUDIO_CURRENT_TIME - DURATION---------------------------------------------------------------------
        if (audio.isRunning()) {
            s_audioFileDuration = audio.getAudioFileDuration();
            if (s_audioFileDuration > 0) {
                s_audioCurrentTime = audio.getAudioCurrentTime();
                if (s_state == PLAYER && s_audioFileDuration) {
                    pgb_PL_progress.setNewMinMaxVal(0, s_audioFileDuration);
                    pgb_PL_progress.setValue(s_audioCurrentTime);
                }
                if (s_state == DLNA && s_audioFileDuration) {
                    pgb_DL_progress.setNewMinMaxVal(0, s_audioFileDuration);
                    pgb_DL_progress.setValue(s_audioCurrentTime);
                }
                if (s_audioFileDuration) {
                    ps_ptr<char> act;
                    act.set_name("act");
                    act.assignf(ANSI_ESC_GREEN "AudioCurrentTime {}:{:02}s, ", s_audioCurrentTime / 60, s_audioCurrentTime % 60);
                    act.appendf("AudioFileDuration {}:{:02}s", s_audioFileDuration / 60, s_audioFileDuration % 60);
                    printfcr(s_tag.action, "{}", act);
                }
            }
        }
        //------------------------------------------NEW STREAMTITLE-----------------------------------------------------------------------------------
        if (s_f_newStreamTitle && s_timeCounter.timer == 0) {
            s_f_newStreamTitle = false;
            if (s_state == RADIO) {
                if (s_streamTitle.valid())
                    showStreamTitle(s_streamTitle);
                else if (s_icyDescription.valid()) {
                    showStreamTitle(s_icyDescription);
                    s_f_newIcyDescription = false;
                    webSrv.send("icy_description=", s_icyDescription);
                } else {
                    txt_RA_sTitle.setText("");
                    txt_RA_sTitle.show();
                }
            }
            webSrv.send("streamtitle=", s_streamTitle);
        }
        if (s_f_newLyrics) {
            s_f_newLyrics = false;
            if (s_state == RADIO) showStreamTitle(s_lyrics);
            if (s_state == PLAYER) showPlayerFileName(s_lyrics);
            if (s_state == DLNA) show_DLNA_FileName(s_lyrics);
        }
        //------------------------------------------NEW ICY-DESCRIPTION-------------------------------------------------------------------------------
        if (s_f_newIcyDescription && s_timeCounter.timer == 0) {
            if (s_state == RADIO) {
                if (!s_streamTitle.valid()) showStreamTitle(s_icyDescription);
            }
            webSrv.send("icy_description=", s_icyDescription);
            s_f_newIcyDescription = false;
        }
        //------------------------------------------DETERMINE AUDIOCODEC------------------------------------------------------------------------------
        if (s_cur_Codec == 0) {
            uint8_t c = audio.getCodec();
            if (c != 0 && c < 8) { // unknown or OGG, guard: c {1 ... 7, 9}
                s_cur_Codec = c;
                printfln(s_tag.audio_codec, ANSI_ESC_YELLOW "{}", codecname[c]);
                if (s_state == PLAYER) showFileLogo(PLAYER, s_subState_player);
            }
        }
        //------------------------------------------CONNECT TO LASTHOST-------------------------------------------------------------------------------
        if (s_f_connectToLastStation) { // not used yet
            s_f_connectToLastStation = false;
            setStation(s_cur_station);
        }
        //----------------------------------------------SD RECORDER-----------------------------------------------------------------------------------
        if (s_f_recording) {
            // MWR_LOG_WARN("recording");
            if (audio.isRunning()) {
                if (!recorder.running) {
                    recorder.startRequested = true;
                    recorder.running = true;
                    printfln(s_tag.action, "Start recording");
                }
            }
        } else {
            if (recorder.running) {
                recorder.sampleRate = audio.getSampleRate();
                printfln(s_tag.action, "Stop recording");
                recorder.stopRequested = true;
                recorder.running = false;
            }
        }
        //------------------------------------------RECONNECT AFTER FAIL------------------------------------------------------------------------------
        if (s_f_reconnect && !s_f_isWiFiConnected) { // not used yet
            s_f_reconnect = false;
            connecttohost(s_settings.lastconnectedhost.get());
        }
        //------------------------------------------CREATE DLNA PLAYLIST------------------------------------------------------------------------------
        if (s_f_dlnaMakePlaylistOTF && s_f_dlna_browseReady) {
            s_f_dlnaMakePlaylistOTF = false;
            s_f_dlna_browseReady = false;
            //    if( playlist.create_playlist_from_DLNA_folder()) s_f_playlistEnabled = true;
        }
        //------------------------------------------DLNA ITEMS RECEIVED-------------------------------------------------------------------------------
        if (s_f_dlna_browseReady) { // unused
            s_f_dlna_browseReady = false;
        }
        //-------------------------------------------WIFI DISCONNECTED?-------------------------------------------------------------------------------
        if (WiFi.isConnected() == false) {
            if (s_f_WiFi_lost == false) {
                printfln(s_tag.wifi_info, ANSI_ESC_YELLOW "Reconnecting to WiFi...");
                if (s_state == RADIO) audio.stopSong();
                s_f_WiFi_lost = true;
            }
        } else {
            if (s_f_WiFi_lost) {
                s_f_WiFi_lost = false;
                if (s_state == RADIO) audio.connecttohost(s_settings.lastconnectedhost.get());
            }
        }
        s_f_WiFi_lost == false ? dispHeader.updateRSSI(WiFi.RSSI()) : dispHeader.updateRSSI(-86);
        dispFooter.updateAntenna(s_f_WiFi_lost);
        //------------------------------------------GET AUDIO FILE ITEMS------------------------------------------------------------------------------
        if (s_f_isFSConnected) {
            //    uint32_t t = 0;
            //    uint32_t fs = audioGetFileSize();
            //    uint32_t br = audioGetBitRate();
            //    if(br) t = (fs * 8)/ br;
            //    MWR_LOG_DEBUG("Br {}, Dur {}s", br, t);
        }
        //--------------------------------------------- BT EMITTER ----------------------------------------------------------------------------------
        if (s_bt_emitter.found) {
            btn_RA_bt.set_active(true);
            if (s_bt_emitter.enabled) {
                if (!s_f_sleeping) {
                    if (!bt_emitter.get_power_state()) bt_emitter.power_on(s_bt_emitter.mode);
                } else {
                    if (bt_emitter.get_power_state()) bt_emitter.power_off();
                }
            } else {
                if (bt_emitter.get_power_state()) { bt_emitter.power_off(); }
            }
            if (bt_emitter.getMode().equals("NA")) {
                ; // not ready yet
            } else if (bt_emitter.get_power_state() && !bt_emitter.getMode().equals(s_bt_emitter.mode)) {
                bt_emitter.setMode(s_bt_emitter.mode);
            }
        }
    } //  END s_f_1sec
    //------------------------------------------------------------------------------------------------------------------------------------------------
    if (s_f_10sec == true) { // calls every 10 seconds
        s_f_10sec = false;
        updateSettings();
        wifiMulti.run();
    }

    if (s_f_1min == true) { // calls every minute
        s_f_1min = false;
        if (s_sleeptime) {
            s_sleeptime--;
            if (!s_sleeptime) fall_asleep();
            dispFooter.updateOffTime(s_sleeptime);
        }

        // static uint8_t btEmitterCnt = 0;
        // if (!s_bt_emitter.found && btEmitterCnt < 1) {
        //     btEmitterCnt++;
        //     bt_emitter.begin(); // if the emitter has not yet responded
        // }
    }

    if (s_f_1h == true) { // calls every hour
        s_f_1h = false;
    }

    //-------------------------------------------------DEBUG / WIFI_SETTINGS ----------------------------------------------------------------------------------
    if (Serial.available()) { // input: serial terminal
        ps_ptr<char> r = Serial.readString().c_str();
        r.replace("\r", "");
        r.replace("\n", "");
        user_input(r);
    }
}

/*  ╔═══════════════════════════════════════════════════════════════════════════════════════════════════════════════════════════════════════════╗
    ║                                                     D E F A U L T S E T T I N G S                                                         ║
    ╚═══════════════════════════════════════════════════════════════════════════════════════════════════════════════════════════════════════════╝   */

boolean defaultsettings() {

    if (!SD_MMC.exists("/ir_buttons.json")) { // if not found ir_buttons.json create a default file
        File file = SD_MMC.open("/ir_buttons.json", "w", true);
        file.write((uint8_t*)ir_buttons_json, sizeof(ir_buttons_json));
        file.close();
    }
    irb.loadButtonsFromJSON("/ir_buttons.json");
    for (uint i = 0; i < s_settings.numOfIrButtons; i++) {
        MWR_LOG_DEBUG("0x{:04X},  {}", s_settings.irbuttons[i].val, s_settings.irbuttons[i].label);
        ir.set_irButtons(i, s_settings.irbuttons[i].val);
    }
    ir.set_irAddress(s_settings.irbuttons[42].val);
    MWR_LOG_DEBUG("0x{:04X},  {}", s_settings.irbuttons[42].val, s_settings.irbuttons[42].label);

    if (!SD_MMC.exists("/settings.json")) { // if not found create one
        updateSettings();
    }

    File         file2 = SD_MMC.open("/settings.json", "r", false);
    size_t       file2_size = file2.size();
    ps_ptr<char> jO;
    jO.calloc(file2_size);
    file2.readBytes(jO.get(), file2_size);
    s_settingsHash = simpleHash(jO);
    file2.close();

    auto parseJson = [&](const char* s) { // lambda, inner function
        ps_ptr<char> res = "0";
        int16_t      pos1 = 0, pos2 = 0, pos3 = 0;
        pos1 = jO.index_of(s, 0);
        if (pos1 < 0) {
            MWR_LOG_ERROR("index {} not found", s);
            return res;
        }
        pos2 = jO.index_of(":", pos1) + 1;
        if (jO[pos2] == '\"')
            pos3 = jO.index_of("\"", pos2 + 1) + 1;
        else
            pos3 = jO.index_of(",", pos2);
        if (pos3 < 0) pos3 = jO.index_of("}\n", pos2);
        if (jO[pos2] == '\"') {
            pos2++;
            pos3--;
        } // remove \" embraced strings
        res = jO.substr(pos2, pos3 - pos2);
        res[pos3 - pos2] = '\0';
        return res;
    };

    auto computeMinuteOfTheDay = [&](ps_ptr<char> s) {
        if (s.strlen() != 5) {
            MWR_LOG_ERROR("invalid time string {}", s);
            return 0;
        }
        uint8_t h = s.substr(0, 2).to_uint8();
        uint8_t m = s.substr(3, 2).to_uint8();
        MWR_LOG_DEBUG("s {}, h {}, m {}", s, h, m);
        return h * 60 + m;
    };

    s_settings.lastconnectedhost.reset();
    s_settings.lastconnectedfile.reset();

    s_volume.cur_volume = parseJson("\"volume\":").to_uint8();
    s_volume.volumeSteps = parseJson("\"volumeSteps\":").to_uint8();
    s_volume.ringVolume = parseJson("\"ringVolume\":").to_uint8();
    s_volume.volumeAfterAlarm = parseJson("\"volumeAfterAlarm\":").to_uint8();
    s_bt_emitter.volume = parseJson("\"KCX_BTvolume\":").to_uint8();
    s_bt_emitter.enabled = parseJson("\"KCX_BTpower\":").equals("true") ? true : false;
    s_bt_emitter.mode = parseJson("\"KCX_BTmode\":").equals("TX") ? "TX" : "RX";
    s_BTName = parseJson("\"BT_Sink_Name\":");
    s_f_bt_power = parseJson("\"BT_Power\":").equals("true") ? true : false;
    s_alarmtime[0] = computeMinuteOfTheDay(parseJson("\"alarmtime_sun\":"));
    s_alarmtime[1] = computeMinuteOfTheDay(parseJson("\"alarmtime_mon\":"));
    s_alarmtime[2] = computeMinuteOfTheDay(parseJson("\"alarmtime_tue\":"));
    s_alarmtime[3] = computeMinuteOfTheDay(parseJson("\"alarmtime_wed\":"));
    s_alarmtime[4] = computeMinuteOfTheDay(parseJson("\"alarmtime_thu\":"));
    s_alarmtime[5] = computeMinuteOfTheDay(parseJson("\"alarmtime_fri\":"));
    s_alarmtime[6] = computeMinuteOfTheDay(parseJson("\"alarmtime_sat\":"));
    s_alarmdays = parseJson("\"alarm_weekdays\":").to_uint8();
    s_f_timeAnnouncement = parseJson("\"timeAnnouncing\":").equals("true") ? true : false;
    s_timeSpeechLang = parseJson("\"timeSpeechLang\":");
    s_f_mute = parseJson("\"mute\":").equals("true") ? true : false;
    s_f_vu_meter_enabled = parseJson("\"vu_meter_enabled\":").equals("true") ? true : false;
    s_f_spectrum_enabled = parseJson("\"spectrum_enabled\":").equals("true") ? true : false;
    s_brightness = parseJson("\"brightness\":").to_uint8();
    s_sleeptime = parseJson("\"sleeptime\":").to_uint16();
    s_cur_station = parseJson("\"station\":").to_uint16();
    s_tone.LP = parseJson("\"toneLP\":").to_int16();
    s_tone.BP = parseJson("\"toneBP\":").to_int16();
    s_tone.HP = parseJson("\"toneHP\":").to_int16();
    s_tone.BAL = parseJson("\"balance\":").to_int16();
    s_TZName = parseJson("\"Timezone_Name\":");
    s_settings.lastconnectedhost = parseJson("\"lastconnectedhost\":");
    s_settings.lastconnectedfile = parseJson("\"lastconnectedfile\":");
    s_sleepMode = parseJson("\"sleepMode\":").to_uint8();
    s_lastState = parseJson("\"state\":").to_int8();
    s_location = parseJson("\"location\":");
    s_latiitude = parseJson("\"latiitude\":");
    s_longitude = parseJson("\"longitude\":");
    s_temperature_unit = parseJson("\"temp_unit\":");
    s_pressure_unit = parseJson("\"press_unit\":");
    s_wind_speed_unit = parseJson("\"wind_speed_unit\":");
    s_f_sleeping = parseJson("\"isSleeping\":").equals("true") ? true : false;

    // set some items ---------------------------------------------------------------------------------------------
    if (!s_settings.lastconnectedfile.starts_with("/")) { s_settings.lastconnectedfile.assign("/audiofiles/"); } // guard
    s_SD_content.setLastConnectedFile(s_settings.lastconnectedfile);
    s_cur_AudioFolder = s_SD_content.getLastConnectedFolder();
    s_cur_AudioFileName = s_SD_content.getLastConnectedFileName();
    s_cur_AudioFileNr = s_SD_content.getPosByFileName(s_cur_AudioFileName);
    if (s_cur_AudioFileNr == -1) s_cur_AudioFileNr = 0; // not found
    s_TZString = getTZString(s_TZName);
    // ------------------------------------------------------------------------------------------------------------

    if (!SD_MMC.exists("/stations.json")) { // if not found create one
        File file1 = SD_MMC.open("/stations.json", "w", true);
        file1.write((uint8_t*)stations_json, sizeof(stations_json) - 1); // without termination
        file1.close();
    }
    staMgnt.updateStationsList();
    return true;
}

void updateSettings() {
    if (!s_settings.lastconnectedhost.valid()) s_settings.lastconnectedhost.assign("");
    if (!s_settings.lastconnectedfile.valid()) s_settings.lastconnectedfile.assign("/audiofiles/");
    ps_ptr<char> jO;
    ; // JSON Object
    jO.assign("{\n");
    jO.appendf("  \"volume\":{}", s_volume.cur_volume);
    jO.appendf(",\n  \"volumeSteps\":{}", s_volume.volumeSteps);
    jO.appendf(",\n  \"ringVolume\":{}", s_volume.ringVolume);
    jO.appendf(",\n  \"volumeAfterAlarm\":{}", s_volume.volumeAfterAlarm);
    jO.appendf(",\n  \"KCX_BTvolume\":{}", s_bt_emitter.volume);
    jO.appendf(",\n  \"KCX_BTpower\":\"{}\"", s_bt_emitter.enabled);
    jO.appendf(",\n  \"KCX_BTmode\":\"{}\"", bt_emitter.getMode());
    jO.appendf(",\n  \"BT_Sink_Name\":\"{}\"", s_BTName);
    jO.appendf(",\n  \"BT_Power\":\"{}\"", s_f_bt_power);
    jO.appendf(",\n  \"alarmtime_sun\":\"{:02}:{:02}\"", s_alarmtime[0] / 60, s_alarmtime[0] % 60);
    jO.appendf(",\n  \"alarmtime_mon\":\"{:02}:{:02}\"", s_alarmtime[1] / 60, s_alarmtime[1] % 60);
    jO.appendf(",\n  \"alarmtime_tue\":\"{:02}:{:02}\"", s_alarmtime[2] / 60, s_alarmtime[2] % 60);
    jO.appendf(",\n  \"alarmtime_wed\":\"{:02}:{:02}\"", s_alarmtime[3] / 60, s_alarmtime[3] % 60);
    jO.appendf(",\n  \"alarmtime_thu\":\"{:02}:{:02}\"", s_alarmtime[4] / 60, s_alarmtime[4] % 60);
    jO.appendf(",\n  \"alarmtime_fri\":\"{:02}:{:02}\"", s_alarmtime[5] / 60, s_alarmtime[5] % 60);
    jO.appendf(",\n  \"alarmtime_sat\":\"{:02}:{:02}\"", s_alarmtime[6] / 60, s_alarmtime[6] % 60);
    jO.appendf(",\n  \"alarm_weekdays\":{}", s_alarmdays);
    jO.appendf(",\n  \"timeAnnouncing\":\"{}\"", s_f_timeAnnouncement);
    jO.appendf(",\n  \"timeSpeechLang\":\"{}\"", s_timeSpeechLang);
    jO.appendf(",\n  \"mute\":\"{}\"", s_f_mute);
    jO.appendf(",\n  \"vu_meter_enabled\":\"{}\"", s_f_vu_meter_enabled);
    jO.appendf(",\n  \"spectrum_enabled\":\"{}\"", s_f_spectrum_enabled);
    jO.appendf(",\n  \"brightness\":{}", s_brightness);
    jO.appendf(",\n  \"sleeptime\":{}", s_sleeptime);
    jO.appendf(",\n  \"lastconnectedhost\":\"{}\"", s_settings.lastconnectedhost);
    jO.appendf(",\n  \"lastconnectedfile\":\"{}\"", s_settings.lastconnectedfile);
    jO.appendf(",\n  \"station\":{}", s_cur_station);
    jO.appendf(",\n  \"Timezone_Name\":\"{}\"", s_TZName);
    jO.appendf(",\n  \"toneLP\":{}", s_tone.LP);
    jO.appendf(",\n  \"toneBP\":{}", s_tone.BP);
    jO.appendf(",\n  \"toneHP\":{}", s_tone.HP);
    jO.appendf(",\n  \"balance\":{}", s_tone.BAL);
    jO.appendf(",\n  \"state\":{}", s_state);
    jO.appendf(",\n  \"sleepMode\":{}", s_sleepMode);
    jO.appendf(",\n  \"location\":\"{}\"", s_location);
    jO.appendf(",\n  \"latiitude\":\"{}\"", s_latiitude);
    jO.appendf(",\n  \"longitude\":\"{}\"", s_longitude);
    jO.appendf(",\n  \"temp_unit\":\"{}\"", s_temperature_unit);
    jO.appendf(",\n  \"press_unit\":\"{}\"", s_pressure_unit);
    jO.appendf(",\n  \"wind_speed_unit\":\"{}\"", s_wind_speed_unit);
    jO.appendf(",\n  \"isSleeping\":\"{}\"", s_f_sleeping);
    jO.append("\n}");

    if (s_settingsHash != simpleHash(jO)) {
        File file = SD_MMC.open("/settings.json", "w", false);
        if (!file) {
            MWR_LOG_ERROR("file \"settings.json\" not found");
            return;
        }
        file.print(jO.get());
        s_settingsHash = simpleHash(jO);

        MWR_LOG_DEBUG("{}", jO);
    }
}
/*****************************************************************************************************************************************************
 *                                                               T I M E R                                                                           *
 *****************************************************************************************************************************************************/

void timer100ms() {
    static uint32_t tick = 0;
    s_f_100ms = true;
    tick++;
    if (tick % 10 == 0) s_f_1sec = true;
    if (tick % 100 == 0) s_f_10sec = true;
    if (tick % 600 == 0) s_f_1min = true;
    if (tick == 36000) {
        s_f_1h = true;
        tick = 0;
    }
}

/*****************************************************************************************************************************************************
 *                                                               D I S P L A Y                                                                       *
 *****************************************************************************************************************************************************/

inline void clearLogo() {
    getTFT().copyFramebuffer(FB_BACKGROUND, FB_VISIBLE, layout.winLogo.x, layout.winLogo.y, layout.winLogo.w, layout.winLogo.h);
}
inline void clearStationName() {
    getTFT().copyFramebuffer(FB_BACKGROUND, FB_VISIBLE, layout.winName.x, layout.winName.y, layout.winName.w, layout.winName.h);
}
inline void clearStreamTitle() { // without VUmeter
    getTFT().copyFramebuffer(FB_BACKGROUND, FB_VISIBLE, layout.winSTitle.x, layout.winSTitle.y, layout.winSTitle.w, layout.winSTitle.h);
}
inline void clearArea2() { // without VUmeter
    getTFT().copyFramebuffer(FB_BACKGROUND, FB_VISIBLE, layout.winArea2.x, layout.winArea2.y, layout.winArea2.w, layout.winArea2.h);
}
inline void clearWithOutHeaderFooter(int32_t bgColor) {
    if (bgColor == TFT_BG_IS_WALLPAPER) {
        getTFT().copyFramebuffer(FB_BACKGROUND, FB_VISIBLE, layout.winWoHF.x, layout.winWoHF.y, layout.winWoHF.w, layout.winWoHF.h);
    } else {
        getTFT().fillRect(layout.winWoHF.x, layout.winWoHF.y, layout.winWoHF.w, layout.winWoHF.h, TFT_BLACK);
    }
}
inline void clearAll(int32_t bgColor) {
    if (bgColor == TFT_BG_IS_WALLPAPER) {
        getTFT().copyFramebuffer(FB_BACKGROUND, FB_VISIBLE, 0, 0, displayConfig.dispWidth, displayConfig.dispHeight); // copy wallpaper
    } else {
        getTFT().fillRect(0, 0, displayConfig.dispWidth, displayConfig.dispHeight, TFT_BLACK);
    }
}

void showStationName() {
    if (s_f_sleeping) return;
    if (s_state != RADIO) return;
    txt_RA_staName.setTextColor(TFT_CYAN);
    txt_RA_staName.setText(getStationName());
    txt_RA_staName.show();
}

void showStreamTitle(ps_ptr<char> streamtitle) {
    if (s_f_sleeping) return;

    streamtitle.trim();

    txt_RA_sTitle.setTextColor(TFT_CORNSILK);
    txt_RA_sTitle.setText(streamtitle);
    txt_RA_sTitle.show();
}

void showLogoAndStationName() {
    showStationName();
    pic_RA_logo.setPicturePath(getLogoPath());
    pic_RA_logo.show();
    dispFooter.updateStation(s_cur_station);
    dispFooter.updateFlag(getFlagPath(s_cur_station));
    webSrv_send_station_items();
    return;
}

ps_ptr<char> getStationName() {
    ps_ptr<char> SN_utf8;
    ps_ptr<char> path;
    if (s_cur_station) {
        SN_utf8 = staMgnt.getStationName(s_cur_station);
    } else {
        SN_utf8 = s_stationName_air;
    }
    SN_utf8.trim();
    return SN_utf8;
}

ps_ptr<char> getLogoPath() {
    ps_ptr<char> path;
    ps_ptr<char> staName = getStationName();
    path = "/logo/" + staName + ".jpg";
    if (!SD_MMC.exists(scaleImage(path).c_get())) path = "/common/unknown.png";
    return path;
}

ps_ptr<char> getFlagPath(uint16_t station) {
    ps_ptr<char> flagPath;
    if (station == 0) {
        flagPath = "/flags/unknown.jpg";
        return flagPath;
    }
    flagPath.assign("/flags/");
    flagPath.appendf("{}", staMgnt.getStationCountry(station));
    flagPath.toLowerCase();
    flagPath.append(".jpg");
    return flagPath;
}

void webSrv_send_station_items() {
    ps_ptr<char> staNr;
    staNr.assignf("{}", s_cur_station);
    webSrv.send("stationLogo=", getLogoPath());
    webSrv.send("stationNr=", staNr);
    webSrv.send("stationURL=", s_settings.lastconnectedhost.get());
}

void showFileLogo(int8_t state, int8_t subState) {
    ps_ptr<char> logo;
    if (state == DLNA) {
        logo = "/common/DLNA.jpg";
        if (!SD_MMC.exists(scaleImage(logo).c_get())) logo = "/common/unknown.png";
        pic_DL_logo.setPicturePath(logo);
        pic_DL_logo.show();
        webSrv.send("stationLogo=", logo);
        return;
    }
    if (state == PLAYER) { // s_state PLAYER
        if (s_cur_Codec == 0) {
            logo = "/common/AudioPlayer.png";
        } else if (s_subState_player == 0) {
            logo = "/common/AudioPlayer.png";
        } else {
            logo = "/common/" + codecname[s_cur_Codec] + ".png";
        }
        if (!SD_MMC.exists(scaleImage(logo).c_get())) logo = "/common/unknown.png";
        pic_PL_logo.setPicturePath(logo);
        pic_PL_logo.show();
        return;
    }
    if (state == SETTINGS) {
        logo = "/common/Settings.png";
        pic_SE_logo.setPicturePath(logo);
        pic_SE_logo.show();
        return;
    }
    if (state == RINGING) {
        logo = "/common/Alarm.png";
        if (!SD_MMC.exists(scaleImage(logo).c_get())) logo = "/common/unknown.png";
        pic_RI_logo.setPicturePath(logo);
        pic_RI_logo.show();
        return;
    }
}

void showPlayerFileName(ps_ptr<char> fname) {
    if (!fname.valid()) return;
    txt_PL_fName.setTextColor(TFT_CYAN);
    txt_PL_fName.setText(fname);
    txt_PL_fName.show();
}

void show_DLNA_FileName(ps_ptr<char> fname) {
    if (!fname.valid()) return;
    txt_DL_fName.setTextColor(TFT_CYAN);
    txt_DL_fName.setText(fname);
    txt_DL_fName.show();
}

void showPlsFileNumber() {
    ps_ptr<char> buff;
    buff.assignf("{:03}/{:03}", s_plsCurPos, s_PLS_content.size());
    dispFooter.updateFileNr(buff);
}

void showAudioFileNumber() {
    ps_ptr<char> buff;
    buff.assignf("{:03}/{:03}", s_cur_AudioFileNr + 1, s_SD_content.getSize());
    dispFooter.updateFileNr(buff);
}

void display_sleeptime(int8_t ud) { // set sleeptimer
    if (ud == 1) {                  // up
        switch (s_sleeptime) {
            case 0 ... 14: s_sleeptime = (s_sleeptime / 5) * 5 + 5; break;
            case 15 ... 59: s_sleeptime = (s_sleeptime / 15) * 15 + 15; break;
            case 60 ... 359: s_sleeptime = (s_sleeptime / 60) * 60 + 60; break;
            default: s_sleeptime = 360; break; // max 6 hours
        }
    }
    if (ud == -1) { // down
        switch (s_sleeptime) {
            case 1 ... 15: s_sleeptime = ((s_sleeptime - 1) / 5) * 5; break;
            case 16 ... 60: s_sleeptime = ((s_sleeptime - 1) / 15) * 15; break;
            case 61 ... 360: s_sleeptime = ((s_sleeptime - 1) / 60) * 60; break;
            default: s_sleeptime = 0; break; // min
        }
    }
    otb_SL_stime.show(s_sleeptime);
}

boolean drawImage(ps_ptr<char> path, uint16_t posX, uint16_t posY, uint16_t maxWidth, uint16_t maxHeigth) {
    auto scImg = scaleImage(path);
    if (!SD_MMC.exists(scImg.c_get())) {
        if (scImg.index_of("/.", 0) > 0) return false; // empty filename
        printfln(s_tag.sd_card, ANSI_ESC_RED "file \"{}\" not found", scImg);
        return false;
    }
    if (scImg.ends_with("bmp")) { return getTFT().drawBmpFile(SD_MMC, scImg, posX, posY, maxWidth, maxHeigth, 1.0); }
    if (scImg.ends_with("jpg")) { return getTFT().drawJpgFile(SD_MMC, scImg, posX, posY, maxWidth, maxHeigth); }
    if (scImg.ends_with("gif")) { return getTFT().drawGifFile(SD_MMC, scImg, posX, posY, 0); }
    if (scImg.ends_with("png")) { return getTFT().drawPngFile(SD_MMC, scImg, posX, posY); }

    printfln(s_tag.action, ANSI_ESC_RED "the file \"{}\" contains neither a bmp, a gif, a png nor a jpg graphic", scImg);
    return false; // neither jpg nor bmp
}
/*****************************************************************************************************************************************************
 *                                                   H A N D L E  A U D I O F I L E                                                                  *
 *****************************************************************************************************************************************************/

boolean isAudio(ps_ptr<char> path) {
    if (path.ends_with(".mp3") ||  //
        path.ends_with(".aac") ||  //
        path.ends_with(".m4a") ||  //
        path.ends_with(".wav") ||  //
        path.ends_with(".flac") || //
        path.ends_with(".opus") || //
        path.ends_with(".ogg")) {
        return true;
    }
    return false;
}

/*****************************************************************************************************************************************************
 *                                                                     P L A Y L I S T                                                               *
 *****************************************************************************************************************************************************/

void processPlaylist() {
    if (playlist.get_size() == 0) {
        MWR_LOG_ERROR("playlist is empty");
        s_f_playlistEnabled = false;
        return;
    }

    while (true) {
        int idx = playlist.next_index();

        if (idx == -1) {
            printfln(s_tag.playlist, ANSI_ESC_YELLOW "end of playlist");
            webSrv.send("SD_playFile=", "end of playlist");
            s_f_playlistEnabled = false;
            changeState(PLAYER, 0);
            return;
        }

        if (idx == 0) {
            changeState(PLAYER, 1);
            txt_PL_fName.setText("");
            txt_PL_fName.show();
        }

        printfln(s_tag.playlist, ANSI_ESC_YELLOW "next playlist file");
        s_f_playlistEnabled = true;
        ps_ptr<char> path = playlist.get_file();

        // Web-URL
        if (path.starts_with_icase("http://") || path.starts_with_icase("https://")) {
            connecttohost(path);
            // Datei auf SD
        } else if (path.starts_with("/") && SD_MMC.exists(path.c_get())) {
            connecttoFS("SD_MMC", path);

            // Invalid entry
        } else {
            printfln(s_tag.playlist, ANSI_ESC_YELLOW "invalid playlist entry: {}", path);
            continue;
        }

        // Connection failed -> try the next entry
        if (!s_f_isFSConnected && !s_f_isWebConnected) {
            printfln(s_tag.playlist, ANSI_ESC_YELLOW "can't connect to {}", path);
            continue;
        }

        printfln(s_tag.playlist, ANSI_ESC_YELLOW "{}", path);
        webSrv.send("SD_playFile=", path);
        if (s_state == PLAYER) dispFooter.updateFileNr(playlist.get_coloured_index());
        txt_PL_fName.setText(playlist.get_items());
        txt_PL_fName.show();
        MWR_LOG_DEBUG("path {}, items {}", playlist.get_file(), playlist.get_items());
        return;
    }
}
// —————————————————————————————————————————————————————————————————————————————————————————————————————————————————————————————————————————————————————————————————————————————————————————————————————
// 📌📌📌  C O N N E C T   TO   W I F I   📌📌📌
// —————————————————————————————————————————————————————————————————————————————————————————————————————————————————————————————————————————————————————————————————————————————————————————————————————

bool connectToWiFi() {

    MWR_LOG_DEBUG("Connecting to WiFi...");
    ps_ptr<char> line(512);

    // create nvs entries if they do not exist
    if (!pref.isKey("wifiStr0")) pref.putString("wifiStr0", ""); // SSID + \t + PW
    if (!pref.isKey("wifiStr1")) pref.putString("wifiStr1", "");
    if (!pref.isKey("wifiStr2")) pref.putString("wifiStr2", "");
    if (!pref.isKey("wifiStr3")) pref.putString("wifiStr3", "");
    if (!pref.isKey("wifiStr4")) pref.putString("wifiStr4", "");
    if (!pref.isKey("wifiStr5")) pref.putString("wifiStr5", "");

    const char* SSID = _SSID;
    const char* PW = _PW;
    line = SSID;
    line += "\t";
    line += PW;
    pref.putString("wifiStr0", line.c_get());
    WiFi.mode(WIFI_STA);

    for (int i = 0; i < 6; i++) {
        line.clear(); // Move this line outside the switch statement
        switch (i) {
            case 0: line = pref.getString("wifiStr0").c_str(); break;
            case 1: line = pref.getString("wifiStr1").c_str(); break;
            case 2: line = pref.getString("wifiStr2").c_str(); break;
            case 3: line = pref.getString("wifiStr3").c_str(); break;
            case 4: line = pref.getString("wifiStr4").c_str(); break;
            case 5: line = pref.getString("wifiStr5").c_str(); break;
        }
        if (line.strlen() < 5) continue;  // line is empty
        int pos = line.index_of("\t", 0); // find first tab
        if (pos < 0) continue;            // no tab found
        line[pos] = '\0';                 // terminate ssid
        char* ssid = line.get();          // ssid is the first part
        char* pw = line.get() + pos + 1;  // password is the second part
        MWR_LOG_DEBUG("ssid {}", ssid);
        MWR_LOG_DEBUG("pw {}", pw);
        wifiMulti.addAP(ssid, pw); // SSID and PW in code"
        size_t offset = 0;
        size_t pwlen = strlen(pw);
        size_t dot_len = strlen(emoji.blueCircle); // = 4
        size_t buf_size = pwlen * dot_len + 1;     // +1 für '\0'
        if (buf_size > 512) {
            MWR_LOG_ERROR("Password display buffer too large: {} bytes", buf_size);
            continue;
        }
        ps_ptr<char> pass;
        pass.alloc(buf_size);
        char* pass_dst = pass.get();
        if (!pass_dst) {
            MWR_LOG_ERROR("Password display buffer allocation failed");
            continue;
        }
        for (size_t j = 0; j < pwlen; j++) {
            if (offset + dot_len > buf_size - 1) {
                MWR_LOG_ERROR("Buffer overflow in password masking");
                break;
            }
            memcpy(pass_dst + offset, emoji.blueCircle, dot_len);
            offset += dot_len;
        }
        pass_dst[offset] = '\0'; // Zero-terminate the string
        printfln(s_tag.wifi_info, "add credentials: " ANSI_ESC_YELLOW "{} - {}" ANSI_ESC_RESET " [{}:{}]", ssid, pass_dst, __FILENAME__, __LINE__);
    }

    // These options can help when you need ANY kind of wifi connection to get a config file, report errors, etc.
    wifiMulti.setStrictMode(true); // Default is true.  Library will disconnect and forget currently connected AP if it's not in the AP list.
    printfln(s_tag.wifi_info, ANSI_ESC_GREEN "Connecting WiFi...");

    // Configure before connecting to avoid timing issues during the handshake:
    WiFi.setSleep(false); // disable modem power-save, reduces latency/jitter for audio streaming and web/websocket responsiveness
    if (WIFI_TX_POWER >= 2 && WIFI_TX_POWER <= 21) { WiFi.setTxPower((wifi_power_t)(WIFI_TX_POWER * 4)); }

    wifiMulti.run();

    if (wifiMulti.run() != WL_CONNECTED) {
        int i = 0;
        while (WiFi.status() != WL_CONNECTED) {
            vTaskDelay(1000);
            i++;
            if (i > 25) break; // Timeout to 25 seconds for multi-AP scans
        }
    }

    if (WiFi.status() != WL_CONNECTED) {
        printfln(s_tag.wifi_info, ANSI_ESC_RED "WiFi credentials are not correct");
        return false;
    }
    printfln(s_tag.wifi_info, ANSI_ESC_GREEN "WiFi connected");
    s_myIP = WiFi.localIP().toString().c_str();

    vTaskDelay(1000);

    printfln(s_tag.wifi_info,
             "connected to " ANSI_ESC_YELLOW "{}" ANSI_ESC_RESET ", IP address is " ANSI_ESC_ORANGE "{}" ANSI_ESC_RESET ", Received Signal Strength " ANSI_ESC_CYAN "{}" ANSI_ESC_RESET " dB",
             WiFi.SSID().c_str(), s_myIP, WiFi.RSSI());

    return true; // can't connect to any network
}
// ——————————————————————————————————————————————————————————————————————————————————————————————————————————————————————————————————————————————————————————————————————————————————————————————————————
// OTA updates fail intermittently ("timed out" after only a few KB) when loop() keeps servicing audio, FTP, DLNA, TFT,
// meteo, IR etc. in between calls to ArduinoOTA.handle(). Any one of these can block for a while (SD_MMC access, SPI
// draw, network I/O) and delay reading the incoming update stream past espota's per-chunk timeout. The callbacks below
// pause all non-essential subsystems for the duration of the transfer so loop() can dedicate the core to OTA alone
// (see s_f_otaRunning handling in loop()).
void setupOTA() {
    ArduinoOTA.setHostname("MiniWebRadio");
    ArduinoOTA.onStart([]() {
        s_f_otaRunning = true;
        ticker100ms.detach(); // stop the 100ms ISR, it has no benefit during OTA and only adds jitter
        audio.stopSong();     // release I2S/decoder and stop consuming WiFi/SD bandwidth
        printfln(s_tag.setup, ANSI_ESC_YELLOW "OTA update started, pausing radio, FTP, DLNA and display" ANSI_ESC_RESET);
    });
    ArduinoOTA.onEnd([]() { printfln(s_tag.setup, ANSI_ESC_GREEN "OTA update finished, rebooting" ANSI_ESC_RESET); });
    ArduinoOTA.onProgress([](uint32_t progress, uint32_t total) {
        static uint8_t lastPercent = 255;
        uint8_t        percent = total ? (progress * 100) / total : 0;
        if (percent != lastPercent) {
            lastPercent = percent;
            printfln(s_tag.setup, "OTA progress: " ANSI_ESC_CYAN "{}%", percent);
        }
    });
    ArduinoOTA.onError([](ota_error_t error) {
        s_f_otaRunning = false;
        ticker100ms.attach(0.1, timer100ms); // restore normal operation after a failed attempt
        printfln(s_tag.setup, ANSI_ESC_RED "OTA error [{}], resuming normal operation", (int)error);
    });
}
// ——————————————————————————————————————————————————————————————————————————————————————————————————————————————————————————————————————————————————————————————————————————————————————————————————————
void setWiFiCredentials(ps_ptr<char> ssid, ps_ptr<char> password) {
    if (ssid.strlen() < 5) return; // min length

    MWR_LOG_ERROR("ssid {} pw {}", ssid, password);

    ps_ptr<char> line = "";
    ps_ptr<char> credentials;
    int          i = 0, state = 0;

    for (i = 0; i < 6; i++) {
        switch (i) {
            case 0: line = pref.getString("wifiStr0").c_str(); break;
            case 1: line = pref.getString("wifiStr1").c_str(); break;
            case 2: line = pref.getString("wifiStr2").c_str(); break;
            case 3: line = pref.getString("wifiStr3").c_str(); break;
            case 4: line = pref.getString("wifiStr4").c_str(); break;
            case 5: line = pref.getString("wifiStr5").c_str(); break;
        }
        if (line.starts_with(ssid) && line[ssid.strlen()] == '\t') { // ssid found
            if (password.strlen() == 0) {
                credentials = "\t"; // delete ssid and password
            } else {                // update password
                credentials = ssid;
                credentials += "\t";
                credentials += password;
            }
            if (i == 0) {
                MWR_LOG_ERROR("password can't changed, is hard coded");
                state = 0;
                goto exit;
            }
            if (i == 1) {
                pref.putString("wifiStr1", credentials.get());
                state = 1;
                goto exit;
            }
            if (i == 2) {
                pref.putString("wifiStr2", credentials.get());
                state = 1;
                goto exit;
            }
            if (i == 3) {
                pref.putString("wifiStr3", credentials.get());
                state = 1;
                goto exit;
            }
            if (i == 4) {
                pref.putString("wifiStr4", credentials.get());
                state = 1;
                goto exit;
            }
            if (i == 5) {
                pref.putString("wifiStr5", credentials.get());
                state = 1;
                goto exit;
            }
        }
    }
    for (i = 1; i < 6; i++) {
        line.clear();
        switch (i) {
            case 1: line = pref.getString("wifiStr1").c_str(); break;
            case 2: line = pref.getString("wifiStr2").c_str(); break;
            case 3: line = pref.getString("wifiStr3").c_str(); break;
            case 4: line = pref.getString("wifiStr4").c_str(); break;
            case 5: line = pref.getString("wifiStr5").c_str(); break;
        }
        if (line.strlen() < 5) { // line is empty
            credentials = ssid;
            credentials += "\t";
            credentials += password;
            if (i == 1) {
                pref.putString("wifiStr1", credentials.get());
                state = 2;
                goto exit;
            }
            if (i == 2) {
                pref.putString("wifiStr2", credentials.get());
                state = 2;
                goto exit;
            }
            if (i == 3) {
                pref.putString("wifiStr3", credentials.get());
                state = 2;
                goto exit;
            }
            if (i == 4) {
                pref.putString("wifiStr4", credentials.get());
                state = 2;
                goto exit;
            }
            if (i == 5) {
                pref.putString("wifiStr5", credentials.get());
                state = 2;
                goto exit;
            }
        }
    }
    state = 3;

exit:
    if (state == 0) { printfln(s_tag.wifi_info, ANSI_ESC_RED "SSID: {} password can't changed, it is hard coded", ssid); }
    if (state == 1) { printfln(s_tag.wifi_info, ANSI_ESC_GREEN "The passord \"{}\" for the SSID: {} has been changed", password, ssid); }
    if (state == 2) { printfln(s_tag.wifi_info, ANSI_ESC_GREEN "The SSID: {} has been added", ssid); }
    if (state == 3) { printfln(s_tag.wifi_info, ANSI_ESC_RED "No more memory to save the credentials for: {}", ssid); }
    return;
}

/*****************************************************************************************************************************************************
 *                                                                     A U D I O                                                                     *
 *****************************************************************************************************************************************************/
void connecttohost(ps_ptr<char> host) {
    int32_t      idx1, idx2;
    ps_ptr<char> url;
    ps_ptr<char> user;
    ps_ptr<char> pwd;

    spectrum_RA.clear();
    s_cur_Codec = 0;
    //    if(s_state == RADIO) clearStreamTitle();
    s_icyBitRate = 0;
    s_f_newBitRate = true;
    s_decoderBitRate = 0;
    s_f_webFailed = false;
    s_f_isFSConnected = false;
    idx1 = host.index_of("|", 0);
    if (idx1 == -1) { // no pipe found
        s_f_isWebConnected = audio.connecttohost(host.c_get());

        if (!s_f_isWebConnected) {
            s_cthFailCounter++;
        } else {
            (s_cthFailCounter = 0);
        }
    } else { // pipe found     e.g. http://xxx.com/ext|user|pw
        idx2 = host.index_of("|", idx1 + 1);
        // MWR_LOG_INFO("idx2 = {}", idx2);
        if (idx2 == -1) { // second pipe not found
            s_f_isWebConnected = audio.connecttohost(host.c_get());

            if (!s_f_isWebConnected) {
                s_cthFailCounter++;
            } else {
                (s_cthFailCounter = 0);
            }
        } else {                     // extract url, user, pwd
            url = host.substr(idx1); // extract url
            user = host.substr(idx1 + 1, idx2 - idx1 - 1);
            pwd = host.substr(idx2 + 1);
            printfln(s_tag.new_host, ANSI_ESC_YELLOW "\"{}\"" ANSI_ESC_RESET ", user: " ANSI_ESC_YELLOW "\"{}\"" ANSI_ESC_RESET ", pwd: " ANSI_ESC_YELLOW "\"{}\"", url, user, pwd);
            s_f_isWebConnected = audio.connecttohost(url.c_get(), user.c_get(), pwd.c_get());
        }
    }
    if (s_cthFailCounter >= 3) {
        audio.connecttospeech("The last hosts were not connected", "en");
        s_settings.lastconnectedhost.assign("");
    }
}
void connecttoFS(const char* FS, ps_ptr<char> filename, uint32_t fileStartTime) {
    if (!filename) return;
    spectrum_RA.clear();
    s_icyBitRate = 0;
    s_f_newBitRate = true;
    s_decoderBitRate = 0;
    s_cur_Codec = 0;
    s_f_webFailed = false;
    s_f_isFSConnected = audio.connecttoFS(SD_MMC, filename.c_get(), fileStartTime);
    s_f_isWebConnected = false;
    if (!filename.starts_with("/audiofiles/")) { return; }
    if (s_f_isFSConnected && isAudio(filename)) {
        s_settings.lastconnectedfile = filename;
        s_SD_content.setLastConnectedFile(filename);
        s_cur_AudioFolder = s_SD_content.getLastConnectedFolder();
        s_cur_AudioFileName = s_SD_content.getLastConnectedFileName();
        s_cur_AudioFileNr = s_SD_content.getPosByFileName(s_cur_AudioFileName);
        if (s_cur_AudioFileNr == -1) s_cur_AudioFileNr = 0;
    }
    MWR_LOG_DEBUG("Filesize {}", audio.getFileSize());
    MWR_LOG_DEBUG("FilePos {}", audio.getAudioFilePosition());
}
void stopSong() {
    audio.stopSong();
    spectrum_RA.clear();
    s_f_isFSConnected = false;
    s_f_isWebConnected = false;
    if (s_f_playlistEnabled) {
        s_PLS_content.clear();
        s_f_playlistEnabled = false;
        printfln(s_tag.playlist, ANSI_ESC_YELLOW "playlist stopped");
        webSrv.send("SD_playFile=", "playlist stopped");
    }
    s_f_pauseResume = false;
    s_f_playlistNextFile = false;
}

// —————————————————————————————————————————————————————————————————————————————————————————————————————————————————————————————————————————————————————————————————————————————————————————————————————
// 📌📌📌  C O M M O N  📌📌📌
// —————————————————————————————————————————————————————————————————————————————————————————————————————————————————————————————————————————————————————————————————————————————————————————————————————

static bool i2c_read_reg(TwoWire* twi, uint8_t addr, uint8_t reg, uint8_t& value) {
    twi->beginTransmission(addr);
    twi->write(reg);
    if (twi->endTransmission(false) != 0) return false;
    if (twi->requestFrom((uint16_t)addr, (uint8_t)1, (uint8_t)true) != 1) return false;
    if (!twi->available()) return false;
    value = twi->read();
    return true;
}

static bool i2c_looks_like_es8311(TwoWire* twi, uint8_t addr) {
    uint8_t r00 = 0, r01 = 0, r02 = 0, r03 = 0;
    if (!i2c_read_reg(twi, addr, 0x00, r00)) return false; // master or slave mode
    log_d("r00 %i", r00);                                  // 0x1F = reset to default = csm power down. slave mode
    if (!i2c_read_reg(twi, addr, 0x01, r01)) return false; // clock manager
    log_d("r01 %i", r01);                                  // 0x00 = default clock from MCLK, normal, OFF.   0x0100 = From MCLK, MCLK invert, MCLK off
    if (!i2c_read_reg(twi, addr, 0x02, r02)) return false; // internal master clock default 0
    log_d("r02 %i", r02);                                  // 0x00 default = dig_mclk=mclk_prediv*1
    if (!i2c_read_reg(twi, addr, 0x03, r03)) return false; // ADC clock manager default 0x10
    log_d("r03 %i", r03);                                  // 0x10 = default
    // bool res = (0x1F == r00 && 0x00 == r01 && 0xF0 == r02 && 0x10 == r03);
    // bool res = (0x80 == r00 && 0x3F == r01 && 0x00 == r02 && 0x10 == r03);  // modified based on what was observed durintg i2c bus scan.
    return true;
}

bool detect_i2_c_devices(TwoWire* twi, int8_t sda, int8_t scl, i2c_items_s* i2c_items) {
    if (sda < 0) return false;
    if (scl < 0) return false;
    if (sda == scl) return false;
    twi->end();
    twi->flush();
    twi->begin(sda, scl, 100000);
    uint8_t arr[128] = {0};

    for (uint8_t i = 0; i < 128; i++) {
        twi->beginTransmission(i);
        if (twi->endTransmission() == 0) arr[i] = 1;
    }

    for (uint8_t addr = 0; addr < 128; addr++) {
        if (arr[addr]) {
            //-- CH422G  I/O Extended (Digital Tube Display Drive) ----------------------------------------------------------------------------------------------------------
            if (addr == 0x20) {
                if (arr[0x21] && arr[0x22] && arr[0x23] && arr[0x24] && arr[0x25] && arr[0x26] && arr[0x27]) {
                    for (int i = 0x20; i < 0x28; i++) arr[i] = 0;
                    for (int i = 0x30; i < 0x40; i++) arr[i] = 0;
                    i2c_items->ch422g_found = true;
                    i2c_items->ch422g_addr = 0x20;
                    printfln(s_tag.setup, "CH422G (I/O Extended) found at " ANSI_ESC_CYAN "0x{:X}-0x{:X}, 0x{:X}-0x{:X}", 0x20, 0x27, 0x30, 0x3F);
                    continue;
                }
            }
            //-- ES8311 Mono DAC ----------------------------------------------------------------------------------------------------------
            if (addr == 0x18 || addr == 0x19) {
                if (i2c_looks_like_es8311(twi, addr)) {
                    i2c_items->es8311_found = true;
                    i2c_items->es8311_addr = 0x18;
                    printfln(s_tag.setup, "es8311 (Mono Audio Codec) found at " ANSI_ESC_CYAN "0x{:X}", 0x18);
                    continue;
                }
            }
            //-- GT911 Touch Controller ----------------------------------------------------------------------------------------------------------
            if (addr == 0x14 || addr == 0x5D) {
                i2c_items->gt911_found = true;
                i2c_items->gt911_addr = addr;
                printfln(s_tag.setup, "gt911 (Capacitive Touch Controller) found at " ANSI_ESC_CYAN "0x{:X}", addr);
                continue;
            }
            //-- BH1750 --------------------------------------------------------------------------------------------------------------------------
            if (addr == 0x23 || addr == 0x5C) {
                i2c_items->bh1750_found = true;
                i2c_items->bh1750_addr = addr;
                printfln(s_tag.setup, "BH1750 (digital Ambient Light Sensor) found at " ANSI_ESC_CYAN "0x{:X}", addr);
                continue;
            }
            //-- FT6X36U -------------------------------------------------------------------------------------------------------------------------
            if (addr == 0x38) {
                i2c_items->ft6x36u_found = true;
                i2c_items->ft6x36u_addr = addr;
                printfln(s_tag.setup, "ft6x36u (Capacitive Touch Controller) found at " ANSI_ESC_CYAN "0x{:X}", addr);
                continue;
            }
            //-- ES7210 Codec --------------------------------------------------------------------------------------------------------------------
            if (addr == 0x40) {
                i2c_items->es7210_found = true;
                i2c_items->es7210_addr = addr;
                printfln(s_tag.setup, "es7210 (Four Channels Audio ADC) found at " ANSI_ESC_CYAN "0x{:X}", addr);
                continue;
            }
            //-- TCA9554 port expander -----------------------------------------------------------------------------------------------------------
            if (addr == 0x20) {
                i2c_items->tca9554_found = true;
                i2c_items->tca9554_addr = addr;
                printfln(s_tag.setup, "TCA9554 (8 Channel Port Expander) found at " ANSI_ESC_CYAN "0x{:X}", addr);
                continue;
            }
            //-- Unknown Device  ------------------------------------------------------------------------------------------------------------------
            MWR_LOG_WARN("unknown i2c device at 0x{:X} found", addr);
        }
    }
    return true;
}
//---------------------------------------------------------------------------------------

void set_tft_items() {
//---- LAYOUT -----------
#ifdef TFT_LAYOUT_S
    s_h_resolution = 320;
    s_v_resolution = 240;
#elifdef TFT_LAYOUT_M
    s_h_resolution = 480;
    s_v_resolution = 320;
#elifdef TFT_LAYOUT_L
    s_h_resolution = 800;
    s_v_resolution = 480;
#elifdef TFT_LAYOUT_XL
    s_h_resolution = 1024;
    s_v_resolution = 600;
#endif

//---- TFT_MODE ---------
#ifdef TFT_MODE_SPI
    spiBus.begin(TFT_SCK, TFT_MISO, TFT_MOSI, -1); // SPI1 for TFT
    getTFT().setTFTcontroller(TFT_CONTROLLER);
    getTFT().setRotation(TFT_ROTATION);
    getTFT().setDisplayInversion(DISPLAY_INVERSION);
    getTFT().begin(TFT_DC); // Init TFT interface
    getTFT().setFrequency(TFT_FREQUENCY);
    getTFT().setBackGoundColor(TFT_BLACK);
#elifdef TFT_MODE_RGB
    getTFT().begin(RGB_PINS, RGB_TIMING);
    getTFT().setDisplayInversion(false);
    getTFT().setRotation(TFT_ROTATION);
    vTaskDelay(100 / portTICK_PERIOD_MS); // wait for TFT to be ready
    getTFT().reset();
    vTaskDelay(100 / portTICK_PERIOD_MS); // wait for TFT to be ready
#elifdef TFT_MODE_DSI
    getTFT().begin(DSI_TIMING);
    getTFT().setRotation(TFT_ROTATION);
    getTFT().setDisplayInversion(DISPLAY_INVERSION);
    vTaskDelay(100 / portTICK_PERIOD_MS); // wait for TFT to be ready
#endif
}

void set_tp_items() {
//---- TP_MODE ---------
#ifdef TP_MODE_XPT2046 // XPT2046
    getTP().begin(TP_IRQ, s_h_resolution, s_v_resolution);
    getTP().setSize(TP_CONTROLLER); // (0) 2.8 inch, (1) 3.5 inch, (4) 4.0 inch
    getTP().setRotation(TP_ROTATION);
    getTP().setMirror(TP_H_MIRROR, TP_V_MIRROR);
#elifdef TP_MODE_GT911  // GT911
    getTP().begin(&i2cBusOne, s_i2c_items.gt911_addr, s_h_resolution, s_v_resolution);
    getTP().setRotation(TP_ROTATION);
    getTP().setMirror(TP_H_MIRROR, TP_V_MIRROR);
#elifdef TP_MODE_FT6X63 // FT6x36
    getTP().begin(&i2cBusOne, 0x38, s_h_resolution, s_v_resolution);
    getTP().get_FT6x36_items();
    getTP().setRotation(TP_ROTATION);
    getTP().setMirror(TP_H_MIRROR, TP_V_MIRROR);
#endif
}

//---------------------------------------------------------------------------------------
bool init_SD_card() {
    printfln(s_tag.sd_card, "Init SD card");
    pinMode(SD_MMC_D0, INPUT_PULLUP);
    int32_t sdmmc_frequency = SDMMC_FREQUENCY / 1000; // MHz -> KHz, default is 40MHz
#ifdef CONFIG_IDF_TARGET_ESP32S3
    SD_MMC.setPins(SD_MMC_CLK, SD_MMC_CMD, SD_MMC_D0);
    s_f_sd_card_found = SD_MMC.begin("/sdcard", true, false, sdmmc_frequency);
#elifdef CONFIG_IDF_TARGET_ESP32S31
    if (SD_MMC_D1 == -1) {
        SD_MMC.setPins(SD_MMC_CLK, SD_MMC_CMD, SD_MMC_D0);                         // pins are not changeable
        s_f_sd_card_found = SD_MMC.begin("/sdcard", true, false, sdmmc_frequency); // mode1bit
    } else {
        SD_MMC.setPins(SD_MMC_CLK, SD_MMC_CMD, SD_MMC_D0, SD_MMC_D1, SD_MMC_D2, SD_MMC_D3);
        s_f_sd_card_found = SD_MMC.begin("/sdcard", false, false, sdmmc_frequency); // mode4bit
    }
#elifdef CONFIG_IDF_TARGET_ESP32P4
    if (SD_MMC_D1 == -1) {
        SD_MMC.setPins(SD_MMC_CLK, SD_MMC_CMD, SD_MMC_D0);
        s_f_sd_card_found = SD_MMC.begin("/sdcard", true, false, sdmmc_frequency); // mode1bit
    } else {
        SD_MMC.setPins(SD_MMC_CLK, SD_MMC_CMD, SD_MMC_D0, SD_MMC_D1, SD_MMC_D2, SD_MMC_D3);
        s_f_sd_card_found = SD_MMC.begin("/sdcard", false, false, sdmmc_frequency); // mode4bit
    }
#endif
    if (!s_f_sd_card_found) {
        clearAll(TFT_BLACK);
        getTFT().setFontSize(displayConfig.fonts[6]);
        getTFT().setTextColor(TFT_YELLOW);
        getTFT().writeText("SD Card Mount Failed", 0, 50, displayConfig.dispWidth, displayConfig.dispHeight, HAlign::Center, VAlign::Middle, false, true);
        printfln(s_tag.sd_card, ANSI_ESC_RED "SD Card Mount Failed");
        return false;
    }
    float cardSize = ((float)SD_MMC.cardSize()) / (1024 * 1024);
    float freeSize = ((float)SD_MMC.cardSize() - SD_MMC.usedBytes()) / (1024 * 1024);
    printfln(s_tag.sd_card, "SD card found, " ANSI_ESC_CYAN "{:.1}" ANSI_ESC_RESET " MB by " ANSI_ESC_CYAN "{:.1} " ANSI_ESC_RESET "MB free", freeSize, cardSize);
    return true;
}

//---------------------------------------------------------------------------------------

ps_ptr<char> scaleImage(ps_ptr<char> path) {
    if (path.strlen() == 0) return "/common/unknown.png";
    bool ok = false;
    if (path.ends_with("bmp")) ok = true;
    if (path.ends_with("jpg")) ok = true;
    if (path.ends_with("gif")) ok = true;
    if (path.ends_with("png")) ok = true;
    if (path.starts_with("/png")) ok = false; // is web button
    MWR_LOG_DEBUG("path {}", path);
    if (!ok) return path;

    int idx = path.index_of('/', 1);
    if (idx < 0) return path; // invalid path
    ps_ptr<char> tfts = displayConfig.tftSize;
    tfts += "/";
    path.insert(tfts, idx + 1); // "/logo/0N 90s.jpg" --> "/logo/s/0N 90s.jpg"
    MWR_LOG_DEBUG("path {}", path);
    return path;
}

void setVolume(uint8_t vol) {
    static int16_t oldVol = -1;
    if (vol == oldVol) return;
    MWR_LOG_DEBUG("volume old: {}. new: {}", oldVol, vol);
    s_volume.cur_volume = vol;
    oldVol = vol;
    dispHeader.updateVolume(s_volume.cur_volume);
    sdr_CL_volume.setValue(s_volume.cur_volume);
    sdr_DL_volume.setValue(s_volume.cur_volume);
    sdr_PL_volume.setValue(s_volume.cur_volume);
    sdr_RA_volume.setValue(s_volume.cur_volume);
    sdr_WR_volume.setValue(s_volume.cur_volume);
    printfln(s_tag.action, "current volume is " ANSI_ESC_CYAN "{}", s_volume.cur_volume);
}

uint8_t downvolume() {
    uint8_t steps = s_volume.volumeSteps / 20;
    if (s_volume.cur_volume == 0)
        return s_volume.cur_volume;
    else if (steps < s_volume.cur_volume)
        s_volume.cur_volume -= steps;
    else
        s_volume.cur_volume--;
    sdr_CL_volume.setValue(s_volume.cur_volume);
    sdr_DL_volume.setValue(s_volume.cur_volume);
    sdr_PL_volume.setValue(s_volume.cur_volume);
    sdr_RA_volume.setValue(s_volume.cur_volume);
    sdr_WR_volume.setValue(s_volume.cur_volume);
    s_f_mute = false;
    muteChanged(s_f_mute); // set mute off
    return s_volume.cur_volume;
}

uint8_t upvolume() {
    uint8_t steps = s_volume.volumeSteps / 20;
    if (s_volume.cur_volume == s_volume.volumeSteps) {
        return s_volume.cur_volume;
    } else if (s_volume.volumeSteps > s_volume.cur_volume + steps) {
        s_volume.cur_volume += steps;
    } else {
        s_volume.cur_volume++;
    }
    sdr_CL_volume.setValue(s_volume.cur_volume);
    sdr_DL_volume.setValue(s_volume.cur_volume);
    sdr_PL_volume.setValue(s_volume.cur_volume);
    sdr_RA_volume.setValue(s_volume.cur_volume);
    sdr_WR_volume.setValue(s_volume.cur_volume);
    s_f_mute = false;
    muteChanged(s_f_mute); // set mute off
    return s_volume.cur_volume;
}

void setStation(ps_ptr<char> url, ps_ptr<char> extension) {
    if (!url.valid()) {
        MWR_LOG_ERROR("url is empty");
        return;
    }
    // e.g.  http://lstn.lv/bbcradio.m3u8?station=bbc_radio_one&bitrate=96000
    // url is http://lstn.lv/bbcradio.m3u8?station=bbc_radio_one, extension is bitrate=96000
    s_stationName_air = url;
    if (extension.strlen()) url.appendf("&{}", extension);
    s_stationURL = url;
    s_cur_station = 0;
    setStation(0);
}

void setStation(uint16_t sta) {
    if (sta == 0) {
        connecttohost(s_stationURL);
        s_stationName_air = s_stationURL;
    } else {
        if (sta > staMgnt.getSumStations()) sta = s_cur_station;
        s_stationURL = staMgnt.getStationUrl(sta);
        connecttohost(s_stationURL);
    }
    printfln(s_tag.action, "switch to station " ANSI_ESC_CYAN "{}", sta);
    printfln(s_tag.country, "Country of origin " ANSI_ESC_YELLOW "{}", staMgnt.getStationCountry(s_cur_station));
    s_homepage.reset();
    s_streamTitle.reset();
    s_icyDescription.reset();
    ;
    clearArea2();
    s_f_newStreamTitle = true;
    s_f_newIcyDescription = true;
    showLogoAndStationName();
}

void nextStation() {
    setStation(staMgnt.nextStation());
}
void nextFavStation() {
    setStation(staMgnt.nextFavStation());
}
void prevStation() {
    setStation(staMgnt.prevStation());
}
void prevFavStation() {
    setStation(staMgnt.prevFavStation());
}
void setStationByNumber(uint16_t staNr) {
    setStation(staMgnt.setStationByNumber(staNr));
}

void savefile(ps_ptr<char> fileName, uint32_t contentLength, ps_ptr<char> contentType) { // save the uploadfile on SD_MMC

    if (!fileName.starts_with("/")) { fileName = "/" + fileName; }
    if (webSrv.uploadfile(SD_MMC, fileName, contentLength, contentType)) {
        printfln(s_tag.sd_card, "save file " ANSI_ESC_CYAN "{}", fileName);
        webSrv.sendStatus(200);
    } else {
        printfln(s_tag.sd_card, "save file " ANSI_ESC_CYAN "{}" ANSI_ESC_RESET " to SD failed", fileName);
        webSrv.sendStatus(400);
    }
}

void saveImage(ps_ptr<char> fileName, uint32_t contentLength) { // save the jpg image on SD_MMC
    ps_ptr<char> fn;

    if (fileName.ends_with("jpg")) {
        fn.assign("/logo/");
        fn.append(displayConfig.tftSize);
        if (!fileName.starts_with("/")) fn.append("/");
        fn.append(fileName);
        if (webSrv.uploadB64image(SD_MMC, fn, contentLength)) {
            printfln(s_tag.sd_card, "save image (jpg) " ANSI_ESC_YELLOW "{}" ANSI_ESC_RESET " to SD card was successfully", fn);
            webSrv.sendStatus(200);
        } else
            webSrv.sendStatus(400);
    }
}

void setI2STone() {
    audio.setTone(s_tone.LP, s_tone.BP, s_tone.HP);
    audio.setBalance(s_tone.BAL);
    return;
}

ps_ptr<char> getI2STone() {
    ps_ptr<char> tone;
    tone.assignf("LowPass={}\nBandPass={}\nHighPass={}\nBalance={}\n", s_tone.LP, s_tone.BP, s_tone.HP, s_tone.BAL);
    return tone;
}

void SD_playFile(ps_ptr<char> pathWoFileName, ps_ptr<char> fileName) { // pathWithoutFileName e.g. /audiofiles/playlist/
    pathWoFileName += fileName;
    int32_t idx = pathWoFileName.index_of("\033[", 1);
    if (idx == -1) { // do nothing
        SD_playFile(pathWoFileName, 0, true);
        return;
    }
    SD_playFile(pathWoFileName.substr(0, idx), 0, true); // remove color and filesize
    return;
}

void SD_playFile(ps_ptr<char> path, uint32_t fileStartTime, bool showFN) {
    if (!path.valid()) return; // avoid a possible crash

    if (path.ends_with("m3u")) {
        if (playlist.create_playlist_from_file(path)) s_f_playlistEnabled = true;
        return;
    }

    ps_ptr<char> file_name;

    if (s_subState_player != 1) { changeState(PLAYER, 1); }
    int32_t idx = path.last_index_of('/');
    if (idx < 0) return;
    s_cur_AudioFolder = path.substr(0, idx);
    file_name = path.substr(idx + 1); // without '/'

    if (showFN) {
        clearLogo();
        showPlayerFileName(file_name);
    }

    printfln(s_tag.file_name, ANSI_ESC_MAGENTA "{}", file_name);
    connecttoFS("SD_MMC", path, fileStartTime);
    if (s_f_playlistEnabled) showPlsFileNumber();
    if (s_f_isFSConnected) { s_settings.lastconnectedfile = path; }
}

bool SD_rename(ps_ptr<char> src, ps_ptr<char> dest) {
    bool success = false;
    if (SD_MMC.exists(src.c_get())) { success = SD_MMC.rename(src.c_get(), dest.c_get()); }
    return success;
}

bool SD_newFolder(ps_ptr<char> folderPathName) {
    bool success = false;
    success = SD_MMC.mkdir(folderPathName.c_get());
    return success;
}

bool SD_delete(ps_ptr<char> itemPath) {
    bool success = false;
    if (SD_MMC.exists(itemPath.c_get())) {
        File dirTest = SD_MMC.open(itemPath.c_get(), "r");
        bool isDir = dirTest.isDirectory();
        dirTest.close();
        if (isDir)
            success = SD_MMC.rmdir(itemPath.c_get());
        else
            success = SD_MMC.remove(itemPath.c_get());
    }
    return success;
}

void fall_asleep() {
    s_f_sleeping = true;
    muteChanged(true);
    s_f_playlistEnabled = false;
    s_f_isFSConnected = false;
    s_f_isWebConnected = false;
    audio.stopSong();
    if (s_sleepMode == 0) { changeState(SLEEP, 0); }
    if (s_sleepMode == 1) { changeState(SLEEP, 1); }
    if (s_sleepMode == 2) { changeState(SLEEP, 2); }

    if (s_bt_emitter.found) bt_emitter.power_off();
    printfln(s_tag.action, "falling asleep");
}

void wake_up(int8_t state, int8_t subState) {
    s_f_sleeping = false;
    if (s_bt_emitter.found && s_bt_emitter.enabled) bt_emitter.power_on(s_bt_emitter.mode);
    muteChanged(false);
    printfln(s_tag.action, "awake");
    clearAll(TFT_BG_IS_WALLPAPER);
    clk_CL_24.hide();
    setTFTbrightness(s_brightness);
    dispHeader.set_bg_color(TFT_BG_IS_WALLPAPER);
    dispFooter.set_bg_color(TFT_BG_IS_WALLPAPER);
    dispHeader.show();
    dispFooter.show();
    changeState(state, subState);
    if(state == RADIO) {
        showLogoAndStationName();
        s_f_newStreamTitle = true;
    }
}

void setRTC(ps_ptr<char> TZString) {
    rtc.stop();
    rtc.begin(TZString);
}

ps_ptr<char> getTZString(ps_ptr<char> s_TZName) { // the settings keep the TZ string of the day the zone was selected, take the current one from timezones_json
    ps_ptr<char> key;
    ps_ptr<char> tzString = "CET-1CEST,M3.5.0,M10.5.0/3";
    key.assignf("[\"{}\",\"", s_TZName);
    const char* p = strstr(timezones_json, key.c_get());
    if (!p) return tzString; // zone not in the list, return default
    p += key.strlen();
    const char* e = strchr(p, '"');
    if (!e || e == p) return tzString; // return default
    tzString.assign(p, e - p);
    return tzString;
}

boolean isAlarm(uint8_t weekDay, uint8_t alarmDays, uint16_t minuteOfTheDay, int16_t* alarmTime) {
    uint8_t mask = 0b00000001 << weekDay;
    if (alarmDays & mask) {                         // yes, is alarmDay
        if (alarmTime[weekDay] == minuteOfTheDay) { // yes, is alarmTime
            return true;
        }
    }
    return false;
}

boolean copySDtoFFat(const char* path) {
    if (!s_f_FFatFound) return false;
    uint8_t buffer[1024];
    size_t  r = 0, w = 0;
    size_t  len = 0;
    File    file1 = SD_MMC.open(path, "r");
    File    file2 = FFat.open(path, "w");
    while (true) {
        r = file1.read(buffer, 1024);
        w = file2.write(buffer, r);
        if (r != w) {
            file1.close();
            file2.close();
            FFat.remove(path);
            return false;
        }
        len += r;
        if (r == 0) break;
    }
    MWR_LOG_DEBUG("file length {}, written {}", file1.size(), len);
    if (file1.size() == len) return true;
    return false;
}

void muteChanged(bool m) {
    s_f_muteIsPressed = false;
    btn_CL_mute.setValue(m);
    btn_DL_mute.setValue(m);
    btn_EQ_mute.setValue(m);
    btn_PL_mute.setValue(m);
    btn_RA_mute.setValue(m);
    btn_WR_mute.setValue(m);
    if (m) {
        s_f_mute = true;
        if (AMP_ENABLED != -1) {
            if (AMP_EN_INVERSION == 0) {
                digitalWrite(AMP_ENABLED, LOW);
            } else {
                digitalWrite(AMP_ENABLED, HIGH);
            }
            printfln(s_tag.action, "mute, On Board Amplifier is off");
        }
        webSrv.send("mute=", "1");
    } else {
        s_f_mute = false;
        if (AMP_ENABLED != -1) {
            if (AMP_EN_INVERSION == 0) {
                digitalWrite(AMP_ENABLED, HIGH);
            } else {
                digitalWrite(AMP_ENABLED, LOW);
            }
            printfln(s_tag.action, "unmute, On Board Amplifier is on");
        }
        webSrv.send("mute=", "0");
    }
    dispHeader.speakerOnOff(!s_f_mute);
    dispHeader.updateVolume(s_volume.cur_volume);
    updateSettings();
};

void logAlarmItems() {
    const char wd[7][11] = {"Sunday:   ", "Monday:   ", "Tuesday:  ", "Wednesday:", "Thursday: ", "Friday:   ", "Saturday: "};
    uint8_t    mask = 0b00000001;
    for (uint8_t i = 0; i < 7; i++) {
        if (s_alarmdays & mask) {
            printfln(s_tag.alarm_time, ANSI_ESC_YELLOW "{} " ANSI_ESC_CYAN "{:02}:{:02}", wd[i], s_alarmtime[i] / 60, s_alarmtime[i] % 60);
        } else {
            printfln(s_tag.alarm_time, ANSI_ESC_YELLOW "{} No alarm is set", wd[i]);
        }
        mask <<= 1;
    }
}

void setTimeCounter(uint8_t sec) {
    if (sec == 0) {
        dispFooter.updateTC(0.0f);
        s_f_newBitRate = true;
    } else if (sec < 11) {
        s_timeCounter.timer = 1.0f;
        dispFooter.updateTC(s_timeCounter.timer);
        s_timeCounter.factor = 1.0f / (10.0f * sec);
    }
}

void setTFTbrightness(uint8_t brightness) {
    if (BRIGHTNESS_INVERSION) { brightness = 255 - brightness; }
    uint8_t duty = std::max(brightness, (uint8_t)BRIGHTNESS_MIN);
    if (s_f_sleeping && s_sleepMode == 0) { duty = 0; }

    if (TFT_BL >= 0) {
        ledc_set_duty(LEDC_LOW_SPEED_MODE, LEDC_CHANNEL_0, duty);
        ledc_update_duty(LEDC_LOW_SPEED_MODE, LEDC_CHANNEL_0);
    }
}

// —————————————————————————————————————————————————————————————————————————————————————————————————————————————————————————————————————————————————————————————————————————————————————————————————————
// 📌📌📌  C H A N G E   S T A T E  📌📌📌
// —————————————————————————————————————————————————————————————————————————————————————————————————————————————————————————————————————————————————————————————————————————————————————————————————————
// clang-format off
/*🟢🟡🔴*/
void changeState(int8_t state, int8_t subState) {

    printfln(s_tag.action, "current state is " ANSI_ESC_GREEN "{}({})" ANSI_ESC_RESET ", required state " ANSI_ESC_GREEN "{}({})", statusItems[s_state].name, s_subState, statusItems[state].name, subState);
    MWR_LOG_DEBUG("state {}, s_state {}, subState {}, s_subState_radio {}, s_subState_player {}", state, s_state, subState, s_subState_radio, s_subState_player);
    bool newState = false;
    bool newSubState = false;
    s_subState = subState;
   // disableAllObjects();
    setTimeCounter(0);
    if (state == RADIO          && s_state != RADIO)          { dispHeader.set_bg_color(TFT_BG_IS_WALLPAPER); dispFooter.set_bg_color(TFT_BG_IS_WALLPAPER); clearWithOutHeaderFooter(TFT_BG_IS_WALLPAPER); newState = true;}
    if (state == STATIONSLIST   && s_state != STATIONSLIST)   { dispHeader.set_bg_color(TFT_BG_IS_BLACK);     dispFooter.set_bg_color(TFT_BG_IS_BLACK);     clearWithOutHeaderFooter(TFT_BG_IS_BLACK);     newState = true;}
    if (state == PLAYER         && s_state != PLAYER)         { dispHeader.set_bg_color(TFT_BG_IS_WALLPAPER); dispFooter.set_bg_color(TFT_BG_IS_WALLPAPER); clearWithOutHeaderFooter(TFT_BG_IS_WALLPAPER); newState = true;}
    if (state == AUDIOFILESLIST && s_state != AUDIOFILESLIST) { dispHeader.set_bg_color(TFT_BG_IS_BLACK);     dispFooter.set_bg_color(TFT_BG_IS_BLACK);     clearWithOutHeaderFooter(TFT_BG_IS_BLACK);     newState = true;}
    if (state == DLNA           && s_state != DLNA)           { dispHeader.set_bg_color(TFT_BG_IS_WALLPAPER); dispFooter.set_bg_color(TFT_BG_IS_WALLPAPER); clearWithOutHeaderFooter(TFT_BG_IS_WALLPAPER); newState = true;}
    if (state == DLNAITEMSLIST  && s_state != DLNAITEMSLIST)  { dispHeader.set_bg_color(TFT_BG_IS_BLACK);     dispFooter.set_bg_color(TFT_BG_IS_BLACK);     clearWithOutHeaderFooter(TFT_BG_IS_BLACK);     newState = true;}
    if (state == CLOCK          && s_state != CLOCK)          { dispHeader.set_bg_color(TFT_BG_IS_BLACK);     dispFooter.set_bg_color(TFT_BG_IS_BLACK);     clearWithOutHeaderFooter(TFT_BG_IS_BLACK);     newState = true;}
    if (state == ALARMCLOCK     && s_state != ALARMCLOCK)     { dispHeader.set_bg_color(TFT_BG_IS_BLACK);     dispFooter.set_bg_color(TFT_BG_IS_BLACK);     clearWithOutHeaderFooter(TFT_BG_IS_BLACK);     newState = true;}
    if (state == SLEEPTIMER     && s_state != SLEEPTIMER)     { dispHeader.set_bg_color(TFT_BG_IS_WALLPAPER); dispFooter.set_bg_color(TFT_BG_IS_WALLPAPER); clearWithOutHeaderFooter(TFT_BG_IS_WALLPAPER); newState = true;}
    if (state == SETTINGS       && s_state != SETTINGS)       { dispHeader.set_bg_color(TFT_BG_IS_WALLPAPER); dispFooter.set_bg_color(TFT_BG_IS_WALLPAPER); clearWithOutHeaderFooter(TFT_BG_IS_WALLPAPER); newState = true;}
    if (state == BRIGHTNESS     && s_state != BRIGHTNESS)     { dispHeader.set_bg_color(TFT_BG_IS_VISIBLE);   dispFooter.set_bg_color(TFT_BG_IS_VISIBLE); /*clearWithOutHeaderFooter(TFT_BG_IS_BLACK); */  newState = true;}
    if (state == EQUALIZER      && s_state != EQUALIZER)      { dispHeader.set_bg_color(TFT_BG_IS_WALLPAPER); dispFooter.set_bg_color(TFT_BG_IS_WALLPAPER); clearWithOutHeaderFooter(TFT_BG_IS_WALLPAPER); newState = true;}
    if (state == BLUETOOTH      && s_state != BLUETOOTH)      { dispHeader.set_bg_color(TFT_BG_IS_WALLPAPER); dispFooter.set_bg_color(TFT_BG_IS_WALLPAPER); clearWithOutHeaderFooter(TFT_BG_IS_WALLPAPER); newState = true;}
    if (state == IR_SETTINGS    && s_state != IR_SETTINGS)    { dispHeader.set_bg_color(TFT_BG_IS_WALLPAPER); dispFooter.set_bg_color(TFT_BG_IS_WALLPAPER); clearWithOutHeaderFooter(TFT_BG_IS_WALLPAPER); newState = true;}
    if (state == RINGING        && s_state != RINGING)        { dispHeader.set_bg_color(TFT_BG_IS_BLACK);     dispFooter.set_bg_color(TFT_BG_IS_BLACK);     clearWithOutHeaderFooter(TFT_BG_IS_BLACK);     newState = true;}
    if (state == WIFI_SETTINGS  && s_state != WIFI_SETTINGS)  { dispHeader.set_bg_color(TFT_BG_IS_WALLPAPER); dispFooter.set_bg_color(TFT_BG_IS_WALLPAPER); clearWithOutHeaderFooter(TFT_BG_IS_WALLPAPER); newState = true;}
    if (state == WEATHER        && s_state != WEATHER)        { dispHeader.set_bg_color(TFT_BG_IS_BLACK);     dispFooter.set_bg_color(TFT_BG_IS_BLACK);     clearWithOutHeaderFooter(TFT_BG_IS_BLACK);     newState = true;}
    if (state == SLEEP          && s_state != SLEEP)          { dispHeader.set_bg_color(TFT_BG_IS_BLACK);     dispFooter.set_bg_color(TFT_BG_IS_BLACK);     clearAll(TFT_BG_IS_BLACK);                     newState = true;}

    if (state == RADIO          && s_subState_radio   != subState) { newSubState = true;  }
    if (state == PLAYER         && s_subState_player  != subState) { newSubState = true;  }
    if (state == CLOCK          && s_subState_clock   != subState) { newSubState = true;  }
    if (state == WEATHER        && s_subState_weather != subState) { newSubState = true;  }

    if(newState)disableAllObjects();
    dispHeader.enable();
    dispFooter.enable();
    if(state != s_state) { dispHeader.updateItem(statusItems[state].hl_name, statusItems[state].headline_color1, statusItems[state].headline_color2); }

    s_subState_radio  = UNDEFINED;
    s_subState_player = UNDEFINED;
    s_subState_clock  = UNDEFINED;

    s_f_volBarVisible = false;
    if (state != RADIO) { dispFooter.updateFlag(""); }

    switch (state) {
        case RADIO: {
            if (newState) {
                txt_RA_staName.setText("");
                txt_RA_staName.show();
                webSrv.send("changeState=", "RADIO");
                if(!s_f_isWebConnected){
                    setStation(s_cur_station);
                }
                if(s_f_isWebConnected) showLogoAndStationName();
            }
            else{
                txt_RA_staName.enable();
            }

            pic_RA_logo.enable();
            if(newSubState) hide_objects_in_area(layout.winArea2.x, layout.winArea2.y, layout.winArea2.w, layout.winArea2.h);
            if (subState == 0) {
                if(newSubState) {
                    if(s_f_vu_meter_enabled) MWR_LOG_INFO("VU enabled");
                    if(!s_f_vu_meter_enabled) MWR_LOG_INFO("VU disabled");
                    if(s_f_spectrum_enabled) MWR_LOG_INFO("spectrum enabled");
                    if(!s_f_spectrum_enabled) MWR_LOG_INFO("spectrum disabled");
                    uint16_t x = layout.winSTitle.x, y = layout.winSTitle.y, w = layout.winSTitle.w, h = layout.winSTitle.h;
                    txt_RA_sTitle.setBounds(x, y, w, h);
                    if(s_f_spectrum_enabled){
                        x += layout.winSTitle.h;
                        w -= layout.winSTitle.h;
                        txt_RA_sTitle.setBounds(x, y, w, h);
                        spectrum_RA.show();
                    }
                    if(s_f_vu_meter_enabled){
                        w -= layout.winVUmeter.w;
                        txt_RA_sTitle.setBounds(x, y, w, h);
                        VUmeter_RA.show();
                    }
                    txt_RA_sTitle.setText("");
                    s_f_newIcyDescription = true;
                    s_f_newStreamTitle = true;
                    s_f_newStationName = true;
                }
                else {
                    if(s_f_vu_meter_enabled) VUmeter_RA.enable();
                    if(s_f_spectrum_enabled) spectrum_RA.enable();
                    txt_RA_sTitle.enable();
                    txt_RA_sTitle.enable();
                }
            }
            if (subState == 1) {  // Mute, Vol+, Vol-, Sta+, Sta-, StaList
                if(newSubState) {
                    sdr_RA_volume.show();
                    btn_RA_mute.show(); btn_RA_prevSta.show(); btn_RA_nextSta.show(); btn_RA_recorder.show();
                    setTimeCounter(2);
                }
                else{
                    sdr_RA_volume.enable();
                    btn_RA_mute.enable(); btn_RA_prevSta.enable(); btn_RA_nextSta.enable(); btn_RA_recorder.enable();
                }
            }
            if (subState == 2){ // Player, DLNA, Clock, SleepTime, Brightness, EQ, BT, Off
            //    btn_RA_weather.set_active(false); // todo
                if(newSubState) {
                    btn_RA_staList.show();
                    btn_RA_player.show(); btn_RA_dlna.show(); btn_RA_clock.show(); btn_RA_weather.show(); btn_RA_settings.show();
                    btn_RA_bt.show();
                    btn_RA_off.show();
                    setTimeCounter(2);
                }
                else {
                    btn_RA_staList.enable();
                    btn_RA_player.enable(); btn_RA_dlna.enable(); btn_RA_clock.enable(); btn_RA_weather.enable(); btn_RA_settings.enable();
                    btn_RA_bt.enable();
                    btn_RA_off.enable();
                }
            }
            s_subState_radio = subState;
            break;
        }

        case STATIONSLIST: {
            lst_RADIO.show();
            setTimeCounter(LIST_TIMER);
            break;
        }
        case PLAYER: {
            if (newState) {
                stopSong();
                webSrv.send("changeState=", "PLAYER");
            }
            if(newSubState){ disableAllObjects(); }
            pic_PL_logo.enable();
            if (subState == 0){
                s_SD_content.listFilesInDir(s_cur_AudioFolder, true, false);
                s_cur_Codec = 0;
                showFileLogo(PLAYER, subState);
                showPlayerFileName(s_SD_content.getColouredSStringByIndex(s_cur_AudioFileNr));
                txt_PL_fName.show();
                pgb_PL_progress.hide();
                sdr_PL_volume.hide();
                showAudioFileNumber();
                btn_PL_showPrevFile.show(); btn_PL_showNextFile.show(); btn_PL_ready.show(); btn_PL_playAll.show();
                btn_PL_shuffle.show();  btn_PL_fileList.show(); btn_PL_radio.show(); btn_PL_off.show();
            }
            if (subState == 1){
                pgb_PL_progress.setValue(0);
                showPlayerFileName(s_SD_content.getColouredSStringByIndex(s_cur_AudioFileNr));
                if(newSubState){
                    btn_PL_fileList.hide(); btn_PL_radio.hide(); btn_PL_off.hide();
                    pgb_PL_progress.show();
                    sdr_PL_volume.show();
                    txt_PL_fName.show();
                    btn_PL_mute.show(); btn_PL_pause.setOff(); btn_PL_pause.show(); btn_PL_cancel.show(); btn_PL_playPrev.show(); btn_PL_playNext.show();
                }
                else{
                    pgb_PL_progress.enable();
                    sdr_PL_volume.enable();
                    txt_PL_fName.enable();
                    btn_PL_mute.enable(); btn_PL_pause.enable(); btn_PL_pause.enable(); btn_PL_cancel.enable();  btn_PL_playPrev.enable(); btn_PL_playNext.enable();
                }
            }
            s_subState_player = subState;
            break;
        }
        case AUDIOFILESLIST: {
            lst_PLAYER.show(s_cur_AudioFolder, s_cur_AudioFileNr);
            setTimeCounter(LIST_TIMER);
            break;
        }
        case DLNA: {
            if (newState && s_state != DLNAITEMSLIST) audio.stopSong();
            pic_DL_logo.enable();
            pgb_DL_progress.setValue(0);
            pgb_DL_progress.show();
            txt_DL_fName.show();
            showFileLogo(DLNA, subState);
            webSrv.send("changeState=", "DLNA");
            if (audio.isRunning()) btn_DL_pause.set_active(true);
            else                   btn_DL_pause.set_active(false);
            sdr_DL_volume.show();
            btn_DL_pause.show(); btn_DL_mute.show(); btn_DL_cancel.show(); btn_DL_fileList.show(); btn_DL_radio.show();
            break;
        }
        case DLNAITEMSLIST: {
            lst_DLNA.show(s_currDLNAsrvNr, dlna.getServer(), dlna.getBrowseResult(), &s_dlnaLevel, s_dlnaMaxItems, s_dlnaMaXServers);
            setTimeCounter(LIST_TIMER);
            break;
        }
        case CLOCK: {
            clk_CL_24.show();
            if (subState == 0) {
                btn_CL_alarm.hide(); btn_CL_sleep.hide(); btn_CL_radio.hide(); btn_CL_mute.hide(); btn_CL_off.hide(); sdr_CL_volume.hide();
            }
            if (subState == 1) {
                setTimeCounter(2);
                sdr_CL_volume.show();
                btn_CL_mute.show(); btn_CL_alarm.show(); btn_CL_radio.show(); btn_CL_off.show(); btn_CL_sleep.show();
            }

            s_subState_clock = subState;
            break;
        }
        case ALARMCLOCK: {
            btn_AC_left.show(); btn_AC_right.show(); btn_AC_up.show(); btn_AC_down.show(); btn_AC_ready.show(); clk_AC_red.show();
            break;
        }
        case SLEEPTIMER: {
            if (newState) {
                otb_SL_stime.show(s_sleeptime);
                pic_SL_logo.setPicturePath("/common/Night_Gown.jpg");
                pic_SL_logo.setAlign(HAlign::Center, VAlign::Middle);
                pic_SL_logo.show();
            }
            btn_SL_up.show(); btn_SL_up.show(); btn_SL_down.show(); btn_SL_ready.show(); btn_SL_cancel.show();
            break;
        }
        case SETTINGS: {
            if (newState) {
                showFileLogo(SETTINGS, subState);
            }
            btn_SE_bright.show(); btn_SE_equal.show(); btn_SE_wifi.show(); btn_SE_radio.show(); btn_SE_vu_meter.show(); btn_SE_spectrum.show();
            break;
        }
        case BRIGHTNESS: {
            if (newState) {
                pic_BR_logo.show();
                sdr_BR_value.setValue(s_brightness);
                sdr_BR_value.show();
                ps_ptr<char>c;
                c.assignf("{}", s_brightness);
                txt_BR_value.setText(c);
                txt_BR_value.show();
            } else {
                sdr_BR_value.enable();
                txt_BR_value.enable();
            }
            btn_BR_ready.show();
            break;
        }
        case EQUALIZER: {
            sdr_EQ_lowPass.show();
            sdr_EQ_bandPass.show();
            sdr_EQ_highPass.show();
            sdr_EQ_balance.show();
            btn_EQ_lowPass.show();
            btn_EQ_bandPass.show();
            btn_EQ_highPass.show();
            btn_EQ_balance.show();
            btn_EQ_Player.show();
            btn_EQ_mute.show();
            txt_EQ_lowPass.show();
            txt_EQ_bandPass.show();
            txt_EQ_highPass.show();
            txt_EQ_balance.show();
            btn_EQ_Radio.show();
            break;
        }
        case BLUETOOTH: {
            btn_BT_volUp.show(); btn_BT_volDown.show(); btn_BT_pause.show(); btn_BT_mode.show();
            btn_BT_radio.show(); btn_BT_power.show();
            pic_BT_mode.show();
            txt_BT_mode.set_bg_color(TFT_BROWN);
            if (s_bt_emitter.mode.equals("RX")) { txt_BT_mode.setText("RECEIVER"); }
            else                                { txt_BT_mode.setText("EMITTER"); }
            txt_BT_mode.show();
            ps_ptr<char> v;
            v.assignf("Vol: {:02}", bt_emitter.getVolume());
            dispFooter.updateFileNr(v);
            if (s_state != BLUETOOTH) webSrv.send("changeState=", "BLUETOOTH");
            break;
        }
        case IR_SETTINGS: {
            btn_IR_radio.show();
            break;
        }
        case RINGING: {
            if (s_volume.ringVolume > 0) { // alarm with bell
                pic_RI_logo.enable();
                showFileLogo(RINGING, subState);
                setTFTbrightness(s_brightness);
                printfln(s_tag.action, ANSI_ESC_MAGENTA "Alarm");
                setVolume(s_volume.ringVolume);
                audio.setVolume(s_volume.ringVolume);
                muteChanged(false);
                connecttoFS("SD_MMC", "/ring/alarm_clock.mp3");
                clk_RI_24small.set_bg_color(TFT_BG_IS_BLACK);
                clk_RI_24small.show();
            } else { // alarm without bell
                s_f_eof_alarm = true;
            }
            break;
        }
        case WIFI_SETTINGS: {
            cls_wifiSettings.clearText();
            cls_wifiSettings.setFontSize(displayConfig.listFontSize);
            {
                int16_t n = WiFi.scanNetworks();
                printfln(s_tag.wifi_info, ANSI_ESC_CYAN "{}" ANSI_ESC_RESET " WiFi networks found", n);
                if(n <= 0) break;
                for (int i = 0; i < n; i++) {
                    printfln(s_tag.wifi_info, ANSI_ESC_GREEN"{} ({})", WiFi.SSID(i).c_str(), (int16_t)WiFi.RSSI(i));
                    ps_ptr<char> pw = get_WiFi_PW(WiFi.SSID(i).c_str());
                    cls_wifiSettings.add_WiFi_Items(WiFi.SSID(i).c_str(), pw.c_get());
                }
            }
            cls_wifiSettings.show();
            break;
        }
        case SLEEP: {
            dispHeader.hide();
            dispFooter.hide();
            if (subState == 0) {
                setTFTbrightness(0);
            }
            if (subState == 1) {
                clk_CL_24.show();
            }
            if (subState == 2) {
                cls_weather.show();
            }
            break;
        }
        case WEATHER: {
            if(newState) {
                cls_weather.show();
            }
            if (subState == 0) {
                btn_WR_alarm.hide(); btn_WR_sleep.hide(); btn_WR_radio.hide(); btn_WR_mute.hide(); btn_WR_off.hide(); sdr_WR_volume.hide();
                cls_weather.restore_clock();
            }
            if (subState == 1) {
                cls_weather.disable_clock();
                setTimeCounter(2);
                sdr_WR_volume.show();
                btn_WR_mute.show(); btn_WR_alarm.show(); btn_WR_radio.show(); btn_WR_off.show(); btn_WR_sleep.show();
            }
            s_subState_weather = subState;
            break;
        }
    }

    if(newState){
        dispFooter.set_state(state);
        if(!s_f_sleeping) dispHeader.show();
        if(!s_f_sleeping) dispFooter.show();
    }
    s_ir_btn_select = UNDEFINED;
    s_state = state;
}
// clang-format on
/*🟢🟡🔴*/
// —————————————————————————————————————————————————————————————————————————————————————————————————————————————————————————————————————————————————————————————————————————————————————————————————————

ps_ptr<char> get_WiFi_PW(const char* ssid) {
    ps_ptr<char> line;
    ps_ptr<char> password = "";

    for (int j = 0; j < 6; j++) {
        if (j == 0) line = pref.getString("wifiStr0").c_str();
        if (j == 1) line = pref.getString("wifiStr1").c_str();
        if (j == 2) line = pref.getString("wifiStr2").c_str();
        if (j == 3) line = pref.getString("wifiStr3").c_str();
        if (j == 4) line = pref.getString("wifiStr4").c_str();
        if (j == 5) line = pref.getString("wifiStr5").c_str();
        if (line.starts_with(ssid) && line[strlen(ssid)] == '\t') {
            int idx = line.index_of("\t", 0);
            password = line.substr(idx + 1);
        }
    }
    return password;
}

/*         ╔═════════════════════════════════════════════════════════════════════════════════════════════════════════════════════════════════════════════════════════════════════════════╗
           ║                                                                                  E V E N T S                                                                                ║
           ╚═════════════════════════════════════════════════════════════════════════════════════════════════════════════════════════════════════════════════════════════════════════════╝   */

// Events from audioI2S library
void my_audio_info(Audio::msg_t m) {
    ps_ptr<char> msg = m.msg;
    switch (m.e) {
        case Audio::evt_info:
            if (msg.ends_with("failed!")) {
                printflnCut(s_tag.audio_info, "", ANSI_ESC_YELLOW, msg);

                s_streamTitle.assignf(ANSI_ESC_ORANGE "{}", msg);
                s_f_newStreamTitle = true;
                s_f_webFailed = true;
                return;
            }
            if (msg.starts_with("FLAC")) {
                printflnCut(s_tag.audio_info, "", ANSI_ESC_GREEN, msg);
                return;
            }
            if (msg.ends_with("Stream lost")) {
                printflnCut(s_tag.audio_info, "", ANSI_ESC_YELLOW, msg);
                return;
            }
            if (msg.starts_with("authent")) {
                printflnCut(s_tag.audio_info, "", ANSI_ESC_GREEN, msg);
                return;
            }
            if (msg.starts_with("StreamTitle=")) { return; }
            if (msg.starts_with("BitsPerSample")) {
                // es8311.setBitsPerSample(m.arg1);
            }
            if (msg.starts_with("SampleRate (Hz)")) {
                // es8311.setSampleRate(m.arg1);
            }
            if (msg.starts_with("HTTP/") && msg[9] > '3') {
                printflnCut(s_tag.audio_info, "", ANSI_ESC_RED, msg);
                return;
            }
            if (msg.starts_with("ERROR:")) {
                printflnCut(s_tag.audio_info, "", ANSI_ESC_RED, msg);
                return;
            }
            if (CORE_DEBUG_LEVEL >= ARDUHAL_LOG_LEVEL_WARN) {
                printfln(s_tag.audio_info, ANSI_ESC_GREEN "{}", msg);
                return;
            } // all other
            break;

        case Audio::evt_name:
            s_stationName_air = msg; // set max length
            printfln(s_tag.audio_info, "StationName: " ANSI_ESC_MAGENTA "{}", msg);
            s_f_newStationName = true;
            break;

        case Audio::evt_streamtitle:
            s_streamTitle = msg;
            printfln(s_tag.audio_info, "StreamTitle: " ANSI_ESC_YELLOW "{}", msg);
            s_f_newStreamTitle = true;
            break;

        case Audio::evt_eof:
            s_f_isWebConnected = false;
            s_f_eof = true;
            s_f_isFSConnected = false;
            printflnCut(s_tag.audio_info, "end of file: ", ANSI_ESC_YELLOW, msg);
            if (s_state == PLAYER) {
                webSrv.send("SD_playFile=", "end of audiofile");
                if (!s_f_playlistEnabled) {
                    //    s_f_clearLogo = true;
                    //    s_f_clearStationName = true;
                    changeState(PLAYER, 0);
                }
            }
            if (s_state == RADIO) {}
            if (s_state == DLNA) {
                txt_DL_fName.setText("");
                txt_DL_fName.show();
                btn_DL_pause.set_active(false);
                btn_DL_pause.show();
            }
            if (s_state == RINGING) {
                if (msg.starts_with("alarm")) s_f_eof_alarm = true;
            }
            s_f_eof = true;
            break;

        case Audio::evt_lasthost:
            if (s_f_playlistEnabled) return;
            if (s_state == RADIO) s_settings.lastconnectedhost = msg;
            printflnCut(s_tag.audio_info, "lastURL: ", ANSI_ESC_YELLOW, msg);
            webSrv.send("stationURL=", msg);
            break;

        case Audio::evt_icyurl:
            if (msg.strlen() > 5) {
                printflnCut(s_tag.audio_info, "icy-url: ", ANSI_ESC_YELLOW, msg);
                s_homepage = msg;
                if (!s_homepage.starts_with("http")) s_homepage = "http://" + s_homepage;
            }
            break;

        case Audio::evt_icylogo:
            if (msg.strlen() > 5) { printflnCut(s_tag.audio_info, "icy-logo: ", ANSI_ESC_RESET, msg); }
            break;

        case Audio::evt_id3data: printfln(s_tag.audio_info, "id3data: " ANSI_ESC_GREEN "{}", msg); break;

        case Audio::evt_image:
            for (int i = 0; i < m.vec1.size(); i += 2) { printfln(s_tag.audio_info, "CoverImage: " ANSI_ESC_GREEN "segment {:02}, pos {:08}, len {:08}", i / 2, m.vec1[i], m.vec1[i + 1]); }
            break;

        case Audio::evt_icydescription:
            s_icyDescription = msg;
            s_f_newIcyDescription = true;
            if (msg.strlen()) printfln(s_tag.audio_info, "icy-descr: " ANSI_ESC_YELLOW "{}", msg);
            break;

        case Audio::evt_bitrate:
            if (!msg.strlen()) return; // guard
            s_icyBitRate = msg.to_uint32();
            s_f_newBitRate = true;
            printfln(s_tag.audio_info, "bitRate: " ANSI_ESC_CYAN "{}", s_icyBitRate);
            break;

        case Audio::evt_lyrics:
            printfln(s_tag.audio_info, "sync lyrics: " ANSI_ESC_YELLOW "{}", msg);
            s_lyrics = msg;
            s_f_newLyrics = true;
            break;

        case Audio::evt_genre: printfln(s_tag.audio_info, "genre: " ANSI_ESC_YELLOW "{}", msg); break;

        case Audio::evt_vu: {
            if (s_state == RADIO && s_subState_radio == 0) { VUmeter_RA.update(m.vec1[0], m.vec1[1], m.vec1[2], m.vec1[3]); }
        } break;

        case Audio::evt_spectrum:
            if (s_state == RADIO && s_subState_radio == 0) {
                //    PROFILE_SCOPE_N(1000);
                spectrum_RA.update(m.vec1, m.vec2);
            }
            break;

        case Audio::evt_bt: printfln(s_tag.audio_info, "bt_source: " ANSI_ESC_GREEN "{}", msg); break;

        case Audio::evt_log: printfln(m.s, "{}", msg); break;

        default: printfln("message", "{}", msg); break;
    }
}

// ————————————————————————————————————————————————————————————————————————————————————————————————————————————————————————————————————————————————————————————————————————————————————————————————————————————————————————————————————————————————————————
// void audio_process_i2s(int32_t* outBuff, int16_t validSamples, bool* continueI2S) {

//     int16_t* buff16 = reinterpret_cast<int16_t*>(outBuff);

//     int16_t sineWaveTable[44] = {
//          0,   3743,   7377,  10793,  14082,  17136,  19848,  22113,  23825,  24908,
//       25311,  24908,  23825,  22113,  19848,  17136,  14082,  10793,   7377,   3743,
//          0,  -3743,  -7377, -10793, -14082, -17136, -19848, -22113, -23825, -24908,
//      -25311, -24908, -23825, -22113, -19848, -17136, -14082, -10793,  -7377,  -3743
//     };

//     static uint8_t tabPtr = 0;
//     for(int i= 0; i < validSamples; i++){
//        buff16[i * 4 + 1] += sineWaveTable[tabPtr] /50; // channel left
//        buff16[i * 4 + 3] += sineWaveTable[tabPtr] /50; // channel right
//         tabPtr++;
//         if(tabPtr == 44) tabPtr = 0;
//     }
//     *continueI2S = true;
// }
// ————————————————————————————————————————————————————————————————————————————————————————————————————————————————————————————————————————————————————————————————————————————————————————————————————————————————————————————————————————————————————————
void on_BH1750(uint16_t lux) { //-- AMBIENT LIGHT SENSOR BH1750 --

    constexpr float MIN_PWM = 0.0f;
    constexpr float MAX_PWM = 255.0f;
    float           L0 = 512 - 2 * s_brightness;
    constexpr float k = 2.0f;

    float x;
    if (lux <= 0) lux = 1; // div0
    x = MAX_PWM / (1.0f + powf(L0 / static_cast<float>(lux), k));
    x = std::clamp(x, MIN_PWM, MAX_PWM);

    uint8_t brightness = static_cast<uint8_t>(x);
    MWR_LOG_DEBUG("brightness {}", brightness);
    setTFTbrightness(brightness);
}
// ————————————————————————————————————————————————————————————————————————————————————————————————————————————————————————————————————————————————————————————————————————————————————————————————————————————————————————————————————————————————————————
void ftp_debug(const char* info) {
    ps_ptr<char> i = info;
    if (i.starts_with("File Name")) return;
    printfln(s_tag.ftp_server, "{}", info);
}
//----------------------------------------------------------------------------------------------------------------------------------------------------
// Events from rtime library
void RTIME_info(const char* info) {
    printfln(s_tag.rtime_info, "{}", info);
}
// Events from tft library
void tft_info(const char* info) {
    printfln(s_tag.tft_info, "{}", info);
}
// Events from tp library
void tp_info(const char* info) {
    printfln(s_tag.tp_info, "{}", info);
}
//----------------------------------------------------------------------------------------------------------------------------------------------------
// Events from IR Library
void ir_code(uint8_t addr, uint8_t cmd) {
    printfln(s_tag.ir_info, "ir_code: " ANSI_ESC_YELLOW "IR address " ANSI_ESC_BLUE "0x{:02X}, " ANSI_ESC_YELLOW "IR command " ANSI_ESC_BLUE "0x{:02X}", addr, cmd);
    ps_ptr<char> buff;
    buff.assignf("0x{:02X}", addr);
    webSrv.send("IR_address=", buff);
    buff.assignf("0x{:02X}", cmd);
    webSrv.send("IR_command=", buff);
}

void ir_res(uint32_t res) {
    if (s_state != RADIO) return;
    if (s_f_sleeping == true) return;
    printfln(s_tag.ir_info, "ir_result: " ANSI_ESC_YELLOW "Stationnumber " ANSI_ESC_BLUE "{}", (long unsigned)res);
    nbr_RA_staBox.hide();
    setStationByNumber(res);
    return;
}
void ir_number(uint16_t num) {
    if (s_state != RADIO) return;
    if (s_f_sleeping) return;
    nbr_RA_staBox.enable();
    nbr_RA_staBox.setNumbers(num);
    nbr_RA_staBox.show(TFT_ORANGE);
}

void ir_released(int8_t key) {
    printfln(s_tag.ir_info, "ir_code: " ANSI_ESC_YELLOW "released ir key nr: " ANSI_ESC_BLUE "{:02}, <{}>", key, ir_symbols[key]);
    tp_released(0, 0);
    return;
}
// ————————————————————————————————————————————————————————————————————————————————————————————————————————————————————————————————————————————————————————————————————————————————————————————————————————————————————————————————————————————————————————
void ir_long_key(int8_t key) {
    printfln(s_tag.ir_info, "ir_code: " ANSI_ESC_YELLOW "long pressed ir key nr: " ANSI_ESC_BLUE "{:02}, <{}>", key, ir_symbols[key]);
    if (key == 16) {
        if (!s_f_sleeping)
            fall_asleep(); // long OK
        else
            wake_up(RADIO, 0);
    }
}
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
