schreibfaul1/ESP32-MiniWebRadio/src/settings.h

#pragma once
#include "Arduino.h"
#undef I2S_DOUT
#include "../lib/tftLib/tft_structures.h"

//———————————— predifined displays —————————————————————————————————————————————————————————————————————————————————————————————————————————————————————————————————————————————————————————————————————
// #define SPI_DISPLAY 1                  //                    SPI display  320x240, 2.8inch,        ILI9341             XPT2046, ESP32s3 or ESP32p4
// #define SPI_DISPLAY 2                  //                    SPI display  480x320, 3.5" od 4"      ILI9488 or ST7796,  XPT2046, ESP32s3 or ESP32p4
 #define SPI_DISPLAY 3                  //                    SPI display  480x320, 3.5" od 4"      ILI9488 or ST7796,  FT6x63,  ESP32s3 or ESP32p4
// #define LCD_DISPLAY_ESP32_S3_28        // Hosyond            SPI display  320x240, 2.8inch,        ILI9341             FT6x63,  ESP32s3 N16R8
// #define LCD_DISPLAY_ESP32_S3_40        // Hosyond            SPI display  480x320, 4"              ST7796,             FT6x63,  ESP32s3 N16R8
// #define ESP32_8048S070                 // Sunton             RGB display  800x480, 7",                                 GT911,   ESP32s3 N16R8
// #define ESP32_S3_Touch_LCD7            // Waveshare          RGB display  800x480, 7",                                 GT911,   ESP32s3 N8R8
// #define ESP32_P4_WIFI6_TOUCH_LCD_43    // Waveshare          DSI display  800x480, 4.3",           ST7701,             GT911,   ESP32p4 N32R32
// #define ESP32_P4_WIFI6_TOUCH_LCD7_7B   // Waveshare          DSI display 1024x600, 7",             EK97007,            GT911,   ESP32p4_es N32R32
// #define JC1060P470                     // Guition            DSI display 1024x600, 7",             JD9165,             GT911,   ESP32p4_es N32R32
// #define JC4880P443                     // Guition            DSI display  800x480, 4.3",           ST7701,             GT911,   ESP32p4_es N16R32
// #define USER_DEFINED_DISPLAY           // Self configurated ESP32-S3 or ESP32-P4 devBoard with SPI display

//———————————— common ——————————————————————————————————————————————————————————————————————————————————————————————————————————————————————————————————————————————————————————————————————————————————
#define I2S_COMM_FMT         0        // (0) MAX98357A PCM5102A CS4344, (1) LSBJ (Least Significant Bit Justified format) PT8211
#define SDMMC_FREQUENCY      80000000 // 80000000 or 40000000 Hz
#define FTP_USERNAME         "esp32"  // user name in FTP Client
#define FTP_PASSWORD         "esp32"  // pw in FTP Client
#define CONN_TIMEOUT         2500     // unencrypted connection timeout in ms (http://...)
#define CONN_TIMEOUT_SSL     3500     // encrypted connection timeout in ms (https://...)
#define WIFI_TX_POWER        10       // 2 ... 21 (dBm) Adjust the WiFi transmission power to optimise power consumption or increase range, default: 5
#define LIST_TIMER           10        // After this time (seconds), the display returns from the list view

// —————————————————————————————————————————————————————————————————————————————————————————————————————————————————————————————————————————————————————————————————————————————————————————————————————
// 📌📌📌 YOUR OWN DISPLAY [320x240] OR [480x320] TOUCHPAD-CONTROLLER XPT2046 OR FT6x36   📌📌📌
// —————————————————————————————————————————————————————————————————————————————————————————————————————————————————————————————————————————————————————————————————————————————————————————————————————

#ifdef USER_DEFINED_DISPLAY
    #define TFT_FREQUENCY    40000000 // only SPI displays, 80000000, 40000000, 27000000, 20000000, 10000000
    #define TFT_CONTROLLER          3 // (0)SPI-ILI9341[320x240], (3)SPI-ILI9486[480x320], (5)SPI-ILI9488 or ST7796[480x320], (7)RGB[800x480], (8)DSI-EK97007[1024x600], (9)DSI-JD9165[1024x600], (10)ST7701[480x800]
    #define TFT_ROTATION            0 // (0) none, (1) 90°CW, (2) 180°CW, (3) 270°CW
    #define TP_CONTROLLER           1 // (0)XPT2046 2.8", (1)XPT2046 3.5" or 4.0", (7)GT911, (8)FT6x63
    #define TP_ROTATION             1 // (0) none, (1) 90°CW, (2) 180°CW, (3) 270°CW
    #define TP_H_MIRROR             0 // (0) default, (1) mirror left <-> right
    #define TP_V_MIRROR             0 // (0) default, (1) mirror up <-> down
    #define DISPLAY_INVERSION       0 // (0) off (1) on
    #define BRIGHTNESS_INVERSION    0 // (0) off (1) on, bg-led
    #define BRIGHTNESS_MIN          5 // you can’t see anything underneath
    #define AMP_EN_INVERSION        0 // (0) HIGH - amp is enabled, (1) LOW - amp is enabled

    #if CONFIG_IDF_TARGET_ESP32S3  // Digital I/O used
        #define TFT_CS              8
        #define TFT_DC             12
        #define TFT_BL             10 // at -1 the brightness menu is not displayed
        #define TP_IRQ             39
        #define TP_CS              15
        #define SD_MMC_D0          11
        #define SD_MMC_CLK         13
        #define SD_MMC_CMD         14
        #define IR_PIN              4 // IR Receiver (if available)
        #define TFT_MOSI           18 // TFT and TP (FSPI)
        #define TFT_MISO            2 // TFT and TP (FSPI)
        #define TFT_SCK            17 // TFT and TP (FSPI)
        #define I2S_DOUT            9
        #define I2S_BCLK            3
        #define I2S_LRC             1
        #define I2S_MCLK            0
        #define BT_EMITTER_RX      45 // TX pin - KCX Bluetooth Transmitter    (-1 if not available)
        #define BT_EMITTER_TX      38 // RX pin - KCX Bluetooth Transmitter    (-1 if not available)
        #define BT_EMITTER_MODE    20 // high transmit - low receive           (-1 if not available)
        #define BT_EMITTER_CONNECT 48 // high impulse -> awake after POWER_OFF (-1 if not available)
        #define I2C_SDA            41 // I2C, dala line for capacitive touchpadand and light sensor (-1 if not available)
        #define I2C_SCL            42 // I2C, clock line for capacitive touchpadand and light sensor (-1 if not available)
        #define AMP_ENABLED        -1 // onboard amplifier (-1 if not available)
    #endif                            // CONFIG_IDF_TARGET_ESP32S3

    #if CONFIG_IDF_TARGET_ESP32P4
        #define TFT_CS             26
        #define TFT_DC              3
        #define TFT_BL              4 // at -1 the brightness menu is not displayed
        #define TP_IRQ              5
        #define TP_CS               2
        #define SD_MMC_D0          39
        #define SD_MMC_D1          40
        #define SD_MMC_D2          41
        #define SD_MMC_D3          42
        #define SD_MMC_CLK         43
        #define SD_MMC_CMD         44
        #define IR_PIN             32 // IR Receiver (if available)
        #define TFT_MOSI           20 // TFT and TP (FSPI)
        #define TFT_MISO           21 // TFT and TP (FSPI)
        #define TFT_SCK            22 // TFT and TP (FSPI)
        #define I2S_DOUT           23
        #define I2S_BCLK           24
        #define I2S_LRC            25
        #define I2S_MCLK           -1
        #define BT_EMITTER_RX      27 // TX pin - KCX Bluetooth Transmitter    (-1 if not available)
        #define BT_EMITTER_TX      28 // RX pin - KCX Bluetooth Transmitter    (-1 if not available)
        #define BT_EMITTER_MODE    29 // high transmit - low receive           (-1 if not available)
        #define BT_EMITTER_CONNECT 30 // high impulse -> awake after POWER_OFF (-1 if not available)
        #define I2C_SDA             7 // I2C, dala line for capacitive touchpad and light sensor (-1 if not available)
        #define I2C_SCL             8 // I2C, clock line for capacitive touchpad and light sensor (-1 if not available)
        #define AMP_ENABLED        33 // onboard amplifier (-1 if not available)
    // free pins 46, 47, 48, 49, 50, 51, 52
    #endif // CONFIG_IDF_TARGET_ESP32P4
#endif     // USER_DEFINED_DISPLAY

// —————————————————————————————————————————————————————————————————————————————————————————————————————————————————————————————————————————————————————————————————————————————————————————————————————
// 📌📌📌  DISPLAY [320x240] OR [480x320] TOUCHPAD-CONTROLLER XPT2046 OR FT6x36   📌📌📌
// —————————————————————————————————————————————————————————————————————————————————————————————————————————————————————————————————————————————————————————————————————————————————————————————————————

#ifdef SPI_DISPLAY
    #if (SPI_DISPLAY == 1)
        #define TFT_FREQUENCY 40000000 // only SPI displays, 80000000, 40000000, 27000000, 20000000, 10000000
        #define TFT_CONTROLLER       0 // (0)SPI-ILI9341[320x240]
        #define TFT_ROTATION         0 // (0) none, (1) 90°CW, (2) 180°CW, (3) 270°CW
        #define TP_CONTROLLER        1 // (1)XPT2046 3.5" or 4.0
        #define TP_ROTATION          2 // (0) none, (1) 90°CW, (2) 180°CW, (3) 270°CW
        #define TP_H_MIRROR          0 // (0) default, (1) mirror left <-> right
        #define TP_V_MIRROR          0 // (0) default, (1) mirror up <-> down
        #define DISPLAY_INVERSION    0 // (0) off (1) on
        #define BRIGHTNESS_INVERSION 0 // (0) off (1) on, bg-led
        #define BRIGHTNESS_MIN       5 // you can’t see anything underneath
        #define AMP_EN_INVERSION     0 // (0) HIGH - amp is enabled, (1) LOW - amp is enabled
    #endif
    #if (SPI_DISPLAY == 2)
        #define TFT_FREQUENCY 40000000 // only SPI displays, 80000000, 40000000, 27000000, 20000000, 10000000
        #define TFT_CONTROLLER       5 // (5)SPI-ILI9488 or ST7796[480x320]
        #define TFT_ROTATION         0 // (0) none, (1) 90°CW, (2) 180°CW, (3) 270°CW
        #define TP_CONTROLLER        1 // (1)XPT2046 3.5" or 4.0
        #define TP_ROTATION          2 // (0) none, (1) 90°CW, (2) 180°CW, (3) 270°CW
        #define TP_H_MIRROR          0 // (0) default, (1) mirror left <-> right
        #define TP_V_MIRROR          0 // (0) default, (1) mirror up <-> down
        #define DISPLAY_INVERSION    0 // (0) off (1) on
        #define BRIGHTNESS_INVERSION 0 // (0) off (1) on, bg-led
        #define BRIGHTNESS_MIN       5 // you can’t see anything underneath
        #define AMP_EN_INVERSION     0 // (0) HIGH - amp is enabled, (1) LOW - amp is enabled
    #endif
    #if (SPI_DISPLAY == 3)
        #define TFT_FREQUENCY 80000000 // only SPI displays, 80000000, 40000000, 27000000, 20000000, 10000000
        #define TFT_CONTROLLER       5 // (5)SPI-ILI9488 or ST7796[480x320]
        #define TFT_ROTATION         0 // (0) none, (1) 90°CW, (2) 180°CW, (3) 270°CW
        #define TP_CONTROLLER        8 // FT6x63
        #define TP_ROTATION          1 // (0) none, (1) 90°CW, (2) 180°CW, (3) 270°CW
        #define TP_H_MIRROR          0 // (0) default, (1) mirror left <-> right
        #define TP_V_MIRROR          0 // (0) default, (1) mirror up <-> down
        #define DISPLAY_INVERSION    1 // (0) off (1) on
        #define BRIGHTNESS_INVERSION 0 // (0) off (1) on, bg-led
        #define BRIGHTNESS_MIN       5 // you can’t see anything underneath
        #define AMP_EN_INVERSION     0 // (0) HIGH - amp is enabled, (1) LOW - amp is enabled
    #endif
    #if CONFIG_IDF_TARGET_ESP32S3
    // Digital I/O used
        #define TFT_CS               8
        #define TFT_DC              12
        #define TFT_BL              10 // at -1 the brightness menu is not displayed
        #define TP_IRQ              39
        #define TP_CS               15
        #define SD_MMC_D0           11
        #define SD_MMC_CLK          13
        #define SD_MMC_CMD          14
        #define IR_PIN               4 // IR Receiver (if available)
        #define TFT_MOSI            18 // TFT and TP (FSPI)
        #define TFT_MISO             2 // TFT and TP (FSPI)
        #define TFT_SCK             17 // TFT and TP (FSPI)
        #define I2S_DOUT             9
        #define I2S_BCLK             3
        #define I2S_LRC              1
        #define I2S_MCLK             0
        #define BT_EMITTER_RX       45 // TX pin - KCX Bluetooth Transmitter    (-1 if not available)
        #define BT_EMITTER_TX       38 // RX pin - KCX Bluetooth Transmitter    (-1 if not available)
        #define BT_EMITTER_MODE     20 // high transmit - low receive           (-1 if not available)
        #define BT_EMITTER_CONNECT  48 // high impulse -> awake after POWER_OFF (-1 if not available)
        #define I2C_SDA             41 // I2C, dala line for capacitive touchpadand and light sensor (-1 if not available)
        #define I2C_SCL             42 // I2C, clock line for capacitive touchpadand and light sensor (-1 if not available)
        #define AMP_ENABLED         -1 // onboard amplifier (-1 if not available)
    #endif                             // CONFIG_IDF_TARGET_ESP32S3

    #if CONFIG_IDF_TARGET_ESP32S31
    // Digital I/O used
        #define TFT_CS              44
        #define TFT_DC              45
        #define TFT_BL              46 // at -1 the brightness menu is not displayed
        #define TP_IRQ              47
        #define TP_CS               48
        #define SD_MMC_D0           20
        #define SD_MMC_D1           -1 // 21
        #define SD_MMC_D2           -1 // 22
        #define SD_MMC_D3           -1 // 23
        #define SD_MMC_CLK          24
        #define SD_MMC_CMD          25
        #define IR_PIN               4 // IR Receiver (if available)
        #define TFT_MOSI             1 // TFT and TP (FSPI)
        #define TFT_MISO             2 // TFT and TP (FSPI)
        #define TFT_SCK              3 // TFT and TP (FSPI)
        #define I2S_DOUT            56 // ES8311
        #define I2S_BCLK            53 // ES8311
        #define I2S_LRC             55 // ES8311
        #define I2S_MCLK            52 // ES8311
        #define BT_EMITTER_RX       -1 // not used, has internal BT-HW
        #define BT_EMITTER_TX       -1 // not used, has internal BT-HW
        #define BT_EMITTER_MODE     -1 // not used, has internal BT-HW
        #define BT_EMITTER_CONNECT  -1 // not used, has internal BT-HW
        #define I2C_SDA             51 // I2C, dala line for capacitive touchpadand and light sensor (-1 if not available)
        #define I2C_SCL             50 // I2C, clock line for capacitive touchpadand and light sensor (-1 if not available)
        #define AMP_ENABLED         57 // onboard amplifier (-1 if not available)

        #define ETH_PHY_MDC          5 // Ethernet YT8531 pin
        #define ETH_PHY_MDIO         6 // Ethernet YT8531 pin
        #define ETH_PHY_RST          7 // Ethernet YT8531 pin
        #define ETH_RGMII_TX0        8 // Ethernet YT8531 pin
        #define ETH_RGMII_TX1        9 // Ethernet YT8531 pin
        #define ETH_RGMII_TX2       10 // Ethernet YT8531 pin
        #define ETH_RGMII_TX3       11 // Ethernet YT8531 pin
        #define ETH_RGMII_TX_CTL    12 // Ethernet YT8531 pin
        #define ETH_RGMII_TX_CLK    13 // Ethernet YT8531 pin
        #define ETH_RGMII_RX_CLK    14 // Ethernet YT8531 pin
        #define ETH_RGMII_RX_CTL    15 // Ethernet YT8531 pin
        #define ETH_RGMII_RX3       16 // Ethernet YT8531 pin
        #define ETH_RGMII_RX2       17 // Ethernet YT8531 pin
        #define ETH_RGMII_RX1       18 // Ethernet YT8531 pin
        #define ETH_RGMII_RX0       19 // Ethernet YT8531 pin

    #endif

    #if CONFIG_IDF_TARGET_ESP32P4
        #define TFT_CS              26
        #define TFT_DC               3
        #define TFT_BL               4 // at -1 the brightness menu is not displayed
        #define TP_IRQ               5
        #define TP_CS                2
        #define SD_MMC_D0           39
        #define SD_MMC_D1           40
        #define SD_MMC_D2           41
        #define SD_MMC_D3           42
        #define SD_MMC_CLK          43
        #define SD_MMC_CMD          44
        #define IR_PIN              32 // IR Receiver (if available)
        #define TFT_MOSI            20 // TFT and TP (FSPI)
        #define TFT_MISO            21 // TFT and TP (FSPI)
        #define TFT_SCK             22 // TFT and TP (FSPI)
        #define I2S_DOUT            23
        #define I2S_BCLK            24
        #define I2S_LRC             25
        #define I2S_MCLK            -1
        #define BT_EMITTER_RX       27 // TX pin - KCX Bluetooth Transmitter    (-1 if not available)
        #define BT_EMITTER_TX       46  // 28 // RX pin - KCX Bluetooth Transmitter    (-1 if not available)
        #define BT_EMITTER_MODE     47  // 29 // high transmit - low receive           (-1 if not available)
        #define BT_EMITTER_CONNECT  48  // 30 // high impulse -> awake after POWER_OFF (-1 if not available)
        #define I2C_SDA              7 // I2C, dala line for capacitive touchpad and light sensor (-1 if not available)
        #define I2C_SCL              8 // I2C, clock line for capacitive touchpad and light sensor (-1 if not available)
        #define AMP_ENABLED         33 // onboard amplifier (-1 if not available)

        #define ETH_PHY_MDC         31 // Ethernet IP101 pin
        #define ETH_PHY_MDIO        52 // Ethernet IP101 pin
        #define ETH_PHY_RST         51 // Ethernet IP101 pin
        #define ETH_RMII_REF_CLK    50 // Ethernet IP101 pin
        #define ETH_RMII_TX_EN      49 // Ethernet IP101 pin
        #define ETH_RMII_TX0        34 // Ethernet IP101 pin
        #define ETH_RMII_TX1        35 // Ethernet IP101 pin
        #define ETH_RMII_CRS_DV     28 // Ethernet IP101 pin
        #define ETH_RMII_RX0        29 // Ethernet IP101 pin
        #define ETH_RMII_RX1        30 // Ethernet IP101 pin

    #endif // CONFIG_IDF_TARGET_ESP32P4
#endif

// —————————————————————————————————————————————————————————————————————————————————————————————————————————————————————————————————————————————————————————————————————————————————————————————————————
// 📌📌📌  DISPLAY [320x240] ESP32-S3 Hosyond 2.8"   📌📌📌
// —————————————————————————————————————————————————————————————————————————————————————————————————————————————————————————————————————————————————————————————————————————————————————————————————————
#if (CONFIG_IDF_TARGET_ESP32S3 == 1)
    #ifdef LCD_DISPLAY_ESP32_S3_28
        #define TFT_FREQUENCY 40000000 // only SPI displays, 80000000, 40000000, 27000000, 20000000, 10000000
        #define TFT_CONTROLLER       0 // (0)SPI-ILI9341[320x240],
        #define TFT_ROTATION         0 // (0) none, (1) 90°CW, (2) 180°CW, (3) 270°CW
        #define TP_CONTROLLER        8 // FT6x63
        #define TP_ROTATION          1 // (0) none, (1) 90°CW, (2) 180°CW, (3) 270°CW
        #define TP_H_MIRROR          0 // (0) default, (1) mirror left <-> right
        #define TP_V_MIRROR          0 // (0) default, (1) mirror up <-> down
        #define DISPLAY_INVERSION    1 // (0) off (1) on
        #define BRIGHTNESS_INVERSION 0 // (0) off (1) on, bg-led
        #define BRIGHTNESS_MIN       5 // you can’t see anything underneath
        #define AMP_EN_INVERSION     1 // (0) HIGH - amp is enabled, (1) LOW - amp is enabled

    // Digital I/O used
        #define TFT_CS              10
        #define TFT_DC              46
        #define TFT_BL              45 // at -1 the brightness menu is not displayed
        #define TP_IRQ              10
        #define TP_CS               -1
        #define SD_MMC_D0           39
        #define SD_MMC_CLK          38
        #define SD_MMC_CMD          40
        #define IR_PIN               2 // IR Receiver (if available)
        #define TFT_MOSI            11 // TFT and TP (FSPI)
        #define TFT_MISO            13 // TFT and TP (FSPI)
        #define TFT_SCK             12 // TFT and TP (FSPI)
        #define I2S_DIN             -1  // 6
        #define I2S_DOUT             8
        #define I2S_BCLK             5
        #define I2S_LRC              7
        #define I2S_MCLK             4
        #define BT_EMITTER_RX       -1 // TX pin - KCX Bluetooth Transmitter    (-1 if not available)
        #define BT_EMITTER_TX       -1 // RX pin - KCX Bluetooth Transmitter    (-1 if not available)
        #define BT_EMITTER_MODE     -1 // high transmit - low receive           (-1 if not available)
        #define BT_EMITTER_CONNECT  -1 // high impulse -> awake after POWER_OFF (-1 if not available)
        #define I2C_SDA             16 // I2C, dala line for capacitive touchpadand and light sensor (-1 if not available)
        #define I2C_SCL             15 // I2C, clock line for capacitive touchpadand and light sensor (-1 if not available)
        #define AMP_ENABLED          1 // onboard amplifier (-1 if not available)
    #endif                             // CONFIG_IDF_TARGET_ESP32S3
#endif // CONFIG_IDF_TARGET_ESP32S3

// —————————————————————————————————————————————————————————————————————————————————————————————————————————————————————————————————————————————————————————————————————————————————————————————————————
// 📌📌📌  DISPLAY [480x320] ESP32-S3 Hosyond 4"   📌📌📌
// —————————————————————————————————————————————————————————————————————————————————————————————————————————————————————————————————————————————————————————————————————————————————————————————————————
#if (CONFIG_IDF_TARGET_ESP32S3 == 1)
    #ifdef LCD_DISPLAY_ESP32_S3_40
        #define TFT_FREQUENCY 80000000 // only SPI displays, 80000000, 40000000, 27000000, 20000000, 10000000
        #define TFT_CONTROLLER       5 // (5) ST7796[480x320]
        #define TFT_ROTATION         0 // (0) none, (1) 90°CW, (2) 180°CW, (3) 270°CW
        #define TP_CONTROLLER        8 // FT6x63
        #define TP_ROTATION          1 // (0) none, (1) 90°CW, (2) 180°CW, (3) 270°CW
        #define TP_H_MIRROR          0 // (0) default, (1) mirror left <-> right
        #define TP_V_MIRROR          0 // (0) default, (1) mirror up <-> down
        #define DISPLAY_INVERSION    1 // (0) off (1) on
        #define BRIGHTNESS_INVERSION 0 // (0) off (1) on, bg-led
        #define BRIGHTNESS_MIN       5 // you can’t see anything underneath
        #define AMP_EN_INVERSION     1 // (0) HIGH - amp is enabled, (1) LOW - amp is enabled

    // Digital I/O used
        #define TFT_CS              10
        #define TFT_DC              46
        #define TFT_BL              45 // at -1 the brightness menu is not displayed
        #define TP_IRQ              10
        #define TP_CS               -1
        #define SD_MMC_D0           39
        #define SD_MMC_CLK          38
        #define SD_MMC_CMD          40
        #define IR_PIN               2 // IR Receiver (if available)
        #define TFT_MOSI            11 // TFT and TP (FSPI)
        #define TFT_MISO            13 // TFT and TP (FSPI)
        #define TFT_SCK             12 // TFT and TP (FSPI)
        #define I2S_DIN             -1  // 6
        #define I2S_DOUT             8
        #define I2S_BCLK             5
        #define I2S_LRC              7
        #define I2S_MCLK             4
        #define BT_EMITTER_RX       -1 // TX pin - KCX Bluetooth Transmitter    (-1 if not available)
        #define BT_EMITTER_TX       -1 // RX pin - KCX Bluetooth Transmitter    (-1 if not available)
        #define BT_EMITTER_MODE     -1 // high transmit - low receive           (-1 if not available)
        #define BT_EMITTER_CONNECT  -1 // high impulse -> awake after POWER_OFF (-1 if not available)
        #define I2C_SDA             16 // I2C, dala line for capacitive touchpadand and light sensor (-1 if not available)
        #define I2C_SCL             15 // I2C, clock line for capacitive touchpadand and light sensor (-1 if not available)
        #define AMP_ENABLED          1 // onboard amplifier (-1 if not available)
    #endif                             // CONFIG_IDF_TARGET_ESP32S3
#endif // CONFIG_IDF_TARGET_ESP32S3

// // —————————————————————————————————————————————————————————————————————————————————————————————————————————————————————————————————————————————————————————————————————————————————————————————————————
// 📌📌📌  DISPLAY [800x480] ESP32-S3 SUNTON   📌📌📌
// —————————————————————————————————————————————————————————————————————————————————————————————————————————————————————————————————————————————————————————————————————————————————————————————————————
#if (CONFIG_IDF_TARGET_ESP32S3 == 1)
    #ifdef ESP32_8048S070
        #define TFT_CONTROLLER       7 // (7)RGB[800x480]
        #define TFT_ROTATION         2 // (0) none, (1) 90°CW, (2) 180°CW, (3) 270°CW
        #define TP_CONTROLLER        7 // (7)GT911
        #define TP_ROTATION          1 // (0) none, (1) 90°CW, (2) 180°CW, (3) 270°CW
        #define TP_H_MIRROR          0 // (0) default, (1) mirror left <-> right
        #define TP_V_MIRROR          0 // (0) default, (1) mirror up <-> down
        #define DISPLAY_INVERSION    0 // (0) off (1) on
        #define BRIGHTNESS_INVERSION 0 // (0) off (1) on, bg-led
        #define BRIGHTNESS_MIN      25 // you can’t see anything underneath
        #define AMP_EN_INVERSION     0 // (0) HIGH - amp is enabled, (1) LOW - amp is enabled

const Pins RGB_PINS = { // SUNTON 7"
    .b0 = 15, .b1 = 7, .b2 = 6, .b3 = 5, .b4 = 4, .g0 = 9, .g1 = 46, .g2 = 3, .g3 = 8, .g4 = 16, .g5 = 1, .r0 = 14, .r1 = 21, .r2 = 47, .r3 = 48, .r4 = 45, .hsync = 39, .vsync = 40, .de = 41, .pclk = 42, .bl = -1};

const Timing RGB_TIMING = {.h_res = 800, .v_res = 480, .pixel_clock_hz = 8600000, .hsync_pulse_width = 40, .hsync_back_porch = 16, .hsync_front_porch = 10, .vsync_pulse_width = 20, .vsync_back_porch = 10, .vsync_front_porch = 22};

        #define TP_IRQ              -1
        #define SD_MMC_CMD          11
        #define SD_MMC_CLK          12
        #define SD_MMC_D0           13
        #define I2S_DOUT            17
        #define I2S_BCLK            0
        #define I2S_LRC             18
        #define I2S_MCLK            -1 // important!
        #define IR_PIN              38 // IR Receiver (if available)
        #define BT_EMITTER_RX       -1 // must be -1, not enough pins
        #define BT_EMITTER_TX       -1 // must be -1, not enough pins
        #define BT_EMITTER_MODE     -1 // must be -1, not enough pins
        #define BT_EMITTER_CONNECT  -1 // must be -1, not enough pins
        #define TFT_BL              2  // same as RGB_PINS.bl
        #define I2C_SDA             19 // I2C, data line for capacitive touchpad and light sensor (-1 if not available)
        #define I2C_SCL             20 // I2C, clock line for capacitive touchpad and light sensor (-1 if not available)
        #define AMP_ENABLED         -1 // onboard amplifier (-1 if not available)
    #endif
#endif // CONFIG_IDF_TARGET_ESP32S3

// —————————————————————————————————————————————————————————————————————————————————————————————————————————————————————————————————————————————————————————————————————————————————————————————————————
// 📌📌📌  DISPLAY [800x480] ESP32-S3 WAVESHARE 7"   📌📌📌
// —————————————————————————————————————————————————————————————————————————————————————————————————————————————————————————————————————————————————————————————————————————————————————————————————————
#if (CONFIG_IDF_TARGET_ESP32S3 == 1)
    #ifdef ESP32_S3_Touch_LCD7
        #define TFT_CONTROLLER       7 // (7)RGB[800x480]
        #define TFT_ROTATION         2 // (0) none, (1) 90°CW, (2) 180°CW, (3) 270°CW
        #define TP_CONTROLLER        7 // (7)GT911
        #define TP_ROTATION          1 // (0) none, (1) 90°CW, (2) 180°CW, (3) 270°CW
        #define TP_H_MIRROR          0 // (0) default, (1) mirror left <-> right
        #define TP_V_MIRROR          0 // (0) default, (1) mirror up <-> down
        #define DISPLAY_INVERSION    0 // (0) off (1) on
        #define BRIGHTNESS_INVERSION 0 // (0) off (1) on, bg-led
        #define BRIGHTNESS_MIN       0 // not used
        #define AMP_EN_INVERSION     0 // (0) HIGH - amp is enabled, (1) LOW - amp is enabled
const Pins RGB_PINS = { // WAVESHARE
    .b0 = 14, .b1 = 38, .b2 = 18, .b3 = 17, .b4 = 10, .g0 = 39, .g1 = 0, .g2 = 45, .g3 = 48, .g4 = 47, .g5 = 21, .r0 = 1, .r1 = 2, .r2 = 42, .r3 = 41, .r4 = 40, .hsync = 46, .vsync = 3, .de = 5, .pclk = 7, .bl = -1};

const Timing RGB_TIMING = {.h_res = 800, .v_res = 480, .pixel_clock_hz = 13000000, .hsync_pulse_width = 4, .hsync_back_porch = 8, .hsync_front_porch = 8, .vsync_pulse_width = 4, .vsync_back_porch = 8, .vsync_front_porch = 8};

        #define TP_IRQ              -1

        #define SD_MMC_CMD          11
        #define SD_MMC_CLK          12
        #define SD_MMC_D0           13

        #define I2S_DOUT            19
        #define I2S_BCLK            20
        #define I2S_LRC             15
        #define I2S_MCLK            -1 // important, don't change!

        #define IR_PIN               6  // IR Receiver (if available)
        #define BT_EMITTER_RX       -1 // must be -1, not enough pins
        #define BT_EMITTER_TX       -1 // must be -1, not enough pins
        #define BT_EMITTER_LINK     -1 // must be -1, not enough pins
        #define BT_EMITTER_MODE     -1 // must be -1, not enough pins
        #define BT_EMITTER_CONNECT  -1 // must be -1, not enough pins

        #define TFT_BL              -1 // same as RGB_PINS.bl
        #define AMP_ENABLED         -1 // control pin for extenal amplifier (if available)

        #define I2C_SDA              8 // I2C dala line for capacitive touchpad  (-1 if not used)
        #define I2C_SCL              9 // I2C clock line for capacitive touchpad (-1 if not used)
    #endif
#endif // CONFIG_IDF_TARGET_ESP32S3

// —————————————————————————————————————————————————————————————————————————————————————————————————————————————————————————————————————————————————————————————————————————————————————————————————————
// 📌📌📌  DSI-DISPLAY [800x480] ESP32-P4 WAVESHARE 4.3"   📌📌📌
// —————————————————————————————————————————————————————————————————————————————————————————————————————————————————————————————————————————————————————————————————————————————————————————————————————
#if (CONFIG_IDF_TARGET_ESP32P4 == 1)
    #ifdef ESP32_P4_WIFI6_TOUCH_LCD_43
        #define TFT_CONTROLLER      10 // (10)ST7701[480x800]
        #define TFT_ROTATION         1 // (0) none, (1) 90°CW, (2) 180°CW, (3) 270°CW
        #define TP_CONTROLLER        7 // (7)GT911
        #define TP_ROTATION          0 // (0) none, (1) 90°CW, (2) 180°CW, (3) 270°CW
        #define TP_H_MIRROR          0 // (0) default, (1) mirror left <-> right
        #define TP_V_MIRROR          0 // (0) default, (1) mirror up <-> down
        #define DISPLAY_INVERSION    0 // (0) off (1) on
        #define BRIGHTNESS_INVERSION 1 // (0) off (1) on, bg-led
        #define BRIGHTNESS_MIN       10 // you can’t see anything underneath
        #define AMP_EN_INVERSION     0 // (0) HIGH - amp is enabled, (1) LOW - amp is enabled

const Timing DSI_TIMING = {.h_res = 480, .v_res = 800, .pixel_clock_mhz = 30, .hsync_pulse_width = 12, .hsync_back_porch = 42, .hsync_front_porch = 42, .vsync_pulse_width = 8, .vsync_back_porch = 2, .vsync_front_porch = 60, .lane_bit_rate_mbps = 500};

        #define TP_IRQ              -1

        #define SD_MMC_D0           39
        #define SD_MMC_D1           40
        #define SD_MMC_D2           41
        #define SD_MMC_D3           42
        #define SD_MMC_CLK          43
        #define SD_MMC_CMD          44

        // I2S ext. DAC
    //    #define I2S_DOUT             2
    //    #define I2S_BCLK             3
    //    #define I2S_LRC              4
    //    #define I2S_MCLK            -1

    //  I2S onboard DAC ES8311
        #define I2S_DOUT              9 // ES8311 DSDIN
        #define I2S_BCLK             12 // ES8311 SCLK
        #define I2S_LRC              10 // ES8311 LRCK
        #define I2S_MCLK             13 // ES8311 MCLK
       // #define I2S_DIN              11 // ES8311 DOUT (microphone input)

        #define IR_PIN               5 // IR Receiver (if available)
        #define BT_EMITTER_RX       28
        #define BT_EMITTER_TX       29
        #define BT_EMITTER_LINK     30
        #define BT_EMITTER_MODE     31
        #define BT_EMITTER_CONNECT  34

        #define LCD_RESET           27 //33
        #define TFT_BL              26 //  32 //  33
        #define AMP_ENABLED         53 // control pin for extenal amplifier

        #define I2C_SDA              7 // I2C dala line for capacitive touchpad
        #define I2C_SCL              8 // I2C clock line for capacitive touchpad

    #endif
#endif
// —————————————————————————————————————————————————————————————————————————————————————————————————————————————————————————————————————————————————————————————————————————————————————————————————————
// 📌📌📌  DSI-DISPLAY [1024x600] ESP32-P4 WAVESHARE 7"   📌📌📌
// —————————————————————————————————————————————————————————————————————————————————————————————————————————————————————————————————————————————————————————————————————————————————————————————————————
#if (CONFIG_IDF_TARGET_ESP32P4 == 1)
    #ifdef ESP32_P4_WIFI6_TOUCH_LCD7_7B
        #define TFT_CONTROLLER       8   // (8)DSI-EK97007[1024x600]
        #define TFT_ROTATION         0   // (0) none, (1) 90°CW, (2) 180°CW, (3) 270°CW
        #define TP_CONTROLLER        7   // (7)GT911
        #define TP_ROTATION          1   // (0) none, (1) 90°CW, (2) 180°CW, (3) 270°CW
        #define TP_H_MIRROR          0   // (0) default, (1) mirror left <-> right
        #define TP_V_MIRROR          0   // (0) default, (1) mirror up <-> down
        #define DISPLAY_INVERSION    0   // (0) off (1) on
        #define BRIGHTNESS_INVERSION 1   // (0) off (1) on, bg-led
        #define BRIGHTNESS_MIN       5 // you can’t see anything underneath
        #define AMP_EN_INVERSION     0 // (0) HIGH - amp is enabled, (1) LOW - amp is enabled

const Timing DSI_TIMING = {.h_res = 1024, .v_res = 600, .pixel_clock_mhz = 52, .hsync_pulse_width = 10, .hsync_back_porch = 160, .hsync_front_porch = 160, .vsync_pulse_width = 1, .vsync_back_porch = 23, .vsync_front_porch = 22, .lane_bit_rate_mbps = 900};

        #define TP_IRQ              -1

        #define SD_MMC_D0           39
        #define SD_MMC_D1           40
        #define SD_MMC_D2           41
        #define SD_MMC_D3           42
        #define SD_MMC_CLK          43
        #define SD_MMC_CMD          44

        // I2S ext. DAC
        #define I2S_DOUT             2
        #define I2S_BCLK             3
        #define I2S_LRC              4
        #define I2S_MCLK            -1

    // I2S onboard DAC ES8311
    // #define I2S_DOUT              9 // ES8311 DSDIN
    // #define I2S_BCLK             12 // ES8311 SCLK
    // #define I2S_LRC              10 // ES8311 LRCK
    // #define I2S_MCLK             13 // ES8311 MCLK
    // #define I2S_DIN              11 // ES8311 DOUT (microphone input)

        #define IR_PIN               5 // IR Receiver (if available)
        #define BT_EMITTER_RX       28
        #define BT_EMITTER_TX       29
        #define BT_EMITTER_LINK     30
        #define BT_EMITTER_MODE     31
        #define BT_EMITTER_CONNECT  34

        #define LCD_RESET           33
        #define TFT_BL              32 //
        #define AMP_ENABLED         53 // control pin for extenal amplifier

        #define I2C_SDA              7 // I2C dala line for capacitive touchpad
        #define I2C_SCL              8 // I2C clock line for capacitive touchpad
    #endif
#endif

// —————————————————————————————————————————————————————————————————————————————————————————————————————————————————————————————————————————————————————————————————————————————————————————————————————
// 📌📌📌  DSI-DISPLAY [1024x600] ESP32-P4 GUITION 7"   📌📌📌 JC1060P470
// —————————————————————————————————————————————————————————————————————————————————————————————————————————————————————————————————————————————————————————————————————————————————————————————————————
#if (CONFIG_IDF_TARGET_ESP32P4 == 1)
    #ifdef JC1060P470
        #define TFT_CONTROLLER       9 // (9)DSI-JD9165[1024x600]
        #define TFT_ROTATION         2 // (0) none, (1) 90°CW, (2) 180°CW, (3) 270°CW
        #define TP_CONTROLLER        7 // (7)GT911
        #define TP_ROTATION          1 // (0) none, (1) 90°CW, (2) 180°CW, (3) 270°CW
        #define TP_H_MIRROR          0 // (0) default, (1) mirror left <-> right
        #define TP_V_MIRROR          0 // (0) default, (1) mirror up <-> down
        #define DISPLAY_INVERSION    0 // (0) off (1) on
        #define BRIGHTNESS_INVERSION 0 // (0) off (1) on, bg-led
        #define BRIGHTNESS_MIN       5 // you can’t see anything underneath
        #define AMP_EN_INVERSION     0 // (0) HIGH - amp is enabled, (1) LOW - amp is enabled

const Timing DSI_TIMING = {.h_res = 1024, .v_res = 600, .pixel_clock_mhz = 52, .hsync_pulse_width = 40, .hsync_back_porch = 160, .hsync_front_porch = 160, .vsync_pulse_width = 10, .vsync_back_porch = 23, .vsync_front_porch = 12, .lane_bit_rate_mbps = 750};

        #define TP_IRQ              -1

        #define SD_MMC_D0           39
        #define SD_MMC_D1           40
        #define SD_MMC_D2           41
        #define SD_MMC_D3           42
        #define SD_MMC_CLK          43
        #define SD_MMC_CMD          44

        // I2S external DAC
        #define I2S_DOUT             2
        #define I2S_BCLK             3
        #define I2S_LRC              4
        #define I2S_MCLK            -1

        // I2S onboard DAC ES8311
        // #define I2S_DOUT          9 // ES8311 DSDIN
        // #define I2S_BCLK         12 // ES8311 SCLK
        // #define I2S_LRC          10 // ES8311 LRCK
        // #define I2S_MCLK         13 // ES8311 MCLK

        #define IR_PIN               5 // IR Receiver (if available)
        #define BT_EMITTER_RX       -1
        #define BT_EMITTER_TX       -1
        #define BT_EMITTER_LINK     -1
        #define BT_EMITTER_MODE     -1
        #define BT_EMITTER_CONNECT  -1

        #define LCD_RESET           27 //
        #define TFT_BL              23 //
        #define AMP_ENABLED         20 // control pin for onboard amplifier

        #define I2C_SDA              7 // I2C dala line for capacitive touchpad
        #define I2C_SCL              8 // I2C clock line for capacitive touchpad
    #endif
#endif

// —————————————————————————————————————————————————————————————————————————————————————————————————————————————————————————————————————————————————————————————————————————————————————————————————————
// 📌📌📌 DSI-DISPLAY [480x800] ESP32-P4 GUITION 4.3" 📌📌📌 JC4880P443
// —————————————————————————————————————————————————————————————————————————————————————————————————————————————————————————————————————————————————————————————————————————————————————————————————————
#if (CONFIG_IDF_TARGET_ESP32P4 == 1)
    #ifdef JC4880P443
        #define TFT_CONTROLLER       10 // (10)ST7701[480x800]
        #define TFT_ROTATION         3  // (0) none, (1) 90°CW, (2) 180°CW, (3) 270°CW
        #define TP_CONTROLLER        7  // (7)GT911
        #define TP_ROTATION          2  // (0) none, (1) 90°CW, (2) 180°CW, (3) 270°CW
        #define TP_H_MIRROR          0 // (0) default, (1) mirror left <-> right
        #define TP_V_MIRROR          0 // (0) default, (1) mirror up <-> down
        #define DISPLAY_INVERSION    0  // (0) off (1) on
        #define BRIGHTNESS_INVERSION 0  // (0) off (1) on, bg-led
        #define BRIGHTNESS_MIN       5 // you can’t see anything underneath
        #define AMP_EN_INVERSION     0 // (0) HIGH - amp is enabled, (1) LOW - amp is enabled

const Timing DSI_TIMING = {.h_res = 480, .v_res = 800, .pixel_clock_mhz = 34, .hsync_pulse_width = 12, .hsync_back_porch = 42, .hsync_front_porch = 42, .vsync_pulse_width = 2, .vsync_back_porch = 8, .vsync_front_porch = 166, .lane_bit_rate_mbps = 500};

        #define TP_IRQ              -1

        #define SD_MMC_D0           39
        #define SD_MMC_D1           40
        #define SD_MMC_D2           41
        #define SD_MMC_D3           42
        #define SD_MMC_CLK          43
        #define SD_MMC_CMD          44

        // I2S external DAC
        #define I2S_DOUT            29 // DIN pin - DAC      (-1 if not available)
        #define I2S_BCLK            30 // BCK pin - DAC      (-1 if not available)
        #define I2S_LRC             31 // LCK LRCK pin - DAC (-1 if not available)
        #define I2S_MCLK            -1

    // I2S onboard DAC ES8311
    // #define I2S_DOUT              9 // ES8311 DSDIN
    // #define I2S_BCLK             12 // ES8311 SCLK
    // #define I2S_LRC              10 // ES8311 LRCK
    // #define I2S_MCLK             13 // ES8311 MCLK

        #define IR_PIN              33 // IR Receiver                           (-1 if not available)
        #define BT_EMITTER_RX       32 // RX pin - KCX Bluetooth Transmitter    (-1 if not available)
        #define BT_EMITTER_TX       28 // TX pin - KCX Bluetooth Transmitter    (-1 if not available)
        #define BT_EMITTER_LINK     34 // high connected - low pairing status   (-1 if not available)
        #define BT_EMITTER_MODE     35 // high transmit - low receive           (-1 if not available)
        #define BT_EMITTER_CONNECT  49 // high impulse -> awake after POWER_OFF (-1 if not available)

        #define LCD_RESET            5  // see schematics JC4880P443
        #define TFT_BL              23 // see schematics JC4880P443
        #define AMP_ENABLED         11 // control pin for amplifier

        #define I2C_SDA              7 // I2C data line for capacitive touchpad
        #define I2C_SCL              8 // I2C clock line for capacitive touchpad
    #endif
#endif
