schreibfaul1/ESP32-MiniWebRadio/src/mwr_src/graphical.hpp

#include "Audio.h"

#pragma once

#ifdef TFT_MODE_DSI
TFT_DSI& getTFT();
#elif defined(TFT_MODE_SPI)
TFT_SPI& getTFT();
#elif defined(TFT_MODE_RGB)
TFT_RGB& getTFT();
#endif

/*  ╔═══════════════════════════════════════════════════════════════════════════════════════════════════════════════════════════════════════════╗
    ║                                                     G R A P H I C   O B J E C T S                                                         ║
    ╚═══════════════════════════════════════════════════════════════════════════════════════════════════════════════════════════════════════════╝   */

extern __attribute__((weak)) void graphicObjects_OnChange(ps_ptr<char> name, int32_t val);
extern __attribute__((weak)) void graphicObjects_OnClick(ps_ptr<char> name, uint8_t val);
extern __attribute__((weak)) void graphicObjects_OnRelease(ps_ptr<char> name, releasedArg ra);

extern SemaphoreHandle_t mutex_display;
extern SD_content        s_SD_content;

enum class Colors : uint8_t { Blue, Green, Orange, Red };

struct imgSize {
    uint16_t w = 0;
    uint16_t h = 0;
};

imgSize getImageSize(ps_ptr<char> picturePath) {
    if (picturePath.strlen() == 0) {
        MWR_LOG_DEBUG("picturePath is empty");
        return imgSize{0, 0};
    }
    imgSize img = {0};
    auto    scaledPicPath = scaleImage(picturePath);
    if (!SD_MMC.exists(scaledPicPath.c_get())) { /* MWR_LOG_WARN("file {} not exists, objName: {}", scaledPicPath, m_name)*/
        MWR_LOG_ERROR("cannot open file '{}'", scaledPicPath);
        return img;
    }
    File file = SD_MMC.open(scaledPicPath.c_get(), "r", false);
    if (file.size() < 24) {
        MWR_LOG_WARN("file '{}' is too small", scaledPicPath);
        file.close();
        return img;
    }
    char buf[8];
    file.readBytes(buf, 3);
    if ((buf[0] == 0xFF) && (buf[1] == 0xD8) && (buf[2] == 0xFF)) { // format jpeg
        int16_t c1, c2;
        while (true) {
            c1 = file.read();
            if (c1 == -1) {
                MWR_LOG_WARN("sof marker in {} not found", scaledPicPath);
                file.close();
                return img;
            } // end of file reached
            if (c1 == 0xFF) {
                c2 = file.read();
                if (c2 == 0xC0) break;
            } // 0xFFC0 Marker found
        }
        file.readBytes(buf, 7);
        img.h = buf[3] * 256 + buf[4];
        img.w = buf[5] * 256 + buf[6];
        //    MWR_LOG_WARN("w {}, h {}", m_w, m_h);
        return img;
    }
    if ((buf[0] == 'B') && (buf[1] == 'M') && (buf[2] == '6')) { // format bmp
        for (int i = 0; i < 15; i++) file.read();                // read 15 dummys
        img.w = file.read();                                     // pos 18
        img.w += (file.read() << 8);
        img.w += (file.read() << 16);
        img.w += (file.read() << 24);
        img.h = file.read(); // pos 22
        img.h += (file.read() << 8);
        img.h += (file.read() << 16);
        img.h += (file.read() << 24);
        //    MWR_LOG_WARN("w {}, h {}", m_w, m_h);
        return img;
    }
    if ((buf[0] == 'G') && (buf[1] == 'I') && (buf[2] == 'F')) { // format gif
        for (int i = 0; i < 3; i++) file.read();                 // read 3 dummys
        img.w = file.read();                                     // pos 6
        img.w += (file.read() << 8);
        img.h = file.read(); // pos 8
        img.h += (file.read() << 8);
        //    MWR_LOG_WARN("w {}, h {}", m_w, m_h);
        return img;
    }
    if ((buf[0] == 0x89) && (buf[1] == 'P') && (buf[2] == 'N')) { // format png
        for (int i = 0; i < 13; i++) file.read();                 // read 13 dummys
        img.w = file.read() << 24;                                // pos 16
        img.w += file.read() << 16;                               // pos 17
        img.w += file.read() << 8;                                // pos 18
        img.w += file.read();                                     // pos 19
        img.h = file.read() << 24;                                // pos 20
        img.h += file.read() << 16;                               // pos 21
        img.h += file.read() << 8;                                // pos 22
        img.h += file.read();                                     // pos 23
        return img;
    }
    MWR_LOG_ERROR("unknown picture format {}", picturePath);
    return img;
}

// ——————————————————————————————————————————————————————————————————————————————————————————————————————————————————————————————————————————————————————————————————————————————————————————————————————
class RegisterTable {
  public:
    virtual ps_ptr<char> get_name() = 0;
    virtual bool         is_enabled() = 0;
    virtual void         disable() = 0;
    virtual bool         positionXY(uint16_t, uint16_t) = 0;
    virtual void         hide() = 0;
    virtual void         getBounds(int16_t& x, int16_t& y, int16_t& w, int16_t& h) = 0;
    virtual bool         set_focus(bool) = 0;
    virtual ~RegisterTable() {}
};
static std::vector<RegisterTable*> registertable_objects;
static void                        register_object(RegisterTable* obj) {
    registertable_objects.push_back(obj);
}
inline void get_registered_names() {
    ps_ptr<char> rn;
    rn.set_name("rn");
    int16_t x = 0, y = 0, w = 0, h = 0;
    for (auto obj : registertable_objects) {
        rn.assignf(ANSI_ESC_RESET "    registered object:" ANSI_ESC_YELLOW " {:27}" ANSI_ESC_RESET " is enabled: {}" ANSI_ESC_RESET ",", obj->get_name(),
                   obj->is_enabled() ? ANSI_ESC_RED "yes" : ANSI_ESC_BLUE " no");
        obj->getBounds(x, y, w, h);
        rn.appendf(" x: {:4}, y: {:4}, w: {:4}, h: {:4}", x, y, w, h);
        rn.println();
    }
}
inline void disableAllObjects() {
    for (auto obj : registertable_objects) { obj->disable(); }
}
inline void defocusAllObjects() {
    for (auto obj : registertable_objects) { obj->set_focus(false); }
}

inline const char* isObjectClicked(uint16_t x, uint16_t y) {
    static char objName[100];
    objName[0] = '\0';
    for (auto obj : registertable_objects) {
        if (obj->is_enabled() && obj->positionXY(x, y)) {
            if (strlen(objName) > 0) strcat(objName, ", ");
            strcat(objName, obj->get_name().get());
        }
    }
    return objName;
}

inline void hide_objects_in_area(int16_t x, int16_t y, int16_t w, int16_t h) {
    MWR_LOG_DEBUG("hide_objects_in_area");
    int16_t obj_x = 0, obj_y = 0, obj_w = 0, obj_h = 0;
    for (auto obj : registertable_objects) {
        if (obj->is_enabled()) {
            obj->getBounds(obj_x, obj_y, obj_w, obj_h);
            uint16_t left = std::max(x, obj_x);
            uint16_t top = std::max(y, obj_y);
            uint16_t right = std::min<uint32_t>(x + w, obj_x + obj_w);
            uint16_t bottom = std::min<uint32_t>(y + h, obj_y + obj_h);
            if ((left < right) && (top < bottom)) {
                MWR_LOG_DEBUG("Obj {}", obj->get_name());
                obj->hide();
            }
        }
    }
}
// ——————————————————————————————————————————————————————————————————————————————————————————————————————————————————————————————————————————————————————————————————————————————————————————————————————
// *** B A S I C   O B J E C T S
// ——————————————————————————————————————————————————————————————————————————————————————————————————————————————————————————————————————————————————————————————————————————————————————————————————————

enum class ButtonType { PushButton, ToggleButton };

class Button : public RegisterTable {

    enum State { OFF = 0, ON = 1 };
    enum Image { IDLE = 0, CLICK, FOCUS, INACTIVE };

  private:
    bool             m_enabled = false;
    bool             m_focus = false;
    bool             m_clicked = false;
    bool             m_active = true;
    bool             m_state = false;
    bool             m_first_call = true;
    HAlign           m_h_align = HAlign::Center;
    VAlign           m_v_align = VAlign::Middle;
    int16_t          m_x = 0;
    int16_t          m_y = 0;
    int16_t          m_w = 0;
    int16_t          m_h = 0;
    uint16_t         m_button_image_w = 0;
    uint16_t         m_button_image_h = 0;
    uint16_t         m_button_image_x = 0;
    uint16_t         m_button_image_y = 0;
    int32_t          m_bg_color = TFT_BG_IS_WALLPAPER;
    ps_ptr<char>     m_picturePath[2][4];
    ps_ptr<char>     m_name;
    ps_ptr<uint16_t> m_cache_idle_pic = {};
    ps_ptr<uint16_t> m_cache_bg = {};
    releasedArg      m_ra;
    ButtonType       m_type;

  public:
    Button(ps_ptr<char> name, ButtonType type) : m_name(name), m_type(type) {
        register_object(this);
        m_enabled = false;
        m_clicked = false;
    }
    ~Button() {}
    void begin(uint16_t x, uint16_t y, uint16_t w, uint16_t h) {
        m_x = x; // x pos
        m_y = y; // y pos
        m_w = w; // width
        m_h = h; // high
        m_enabled = false;
    }
    ps_ptr<char> get_name() { return m_name; }
    void         enable() { m_enabled = true; }
    void         disable() { m_enabled = false; }
    bool         is_enabled() { return m_enabled; }
    bool         is_active() { return m_active; }
    void         set_active(bool active) { m_active = active; }
    bool         has_focus() { return m_focus; }
    void         set_bg_color(int32_t color) { m_bg_color = color; }
    bool         set_focus(bool focus) { return draw_focus(focus); }
    bool         getValue() { return m_state; }
    void         setOn() { m_state = true; }
    void         setOff() { m_state = false; }

    void show() {
        if (m_bg_color == TFT_BG_IS_CURRENT_VISIBLE) {
            if (m_first_call) { m_cache_bg.alloc_array(m_w * m_h, m_name.c_get()); }
            getTFT().copyFramebuffer(FB_VISIBLE, m_cache_bg.get(), m_x, m_y, m_w, m_h);
        } else if (m_bg_color == TFT_BG_IS_WALLPAPER) { //
            getTFT().copyFramebuffer(FB_BACKGROUND, FB_VISIBLE, m_x, m_y, m_w, m_h);
        } else { // e.g. m_bg_color == TFT_BLACK
            getTFT().fillRect(m_x, m_y, m_w, m_h, m_bg_color);
        }
        if (m_first_call) m_first_call = false;

        if (!m_active) {
            setInactive();
        } else {
            drawImage(pic(IDLE), m_x, m_y, m_w, m_h);
        }
        m_clicked = false;
        m_enabled = true;
        return;
    }

    void hide() {
        if (m_first_call) return;
        if (m_bg_color == TFT_BG_IS_CURRENT_VISIBLE) {
            getTFT().copyFramebuffer(m_cache_bg.get(), FB_VISIBLE, m_x, m_y, m_w, m_h);
        } else if (m_bg_color == TFT_BG_IS_WALLPAPER) {
            getTFT().copyFramebuffer(FB_BACKGROUND, FB_VISIBLE, m_x, m_y, m_w, m_h);
        } else {
            getTFT().fillRect(m_x, m_y, m_w, m_h, m_bg_color);
        }
        m_enabled = false;
    }

    void setValue(bool val) {
        m_state = val;
        if (m_enabled) { drawImage(pic(IDLE), m_x, m_y, m_w, m_h); }
    }

    void getBounds(int16_t& x, int16_t& y, int16_t& w, int16_t& h) override {
        x = m_x;
        y = m_y;
        w = m_w;
        h = m_h;
    }

    void setPicturePath(ps_ptr<char> path) {
        if (m_type == ButtonType::PushButton) {
            m_picturePath[OFF][IDLE] = path + "_idle.png";
            m_picturePath[OFF][CLICK] = path + "_click.png";
            m_picturePath[OFF][FOCUS] = path + "_focus.png";
            m_picturePath[OFF][INACTIVE] = path + "_inactive.png";
        }
        if (m_type == ButtonType::ToggleButton) {
            m_picturePath[OFF][IDLE] = path + "_Off_idle.png";
            m_picturePath[OFF][CLICK] = path + "_Off_click.png";
            m_picturePath[OFF][FOCUS] = path + "_Off_focus.png";
            m_picturePath[OFF][INACTIVE] = path + "_Off_inactive.png";
            m_picturePath[ON][IDLE] = path + "_On_idle.png";
            m_picturePath[ON][CLICK] = path + "_On_click.png";
            m_picturePath[ON][FOCUS] = path + "_On_focus.png";
            m_picturePath[ON][INACTIVE] = path + "_On_inactive.png";
        }

        imgSize img = getImageSize(m_picturePath[OFF][IDLE]);
        m_button_image_w = img.w;
        m_button_image_h = img.h;
        if (m_button_image_w > m_w || m_button_image_h > m_h) {
            MWR_LOG_ERROR("m_button_image_w: {} > m_w or m_button_image_h {} > m_h", m_button_image_w, m_w, m_button_image_h, m_h);
            return;
        }
        m_button_image_x = m_x + (m_w - m_button_image_w) / 2;
        m_button_image_y = m_y + (m_h - m_button_image_h) / 2;
    }

    bool click() {
        if (!m_enabled) return false;
        if (!m_active) return false;
        drawImage(pic(CLICK), m_button_image_x, m_button_image_y, m_button_image_w, m_button_image_h);
        m_clicked = true;
        if (m_type == ButtonType::ToggleButton) m_state = !m_state;
        if (graphicObjects_OnClick) graphicObjects_OnClick(m_name, m_enabled);
        return true;
    }

    bool positionXY(uint16_t x, uint16_t y) {
        if (x < m_x) return false;
        if (y < m_y) return false;
        if (x > m_x + m_w) return false;
        if (y > m_y + m_h) return false;
        return click();
    }

    bool released() {
        if (!m_enabled) return false;
        if (!m_clicked) return false;
        if (!m_active) return false;
        drawImage(pic(IDLE), m_button_image_x, m_button_image_y, m_button_image_w, m_button_image_h);
        m_clicked = false;
        if (graphicObjects_OnRelease) graphicObjects_OnRelease(m_name, m_ra);
        return true;
    }

  private:
    State         currentState() const { return (m_type == ButtonType::ToggleButton && m_state) ? ON : OFF; }
    ps_ptr<char>& pic(Image img) { return m_picturePath[currentState()][img]; }

    bool draw_focus(bool focus) {
        if (!m_active) {
            m_focus = false;
            return false;
        }
        if (!m_enabled) {
            m_focus = false;
            return false;
        }
        if (focus == m_focus) return m_focus;
        if (focus) {
            drawImage(pic(FOCUS), m_button_image_x, m_button_image_y, m_button_image_w, m_button_image_h);
            m_focus = true;
        } else {
            drawImage(pic(IDLE), m_button_image_x, m_button_image_y, m_button_image_w, m_button_image_h);
            m_focus = false;
        }
        return m_focus;
    }

    void setInactive() {
        drawImage(pic(INACTIVE), m_button_image_x, m_button_image_y, m_button_image_w, m_button_image_h);
        // m_enabled = false;
        m_active = false;
    }
};
// ——————————————————————————————————————————————————————————————————————————————————————————————————————————————————————————————————————————————————————————————————————————————————————————————————————
class PictureBox : public RegisterTable {
  private:
    int16_t          m_x = 0;
    int16_t          m_y = 0;
    int16_t          m_w = 0;
    int16_t          m_h = 0;
    uint16_t         m_image_w = 0;
    uint16_t         m_image_h = 0;
    uint16_t         m_image_x = 0;
    uint16_t         m_image_y = 0;
    uint8_t          m_padding_left = 0;   // left margin
    uint8_t          m_padding_right = 0;  // right margin
    uint8_t          m_padding_top = 0;    // top margin
    uint8_t          m_padding_bottom = 0; // bottom margin
    HAlign           m_h_align = HAlign::Center;
    VAlign           m_v_align = VAlign::Middle;
    int32_t          m_bg_color = TFT_BG_IS_WALLPAPER;
    ps_ptr<char>     m_PicturePath;
    ps_ptr<char>     m_name;
    ps_ptr<uint16_t> m_cache_bg = {};
    bool             m_enabled = false;
    bool             m_focus = false;
    bool             m_active = true;
    bool             m_clicked = false;
    bool             m_content_has_changed = true;
    bool             m_init_bg_cache = true;
    releasedArg      m_ra;

  public:
    PictureBox(ps_ptr<char> name) {
        register_object(this);
        m_name = name;
        setPicturePath("");
    }
    ~PictureBox() {}

    void begin(uint16_t x, uint16_t y, uint16_t w, uint16_t h, uint8_t padding_left = 0, uint8_t padding_right = 0, uint8_t padding_top = 0, uint8_t padding_bottom = 0) {
        m_x = x; // x pos
        m_y = y; // y pos
        m_w = w; // width
        m_h = h; // high
        m_padding_left = padding_left;
        m_padding_right = padding_right;
        m_padding_top = padding_top;
        m_padding_bottom = padding_bottom;
        m_enabled = false;
    }

    ps_ptr<char> get_name() { return m_name; }
    void         disable() { m_enabled = false; }
    void         enable() { m_enabled = true; }
    bool         is_enabled() { return m_enabled; }
    bool         is_active() { return m_active; }
    void         set_active(bool active) { m_active = active; }
    bool         has_focus() { return m_focus; }
    bool         set_focus(bool focus) { return false; }

    void set_bg_color(int32_t color) {
        m_bg_color = color;
        if (m_bg_color == TFT_BG_IS_CURRENT_VISIBLE) m_init_bg_cache = true;
    }

    bool show() {
        if (m_bg_color == TFT_BG_IS_CURRENT_VISIBLE) {
            if (m_init_bg_cache) {
                m_cache_bg.alloc_array(m_w * m_h, m_name.c_get());
                getTFT().copyFramebuffer(FB_VISIBLE, m_cache_bg.get(), m_x, m_y, m_w, m_h);
            }
            getTFT().copyFramebuffer(m_cache_bg.get(), FB_VISIBLE, m_x, m_y, m_w, m_h);
        } else if (m_bg_color == TFT_BG_IS_CURRENT_VISIBLE) {
            if (m_init_bg_cache) { m_cache_bg.alloc_array(m_w * m_h, m_name.c_get()); }
            getTFT().copyFramebuffer(FB_VISIBLE, m_cache_bg.get(), m_x, m_y, m_w, m_h);
        } else if (m_bg_color == TFT_BG_IS_WALLPAPER) { //
            if (m_content_has_changed) getTFT().copyFramebuffer(FB_BACKGROUND, FB_VISIBLE, m_x, m_y, m_w, m_h);
        } else { // e.g. m_bg_color == TFT_BLACK
            if (m_content_has_changed) getTFT().fillRect(m_x, m_y, m_w, m_h, m_bg_color);
        }
        m_init_bg_cache = false;
        m_content_has_changed = false;

        if (m_image_w > m_w || m_image_h > m_h) { MWR_LOG_WARN("image {}, w: {}, h: {} > {}x{}", m_PicturePath, m_image_w, m_image_h, m_w, m_h); }
        m_enabled = drawImage(m_PicturePath, m_image_x, m_image_y, m_image_w, m_image_h);
        return m_enabled;
    }

    void hide() {
        if (m_init_bg_cache) return;
        if (m_bg_color == TFT_BG_IS_VISIBLE) {
            getTFT().copyFramebuffer(m_cache_bg.get(), FB_VISIBLE, m_x, m_y, m_w, m_h);
        } else if (m_bg_color == TFT_BG_IS_CURRENT_VISIBLE) {
            getTFT().copyFramebuffer(m_cache_bg.get(), FB_VISIBLE, m_x, m_y, m_w, m_h);
        } else if (m_bg_color == TFT_BG_IS_WALLPAPER) {
            getTFT().copyFramebuffer(FB_BACKGROUND, FB_VISIBLE, m_x, m_y, m_w, m_h);
        } else {
            getTFT().fillRect(m_x, m_y, m_w, m_h, m_bg_color);
        }
        m_enabled = false;
    }

    void getBounds(int16_t& x, int16_t& y, int16_t& w, int16_t& h) override {
        x = m_x;
        y = m_y;
        w = m_w;
        h = m_h;
    }

    void setPicturePath(ps_ptr<char> path) {
        if (m_PicturePath != path) m_content_has_changed = true;
        m_PicturePath = path;
        imgSize img = getImageSize(path);
        m_image_w = img.w;
        m_image_h = img.h;
        align();
    }

    void setAlign(HAlign h_align, VAlign v_align) {
        m_h_align = h_align;
        m_v_align = v_align;
        align();
    }

  private:
    void align() {
        if (m_image_w > m_w) {
            MWR_LOG_ERROR("m_image_w: {} > m_w: {}, {}", m_image_w, m_w, m_PicturePath);
            return;
        }
        if (m_image_h > m_h) {
            MWR_LOG_ERROR("m_image_h: {} > m_h: {}, {}", m_image_h, m_h, m_PicturePath);
            return;
        }
        if (m_padding_left + m_padding_right + m_image_w > m_w) {
            MWR_LOG_WARN("m_padding_left: {}, m_padding_right: {}, m_image_w: {} > m_w; {}, {}", m_padding_left, m_padding_right, m_image_w, m_w, m_PicturePath);
            return;
        }
        if (m_padding_top + m_padding_bottom + m_image_h > m_h) {
            MWR_LOG_WARN("m_padding_top: {}, m_padding_bottom: {}, m_image_h: {} > m_h; {}, {}", m_padding_top, m_padding_bottom, m_image_h, m_h, m_PicturePath);
            return;
        }
        if (m_h_align == HAlign::Left) m_image_x = m_x + m_padding_left;
        if (m_h_align == HAlign::Center) m_image_x = m_x + (m_w - m_image_w) / 2;
        if (m_h_align == HAlign::Right) m_image_x = m_x + (m_w - m_image_w) - m_padding_right;
        if (m_v_align == VAlign::Top) m_image_y = m_y + m_padding_top;
        if (m_v_align == VAlign::Middle) m_image_y = m_y + (m_h - m_image_h) / 2;
        if (m_v_align == VAlign::Bottom) m_image_y = m_y + (m_h - m_image_h) - m_padding_bottom;
    }

  public:
    bool positionXY(uint16_t x, uint16_t y) {
        if (x < m_x) return false;
        if (y < m_y) return false;
        if (x > m_x + m_w) return false;
        if (y > m_y + m_h) return false;
        if (m_enabled) m_clicked = true;
        if (graphicObjects_OnClick) graphicObjects_OnClick(m_name, m_enabled);
        //    if(!m_enabled) return false;
        return true;
    }
    bool released() {
        if (!m_enabled) return false;
        if (!m_clicked) return false;
        m_clicked = false;
        if (graphicObjects_OnRelease) graphicObjects_OnRelease(m_name, m_ra);
        return true;
    }
};
// ——————————————————————————————————————————————————————————————————————————————————————————————————————————————————————————————————————————————————————————————————————————————————————————————————————
class Slider : public RegisterTable {
  private:
    bool             m_enabled = false;
    bool             m_clicked = false;
    bool             m_focus = false;
    bool             m_objectInit = false;
    bool             m_active = true;
    bool             m_content_has_changed = false;
    bool             m_first_call = true;
    int16_t          m_x = 0;
    int16_t          m_y = 0;
    int16_t          m_w = 0;
    int16_t          m_h = 0;
    int16_t          m_val = 0;
    int16_t          m_minVal = 0;
    int16_t          m_maxVal = 0;
    uint16_t         m_leftStop = 0;
    uint16_t         m_rightStop = 0;
    int32_t          m_bg_color = TFT_BG_IS_WALLPAPER;
    int32_t          m_railColor = 0;
    int32_t          m_spotColor = 0;
    uint8_t          m_railHigh = 0;
    uint16_t         m_middle_h = 0;
    uint16_t         m_spotPos = 0;
    uint8_t          m_spotRadius = 0;
    uint8_t          m_padding_left = 0;
    uint8_t          m_padding_right = 0;
    uint8_t          m_padding_top = 0;
    uint8_t          m_padding_bottom = 0;
    ps_ptr<char>     m_name;
    ps_ptr<uint16_t> m_cache_bg = {};
    ps_ptr<uint16_t> m_cache_slider_base = {};
    releasedArg      m_ra;

  public:
    Slider(ps_ptr<char> name) {
        register_object(this);
        m_name = name;
        m_railHigh = 6;
        m_spotRadius = 12;
        m_railColor = TFT_BEIGE;
        m_spotColor = TFT_RED;
    }
    ~Slider() { m_objectInit = false; }

    void begin(uint16_t x, uint16_t y, uint16_t w, uint16_t h, uint8_t paddig_left, uint8_t paddig_right, uint8_t paddig_top, uint8_t paddig_bottom) {
        m_x = x; // x pos
        m_y = y; // y pos
        m_w = w; // width
        m_h = h; // high
        m_padding_left = paddig_left;
        m_padding_right = paddig_right;
        m_padding_top = paddig_top;       // unused
        m_padding_bottom = paddig_bottom; // unused
        m_railHigh = m_h / 8;
        m_spotRadius = m_h / 4;
        m_leftStop = m_x + m_padding_left + m_spotRadius + 10;         // x pos left stop
        m_rightStop = m_x + m_w - m_padding_right - m_spotRadius - 10; // x pos right stop
        m_enabled = false;
        m_middle_h = m_y + (m_h / 2);
        m_spotPos = (m_leftStop + m_rightStop) / 2; // in the middle
        m_objectInit = true;
    }

    ps_ptr<char> get_name() { return m_name; }
    void         disable() { m_enabled = false; }
    void         enable() { m_enabled = true; }
    bool         is_enabled() { return m_enabled; }
    bool         is_active() { return m_active; }
    void         set_active(bool active) { m_active = active; }
    bool         has_focus() { return m_focus; }
    void         set_bg_color(int32_t color) { m_bg_color = color; }
    bool         set_focus(bool focus) { return false; }

    void show() {
        if (m_bg_color == TFT_BG_IS_CURRENT_VISIBLE) {
            if (m_first_call) { m_cache_bg.alloc_array(m_w * m_h, m_name.c_get()); }
            getTFT().copyFramebuffer(FB_VISIBLE, m_cache_bg.get(), m_x, m_y, m_w, m_h);
        } else if (m_bg_color == TFT_BG_IS_WALLPAPER) { //
            getTFT().copyFramebuffer(FB_BACKGROUND, FB_VISIBLE, m_x, m_y, m_w, m_h);
        } else { // e.g. m_bg_color == TFT_BLACK
            getTFT().fillRect(m_x, m_y, m_w, m_h, m_bg_color);
        }
        m_enabled = true;
        int x = m_x + m_padding_left;
        int y = m_middle_h - (m_railHigh / 2);
        int w = m_w - m_padding_left - m_padding_right;
        int h = m_railHigh;
        (void)h;
        int r = m_railHigh / 4;
        getTFT().fillRoundRect(x, y, w, m_railHigh, r, m_railColor);
        if (m_first_call) {
            m_cache_slider_base.alloc_array(m_w * m_h, m_name.c_get());
            getTFT().copyFramebuffer(FB_VISIBLE, m_cache_slider_base.get(), m_x, m_y, m_w, m_h);
        }
        drawNewSpot(m_val);
        m_first_call = false;
    }

    void hide() {
        if (m_first_call) return;
        if (m_bg_color == TFT_BG_IS_CURRENT_VISIBLE) {
            getTFT().copyFramebuffer(m_cache_bg.get(), FB_VISIBLE, m_x, m_y, m_w, m_h);
        } else if (m_bg_color == TFT_BG_IS_WALLPAPER) {
            getTFT().copyFramebuffer(FB_BACKGROUND, FB_VISIBLE, m_x, m_y, m_w, m_h);
        } else {
            getTFT().fillRect(m_x, m_y, m_w, m_h, m_bg_color);
        }
        m_enabled = false;
    }

    void setMinMaxVal(int16_t minVal, int16_t maxVal) {
        m_minVal = minVal;
        m_maxVal = maxVal;
    }

    void getBounds(int16_t& x, int16_t& y, int16_t& w, int16_t& h) override {
        x = m_x;
        y = m_y;
        w = m_w;
        h = m_h;
    }

    bool positionXY(uint16_t x, uint16_t y) {
        if (x < m_x) return false;
        if (y < m_y) return false;
        if (x > m_x + m_w) return false;
        if (y > m_y + m_h) return false;

        if (m_enabled) {
            if (x < m_leftStop) x = m_leftStop; // (x, y) is in range
            if (x > m_rightStop) x = m_rightStop;
            m_clicked = true;
            drawNewSpot(x);
        }
        if (!m_clicked) {
            if (graphicObjects_OnClick) graphicObjects_OnClick(m_name, m_enabled);
        }
        if (!m_enabled) return false;
        return true;
    }
    void setValue(int16_t val) {
        if (!m_objectInit) return;
        if (val < m_minVal) val = m_minVal;
        if (val > m_maxVal) val = m_maxVal;
        m_val = val;
        if (m_clicked) return;
        if (m_enabled) { drawNewSpot(val); }
    }

    int16_t getValue() { return m_val; }

    bool released() {
        if (!m_enabled) return false;
        if (!m_clicked) return false;
        m_clicked = false;
        if (graphicObjects_OnRelease) graphicObjects_OnRelease(m_name, m_ra);
        return true;
    }

  private:
    int32_t map_l(int32_t x, int32_t in_min, int32_t in_max, int32_t out_min, int32_t out_max) {
        const int32_t run = in_max - in_min;
        if (run == 0) {
            MWR_LOG_ERROR("map(): Invalid input range, {} == {} (min == max) in {}", in_min, in_max, m_name);
            return -1;
        }
        const int32_t rise = out_max - out_min;
        const int32_t delta = x - in_min;
        return round((float)(delta * rise) / run + out_min);
    }

    void drawNewSpot(uint16_t xPos) {
        if (m_enabled) {
            const uint16_t oldX = m_spotPos - m_spotRadius - 1;
            const uint16_t oldY = m_middle_h - m_spotRadius - 1;
            const uint16_t newX = xPos - m_spotRadius - 1;
            const uint16_t boxW = 2 * m_spotRadius + 2;
            const uint16_t boxH = 2 * m_spotRadius + 2;

            if (m_cache_slider_base.valid()) {
                const uint16_t srcX = oldX - m_x;
                const uint16_t srcY = oldY - m_y;
                const uint16_t dirtyX = oldX < newX ? oldX : newX;
                const uint16_t dirtyY = oldY;
                const uint16_t dirtyRight = oldX > newX ? oldX + boxW : newX + boxW;
                const uint16_t dirtyW = dirtyRight - dirtyX;

                getTFT().copyFramebuffer(m_cache_slider_base.get(), m_w, m_h, srcX, srcY, FB_VISIBLE, oldX, oldY, boxW, boxH, false);
                getTFT().fillCircle(xPos, m_middle_h, m_spotRadius, m_spotColor, false);
                getTFT().drawRectLogicalFromFB(FB_VISIBLE, dirtyX, dirtyY, dirtyW, boxH);
            } else {
                getTFT().fillCircle(xPos, m_middle_h, m_spotRadius, m_spotColor);
            }
        }
        m_spotPos = xPos;
        int32_t val = map_l(m_spotPos, m_leftStop, m_rightStop, m_minVal, m_maxVal); // xPos -> val
        m_ra.val1 = val;
        m_val = val;
        if (graphicObjects_OnChange) graphicObjects_OnChange(m_name, val);
    }

    void drawNewSpot(int16_t val) {
        uint16_t xPos = map_l(val, m_minVal, m_maxVal, m_leftStop, m_rightStop); // val -> x
        if (m_enabled) {
            const uint16_t oldX = m_spotPos - m_spotRadius - 1;
            const uint16_t oldY = m_middle_h - m_spotRadius - 1;
            const uint16_t newX = xPos - m_spotRadius - 1;
            const uint16_t boxW = 2 * m_spotRadius + 2;
            const uint16_t boxH = 2 * m_spotRadius + 2;

            if (m_cache_slider_base.valid()) {
                const uint16_t srcX = oldX - m_x;
                const uint16_t srcY = oldY - m_y;
                const uint16_t dirtyX = oldX < newX ? oldX : newX;
                const uint16_t dirtyY = oldY;
                const uint16_t dirtyRight = oldX > newX ? oldX + boxW : newX + boxW;
                const uint16_t dirtyW = dirtyRight - dirtyX;

                getTFT().copyFramebuffer(m_cache_slider_base.get(), m_w, m_h, srcX, srcY, FB_VISIBLE, oldX, oldY, boxW, boxH, false);
                getTFT().fillCircle(xPos, m_middle_h, m_spotRadius, m_spotColor, false);
                getTFT().drawRectLogicalFromFB(FB_VISIBLE, dirtyX, dirtyY, dirtyW, boxH);
            } else {
                getTFT().fillCircle(xPos, m_middle_h, m_spotRadius, m_spotColor);
            }
        }
        m_spotPos = xPos;
        m_ra.val1 = val;
        m_val = val;
        if (graphicObjects_OnChange) graphicObjects_OnChange(m_name, val);
    }
};
// ——————————————————————————————————————————————————————————————————————————————————————————————————————————————————————————————————————————————————————————————————————————————————————————————————————
class Progressbar : public RegisterTable {
  private:
    int16_t      m_x = 0;
    int16_t      m_y = 0;
    int16_t      m_w = 0;
    int16_t      m_h = 0;
    int16_t      m_val = 0;
    int16_t      m_minVal = 0;
    int16_t      m_maxVal = 0;
    int16_t      m_oldPos = 0;
    uint16_t     m_padding_left = 0;
    uint16_t     m_padding_right = 0;
    uint16_t     m_padding_top = 0;
    uint16_t     m_padding_bottom = 0;
    uint16_t     m_railHight = 0;
    uint16_t     m_rail_y_pos = 0;
    int32_t      m_bg_color = TFT_BG_IS_WALLPAPER;
    int32_t      m_frameColor = 0;
    int32_t      m_railColorLeft = 0;
    uint32_t     m_railColorRight = 0;
    bool         m_enabled = false;
    bool         m_focus = false;
    bool         m_active = true;
    bool         m_clicked = false;
    bool         m_objectInit = false;
    bool         m_content_has_changed = false;
    bool         m_first_call = true;
    ps_ptr<char> m_name;
    releasedArg  m_ra;

  public:
    Progressbar(ps_ptr<char> name) {
        register_object(this);
        m_name = name;
        m_frameColor = TFT_WHITE;
        m_railColorLeft = TFT_RED;
        m_railColorRight = TFT_GREEN;
    }
    ~Progressbar() { m_objectInit = false; }

    void begin(uint16_t x, uint16_t y, uint16_t w, uint16_t h, uint16_t padding_left, uint16_t padding_right, uint16_t padding_top, uint16_t padding_bottom, int16_t minVal, int16_t maxVal) {
        m_x = x; // x pos
        m_y = y; // y pos
        m_w = w; // width
        m_h = h; // high
        m_padding_left = padding_left;
        m_padding_right = padding_right;
        m_padding_top = padding_top;
        m_padding_bottom = padding_bottom;
        m_railHight = m_h / 4;
        m_rail_y_pos = m_y + m_h / 2;
        m_minVal = minVal;
        m_maxVal = maxVal;
        m_enabled = false;
        m_objectInit = true;
    }

    ps_ptr<char> get_name() { return m_name; }
    void         disable() { m_enabled = false; }
    void         enable() { m_enabled = true; }
    bool         is_enabled() { return m_enabled; }
    bool         is_active() { return m_active; }
    void         set_active(bool active) { m_active = active; }
    bool         has_focus() { return m_focus; }
    void         set_bg_color(int32_t color) { m_bg_color = color; }
    bool         set_focus(bool focus) { return false; }

    void show() {
        if (m_first_call) { m_first_call = false; }
        if (m_bg_color == TFT_BG_IS_WALLPAPER) {
            getTFT().copyFramebuffer(FB_BACKGROUND, FB_VISIBLE, m_x, m_y, m_w, m_h);
        } else {
            getTFT().fillRect(m_x, m_y, m_w, m_h, m_bg_color);
        }
        getTFT().drawRect(m_x + m_padding_left, m_rail_y_pos, m_w - m_padding_left - m_padding_right, m_railHight, m_frameColor); // draw border
        drawNewValue();
        m_enabled = true;
    }

    void hide() {
        if (m_first_call) return;
        if (m_bg_color == TFT_BG_IS_WALLPAPER) {
            getTFT().copyFramebuffer(FB_BACKGROUND, FB_VISIBLE, m_x, m_y, m_w, m_h);
        } else {
            getTFT().fillRect(m_x, m_y, m_w, m_h, m_bg_color);
        }
        m_enabled = false;
    }

    void getBounds(int16_t& x, int16_t& y, int16_t& w, int16_t& h) override {
        x = m_x;
        y = m_y;
        w = m_w;
        h = m_h;
    }

    bool positionXY(uint16_t x, uint16_t y) {
        if (x < m_x) return false;
        if (y < m_y) return false;
        if (x > m_x + m_w) return false;
        if (y > m_y + m_h) return false;
        if (m_enabled) m_clicked = true;
        m_ra.val1 = map_l(x, m_x + 1, m_x + m_w - 2, m_minVal, m_maxVal);
        m_ra.val2 = m_ra.val1 - m_val; // offset
        if (graphicObjects_OnClick) graphicObjects_OnClick(m_name, m_enabled);
        if (!m_enabled) return false;
        return true;
    }
    void setValue(int16_t val) {
        if (!m_objectInit) return;
        if (val < m_minVal) val = m_minVal;
        if (val > m_maxVal) val = m_maxVal;
        m_val = val;
        if (m_clicked) return;
        if (m_enabled) drawChanges();
    }
    int16_t getValue() { return m_val; }
    void    setNewMinMaxVal(int16_t minVal, int16_t maxVal) {
        m_minVal = minVal;
        m_maxVal = maxVal;
    }

    bool released() {
        if (!m_enabled) return false;
        if (!m_clicked) return false;
        m_clicked = false;
        if (graphicObjects_OnRelease) graphicObjects_OnRelease(m_name, m_ra);
        return true;
    }
    void reset() {
        m_val = m_minVal;
        getTFT().fillRect(m_x, m_rail_y_pos + 1, m_w - m_railHight - 1, m_railHight - 2, m_railColorRight);
    }

  private:
    int32_t map_l(int32_t x, int32_t in_min, int32_t in_max, int32_t out_min, int32_t out_max) {
        const int32_t run = in_max - in_min;
        if (run == 0) {
            MWR_LOG_WARN("map(): Invalid input range, {} == {} (min == max) in {}", in_min, in_max, m_name);
            return -1;
        }
        const int32_t rise = out_max - out_min;
        const int32_t delta = x - in_min;
        return round((float)(delta * rise) / run + out_min);
    }
    void drawNewValue() {
        int      x = m_x + 1 + m_padding_left;
        int      w = m_w - 1 - m_padding_right;
        uint16_t pos = map_l(m_val, m_minVal, m_maxVal, x, x + w);
        getTFT().fillRect(x, m_rail_y_pos + 1, pos, m_railHight - 2, m_railColorLeft);
        getTFT().fillRect(pos, m_rail_y_pos + 1, w - pos, m_railHight - 2, m_railColorRight);
        m_oldPos = pos;
        if (graphicObjects_OnChange) graphicObjects_OnChange(m_name, m_val);
    }
    void drawChanges() {
        int      x = m_x + 1 + m_padding_left;
        int      w = m_w - 1 - m_padding_right;
        uint16_t pos = map_l(m_val, m_minVal, m_maxVal, x, x + w);
        if (pos > m_oldPos) { getTFT().fillRect(m_oldPos, m_rail_y_pos + 1, pos - m_oldPos, m_railHight - 2, m_railColorLeft); }
        if (pos < m_oldPos) { getTFT().fillRect(pos, m_rail_y_pos + 1, m_oldPos - pos, m_railHight - 2, m_railColorRight); }
        m_oldPos = pos;
        if (graphicObjects_OnChange) graphicObjects_OnChange(m_name, m_val);
    }
};
// ——————————————————————————————————————————————————————————————————————————————————————————————————————————————————————————————————————————————————————————————————————————————————————————————————————
class Textbox : public RegisterTable {
  private:
    bool             m_enabled = false;
    bool             m_focus = false;
    bool             m_active = true;
    bool             m_clicked = false;
    bool             m_autoSize = false;
    bool             m_noWrap = false;
    bool             m_content_has_changed = false;
    bool             m_init_bg_cache = true;
    int16_t          m_x = 0;
    int16_t          m_y = 0;
    int16_t          m_w = 0;
    int16_t          m_h = 0;
    uint8_t          m_fontSize = 0;
    HAlign           m_h_align = HAlign::Center;
    VAlign           m_v_align = VAlign::Middle;
    uint8_t          m_padding_left = 0;  // left margin
    uint8_t          m_paddig_right = 0;  // right margin
    uint8_t          m_paddig_top = 0;    // top margin
    uint8_t          m_paddig_bottom = 0; // bottom margin
    int32_t          m_bg_color = TFT_BG_IS_WALLPAPER;
    int32_t          m_fill_color1 = TFT_BG_IS_WALLPAPER;
    int32_t          m_fill_color2 = TFT_BG_IS_WALLPAPER;
    int32_t          m_textColor = 0;
    int32_t          m_border_color = 0;
    uint8_t          m_border_radius = 0;
    bool             m_gradient_orientation = false; // false horizontal, true vertical
    ps_ptr<char>     m_text;
    ps_ptr<char>     m_name;
    ps_ptr<uint16_t> m_cache_bg = {};
    releasedArg      m_ra;

  public:
    Textbox(ps_ptr<char> name) {
        register_object(this);
        m_name = name;
        m_textColor = TFT_LIGHTGREY;
        m_border_color = TFT_BG_IS_WALLPAPER;
        m_fontSize = 1;
    }
    ~Textbox() {}
    void begin(uint16_t x, uint16_t y, uint16_t w, uint16_t h, uint8_t paddig_left, uint8_t paddig_right, uint8_t paddig_top, uint8_t paddig_bottom) {
        m_x = x; // x pos
        m_y = y; // y pos
        m_w = w; // width
        m_h = h; // high
        m_padding_left = paddig_left;
        m_paddig_right = paddig_right;
        m_paddig_top = paddig_top;
        m_paddig_bottom = paddig_bottom;
    }

    ps_ptr<char> get_name() { return m_name; }
    void         disable() { m_enabled = false; }
    void         enable() { m_enabled = true; }
    bool         is_enabled() { return m_enabled; }
    bool         is_active() { return m_active; }
    void         set_active(bool active) { m_active = active; }
    bool         has_focus() { return m_focus; }
    bool         set_focus(bool focus) { return false; }

    void set_bg_color(int32_t color) {
        m_bg_color = color;
        m_bg_color == TFT_BG_IS_CURRENT_VISIBLE ? m_init_bg_cache = true : m_init_bg_cache = false;
        m_bg_color == TFT_BG_IS_VISIBLE ? m_init_bg_cache = true : m_init_bg_cache = false;
    }

    void show() {
        if (m_bg_color == TFT_BG_IS_CURRENT_VISIBLE) {
            if (m_init_bg_cache) { m_cache_bg.alloc_array(m_w * m_h, m_name.c_get()); }
            getTFT().copyFramebuffer(FB_VISIBLE, m_cache_bg.get(), m_x, m_y, m_w, m_h);
        }
        if (m_bg_color == TFT_BG_IS_VISIBLE) {
            if (m_init_bg_cache) {
                m_cache_bg.alloc_array(m_w * m_h, m_name.c_get());
                getTFT().copyFramebuffer(FB_VISIBLE, m_cache_bg.get(), m_x, m_y, m_w, m_h);
            }
            getTFT().copyFramebuffer(m_cache_bg.get(), FB_VISIBLE, m_x, m_y, m_w, m_h);

        } else if (m_bg_color == TFT_BG_IS_WALLPAPER) { //
            if (m_content_has_changed) getTFT().copyFramebuffer(FB_BACKGROUND, FB_VISIBLE, m_x, m_y, m_w, m_h);
        } else if (m_bg_color == TFT_BG_OVERWRITE) {
            ;    // do nothing but write only
        } else { // e.g. m_bg_color == TFT_BLACK
            if (m_content_has_changed) getTFT().fillRect(m_x, m_y, m_w, m_h, m_bg_color);
        }
        m_init_bg_cache = false;
        m_content_has_changed = false;
        m_enabled = true;
        m_clicked = false;
        writeText(m_text);
    }

    void hide() {
        if (m_init_bg_cache) return;
        if (m_bg_color == TFT_BG_IS_CURRENT_VISIBLE) {
            getTFT().copyFramebuffer(m_cache_bg.get(), FB_VISIBLE, m_x, m_y, m_w, m_h);
        } else if (m_bg_color == TFT_BG_IS_WALLPAPER) {
            getTFT().copyFramebuffer(FB_BACKGROUND, FB_VISIBLE, m_x, m_y, m_w, m_h);
        } else {
            getTFT().fillRect(m_x, m_y, m_w, m_h, m_bg_color);
        }
        m_enabled = false;
    }

    void setBounds(int16_t x, int16_t y, int16_t w, int16_t h) {
        bool new_bounds = false;
        if (m_x != x) {
            m_x = x;
            new_bounds = true;
        }
        if (m_y != y) {
            m_y = y;
            new_bounds = true;
        }
        if (m_w != w) {
            m_w = w;
            new_bounds = true;
        }
        if (m_h != h) {
            m_h = h;
            new_bounds = true;
        }
        if (new_bounds) {
            m_init_bg_cache = true;
            if (m_enabled) {
                hide();
                show();
            }
        }
    }

    void getBounds(int16_t& x, int16_t& y, int16_t& w, int16_t& h) override {
        x = m_x;
        y = m_y;
        w = m_w;
        h = m_h;
    }

    void setFontSize(uint8_t size) { // size 0 -> auto, choose besr font size
        m_fontSize = 0;
        if (size != 0) {
            m_fontSize = size;
            getTFT().setFontSize(m_fontSize);
        } else {
            m_autoSize = true;
        }
    }
    void setTextColor(int32_t color) { m_textColor = color; }

    void set_border(int32_t border_color = TFT_LIGHTGREY, uint8_t border_radius = 0, int32_t fill_color1 = TFT_BG_IS_WALLPAPER, int32_t fill_color2 = TFT_BG_IS_WALLPAPER, bool orientation = false) {
        m_border_color = border_color; // TFT_BG_IS_WALLPAPER -> no border
        m_border_radius = border_radius;
        m_fill_color1 = fill_color1;          // TFT_BG_IS_WALLPAPER -> no fill
        m_fill_color2 = fill_color2;          // TFT_BG_IS_WALLPAPER -> no fill gradient
        m_gradient_orientation = orientation; // false: horizontal
    }

    bool positionXY(uint16_t x, uint16_t y) {
        if (x < m_x) return false;
        if (y < m_y) return false;
        if (x > m_x + m_w) return false;
        if (y > m_y + m_h) return false;
        if (m_enabled) m_clicked = true;
        if (graphicObjects_OnClick) graphicObjects_OnClick(m_name, m_enabled);
        if (!m_enabled) return false;
        return true;
    }
    bool released() {
        if (!m_enabled) return false;
        if (!m_clicked) return false;
        m_clicked = false;
        if (graphicObjects_OnRelease) graphicObjects_OnRelease(m_name, m_ra);
        return true;
    }

    //------------------------------------------------------------------------------------------------------------------------------------------------
    template <typename T, typename = std::enable_if_t<std::is_arithmetic_v<T>>> void setText(T txt) {
        static char ret[24];
        auto [ptr, ec] = std::to_chars(ret, ret + sizeof(ret) - 1, txt);
        if (ec != std::errc{}) {
            MWR_LOG_ERROR("is not mumeric: {}", txt);
            return;
        }
        *ptr = '\0';
        setText(ret);
    }

    void setText(const char* txt) { setText(ps_ptr<char>(txt)); }

    void setText(ps_ptr<char> txt) { // prepare a text, wait of show() to write it
        if (m_text != txt) {
            m_content_has_changed = true;
            m_text = txt;
        }
    }
    //------------------------------------------------------------------------------------------------------------------------------------------------

    void setNoWrap(bool noWrap) { m_noWrap = noWrap; }

    void setAlign(HAlign h_align, VAlign v_align) {
        m_h_align = h_align;
        m_v_align = v_align;
    }

  private:
    void writeText(ps_ptr<char> txt) {
        if (!txt.valid()) return;
        if (m_enabled) {
            if (m_fontSize != 0) { getTFT().setFontSize(m_fontSize); }
            int x = m_x + m_padding_left;
            int y = m_y + m_paddig_top;
            int w = m_w - (m_paddig_right + m_padding_left);
            int h = m_h - (m_paddig_bottom + m_paddig_top);
            if (m_fill_color1 != TFT_BG_IS_WALLPAPER) {
                if (m_fill_color2 == TFT_BG_IS_WALLPAPER) {
                    getTFT().fillRoundRect(x, y, w, h, m_border_radius, m_fill_color1);
                } else {
                    getTFT().fillRoundRect(x, y, w, h, m_border_radius, m_fill_color1, m_fill_color2, m_gradient_orientation); // with gradient
                }
            }
            if (m_border_color != TFT_BG_IS_WALLPAPER) {
                if (m_border_radius) {
                    getTFT().drawRoundRect(x, y, w, h, m_border_radius, m_border_color);
                } else {
                    getTFT().drawRect(x, y, w, h, m_border_color);
                }
            }
            getTFT().setTextColor(m_textColor);
            getTFT().writeText(txt, x, y, w, h, m_h_align, m_v_align, m_noWrap, m_autoSize);
        }
    }
};
// ——————————————————————————————————————————————————————————————————————————————————————————————————————————————————————————————————————————————————————————————————————————————————————————————————————
class Inputbox : public RegisterTable {
  private:
    int16_t      m_x = 0;
    int16_t      m_y = 0;
    int16_t      m_w = 0;
    int16_t      m_h = 0;
    uint8_t      m_fontSize = 0;
    HAlign       m_h_align = HAlign::Right;
    VAlign       m_v_align = VAlign::Top;
    uint8_t      m_padding_left = 0;  // left margin
    uint8_t      m_paddig_right = 0;  // right margin
    uint8_t      m_paddig_top = 0;    // top margin
    uint8_t      m_paddig_bottom = 0; // bottom margin
    uint8_t      m_borderWidth = 0;
    int32_t      m_bg_color = TFT_BG_IS_WALLPAPER;
    int32_t      m_fgColor = 0;
    int32_t      m_borderColor = 0;
    ps_ptr<char> m_text;
    ps_ptr<char> m_name;
    bool         m_enabled = false;
    bool         m_focus = false;
    bool         m_active = true;
    bool         m_clicked = false;
    bool         m_autoSize = false;
    bool         m_noWrap = false;
    bool         m_first_call = true;
    releasedArg  m_ra;

  public:
    Inputbox(ps_ptr<char> name) {
        register_object(this);
        m_name = name;
        m_fgColor = TFT_LIGHTGREY;
        m_borderColor = TFT_BLACK;
        m_fontSize = 1;
    }
    ~Inputbox() {}
    void begin(uint16_t x, uint16_t y, uint16_t w, uint16_t h, uint8_t paddig_left, uint8_t paddig_right, uint8_t paddig_top, uint8_t paddig_bottom) {
        m_x = x; // x pos
        m_y = y; // y pos
        m_w = w; // width
        m_h = h; // high
        m_padding_left = paddig_left;
        m_paddig_right = paddig_right;
        m_paddig_top = paddig_top;
        m_paddig_bottom = paddig_bottom;
    }
    ps_ptr<char> get_name() { return m_name; }
    void         disable() { m_enabled = false; }
    void         enable() { m_enabled = true; }
    bool         is_enabled() { return m_enabled; }
    bool         is_active() { return m_active; }
    void         set_active(bool active) { m_active = active; }
    bool         has_focus() { return m_focus; }
    void         set_bg_color(int32_t color) { m_bg_color = color; }
    bool         set_focus(bool focus) { return false; }

    void show() {
        if (m_first_call) { m_first_call = false; }
        if (m_bg_color == TFT_BG_IS_WALLPAPER) {
            getTFT().copyFramebuffer(FB_BACKGROUND, FB_VISIBLE, m_x, m_y, m_w, m_h);
        } else {
            getTFT().fillRect(m_x, m_y, m_w, m_h, m_bg_color);
        }
        m_enabled = true;
        m_clicked = false;
        writeText(m_text);
    }

    void hide() {
        if (m_first_call) return;
        if (m_bg_color == TFT_BG_IS_WALLPAPER) {
            getTFT().copyFramebuffer(FB_BACKGROUND, FB_VISIBLE, m_x, m_y, m_w, m_h);
        } else {
            getTFT().fillRect(m_x, m_y, m_w, m_h, m_bg_color);
        }
        m_enabled = false;
    }

    void getBounds(int16_t& x, int16_t& y, int16_t& w, int16_t& h) override {
        x = m_x;
        y = m_y;
        w = m_w;
        h = m_h;
    }

    void setFontSize(uint8_t size) { // size 0 -> auto, choose besr font size
        m_fontSize = 0;
        if (size != 0) {
            m_fontSize = size;
            getTFT().setFontSize(m_fontSize);
        } else {
            m_autoSize = true;
        }
    }
    void setTextColor(uint32_t color) { m_fgColor = color; }
    void setBorderColor(uint32_t color) { m_borderColor = color; }
    void setBorderWidth(uint8_t width) { // 0 = no border
        m_borderWidth = width;
        if (m_borderWidth > 2) m_borderWidth = 2;
        m_padding_left = m_padding_left + m_borderWidth;
        m_paddig_right = m_paddig_right + m_borderWidth;
        m_paddig_top = m_paddig_top + m_borderWidth;
        m_paddig_bottom = m_paddig_bottom + m_borderWidth;
    }
    bool positionXY(uint16_t x, uint16_t y) {
        if (x < m_x) return false;
        if (y < m_y) return false;
        if (x > m_x + m_w) return false;
        if (y > m_y + m_h) return false;
        if (m_enabled) m_clicked = true;
        if (graphicObjects_OnClick) graphicObjects_OnClick(m_name, m_enabled);
        if (!m_enabled) return false;
        return true;
    }
    bool released() {
        if (!m_enabled) return false;
        if (!m_clicked) return false;
        m_clicked = false;
        if (graphicObjects_OnRelease) graphicObjects_OnRelease(m_name, m_ra);
        return true;
    }
    void setText(ps_ptr<char> txt, bool noWrap = false) { // prepare a text, wait of show() to write it
        m_text = txt;
        m_noWrap = noWrap;
    }
    void setAlign(HAlign h_align, VAlign v_align) {
        m_h_align = h_align;
        m_v_align = v_align;
    }
    void writeText(ps_ptr<char> txt) {
        m_text = txt;
        if (m_enabled) {
            uint16_t txtColor_tmp = getTFT().getTextColor();
            uint16_t bgColor_tmp = getTFT().getBackGroundColor();
            getTFT().setTextColor(m_fgColor);
            getTFT().setBackGoundColor(m_bg_color);
            if (m_bg_color == TFT_BG_IS_WALLPAPER) {
                getTFT().copyFramebuffer(FB_BACKGROUND, FB_VISIBLE, m_x, m_y, m_w, m_h);
            } else {
                getTFT().fillRect(m_x, m_y, m_w, m_h, m_bg_color);
            }
            if (m_fontSize != 0) { getTFT().setFontSize(m_fontSize); }
            int x = m_x + m_padding_left;
            int y = m_y + m_paddig_top;
            int w = m_w - (m_paddig_right + m_padding_left);
            int h = m_h - (m_paddig_bottom + m_paddig_top);
            if (m_borderWidth > 0) { getTFT().drawRect(m_x, m_y, m_w, m_h, m_borderColor); }
            if (m_borderWidth > 1) { getTFT().drawRect(m_x + 1, m_y + 1, m_w - 2, m_h - 2, m_borderColor); }

            getTFT().writeText(m_text.get(), x, y, w, h, m_h_align, m_v_align, m_noWrap, false);
            getTFT().setTextColor(txtColor_tmp);
            getTFT().setBackGoundColor(bgColor_tmp);
        }
    }
};
// ——————————————————————————————————————————————————————————————————————————————————————————————————————————————————————————————————————————————————————————————————————————————————————————————————————
class Textbutton : public RegisterTable {
  private:
    int16_t      m_x = 0;
    int16_t      m_y = 0;
    int16_t      m_w = 0;
    int16_t      m_h = 0;
    int16_t      m_r = 0; // radius round rect
    uint8_t      m_fontSize = 0;
    HAlign       m_h_align = HAlign::Right;
    VAlign       m_v_align = VAlign::Top;
    uint8_t      m_padding_left = 0;  // left margin
    uint8_t      m_paddig_right = 0;  // right margin
    uint8_t      m_paddig_top = 0;    // top margin
    uint8_t      m_paddig_bottom = 0; // bottom margin
    uint8_t      m_borderWidth = 0;
    int32_t      m_bg_color = TFT_BG_IS_WALLPAPER;
    int32_t      m_fgColor = 0;
    int32_t      m_borderColor = 0;
    int32_t      m_clickColor = 0;
    ps_ptr<char> m_text;
    ps_ptr<char> m_name;
    bool         m_enabled = false;
    bool         m_focus = false;
    bool         m_active = true;
    bool         m_clicked = false;
    bool         m_autoSize = false;
    bool         m_noWrap = false;
    bool         m_content_has_changed = false;
    bool         m_first_call = true;
    releasedArg  m_ra;

  public:
    Textbutton(ps_ptr<char> name) {
        register_object(this);
        m_name = name;
        m_fgColor = TFT_LIGHTGREY;
        m_borderColor = TFT_BLACK;
        m_fontSize = 1;
    }
    void drawTriangeUp() {
        int16_t  x0 = m_x + m_padding_left;
        int16_t  y0 = m_y + m_h - m_paddig_bottom;
        int16_t  x1 = m_x + m_w - m_paddig_right;
        int16_t  y1 = m_y + m_h - m_paddig_bottom;
        int16_t  x2 = x0 + (x1 - x0) / 2;
        int16_t  y2 = m_y + m_paddig_top;
        uint32_t color = m_fgColor;
        if (m_clicked) color = m_clickColor;
        getTFT().fillTriangle(x0, y0, x1, y1, x2, y2, color);
    }
    void drawTriangeDown() {
        int16_t  x0 = m_x + m_padding_left;
        int16_t  y0 = m_y + m_paddig_top;
        int16_t  x1 = m_x + m_w - m_paddig_right;
        int16_t  y1 = m_y + m_paddig_top;
        int16_t  x2 = x0 + (x1 - x0) / 2;
        int16_t  y2 = m_y + m_h - m_paddig_bottom;
        uint32_t color = m_fgColor;
        if (m_clicked) color = m_clickColor;
        getTFT().fillTriangle(x0, y0, x1, y1, x2, y2, color);
    }
    void drawTriangeLeft() {
        int16_t  x0 = m_x + m_w - m_paddig_right;
        int16_t  y0 = m_y + m_paddig_top;
        int16_t  x1 = m_x + m_w - m_paddig_right;
        int16_t  y1 = m_y + m_h - m_paddig_bottom;
        int16_t  x2 = m_x + m_padding_left;
        int16_t  y2 = y0 + (y1 - y0) / 2;
        uint32_t color = m_fgColor;
        if (m_clicked) color = m_clickColor;
        getTFT().fillTriangle(x0, y0, x1, y1, x2, y2, color);
    }
    void drawTriangeRight() {
        int16_t  x0 = m_x + m_padding_left;
        int16_t  y0 = m_y + m_paddig_top;
        int16_t  x1 = m_x + m_padding_left;
        int16_t  y1 = m_y + m_h - m_paddig_bottom;
        int16_t  x2 = m_x + m_w - m_paddig_right;
        int16_t  y2 = y0 + (y1 - y0) / 2;
        uint32_t color = m_fgColor;
        if (m_clicked) color = m_clickColor;
        getTFT().fillTriangle(x0, y0, x1, y1, x2, y2, color);
    }

    void begin(uint16_t x, uint16_t y, uint16_t w, uint16_t h, uint8_t paddig_left, uint8_t paddig_right, uint8_t paddig_top, uint8_t paddig_bottom, uint8_t radius) {
        m_x = x; // x pos
        m_y = y; // y pos
        m_w = w; // width
        m_h = h; // high
        m_r = radius;
        m_padding_left = paddig_left;
        m_paddig_right = paddig_right;
        m_paddig_top = paddig_top;
        m_paddig_bottom = paddig_bottom;
    }
    ps_ptr<char> get_name() { return m_name; }
    void         enable() { m_enabled = true; }
    void         disable() { m_enabled = false; }
    bool         is_enabled() { return m_enabled; }
    bool         is_active() { return m_active; }
    void         set_active(bool active) { m_active = active; }
    bool         has_focus() { return m_focus; }
    void         set_bg_color(int32_t color) { m_bg_color = color; }
    bool         set_focus(bool focus) { return false; }

    void show() {
        if (m_first_call) { m_first_call = false; }
        if (m_bg_color == TFT_BG_IS_WALLPAPER) {
            getTFT().copyFramebuffer(FB_BACKGROUND, FB_VISIBLE, m_x, m_y, m_w, m_h);
        } else {
            getTFT().fillRect(m_x, m_y, m_w, m_h, m_bg_color);
        }
        m_enabled = true;
        m_clicked = false;
        writeText(m_text);
    }

    void hide() {
        if (m_first_call) return;
        if (m_bg_color == TFT_BG_IS_WALLPAPER) {
            getTFT().copyFramebuffer(FB_BACKGROUND, FB_VISIBLE, m_x, m_y, m_w, m_h);
        } else {
            getTFT().fillRect(m_x, m_y, m_w, m_h, m_bg_color);
        }
        m_enabled = false;
    }

    void getBounds(int16_t& x, int16_t& y, int16_t& w, int16_t& h) override {
        x = m_x;
        y = m_y;
        w = m_w;
        h = m_h;
    }

    void setFontSize(uint8_t size) { // size 0 -> auto, choose besr font size
        m_fontSize = 0;
        if (size != 0) {
            m_fontSize = size;
            getTFT().setFontSize(m_fontSize);
        } else {
            m_autoSize = true;
        }
    }
    void setTextColor(uint32_t color) { m_fgColor = color; }

    void setBorderColor(uint32_t color) { m_borderColor = color; }
    void setClickColor(uint32_t color) { m_clickColor = color; }
    void setBorderWidth(uint8_t width) { // 0 = no border
        m_borderWidth = width;
        if (m_borderWidth > 2) m_borderWidth = 2;
        m_padding_left = max(m_padding_left, m_borderWidth);
        m_paddig_right = max(m_paddig_right, m_borderWidth);
        m_paddig_top = max(m_paddig_top, m_borderWidth);
        m_paddig_bottom = max(m_paddig_bottom, m_borderWidth);
    }
    bool positionXY(uint16_t x, uint16_t y) {
        if (x < m_x) return false;
        if (y < m_y) return false;
        if (x > m_x + m_w) return false;
        if (y > m_y + m_h) return false;
        if (m_enabled) m_clicked = true;
        writeText(m_text);
        if (graphicObjects_OnClick) graphicObjects_OnClick(m_name, m_enabled);
        if (!m_enabled) return false;

        return true;
    }
    bool released() {
        if (!m_enabled) return false;
        if (!m_clicked) return false;
        m_clicked = false;
        writeText(m_text);
        if (graphicObjects_OnRelease) graphicObjects_OnRelease(m_name, m_ra);
        return true;
    }
    void setText(ps_ptr<char> txt, bool noWrap = false) { // prepare a text, wait of show() to write it
        if (!txt) { txt = strdup(""); }
        m_text = txt;
        m_noWrap = noWrap;
    }
    ps_ptr<char> getText() { return m_text; }
    void         setAlign(HAlign h_align, VAlign v_align) {
        m_h_align = h_align;
        m_v_align = v_align;
    }
    void writeText(ps_ptr<char> txt) {
        if (txt != m_text) { // no self copy
            m_text = txt;
        }
        if (m_enabled) {
            uint16_t txtColor_tmp = getTFT().getTextColor();
            uint16_t bgColor_tmp = getTFT().getBackGroundColor();
            if (!m_clicked) {
                getTFT().setTextColor(m_fgColor);
            } else {
                getTFT().setTextColor(m_clickColor);
            }

            if (m_bg_color == TFT_BG_IS_WALLPAPER) {
                getTFT().copyFramebuffer(FB_BACKGROUND, FB_VISIBLE, m_x, m_y, m_w, m_h);
            } else {
                getTFT().fillRect(m_x, m_y, m_w, m_h, m_bg_color);
            }
            if (m_fontSize != 0) { getTFT().setFontSize(m_fontSize); }
            int x = m_x + m_padding_left;
            int y = m_y + m_paddig_top;
            int w = m_w - (m_paddig_right + m_padding_left);
            int h = m_h - (m_paddig_bottom + m_paddig_top);
            if (!m_clicked) {
                if (m_borderWidth > 0) { getTFT().drawRoundRect(m_x, m_y, m_w, m_h, m_r, m_borderColor); }
                if (m_borderWidth > 1) { getTFT().drawRoundRect(m_x + 1, m_y + 1, m_w - 2, m_h - 2, m_r, m_borderColor); }
            } else {
                if (m_borderWidth > 0) { getTFT().drawRoundRect(m_x, m_y, m_w, m_h, m_r, m_clickColor); }
                if (m_borderWidth > 1) { getTFT().drawRoundRect(m_x + 1, m_y + 1, m_w - 2, m_h - 2, m_r, m_clickColor); }
            }
            if (m_text.equals("/l")) {
                drawTriangeLeft();
            } else if (m_text.equals("/r")) {
                drawTriangeRight();
            } else if (m_text.equals("/u")) {
                drawTriangeUp();
            } else if (m_text.equals("/d")) {
                drawTriangeDown();
            } else
                getTFT().writeText(m_text, x, y, w, h, m_h_align, m_v_align, m_noWrap, m_autoSize);
            getTFT().setTextColor(txtColor_tmp);
            getTFT().setBackGoundColor(bgColor_tmp);
        }
    }
};
// ——————————————————————————————————————————————————————————————————————————————————————————————————————————————————————————————————————————————————————————————————————————————————————————————————————
class VU_Meter : public RegisterTable {
  private:
    uint16_t         m_x = 0;
    uint16_t         m_y = 0;
    uint16_t         m_w = 0;
    uint16_t         m_h = 0;
    int32_t          m_bg_color = TFT_BG_IS_WALLPAPER;
    uint32_t         m_frameColor = TFT_DARKGREY;
    ps_ptr<char>     m_name;
    ps_ptr<uint16_t> m_cache_bg = {};
    bool             m_enabled = false;
    bool             m_focus = false;
    bool             m_active = true;
    bool             m_clicked = false;
    bool             m_content_has_changed = false;
    bool             m_first_call = true;
    uint64_t         m_barLeft;  // Bit = Bars
    uint64_t         m_peakLeft; // Bit = Peak
    releasedArg      m_ra;
    uint8_t          m_segm_w = 0;
    uint8_t          m_segm_h = 0;
    uint8_t          m_frameSize = 1;
    uint16_t         m_frame_x = 0;
    uint16_t         m_frame_y = 0;
    uint16_t         m_frame_w = 0;
    uint16_t         m_frame_h = 0;

    enum SegmentState : uint8_t { OFF, BAR, PEAK };
    uint16_t                  m_numSegments = 26;
    std::vector<SegmentState> m_leftState;
    std::vector<SegmentState> m_rightState;

  public:
    VU_Meter(ps_ptr<char> name) {
        register_object(this);
        m_name = name;
    }
    ~VU_Meter() {}

    void begin(uint16_t x, uint16_t y, uint16_t w, uint16_t h, uint8_t paddig_left, uint8_t paddig_right, uint8_t paddig_top, uint8_t paddig_bottom) {
        m_x = x; // x pos
        m_y = y; // y pos
        m_w = w;
        m_h = h;
        m_frame_x = x + paddig_left;
        m_frame_y = y + paddig_top;
        uint16_t frame_w = m_w - paddig_left - paddig_right;
        uint16_t frame_h = m_h - paddig_top - paddig_bottom;
        m_numSegments = frame_h / 3;
        if (m_numSegments == 0) m_numSegments = 1;
        m_leftState.resize(m_numSegments, OFF);
        m_rightState.resize(m_numSegments, OFF);
        m_segm_w = ((frame_w - 3 * m_frameSize) / 2) - m_frameSize; // 2 columns + 3 frameSizes
        m_segm_h = (frame_h / m_numSegments) - m_frameSize;
        m_frame_w = 2 * m_segm_w + 3 * m_frameSize;
        m_frame_h = m_numSegments * (m_segm_h + m_frameSize) + m_frameSize;
    }

    ps_ptr<char> get_name() { return m_name; }
    void         enable() { m_enabled = true; }
    void         disable() { m_enabled = false; }
    bool         is_enabled() { return m_enabled; }
    bool         is_active() { return m_active; }
    void         set_active(bool active) { m_active = active; }
    bool         has_focus() { return m_focus; }
    void         set_bg_color(int32_t color) { m_bg_color = color; }
    bool         set_focus(bool focus) { return false; }

    void show() {
        if (m_bg_color == TFT_BG_IS_CURRENT_VISIBLE) {
            if (m_first_call) { m_cache_bg.alloc_array(m_w * m_h, m_name.c_get()); }
            getTFT().copyFramebuffer(FB_VISIBLE, m_cache_bg.get(), m_x, m_y, m_w, m_h);
        } else if (m_bg_color == TFT_BG_IS_WALLPAPER) { //
            getTFT().copyFramebuffer(FB_BACKGROUND, FB_VISIBLE, m_x, m_y, m_w, m_h);
        } else { // e.g. m_bg_color == TFT_BLACK
            getTFT().fillRect(m_x, m_y, m_w, m_h, m_bg_color);
            getTFT().drawRect(m_frame_x, m_frame_y, m_frame_w, m_frame_h, m_frameColor);
        }

        for (uint16_t i = 0; i < m_numSegments; i++) {
            m_leftState[i] = OFF;
            m_rightState[i] = OFF;
            drawRect(i, 0, 0);
            drawRect(i, 1, 0);
        }
        m_first_call = false;
        m_enabled = true;
        m_clicked = false;
    }

    void hide() {
        if (m_first_call) return;
        if (m_bg_color == TFT_BG_IS_CURRENT_VISIBLE) {
            getTFT().copyFramebuffer(m_cache_bg.get(), FB_VISIBLE, m_x, m_y, m_w, m_h);
        } else if (m_bg_color == TFT_BG_IS_WALLPAPER) {
            getTFT().copyFramebuffer(FB_BACKGROUND, FB_VISIBLE, m_x, m_y, m_w, m_h);
        } else {
            getTFT().fillRect(m_x, m_y, m_w, m_h, m_bg_color);
        }
        m_enabled = false;
    }

    void getBounds(int16_t& x, int16_t& y, int16_t& w, int16_t& h) override {
        x = m_x;
        y = m_y;
        w = m_w;
        h = m_h;
    }

    void buildState(uint16_t bars, uint16_t peak, bool hasSignal, std::vector<SegmentState>& state, bool channel) {
        for (uint16_t i = 0; i < m_numSegments; i++) {
            SegmentState newState = OFF;
            if (i < bars) newState = BAR;
            if (hasSignal && i == peak) newState = PEAK;
            if (newState == state[i]) continue;

            if (m_enabled) {
                xSemaphoreTake(mutex_display, portMAX_DELAY);
                switch (newState) {
                    case OFF: drawRect(i, channel, 0); break;
                    case BAR: drawRect(i, channel, 1); break;
                    case PEAK:
                        drawRect(i, channel, 1); // später drawPeak()
                        break;
                }
                xSemaphoreGive(mutex_display);
            }
            state[i] = newState;
        }
    }

    void reset() {
        for (uint16_t i = 0; i < m_numSegments; i++) {
            m_leftState[i] = OFF;
            m_rightState[i] = OFF;
        }
    }

    void update(uint8_t l, uint8_t r, uint8_t peak_l, uint8_t peak_r) {
        uint16_t bars_left = map_l(l, 0, 255, 0, m_numSegments - 1);
        uint16_t bars_right = map_l(r, 0, 255, 0, m_numSegments - 1);
        uint16_t peak_left = map_l(peak_l, 0, 255, 0, m_numSegments - 1);
        uint16_t peak_right = map_l(peak_r, 0, 255, 0, m_numSegments - 1);

        buildState(bars_left, peak_left, l > 0, m_leftState, true);
        buildState(bars_right, peak_right, r > 0, m_rightState, false);
    }

    bool positionXY(uint16_t x, uint16_t y) {
        if (x < m_x) return false;
        if (y < m_y) return false;
        if (x > m_x + m_w) return false;
        if (y > m_y + m_h) return false;
        if (m_enabled) m_clicked = true;
        if (graphicObjects_OnClick) graphicObjects_OnClick(m_name, m_enabled);
        if (!m_enabled) return false;
        return true;
    }
    bool released() {
        if (!m_enabled) return false;
        if (!m_clicked) return false;
        m_clicked = false;
        if (graphicObjects_OnRelease) graphicObjects_OnRelease(m_name, m_ra);
        return true;
    }

  private:
    void drawRect(uint16_t row, uint8_t col, bool br) {
        if (row >= m_numSegments || col > 1) return;

        uint16_t y_end = m_frame_y + m_frame_h - m_frameSize - m_segm_h;
        uint16_t xPos = m_frame_x + m_frameSize + col * (m_segm_w + m_frameSize);
        uint16_t yPos = y_end - row * (m_frameSize + m_segm_h);

        float    s = (float)m_numSegments / 100.0;
        uint16_t greenLimit = 58.0 * s;
        uint16_t yellowLimit = 85.0 * s;

        int32_t activeColor;
        int32_t inactiveColor = m_bg_color;
        int32_t color;

        if (row < greenLimit) {
            activeColor = TFT_GREEN;
            if (m_bg_color >= 0) inactiveColor = TFT_DARKGREEN;
        } else if (row < yellowLimit) {
            activeColor = TFT_YELLOW;
            if (m_bg_color >= 0) inactiveColor = TFT_DARKYELLOW;
        } else {
            activeColor = TFT_LIGHTRED;
            if (m_bg_color >= 0) inactiveColor = TFT_DARKRED;
        }

        if (br) {
            color = activeColor;
        } else {
            color = inactiveColor;
        }

        if (color == TFT_BG_IS_CURRENT_VISIBLE) {
            uint16_t srcX = xPos - m_x;
            uint16_t srcY = yPos - m_y;
            getTFT().copyFramebuffer(m_cache_bg.get(), m_w, m_h, srcX, srcY, FB_VISIBLE, xPos, yPos, m_segm_w, m_segm_h);
        } else if (color == TFT_BG_IS_WALLPAPER) {
            getTFT().copyFramebuffer(FB_BACKGROUND, FB_VISIBLE, xPos, yPos, m_segm_w, m_segm_h);
        } else {
            getTFT().fillRect(xPos, yPos, m_segm_w, m_segm_h, color);
        }
    }
};
// ——————————————————————————————————————————————————————————————————————————————————————————————————————————————————————————————————————————————————————————————————————————————————————————————————————
class Spectrum : public RegisterTable {
  private:
    uint16_t         m_x = 0;
    uint16_t         m_y = 0;
    uint16_t         m_w = 0;
    uint16_t         m_h = 0;
    int32_t          m_bg_color = TFT_BG_IS_WALLPAPER;
    ps_ptr<char>     m_name;
    ps_ptr<uint16_t> m_colums_pos_x;
    ps_ptr<uint16_t> m_bars_pos_y;
    ps_ptr<uint16_t> m_cache_bg = {};
    bool             m_enabled = false;
    bool             m_focus = false;
    bool             m_active = true;
    bool             m_clicked = false;
    bool             m_first_call = true;
    releasedArg      m_ra;
    uint8_t          m_space_between_cols = 1;
    uint8_t          m_space_between_bars = 1;
    uint8_t          m_bar_w = 0;
    uint8_t          m_bar_h = 0;
    uint16_t         m_window_x = 0;
    uint16_t         m_window_y = 0;
    uint16_t         m_window_w = 0;
    uint16_t         m_window_h = 0;

    enum SegmentState : uint8_t { OFF, BAR, PEAK };
    uint16_t                  m_numSegments = 26;
    const uint16_t            m_numColums = 15;
    std::vector<SegmentState> m_segmState[15];

  public:
    Spectrum(ps_ptr<char> name) {
        register_object(this);
        m_name = name;
    }
    ~Spectrum() {}

    void begin(uint16_t x, uint16_t y, uint16_t w, uint16_t h, uint8_t paddig_left, uint8_t paddig_right, uint8_t paddig_top, uint8_t paddig_bottom) {
        m_x = x; // x pos
        m_y = y; // y pos
        m_w = w;
        m_h = h;
        m_window_x = x + paddig_left;
        m_window_y = y + paddig_top;
        m_window_w = m_w - paddig_left - paddig_right;
        m_window_h = m_h - paddig_top - paddig_bottom;
        m_numSegments = m_window_h / 3;
        if (m_numSegments == 0) m_numSegments = 1;
        m_bar_h = (m_window_h / m_numSegments) - m_space_between_bars;
        m_bar_w = (m_window_w / m_numColums) - m_space_between_cols;
        uint8_t center_x = (m_window_w - (m_bar_w + m_space_between_cols) * m_numColums - m_space_between_cols) / 2;
        uint8_t center_y = (m_window_h - (m_bar_h + m_space_between_bars) * m_numSegments - m_space_between_bars) / 2;
        MWR_LOG_DEBUG("x {} , y {}, w {}, h {}, win_x {}, win_y {}, win_w {}, win_h {}, numCol {}, numSegm {}, bar_w {}, bar_h {}, center_x {}, center_y {}", m_x, m_y, m_w, m_h, m_window_x,
                      m_window_y, m_window_w, m_window_h, m_numColums, m_numSegments, m_bar_w, m_bar_h, center_x, center_y);
        m_window_x += center_x;
        m_window_y += center_y;
        m_colums_pos_x.alloc_array(m_numColums);
        for (int i = 0; i < m_numColums; i++) {
            m_colums_pos_x[i] = m_window_x + i * (m_bar_w + m_space_between_bars);
            m_segmState[i].resize(m_numSegments);
        }
        m_bars_pos_y.alloc_array(m_numSegments);
        for (int i = 0; i < m_numSegments; i++) { m_bars_pos_y[i] = (m_window_y + m_window_h) - i * (m_bar_h + m_space_between_bars) - (m_bar_h + m_space_between_bars); }
        for (int i = 0; i < m_numColums; i++) MWR_LOG_DEBUG("col_x  i{}: {}", i, m_colums_pos_x[i]);
        for (int i = 0; i < m_numSegments; i++) MWR_LOG_DEBUG("bars_y i{}: {}", i, m_bars_pos_y[i]);
    }

    ps_ptr<char> get_name() { return m_name; }
    void         enable() { m_enabled = true; }
    void         disable() { m_enabled = false; }
    bool         is_enabled() { return m_enabled; }
    bool         is_active() { return m_active; }
    void         set_active(bool active) { m_active = active; }
    bool         has_focus() { return m_focus; }
    void         set_bg_color(int32_t color) { m_bg_color = color; }
    bool         set_focus(bool focus) { return false; }

    void show() {
        if (m_bg_color == TFT_BG_IS_CURRENT_VISIBLE) {
            if (m_first_call) { m_cache_bg.alloc_array(m_w * m_h, m_name.c_get()); }
            getTFT().copyFramebuffer(FB_VISIBLE, m_cache_bg.get(), m_x, m_y, m_w, m_h);
        } else if (m_bg_color == TFT_BG_IS_WALLPAPER) { //
            getTFT().copyFramebuffer(FB_BACKGROUND, FB_VISIBLE, m_x, m_y, m_w, m_h);
        } else { // e.g. m_bg_color == TFT_BLACK
            getTFT().fillRect(m_x, m_y, m_w, m_h, m_bg_color);
        }
        m_first_call = false;
        m_enabled = true;
        m_clicked = false;
        clear();
    }

    void hide() {
        if (m_first_call) return;
        if (m_bg_color == TFT_BG_IS_CURRENT_VISIBLE) {
            getTFT().copyFramebuffer(m_cache_bg.get(), FB_VISIBLE, m_x, m_y, m_w, m_h);
        } else if (m_bg_color == TFT_BG_IS_WALLPAPER) {
            getTFT().copyFramebuffer(FB_BACKGROUND, FB_VISIBLE, m_x, m_y, m_w, m_h);
        } else {
            getTFT().fillRect(m_x, m_y, m_w, m_h, m_bg_color);
        }
        m_enabled = false;
    }

    void getBounds(int16_t& x, int16_t& y, int16_t& w, int16_t& h) override {
        x = m_x;
        y = m_y;
        w = m_w;
        h = m_h;
    }

    void buildState(uint16_t bars, uint16_t peak, bool hasSignal, uint16_t col, std::vector<SegmentState>& state) {
        for (uint16_t row = 0; row < m_numSegments; row++) {
            SegmentState newState = OFF;

            if (row < bars) newState = BAR;
            if (hasSignal && row == peak) newState = PEAK;
            if (newState == state[row]) continue;

            switch (newState) {
                case OFF: drawRect(row, col, 0); break;
                case BAR: drawRect(row, col, 1); break;
                case PEAK: drawRect(row, col, 1); break;
            }

            state[row] = newState;
        }
    }

    void update(const std::vector<uint32_t>& v, const std::vector<uint32_t>& p) {
        if (!m_enabled) return;
        if (v.size() < m_numColums) return; // measured
        if (p.size() < m_numColums) return; // peak

        xSemaphoreTake(mutex_display, portMAX_DELAY);
        for (uint16_t col = 0; col < m_numColums; col++) {
            uint16_t bars = map_l(v[col], 0, 255, 0, m_numSegments - 1);
            uint16_t peak = map_l(p[col], 0, 255, 0, m_numSegments - 1);
            buildState(bars, peak, v[col] > 0, col, m_segmState[col]);
        }
        xSemaphoreGive(mutex_display);
    }

    bool positionXY(uint16_t x, uint16_t y) {
        if (x < m_x) return false;
        if (y < m_y) return false;
        if (x > m_x + m_w) return false;
        if (y > m_y + m_h) return false;
        if (m_enabled) m_clicked = true;
        if (graphicObjects_OnClick) graphicObjects_OnClick(m_name, m_enabled);
        if (!m_enabled) return false;
        return true;
    }
    bool released() {
        if (!m_enabled) return false;
        if (!m_clicked) return false;
        m_clicked = false;
        if (graphicObjects_OnRelease) graphicObjects_OnRelease(m_name, m_ra);
        return true;
    }

    void clear() {
        for (uint16_t row = 0; row < m_numSegments; row++) {
            for (uint16_t col = 0; col < m_numColums; col++) {
                m_segmState[col][row] = OFF;
                if (m_enabled) drawRect(row, col, 0);
            }
        }
    }

  private:
    void drawRect(uint16_t row, uint8_t col, bool br) {
        if (row >= m_numSegments || col >= m_numColums) return;

        uint16_t xPos = m_colums_pos_x[col];
        uint16_t yPos = m_bars_pos_y[row];

        float    s = (float)m_numSegments / 100.0;
        uint16_t greenLimit = 58.0 * s;
        uint16_t yellowLimit = 85.0 * s;

        int32_t activeColor;
        int32_t inactiveColor = m_bg_color;
        int32_t color;

        if (row < greenLimit) {
            activeColor = TFT_GREEN;
            if (m_bg_color >= 0) inactiveColor = TFT_DARKGREEN;
        } else if (row < yellowLimit) {
            activeColor = TFT_YELLOW;
            if (m_bg_color >= 0) inactiveColor = TFT_DARKYELLOW;
        } else {
            activeColor = TFT_LIGHTRED;
            if (m_bg_color >= 0) inactiveColor = TFT_DARKRED;
        }

        if (br) {
            color = activeColor;
        } else {
            color = inactiveColor;
        }

        if (color == TFT_BG_IS_CURRENT_VISIBLE) {
            uint16_t srcX = xPos - m_x;
            uint16_t srcY = yPos - m_y;
            getTFT().copyFramebuffer(m_cache_bg.get(), m_w, m_h, srcX, srcY, FB_VISIBLE, xPos, yPos, m_bar_w, m_bar_h);
        } else if (color == TFT_BG_IS_WALLPAPER) {
            getTFT().copyFramebuffer(FB_BACKGROUND, FB_VISIBLE, xPos, yPos, m_bar_w, m_bar_h);
        } else {
            getTFT().fillRect(m_colums_pos_x[col], m_bars_pos_y[row], m_bar_w, m_bar_h, color);
        }
    }
};
// ——————————————————————————————————————————————————————————————————————————————————————————————————————————————————————————————————————————————————————————————————————————————————————————————————————
// *** C O M P O S E D   O B J E C T S
// ——————————————————————————————————————————————————————————————————————————————————————————————————————————————————————————————————————————————————————————————————————————————————————————————————————
class Selectbox : public RegisterTable {

    /*    —————————————————————————————————————————————————————————————————————————————
         |                   textbox                               |  ⏬  |  ⏫  |idx |
          —————————————————————————————————————————————————————————————————————————————
    */
  private:
    int16_t                   m_x = 0;
    int16_t                   m_y = 0;
    int16_t                   m_w = 0;
    int16_t                   m_h = 0;
    uint8_t                   m_fontSize = 0;
    uint8_t                   m_padding_left = 0;  // left margin
    uint8_t                   m_paddig_right = 0;  // right margin
    uint8_t                   m_paddig_top = 0;    // top margin
    uint8_t                   m_paddig_bottom = 0; // bottom margin
    uint8_t                   m_borderWidth = 0;
    int8_t                    m_idx = 0;
    int32_t                   m_bg_color = TFT_BG_IS_WALLPAPER;
    int32_t                   m_fgColor = 0;
    int32_t                   m_borderColor = 0;
    ps_ptr<char>              m_name;
    bool                      m_enabled = false;
    bool                      m_active = true;
    bool                      m_focus = false;
    bool                      m_clicked = false;
    bool                      m_autoSize = false;
    bool                      m_noWrap = false;
    releasedArg               m_ra;
    Textbox*                  m_txt_select = new Textbox("select_txtbox_ssid");
    Textbutton*               m_txt_btn_down = new Textbutton("select_txtbtn_down");
    Textbutton*               m_txt_btn_up = new Textbutton("select_txtbtn_up");
    Textbox*                  m_txt_btn_idx = new Textbox("select_txtbox_idx");
    std::vector<ps_ptr<char>> m_selContent;

  public:
    Selectbox(ps_ptr<char> name, uint8_t fontSize) {
        register_object(this);
        m_name = name;
        m_fgColor = TFT_LIGHTGREY;
        m_borderColor = TFT_BLACK;
        setFontSize(fontSize);
    }
    ~Selectbox() {
        delete m_txt_select;
        delete m_txt_btn_down;
        delete m_txt_btn_up;
        delete m_txt_btn_idx;
    }
    void begin(uint16_t x, uint16_t y, uint16_t w, uint16_t h, uint8_t paddig_left, uint8_t paddig_right, uint8_t paddig_top, uint8_t paddig_bottom) {
        m_x = x; // x pos
        m_y = y; // y pos
        m_w = w;
        if (m_w < 40) {
            MWR_LOG_WARN("width < 40px");
            return;
        } // width
        m_h = h;
        if (m_h < 10) {
            MWR_LOG_WARN("height < 10px");
            return;
        } // high
        m_padding_left = paddig_left;
        m_paddig_right = paddig_right;
        m_paddig_top = paddig_top;
        m_paddig_bottom = paddig_bottom;
        m_txt_select->begin(m_x, m_y, m_w - (m_h * 3), m_h, m_padding_left, m_paddig_right, m_paddig_top, m_paddig_bottom);
        m_txt_select->setNoWrap(m_noWrap);
        m_txt_select->setAlign(HAlign::Left, VAlign::Middle);
        m_txt_btn_down->begin(m_x + m_w - (m_h * 3), m_y, m_h, m_h, m_h / 5, m_h / 5, m_h / 5, m_h / 5, 0);
        m_txt_btn_down->setClickColor(TFT_CYAN);
        m_txt_btn_down->setText("/d");
        m_txt_btn_down->setAlign(HAlign::Center, VAlign::Middle);
        m_txt_btn_up->begin(m_x + m_w - (m_h * 2), m_y, m_h, m_h, m_h / 5, m_h / 5, m_h / 5, m_h / 5, 0);
        m_txt_btn_up->setClickColor(TFT_CYAN);
        m_txt_btn_up->setText("/u");
        m_txt_btn_up->setAlign(HAlign::Center, VAlign::Middle);
        m_txt_btn_idx->begin(m_x + m_w - (m_h * 1), m_y, m_h, m_h, m_padding_left, m_paddig_right, m_paddig_top, m_paddig_bottom);
        m_txt_btn_idx->setNoWrap(m_noWrap);
        m_txt_btn_idx->setAlign(HAlign::Center, VAlign::Middle);
    }
    ps_ptr<char> get_name() { return m_name; }
    void         enable() { enable_all(); }
    void         disable() { disable_all(); }
    bool         is_enabled() { return m_enabled; }
    bool         is_active() { return m_active; }
    void         set_active(bool active) { m_active = active; }
    bool         has_focus() { return m_focus; }
    void         set_bg_color(int32_t color) { set_bg_color_all(color); }
    bool         set_focus(bool focus) { return false; }

    void show() {
        m_txt_select->show();
        m_txt_btn_down->show();
        m_txt_btn_up->show();
        m_txt_btn_idx->show();
        m_enabled = true;
        m_clicked = false;
        m_idx = 0;
        if (m_selContent.size() > 0) writeText(m_idx);
    }

    void hide() {
        if (m_bg_color == TFT_BG_IS_WALLPAPER) {
            getTFT().copyFramebuffer(FB_BACKGROUND, FB_VISIBLE, m_x, m_y, m_w, m_h);
        } else {
            getTFT().fillRect(m_x, m_y, m_w, m_h, m_bg_color);
        }
        m_enabled = false;
        m_txt_select->disable();
        m_txt_btn_down->disable();
        m_txt_btn_up->disable();
        m_txt_btn_idx->disable();
    }

    void getBounds(int16_t& x, int16_t& y, int16_t& w, int16_t& h) override {
        x = m_x;
        y = m_y;
        w = m_w;
        h = m_h;
    }

    void disable_all() {
        m_enabled = false;
        m_txt_select->disable();
        m_txt_btn_down->disable();
        m_txt_btn_up->disable();
        m_txt_btn_idx->disable();
    }
    void enable_all() {
        m_enabled = true;
        m_txt_select->enable();
        m_txt_btn_down->enable();
        m_txt_btn_up->enable();
        m_txt_btn_idx->enable();
    }
    void setFontSize(uint8_t size) { // size 0 -> auto, choose besr font size
        m_fontSize = 0;
        if (size != 0) {
            m_fontSize = size;
            getTFT().setFontSize(m_fontSize);
        } else {
            m_autoSize = true;
        }
        m_txt_select->setFontSize(m_fontSize);
        m_txt_btn_down->setFontSize(m_fontSize);
        m_txt_btn_up->setFontSize(m_fontSize);
        m_txt_btn_idx->setFontSize(m_fontSize);
    }
    void setTextColor(uint32_t color) {
        m_fgColor = color;
        m_txt_select->setTextColor(m_fgColor);
        m_txt_btn_down->setTextColor(m_fgColor);
        m_txt_btn_up->setTextColor(m_fgColor);
        m_txt_btn_idx->setTextColor(m_fgColor);
    }

    void setBorderColor(uint32_t color) {
        m_borderColor = color;
        m_txt_select->set_border(m_borderColor);
        m_txt_btn_down->setBorderColor(m_borderColor);
        m_txt_btn_up->setBorderColor(m_borderColor);
        m_txt_btn_idx->set_border(m_borderColor);
    }
    void setBorderWidth(uint8_t width) { // 0 = no border
        m_borderWidth = width;
        if (m_borderWidth > 2) m_borderWidth = 2;
        m_txt_btn_down->setBorderWidth(m_borderWidth);
        m_txt_btn_up->setBorderWidth(m_borderWidth);
    }
    bool positionXY(uint16_t x, uint16_t y) {
        if (x < m_x) return false;
        if (y < m_y) return false;
        if (x > m_x + m_w) return false;
        if (y > m_y + m_h) return false;
        if (m_enabled) m_clicked = true;
        if (graphicObjects_OnClick) graphicObjects_OnClick(m_name, m_enabled);
        if (m_txt_select->positionXY(x, y)) { ; }
        if (m_txt_btn_down->positionXY(x, y)) { ; }
        if (m_txt_btn_up->positionXY(x, y)) { ; }
        if (m_txt_btn_idx->positionXY(x, y)) { ; }
        if (!m_enabled) return false;
        return true;
    }
    bool released() {
        bool ret = false;
        if (!m_enabled) return false;
        if (!m_clicked) return false;
        if (graphicObjects_OnRelease) graphicObjects_OnRelease(m_name, m_ra);
        m_txt_select->released();
        if (m_txt_btn_down->released())
            if (m_idx < m_selContent.size() - 1) {
                m_idx++; /* MWR_LOG_DEBUG("btn_down {}/{}", m_idx, m_selContent.size()); */
                writeText(m_idx);
                ret = true;
            }
        if (m_txt_btn_up->released())
            if (m_idx > 0) {
                m_idx--; /* MWR_LOG_DEBUG("btn_up {}/{}",   m_idx, m_selContent.size()); */
                writeText(m_idx);
                ret = true;
            }
        m_txt_btn_idx->released();
        m_clicked = false;
        return ret;
    }
    void addText(ps_ptr<char> txt) {
        if (txt.strlen() == 0) { return; }
        if (m_selContent.size() > 0) {
            for (uint8_t i = 0; i < m_selContent.size(); i++) {
                if (txt == m_selContent[i]) {
                    //    MWR_LOG_WARN("addText: {} already in list", txt);
                    return;
                }
            }
        }
        m_selContent.push_back(txt);
    }
    void clearText() { m_selContent.clear(); }
    void writeText(uint8_t idx) {
        ps_ptr<char> txt;
        if (idx >= m_selContent.size()) {
            txt = "";
        } else
            txt = m_selContent[idx];
        if (m_enabled) {
            MWR_LOG_DEBUG("writeText: {}", txt);
            m_txt_select->setText(txt);
            m_txt_select->set_bg_color(TFT_BG_IS_BLACK);
            m_txt_select->show();
            char c_idx[5] = {0};
            itoa(idx + 1, c_idx, 10);
            m_txt_btn_idx->setText(c_idx);
            m_txt_btn_idx->set_bg_color(TFT_BG_IS_BLACK);
            m_txt_btn_idx->show();
        }
    }
    ps_ptr<char> getSelectedText() {
        if (m_selContent.size() > 0) { return m_selContent[m_idx]; }
        return "";
    }

  private:
    void set_bg_color_all(int32_t color) {
        m_bg_color = color;
        m_txt_select->set_bg_color(m_bg_color);
        m_txt_btn_down->set_bg_color(m_bg_color);
        m_txt_btn_up->set_bg_color(m_bg_color);
        m_txt_btn_idx->set_bg_color(m_bg_color);
    }
};
// ——————————————————————————————————————————————————————————————————————————————————————————————————————————————————————————————————————————————————————————————————————————————————————————————————————
class KeyBoard : public RegisterTable { // show time "hh:mm:ss" e.g. in header
  private:
    int16_t      m_x = 0;
    int16_t      m_y = 0;
    int16_t      m_w = 0;
    int16_t      m_h = 0;
    int16_t      m_r = 0;
    uint8_t      m_padding_left = 0;
    uint8_t      m_paddig_right = 0;
    uint8_t      m_paddig_top = 0;
    uint8_t      m_paddig_bottom = 0;
    uint8_t      m_fontSize = 0;
    uint8_t      m_val = 0;
    bool         m_enabled = false;
    bool         m_active = true;
    bool         m_focus = false;
    bool         m_clicked = false;
    ps_ptr<char> m_name;
    ps_ptr<char> m_txt;
    float        m_row1[12] = {1.0, 1.0, 1.0, 1.0, 1.0, 1.0, 1.0, 1.0, 1.0, 1.0, 1.0, 1.0};
    float        m_row2[11] = {1.5, 1.0, 1.0, 1.0, 1.0, 1.0, 1.0, 1.0, 1.0, 1.0, 1.6};
    float        m_row3[11] = {1.0, 1.0, 1.0, 1.0, 1.0, 1.0, 1.0, 1.0, 1.0, 1.0, 2.1};
    const char   m_alpha1[12][4] = {"1..", "q", "w", "e", "r", "t", "y", "u", "i", "o", "p", "BS"};
    const char   m_alpha2[11][4] = {"A..", "a", "s", "d", "f", "g", "h", "j", "k", "l", "RET"};
    const char   m_alpha3[11][6] = {"#..", ".", "z", "x", "c", "v", "b", "n", "m", "_", "   "};
    const char   m_Alpha1[12][4] = {"1..", "Q", "W", "E", "R", "T", "Y", "U", "I", "O", "P", "BS"};
    const char   m_Alpha2[11][4] = {"a..", "A", "S", "D", "F", "G", "H", "J", "K", "L", "RET"};
    const char   m_Alpha3[11][6] = {"#..", ".", "Z", "X", "C", "V", "B", "N", "M", "_", "   "};
    const char   m_special1[12][4] = {"1..", "1", "2", "3", "4", "5", "6", "7", "8", "9", "0", "BS"};
    const char   m_special2[11][4] = {"a..", "!", "\"", "#", "$", "%", "&", "'", "(", ")", "RET"};
    const char   m_special3[11][6] = {"#..", "*", "+", ",", "-", "*", "-", ".", "/", ":", "   "};
    const char   m_Special1[12][4] = {"1..", "1", "2", "3", "4", "5", "6", "7", "8", "9", "0", "BS"};
    const char   m_Special2[11][4] = {"a..", ";", "<", "=", ">", "?", "@", "[", "\\", "]", "RET"};
    const char   m_Special3[11][6] = {"#..", "^", "_", "`", "{", "|", "}", "~", "#", "$", "   "};
    int32_t      m_color1[12] = {TFT_YELLOW,    TFT_LIGHTGREY, TFT_LIGHTGREY, TFT_LIGHTGREY, TFT_LIGHTGREY, TFT_LIGHTGREY,
                                 TFT_LIGHTGREY, TFT_LIGHTGREY, TFT_LIGHTGREY, TFT_LIGHTGREY, TFT_LIGHTGREY, TFT_YELLOW};
    int32_t      m_color2[11] = {TFT_YELLOW, TFT_LIGHTGREY, TFT_LIGHTGREY, TFT_LIGHTGREY, TFT_LIGHTGREY, TFT_LIGHTGREY, TFT_LIGHTGREY, TFT_LIGHTGREY, TFT_LIGHTGREY, TFT_LIGHTGREY, TFT_RED};
    int32_t      m_color3[11] = {TFT_YELLOW, TFT_LIGHTGREY, TFT_LIGHTGREY, TFT_LIGHTGREY, TFT_LIGHTGREY, TFT_LIGHTGREY, TFT_LIGHTGREY, TFT_LIGHTGREY, TFT_LIGHTGREY, TFT_LIGHTGREY, TFT_LIGHTGREY};
    int32_t      m_bg_color = TFT_BG_IS_WALLPAPER;
    int32_t      m_fgColor = 0;
    int32_t      m_clickColor = TFT_CYAN;
    Textbutton* txt_btn_array = new Textbutton[34]{Textbutton("txt_btn0"),  Textbutton("txt_btn1"),  Textbutton("txt_btn2"),  Textbutton("txt_btn3"),  Textbutton("txt_btn4"),  Textbutton("txt_btn5"),
                                                   Textbutton("txt_btn6"),  Textbutton("txt_btn7"),  Textbutton("txt_btn8"),  Textbutton("txt_btn9"),  Textbutton("txt_btn10"), Textbutton("txt_btn11"),
                                                   Textbutton("txt_btn12"), Textbutton("txt_btn13"), Textbutton("txt_btn14"), Textbutton("txt_btn15"), Textbutton("txt_btn16"), Textbutton("txt_btn17"),
                                                   Textbutton("txt_btn18"), Textbutton("txt_btn19"), Textbutton("txt_btn20"), Textbutton("txt_btn21"), Textbutton("txt_btn22"), Textbutton("txt_btn23"),
                                                   Textbutton("txt_btn24"), Textbutton("txt_btn25"), Textbutton("txt_btn26"), Textbutton("txt_btn27"), Textbutton("txt_btn28"), Textbutton("txt_btn29"),
                                                   Textbutton("txt_btn30"), Textbutton("txt_btn31"), Textbutton("txt_btn32"), Textbutton("txt_btn33")};

  public:
    KeyBoard(ps_ptr<char> name, uint8_t fontSize) {
        register_object(this);
        m_name = name;
        m_fgColor = TFT_LIGHTGREY;
        m_fontSize = fontSize;
    }
    ~KeyBoard() { delete[] txt_btn_array; }

    void begin(uint16_t x, uint16_t y, uint16_t w, uint16_t h, uint8_t paddig_left, uint8_t paddig_right, uint8_t paddig_top, uint8_t paddig_bottom) {
        m_x = x; // x pos
        m_y = y; // y pos
        m_w = w; // width
        m_h = h; // high
        uint8_t btnW = (m_w - (paddig_left + paddig_right)) / 12;
        uint8_t btnH = (m_h - (paddig_top + paddig_bottom)) / 3;
        uint8_t margin = btnW / 17;
        btnW -= margin;
        btnH -= margin;
        uint8_t  radius = btnW / 10;
        uint16_t posX = m_x + paddig_left;
        uint16_t posY = m_y + m_paddig_top;
        m_padding_left = paddig_left;
        m_paddig_right = paddig_right;
        m_paddig_top = paddig_top;
        m_paddig_bottom = paddig_bottom;
        m_w = 12 * btnW + 11 * margin + paddig_left + paddig_right; // recalculate width
        m_h = 3 * btnH + 2 * margin + paddig_top + paddig_bottom;   // recalculate high
        for (int i = 0; i < 12; i++) {                              // row 1
            txt_btn_array[i].begin(posX + m_padding_left, posY + m_paddig_top, btnW * m_row1[i], btnH, 0, 0, 0, 0, radius);
            txt_btn_array[i].set_bg_color(m_bg_color);
            txt_btn_array[i].setTextColor(m_color1[i]);
            txt_btn_array[i].setBorderColor(m_color1[i]);
            txt_btn_array[i].setClickColor(m_clickColor);
            txt_btn_array[i].setBorderWidth(1);
            txt_btn_array[i].setFontSize(m_fontSize);
            txt_btn_array[i].setText(m_alpha1[i]);
            txt_btn_array[i].setAlign(HAlign::Center, VAlign::Middle);
            posX += m_row1[i] * btnW + margin;
        }
        posY += btnH + margin;
        posX = m_x;
        for (int i = 0; i < 11; i++) { // row 2
            txt_btn_array[i + 12].begin(posX + m_padding_left, posY + m_paddig_top, btnW * m_row2[i], btnH, 0, 0, 0, 0, radius);
            txt_btn_array[i + 12].set_bg_color(m_bg_color);
            txt_btn_array[i + 12].setTextColor(m_color2[i]);
            txt_btn_array[i + 12].setBorderColor(m_color2[i]);
            txt_btn_array[i + 12].setClickColor(m_clickColor);
            txt_btn_array[i + 12].setBorderWidth(1);
            txt_btn_array[i + 12].setFontSize(m_fontSize);
            txt_btn_array[i + 12].setText(m_alpha2[i]);
            txt_btn_array[i + 12].setAlign(HAlign::Center, VAlign::Middle);
            posX += m_row2[i] * btnW + margin;
        }
        posY += btnH + margin;
        posX = m_x;
        for (int i = 0; i < 11; i++) { // row 3
            txt_btn_array[i + 23].begin(posX + m_padding_left, posY + m_paddig_top, btnW * m_row3[i], btnH, 0, 0, 0, 0, radius);
            txt_btn_array[i + 23].set_bg_color(m_bg_color);
            txt_btn_array[i + 23].setTextColor(m_color3[i]);
            txt_btn_array[i + 23].setBorderColor(m_color3[i]);
            txt_btn_array[i + 23].setClickColor(m_clickColor);
            txt_btn_array[i + 23].setBorderWidth(1);
            txt_btn_array[i + 23].setFontSize(m_fontSize);
            txt_btn_array[i + 23].setText(m_alpha3[i]);
            txt_btn_array[i + 23].setAlign(HAlign::Center, VAlign::Middle);
            posX += m_row3[i] * btnW + margin;
        }
    }

    ps_ptr<char> get_name() { return m_name; }
    void         enable() { m_enabled = true; }
    void         disable() { m_enabled = false; }
    bool         is_enabled() { return m_enabled; }
    bool         is_active() { return m_active; }
    void         set_active(bool active) { m_active = active; }
    bool         has_focus() { return m_focus; }
    void         set_bg_color(int32_t color) { set_bg_color_all(color); }
    bool         set_focus(bool focus) { return false; }

    void show() {
        if (m_bg_color == TFT_BG_IS_WALLPAPER) {
            getTFT().copyFramebuffer(FB_BACKGROUND, FB_VISIBLE, m_x, m_y, m_w, m_h);
        } else {
            getTFT().fillRect(m_x, m_y, m_w, m_h, m_bg_color);
        }
        m_enabled = true;
        m_clicked = false;
        for (int i = 0; i < 34; i++) {
            txt_btn_array[i].set_bg_color(m_bg_color);
            txt_btn_array[i].show();
        }
    }

    void hide() {
        if (m_bg_color == TFT_BG_IS_WALLPAPER) {
            getTFT().copyFramebuffer(FB_BACKGROUND, FB_VISIBLE, m_x, m_y, m_w, m_h);
        } else {
            getTFT().fillRect(m_x, m_y, m_w, m_h, m_bg_color);
        }
        for (int i = 0; i < 34; i++) { txt_btn_array[i].disable(); }
        m_enabled = false;
    }

    void getBounds(int16_t& x, int16_t& y, int16_t& w, int16_t& h) override {
        x = m_x;
        y = m_y;
        w = m_w;
        h = m_h;
    }

    uint8_t getVal() { return m_val; }
    bool    positionXY(uint16_t x, uint16_t y) {
        if (x < m_x) return false;
        if (y < m_y) return false;
        if (x > m_x + m_w) return false;
        if (y > m_y + m_h) return false;
        if (m_enabled) m_clicked = true;
        for (int i = 0; i < 34; i++) {
            if (txt_btn_array[i].positionXY(x, y)) m_txt = txt_btn_array[i].getText();
        }
        if (m_txt) {
            if (m_txt.equals("BS")) {
                m_val = 8;
            } // BS
            else if (m_txt.equals("RET")) {
                m_val = 13;
            } // CR
            else if (m_txt.equals("   ")) {
                m_val = 32;
            } // space
            else if (m_txt.equals("1..")) {
                m_val = 0;
            } else if (m_txt.equals("a..")) {
                m_val = 0;
            } else if (m_txt.equals("A..")) {
                m_val = 0;
            } else if (m_txt.equals("#..")) {
                m_val = 0;
            } else
                m_val = m_txt[0];
        }
        if (graphicObjects_OnClick) graphicObjects_OnClick(m_name, m_val);
        if (!m_enabled) return false;
        return true;
    }
    bool released() {
        if (!m_enabled) return false;
        if (!m_clicked) return false;
        m_clicked = false;
        // if(graphicObjects_OnRelease) graphicObjects_OnRelease(m_name, m_ra);
        for (int i = 0; i < 34; i++) {
            if (txt_btn_array[i].released()) {
                if (txt_btn_array[i].getText().equals("A..")) { // upcase
                    for (int j = 0; j < 12; j++) { txt_btn_array[j].setText(m_Alpha1[j]); }
                    for (int j = 0; j < 11; j++) { txt_btn_array[j + 12].setText(m_Alpha2[j]); }
                    for (int j = 0; j < 11; j++) { txt_btn_array[j + 23].setText(m_Alpha3[j]); }
                    for (int j = 0; j < 34; j++) { txt_btn_array[j].show(); }
                    break;
                }
                if (txt_btn_array[i].getText().equals("a..")) { // lowcase
                    for (int j = 0; j < 12; j++) { txt_btn_array[j].setText(m_alpha1[j]); }
                    for (int j = 0; j < 11; j++) { txt_btn_array[j + 12].setText(m_alpha2[j]); }
                    for (int j = 0; j < 11; j++) { txt_btn_array[j + 23].setText(m_alpha3[j]); }
                    for (int j = 0; j < 34; j++) { txt_btn_array[j].show(); }
                    break;
                }
                if (txt_btn_array[i].getText().equals("1..")) { // special
                    for (int j = 0; j < 12; j++) { txt_btn_array[j].setText(m_special1[j]); }
                    for (int j = 0; j < 11; j++) { txt_btn_array[j + 12].setText(m_special2[j]); }
                    for (int j = 0; j < 11; j++) { txt_btn_array[j + 23].setText(m_special3[j]); }
                    for (int j = 0; j < 34; j++) { txt_btn_array[j].show(); }
                    break;
                }
                if (txt_btn_array[i].getText().equals("#..")) { // Special
                    for (int j = 0; j < 12; j++) { txt_btn_array[j].setText(m_Special1[j]); }
                    for (int j = 0; j < 11; j++) { txt_btn_array[j + 12].setText(m_Special2[j]); }
                    for (int j = 0; j < 11; j++) { txt_btn_array[j + 23].setText(m_Special3[j]); }
                    for (int j = 0; j < 34; j++) { txt_btn_array[j].show(); }
                    break;
                }
            }
        }
        return true;
    }

  private:
    void set_bg_color_all(int32_t color) {
        m_bg_color = color;
        ;
    }
};
// ——————————————————————————————————————————————————————————————————————————————————————————————————————————————————————————————————————————————————————————————————————————————————————————————————————
class WifiSettings : public RegisterTable {
    /*                —————————————————————————————————————————————————————————————————————————————
                     |                             selectbox (SSID)            |  ⏬  |  ⏫  |idx |
                      —————————————————————————————————————————————————————————————————————————————
                      —————————————————————————————————————————————————————————————————————————————
                     |                             inputbox (Password)                            |
                      —————————————————————————————————————————————————————————————————————————————
                      —————————————————————————————————————————————————————————————————————————————
                     |                                                                            |
                     |                                                                            |
                     |                                 keyBoard                                   |
                     |                                                                            |
                     |                                                                            |
                      —————————————————————————————————————————————————————————————————————————————
    */
  private:
    int16_t      m_x = 0;
    int16_t      m_y = 0;
    int16_t      m_w = 0;
    int16_t      m_h = 0;
    uint8_t      m_fontSize = 0;
    uint8_t      m_padding_left = 0;   // left margin
    uint8_t      m_padding_right = 0;  // right margin
    uint8_t      m_padding_top = 0;    // top margin
    uint8_t      m_padding_bottom = 0; // bottom margin
    uint8_t      m_credentials_idx = 0;
    int32_t      m_bg_color = TFT_BG_IS_WALLPAPER;
    int32_t      m_fgColor = 0;
    int32_t      m_borderColor = 0;
    ps_ptr<char> m_name;
    bool         m_enabled = false;
    bool         m_active = true;
    bool         m_focus = false;
    bool         m_clicked = false;
    bool         m_autoSize = false;
    bool         m_noWrap = false;
    releasedArg  m_ra;
    Selectbox*   m_sel_ssid = new Selectbox("wifiSettings_selectbox_ssid", 0);
    Inputbox*    m_in_password = new Inputbox("wifiSettings_txtbox_pwd");
    KeyBoard*    m_keyboard = new KeyBoard("wifiSettings_keyBoard", 0);

    struct credentials {
        ps_ptr<char> ssid;
        ps_ptr<char> password;
        credentials(ps_ptr<char> s, ps_ptr<char> p) : ssid(s), password(p) {}
    };
    deque<credentials> m_credentials;

    struct w_se {
        uint16_t x = 0;
        uint16_t y = 0;
        uint16_t w = 0;
        uint16_t h = 0;
        uint8_t  pl = 0;
        uint8_t  pr = 0;
        uint8_t  pt = 0;
        uint8_t  pb = 0;
    } m_winSelect;
    struct w_pwd {
        uint16_t x = 0;
        uint16_t y = 0;
        uint16_t w = 0;
        uint16_t h = 0;
        uint8_t  pl = 0;
        uint8_t  pr = 0;
        uint8_t  pt = 0;
        uint8_t  pb = 0;
    } m_winPWD;
    struct w_k {
        uint16_t x = 0;
        uint16_t y = 0;
        uint16_t w = 0;
        uint16_t h = 0;
        uint8_t  pl = 0;
        uint8_t  pr = 0;
        uint8_t  pt = 0;
        uint8_t  pb = 0;
    } m_winKeybrd;

  public:
    WifiSettings(ps_ptr<char> name, uint8_t fontSize) {
        register_object(this);
        m_name = name;
        m_fgColor = TFT_LIGHTGREY;
        m_borderColor = TFT_LIGHTGREY;
        m_fontSize = fontSize;
        m_in_password->setAlign(HAlign::Left, VAlign::Middle);
        m_in_password->setTextColor(m_fgColor);
        m_in_password->set_bg_color(m_bg_color);
        m_in_password->setBorderColor(m_borderColor);
        m_sel_ssid->setTextColor(m_fgColor);
        m_sel_ssid->set_bg_color(m_bg_color);
        m_sel_ssid->setBorderColor(m_borderColor);
    }
    ~WifiSettings() {
        m_credentials.clear();
        delete m_sel_ssid;
        delete m_in_password;
        delete m_keyboard;
    }
    void begin(uint16_t x, uint16_t y, uint16_t w, uint16_t h, uint8_t padding_left, uint8_t paddig_right, uint8_t paddig_top, uint8_t paddig_bottom) {
        m_x = x; // x pos
        m_y = y; // y pos
        m_w = w;
        m_h = h;
        m_padding_left = padding_left;
        m_padding_right = paddig_right;
        m_padding_top = paddig_top;
        m_padding_bottom = paddig_bottom;

        if (w == 320) { // s 320x240
            m_winSelect.x = 10;
            m_winSelect.y = 40;
            m_winSelect.w = 300;
            m_winSelect.h = 28;
            m_winSelect.pl = 1;
            m_winSelect.pr = 1;
            m_winSelect.pt = 1;
            m_winSelect.pb = 1; // selectbox
            m_winPWD.x = 10;
            m_winPWD.y = 80;
            m_winPWD.w = 300;
            m_winPWD.h = 28;
            m_winPWD.pl = 1;
            m_winPWD.pr = 1;
            m_winPWD.pt = 1;
            m_winPWD.pb = 1; // password
            m_winKeybrd.x = 10;
            m_winKeybrd.y = 120;
            m_winKeybrd.w = 300;
            m_winKeybrd.h = 75;
            m_winKeybrd.pl = 1;
            m_winKeybrd.pr = 1;
            m_winKeybrd.pt = 1;
            m_winKeybrd.pb = 1; // keyboard
        } else if (w == 480) {  // m 480x320
            m_winSelect.x = 12;
            m_winSelect.y = 50;
            m_winSelect.w = 456;
            m_winSelect.h = 30;
            m_winSelect.pl = 1;
            m_winSelect.pr = 1;
            m_winSelect.pt = 1;
            m_winSelect.pb = 1; // selectbox
            m_winPWD.x = 12;
            m_winPWD.y = 90;
            m_winPWD.w = 456;
            m_winPWD.h = 30;
            m_winPWD.pl = 1;
            m_winPWD.pr = 1;
            m_winPWD.pt = 1;
            m_winPWD.pb = 1; // password
            m_winKeybrd.x = 12;
            m_winKeybrd.y = 160;
            m_winKeybrd.w = 456;
            m_winKeybrd.h = 114;
            m_winKeybrd.pl = 1;
            m_winKeybrd.pr = 1;
            m_winKeybrd.pt = 1;
            m_winKeybrd.pb = 1; // keyboard
        } else if (w == 800) {  // l 800x480
            m_winSelect.x = 82;
            m_winSelect.y = 70;
            m_winSelect.w = 636;
            m_winSelect.h = 50;
            m_winSelect.pl = 1;
            m_winSelect.pr = 1;
            m_winSelect.pt = 1;
            m_winSelect.pb = 1; // selectbox
            m_winPWD.x = 82;
            m_winPWD.y = 130;
            m_winPWD.w = 636;
            m_winPWD.h = 50;
            m_winPWD.pl = 3;
            m_winPWD.pr = 1;
            m_winPWD.pt = 1;
            m_winPWD.pb = 1; // password
            m_winKeybrd.x = 82;
            m_winKeybrd.y = 240;
            m_winKeybrd.w = 636;
            m_winKeybrd.h = 160;
            m_winKeybrd.pl = 3;
            m_winKeybrd.pr = 1;
            m_winKeybrd.pt = 1;
            m_winKeybrd.pb = 1; // keyboard
        } else if (w == 1024) { // l 1024x600
            m_winSelect.x = m_x + m_w / 30;
            m_winSelect.y = m_y + 70;
            m_winSelect.w = m_w - (2 * m_w / 30);
            m_winSelect.h = 50;
            m_winSelect.pl = 1;
            m_winSelect.pr = 1;
            m_winSelect.pt = 1;
            m_winSelect.pb = 1; // selectbox
            m_winPWD.x = m_x + m_w / 30;
            m_winPWD.y = m_winSelect.y + m_winSelect.h + 10;
            m_winPWD.w = m_w - (2 * m_w / 30);
            m_winPWD.h = 50;
            m_winPWD.pl = 3;
            m_winPWD.pr = 1;
            m_winPWD.pt = 1;
            m_winPWD.pb = 1; // password
            m_winKeybrd.x = m_x + m_w / 30;
            m_winKeybrd.y = m_winPWD.y + m_winPWD.h + 10;
            m_winKeybrd.w = m_w - (2 * m_w / 30);
            m_winKeybrd.h = m_h - (m_winKeybrd.y + 10);
            m_winKeybrd.pl = 3;
            m_winKeybrd.pr = 1;
            m_winKeybrd.pt = 1;
            m_winKeybrd.pb = 1; // keyboard
        } else {
            MWR_LOG_WARN("unsupported resolution width {} px", w);
            return;
        }
        m_sel_ssid->setFontSize(0); // auto size
        m_sel_ssid->begin(m_winSelect.x, m_winSelect.y, m_winSelect.w, m_winSelect.h, m_winSelect.pl, m_winSelect.pr, m_winSelect.pt, m_winSelect.pb);
        m_in_password->setFontSize(0); // auto size
        m_in_password->begin(m_winPWD.x, m_winPWD.y, m_winPWD.w, m_winPWD.h, m_winPWD.pl, m_winPWD.pr, m_winPWD.pt, m_winPWD.pb);
        m_keyboard->begin(m_winKeybrd.x, m_winKeybrd.y, m_winKeybrd.w, m_winKeybrd.h, m_winKeybrd.pl, m_winKeybrd.pr, m_winKeybrd.pt, m_winKeybrd.pb);
    }
    ps_ptr<char> get_name() { return m_name; }
    void         enable() { enable_all(); }
    void         disable() { disable_all(); }
    bool         is_enabled() { return m_enabled; }
    bool         is_active() { return m_active; }
    void         set_active(bool active) { m_active = active; }
    bool         has_focus() { return m_focus; }
    void         set_bg_color(int32_t color) { set_bg_color_all(color); }
    bool         set_focus(bool focus) { return false; }

    void show() {
        m_in_password->setAlign(HAlign::Left, VAlign::Middle);
        m_sel_ssid->show();
        m_in_password->setText(m_credentials[0].password);
        m_in_password->show();
        m_keyboard->show();
        m_enabled = true;
        m_clicked = false;
    }

    void hide() {
        if (m_bg_color == TFT_BG_IS_WALLPAPER) {
            getTFT().copyFramebuffer(FB_BACKGROUND, FB_VISIBLE, m_x, m_y, m_w, m_h);
        } else {
            getTFT().fillRect(m_x, m_y, m_w, m_h, m_bg_color);
        }
        disable_all();
    }

    void getBounds(int16_t& x, int16_t& y, int16_t& w, int16_t& h) override {
        x = m_x;
        y = m_y;
        w = m_w;
        h = m_h;
    }

    void setFontSize(uint8_t size) { // size 0 -> auto, choose besr font size
        m_fontSize = 0;
        if (size != 0) {
            m_fontSize = size;
            getTFT().setFontSize(m_fontSize);
        } else {
            m_autoSize = true;
        }
        m_sel_ssid->setFontSize(m_fontSize);
        m_in_password->setFontSize(m_fontSize);
        //    m_keyboard->setFontSize(m_fontSize);
    }
    void setTextColor(uint32_t color) {
        m_fgColor = color;
        m_sel_ssid->setTextColor(m_fgColor);
        m_in_password->setTextColor(m_fgColor);
        // m_keyboard->setTextColor(m_fgColor);
    }

    void setBorderColor(uint32_t color) {
        m_borderColor = color;
        m_sel_ssid->setBorderColor(m_borderColor);
        m_in_password->setBorderColor(m_borderColor);
    }

    bool positionXY(uint16_t x, uint16_t y) {
        if (x < m_x) return false;
        if (y < m_y) return false;
        if (x > m_x + m_w) return false;
        if (y > m_y + m_h) return false;
        if (m_enabled) m_clicked = true;
        if (graphicObjects_OnClick) graphicObjects_OnClick(m_name, m_enabled);
        if (m_sel_ssid->positionXY(x, y)) { ; }
        if (m_in_password->positionXY(x, y)) { ; }
        if (m_keyboard->positionXY(x, y)) {
            MWR_LOG_INFO("key pressed {}", m_keyboard->getVal());
            changePassword(m_keyboard->getVal(), m_credentials_idx);
            m_in_password->setText(m_credentials[m_credentials_idx].password);
            m_in_password->show();
        }
        if (!m_enabled) return false;
        return true;
    }
    bool released() {
        bool ret = false;
        if (!m_enabled) return false;
        if (!m_clicked) return false;
        if (m_sel_ssid->released()) {
            ps_ptr<char> selTxt = m_sel_ssid->getSelectedText();
            if (selTxt.strlen() > 0) {
                for (int i = 0; i < m_credentials.size(); i++) {
                    if (m_credentials[i].ssid.equals(selTxt)) {
                        m_in_password->setText(m_credentials[i].password);
                        m_in_password->show();
                        m_credentials_idx = i;
                    }
                }
            }
            ret = true;
        }
        if (m_in_password->released()) { /*log_i("m_txt_password released")*/
            ;
        }
        if (m_keyboard->released()) { /*log_i("keyboard released")*/
            ;
        }
        if (m_keyboard->getVal() == 0x0D) {                        // enter
            m_ra.arg1 = m_credentials[m_credentials_idx].ssid;     // ssid
            m_ra.arg2 = m_credentials[m_credentials_idx].password; // password
            // MWR_LOG_WARN("enter pressed ssid {}, password {}", m_ssid[m_pwd_idx], m_password[m_pwd_idx]);
            if (graphicObjects_OnRelease) graphicObjects_OnRelease(m_name, m_ra);
        }
        m_clicked = false;
        return ret;
    }
    void add_WiFi_Items(ps_ptr<char> ssid, ps_ptr<char> pw) {
        if (ssid.strlen() == 0) { ssid = ""; }
        m_credentials.emplace_back(ssid, pw);
        m_sel_ssid->addText(ssid);
    }
    void clearText() {
        m_sel_ssid->clearText();
        m_in_password->setText("");
    }

  private:
    void set_bg_color_all(uint32_t color) {
        m_bg_color = color;
        m_sel_ssid->set_bg_color(m_bg_color);
        m_in_password->set_bg_color(m_bg_color);
        //    m_keyboard->set_bg_color(m_bg_color);
    }

    void disable_all() {
        m_enabled = false;
        m_sel_ssid->disable();
        m_in_password->disable();
        m_keyboard->disable();
    }
    void enable_all() {
        m_enabled = true;
        m_sel_ssid->enable();
        m_in_password->enable();
        m_keyboard->enable();
    }

    void changePassword(char ch, uint8_t idx) {
        int len = m_credentials[idx].password.strlen();
        if (ch == 0x08) { // backspace
            if (len == 0) return;
            m_credentials[idx].password = m_credentials[idx].password.substr(0, len - 1);
        } else if (ch == 0x0D) { // enter
            //    log_w("enter pressed");
        } else {
            if (len < 63) {
                char c[2] = {0};
                c[0] = ch;
                m_credentials[idx].password.append(c);
            }
        }
    }
};
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
