schreibfaul1/ESP32-MiniWebRadio/src/mwr_src/layout.hpp

#include "Audio.h"
#include "graphical.hpp"

#pragma once

struct coor {
    uint16_t x = 0;
    uint16_t y = 0;
    uint16_t w = 0;
    uint16_t h = 0;
    uint8_t  pl = 0;
    uint8_t  pr = 0;
    uint8_t  pt = 0;
    uint8_t  pb = 0;

    // builder-methods:
    constexpr coor& pos(uint16_t X, uint16_t Y) {
        x = X;
        y = Y;
        return *this;
    }
    constexpr coor& size(uint16_t W, uint16_t H) {
        w = W;
        h = H;
        return *this;
    }
    constexpr coor& pad(uint8_t L, uint8_t R, uint8_t T, uint8_t B) {
        pl = L;
        pr = R;
        pt = T;
        pb = B;
        return *this;
    }
};

struct Layout {
    const coor& winHeader;
    const coor& winLogo;
    const coor& winName;
    const coor& winProgbar;
    const coor& winArea1;
    const coor& winArea2;
    const coor& winSTitle;
    const coor& winVUmeter;
    const coor& winSpectrum;
    const coor& winFooter;
    const coor& winButton;
    const coor& winDigits;
    const coor& winWoHF;
    const coor& sdrHP;
    const coor& sdrBP;
    const coor& sdrLP;
    const coor& sdrBAL;
    const coor& btnHP;
    const coor& btnBP;
    const coor& btnLP;
    const coor& btnBAL;
    const coor& txtHP;
    const coor& txtBP;
    const coor& txtLP;
    const coor& txtBAL;
};

struct DisplayConfig {
    const uint8_t* fonts; // Pointer auf Array mit Schriftgrößen
    uint8_t        listFontSize;
    uint8_t        headerFontSize;
    uint8_t        footerFontSize;
    uint8_t        bigNumbersFontSize;
    uint8_t        fileNumberFontSize;

    uint16_t sleeptimeXPos[5];
    uint16_t sleeptimeYPos;

    uint16_t dispWidth;
    uint16_t dispHeight;
    uint8_t  brightnessMin;
    uint8_t  brightnessMax;

    const char* tftSize; // "s", "m", "l", "xl"
};
// —————————————————————————————————————————————————————————————————————————————————————————————————————————————————————————————————————————————————————————————————————————————————————————————————————

namespace layout_320x240 {
//
//  Display 320x240
//  +-------------------------------------------+ _yHeader=0
//  | Header                                    |       winHeader=24px
//  +-------------------------------------------+ _yName=24
//  | winArea1                                  |
//  | Logo                   StationName        |       winName=96px
//  |                                           |
//  +-------------------------------------------+ _yTitle=120
//  | winArea2                                  |
//  |              StreamTitle                  |       winSTitle=96px
//  |                                           |
//  +-------------------------------------------+ _yFooter=216
//  | Footer                                    |       winFooter=24px
//  +-------------------------------------------+ 240
//                                             320

constexpr uint16_t h_res = 320, v_res = 240; // horizontal - vertical resolution
constexpr uint16_t h_footer = 24;            // footer height
constexpr uint16_t hw_btn = 40 + 0;          // 40x40 + padding, normal buttons
constexpr uint16_t hw_btn_s = 32 + 2;        // 32x32 + padding, small buttons
constexpr uint16_t w_vuMeter = 24;           // width vuMeter

constexpr uint16_t h_area = (v_res - 2 * h_footer) / 2;                      // 100, height area1 and  area2
constexpr uint16_t y_area2 = v_res - h_footer - h_area;                      // 240 - 20 - 100, yPos area2
constexpr uint16_t y_btn = y_area2 + h_area / 2 + (h_area / 4 - hw_btn / 2); // center in the lower half of area2
constexpr uint16_t h_progBar = (h_area / 2);                                 // height progressBar and volumeSlider = half of y_area - 20%
constexpr uint16_t y_progbar = y_area2;                                      // y_area2 + 10%
constexpr uint16_t h_EQ = (y_btn - h_footer) / 4;

// -----------------------------------------------------------------------------------
// window definitions .pos(x, y) .size(w, h) .padding(l, r, t, b)
// -----------------------------------------------------------------------------------

constexpr coor winHeader = coor().pos(0, 0).size(h_res, h_footer);
constexpr coor winLogo = coor().pos(0, h_footer).size(h_area, h_area).pad(0, 0, 0, 0);
constexpr coor winName = coor().pos(h_area, h_footer).size(h_res - h_area, h_area).pad(1, 1, 0, 0); // StationName
constexpr coor winProgbar = coor().pos(0, y_progbar).size(h_res, h_progBar).pad(5, 5, 0, 0);        // or volume slider
constexpr coor winArea1 = coor().pos(0, h_footer).size(h_res, h_area).pad(0, 5, 0, 3);
constexpr coor winArea2 = coor().pos(0, y_area2).size(h_res, h_area).pad(0, 5, 0, 3);
constexpr coor winSTitle = coor().pos(0, y_area2).size(h_res - w_vuMeter, h_area).pad(0, 4, 0, 3);
constexpr coor winVUmeter = coor().pos(h_res - w_vuMeter, y_area2).size(w_vuMeter, h_area).pad(0, 0, 0, 0);
constexpr coor winFooter = coor().pos(0, v_res - h_footer).size(h_res, h_footer);
constexpr coor winButton = coor().pos(0, y_btn).size(hw_btn, hw_btn);
constexpr coor winDigits = coor().pos(0, h_footer).size(h_res, y_btn - h_footer); // clock24, alarmclock
constexpr coor winWoHF = coor().pos(0, h_footer).size(h_res, 2 * h_area);
constexpr coor winSpectrum = coor().pos(0, y_area2).size(h_area, h_area).pad(0, 0, 0, 0);

// -----------------------------------------------------------------------------------
// window derived (calculated from others)
// -----------------------------------------------------------------------------------

constexpr coor btnHP = coor().pos(10, h_footer + 0 * h_EQ).size(hw_btn_s, hw_btn_s);
constexpr coor btnBP = coor().pos(10, h_footer + 1 * h_EQ).size(hw_btn_s, hw_btn_s);
constexpr coor btnLP = coor().pos(10, h_footer + 2 * h_EQ).size(hw_btn_s, hw_btn_s);
constexpr coor btnBAL = coor().pos(10, h_footer + 3 * h_EQ).size(hw_btn_s, hw_btn_s);

constexpr coor sdrHP = coor().pos(55, h_footer + 0 * h_EQ).size(150, h_EQ).pad(0, 0, 8, 8);
constexpr coor sdrBP = coor().pos(55, h_footer + 1 * h_EQ).size(150, h_EQ).pad(0, 0, 8, 8);
constexpr coor sdrLP = coor().pos(55, h_footer + 2 * h_EQ).size(150, h_EQ).pad(0, 0, 8, 8);
constexpr coor sdrBAL = coor().pos(55, h_footer + 3 * h_EQ).size(150, h_EQ).pad(0, 0, 8, 8);

constexpr coor txtHP = coor().pos(210, h_footer + 0 * h_EQ).size(105, h_EQ).pad(0, 0, 1, 1);
constexpr coor txtBP = coor().pos(210, h_footer + 1 * h_EQ).size(105, h_EQ).pad(0, 0, 1, 1);
constexpr coor txtLP = coor().pos(210, h_footer + 2 * h_EQ).size(105, h_EQ).pad(0, 0, 1, 1);
constexpr coor txtBAL = coor().pos(210, h_footer + 3 * h_EQ).size(105, h_EQ).pad(0, 0, 1, 1);

inline constexpr uint8_t fonts[13] = {15, 16, 18, 21, 25, 27, 34, 38, 43, 56, 66, 81, 96};

inline constexpr DisplayConfig config = {
    fonts,
    2 * h_area / 10,     // listFontSize
    0,                   // headerFontSize, 0 -> autoSize
    0,                   // footerFontSize, 0 -> autoSize
    156,                 // bigNumbersFontSize
    15,                  // fileNumberFontSize
    {5, 77, 129, 57, 0}, // sleeptimeXPos[5]
    48,                  // sleeptimeYPos
    h_res,               // width
    v_res,               // height
    0,                   // brightnessMin
    255,                 // brightnessMax
    "s"                  // size code
};
} // namespace layout_320x240
// —————————————————————————————————————————————————————————————————————————————————————————————————————————————————————————————————————————————————————————————————————————————————————————————————————

namespace layout_480x320 {
//
//  Display 480x320
//  +-------------------------------------------+ _yHeader=0
//  | Header   100%x10%                         |       winHeader=32px
//  +-------------------------------------------+ _yName=32
//  | winArea1 100%x40%                         |
//  | Logo                   StationName        |       winName=128px
//  |                                           |
//  +-------------------------------------------+ _yTitle=160
//  | winArea2 100%x40%                         |
//  |              StreamTitle                  |       winSTitle=128px
//  |                                           |
//  +-------------------------------------------+ _yFooter=288
//  | Footer   100%x10%                         |       winFooter=32px
//  +-------------------------------------------+ 320
//                                             480

constexpr uint16_t h_res = 480, v_res = 320; // horizontal - vertical resolution
constexpr uint16_t h_footer = 32;            // footer height
constexpr uint16_t hw_btn = 56 + 2;          // 56x56 + padding, normal buttons
constexpr uint16_t hw_btn_s = 44 + 2;        // 44x45 + padding, small buttons
constexpr uint16_t w_vuMeter = 32;           // width vuMeter

constexpr uint16_t h_area = (v_res - 2 * h_footer) / 2;                      // 130, height area1 and  area2
constexpr uint16_t y_area2 = v_res - h_footer - h_area;                      // 320 - 30 - 130, yPos area2
constexpr uint16_t y_btn = y_area2 + h_area / 2 + (h_area / 4 - hw_btn / 2); // center in the lower half of area2
constexpr uint16_t h_progBar = (h_area / 2);                                 // height progressBar and volumeSlider = half of y_area
constexpr uint16_t y_progbar = y_area2;                                      // y_area2
constexpr uint16_t h_EQ = (y_btn - h_footer) / 4;

// -----------------------------------------------------------------------------------
// window definitions .pos(x, y) .size(w, h) .padding(l, r, t, b)
// -----------------------------------------------------------------------------------
constexpr coor winHeader = coor().pos(0, 0).size(h_res, h_footer);
constexpr coor winLogo = coor().pos(0, h_footer).size(h_area, h_area).pad(0, 0, 0, 0);
constexpr coor winName = coor().pos(h_area, h_footer).size(h_res - h_area, h_area).pad(1, 1, 0, 0); // StationName
constexpr coor winProgbar = coor().pos(0, y_progbar).size(h_res, h_progBar).pad(5, 5, 0, 0);        // or volume slider
constexpr coor winArea1 = coor().pos(0, h_footer).size(h_res, h_area).pad(0, 5, 0, 3);
constexpr coor winArea2 = coor().pos(0, y_area2).size(h_res, h_area).pad(0, 5, 0, 3);
constexpr coor winSTitle = coor().pos(0, y_area2).size(h_res - w_vuMeter, h_area).pad(0, 4, 0, 3);
constexpr coor winVUmeter = coor().pos(h_res - w_vuMeter, y_area2).size(w_vuMeter, h_area);
constexpr coor winFooter = coor().pos(0, v_res - h_footer).size(h_res, h_footer);
constexpr coor winButton = coor().pos(0, y_btn).size(hw_btn, hw_btn);
constexpr coor winDigits = coor().pos(0, h_footer).size(h_res, y_btn - h_footer); // clock24, alarmclock
constexpr coor winWoHF = coor().pos(0, h_footer).size(h_res, 2 * h_area);         // window without header and footer
constexpr coor winSpectrum = coor().pos(0, y_area2).size(h_area, h_area).pad(0, 0, 0, 0);

// -----------------------------------------------------------------------------------
// window derived (calculated from others)
// -----------------------------------------------------------------------------------

constexpr coor btnHP = coor().pos(40, h_footer + 0 * h_EQ).size(hw_btn_s, hw_btn_s);
constexpr coor btnBP = coor().pos(40, h_footer + 1 * h_EQ).size(hw_btn_s, hw_btn_s);
constexpr coor btnLP = coor().pos(40, h_footer + 2 * h_EQ).size(hw_btn_s, hw_btn_s);
constexpr coor btnBAL = coor().pos(40, h_footer + 3 * h_EQ).size(hw_btn_s, hw_btn_s);

constexpr coor sdrHP = coor().pos(110, h_footer + 0 * h_EQ).size(200, h_EQ).pad(0, 0, 8, 8);
constexpr coor sdrBP = coor().pos(110, h_footer + 1 * h_EQ).size(200, h_EQ).pad(0, 0, 8, 8);
constexpr coor sdrLP = coor().pos(110, h_footer + 2 * h_EQ).size(200, h_EQ).pad(0, 0, 8, 8);
constexpr coor sdrBAL = coor().pos(110, h_footer + 3 * h_EQ).size(200, h_EQ).pad(0, 0, 8, 8);

constexpr coor txtHP = coor().pos(320, h_footer + 0 * h_EQ).size(150, h_EQ).pad(0, 0, 3, 3);
constexpr coor txtBP = coor().pos(320, h_footer + 1 * h_EQ).size(150, h_EQ).pad(0, 0, 3, 3);
constexpr coor txtLP = coor().pos(320, h_footer + 2 * h_EQ).size(150, h_EQ).pad(0, 0, 3, 3);
constexpr coor txtBAL = coor().pos(320, h_footer + 3 * h_EQ).size(150, h_EQ).pad(0, 0, 3, 3);

inline constexpr uint8_t fonts[13] = {15, 16, 18, 21, 25, 27, 34, 38, 43, 56, 66, 81, 96};

inline constexpr DisplayConfig config = {
    fonts,
    2 * h_area / 10,      // listFontSize
    0,                    // headerFontSize, 0 -> autoSize
    0,                    // footerFontSize, 0 -> autoSize
    156,                  // bigNumbersFontSize
    21,                   // fileNumberFontSize
    {5, 107, 175, 73, 0}, // sleeptimeXPos[5]
    48,                   // sleeptimeYPos
    h_res,                // width
    v_res,                // height
    0,                    // brightnessMin
    255,                  // brightnessMax
    "m"                   // size code
};
} // namespace layout_480x320
// —————————————————————————————————————————————————————————————————————————————————————————————————————————————————————————————————————————————————————————————————————————————————————————————————————

namespace layout_800x480 {
//
//  Display 800x480
//  +-------------------------------------------+ _yHeader=0
//  | Header                                    |       winHeader=48px
//  +-------------------------------------------+ _yName=48
//  | winArea1                                  |
//  | Logo                   StationName        |       winName=192px
//  |                                           |
//  +-------------------------------------------+ _yTitle=240
//  | winArea2                                  |
//  |              StreamTitle                  |       winSTitle=192px
//  |                                           |
//  +-------------------------------------------+ _yFooter=432
//  | Footer                                    |       winFooter=48px
//  +-------------------------------------------+ 480
//                                             800

constexpr uint16_t h_res = 800, v_res = 480; // horizontal - vertical resolution
constexpr uint16_t h_footer = 48;            // footer height
constexpr uint16_t hw_btn = 76 + 2;          // 76x76 + padding, normal buttons
constexpr uint16_t hw_btn_s = 65 + 2;        // 65x65 + padding, small buttons
constexpr uint16_t w_vuMeter = 40;           // width vuMeter

constexpr uint16_t h_area = (v_res - 2 * h_footer) / 2;                      // 130, height area1 and  area2
constexpr uint16_t y_area2 = v_res - h_footer - h_area;                      // 320 - 30 - 130, yPos area2
constexpr uint16_t y_btn = y_area2 + h_area / 2 + (h_area / 4 - hw_btn / 2); // center in the lower half of area2
constexpr uint16_t h_progBar = (h_area / 2);                                 // height progressBar and volumeSlider = half of y_area
constexpr uint16_t y_progbar = y_area2;                                      // y_area2
constexpr uint16_t h_EQ = (y_btn - h_footer) / 4;

// -----------------------------------------------------------------------------------
// window definitions .pos(x, y) .size(w, h) .padding(l, r, t, b)
// -----------------------------------------------------------------------------------

constexpr coor winHeader = coor().pos(0, 0).size(h_res, h_footer);
constexpr coor winLogo = coor().pos(0, h_footer).size(h_area, h_area).pad(0, 0, 0, 0);
constexpr coor winName = coor().pos(h_area, h_footer).size(h_res - h_area, h_area).pad(15, 5, 0, 0); // StationName
constexpr coor winProgbar = coor().pos(0, y_progbar).size(h_res, h_progBar).pad(15, 15, 0, 0);       // or volume slider
constexpr coor winArea1 = coor().pos(0, h_footer).size(h_res, h_area).pad(0, 5, 0, 3);
constexpr coor winArea2 = coor().pos(0, y_area2).size(h_res, h_area).pad(0, 5, 0, 3);
constexpr coor winSTitle = coor().pos(0, y_area2).size(h_res - w_vuMeter, h_area).pad(10, 5, 2, 2);
constexpr coor winVUmeter = coor().pos(h_res - w_vuMeter, y_area2).size(w_vuMeter, h_area);
constexpr coor winFooter = coor().pos(0, v_res - h_footer).size(h_res, h_footer);
constexpr coor winButton = coor().pos(0, y_btn).size(hw_btn, hw_btn);
constexpr coor winDigits = coor().pos(0, h_footer).size(h_res, y_btn - h_footer); // clock24, alarmclock
constexpr coor winWoHF = coor().pos(0, h_footer).size(h_res, 2 * h_area);
constexpr coor winSpectrum = coor().pos(0, y_area2).size(h_area, h_area).pad(0, 0, 0, 0);

// -----------------------------------------------------------------------------------
// window derived (calculated from others)
// -----------------------------------------------------------------------------------
constexpr coor btnHP = coor().pos(100, h_footer + 0 * h_EQ).size(hw_btn_s, hw_btn_s);
constexpr coor btnBP = coor().pos(100, h_footer + 1 * h_EQ).size(hw_btn_s, hw_btn_s);
constexpr coor btnLP = coor().pos(100, h_footer + 2 * h_EQ).size(hw_btn_s, hw_btn_s);
constexpr coor btnBAL = coor().pos(100, h_footer + 3 * h_EQ).size(hw_btn_s, hw_btn_s);

constexpr coor sdrHP = coor().pos(180, h_footer + 0 * h_EQ).size(380, h_EQ).pad(0, 0, 8, 8);
constexpr coor sdrBP = coor().pos(180, h_footer + 1 * h_EQ).size(380, h_EQ).pad(0, 0, 8, 8);
constexpr coor sdrLP = coor().pos(180, h_footer + 2 * h_EQ).size(380, h_EQ).pad(0, 0, 8, 8);
constexpr coor sdrBAL = coor().pos(180, h_footer + 3 * h_EQ).size(380, h_EQ).pad(0, 0, 8, 8);

constexpr coor txtHP = coor().pos(570, h_footer + 0 * h_EQ).size(200, h_EQ).pad(0, 0, 6, 6);
constexpr coor txtBP = coor().pos(570, h_footer + 1 * h_EQ).size(200, h_EQ).pad(0, 0, 6, 6);
constexpr coor txtLP = coor().pos(570, h_footer + 2 * h_EQ).size(200, h_EQ).pad(0, 0, 6, 6);
constexpr coor txtBAL = coor().pos(570, h_footer + 3 * h_EQ).size(200, h_EQ).pad(0, 0, 6, 6);

inline constexpr uint8_t fonts[13] = {15, 16, 18, 21, 25, 27, 34, 38, 43, 56, 66, 81, 96};

inline constexpr DisplayConfig config = {
    fonts,
    2 * h_area / 10,        // listFontSize
    0,                      // headerFontSize
    0,                      // footerFontSize
    156,                    // bigNumbersFontSize
    34,                     // fileNumberFontSize
    {20, 137, 223, 106, 0}, // sleeptimeXPos[5]
    112,                    // sleeptimeYPos
    h_res,                  // width
    v_res,                  // height
    0,                      // brightnessMin
    255,                    // brightnessMax
    "l"                     // size code
};
} // namespace layout_800x480
// —————————————————————————————————————————————————————————————————————————————————————————————————————————————————————————————————————————————————————————————————————————————————————————————————————
namespace layout_1024x600 {
//
//  Display 1024x600
//  +-------------------------------------------+ _yHeader=0
//  | Header                                    |       winHeader=60px
//  +-------------------------------------------+ _yName=60
//  | winArea1                                  |
//  | Logo                   StationName        |       winName=240px, area1
//  |                                           |
//  +-------------------------------------------+ _yTitle=300
//  | winArea2                                  |
//  |              StreamTitle                  |       winSTitle=240px, area2
//  |                                           |
//  +-------------------------------------------+ _yFooter=540
//  | Footer                                    |       winFooter=60px
//  +-------------------------------------------+ 600
//                                            1024

constexpr uint16_t h_res = 1024, v_res = 600; // horizontal - vertical resolution
constexpr uint16_t h_footer = 60;             // footer height
constexpr uint16_t hw_btn = 96 + 4;           // 96x96 + padding, normal buttons
constexpr uint16_t hw_btn_s = 80 + 2;         // 80x80 + padding, small buttons
constexpr uint16_t w_vuMeter = 50;            // width vuMeter

constexpr uint16_t h_area = (v_res - 2 * h_footer) / 2;                      // 240, height area1 and  area2
constexpr uint16_t y_area2 = v_res - h_footer - h_area;                      // 600 - 60 - 240, yPos area2
constexpr uint16_t y_btn = y_area2 + h_area / 2 + (h_area / 4 - hw_btn / 2); // center in the lower half of area2
constexpr uint16_t h_progBar = (h_area / 2);                                 // height progressBar and volumeSlider = half of y_area
constexpr uint16_t y_progbar = y_area2;                                      // y_area2
constexpr uint16_t h_EQ = (y_btn - h_footer) / 4;

// -----------------------------------------------------------------------------------
// window definitions .pos(x, y) .size(w, h) .padding(l, r, t, b)
// -----------------------------------------------------------------------------------

constexpr coor winHeader = coor().pos(0, 0).size(h_res, h_footer);
constexpr coor winLogo = coor().pos(0, h_footer).size(h_area, h_area).pad(0, 0, 0, 0);
constexpr coor winName = coor().pos(h_area, h_footer).size(h_res - h_area, h_area).pad(15, 5, 0, 0); // StationName
constexpr coor winProgbar = coor().pos(0, y_progbar).size(h_res, h_progBar).pad(5, 5, 20, 20);       // or volume slider
constexpr coor winArea1 = coor().pos(0, h_footer).size(h_res, h_area).pad(0, 5, 0, 3);
constexpr coor winArea2 = coor().pos(0, y_area2).size(h_res, h_area).pad(0, 5, 0, 3);
constexpr coor winSTitle = coor().pos(0, y_area2).size(h_res - w_vuMeter, h_area).pad(10, 5, 2, 2);
constexpr coor winVUmeter = coor().pos(h_res - w_vuMeter, y_area2).size(w_vuMeter, h_area).pad(5, 5, 5, 5);
constexpr coor winFooter = coor().pos(0, v_res - h_footer).size(h_res, h_footer);
constexpr coor winButton = coor().pos(0, y_btn).size(hw_btn, hw_btn);
constexpr coor winDigits = coor().pos(0, h_footer).size(h_res, y_btn - h_footer); // clock24, alarmclock
constexpr coor winWoHF = coor().pos(0, h_footer).size(h_res, 2 * h_area);
constexpr coor winSpectrum = coor().pos(0, y_area2).size(h_area, h_area).pad(0, 0, 0, 0);

// -----------------------------------------------------------------------------------
// window derived (calculated from others)
// -----------------------------------------------------------------------------------

constexpr coor btnHP = coor().pos(100, h_footer + 0 * h_EQ).size(hw_btn_s, hw_btn_s);
constexpr coor btnBP = coor().pos(100, h_footer + 1 * h_EQ).size(hw_btn_s, hw_btn_s);
constexpr coor btnLP = coor().pos(100, h_footer + 2 * h_EQ).size(hw_btn_s, hw_btn_s);
constexpr coor btnBAL = coor().pos(100, h_footer + 3 * h_EQ).size(hw_btn_s, hw_btn_s);

constexpr coor sdrHP = coor().pos(220, h_footer + 0 * h_EQ).size(500, h_EQ).pad(0, 0, 8, 8);
constexpr coor sdrBP = coor().pos(220, h_footer + 1 * h_EQ).size(500, h_EQ).pad(0, 0, 8, 8);
constexpr coor sdrLP = coor().pos(220, h_footer + 2 * h_EQ).size(500, h_EQ).pad(0, 0, 8, 8);
constexpr coor sdrBAL = coor().pos(220, h_footer + 3 * h_EQ).size(500, h_EQ).pad(0, 0, 8, 8);

constexpr coor txtHP = coor().pos(730, h_footer + 0 * h_EQ).size(260, h_EQ).pad(0, 0, 4, 4);
constexpr coor txtBP = coor().pos(730, h_footer + 1 * h_EQ).size(260, h_EQ).pad(0, 0, 4, 4);
constexpr coor txtLP = coor().pos(730, h_footer + 2 * h_EQ).size(260, h_EQ).pad(0, 0, 4, 4);
constexpr coor txtBAL = coor().pos(730, h_footer + 3 * h_EQ).size(260, h_EQ).pad(0, 0, 4, 4);

inline constexpr uint8_t fonts[13] = {15, 16, 18, 21, 25, 27, 34, 38, 43, 56, 66, 81, 96};

inline constexpr DisplayConfig config = {
    fonts,
    2 * h_area / 10,        // listFontSize
    0,                      // headerFontSize, 0 -> autoSize
    0,                      // footerFontSize, 0 -> autoSize
    156,                    // bigNumbersFontSize
    34,                     // fileNumberFontSize
    {20, 137, 223, 106, 0}, // sleeptimeXPos[5]
    112,                    // sleeptimeYPos
    h_res,                  // width
    v_res,                  // height
    0,                      // brightnessMin
    255,                    // brightnessMax
    "xl"                    // size code
};
} // namespace layout_1024x600
// —————————————————————————————————————————————————————————————————————————————————————————————————————————————————————————————————————————————————————————————————————————————————————————————————————

// Factory-Funktion (Compile-Time)
inline Layout makeLayout() {
#ifdef TFT_LAYOUT_S
    using namespace layout_320x240;
#elifdef TFT_LAYOUT_M
    using namespace layout_480x320;
#elifdef TFT_LAYOUT_L
    using namespace layout_800x480;
#elifdef TFT_LAYOUT_XL
    using namespace layout_1024x600;
#else
    printf() "Unsupported TFT_LAYOUT\n"
#endif
    return {winHeader, winLogo, winName, winProgbar, winArea1, winArea2, winSTitle, winVUmeter, winSpectrum, winFooter, winButton, winDigits, winWoHF,
            sdrHP,     sdrBP,   sdrLP,   sdrBAL,     btnHP,    btnBP,    btnLP,     btnBAL,     txtHP,       txtBP,     txtLP,     txtBAL};
}

// global constant - finished initialized
inline const Layout layout = makeLayout();
//----------------------------------------------------------------------------------------------------------------------------------------------------
inline DisplayConfig makeDisplayConfig() {
#ifdef TFT_LAYOUT_S
    using namespace layout_320x240;
#elifdef TFT_LAYOUT_M
    using namespace layout_480x320;
#elifdef TFT_LAYOUT_L
    using namespace layout_800x480;
#elifdef TFT_LAYOUT_XL
    using namespace layout_1024x600;
#else
    printf("Unsupported TFT_LAYOUT\n");
#endif
    return config;
}

inline const DisplayConfig displayConfig = makeDisplayConfig();
// —————————————————————————————————————————————————————————————————————————————————————————————————————————————————————————————————————————————————————————————————————————————————————————————————————

/*         ╔═════════════════════════════════════════════════════════════════════════════════════════════════════════════════════════════════════════════════════════════════════════════╗
           ║                                                                                  M E N U E / B U T T O N S                                                                  ║
           ╚═════════════════════════════════════════════════════════════════════════════════════════════════════════════════════════════════════════════════════════════════════════════╝   */
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
