schreibfaul1/ESP32-MiniWebRadio/src/mwr_src/classes.hpp

#include "Audio.h"
#include "Arduino.h"
#include "common.h"

#pragma once

// ——————————————————————————————————————————————————————————————————————————————————————————————————————————————————————————————————————————————————————————————————————————————————————————————————————
// 📌📌📌  S D _ C O N T E N T   📌📌📌
// ——————————————————————————————————————————————————————————————————————————————————————————————————————————————————————————————————————————————————————————————————————————————————————————————————————
class SD_content {

  private:
    struct FileInfo {
        int32_t      fileSize;
        ps_ptr<char> fileName;
        ps_ptr<char> filePath;

        FileInfo(int32_t fs, ps_ptr<char> fn, ps_ptr<char> fp) : fileSize(fs), fileName(fn), filePath(fp) {}

        ~FileInfo() = default;
        FileInfo(const FileInfo&) = default;
        FileInfo& operator=(const FileInfo&) = default;
    };
    std::vector<FileInfo> m_files;
    ps_ptr<char>          m_buff;
    ps_ptr<char>          m_lastConnectedFile = "";
    ps_ptr<char>          m_lastConnectedFolder = "";
    ps_ptr<char>          m_lastConnectedFileName = "";
    ps_ptr<char>          m_JSONstr;

  public:
    SD_content() { m_files.clear(); }
    ~SD_content() {
        m_files.clear();
        m_JSONstr.reset();
        m_lastConnectedFile.reset();
        m_lastConnectedFolder.reset();
        m_lastConnectedFileName.reset();
    }

    bool listFilesInDir(ps_ptr<char> path, boolean audioFilesOnly, boolean withoutDirs) {
        m_files.clear();

        if (!SD_MMC.exists(path.c_get())) {
            printfln(s_tag.sd_card, ANSI_ESC_RED "SD_MMC/{} not exist", path);
            return false;
        }

        File masterFile = SD_MMC.open(path.c_get());

        if (!masterFile || !masterFile.isDirectory()) {
            printfln(s_tag.sd_card, ANSI_ESC_RED "SD_MMC/{} is not a directory", path);
            masterFile.close();
            return false;
        }

        while (true) {
            File slaveFile = masterFile.openNextFile();
            if (!slaveFile) break;

            if (slaveFile.isDirectory()) {
                if (!withoutDirs) {
                    ps_ptr<char> filePath = slaveFile.path();
                    filePath.append("/");

                    m_files.emplace_back(-1, slaveFile.name(), filePath);
                }
            } else {
                ps_ptr<char> name = slaveFile.name();
                if (!audioFilesOnly ||         //
                    name.ends_with(".mp3") ||  //
                    name.ends_with(".aac") ||  //
                    name.ends_with(".m4a") ||  //
                    name.ends_with(".wav") ||  //
                    name.ends_with(".m3u") ||  //
                    name.ends_with(".flac") || //
                    name.ends_with(".opus") || //
                    name.ends_with(".ogg")) {  //

                    m_files.emplace_back( //
                        slaveFile.size(), //
                        slaveFile.name(), //
                        slaveFile.path()  //
                    );
                }
            }
            slaveFile.close();
        }
        sort();
        masterFile.close();
        return true;
    }

    bool isDir(uint16_t idx) {
        if (idx >= m_files.size()) {
            MWR_LOG_ERROR("idx {} is oor, max = {}", idx, m_files.size() - 1);
            return false;
        }

        return m_files[idx].fileSize == -1; // -1 means dir
    }

    size_t getSize() { return m_files.size(); }

    ps_ptr<char> getColouredSStringByIndex(uint16_t idx) {
        if (m_files.size() == 0) {
            MWR_LOG_WARN("m_files.size() is 0");
            return "";
        }
        if (m_files.size() < idx + 1) {
            MWR_LOG_WARN("idx {} is oor, max = {}", idx, m_files.size());
            return "";
        }
        if (m_files[idx].fileSize == -1) return m_files[idx].fileName;                            // directory
        m_buff.assignf("{}" ANSI_ESC_YELLOW " {}", m_files[idx].fileName, m_files[idx].fileSize); // file
        return m_buff;
    }

    ps_ptr<char> getFileNameByIndex(uint16_t idx) {
        if (idx >= m_files.size()) {
            MWR_LOG_WARN("idx {} is oor, size = {}", idx, m_files.size());
            return "";
        }
        return m_files[idx].fileName;
    }

    int32_t getFileSizeByIndex(uint16_t idx) {
        if (idx >= m_files.size()) {
            MWR_LOG_WARN("idx {} is oor, size = {}", idx, m_files.size());
            return 0;
        }
        return m_files[idx].fileSize; // returns -1 for dirs
    }
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
