schreibfaul1/ESP32-MiniWebRadio/(commit log)

2018-03-15 example partition for more nvs memory
    [default.csv]
2018-04-12 now shows alternate streamtitle correct
    [MiniWebRadio.ino]
2018-04-24 have more memory in nvs and app
    [default.csv]
2018-08-13 add sleeptimer
    fix: if alarm switch display on
    [MiniWebRadio.ino]
2018-09-04 can handle UTF-8
    no longer codepages needed,
    streamtitles are directly changes from UTF-8 in Unicode
    presets can now edited with notepad,
    [MiniWebRadio.ino]
2018-10-02 change imagetype
    buttons and logos are .jpg (no longer bmp) for faster loading
2019-01-25 ready for espressif esp32 v 1.0.1-rc4
2021-06-24 some minor fixes and improvements
    ticker instead of timer
    csv instead of txt
    unknown.jpg move in folder logo
    use websockets for many requests incoming and outgoing, reducing xhr requests
    [MiniWebRadio.ino]
2021-06-24 connectToWiFi() correct first index
    [MiniWebRadio.ino]
2021-07-05 display 5V connection was missing
2021-07-07 platfornio files added
    [miniwebradio.csv]
2021-08-09 Add files via upload
    plays now url like this;
    https://www.fantasyfoxradio.de/infusions/gr_radiostatus_panel/gr_radiostatus_player.php?id=2&p=asx
2021-11-04 Arduino V2.0.1-RC1
2022-02-11 : saveFile() corrected path
    [main.cpp]
2022-02-16 new IR pin
2022-03-01 fix setBrightness() in setup()
    [main.cpp]
2022-03-09 setVolume() was missing in prototypes
    [common.h]
2022-03-21 fix err setSocketOption(): 1006 : 9
    [main.cpp]
2022-04-05 initializer-string for array of chars is too long #81
    [main.cpp]
2022-04-09 fix mute() if IR button is bounced
    [main.cpp]
2022-04-10 small corrections
    toggle Mute Button in Clock and Audioplayer
    [main.cpp]
2022-04-10 avoid collisions in websvr.send()
    err in browser: can't decode UTF-8
    [main.cpp]
2022-04-12 ESP32 Arduino V2.0.2
2022-04-25 in pref: key too long
    change timeAnnouncement in timeAnnouncing
    [main.cpp]
2022-05-05 some corrections
    use websocket instead HTTPrequests(XHR)
    [main.cpp]
2022-05-15 fix gpi err if pin is -1
    [main.cpp]
2022-05-31 prepare for ESP32S3
2022-06-01 ESP32-S3 ready
2022-06-01 timeout increased
    performance issuse with new Arduino version
    if Webpage is open, image transfer is slow, not Wifi but SD or SD_MMC
    https://github.com/espressif/arduino-esp32/issues/6689
    [audiotask.cpp]
2022-07-01 bitmaps are not correct rotated #101
    Since there is another primary SPI bus (FSPI) for ESP32-S3, the symbol 'SPI' (VSPI) is no longer applicable.
2022-07-04 fix audio interruptions #105
    [audiotask.cpp, common.h, main.cpp]
2022-07-10 Add files via upload
    new board AI Thinker ESP32-S3-12K
2022-10-19 Arduino V2.0.5 some unused variables removed
2023-03-13 fix m3u with audiofiles in subfolder #136
    [main.cpp]
2023-03-14 fix URLdecode in VLC m3u files #136 add: urldecode() del: UTF8toASCII() del: ASCIItoUTF8()
    [common.h, main.cpp]
2023-03-24 add DLNA service
    [miniwebradio.csv]
2023-03-27 fixed DLNA load prohibited String JSON.stringify() too long SoapESP32 Lib is moved in Arduino Task Loop to prevent super long strings
    [main.cpp]
2023-03-27 avoid compiler warnings [-Wmissing-field-initializers]
    [main.cpp]
2023-04-08 ready for VORBIS streams both VS1053 and I2S tested: http://play.global.audio/bgradio_low.ogg http://play.global.audio/veronika_low.ogg http://play.global.audio/nrj_low.ogg http://icecast.ithost.it:8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
2023-04-22 Bit rate display
    if the bit rate is transmitted in the HTTP response header, then this is displayed. If this is not the case, the bit rate is taken from the decoder. If the bit rate is variable, an average is displayed every 10s (only VS1053)
2023-04-22 fix Build error #154
    forgot prototyp uint32_t audioGetBitRate();
    [common.h]
2023-05-02 Arduino as component
2023-05-02 Arduino Running Core 1
2023-05-03 more optimizations
    ESP-ASIO Enable SSL/TLS support of ASIO (async IO)
    ESP32-specific --> support for external SPI connected RAM --> SPIRAM config (*) Try to allocate memories of WiFi and LWIP in SPIRAM firstly
    (this increases free heap considerably)
2023-05-04 FreeRtos 1000Hz
2023-05-06 new env esp32s3
2023-05-07 avoid delays while showing bitrate
    [main.cpp]
2023-05-11 unnecessary deletion of the buttons eliminated
    and some symbols renamed
2023-05-11 clear streamtitle area before print buttons
2023-05-15 set build flags for both environments
    ESP32 set CONFIG_IDF_TARGET_ESP32
    ESP32-S3 set CONFIG_IDF_TARGET_ESP32S3
2023-05-18 new board def for S3 boards with native USB only
2023-05-21 add pause buttons
2023-05-22 small buttons
2023-05-23 new layout small buttons
2023-05-24 new buttons pauseResume and stopSong in audioplayer
2023-05-24 fix pauseResume() if is a webfile
    [main.cpp]
2023-06-10 Small display bug #183
    [common.h, main.cpp]
2023-06-11 TP accuracy #183 new boards: ESP32-S3-DevKitC-1-N8R2 ESP32-S3-DevKitC-1-N8R8 ESP32-S3-DevKitC-1-N16R2
2023-06-21 new boards
    [miniwebradio16MB.csv, miniwebradio8MB.csv]
2023-06-21 Board Def
2023-06-21 avoid VU meter overflow
    [main.cpp]
2023-06-22 all partition tables consolidated
    [miniwebradio16MB.csv, miniwebradio4MB.csv, miniwebradio8MB.csv]
2023-06-22 more reliable web query some XMLHttpRequest replaced by websockets
    [main.cpp]
2023-06-24 fix Exception caused by settings.json file #179
    [audiotask.cpp, main.cpp]
2023-06-24 add coredump partitions #204
    [miniwebradio16MB.csv, miniwebradio4MB.csv, miniwebradio8MB.csv]
2023-06-25 LEDC init adn SD items
    [miniwebradio16MB.csv, miniwebradio4MB.csv, miniwebradio8MB.csv]
2023-06-26 Core dump data check failed #206
    [miniwebradio16MB.csv]
2023-06-28 filetree icons
    [miniwebradio16MB.csv]
2023-07-01 flush ans stop cmdclient after socket operation
2023-07-01 fix Time announcement #209
    [main.cpp]
2023-07-02 mbedTLS is no longer tied to the PSRAM #215
    [common.h]
2023-07-02 Recompile without PSRAM causes SSID wifi connect issues #215
    [audiotask.cpp, index.js.h]
2023-07-04 new symbols in footer + fix vs1053 ssl crash
    [common.h]
2023-07-05 Crash when playing Arabella Rock #214
    [main.cpp]
2023-07-06 go to sleep if mute button is pressed for more than 2.5s
2023-07-06 Added time zone selection list timezone.csv on SD_MMC Web server extended socket.send(datetime="12.05.2023&07:00:00" ) will extract cmd: "datatime" param: "12.052023" arg: "07:00:00" new function RTC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
2023-07-06 new symbols for sleep buttons
2023-07-07 Crashes if settings.json does not contain Timezone entry #231
    [index.js.h, main.cpp]
2023-07-09 Crashes if settings.json does not contain Timezone entry (Issue #231)
    [common.h, main.cpp]
2023-07-09 Alarm trigger does not turn on display and wake from sleep (Issue #234)
    [main.cpp]
2023-07-09 Alarm volume bug #227
    [main.cpp]
2023-07-17 ESP32-S3 R8N8 and R8N16, new IR_Pin
2023-07-22 brightness buttons #258
2023-07-26 too many node refreshs and Arduino V2.0.11
2023-07-27 Ajax request replaced by new XMLHttpRequest
    [index.js.h]
2023-07-28 vumeter swap left right
    [main.cpp]
2023-08-17 tft add ANSI ESC COLOR
2023-08-17 all List Buttons for small displays
2023-08-17 add List Buttons (s)
2023-08-18 timer before state changes in footer on RSSI place
2023-08-21 Button_List_x.jpg (m) replaced
    Button_List_Yellow.jpg
    Button_List_Red.jpg
    Button_List_Green.jpg
    Button_List_Blue.jpg
2023-08-23 fix "PM" in 12h time format
    [main.cpp]
2023-08-25 Web UI on Android Smartphones or Tablets: next/previous Station Button switches two stations forward or back #286
    On systems with mouse operation there are the html events "onmousedown" and "onmouseup", on platforms like Android "ontouchstart" and "ontouching". Probably on newer devices/versions for touch operation the mouse events are also emulated. On my tablet I was able to reproduce the error. I have now used "onclick" for previous and next station.
2023-08-25 fix defaultsettings()
    If nvs has been deleted and sumstations > 0 in settings.json, nvs will not be refilled
    [main.cpp]
2023-08-31 Missing SD file: digits/s/foldedNumbers/6white.jpg #290
    [main.cpp]
2023-09-02 avoid crash if PSRAM could not init #292
    add guard
    - if PSRAM not found
    - wrong ESP chip detected
    - if SD_MMC not works
    [main.cpp]
2023-09-22 play all files in folder with touch button
2023-09-23 little fix, close playlist correctly
    [main.cpp]
2023-09-29 PSRAM size not printed in Serial Monitor. #300
2023-10-08 TFT GIF decoder enabled FFat prepared for flash >= 8M
    [miniwebradio16MB.csv, miniwebradio8MB.csv]
2023-10-12 wrong image format (gif -> jpg)
    [main.cpp]
2023-10-13 prepare for Arduino V3.0 and IDF V5.1
2023-10-24 prepare for Arduino V3.0 and IDF V5.1 (part2)
2023-10-24 new shuffle button
2023-11-01 impl A2DP Sink (ESP32 only)
2023-11-02 BT impl next/previous track
2023-11-23 fix: show stationname in edit dialog
    [main.cpp]
2023-11-26 little fix in endsWith()
    [main.cpp]
2023-12-20 dlna fix Touchpoint not valid
    [main.cpp]
2023-12-21 dlna browse server reset _dlnaItenNr
    [main.cpp]
2023-12-27 Arduino_JSON removed (not longer in use)
2023-12-27 fix memory leak forgot free()
    [main.cpp]
2024-01-10 System hangs after "audiotask: priority is 2 (Issue #333)
    [main.cpp]
2024-01-13 RGB LED on ESP32-S3 N16R8 and Bluetooth KCX-BT #330
2024-01-20 KCX_BT_EMITTER impl. part 11 webserver socket messages 255 bytes --> 64KB
2024-02-09 introduced: esp_reset_reason() don't connect to last host if a reset is caused by watchdog or panic or stack overflow
    [main.cpp]
2024-02-15 forgot "break" in switch statement
2024-02-19 avoid crash if DLNA Client is not responding
    [main.cpp]
2024-03-01 prepare for IDF 5,1
    [miniwebradio16MB.csv, miniwebradio4MB.csv, miniwebradio8MB.csv]
2024-03-02 prepare for the next master Arduino 3.0.0 (alpha3) enabled new IDF is V 5.1.2 old a2dp_sink removed
2024-03-03 prepare partitions for OTA
    note: never set NVS in this range
    Flash will be erased from 0x00000000 to 0x00003fff...
    Flash will be erased from 0x00008000 to 0x00008fff...
    Flash will be erased from 0x0000e000 to 0x0000ffff...
    [miniwebradio16MB.csv, miniwebradio4MB.csv, miniwebradio8MB.csv]
2024-03-05 partitios moved
    [miniwebradio16MB.csv, miniwebradio4MB.csv, miniwebradio8MB.csv]
2024-03-06 fix ESP32-S3-12K (AI-Thinker) #360
2024-03-07 add boards (ESP-S3-12K)
2024-03-11 bt button (ESP32) removed Issue #367
    [main.cpp]
2024-03-18 new arduino-esp32.git
2024-03-22 Changing Display Brightness (Issue #373) and seek dlna server 1s delay
    [main.cpp]
2024-04-06 do not ledcAttach() if TFT_BL is not set
2024-04-15 update A1S Board
2024-04-15 Arduino 3.0.0-rc1
2024-04-20 prepare for equalizer on display found small error in GIF Decoder
    [main.cpp]
2024-04-22 z300 font problems (Issue #399)
    [main.cpp]
2024-04-25 <labe>l by <img> replaced
    [common.h, main.cpp]
2024-04-27 more object buttons
2024-04-29 removed; DLNA ready button
2024-05-08 set BT button inactive
2024-05-08 button 2 state: set inactive
2024-05-09 fix Garamond Latin Extended A
    [common.h, main.cpp]
2024-05-11 _curAudioFolder replace Strig by char*
    [common.h, main.cpp]
2024-05-17 reconnect if DNS fails
    [main.cpp]
2024-05-23 add Off button
2024-05-23 add changes via update
    [miniwebradio16MB.csv, miniwebradio4MB.csv, miniwebradio8MB.csv]
2024-05-24 some improvements draw VUmeter correctly timecounter smoother
    [common.h, main.cpp]
2024-05-24 remove Off button artifact #430
2024-05-25 BT Emitter PowerOn (ESP32-S3) #405 fix wrong coredump size in 4MB partition
    [miniwebradio4MB.csv]
2024-06-04 enable statistics s + <RETURN> in terminal TASKNAME | RUNTIMECOUNTER | TOTALRUNTIME[%] | CORE | PRIO | --------------------+----------------+-----------------+------+-------| loopTask | 425912373 | 9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
2024-06-05 Problem when scrolling long lists on DLNA server (Issue #443)
    [audiotask.cpp, common.h, main.cpp]
2024-06-05 dlnalist code more clear use guards to avoid load prohibited call is outside vector.size()
    [common.h]
2024-06-08 set correct class name #449
    [common.h]
2024-06-14 fix a couple of spelling error
    Detected by codespell.
    [index.js.h, main.cpp]
2024-06-16 no ssid or ssid too long #447 avoid this message if ssid is empty (\t\t\n) in networks.csv
    [main.cpp]
2024-06-17 add I2C TwoWire
2024-06-17 prepare for second I2C bus
2024-06-17 mute I2C DAC
2024-06-21 Pin of sleep mode #457
2024-06-28 BT power management part 1 add on/off buttons on webpage and display
2024-07-16 ESP32 new pin assignment GPIO12 --> TFT_BL GPIO32 --> BT_EMITTER_CONNECT
2024-07-25 Try to restore the WiFi connection after it was interrupted by the router
2024-07-27 stationname in "preset" is missing #466
    [main.cpp]
2024-07-27 V3.3 switch to Arduino V3.0.2 without changes in menuconfig TCP extra settings are no longer necessary
    [common.h, main.cpp]
2024-07-28 fix Remnants of a long title. #469
    [common.h, main.cpp]
2024-07-31 Arduino Core --> 0
2024-08-01 fix Cannot read properties of null (reading 'add') at socket.onmessage
    [common.h, main.cpp]
2024-08-02 add volume slider and delete volumeUp/Down buttons
2024-08-02 brightnessbar ba slider replaced
    [common.h, main.cpp]
2024-08-02 new off buttons
2024-08-03 Light sensor BH1750 activated
2024-08-04 Arduino 3.0.4
2024-08-05 couple volume slider
2024-08-05 log monitor filter
2024-08-07 fix brightness control in v3.3 #479
    [main.cpp]
2024-08-07 Some issues on Ai-Thinker AudioKit ESP32 A1S (ES8388) #475
2024-08-07 corr. pin assignment #475
2024-08-08 no longer need piprs as new line
    [main.cpp]
2024-08-17 Radio is not working without Internet - Not an issue - just a question. #484
    [main.cpp]
2024-08-18 HP, TP swapped #489
    [common.h, main.cpp]
2024-08-19 insert new table
2024-08-21 replace hide by fav
    [common.h, main.cpp]
2024-08-22 fix err in json
    [common.h, main.cpp]
2024-08-24 add WiFi buttons and de/encryption aes routines
2024-09-02 IR Remote Issue #502
    [main.cpp]
2024-09-03 Feature request/ Issue - Player #491
    [common.h, main.cpp]
2024-09-04 new SD_contnent, very unstable
    [common.h, main.cpp]
2024-09-05 curAudioFileNr corr wrong value
    [common.h, main.cpp]
2024-09-09 problem with time display in sleep mode #505
    [common.h, main.cpp]
2024-09-10 Arduino V3.1.0
2024-09-21 sdkconfig for ESP32 is working
2024-09-30 OTA for ESP32-S3
2024-09-30 add ESP32_OTA
2024-10-01 Correction in the sdkconfig.esp32s3 #514
2024-10-01 set ir address if != 0x00 if address code != 0x00 save addresscode as button 32 assign awake to it command as extra function fix contentLength in webserver WS_onRequest() extend ir_buttons.json (para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
    [common.h, main.cpp]
2024-10-04 fix byte counting in WEBSRV_onRequest()
    [main.cpp]
2024-10-08 add pullup resistors on TX/RX, avoid random chars
2024-10-10 click function in player progressbar click -> skip to this position
    [common.h, main.cpp]
2024-10-14 corr. too many buttons in _playerSubmenu1
2024-10-24 fix err in SD_rename
    [main.cpp]
2024-10-25 back to Arduino 3.0.5
2024-10-29 avoid null in lastconnectedfile #537
    [main.cpp]
2024-10-29 Arduino V3.0.7 ready
2024-10-31 Issue with ESP32-S3-DevKitC-1-N8R2 board #540
    [main.cpp]
2024-11-01 default board
2024-11-06 connecttohost fail often #533
    [main.cpp]
2024-11-06 radio freeze (Issue #533)
    [main.cpp]
2024-11-08 show request fail as streamtitle
    [main.cpp]
2024-11-11 Time display not correct (Issue #556)
    [common.h]
2024-11-11 Bluetooth problems (Issue #530)
    [main.cpp]
2024-11-12 Player Fehler und Neustart #558 toastr timeout increased prepare timezones.json
2024-11-14 show "oom" if malloc fail
    [common.h]
2024-11-17 IR On/Off button impl.
2024-11-27 new IR buttons
2024-11-27 add IR sleep timer
2024-12-07 IR dlnaList some error fixing
    [common.h]
2024-12-10 Play All issue #569
    [main.cpp]
2024-12-11 Play All issue #569 Pt2
    [common.h, main.cpp]
2024-12-13 fix memory leak in _cur_AudioFolder
    [common.h, main.cpp]
2024-12-14 more ANSI ESC COLORCODES #define ANSI_ESC_GREY "\033[90m" #define ANSI_ESC_LIGHTRED "\033[91m" #define ANSI_ESC_LIGHTGREEN "\033[92m" #define ANSI_ESC_LIGHTYELLOW "\033[93m" #define ANSI_ESC_LIGHTBLU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
    #define ANSI_ESC_DARKRED "\033[38;5;52m"
    #define ANSI_ESC_DARKGREEN "\033[38;5;22m"
    #define ANSI_ESC_DARKYELLOW "\033[38;5;136m"
    #define ANSI_ESC_DARKBLUE "\033[38;5;17m"
    #define ANSI_ESC_DARKMAGENTA "\033[38;5;53m"
    #define ANSI_ESC_DARKCYAN "\033[38;5;23m"
    #define ANSI_ESC_DARKGREY "\033[38;5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
2024-12-14 The clock is not working. #575
    [main.cpp]
2024-12-14 close existing socket before reload
2024-12-14 preload all buttons
2024-12-18 Stations-List scrolling up (IR Remote-Control) (Issue #577)
    [common.h]
2024-12-22 avoid crash if DLNA next folder is empty
    [common.h]
2024-12-23 new ANSI ESC code LIGHTBROWN
2024-12-23 typo, color current Iitem magenta
2024-12-27 BT_EMITTER Pindefinition -1 Fehlermeldung (Issue #576)
    [main.cpp]
2024-12-29 bug report (set volume via dlna menu) #581 switch to last station
    [main.cpp]
2025-01-04 limit station name, avoid a crash
    [main.cpp]
2025-01-09 Versions- und Datumstring wird nicht vollständig angezeigt #592
2025-01-10 Revert "delete some files"
    This reverts commit 49d2bbddbfc14568f4ea4ae9a24240e3a271469a.
    [common.h, index.js.h, main.cpp]
2025-01-12 Web-Srv: "Play All" during running Playlist (Issue #594)
    [main.cpp]
2025-01-19 new board ESP32-S3-N4R8
2025-01-19 ESP32-S3 wrong memType
2025-01-22 new Boards with octal flash
    [miniwebradio32MB.csv]
2025-01-24 esp_lcd_panel is not part of ESP32#610
2025-01-26 build error ESP32-S3 WROOM N16R8 #614
    [main.cpp]
2025-01-27 prepare for Arduino "hybrid compile" Some changes so that it can be compiled without espidf
2025-01-28 SPI clock 120MHz
2025-02-01 add png decoder split TFT into SPI and RGB split TP into capacitice and resistive panels add flags and show in RADIO mode
2025-02-03 impl. framebuffer
2025-02-04 new buttons dlna, player, list
2025-02-04 new buttons OffTimer, Settings, Clock
2025-02-04 button pause
2025-02-05 last buttons
2025-02-05 old buttons removed
2025-02-05 V3.7 Bugs in the latest version. (Issue #623)
    [main.cpp]
2025-02-05 V3.7 Bugs in the latest version. #623 pt2
    [common.h, main.cpp]
2025-02-06 Issue #626 + Issue #623
    [common.h, main.cpp]
2025-02-07 introduce a third framebuffer
2025-02-08 hmi-rhb 3 framebuffer
2025-02-09 ser ESP32-S3 guards
2025-02-11 large buttons
2025-02-12 Bugs in the latest version. (Issue #623)
    [common.h, main.cpp]
2025-02-12 new fontsize 96px
    [miniwebradio4MB.csv]
2025-02-17 ESP32, AC101,ES8388 removed
2025-02-18 Arduino 3.1.3
2025-02-19 esp_lcd_panel_rgb.h not found for env [esp32] #610
2025-02-26 show unknown if flag doesn't exists
    [common.h, main.cpp]
2025-02-28 GT911 touch 无法使用 (Issue #639)
    [common.h]
2025-02-28 Arduino 3.2.0 IDF 5.4.0
2025-03-06 reduce jitter in rgb dma
    [common.h]
2025-03-06 GPIO for ext. Ampl. (Issue #608)
    [common.h, main.cpp]
2025-03-24 tft reset() after begin()
    [common.h, main.cpp]
2025-03-25 Community Radio Browser search engine does not work. (Issue #658)
    [main.cpp]
2025-03-27 V4-pre-release Compiling Error in main.cpp line 3132 #659 add new argument in openAI-speech add display keyboard for late use
    [common.h, main.cpp]
2025-03-28 add new WiFi Button for later use
2025-04-10 add WiFi_Settings delete networks.csv in zip delete accesspoint.h open WiFiSettings on display if credentials are not correct
    [common.h, main.cpp]
2025-04-11 prepare for V4 (part2) timezones.csv is obsolete and therefore deleted in zip process timezones_json in index.h instead timezones.csv delete some ESP32 partitions
2025-04-13 Uhrzeit in Titelzeile fehlerhafte Darstellung bei TFT_FONT Arial (Issue #669)
    [common.h]
2025-04-15 Wifi problem (Issue #670)
    [main.cpp]
2025-04-19 emojis, little correction + add to spi displays
2025-04-26 BT is starting later. (Issue #676)
    [main.cpp]
2025-05-21 Web-Interface: Save stations (make a backup) (Issue #688) and prepare for ESP32-P4
    [common.h, main.cpp]
2025-07-10 Arduino V3.2.1
2025-07-11 redirect Arduino logs to main
2025-07-15 add ser ternanal: ansi-reset
    [common.h, main.cpp]
2025-07-15 more sockets, better terminal inpl. , bigger loop task stack
2025-07-17 introduce logBuffer, avoid stack overflow
    [common.h, main.cpp]
2025-07-17 error /png/Button_Volume_Down_Yellow #704
2025-07-19 Arduino 3.3.0 IDF 5.5.0
2025-07-22 AAC-64 Station: Software Reset due to exception/panic #705
    [common.h]
2025-08-02 Error in syntax main.cpp (Issue #709)
    [common.h, main.cpp]
2025-10-12 power on/off
2025-10-21 Arduino 3.3.2 IDF 5.5.1
2025-10-27 deaktivate kcx_bt_emitter if pin is -1
2025-11-01 add poweroff mode
2025-11-04 pin assignment
2025-11-05 fix err in pin assignment
    [common.h]
2025-11-09 avoid compiler warning in display_sleeptime()
    [common.h, main.cpp]
2025-11-09 new schematic
2025-11-10 fix: sometimes the stream titles are not displayed.
    [common.h, main.cpp]
2025-11-13 Platform.ini, RU_voice (Issue #733)
    [common.h, main.cpp]
2025-11-16 Display brightness and sound (Issue #724)
    [main.cpp]
2025-11-24 Display brightness cannot be adjusted (Issue #745)
    [common.h, layout.hpp, main.cpp, settings.h]
2025-11-26 del ANSI ESC in websrv.send
2025-11-30 Playlist problem with Version 4.0.4i - 23.11.2025 #747 nullptr in m_ra.arg
    [common.h, graphical.hpp]
2025-12-08 ledc: ledc_update_duty(989): LEDC is not initialized #754
2025-12-12 Build error #759 and prepare for DSI (MIPI) Display 1024x600
    [graphical.hpp, layout.hpp, main.cpp]
2025-12-18 Elecrow 5'' build error
    [main.cpp, settings.h]
2026-01-17 Bluetooth wieder an nach Ausschalten mit Off-Button #763
2026-01-23 add missing buttons
2026-01-27 DSI Display schematic
2026-02-02 MWR fails after WiFi OFF and WiFi ON #768
    [main.cpp]
2026-02-06 Bezeichner der Equalizer Slider fehlen. Fixes #782 + Bluetooth bleibt nicht aus. Fixes #781
    [common.h, main.cpp]
2026-02-08 questions about the current version #783 item 1 change state DLNA -RADI0, show RSSI and connect to last station
2026-02-08 questions about the current version #783 (2)
2026-02-08 questions about the current version #783 item 2
2026-02-10 Bezeichner der Equalizer Slider fehlen bei 4.1.0c4 immer noch. #785
2026-02-24 add railHight in progressBar
2026-02-26 special character ș Ș ț Ț #786
    [miniwebradio16MB.csv, miniwebradio32MB.csv]
2026-03-03 Problem at the building for ESP32S3N16R8 #793
    [common.h, function.hpp, main.cpp, settings.h]
2026-03-03 render framebuffer
2026-03-04 setRotation, print logical widt and height
2026-03-04 set items and current station not too fast
    [main.cpp, settings.h]
2026-03-09 SW rot for SPI
2026-03-10 Volume changing via IR: Display SampleRate always "0K" #803
2026-03-10 Support for Guition JC4880P443C-I-W (DSI-DISPLAY [480x800] ESP32-P4 Guition 4.3") (Issue #791)
    [main.cpp, settings.h]
2026-03-10 Add chip_variant to ESP32-P4-DevKitC-1 configuration
    since newer Arduino core supports P4 rev3 and older version
2026-03-10 Add chip_variant to ESP32-P4-DevKitC-NRW32.json
2026-03-15 About the SDKCONFIG.ESP32P4 settings for the ESP32C6 #812
2026-03-17 update to Arduino 3.3.7
2026-03-24 add rx_queue timers
2026-04-03 Brightness problem on SUNTON 7 inch esp32-S3 800*480 IPS #821
    [main.cpp, settings.h]
2026-04-18 Bluetooth bleibt nicht aus nach Reboot oder Reset #823
    [main.cpp]
2026-04-19 Arduino V3.3.8, IDF V5.5.4
2026-04-30 change button2state
2026-05-12 avoid common.h:244:14: warning: null destination pointer [-Wformat-truncation=]
    [common.h, main.cpp, settings.h]
2026-05-20 Error in void loop () 'class Audio' (Issue #829)
    [main.cpp]
2026-06-11 Arduino 3.3.9 prevent loop if host-url is invalid
    [main.cpp]
2026-06-28 fix placeholder mismatch (expected 1, got 3), content: 'AlarmTime: {} %02i:%02i'
    [common.h, function.hpp, graphical.hpp, main.cpp]
2026-07-01 button1state with cache
2026-07-03 set_active() button1state
2026-07-04 simplify tft-spi
2026-07-05 nide slider and button2state
2026-07-05 Alarm clock mode (Issue #840)
    [common.h, graphical.hpp, main.cpp]
2026-07-24 Button RA_vu_meter + RA_spectrum
2026-07-24 graphics for new buttons
2026-07-26 one class for all buttons
2026-07-26 Arduino 3.3.11 IDF 5.5.5
2026-07-30 BH1750 light sensor turns off backlight completely when sleep mode with clock is active (Issue #851)
    [common.h, graphical.hpp, main.cpp, settings.h]
2026-07-31 getLineLength() no longer exists
    [graphical.hpp]
2026-08-02 wrap words id wird.width > win_width
2026-08-03 impossible to mirror XPT2046 resistive Touchscreen #853
2026-08-04 prototype RTIME_info(const char*)
2026-08-05 WEBSRV_onCommand(), weak bindings removed
    [common.h, main.cpp]
2026-08-08 fix race condition, use mutex printfln(), printfcr() gettime_s()
    [common.h, main.cpp]
2026-08-14 Avoid a truncated log for AudioCurrentTime and AudioFileDuration in ESP_DECODER
    correct:
    09:23:19 Action: ........ AudioCurrentTime 0:57s, AudioFileDuration 1:04s
    09:23:20 Action: ........ AudioCurrentTime 0:58s, AudioFileDuration 1:04s
    09:23:21 Action: ........ AudioCurrentTime 0:59s, AudioFileDuration 1:04s
    09:23:22 Action: ........ AudioCurrentTime 1:00s, AudioFileDuration 1:04s
    09:23:23 Action: ........ AudioCurrentTime 1:01s, AudioFileDuration 1:04s
    09:23:24 Action: ........ AudioCurrentTime 1:02s, AudioFileDuration 1:04s
    [main.cpp]
2026-08-19 Audio Player Touch Buttons, part 1
2026-08-19 Audio Player Touch Buttons, part 2
2026-08-19 Audio Player Touch Buttons (Issue #856)- #858
    [main.cpp]
2026-08-21 DLNA issues with TP or IR #861
    [graphical.hpp, main.cpp]
2026-08-23 display twitching (Issue #864)
    [main.cpp, settings.h]
2026-08-23 processPlaylist() and create_playlist_from_file() completely new, Issue #863
    [function.hpp, main.cpp]
2026-08-24 fix chunked in dlna
    [main.cpp]
2026-08-24 if noWrap print all possible chars
2026-08-28 corr calloc, avoid overfolw
    [main.cpp]
2026-09-02 character U+201E replaced by U+0084 character U+201C replaced by U+0022
    [main.cpp]
2026-09-03 weather buttons
2026-09-03 Weather Button + Icon
2026-09-04 4MB partition deleted
    [miniwebradio4MB.csv, miniwebradio8MB.csv]
2026-09-04 ir buttons
2026-09-07 Button transparency
2026-09-07 weather button enabled
2026-09-08 Agent-Hoständerungen für agents/monitor-speed-configuration-esp32p4
2026-09-12 spi s display
2026-09-12 spi m display
2026-09-14 Weather data output for RU (Issue #894)
    [graphical.hpp, main.cpp]
2026-09-15 Bug in the weather clock interface #898
    [layout.hpp, main.cpp, settings.h]
2026-09-16 center StationName and StreamTitle little fix in wav-recorder
    [function.hpp, layout.hpp, main.cpp]
2026-09-16 fix sum rain in linechart
    [graphical.hpp, main.cpp, settings.h]
2026-09-16 header time colon too low
    [graphical.hpp, layout.hpp, settings.h]
2026-09-19 Waveshare 3.5" ESP32-S3 Touch Display with ES8311 audio and Multithreaded conversion #903 part1 websrv add handle_download_file() and handle_show_file()
2026-09-19 Waveshare 3.5" ESP32-S3 Touch Display with ES8311 audio and Multithreaded conversion- #903 #903 part2 DLNAClient slower timeout
2026-09-19 Waveshare 3.5" ESP32-S3 Touch Display with ES8311 audio and Multithreaded conversion- #903 #903 part3 improvements in main
2026-09-24 Arduino 3.3.12
2026-09-24 prepare for Arduino V4.0
2026-09-24 OTA Upload show Error, but upload works #909
    [main.cpp, main.h]
2026-09-30 Arduino 4.0.0-RC1 IDF 6.1
2026-09-30 clamp audioI2S
2026-10-04 new P4-v3 board
2026-10-05 sdkconfig esp32-p4-es
2026-10-06 sdkconfig esp32p4
2026-10-07 OTA Upload show Error, but upload works #909
    [graphical.hpp, main.cpp]
2026-10-21 Time zones: update the list to IANA tz 2026e, refresh the saved TZ string at boot
    timezones_json predates several tz releases. On the device, configTzTime()
    applies the selected string, so 17 zones give the wrong local time today or
    within the next year: Morocco, Western Sahara, Kazakhstan (Almaty), Egypt
    (summer time again since 2023), Greenland, Paraguay, Moldova, two Antarctic
    stations, and from 1 November 2026 British Columbia, Alberta, the Northwest
    Territories and Manitoba, which stay on permanent UTC-7, -6, -6 and -5.
    Each value is now the POSIX TZ string that IANA tz 2026e ships for that zone
    (the footer of its TZif file). 19 rows change. Two of them (Kirov, Volgograd)
    change only t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
2026-10-24 new ESP32-S3 display (Hosyond 480x320)
2026-10-25 Arduino V4.0.0-RC1
2026-10-29 DISPLAY [800x480] ESP32-S3 WAVESHARE 7 #931
2026-10-30 ESP32-P4_es don't have HW ECSDA
2026-10-30 add esp32s31
2026-10-30 prepare for ESP32.-S31
2026-11-04 BL freq 100Hz
2026-11-08 use TIMER_0, CHANNEL_0
2026-11-14 S31 wrong pins for I2C
